wang15143089/FTC-2026-Bio-buzz/docs/t04_intake_concept.md

# T04 单电机拨杆—转轮复合 Intake

版本：T04-INTAKE-0.4；日期：2026-09-20；成熟度：C04-B1 M3可打印验证件、C04-A M1回退。当前不是最终尺寸冻结。

## 当前方案状态

`C04-A 上方薄拨叉 + 顺从分段转轮 + 单电机共享首级输送`保留为回退方案。用户提出的`C04-B1 底部开口内侧拨 + 偏置导流 + 标准roller`已完成SRC-016官方STEP名义扫掠：纯横向被淘汰，25°斜向侧拨进入M3初模。在实体对照通过前，不改称制造基线。严格比较见`docs/t04_intake_side_sweep_trade.md`。

C04-A资源定义：

- 1 个直流电机驱动 intake roller，并预留同步带动力输出给短预输送；FLOWER 取球不增加电机。
- 舵机 `S04-1` 负责拨叉伸入/回拉，舵机 `S04-2` 负责末端钩下降/收起。
- 转轮被动浮动至少 25 mm，以兼容名义 Ø71 mm POLLEN 与 Ø91 mm NECTAR 的地面获取。
- 发射前单球节拍由舵机闸门承担，不要求独立 T05 电机。
- 在四电机底盘、单个 intake/prefeed 电机、双飞轮条件下，整机为 7 个电机，保留 1 个 R503 电机端口。

## 为什么不让电机驱动拨杆

FLOWER 动作是间歇、低速、位置受限的运动，舵机适合做离散位置控制；roller/输送需要连续旋转，保留一个带编码器直流电机。用第二个直流电机驱动拨杆不会增加取球能力，却会消耗双飞轮或未来升降机构需要的端口。

两个舵机不是“无限制”：比赛仍限制整机最多 8 个舵机。当前 intake 预占 2 个，单球闸门再占 1 个，仍有 5 个名义余量。

## 工作原理

### 地面模式

1. 拨叉和钩完全收回机器人包络。
2. 直径 60 mm 的分段顺从 roller 以 220–312 rpm 起始试验，对应无负载表面速度约 0.69–0.98 m/s。
3. roller 两端用于宽口地面获取，中间约 60 mm 段用于 FLOWER 模式。
4. 浮动 roller 通过弹簧臂提供至少 25 mm 法向行程，覆盖两种名义球径 20 mm 的差值，并保留约 5 mm 调试余量。

### FLOWER 模式

1. `FLOWER_ALIGN`：被动 V 形导向护唇贴近 FLOWER，但不得夹持、抓住或承载场地结构。
2. `EXTEND_ABOVE`：S04-2 保持钩收起，S04-1 将 4 mm 薄拨叉从 POLLEN 上方伸入 Retrieval Opening。名义开口高 90 mm，POLLEN Ø71 mm，扣除拨叉后仍有 15 mm 总余量。
3. `DROP_HOOK`：拨叉越过球心后，S04-2 将 12 mm 末端钩放下到球的后上象限。下降必须由机械止挡限制，不能碰到底环或侧管。
4. `RETRACT_WITH_ROLLER`：roller 以 80–160 rpm 低速内转，对应约 0.25–0.50 m/s；S04-1 回拉拨叉，把最下方 POLLEN 移出底环座，roller 接管并向后输送。
5. `VERIFY_EXIT`：喉部光电/ToF 传感器确认球通过；容量计数增加。若未检测到，拨叉先收钩，再执行低速 roller 反转和一次重试。
6. `CAPACITY_INHIBIT`：机器人已控制 4 个得分物体时，拨叉保持收起、roller 禁止吸入。

规则边界：只从 FLOWER 底部取出 POLLEN；不通过侧面取球，不尝试取出 NECTAR。名义 91 mm NECTAR 比 90 mm Retrieval Opening 高 1 mm，本设计还通过钩位置和控制状态主动排除 NECTAR。

## 初始参数

| 参数 | 初值 | 标签 | 说明 |
|---|---:|---|---|
| 拨叉厚度 | 4 mm | `ASSUMED` | 名义上方剩余15 mm；需打印/板材刚度测试 |
| 有效拨叉宽度 | 40 mm | `ASSUMED` | 必须用官方CAD和实体FLOWER核验横向空间 |
| 拨叉伸入行程 | 70–105 mm，可调；90 mm名义 | `ASSUMED` | 开口深度约91 mm，使用机械槽和止挡调节 |
| 末端钩下降 | 12 mm | `ASSUMED` | 只在越过球后下降 |
| roller直径 | 60 mm | `ASSUMED` | 便于312 rpm候选电机低速闭环 |
| FLOWER roller速度 | 80–160 rpm | `ASSUMED` | 0.25–0.50 m/s，先以低能量验证 |
| 地面 roller速度 | 220–312 rpm | `ASSUMED` | 0.69–0.98 m/s，无负载计算 |
| roller被动行程 | ≥25 mm | `ASSUMED` | 20 mm球径差+5 mm调试余量 |
| 设计回拉力上限 | 10 N | `ASSUMED_PROTOTYPE_LIMIT` | 不是实测场地阻力；由串联弹簧限制 |
| 串联弹簧 | 0.5 N/mm × 20 mm | `ASSUMED` | 把拨叉刚性接触力限制在约10 N |
| 拨叉结构校核力矩 | 1.6 N·m | `CALCULATED` | 10 N × 80 mm × 2.0安全系数 |

312 rpm 5203 候选电机在 60 mm roller 上产生 10 N 切向力时，roller 轴矩约 0.30 N·m。按供应商端点线性模型估算电流约 1.38 A；这只用于设置首轮电流告警，不是持续电流证明。

## 机械构成

### R04-1 分段顺从 roller

- 一根横向 8 mm REX 或等效轴，中央 FLOWER 段使用软指/顺从轮，外侧为地面获取段。
- 两端安装在摆臂或竖向滑槽中，左右以连杆或共轴保证近似平行运动，避免单侧抬起夹球。
- 扭簧/拉簧预载可调；硬止挡限制最大压缩，防止把 NECTAR 过度压入机构。
- 轴端、皮带和夹点使用固定护罩；只暴露必要球通道。

### R04-2 两自由度薄拨叉

- S04-1 通过曲柄滑块或短四杆产生近似直线的 70–105 mm 伸缩。
- S04-2 只控制末端钩的收起/下降；初始化命令为收起，并通过弹簧柔性联轴/servo-saver使钩在舵机卡住时仍可被动向收起方向折让。不得假设普通舵机失电会自动回位。
- 拨叉通过 0.5 N/mm 串联弹簧或等效 servo-saver 与 S04-1 连接；20 mm 后由机械止挡接管，防止舵机持续推压 FLOWER。
- 拨叉端部圆角、低摩擦且无开口槽，不得形成抓住管件或场地边缘的几何。

### R04-3 对位护唇

- 使用宽口、浅凹的 V 形或喇叭形导向，允许按 G415 为对位而部分环抱 FLOWER。
- 护唇只承受瞬时横向对位力，不作为机器人定位支撑；必须可在倒车时自然脱离。
- 中央开口给拨叉和 POLLEN 留通道，护唇最低边缘不得插入底环孔。

### R04-4 单电机动力分配

- 电机直接或同步带驱动 roller；另一同步带输出连接短预输送。
- 预输送入口设置扭矩限制/打滑能力，避免单球闸门关闭时电机持续压缩球列。
- FLOWER 模式降低闭环转速；不通过机械换挡增加第二电机。
- 若 L6 证明共驱动造成堵塞，优先增加舵机离合/张紧轮，而不是立即占用第二个电机端口。

## 软件状态与互锁

`SAFE_STOWED → FLOOR_INTAKE` 或 `FLOWER_ALIGN → EXTEND_ABOVE → DROP_HOOK → RETRACT_WITH_ROLLER → VERIFY_EXIT → STOW`

强制互锁：

- 球计数 `>=4`：禁止 `EXTEND_ABOVE` 和正向 intake。
- 钩未确认收起：禁止高速地面模式和机器人快速行驶。
- roller 电流超过初始告警阈值或球未在超时内通过：立即停 roller、收钩、低速反转；只允许一次自动重试。
- 机器人未处于低速 FLOWER 对位状态：禁止拨叉伸出。
- 初始化或通信丢失但控制仍有电时：命令收钩并停止继续伸入；完全失电时依靠钩的被动折让、S04-1串联弹簧和机器人倒车实现无损脱离，不宣称舵机会自动回位。

## 合规证明边界

- `KNOWN` G418 允许从底部移除 POLLEN，禁止从其他方向移除得分物体或从底部移除 NECTAR。
- `KNOWN` G415 禁止抓取、附着、缠绕或悬挂在场地结构；本方案使用可脱离导向和受力受限拨叉，不以 FLOWER 承载机器人。
- `KNOWN` G407 要求避免战略性控制超过4个得分物体；硬件/软件容量互锁属于验收项。
- `KNOWN` R503 整机最多8个电机和8个舵机；当前建议资源为7电机、3个已分配舵机。
- `TBD` 只有官方 FLOWER CAD/实物夹具能关闭拨叉横向宽度、管件避让和实际球位置；在此之前不能宣称场地零接触或100%取球成功。

## 失效模式与控制

| 失效模式 | 后果 | 首选控制 | 验证 |
|---|---|---|---|
| 拨叉未越过球就落钩 | 压球、卡死 | 顺序互锁、机械凸轮/止挡 | 透明侧板慢速录像50次 |
| 拨叉钩住FLOWER管件 | G415风险、损坏 | 无槽圆角端、10 N串联弹簧、立即反向 | 全包络手动探测和拉脱试验 |
| roller把球压回座内 | 取球失败 | 浮动轴、低速模式、接触高度垫片 | 高度/预载全因子试验 |
| 第二个POLLEN落下夹住拨叉 | 堵塞 | 球离开后先收钩再继续吸入 | 四球连续取出试验 |
| 误取第5球 | G407风险 | 双传感计数+物理闸门 | 容量4拒绝试验20次 |
| 断电拨叉留在场地内 | 无法脱离 | 弹簧偏置收钩、手动释放 | 断电拉脱测试 |
| 单电机共驱动时球列堵塞 | intake和输送同时失效 | servo gate、打滑张紧、反转状态 | 混合球100循环 |

## 验证关口

1. L3：从官方STEP提取 Retrieval Opening 周边实体，扫掠拨叉70–105 mm全行程；对管件、环和机器人包络保持可调安全余量。
2. L6夹具：用实际FLOWER或1:1开口夹具和至少5个POLLEN，测量取出峰值力；若95百分位超过10 N，先改接触路径，不直接提高刚性限力。
3. 每个伸入长度、钩下降量、roller高度/预载组合至少20次；候选收敛后完成100次四球连续取出。
4. 记录成功率、单球周期、峰值电流、最大场地接触力、卡球恢复和球损伤。
5. 只有100次无规则危险接触、无第5球获取、无不可恢复卡死且命中预设成功率后，才进入M4详细CAD。

计算输入为 `calculations/t04_intake_inputs.json`，复算脚本为 `calculations/t04_intake.py`，结果为 `calculations/t04_intake_results.csv`。
