wang15143089/FTC-2026-Bio-buzz/docs/p3_hive_concept.md

# P3 HIVE 前期设计

版本：P3-M1 v0.1；模块：T04/T05/T06/T08；日期：2026-09-19；状态：M1 概念与 M2 低保真计算进行中，未冻结机构或尺寸。

## 当前结论

- `CALCULATED` 在真空质点模型中，从 1.5 m 水平距离、400–700 mm 出射高度、55° 发射至 HIVE 开口下部矩形中心，需要约 4.92–5.56 m/s 出射速度。
- `CALCULATED` 固定 400 mm 出射高度避免起始高度展开机构；其 1.5 m/55° 基准需要约 5.56 m/s，目标处轨迹接近水平。550 mm 出射高度需要约 5.21 m/s并形成约 -12.4° 下落入射，但必须有合法展开与机械限位。
- `CALCULATED` 312 RPM 底盘电机和 1150 RPM 电机在 96/120 mm 轮上均不能通过当前直接驱动初筛；1620 RPM + 120 mm 轮进入原型范围，1620 RPM + 96 mm 为射位相关的边界候选。6000 RPM 需要减速或低转速控制，不作为首个直接驱动基线。
- `SUPERSEDED` P3-TS-001 v0.1 的 76/69/66 主观加权分只保留为历史原型筛选证据，不再承担最终选择理由。
- `DECIDED` P3-LAUNCHER-CMP-0.3 已按约束、解析运动学、双球中心线和更新后的共享动力资源顺序选择C06-B为主原型；C06-A保留为同台对照与回退，C06-C为二级风险回退。详见 `docs/p3_launcher_comparison.md`。

## 规则和几何输入

| ID | 标签 | 输入/约束 | 来源 |
|---|---|---|---|
| T06-REQ-001 | KNOWN | 只能向朝上的 CELL 发射来触发 TIP，不得直接操纵 HIVE。 | G417；TU01 §10.5.1 |
| T06-REQ-002 | KNOWN | TIP 在 AUTO/TELEOP 均为 20 分；HIVE 中终场每球 2 分。 | TU01 Table 10-2 |
| T06-REQ-003 | KNOWN | HIVE TIP 过程中继续向向下的 CELL 发射可能破坏 TIP；控制系统需要暂停/抑制发射状态。 | TU01 §10.5.1 |
| T06-REQ-004 | KNOWN | POLLEN Ø71 mm、NECTAR Ø91 mm，均非完全球形且尺寸会变化。 | TU01 §9.8 |
| T06-REQ-005 | KNOWN | CELL 开口名义宽 508 mm；底部至竖直肩部高 193.5 mm；底边高 1359 mm；上部总开口高度约 355.5 mm。 | TU01 Figures 9-10/9-11 |
| T06-REQ-006 | KNOWN | 起始高度不超过 457 mm；工作高度不超过 736.5 mm，且必须机械限位。 | R102、R105 |
| T06-REQ-007 | KNOWN | 最多控制 4 个得分物体；整机最多 8 电机/8 舵机。 | G407、R503 |
| T06-REQ-008 | ASSUMED | T06 应兼容 POLLEN 与 NECTAR，以保留终场 CELL 得分和战术弹性。 | 需 M1 原型验证两种尺寸；可在关口降级为 POLLEN-only |
| T06-REQ-009 | TBD | 命中率、连续射击恢复时间、允许射位和球体质量目标。 | 需用户目标与 L6 测试 |

## 目标窗口计算

以最大名义球 Ø91 mm 通过 CELL 下部矩形区域：

- `CALCULATED` 瞄准高度：`1359 + 193.5 / 2 = 1455.75 mm`。
- `CALCULATED` 名义水平球心余量：`(508 - 91) / 2 = 208.5 mm/侧`。
- `CALCULATED` 名义竖直球心余量：`(193.5 - 91) / 2 = 51.25 mm/侧`。

这些是名义几何余量，不包含场地 ±25 mm 一般公差、HIVE 运动、球体变形、机器人定位误差或飞行散布。它们不能直接转化为允许的发射角误差。

## L2 弹道模型

模型采用无阻力抛体公式：

`v = sqrt(g x² / (2 cos²θ (x tanθ - Δz)))`

其中 `x` 为水平距离，`Δz` 为目标与出射口高度差。模型输入集中在 `calculations/p3_launcher_inputs.json`，脚本为 `calculations/p3_ballistics.py`，完整扫参结果在 `calculations/p3_ballistics_results.csv`。

### 1.5 m、55° 基准切片

| 出射高度 | 起始状态合法性 | 出射速度 | 目标处轨迹角 | 最高点 | 比动能 |
|---:|---|---:|---:|---:|---:|
| 400 mm | 固定高度可在 457 mm 内 | 5.556 m/s | -1.17° | 1.456 m | 15.43 J/kg |
| 550 mm | 需要展开 | 5.208 m/s | -12.43° | 1.478 m | 13.56 J/kg |
| 700 mm | 需要展开且接近工作上限 | 4.918 m/s | -22.81° | 1.527 m | 12.09 J/kg |

`CALCULATED` 较高出射口只把需求速度降低约 11%，却引入展开、限位和碰撞风险。当前证据不支持为了这部分速度收益直接选择升降发射器；固定低位方案应作为首个原型基线。

### 模型限制

- `KNOWN` ResisDent 球为空心开孔塑料球，空气阻力不可忽略。
- `TBD` 质量尚未由官方资料确认或实测，因此只报告 J/kg，不伪造球体动能和连续功率。
- `TBD` 飞轮引入的自旋会产生 Magnus 偏移；真空模型没有建模。
- `TBD` HIVE 正在 TIP 时目标不是静止体；当前只分析稳定状态。

因此计算值是台架起始窗口，不是最终设定值。最终弹道必须由实物球、实物目标夹具和高速/普通视频轨迹标定。

## 电机与轮速初筛

球速与轮面速度用 `v_ball = k × v_surface` 映射；`k = 0.65` 是 `ASSUMED` 原型参数，不是效率实测。`calculations/p3_motor_screen.py` 使用供应商无负载转速计算，结果在 `calculations/p3_motor_screen_results.csv`。

| 电机 | 96 mm 轮估算球速 | 120 mm 轮估算球速 | 初筛 |
|---|---:|---:|---|
| 5203-2402-0019，312 RPM | 1.02 m/s | 1.27 m/s | 直接驱动淘汰 |
| 5203-2402-0005，1150 RPM | 3.76 m/s | 4.70 m/s | 直接驱动淘汰 |
| 5203-2402-0003，1620 RPM | 5.29 m/s | 6.62 m/s | 96 mm 边界；120 mm 原型候选 |
| 5203-2402-0001，6000 RPM | 19.60 m/s | 24.50 m/s | 需减速/闭环限速，不作首个直驱基线 |

goBILDA 对 1620 RPM 型号给出 5.4 kg·cm 堵转扭矩和 9.2 A 堵转电流；按理想线性扭矩-转速曲线计算单电机最大机械功率约 22.4 W。该数值不是持续额定功率，双电机堵转电流之和 18.4 A 也不是可接受工作点。必须通过加速时间、电流和温升测试确定安全工作区。

## 候选概念

### C06-A — 单飞轮 + 可调曲面压板

一个高速轮把球沿被动或弹性曲面压板加速，单独的闸门一次放行一球。

- 优点：一个发射电机；包络短；成熟 FTC 先例多；曲面可增加接触长度。
- 风险：71/91 mm 直径相差 20 mm，固定间隙会导致完全不同的压缩；单轮会施加强自旋；曲面磨损或偏心直接影响散布。
- 必需可调项：轮速、压板间隙/弹簧预载、有效包角、出射角。
- 原型判据：两种球都不永久变形；100 次单发无双进料；命中率阈值 TBD。

### C06-B — 对置双飞轮 + 独立进料闸门

两侧对置轮同时加速球，轮速同向产生直线出射；可通过弹性浮动轴承座或对称滑块适配两种直径。

- 优点：净自旋可小于单轮；压缩与出射方向对称；可用左右轮差速校正自旋/横向偏差。
- 风险：默认需要两个电机；双侧夹点和同步控制增加安全与软件负担；固定间隙仍不能同时适配 71/91 mm。
- 必需可调项：轮间隙、左右轮速、轮径、出射角、进料中心线。
- 原型判据：左右转速误差、恢复时间和球径切换无需拆机；阈值 TBD。

### C06-C — 可调储能弹射器

电机/凸轮为弹簧或弹性件储能，锁止后用摆臂或杯托一次释放一球；改变预压或止挡实现射程调整。

- 优点：单次能量可重复标定；对表面摩擦变化不如飞轮敏感；可用单电机低速充能。
- 风险：循环慢、冲击和振动大；锁止失效与摆臂扫掠区风险高；疲劳寿命和球径适配需独立验证。
- 先例边界：2017 Velocity Vortex 冠军联盟队 724 被公开社区资料描述为可调射程弹射器，但未获得可复用尺寸或完整载荷数据。
- 原型判据：防误释放、机械二次止挡、循环寿命和重复能量；阈值 TBD。

## 概念比较

`P3-TS-001 v0.1` 权重为双球尺寸适应 30%、潜在重复性 20%、可调性 15%、周期/恢复 10%、安全维护 10%，其余为包络、电机效率和先例成熟度。全部概念分数为 `ASSUMED`。

| 概念 | 得分 | 排名 | 处理 |
|---|---:|---:|---|
| C06-B 对置双飞轮 | 76 | 1 | 主原型 |
| C06-A 单飞轮曲面压板 | 69 | 2 | 轻量对照原型 |
| C06-C 可调弹射器 | 66 | 3 | 风险回退，暂不详细化 |

C06-B领先的主要原因是已解析证明的双球中心线保持、理想零自旋设定点与平移/自旋解耦，而不是已证明的命中率。该旧评分已由P3-LAUNCHER-CMP-0.3的约束优先选择取代；若实测显示双电机恢复、功耗、散布或尺寸不可接受，C06-A按预先登记的反转规则胜出。

## 初始资源预算

| 资源 | C06-A | C06-B | C06-C | 标签 |
|---|---:|---:|---:|---|
| 驱动电机 | 4 | 4 | 4 | KNOWN 底盘 |
| T04 获取电机 | 1 | 1 | 1 | ASSUMED |
| T05 输送/闸门电机 | 0 | 0 | 0 | PROPOSED；按DEC-0013由T04电机共驱短预输送，闸门用舵机 |
| T06 发射电机 | 1 | 2 | 1 | ASSUMED |
| 总电机 | 6 | 7 | 6 | CALCULATED；按C04-A共享动力更新 |
| 剩余电机端口 | 2 | 1 | 2 | CALCULATED，基于8电机上限 |
| T06 舵机 | 0–2 | 0–2 | 1–2 | ASSUMED |
| T06 质量 | TBD | TBD | TBD | 必须用 M1 BOM 关闭 |

DEC-0013已把T04/T05合并为单电机共享动力，因此双飞轮整机预算由8降为7，保留1个电机端口。该余量不自动批准炮塔、升降或独立FLOWER模块；新增功能仍需质量、电源、周期和战略收益审查。

## 初始接口

### IF-T05-T06-01 — 单球交接（DRAFT）

- 几何：一次仅向发射级提交一个 Ø71–91 mm 名义球；交接中心线、速度和姿态为 TBD。
- 机械：闸门必须物理防止第二球进入能量传递区；卡球须能断电清除。
- 传感：至少检测“球就绪”和“球已离开”；具体传感器 TBD。
- 控制：T06 未达到速度/储能条件或检测 HIVE 正在 TIP 时，T05 必须保持球。

### IF-T02-T06-01 — 结构安装（DRAFT）

- 使用 T02 命名基准面和可拆安装板；孔型、载荷和包络在 M3 前冻结。
- 发射反力不得通过 Control Hub、电池或线束支架闭合。
- 护罩、工具空间和轮/压板快速更换路径属于接口包络。

### IF-T03-T06-01 — 电气（DRAFT）

- 12 V 电机端口 1–2 个，带编码器闭环；峰值电流按每个候选电机 9.2 A 堵转值做故障预算，但禁止以堵转为正常工作点。
- 电机、传感器、闸门和急停/禁用状态必须在端口分配表冻结前登记。

### IF-T08-T06-01 — 软件状态（DRAFT）

建议状态：`SAFE → SPINUP/CHARGE → READY → FEED_ONE → RECOVER → READY`，异常进入 `FAULT_JAM` 或 `INHIBIT_HIVE_MOVING`。速度容差、超时和传感更新率为 TBD。

## 先例与工业化原则

- [FTC 18438 Wolfpack Machina](https://www.wolfpackmachina.com/ftc2020) 展示了曲面压板延长接触、增加飞轮惯量降低连续射击转速跌落和可维护控制器布局；其物体为 Ring，因此只继承原则。
- [REV Flywheel Launcher](https://docs.revrobotics.com/ftc-kickoff-concepts/ultimate-goal-2020-2021/shooter) 把“不堵塞、出射一致”和较长加速路径作为首要要求，支持 C06-A 的可调台架方法。
- [FTC 11128 Velocity Vortex](https://team11128.wixsite.com/main/charlie) 采用宽入口收集后缩窄为单球进料，支持把 T05 闸门与 T06 能量级解耦。
- [goBILDA 1620 RPM 5203](https://www.gobilda.com/5203-series-yellow-jacket-planetary-gear-motor-3-7-1-ratio-1620-rpm-3-3-5v-encoder/) 的官方规格支持当前轮速初筛，但不构成选型批准。
- [OSHA 机器防护原则](https://www.osha.gov/etools/machine-guarding/introduction/general-requirements) 将进料夹点、旋转件和飞出物作为需防护危险；本项目据此要求完整侧护罩、只保留球通道并提供断电清障路径。

## 主要失效模式

| 失效 | 后果 | 首选控制 | 验证 |
|---|---|---|---|
| 双球进入发射级 | 堵塞、失控射击 | 独立闸门 + 球状态传感 | 100 次混合尺寸进料 |
| 轮速跌落 | 下一球低射 | 编码器 READY 门限 + 恢复延迟 | 连续射击转速日志 |
| 直径差导致压缩过大/过小 | 损球、打滑、散布 | 弹性/可调间隙 | 71/91 mm 全因子试验 |
| TIP 中继续发射 | TIP 不成立或球进错误 CELL | 人工/视觉 TIP 抑制状态 | 动态目标夹具 |
| 轨迹过高或过快 | 离场/安全风险 | 机械角限位 + 软件转速上限 + 护罩 | 最大能量安全测试 |
| 飞轮/传动件松脱 | 机械危险 | 双重轴向约束、锁固、全包围护罩 | 超速与振动检查 |
| 断电后无法清球 | 现场恢复失败 | 无工具或单工具检修门 | 断电清障演练 |

## 下一验证关口

1. `MEASURED` 称量至少 5 个 POLLEN 和 5 个 NECTAR，并测量直径/圆度范围。
2. 建造共用的可调角度台架，允许更换 C06-A/C06-B 头部、96/120 mm 轮和间隙垫片。
3. 在 1.0/1.5/2.0 m 射位记录转速、出射速度、目标散布、电流、恢复时间和损球情况。
4. 每种球至少 30 发/设置；命中率阈值由用户性能目标确认后写入 VAL-T06-001。
5. 只有实测关闭球速传递系数、压缩量和恢复时间后，才进入 M3 简化几何与 CadQuery 包络。
