wang15143089/FTC-2026-Bio-buzz/docs/requirements.md

# 需求与问题清单

状态：Requirements Baseline v0.1；基于 BIOBUZZ Competition Manual TU01，2026-09-19 经用户批准。

## 已知过程需求

| ID | 状态 | 需求 | 验收方式 | 来源 |
|---|---|---|---|---|
| PRJ-001 | KNOWN | 机器人按独立功能模块开发，并定义机械、电气、软件和几何接口。 | 架构与 ICD 审查 | 用户指令 2026-09-19 |
| PRJ-002 | KNOWN | 全局关键尺寸和工程参数集中管理，禁止重复硬编码。 | 参数引用检查 | 用户指令 2026-09-19 |
| PRJ-003 | KNOWN | 重大选择必须追溯到需求、计算、测试或明确假设。 | 追溯矩阵/决策日志审查 | 用户指令 2026-09-19 |
| PRJ-004 | KNOWN | 验证顺序为零件、子组件、整机，优先采用可回答问题的最低成本方法。 | 验证计划审查 | 用户指令 2026-09-19 |
| PRJ-005 | KNOWN | 工作流适配 i5-1135G7、8–16 GB RAM、集成显卡和有限 SSD。 | 构建时间/资源记录 | 用户指令 2026-09-19 |
| PRJ-006 | KNOWN | 重要工程状态必须落盘并可从检查点恢复。 | 恢复演练 | 用户指令 2026-09-19 |
| PRJ-007 | KNOWN | 默认 CAD 几何单位为 mm，模块可独立再生成。 | 自动检查/重建测试 | 用户指令 2026-09-19 |
| PRJ-008 | KNOWN | 未知关键数据必须标为 TBD，不得无依据填值。 | 文档与参数审查 | 用户指令 2026-09-19 |
| PRJ-009 | KNOWN | 概念设计可参考往届高水平 FTC 机器人和成熟工业设计，但必须追溯来源、重新验证当前赛季合法性与适用性，不得无审查照搬。 | 概念评审/规则检查 | 用户指令 2026-09-19 |

## 尚未建立的产品需求类别

移动性能、选定任务组合、周期时间、可靠性目标、电气功率预算、软件控制方案、可维护性目标和成本目标仍为 `TBD`。

## 官方比赛与机器人约束

下表来源均为 `BIOBUZZ Competition Manual, Version TU01`；具体源文件哈希见 `references/source_register.md`。

| ID | 状态 | 需求/事实 | 来源 | 验收方式 |
|---|---|---|---|---|
| LEG-001 | KNOWN | 起始状态全部机器人零件必须静止、自支撑并位于 457 × 457 × 457 mm 包络内；预装比赛物体可超出该包络。 | R102–R103，pp.120 | 实体量规/简化 CAD 包络检查 |
| LEG-002 | KNOWN | 比赛开始后机器人必须保持一个总成，所有稳定工作状态须位于 457 × 610 × 736.5 mm 包络内，高度方向始终垂直场地；必须由机械限位保证，不能只依赖软件。 | R105，pp.121–123；G416 | 全行程机械止挡与扫掠包络检查 |
| LEG-003 | KNOWN | BIOBUZZ 无显式机器人重量上限，但质量仍影响地垫、耗电、运输和性能。 | R104，p.120 | 称重并对团队目标审查；目标值 TBD |
| LEG-004 | KNOWN | 机器人最多同时控制 4 个得分物体。 | G407，pp.109–110 | 容量/状态机/实体测试 |
| LEG-005 | KNOWN | 机器人最多使用 8 个合法电机和 8 个合法舵机；5201–5204 系列 goBILDA Yellow Jacket 属于允许电机系列。 | R501–R503，pp.130–132 | BOM 与检查清单 |
| LEG-006 | KNOWN | 机器人只能使用 1 个获准的 12 V NiMH 主电池；项目选用 goBILDA 3100-0012-0020。 | R601，p.133；用户批准的硬件输入 | BOM 与检查 |
| LEG-007 | KNOWN | 项目采用 1 个 REV-31-1595 Control Hub 和 1 个 REV-31-1153 Expansion Hub，符合最多增加 1 个 Expansion Hub 的规则路径。 | R701，p.137；用户批准的硬件输入 | 电气架构/BOM 检查 |
| LEG-008 | KNOWN | 机器人不得故意分离零件，且断电时必须能从场地和比赛物体中安全移除。 | R105、R203 | 风险审查与断电恢复测试 |
| LEG-009 | KNOWN | HIVE 只能通过向朝上的 CELL 发射得分物体来触发 TIP，不得以机器人或受控物体直接操纵其运动。 | G417，p.113 | 功能测试与比赛规则审查 |
| LEG-010 | KNOWN | FLOWER 只能从顶部放入 POLLEN/NECTAR；只能从底部取出 POLLEN；最后 60 s 前不得将 NECTAR 放入 FLOWER 计分体积。 | G410、G418，pp.110,114 | 状态机和几何路径测试 |
| LEG-011 | KNOWN | 开赛时每台机器人必须接触恰好 4 个预装 POLLEN。 | 10.3.4、G304，pp.84,105 | 起始配置检查 |

## 场地与比赛物体输入

| ID | 状态 | 输入 | 来源/说明 |
|---|---|---|---|
| ENV-001 | KNOWN | 场地内侧约 3657.5 × 3657.5 mm；36 块约 609.5 × 609.5 × 15 mm 软地垫。 | §9.2，p.64；一般公差 ±25 mm |
| ENV-002 | KNOWN | 官方 3D CAD 是场地构造的官方表示；一般测量公差 ±25 mm。 | §9.1，p.63；`field-cad-step.zip` |
| ENV-003 | KNOWN | HIVE 框架基部约 1256.5 mm 宽、989.5 mm 深，枢轴高 1116.5 mm；CELL 开口约 508 × 356 mm、深约 305 mm。 | §9.6，pp.69–72 |
| ENV-004 | KNOWN | FLOWER 顶部开口约 Ø101.5 mm、高约 546 mm；底部取球口约 90 mm 高、91 mm 深。 | §9.7，pp.72–73 |
| OBJ-001 | KNOWN | POLLEN 名义直径约 71 mm；NECTAR 名义直径约 91 mm；二者均非完全球形且尺寸会变化。 | §9.8，p.74 |
| OBJ-002 | KNOWN | 每场共有 40 个 POLLEN、8 个红色和 8 个蓝色 NECTAR。 | §9.8，p.74 |

## 计分功能候选

用户未指定任何必须完成的比赛任务。以下是后续方案组合的候选功能，不代表已选择机构：

| ID | 功能 | 分值/作用 | 关键约束 |
|---|---|---|---|
| FN-001 | AUTO LEAVE | 3 分 | 自动阶段离开场边接触 |
| FN-002 | AUTO/TELEOP PARK | 各 5 分 | 至少部分位于 LOADING ZONE |
| FN-003 | HIVE TIP | AUTO/TELEOP 各 20 分 | 只可向朝上 CELL 发射 |
| FN-004 | CELL 留球 | TELEOP 每个 2 分 | 终场位于朝上 CELL |
| FN-005 | FLOWER 底层 NECTAR | 5 分 | 最后 60 s；从顶部放入 |
| FN-006 | 拥有 FLOWER 后其中每球 | 每个 2 分 | 所有权由最上层本方 NECTAR 决定 |
| FN-007 | GARDEN 留球 | 每个 1 分 | 区域不受保护 |
| FN-008 | RP 目标 | SWARM 16 分、POLLINATOR 1 为 4 TIPS、POLLINATOR 2 为 7 TIPS | 仅“其他赛事”阈值；高等级赛事当前为 TBA |

## 已确认的项目输入

- `KNOWN` 接受 CadQuery → STEP → FreeCAD/Fusion 360 工作流。
- `KNOWN` 不对制造设备预设硬性要求；方案比较必须显式列出各方案所需工艺。
- `KNOWN` 参考底盘为 goBILDA Strafer 3209-0001-0007（104 mm Mecanum，供应商标称组装质量 4269 g，内含 4 个 312 RPM 的 5203-2402-0019）。
- `KNOWN` 底盘四轮相对布局、轮距和轴距必须保持；允许为测量、安装与必要调整进行最低限度拆分重组，但不得改变核心运动学布局。精确轮距/轴距待从 STEP 或实物核验。
- `KNOWN` goBILDA 5203-2402-0051 文件只作为同系列电机的包络示意，不要求使用该具体速比；最终电机型号由扭矩、转速、功率和控制需求计算决定。
- `KNOWN` 控制系统使用 1 个 REV Control Hub（REV-31-1595）和 1 个 REV Expansion Hub（REV-31-1153）。
- `KNOWN` 主电池为 goBILDA 12 V 3000 mAh Nested Battery（3100-0012-0020）；用户图纸给出的本体包络为 124 × 47.8 × 43 mm，线束标注长度 120 mm，含 XT30、16 AWG 线和 20 A Mini Blade Fuse。
- `KNOWN` 任务包比较必须让战略价值显著主导开发便利性，并用规则、计算或试验证据解释各项评分；当前默认战略总权重为 70%，见 TS-S00-001 v0.2。

## P3 HIVE 初始模块需求

以下需求进入 T06 M1；性能阈值仍需计算或原型关闭：

| ID | 状态 | 需求 | 验收方式 |
|---|---|---|---|
| T06-REQ-001 | KNOWN | T06 只能通过向朝上 CELL 发射得分物体来尝试 HIVE TIP，不得直接操纵 HIVE。 | 规则审查、运动路径测试 |
| T06-REQ-002 | KNOWN | 发射路径、护罩和控制必须在全部状态满足起始/工作包络及机械限位要求。 | M3 扫掠包络、实体量规 |
| T06-REQ-003 | KNOWN | T05/T06 不得使整机控制超过 4 个得分物体。 | 容量审查、状态机测试 |
| T06-REQ-004 | ASSUMED | 首轮概念应兼容 Ø71 mm POLLEN 与 Ø91 mm NECTAR；若双尺寸显著损害 HIVE 可靠性，可经关口批准降级。 | 双尺寸夹具/发射测试 |
| T06-REQ-005 | ASSUMED | M1 台架必须可独立调整出射角、轮速/储能、压缩间隙及单球进料时序。 | 台架设计审查 |
| T06-REQ-006 | KNOWN | T06 必须具有防止 TIP 过程中继续错误发射的控制状态，并支持断电安全清球。 | 状态机注入、断电恢复测试 |
| T06-REQ-007 | KNOWN | 飞轮、带/链、轴端和所有进料夹点必须有护罩；护罩不得成为新的夹点。 | 安全检查、探入检查 |
| T06-REQ-008 | TBD | 稳态命中率、连续射击恢复时间、最大允许电流/温升和射位范围。 | 用户目标 + VAL-T06-001/002 |

## 待用户回答问题

### CRITICAL — 不回答就不能负责任地开始设计

当前 CRITICAL 项均已关闭；Requirements Baseline v0.1 和 Architecture v0.1 已于 2026-09-19 获用户批准。

### IMPORTANT — 可短期采用已记录假设

1. 目标赛事等级/地区、比赛日期、评审节点、采购周期和预算。
2. 期望的最高速度/加速度、越障需求和驾驶员偏好；哪些是偏好而非硬约束？
3. 最终需要哪些原生 CAD 格式、工程图和 BOM 格式？
4. 团队已有的软件栈、编程语言、控制架构和里程计/视觉定位方案。
5. 可靠性与维修目标：两场间维护时间、模块更换时间和备件策略。
6. 除所给底盘、REV 双 Hub 和 goBILDA 电池外，是否有需复用的机构、孔位标准、型材或零件库存？

### LATER — 初始概念不依赖

1. 外观、颜色、号码牌和赞助标识规范。
2. 线束标签、包装运输、展示支架和长期储存偏好。
3. 最终渲染、动画、培训材料和评审展示格式。
4. 赛后性能遥测、维护统计和下一赛季复用目标。

## 初始需求基线的完成条件

- 所有 CRITICAL 问题有来源明确的回答。
- 法规需求逐条记录规则章节和版本。
- 每项“必须”任务都有可测试的验收条件。
- 冲突和 TBD 有责任人、截止点和风险处理方式。
- 用户批准 Requirements Baseline v0.1。
