wang15143089/FTC-2026-Bio-buzz/cad/output/paddle_launcher_feasibility_report.md

# 对置飞轮连续拨杆发射机构：尺寸约束报告

- 坐标：X–Y 为底盘平面，+Z 向上。
- 模型不含 POLLEN / NECTAR 实体。
- 通道净截面：108 × 110 mm；拨片宽 96 mm，单侧余量 6.0 mm。
- 飞轮：4 个 96 × 24 mm Gecko；每根 8 mm 轴安装 2 个。
- COTS 版本：C06B-COTS-0.3；目录核对日期 2026-10-01。
- 官方 CAD：已导入 13 个 goBILDA SKU；清单 `references/vendor/gobilda/t06/manifest.json`。
- 装配表示：WHOLE_OFFICIAL_PART_PER_SKU_FROM_VENDOR_STEP；供应商按真实间隙分开的子实体保持分开，不强行融合、不丢料。
- 飞轮直驱：2 × 5203-2402-0003，无外置啮合齿轮。
- 电机夹具/联轴器：1401-0043-0036 / 4007-4008-4008。
- 轴/轴承：2106-4008-1680（168 mm）/ 1611-0514-4008（Ø14 × 5 mm）。

| 配置 | 轴中心距 | 名义轮间隙 | 总包络 X×Y×Z | 18 in 校核 |
|---|---:|---:|---:|:---:|
| POLLEN | 160 mm | 64 mm | 383.8×364.8×400.0 mm | 通过 |
| NECTAR | 178 mm | 82 mm | 383.8×364.8×400.0 mm | 通过 |

## 间距调节运动链

舵机 12 mm 曲柄 → 65 mm 定长驱动杆 → 水平导向滑块 → 两根 110 mm 对称连杆 → 与轴承座刚性连接的耳轴 → 上下飞轮轴。
两侧板均设置轴槽和外置滑动轴承座，因此轴在调节过程中保持平行。

- 三段导槽角度：0° / 26° / 52°；接头最大位置误差 0.000000 mm。
- 导槽与发射喉道共线误差 0.000000 mm。
- 每根轴的槽中心行程 9 mm；轴承留在外置滑座内，侧板仅开 8.4 mm 轴槽，槽外形总长 17.4 mm；两轴相对中心距变化 18 mm。
- 发射喉道在轴心前 52 mm 截止，相对 48 mm 飞轮半径保留至少 4 mm 轴向投影余量。

## 实体干涉检查

- POLLEN：全部通过。覆盖飞轮/侧板、飞轮/通道、飞轮/轴承座、飞轮彼此、电机/轴承座、拨杆/通道、拨杆/支撑板、连杆/侧板、双槽滑块及曲柄杆端分层。
- NECTAR：全部通过。覆盖飞轮/侧板、飞轮/通道、飞轮/轴承座、飞轮彼此、电机/轴承座、拨杆/通道、拨杆/支撑板、连杆/侧板、双槽滑块及曲柄杆端分层。
