wang15143089/FTC-2026-Bio-buzz/cad/output/paddle_launcher_constraint_report.md

# 对置飞轮连续拨杆发射机构：尺寸约束报告

- 坐标：X–Y 为底盘平面，+Z 向上。
- 模型不含 POLLEN / NECTAR 实体。
- 通道净截面：108 × 110 mm；拨片宽 96 mm，单侧余量 6.0 mm。
- 飞轮：4 个 96 × 24 mm Gecko；每根 8 mm 轴安装 2 个。

| 配置 | 轴中心距 | 名义轮间隙 | 总包络 X×Y×Z | 18 in 校核 |
|---|---:|---:|---:|:---:|
| POLLEN | 160 mm | 64 mm | 383.8×374.0×400.0 mm | 通过 |
| NECTAR | 178 mm | 82 mm | 383.8×374.0×400.0 mm | 通过 |

- 三段导槽角度：0° / 26° / 52°；接头最大位置误差 0.000000 mm。
- 导槽与发射喉道共线误差 0.000000 mm。
- 每根轴的槽中心行程 9 mm；按 16 mm 轴承孔计，槽外形总长 25 mm；两轴相对中心距变化 18 mm。
