wang15143089/FTC-2026-Bio-buzz/PROJECT_STATUS.md

# PROJECT STATUS

最后更新：2026-10-16（**R69-Bambu 补丁：两份 STEP 报“超界/超高”已定位为旧中间件误用，补出 54 件单件平放 STEP（DEC-0077 / V-0077）**：①判据（KNOWN）= 用户 2026-10-16 两张 Bambu Studio 报错截图「物体位于盘的边界上或超过了高度限制」，对象 A 403.691 x 136 x 232.835、V 537 144 mm³，对象 B 361.064 x 31 x 385.024、V 312 153 mm³。②根因（MEASURED）：两者**不是** R69 交付件，而是拆分过程的**裁切前中间件** —— `_r69_split/mid.step` 回读 403.7 x 136.0 x 232.8、V **537 144.3**；`_r69_split/plate_R.step` 回读 361.1 x 31.0 x 385.0、V **312 150.0**，与截图逐项吻合。最终件 `shroud_tray_mid` 248.4 x 136.0 x 232.8（V 414 543.1）、`side_plate_right` 262.2 x 31.0 x 284.0（V 199 554.9）均在 H2D 可用区 315 x 310 x 325 内。③处置：`_r69_split/` 与 `_r69_p1/` 移入 `cad/output/_superseded/` + `_SUPERSEDED` 后缀 + README（防误用）；新增 `cad/_r69_parts_flat.py` 从已验收整板 STEP 逐件烘焙导出。④验收（MEASURED，`cad/_r69_parts_flat_verify.py`）：**54/54 单实体、zmin = 0.000、bbox ≤ 315 x 310 x 325**，最大高 136.0（`shroud_tray_mid`）、最大平面 287.09（`base_rail_±72`），ΣV **1 766 184.4 mm³** = R69 验收值，几何零变动。⑤交付：`deliverables/R69_print_package/parts_flat/`（54 STEP + README + `parts_flat_index.json`）、`previews/bambu_fix_dimensions.png`。**导入用 `parts_flat/`，不要用 `_r69_split/`。** 遗留：Bambu 实机切片未跑。DEC-0077 / V-0077）

上一状态：2026-10-16（**T06 R69 打印件重排：滑轨并成每侧一根 380 mm 整轨 + 外罩/侧板联合体 3 拆（左板 / 右板 / 外罩-托板），件集 55 → 54、8 板（DEC-0076 / V-0076）**：①判据（KNOWN）= 用户 2026-10-16「c，谢谢。麻烦你也把巨大的外罩-侧板联合体拆成3部分：左侧板，右侧板，以及外罩-托板联合体，3部分用螺丝，扎带和胶水固定（选择你认为最好的方法，可以直接给外罩-托板直接变宽使其全程和侧板接触）」+ 上一轮「把两段滑轨在3D打印文件中连起来」。②滑轨方案 C（MEASURED）：每侧 `base_rail_front_±72` 与 `base_rail_rear_joined` 布尔并成 **380.0 mm 单实体整轨**，DEC-0072 的 2 件跨缝搭板 + 4 跨轨筋 + 2 垫板 + 4 × M3×30 **退役**（DEC-0072 转 SUPERSEDED 保留）。③3 拆（MEASURED）：切割面 **y = ±68**（侧板内表面），`frameP_1_rear_lower` → `shroud_tray_mid` + `side_plate_left` + `side_plate_right`，**体积守恒 delta = 0.000 mm³**，三件各单实体。④紧固（KNOWN）：**8 × M3 六角螺栓 + 六角螺母 + 每螺栓 2 平垫圈 + 双组分环氧**，**不用扎带**（扎带要在 4 mm 薄板上开槽，对已螺栓 + 已粘接的接头无收益）；耳片 12 × 10 从外罩壁咬入 3 mm、外表面到 **y = ±67.8**，对侧板留 **0.2 mm 胶缝**；工位 A(x 74, z 27, 板 16, M3×35) / D(5, 86, 4, M3×25) / B(−25, 120, 4, M3×25) / C(−68, 140, 4, M3×25)，螺栓长由 `5 × ceil((夹持 + 4) / 5)` 计算，头在外侧、螺母在外罩壁内表面（内腔空间实测有）。⑤不做全程加宽：填实 |y| 57…68 的 11 mm 空腔会与轴承 / 滑座 / 横梁让位冲突且耗材 +70 %，局部耳片等效。⑥验收（MEASURED，`cad/output/inspection/t06_r69_print_R069.json`，**21 项 0 fail**）：体积 +7416.931（目标 +7417.0 ± 1.0）、5 件各单实体、两轨 xlen 380.000、螺栓通道 Ø3.0 探针 8 × 2 求交 **0.000 mm³**、Ø3.4 塞规自由 0.000 / Ø4.0 仍咬料 101.185、8 耳填充率 **1.0000**、8 板全部 ≤ 315 × 310、54 件在 8 板中各一次。⑦排版 **8 板**：p1 30 件 / 311.1 × 306.3 / H 18、p2 1 件（380 轨 45° 斜放）/ 287.1 × 287.1 / H 18、p3 6 / 307.2 × 306.7 / H 31、p4 5 / 307.2 × 284.0 / H 16、p5 2 / 232.8 × 306.4 / H 136、p6 2 / 275.0 × 247.6 / H 5.5、p7 2 / 230.7 × 224.3 / H 4、p8 6 / 265.3 × 305.0 / H 30；件集 ΣV **1 766 184.4 mm³** == 8 板 ΣV。⑧交付：件集 `cad/output/_r69_parts/`（54 件）、排版 `cad/output/_r69_plate/`、交付包 `deliverables/R69_print_package/`（parts 54 / plates 8 / previews 9 / 3 份 index + README）。遗留：切片器实跑、0.2 mm 胶缝成型、环氧强度、PET 翘边、未实机。DEC-0076 / V-0076）

## CURRENT OBJECTIVE

- **【2026-10-13 / R53b 恢复点】滑座改常闭弹簧夹（自动，无人工）**：见上条「最后更新」。脚本 `cad/paddle_launcher_shooter_lock_r53b.py`，产物 `cad/output/_r53b_auto/`（指向桌面的 junction）。**待用户回答的两个问题**：①比赛中是否需要**在线切换** POLLEN / NECTAR（还是赛前调好一档就够）；②是否还有**空闲舵机通道**（决定要不要做舵机主动解锁 / 夹紧）。这两问决定下一步是收口还是加机构。
- **【2026-10-13 / R51 + R52 交付】发射部分换基线到 2026-10-01 全整机 + 滑窗定版**：触发是用户判据「两个飞轮不能连在一起，这样没法调间隙。你应该使用在『只保留运动部分』之前最新一版的 CAD 做基础来进行改动」。**基线判定（KNOWN）**：`cad/output/paddle_launcher_feasible_pollen.step`（2026-10-01 22:36，414.3 MB / 98 件）—— 它是 `paddle_launcher_motion_only.py --profile motion_free` 的父装配，证据 `cad/output/_r51_base/manifest.json`（`cq.Assembly.load` 直接回读该 STEP）+ 侧视图 `T06_基线_2026-10-01_侧视图.png`（桌面）。**为什么旧版能直接用**：10-01 基线本来就是「两根轴各自独立 + DEC-0037 调隙链（`2000-0025-0002` -> 12 mm 曲柄 -> 65 mm 拉杆 -> 十字头 -> 两根 110 mm 连杆 -> 滑座）」，唯一真缺陷是侧板开口 —— 老 `8.4 x 9` 轴槽只覆盖半间距 80..89（夹口 64..82），够不到 NECTAR 的 86 mm 夹口，而且被 `46 x 12 x 38` 滑座与两根 `5 x 10 x 52` 导轨同时跨占。**R51** 只改两处：拨杆舵机 25-3 -> 25-4、开口改成 **59 x 56 滑窗**（覆盖半间距 80.0..91.2 ⇒ 夹口 64.0..86.4，导轨以 0.5 mm 侧隙靠窗壁导向）。**轴隔离实测（本轮核心判据，MEASURED）**：bbox 保守筛选只剩 `shooter_side_plate_-1`，布尔 0.0 / 0.0 mm³；`carriages_touch_each_other = false`、`shafts_touch_each_other = false` ⇒ `rigid_link_between_axles = []`；侧板专项 15 组布尔（两滑座 / 导轨 x4 / 两轴 / 轴承座 x2 / 马达桥 x4）在两档下**全 0 mm³**。**R52** 再把 R37 送球件 6 件（原世界坐标）+ R49 闸门 9 件（`gate_frame` 对托板让位 530.017 mm³）搬到该底座，新增 `servo_bridge ±26` / `feeder_mount ±1` / 两侧板 `O14.1` 拨杆轴承座：90 件，夹口 pollen 64.0 / nectar 86.0，叶尖到下轮面 5.961 / 8.55 mm，R37+R49 vs 底座 0 干涉、闸门 vs 送球 0 干涉，回读各 282 solids / 体积偏差 -0.0001 % / 包围盒偏差 0.00 mm。**R50 判为 SUPERSEDED**：它的 `shooter_frame_neg/pos` + `shooter_rail_1/2/3` 把两轴刚性相连（见 DEC-0048 补记），但驱动链型号与轴向堆叠被 R52 原样沿用。交付：桌面 `T06_R52_装配图_{pollen,nectar}.png`、`T06_shooter_assembly_R52_{pollen,nectar}.step`；证据 `cad/output/_r51_base/`、`cad/output/_r51_drive/`、`cad/output/_r52_drive/`（DEC-0049 / V-0049 / DEC-0050 / V-0050）。

- **【2026-10-13 / R50 交付】发射部分驱动化 + 支撑结构**：用户指令「给飞轮加上马达，给拨杆加上舵机（两者已经确定型号，注意查找），同时给整个发射部分加上支撑结构……尽可能使用简洁快速方案」。在 R37 运动件与 R49 闸门之上补齐三条链（**原文件一律不覆盖**）：①飞轮驱动 x2 = `5203-2402-0003` 马达 + `1401-0043-0036` 夹具 + `4007-4008-4008` 联轴器；②拨杆驱动 x1 = `2000-0025-0004`（25-4 Super Speed，与 R49 的 25-3 同为双模式）+ `1802-0043-0001` 支架 + `4001-0025-4008`（25T → 8 mm REX）联轴器；③支撑框架 = 双侧 6 mm 打印面板（三个轴心 R34 凸台 + 44 mm 连杆轮廓 + 三条腿）+ 3 根横梁 + 4 个 O4.6 底盘安装孔。**本轮修掉一个真隐患**：舵机联轴器原来用 `Shape.mirror("XZ")` 定姿态，那是绕**世界** XZ 平面镜像，把件搬到 y -105..-88（马达侧）、与舵机完全不接；改成绕自身直径在原点翻转 180° 后，`4001-0025-4008` 落在 y 88.0..105.0（REX 通孔 88..96 套住拨杆轴端、25T 花键孔 102.1..105.0 咬住 101.5 起的舵机花键），实测舵机联轴器 × 舵机 3.182 mm³（花键齿顶轻咬，可接受）、× 舵机支架 / 伺服横梁 / 两侧面板 **全部 0 mm³**。干涉复检共 7 处非零，**全部是轴 / 轴承 / 联轴器的正常径向配合**（联轴器 × 飞轮轴 25.308 ×2、轴承 × 轴 5.883 / 6.725 ×4、舵机联轴器 × 拨杆轴 21.739）。交付：桌面与仓库 `T06_shooter_drive_R50_pollen.step`（363 MB，51 件）、`cad/output/_r50_drive/parts_pollen.json`、三视图 `r50_shooter_drive_view.png`；参数见 `config/parameters.yaml → t06_shooter_drive_r50`（DEC-0048 / V-0048）。**待裁定**：打印件 815.3 cm³ ≈ 1035 g PETG 偏重（是否挖空横梁/面板）、25-4 是否切连续旋转、DEC-0037 调隙链在本框架下的整机落位。
- **【2026-10-12 / R47 交付】** 按用户指令「我要你在MUJOCO仿真用的文件」，把 R47 验收口径台架**落盘为独立 MJCF**（此前全部用 `from_xml_string` 字符串建模、从未落盘）：`simulation/mujoco/out/R47_launcher_mixed4_gap064.xml` / `R47_launcher_mixed4_gap082.xml`（混装 POLLEN,NECTAR,POLLEN,NECTAR，分别对应轮间夹口 64 / 82 mm）、`R47_launcher_4xPOLLEN_gap064.xml`、`R47_launcher_4xNECTAR_gap082.xml`（全同种自洽档位）。每份含 6 个 keyframe `ph000/ph030/ph060/ph090/ph120/ph150`，编码初始球列 + 拨杆起始角；编译期数组改动（摩擦 / priority / 径向让位）已按 geom 名回注进 XML 文本，并与捕获模型逐项比对通过（geom 名 / 摩擦 / priority / pos / size、keyframe0 qpos、nq / nv / ngeom / nbody / nu 全等）。**MJCF 无法表达控制逻辑** ⇒ 挡舌（mocap body `gate_leaf` 的 z 47.5↔139.5 mm 抬落）与「待机停位保持」（188°、Kp=40）必须外部驱动，已交付配套 `simulation/mujoco/run_R47_xml.py`；生成脚本 `simulation/mujoco/gen_R47_mjcf.py` 可复算。验收（真出膛速度取 `cvel[bid][3:6]` 模长，峰值只统计出膛前）：4xPOLLEN gap064 4/4（6.21–6.44 m/s、全清 11.11 s）、4xNECTAR gap082 4/4（5.27–5.44 m/s、11.45 s）、混装 `--pair` 4/4 且自动换档 3 次（6.43 / 5.26 / 6.32 / 5.28 m/s）。桌面副本已同步；更早的 `R47_launcher_4ball*.xml` 已按用户指令删除（DEC-0045）。
**【2026-10-12 / R47 最新恢复点】提速改走「贴低摩擦胶带」**：用户指令「试一试能否通过闸板后移与减小行程来使速度更快，1 分钟太慢了」，本轮把这条路线连同备选一起做尽并**全部判决性否决** —— (1) 闸板后移 x=180->220/240 虽然清空 52.19 -> 35.43 / 16.5 s，但真出膛从 4/4 掉到 **2/4**，原因是后移闸板会连带把整列球往后推、把闸口让给球 ⇒ **闸板失守**，提速是假的（前排球位置与基准逐位一致，证明闸板位置对发射行程零影响）；(2) 缩短扫掠 `--sweep 120/200` 与基准**逐位相同** —— 该参数是死参数，`r38_v8.py` 第 138–139 行把扫掠段硬编码成整圈、第 141 行两段共用同一恒定速度；(3) 三个纯几何旋钮 `--flex-in/--blade-in/--exit-open` 共 5 组在 μ=0.60 下卡滞一律 89 %，**几何救不回来**。真正根因是**摩擦楔自锁**：球在「拨杆叶片顶端 ↔ 外罩出口唇」喉口被楔死，拨杆电机全程贴 0.530 N·m 堵转上限。台架运动学给出算术上限 —— 290 rpm ⇒ 整圈仅 360/(290*6) = 0.207 s，而实测每颗球 15–23 s、卡滞 77–89 % ⇒ **拨杆约 99 % 时间没在转**，「减小行程」的理论收益只有约 0.207 x 4 ≈ 0.8 s，路线在算术上就不成立。改为**零几何改动**的单侧降摩擦：外罩内弧与托板顶面贴低摩擦胶带（等效 μ≈0.30），**拨杆侧不动、不贴带**（用户约束「我没有使用弹性外缘的条件」）。摩擦悬崖：外罩 μ 0.05–0.30 均 5.0–5.2 s / 卡滞 1 %，**0.35 -> 5.41 s / 4 %、0.40 -> 6.76 s / 24 %、0.50 -> 60.4 s / 90 %**，悬崖在 0.40–0.50 之间，**取 0.30 为设计点**。验收（`--liner-shell 0.30 --relief -0.20`，6 相位 0/30/60/90/120/150、mix P>N>P>N、tray 460、gate-x 180、hold 1、μ_ball 0.6、park 188）：**清空 5.28 / 5.23 / 5.22 / 5.23 / 5.23 / 5.23 s，每轮真出膛 4/4、全清 6/6、卡滞 1–2 %、扭矩峰 0.507–0.522 N·m**；恶劣工况 4 x NECTAR 5.33 s / 4/4、4 x POLLEN 5.05 s / 4/4。**胶带厚度（0.2 / 0.5 mm 占位）对节拍无影响 ⇒ 打印件不必预缩，直接贴**。接触测绘定出贴敷位置：外罩内弧 ≈47 % 冲量（极角 **135°–258°**）、叶片推球面 34 %、托板 7 %、出口唇 1.7 % ⇒ **贴外罩内弧 135°→258°（约 123° 弧长）+ 托板顶面**，示意图见 `simulation/mujoco/out/_r47_tape_section.png`。**硬约束：托板倾角 5° ⇒ 托板 μ 必须 > tan5° ≈ 0.09，禁止把外罩/托板降到 0.05**（V-0040 已记录的整队列自滑堆死失效）。相对 R45（66.21 s / 77–89 % 卡滞）约 **13 倍**提速，且未改任何 CAD、未覆盖任何原文件。（DEC-0044 / V-0044）

**【2026-10-12 / R45 最新恢复点】主动索引闸（竖向全宽挡舌 + 真实舵机停位保持）拿到 24/24**：按用户指令「把柱塞改成从侧向摆入的挡舌」先试侧向摆入，被三条互斥约束判死 —— ①闸位 x≈98 处托盘没有 +y 侧导槽壁（壁只到 x=12.5），球可横游到 y≈±54，挡舌必须横跨 108 mm 全宽；②全宽挡舌摆程扫掠半径 106 mm > 球窝球到铰心 100.3 mm，关门必扫球窝球；实测短挡舌 L=40 为 0/4（球从舌尖外侧 y=+42.9 绕过）；③x=98 正上方是下飞轮盘（圆心 x=124, z=179.5, r=48），抬起位 z=139.5 与轮重叠 −18.75 mm，且仿真里挡舌是 `mocap`、飞轮是动力学体 ⇒ mocap 只推别人，不报错但结果被污染。按用户「侧向摆入不行就换路线」改为**自上方竖直下插的全宽挡舌**（只做 z 向平移，无横向扫掠），闸位后移到 **x = 180**、托板加长 **460 mm**。六相位 × 4 颗（mix P>N>P>N、夹口 P64/N82、μ=0.60、hold 3.0）**真出膛 24/24、全清 6/6**（上一版同口径 21/24、5/6，唯一失败轮 ph0=60 只出 1 颗）。**根因不在挡舌而在拨杆待机姿态**：相位机在 settle / settle_tail 段写 `ctrl=0` ⇒ 拨杆变自由摆、重力下垂到 ≈53° ⇒ 弹性指 `paddle_flex_1`（外缘 r=61）正落在球道内的球心半径上（极角 ≈337°，即球道/球窝窗口），与斜托板形成径向夹口，后到的球在 x≈122 被永久楔死（POLLEN 球心 r=72.4 不在此夹口，故只咬 NECTAR）。**真实舵机待机是位置保持、不是自由下垂** ⇒ 台架新增 `--park` / `--park-kp`，相位机写 0 时改为速度伺服保持 J_park（Kp=40 1/s，峰值扭矩 1.6 N·m；25-4 Super Speed 失速 0.530 N·m，侧加 3:1 皮带配重后仍在量级内），补丁放在闸门判决之后 ⇒ 闸门逻辑仍靠 `ctrl==0` 判「拨杆已停」，判据不变。停位角由「挡片极角 = 390 − J 不得落进球道/球窝窗口 [235°,355°]」定为 **J_park ∈ (171°,199°)**，取 **188°**；扫角实测 53–95° 楔死（球停在 x≈116–123）、105–165° 被挡（x≈50–97）、185–205° 进球窝（x≈25–30）；±20° 余量（168/175/195 各跑 ph0=60 单轮全 4/4，非临界设计）。几何检验 `_work/_r45_idxchk16.py 185`：A–F 全段无干涉、抬起位净空 NECTAR +3.3 mm。**口径提醒：台架脚本头部与默认 `GX` 仍是旧的 x=98 描述/取值，本轮实际口径一律以 `--gate-x 180` 为准，判读请回读日志头部 `x=`。**（DEC-0043 / V-0043）

**【2026-10-12 / R44 恢复点】被动分球挡球件这条路已关闭**：按用户指令「两种都做」建了 B1（贴托板铰 + zip-tie 弹性片）与 B2（上铰 + 自重挡爪）两案，在真口径（`tray=350`、`nip-net=86`、交替 mix P>N>P>N、6 相位 0/30/60/90/120/150、hold 3.0，与 R42 同口径）下判决性对照：**B1 6/24 真出膛、全清 0/6；B2 6/24、全清 0/6；不装挡件的对照 19/24、全清 5/6** —— 两案都退化为死墙，参数扫描 18 组（k = 0.002–0.50 N·m/rad、挡件质量 2–50 g、高度 22/50 mm）全部过不去，`DEC-0042 / V-0042`。机理：B1 打开后片体自身变成相对托板 72° 的斜坡（球只能爬 5°）；B2 上铰离托板只有 53 mm，爪尖高度上限就是铰高，而 NECTAR 通过需 ≥ 94 mm；更深一层是**单颗球驱动力只有 0.05 N(POLLEN) / 0.11 N(NECTAR)，整条 4 球队列的全部推力也只有约 0.15 N，与「挡得住」的门槛同量级 ⇒ 被动分球在本几何下没有可分区间**。同时把无挡件基线的真实失败重新解读为**一次扫掠连发多颗**（ph0=0/30 两轮球 2 与球 3 仅相隔 0.21/0.18 s 被同一轮扫掠带出，第 3 颗以 v=1.49/1.60 m/s「速度不足」；ph0=60 整轮只出 1 颗）⇒ 下一步要的是**索引机构**（索引杆 / 舵机主动销闸 / 停位仓），不是被动挡件。**加长托板 215→350 mm 对 19/24、5/6 零影响（与 R42 的 tray=285 基线逐轮一致）—— 无害也无收益，保留的唯一理由是队列多容一颗球；若要落进 CAD，需把 `simulation/mujoco/_work/r37_multiball.py` 的 `TRAY_X1` 由 215 改 350 并出剖面图（该文件在禁改清单内 ⇒ 走包装脚本，待用户确认）。**

按用户最新指令完成 T06/C06-B 官方采购件 CAD 导入，并将电机、舵机等采购总成在工作装配中按「每个 SKU 的整个官方部件」处理（多实体保持多实体，不做布尔并集，DEC-0021）；T06 多球进料已在 R37 按方向 B 落地（等待区搬到拨杆扫掠圆外、托板右端 150→215 mm，容量 NECTAR 2 / POLLEN 3，DEC-0035），并完成自制件重叠清理（DEC-0036）；R37 已接入 MuJoCo 多球仿真（NECTAR×2 12/12、POLLEN×3 15/18，V-0037）。**R38（2026-10-12）已按真实调隙舵机刚性两档把 NECTAR 运行夹口由 82 重算为 86 mm（DEC-0037 / V-0038），多球全流程 6/6 全清、24/24 真出膛，NECTAR 出膛 v +13 %、轮系接触冲量 −43 %**；同轮把节拍瓶颈定位到**拨杆扭矩**（0.530 N·m 在运送段饱和，实际只有约 22 °/s）。**R39（2026-10-12，DEC-0039 / V-0039）已完成送球部分结构优化的第一版，并把瓶颈改判为「球—球道滑动摩擦」**：在外罩内弧（142–275°）与托板顶面各加 0.5 mm × 88 mm PTFE 内衬、打印件按带厚预缩（球看到的表面与 R38 逐面重合，轨迹不变），同台架单变量把有效 μ 由 0.60 降到 0.05 ⇒ 清空 **47.11 -> 10.0 s**（hold 1.0 s 时 **4.0 s**）、卡滞 **72 % -> 1 %**（4 %），全清 6/6、真出膛 24/24、出膛 v 不退化；交付几何检验 5/5 pass。否证项：只贴外罩只有一半收益、8 种拨杆型面无可测差异 ⇒ 拨杆几何不改。下一步：压缩 hold 造成的固定等待（内衬到位后的节拍主导项）与等待区第 2 颗球的索引进扫掠圆（V-0037 遗留），外部供料路线随进料口外移到 x = 215 调整（KEI-19，用户已批准改），并用实物关闭 μ（PTFE 带）、带材贴合与轴向紧固/高速动态风险。

## CURRENT MODULE

当前工作对象是 Architecture v0.1 的 T06/C06-B 主发射原型；回滚后的 `paddle_launcher_constrained.py` 已升级为 `C06B-COTS-0.3`。T04、T05、T07 和 KEI-16 历史均保留，未被本次修改覆盖。

## CURRENT DESIGN MATURITY

S00：M0通过。T06：C06-B维持 M3 COTS-CONSTRAINED PACKAGING；目录映射、13 个官方 STEP 回读、每 SKU 整体部件表示（多实体保持多实体）、轴向名义计算和端点干涉已通过，实物公差与旋转测试未关闭。KEI-16导入参考和T04 C04-B1维持各自M3状态；T05为M1共享动力接口，T07为M0增量研究。

## COMPLETED

- **R45（DEC-0043 / V-0043）主动索引闸**：`simulation/mujoco/_work/_r45_gate4.py`（= `_r45_gate3.py` + `--park` 待机停位保持）拿到 6 相位 × 4 颗**真出膛 24/24、全清 6/6**（旧版 21/24、5/6）；挡舌 24 次动作全部干净（抬起 → 球过闸口 → 下插）；单颗节拍 ≈22.8 s（NECTAR）/ ≈15.6 s（POLLEN）。侧向摆入路线按三条互斥约束判决性否决（无侧壁 / 摆程半径 > 铰到球窝距 / 正上方是下飞轮），按 superseded 保留。
- `C06B-COTS-0.1` 已淘汰 Ø38 无 SKU 电机夹具、16 × 7 mm 轴承、194 mm 轴和无 SKU 联轴器占位，替换为 goBILDA `5203-2402-0003`、`1401-0043-0036`、`4007-4008-4008`、`2106-4008-1680` 和 `1611-0514-4008`。
- 双飞轮轴继续各自直驱，外置齿轮数量为0；两台电机统一移至−Y侧，+Y双连杆调隙侧保持无遮挡。
- 侧板改为8.4 mm轴槽（17.4 mm总长），轴承留在外置滑座；POLLEN/NECTAR两端点的COTS干涉检查通过。
- `C06B-COTS-0.3` 已下载、哈希登记并保留 13 个 goBILDA 官方 STEP；工作装配按 DEC-0021 把每个采购 SKU 的整个官方部件带入装配（9 个多实体、4 个单实体），布尔并集链已按实测否决并退役，原始供应商多实体文件不被覆盖。
- 官方 CAD 回读关闭了先前电机、夹具、联轴器和舵机包络假设；按整体官方部件几何回读，总包络更新为约 383.849 × 364.776 × 400.024 mm。
- 修正送料支撑颊板轴孔误切在 Y=0 的穿模缺陷；孔现分别与 Y=±62 mm 颊板和送料轴同心。
- T06 报告 16/16 检查通过（含新增“未对任何采购件执行布尔并集”检查）；13 个采购件工作模型按 DEC-0021 整体带入，9 个多实体、4 个单实体；项目自动测试 40/40 通过。
- `tools/inspect_geometry.py` 几何检验达到全通过：`R004` 共 77 项（23 项规格检查 + 54 项逐 SKU 整体部件检查）全部 `pass`，0 `fail`、0 `unresolved`，退出码 0，用时 1483 s；报告见 `cad/output/inspection/t06_launcher_R004.json`。
- `R003` 暴露的 3 项 `unresolved` 根因是 `gecko_flywheel_*`、`sonic_hub_*`、`bearing_insert_*` 三类采购件的装配命名未携带 SKU，自动检查按 SKU 匹配落空（顺带导致 `1908-0025-0032` 只被检查到一个放置位）；已把 SKU 补进这三类命名并同步更新规格引用，自动检查由 33 项增至 54 项，每个 SKU 的全部放置位都被覆盖。
- 几何检验工具按 `AI_Long_Running_Process_No_Output_Guide.md` 改造：阶段日志、20 s 心跳、`--progress-file` 进度文件与显式 flush，STEP 回读检查细分导出/回读/比对子阶段，使长时间无输出的运行可被判为 ACTIVE 而非卡死。

- `KEI16-FLIPOUT-COTS-0.2` 已把占位传动替换为 goBILDA/REV COTS 规格：312 rpm 单电机、24T:24T 斜齿轮、两段 14T/38 节链、16T:24T/460 mm HTD5 前轴带路、双弹簧/双棘爪/双硬止挡。
- 新增可复算输入、脚本、结果和6项单元测试；重新生成展开/收纳 STEP、STL、GLB、PNG 与 JSON 报告。
- `DEC-0018` 明确一次性弹出、手动收纳边界，并保留当前 T04 编号和 C04-B1 历史。

- 检查工作目录；未发现既有仓库或工程资料。
- 初始化本地 Git 仓库和要求的目录骨架。
- 创建工程协作规则、需求/架构/接口/验证模板、参数主源和日志。
- 建立暂定模块分解、统一坐标约定和成熟度/验证关口。
- 登记并核验 BIOBUZZ Competition Manual TU01、官方场地 STEP、5203-2402-0051 电机 STEP 和 3209-0001-0007 底盘 STEP。
- 从规则建立合法包络、得分物体、计分、控制数量、执行器与电源约束。
- 根据 BIOBUZZ 任务将模块重组为 T04 获取、T05 输送/缓冲/路由、T06 HIVE 发射、T07 FLOWER 处理、T08 控制与自主。
- 建立 P1–P4 任务组合候选；尚未选择机构方案。
- 固化底盘不变量：保持轮距、轴距和四轮相对布局，只允许最低限度拆分重组。
- 将 5203-2402-0051 降级为通用 goBILDA 电机包络参考；实际电机由后续计算选型。
- 确认 REV-31-1595 Control Hub、REV-31-1153 Expansion Hub 和 goBILDA 3100-0012-0020 电池。
- 保存并核验电池尺寸图；建立往届 FTC/工业设计先例的使用与再验证规则。
- 用户批准 Requirements Baseline v0.1 和 Architecture Baseline v0.1。
- 完成 TS-S00-001 P1–P4 加权比较、四种权重敏感性分析及可复算 Python 脚本。
- 建立初始 FTC/系统工程设计先例目录，并记录可迁移原则与赛季差异。
- 曾形成 TS-S00-001 v0.1 首轮策略（P2/P3 并行、P4 暂缓）；该策略已由 v0.2/DEC-0010 明确取代，保留本条仅作变更历史。
- 配置仓库本地提交署名 `yutian <wagnyutian923@126.com>`、GitHub `origin` 和 `main` 上游分支；首个工程基线已安全推送。
- Git Credential Manager 使用 Windows Credential Manager 保存认证；已启用每天 20:00（America/Chicago）的安全检查点自动化，重要验证节点立即推送。
- 按用户要求把战略总权重从 25% 提高到 70%，并用 TU01 分值、RP、时间窗口与解锁关系重建 TS-S00-001 v0.2。
- 修订任务包方向：P3 为主 M1、P4 为资源关口约束的扩展、P2 为 HIVE 风险回退；P1 仅作为共同底座。
- 建立 P3-M1 v0.1：C06-A 单飞轮曲面压板、C06-B 对置双飞轮、C06-C 可调弹射器三个概念及失效模式。
- 完成 P3-BAL-0.1 真空弹道扫参、P3-MOT-0.1 电机/轮速初筛和 P3-TS-001 概念比较；输入、脚本、CSV 和测试均已落盘。
- 建立 IF-T05-T06-01、IF-T02-T06-01、IF-T03-T06-01、IF-T08-T06-01、IF-T06-ENV-01 草案。
- 初步选择 C06-B/C06-A 进入共用可调台架，C06-C 作为风险回退；未冻结最终机构。
- 完成 P3-LAUNCHER-CMP-0.2 约束优先比较：解析证明单轮静止压板和等速对置双轮的平移/自旋关系、20 mm 球径差的压缩变化及单侧/对称调隙中心线差异。
- 选择 C06-B 对置双飞轮为主原型，C06-A 单飞轮曲面压板作为同台对照和资源回退；旧 P3-TS-001 主观加权分不再承担选择理由。
- 定义共享 intake 的 FLOWER 边界：底部逐个取出 POLLEN 纳入基线且不增加电机；顶部低速放球仅保留安装/控制接口。
- 建立 IF-T04-FLOWER-01、IF-T04-T07-01 和 VAL-T06-005/VAL-T04-001/VAL-T07-001。
- 完成T01-DRIVE-TRADE-0.1：量化四电机麦克纳姆、四电机差速和两电机差速的端口、质量、理想功率/牵引力、等工况电力与横移路径边界；当前保留四电机麦克纳姆。
- 建立C04-A上方薄拨叉+末端落钩+顺从分段roller方案；FLOWER功能使用2舵机但不增加直流电机。
- 将T04 roller与短预输送合并为1个带编码器电机动力源，单球节拍由舵机闸门承担；与四电机底盘、双飞轮合计7个电机，保留1端口。
- 建立T04-INTAKE-0.1输入、复算脚本、CSV、单元测试、IF-T04-FLOWER-01 v0.2、IF-T04-T05-01及VAL-T04-002/003。
- 建立可交互的FLOWER取球动作侧视示意，覆盖对位、上方伸入、落钩、回拉和roller接管五个状态。
- 按用户草图把C04-B定义为标准roller之外的FLOWER补充拨杆，并拆分为只经底部Retrieval Opening离开的C04-B1与规则排除的真实侧出口C04-B2。
- 完成T04-INTAKE-0.2名义台阶/斜面运动学、舵机力矩和资源复算；建立C04-A/B1证据评分、规则硬门槛和预登记A/B夹具方案。
- 将C04-B1提升为首个L3/L6原型，C04-A保留回退；更新IF-T04-FLOWER-01 v0.3、VAL-T04-004/005和DEC-0015。
- 建立C04-B1双通道、底部边界和抬升动作交互示意。
- 登记SRC-016独立FLOWER STEP并以SHA-256锁定；CadQuery测得34实体和169.380 × 156.559 × 595.211 mm名义包络。
- 完成T04-FLOWER-SWEEP-0.1：纯−X横移因左后短支柱干涉淘汰；从−X朝−Y偏25°后，完整球、3×20×32 mm拨片和Ø60×120 mm roller名义实体交叠均为0。
- 将目标舵机用户参数纳入T04-INTAKE-0.3；6 V直驱不满足，初模采用3.2:1减速并保留2.9 A堵转/电源瞬态开放项。
- 生成并回读C04-B1 M3参数化CadQuery初模：机构独立STEP 6实体，组合STEP 40实体；未建模舵机未知外形、紧固件或制造细节。
- 将目标舵机确认为REV-41-3336 Smart Robot Servo V2 - UltraSpeed；核验官方规格、单页尺寸图和STEP，并登记REV-41-1828铝舵盘接口。
- 用严格角度/力双边界比较3.2:1圆弧回退与卷线鼓直线驱动；首轮原型改用17 mm节圆半径单层卷线鼓，保留已验证的60 mm直线路径。
- 生成三件可打印验证件：舵机夹持/开式导轨支架、卷线鼓和25°楔形滑块；同时生成组合STEP、预览、清单和制造边界说明。
- 以REV-41-3336官方STEP替换代理舵机，加入REV-41-1828官方舵盘，并按官方4×Ø4.5孔位重建支架；输出保留5个命名组件的Fusion 360装配STEP。
- 导入并保留单电机翻转 Intake、连续 feeder 和 launcher 的参数化 CAD/STEP/STL/GLB/PNG/JSON 参考资产；其中翻转 Intake 以视频可见结构为证据，20T:28T、178 mm 翻臂、24T:36T 前轴和部署锁扣均为待实体验证的项目基线，不取代当前 T04 C04-B1 决策。
- 合并 GitHub、Linear 与 Notion 的接手语义：当前架构 Intake 编号为 T04；Linear KEI-16/Notion 页面中的“T02 Intake”保留为导入参考记录，后续 AI 不得混淆为当前 T02 主承力结构。
- 2026-09-27 重新核对本地 `main`、GitHub、Linear KEI-16 和 Notion Intake/System Architecture；未发现新的未同步工程文件或重复事项。README 增加面向未来 AI 的直接启动提示、数据权威顺序、最小验证命令与需要请求实物数据的停止条件。

## VALIDATED

- `CALCULATED` 两段 38 节、14T、8 mm pitch 链的中心距均为 96.000 mm；460 mm HTD5 配 16T:24T 的中心距为 179.887 mm，小带轮啮合 7.82 齿。
- `CALCULATED_FROM_VENDOR_SPEC` 固定 Ø60 roller 空载表面速度 0.980 m/s；前端 73 mm 指尖空载速度 1.590 m/s。
- `CALCULATED_FROM_ASSUMPTIONS` 双弹簧在收纳/展开端提供 2.146/1.852 N·m 部署力矩；REV锁扣舵机静态解锁估算仅需其6 V目录堵转扭矩的5.6%。
- `VALIDATED_GEOMETRY` 新版展开/收纳 CAD 均成功导出；包络约 451.58 × 444.00 × 224.71 mm 和 320.97 × 444.00 × 269.01 mm，当前方向几何筛查通过。
- `VALIDATED_CALCULATION` `tests/test_kei16_flipout_drive.py` 6/6 通过；所有注册设计检查为 true。

- `KNOWN` 目录与最小文件框架已存在。
- `KNOWN` 未开始详细机械设计、最终 CAD 或完整仿真。
- `KNOWN` 必需路径检查通过；Git 已初始化并使用 `main` 分支。
- PDF 关键页面已完成文本与渲染图像交叉核验，范围记录于 SRC-001。
- STEP 压缩包、文件身份、架构版本和单位元数据已检查；尚未测量代理包络。
- `config/parameters.yaml` 已人工结构审查；当前环境仍无 YAML 解析库，机器解析测试保留为待办且未伪报通过。
- 电池图纸包络 124 × 47.8 × 43 mm、120 mm 线束、XT30、16 AWG 和 20 A 保险丝已目视核验。
- TS-S00-001 v0.2 的脚本输出与保存 CSV 完全一致；权重总和、战略默认权重 70%、评分范围和半分增量断言通过。
- 战略权重为 60%、70%、80% 时，P3 均为第一、P4 均为第二；默认得分 P3 84.8、P4 78.2、P2 55.7、P1 55.4。
- PDF 文本与已渲染 pp.83–91 交叉核验了比赛阶段、HIVE/FLOWER/GARDEN 规则及 Table 10-2/10-3。
- PDF 文本与渲染 pp.71–72、87 交叉核验 HIVE/CELL 几何和合法 TIP 方法。
- P3 计算测试 6/6 通过；生成 CSV 与脚本重生成结果一致。
- `CALCULATED` 1.5 m、55°、400–700 mm 出射高度需要约 4.92–5.56 m/s；模型忽略阻力/旋转，未伪报为实测。
- `CALCULATED` 312/1150 RPM 直驱未通过；1620 RPM + 120 mm 进入原型范围，6000 RPM 需减速/限速。
- `ASSUMED` 概念初筛为 C06-B 76、C06-A 69、C06-C 66；仅用于原型排序。
- P3-LAUNCHER-CMP-0.3复算通过；v0.2的运动学证明保持不变，v0.3把C04-A共享动力纳入资源预算。
- `CALCULATED_IDEAL` 5.5557 m/s 基准球速下，120 mm 单轮+静止压板理想轮速为 1768.4 rpm 并产生自旋；等速对置双轮为 884.2 rpm/轮且理想净自旋为零。该结论不代表真实效率或精度。
- `CALCULATED` 两球名义直径差 20 mm；固定间隙的压缩量相差 20 mm；单侧调隙的局部球心移动 10 mm，对称调隙保持名义中心线。
- `CALCULATED_NOMINAL` FLOWER 顶口对 POLLEN/NECTAR 径向余量为 15.25/5.25 mm；底部取 POLLEN 的名义高度余量为 19 mm；只证明名义几何未排除，不替代实体试验。
- `KNOWN` TU01 G418 已核对：得分物体只能从顶部进入 FLOWER，且只能从底部取出 POLLEN；G410 禁止最后 60 秒前让 NECTAR 进入 FLOWER 计分体积。
- 项目单元测试现为40/40通过；T01/T04生成CSV与脚本可重复生成；相关 M3 STEP均已回读。
- `CALCULATED` C04-A的4 mm拨叉从名义Ø71 mm POLLEN上方通过90 mm开口时剩余15 mm总间隙；名义Ø91 mm NECTAR比开口高1 mm，控制与几何均排除底部取NECTAR。
- `CALCULATED` Ø60 mm roller在80–160 rpm FLOWER模式表面速度为0.251–0.503 m/s；10 N假设回拉力对应0.30 N·m轴矩和约1.38 A线性模型电流。
- `CALCULATED` 10 N、80 mm力臂和2.0结构安全系数要求1.6 N·m拨叉校核力矩；0.5 N/mm×20 mm串联弹簧把刚性接触限制在约10 N。
- `CALCULATED` 两电机差速相对当前底盘释放2端口/移除874 g电机，但理想峰值轴功率和电机限制牵引力均减半；C04-A共享动力已使换底盘不再是释放shooter端口的必要条件。
- `KNOWN` G418规则门槛已用于区分侧向运动与侧面出口：C04-B1必须在球完全离开FLOWER前保持于底部Retrieval Opening边界；C04-B2不进入设计。
- `CALCULATED_IDEAL_STEP` 名义Ø71 mm球跨越13 mm理想环唇需要27.46 mm水平行程，初始无摩擦水平推力为球重的1.22倍；20–30°工作面提供13 mm抬升需要26.00–38.01 mm理想路径。
- `CALCULATED_FROM_ASSUMED_LOAD` C04-B1按10 N、70 mm力臂和2.0安全系数校核为1.40 N·m；不增加直流电机，名义使用1个专用舵机。
- `MEASURED_FROM_CAD` SRC-016 Retrieval Opening净高90.170 mm；13 mm抬升后Ø71 mm球对上球托仍有6.120 mm名义间隙。
- `REJECTED_GEOMETRY` 纯−X横移对短支柱净空−5.437 mm，最大实体交叠590.763 mm³；不得继续作为候选路径。
- `SIMULATED_NOMINAL` 25°斜向路径支柱解析余量3.680 mm，球/拨片/roller名义实体交叠均为0；仅批准M3初模，不代表实物通过。
- `CALCULATED_FROM_VENDOR_SPEC` 目标舵机6/7.4 V堵转力矩为0.549/0.608 N·m；70 mm圆弧回退在6 V、80%效率、50%堵转运动边界要求3.187:1，3.2:1可提供10.04 N；60 mm端点弦长需舵机162.41°、理想无负载0.116 s，但有6.75 mm弓高偏差。
- `KNOWN_VENDOR_VERIFIED` 目标舵机为REV-41-3336：默认270°、可编程最大280°、500–2500 µs、25T、中心M3×0.5最大6 mm深；官方STEP回读1实体且总包络20.151 × 43.550 × 54.000 mm。
- `CALCULATED` 17 mm卷线鼓完成60 mm直线行程需要202.220°；居中端点751.0/2249.0 µs；6 V理想无负载时间0.145 s。可行半径区间为12.73–19.10 mm。
- `CALCULATED_FROM_ASSUMPTIONS` 6 V、80%效率、50%堵转、1.5 N回位载荷下，17 mm卷线鼓可提供11.42 N外载；短时结构边界24.34 N，分别超过10/20 N原型门槛。
- `VALIDATED_GEOMETRY` 三个打印件STEP均回读为单一有效实体；组合STEP为5实体；三个STL均为封闭流形，边界边/非流形边计数为0。
- `VALIDATED_ASSEMBLY` Fusion 360 STEP回读5个有效实体、190 × 85 × 45 mm包络；保留支架、官方舵机、官方舵盘、卷线鼓和拨片5个产品名称；非配合件两两实体交叠为0。

## OPEN QUESTIONS

无未关闭 CRITICAL 信息项。

项目时间表、预算、命中率/周期目标、软件栈和维护目标仍为IMPORTANT。KEI-16还需底盘/T05接口、轴向堆叠、弹簧料号、打滑器结构和实测堵转/碰撞数据；C04-A/B1仍需实际POLLEN尺寸、FLOWER夹具和取出力。两条分支均未达到M4冻结条件。

## KNOWN PROBLEMS

- （SIMULATED，V-0038）T06 送球节拍受**拨杆扭矩**限制：290 rpm 恒速指令下负载实际只有约 22 °/s，0.530 N·m（25-4）在运送段已饱和，6 相位多球卡滞占比 69–70 %、清空 41.95 s；夹口 82→90 不改变该时间 ⇒ 提节拍必须动拨杆减速比 / 扭矩臂或缩短运送角行程（见 NEXT ACTION 0.1）。
- 规则仅为 TU01；后续 Team Update 可能改变阈值或合法性要求。
- 底盘轮距/轴距及底盘、电机、Control Hub 代理包络尚未从 STEP/实物测量，不能用于尺寸承诺。
- 缺少性能目标、时间表和预算。
- TS-S00-001 v0.2 的战略输入来自规则，但工程评分仍是证据锚定的假设，不是测量；不能用来预测比赛成绩或冻结最终机构。
- FTC 先例多来自不同赛季和不同形状物体，所有机构原则必须针对 BIOBUZZ 重新验证。
- P3 真空弹道未包含轻质开孔球的阻力、Magnus 效应、球体变形或动态 HIVE；结果只作为台架起始窗口。
- 还没有实物球质量、轮速—球速传递系数、命中散布、连续射击恢复和温升数据。
- C06-B配合C04-A共享intake/prefeed动力后使用7个电机并保留1端口；该余量尚未分配。相对C06-A至少增加的396 g只含电机，不含第二轮组、支架和护罩。
- FLOWER 名义尺寸为约数且场地存在制造变化；5.25 mm NECTAR 顶口径向余量不足以支持未测量的可靠性承诺。
- C04-A的40 mm拨叉宽度、70–105 mm伸入范围、12 mm落钩和10 N限力均为原型参数，不是制造尺寸；必须从官方STEP/实体夹具验证管件和环避让。
- C04-B1的20–30°工作面、40–70 mm侧扫、10 N限力和单舵机假设均为原型参数；完整球体若穿越FLOWER侧边界即违反方案定义，理想台阶计算不能替代STEP与实物证明。
- C04-B1 25°路径只有3.680 mm名义支柱余量，不能覆盖未知场地公差、球非圆度或机器人对位误差；初模没有舵机真实外形、安装架、轴承、导板、传动件和制造公差。
- 新验证支架是官方孔位舵机安装+开式重力导轨，适合低成本台架，不具备整机姿态保持、护罩或最终机器人安装接口；不得直接作为比赛零件发布。
- 17 mm卷线鼓计算假设单层、不打滑和1.5 N最大回位载荷；绳叠层或弹性会改变实际行程/输出力，必须用机械止挡和实测关闭。
- 单电机共驱roller与短预输送可能在闸门关闭时压缩球列；需要打滑张紧、舵机离合或其他卸载设计和混合球循环试验。
- 定时上传依赖本机在线、GitHub 凭据有效且当前任务可运行；认证、验证、远程领先或分叉时自动化将停止上传并请求人工处理。
- 平铺 `cad/*.py` 与 `cad/output/` 中包含导入的参考/早期设计资产；它们尚未映射到 `config/parameters.yaml` 和当前模块接口，不能仅因已生成 CAD 就视为 Architecture v0.1 已采用。
- KEI-16的3.4 A/200 ms保护、0.8 ±0.1 N·m打滑、15–30 N/侧弹簧和250 N/侧硬止挡均是台架起始假设；没有 `MEASURED` 证据前不得发布制造图。
- KEI-16 CAD总宽444 mm距457.2 mm包络只剩约13.2 mm总余量，尚未计入全部真实紧固件、护罩和公差。

## ASSUMPTIONS

- ASM-005：默认战略总权重 70%，工程评分在无台架数据时采用规则/几何锚定判断，并用 60%–80% 敏感性检查。
- ASM-006..008：P3 采用真空弹道、0.65 轮面传递比及 0.75–2.0 m/50–60° 参数扫参，均待 L3/L6 证据替换。
- P3-LAUNCHER-CMP-0.3的无滑移双平面接触模型只用于证明拓扑运动学；实际球速、自旋和散布必须按方案分别实测。
- T04-INTAKE-0.1采用10 N原型限力、4 mm拨叉、60 mm roller和80–160 rpm FLOWER速度；均须由L3/L6替换或确认。
- ASM-009：SRC-016已把C04-B1收敛到25°斜向、60 mm拨片行程/120 mm球验证行程；名义几何关闭，实体摩擦/公差/堆载待VAL-T04-005。
- ASM-010：REV-41-3336按6 V、17 mm卷线鼓、80%传动效率、50%堵转运动边界和≤1.5 N回位载荷推进；3.2:1圆弧方案只作回退，7.4 V未默认批准。
- 坐标方向是可撤销的工程约定，见 `docs/module_interfaces.md`。

## FILES MODIFIED

- `AGENTS.md`
- `README.md`
- `PROJECT_STATUS.md`
- `docs/*.md`
- `config/parameters.yaml`
- `references/source_register.md`
- `references/gobilda_3100-0012-0020_dimensions.png`
- `references/design_precedents.md`
- `calculations/task_package_trade.py`
- `calculations/task_package_trade_results.csv`
- `docs/p3_hive_concept.md`
- `calculations/p3_launcher_inputs.json`
- `calculations/p3_ballistics.py` / `p3_ballistics_results.csv`
- `calculations/p3_motor_screen.py` / `p3_motor_screen_results.csv`
- `calculations/p3_concept_trade.py` / `p3_concept_trade_results.csv`
- `docs/p3_launcher_comparison.md`
- `calculations/p3_launcher_comparison.py` / `p3_launcher_comparison_results.csv`
- `tests/test_p3_ballistics.py`
- `docs/t01_drive_trade_study.md`
- `calculations/t01_drive_trade_inputs.json` / `t01_drive_trade.py` / `t01_drive_trade_results.csv`
- `tests/test_t01_drive_trade.py`
- `docs/t04_intake_concept.md`
- `docs/t04_intake_side_sweep_trade.md`
- `calculations/t04_intake_inputs.json` / `t04_intake.py` / `t04_intake_results.csv`
- `tests/test_t04_intake.py`
- `calculations/t04_flower_sweep.py` / `t04_flower_sweep_results.csv`
- `calculations/kei16_flipout_drive_inputs.json` / `kei16_flipout_drive.py` / `kei16_flipout_drive_results.json`
- `tests/test_kei16_flipout_drive.py`
- `tests/test_t04_flower_sweep.py`
- `cad/modules/t04_intake/side_sweep_intake.py`
- `cad/modules/t04_intake/model_manifest.json`
- `cad/modules/t04_intake/flower_side_sweep_prototype.py`
- `cad/modules/t04_intake/prototype_manifest.json`
- `exports/step/t04_c04b1_*capstan*_m3.step` / `*paddle*_m3.step` / `*bracket*_m3.step`
- `exports/step/t04_c04b1_fusion360_assembly_m3.step`
- `exports/stl/t04_c04b1_*_m3.stl`
- `exports/drawings/t04_c04b1_capstan_fixture_m3_preview.png`
- `.gitignore`
- `simulation/mujoco/out/R47_launcher_mixed4_gap064.xml` / `R47_launcher_mixed4_gap082.xml` / `R47_launcher_4xPOLLEN_gap064.xml` / `R47_launcher_4xNECTAR_gap082.xml`（R47 台架 MJCF 交付）
- `simulation/mujoco/run_R47_xml.py`（MJCF 驱动脚本，含混装换档）
- `simulation/mujoco/gen_R47_mjcf.py`（MJCF 生成/校验脚本）
- `cad/README.md`、`cad/*.py`、`cad/output/*` 和 `docs/engineering/*`（2026-09-24 导入参考基线）

## LATEST DESIGN VERSION

Framework v0.7.2；Requirements v0.1 APPROVED；Architecture v0.1 APPROVED；T01-DRIVE-TRADE-0.1；T04-INTAKE-0.4 / T04-INTAKE-CMP-0.3；T04-C04B1-M3-0.3 FUSION360 ASSEMBLY VALIDATED；KEI16-FLIPOUT-COTS-0.2 M3 PACKAGING/CALC VALIDATED；C06B-COTS-0.3 M3 OFFICIAL-CAD-DERIVED WHOLE-OFFICIAL-PART PACKAGING VALIDATED（候选，待人工接受）；P3-LAUNCHER-CMP-0.3；T06-R47-MJCF-1.0（R47 台架 MJCF 交付，候选，待人工接受）。T06-MOTION-BASELINE-R48（运动部分几何基准文档 + 桌面 Fusion 运动版 STEP 交付，候选，待人工接受；DEC-0046 / V-0046）。T06-R60B-PRINT-SET-1.1（R60B 打印件全集 STEP：**45 个具名实体** = merged frame + 2 条单件加厚滑轨 + 42 个自制件，一份文件即含全部需打印件；36 件无 SKU COTS 硬件已排除；几何审计 21/22 PASS，唯一未消解项 = 用户已接受的 380 mm 单件滑轨，DEC-0066 / V-0065；候选，待人工接受）。T06-R66-PRINT-PACKAGE-1.0（R66 打印包：**55 件**统一到 `cad/output/_r66_parts/`，放平排版为 **4 块** H2D 板 `cad/output/_r66_plate/`，并汇总交付到 `deliverables/R66_print_package/`（`plates/` 4 个 STEP 可直接打印）；DEC-0074 / V-0074；候选，待人工接受）。T06-R67-PRINT-PACKAGE-1.0（R67 修订：放平判据由「64 个 90° 姿态」扩为「∪ 每个平面法向朝下」，拨杆 `paddle_rotor` H **84 → 30**、贴床面 **0 → 1152 mm²**，4 板 extent ≤ 315 × 310，交付 `deliverables/R67_print_package/`；DEC-0075 / V-0075；候选，待人工接受）。

## MOTION-ONLY SIMULATION EXTRACT?2026-10-02?

- ????????????????????????????????? + ? + ??????????? + ???????????????????????
- ?? `cad/paddle_launcher_motion_only.py`??? `paddle_launcher_constrained.build()` ???????????????????????????????????? 2026-10-02 ???????????????????
- ?????????? `.gitignore` ???????`cad/output/paddle_launcher_motion_only_nectar.step/.stl`?`paddle_launcher_motion_only_pollen.step/.stl`????? `cad/output/paddle_launcher_motion_only_report.json` ? `paddle_launcher_motion_only_nectar_overview.png`?
- ???????? 30 ???? 68 ??185 ????POLLEN ?? 266.3 ? 364.8 ? 312.5 mm?NECTAR 273.4 ? 364.8 ? 318.1 mm?? 160/178 mm ????????
- ???POLLEN?MEASURED????? 185 ??????????????? 0.009 mm?????????? 383.849 ? 364.776 ? 400.024 mm ??NECTAR ?????????????? `not_run`?
- `paddle_launcher_feasible_*` ??????????????

## MOTION VERSION EXTRACT（运动版，2026-10-03）

- 用户要求出「运动版」：去除马达、舵机、轮毂（Sonic hub）与联轴器，只保留拨杆（paddle rotor）和飞轮（Gecko flywheel），并加回小球从拨杆到飞轮的斜坡（与原文件逐件完全一致）；同时去掉拨杆周围的三根轴。
- 三根「轴」经几何判定为 `paddle_hinge_1/2/3`：每根 10 mm x 100 mm 销轴，半径 r = 46.0 mm、相位 138° / 258° / 18°，与用户截图量测的圆环位置一致（KNOWN）；本轮一并剔除。
- `cad/paddle_launcher_motion_only.py` 新增 `--profile motion_free` 档案（另有 `--no-shafts`、`--with-fingers`）。依旧复用 `paddle_launcher_constrained.build()`，逐件复制已定位实体、不重新求解位置，故相对物理位置与原文件一致。
- 产物（KNOWN，2026-10-03 12:47–12:51）：
  - `cad/output/paddle_launcher_motion_free_pollen.step` (169.5 MB) / `.stl` (728.1 MB)
  - `cad/output/paddle_launcher_motion_free_nectar.step` (169.6 MB) / `.stl` (728.0 MB)
  - `cad/output/paddle_launcher_motion_free_report.json`
- 筛选结果：保留 31 件 / 剔除 67 件，共 38 实体。保留清单为 `gecko_flywheel_*` x4、`flywheel_shaft_*` x2、`paddle_hub`、`paddle_arm_*` x3、`paddle_blade_*` x3、`paddle_flex_tip_*` x3、送料轴 `paddle_shaft_2106-4008-1920`、`guide_floor_*` x3、`guide_roof_*` x3、`guide_wall_*` x6、`shooter_throat_*` x2。
- 包络（CALCULATED）：POLLEN 313.352 x 192.115 x 318.275 mm；NECTAR 320.444 x 192.115 x 323.816 mm。Y 向由 364.8 mm 缩至 192.1 mm，因为支撑侧板与底轨已去除，只剩导槽（宽 114 mm）与轴（长 192 mm）。
- STL 二进制头三角形数：POLLEN 15,268,330 / NECTAR 15,267,968，均与文件长度精确吻合（MEASURED）。
- 回读校验脚本 `tmp/verify_motion_free.py`（临时，未入库）。
- `paddle_launcher_feasible_*` 与 `paddle_launcher_motion_only_*` 时间戳未变，原文件未被覆盖。
- `.gitignore` 已追加忽略 `cad/output/paddle_launcher_motion_free_*.step/.stl/.glb`。

## MOTION VERSION + BACKFLOW FINGERS（2026-10-03 追加）

- 追加导出含止回指的版本（`--with-fingers`）：`cad/output/paddle_launcher_motion_free_fingers_{pollen,nectar}.step/.stl` 与 `paddle_launcher_motion_free_fingers_report.json`；保留 33 件 / 40 实体，包络与不含指版本一致（指件落在原包络内）。STL 三角形数 15,268,354（POLLEN）/ 15,267,992（NECTAR），与文件长度吻合。
- 止回方式（KNOWN）：52 度导槽入口的两片单向弹性指 `one_way_finger_+1 / _-1`，位于 Y = ±38 mm，各为 38 x 1.2 x 44 mm 板片、绕 -52 度贴合斜坡（`cad/paddle_launcher_constrained.py:302-307`）。小球上行时需挤开两指，反向被指端拦住。
- 材料决策（`docs/decision_log.md` 的 DEC-0022，ASSUMED）：实物按**标准尼龙扎带（zip tie，尼龙 6/6）**实现，仿真以悬臂薄片建模。参数记入 `config/parameters.yaml` 的 `materials.backflow_finger`：E = 2.7 GPa、nu = 0.39、rho = 1150 kg/m3、截面 4.7 x 1.14 mm，全部为 ASSUMED 通用取值，采购后须实测替换，不得据此发布结论。
- 待验证（TBD）：两指内表面净距 74.8 mm —— POLLEN 球（名义 71 mm）约余 3.8 mm，NECTAR 球（名义 91 mm）约过盈 16 mm；指端是否真正拦到两种球的包络尚未确认，须在 T03.2 台架验证。

## T06 POLLEN 送球段 V2 重做（2026-10-03）

- 用户指令（KNOWN）："进行重做吧。拨杆，外罩按照你的设想进行调整，使其保持同轴度，与倾斜托板适配"；硬约束为不得覆盖原文档、且先生成示意图。示意图已出（`simulation/mujoco/out/redesign_v2_overview_zh.png`、`redesign_v2_feed_zh.png`、`redesign_v2_coax_zh.png`，生成脚本 `simulation/mujoco/_work/redesign_v2_sections_zh.py`）。
- 生成器（新增）：`cad/paddle_launcher_feeder_redesign.py`，复用父级 `paddle_launcher_constrained.build()` 后逐件保留/剔除/挖空，再合成新的送球段零件；**父模块一行未改**。
- 关键改动（CALCULATED）：外罩圆弧以**拨杆轴 C = (29.49, 0.0, 111.46) mm 为圆心**直接画出，并把 5° 倾斜托板与唇口连接筋并入**同一条闭合 XZ 轮廓**，再沿 Y 挤出 108 mm —— 外罩、托板、拨杆三者同轴是**构造事实**，不再依赖装配公差。
- 几何基准（CALCULATED）：球心轨迹 R58.40；外罩内壁 R93.96 / 外壁 R100.96（壁厚 7）；扇形 142° → 225°；托板 X −56 → 150 mm、厚 6 mm、倾角 5°。
- 出口校核（MEASURED）：出口 142° 球心 (−16.53, 147.415)，到 52° 地板线 55.0022 mm，通道中线 55.00 mm → **偏差 0.0022 mm，`pass`**。
- 进料与止回（CALCULATED）：入口到停位落差 13.326 mm，托板自滚 206 mm、落差 18 mm，落位速度约 0.43 m/s；停位球心 (−2.30, 53.06) 到唇口 35.57 mm ≈ 球半径 35.56 mm（楔紧自锁）。
- 产物（KNOWN）：`cad/output/paddle_launcher_motion_free_pollen_v2.step`（169.4 MiB / 177,628,316 B，30 实体）、`.stl`（537.1 MiB）、`paddle_launcher_motion_free_pollen_v2_report.json`。父级 `paddle_launcher_motion_free_fingers_pollen.step` 及其余既有导出时间戳未变，原文档未被覆盖。
- STEP 回读（MEASURED，`n_solids = 30`）：包围盒 281.773 × 192.0 × 325.964 mm，与报告完全一致；总体积 970,754.4 mm³；外罩＋托板单体 255,347.1 mm³（报告 255,347.07）且 Y 向 ±54 mm = 108 mm 宽。
- 干涉（MEASURED）：新外罩 vs `guide_floor_3 / guide_roof_3 / guide_wall_3_±1` 全为 0；拨杆扫掠包络 vs 喉道/外罩/导板全为 0（扫掠尖角半径 62.362 mm < 鼓半径 63 mm）；停位球 vs 全部保留零件全为 0。
- 更正上一轮记录（KNOWN）：先前报告的 `guide_wall_3_-1` 2133 mm³ 干涉是当时外罩挤出方向写错造成的**误报**，本轮实测为 0，侧板不必删除。
- 删除清单：`guide_floor_1/2/3`、`guide_roof_1/2`、`guide_wall_1_±1`、`guide_wall_2_±1`、`one_way_finger_±1`；`shooter_throat_-55` 被拨杆扫掠鼓挖空至体积归零而自动丢弃。保留 23 件，含 `guide_roof_3`、`guide_wall_3_±1`、`shooter_throat_+55`。
- 决策（`docs/decision_log.md`）：DEC-0023（同轴构造化、外罩与托板合并为单一零件）、DEC-0024（删 52° 地板与两片止回指，止回改由 5° 自滚 + 唇口楔紧承担；取代 DEC-0022 中止回指作为 V2 零件的用法，zip-tie 材料记录保留为历史）。参数记入 `config/parameters.yaml` 的 `t06_feeder_v2`。
- 待验证（TBD）：V2 是否真能把球送进 52° 夹口并被对置双飞轮发射 → 已由本轮全流程仿真关闭，见下节。

## T06 POLLEN 送球段 V2 全流程仿真（2026-10-03）

- 用户指令（KNOWN）：好，跑新版全流程仿真吧。
- 方法（SIMULATED）：新增 `simulation/mujoco/pollen_v2_sim.py`（几何常量取自 `cad/paddle_launcher_feeder_redesign.py` 与 V2 报告，不依赖 CadQuery）；MuJoCo 3.14.0，timestep 2e-4 s，implicitfast，外罩以 24 段 box 链近似曲面。
- 结论（SIMULATED）：**V2 几何具备完整送球—发射能力**。球从托板右端滚入 → 叶片在 x ≈ 113 mm 接球 → 沿内壁 241° → 142°（约 99°）→ 142° 切向出罩（球心距 52° 通道中线 ≈ 4 mm）→ 进夹口 → 出射 **6.53 m/s @ 50.2°**，同高度射程 **4.28 m**（飞轮 1620 rpm，拨杆 200 rpm）。旧几何的 52° 顶板卡点未复现。
- 发射阶梯（SIMULATED）：810 / 1620 / 2430 rpm → 3.60 / 6.53 / 8.67 m/s，射程 1.29 / 4.28 / 7.49 m；出口速度/轮缘线速度 = 0.80，与 V1 的 `FINDINGS_zh.md` 一致 → V2 未损失发射性能。
- 拨杆转速门槛（SIMULATED，本轮关键新发现）：球已在唇口停位时 ≥ 105 rpm（100 rpm 卡在 182°）；球从托板进料时 140 rpm 仅 2/8 成功、**200 rpm 8/8 成功** → **推荐拨杆 ≥ 200 rpm（3.3 rev/s）**。
- 风险（ASSUMED，必须关闭）：拨杆力矩用 forcerange ±1.5 N·m 的速度执行器近似，是转速门槛结论的最大不确定来源；叶片按刚体建模，未含 zip-tie 弹性。舵机在 200 rpm 处的可用扭矩未经确认前，不得把送球可靠性写入制造结论。
- 产物（KNOWN）：`simulation/mujoco/out/FINDINGS_v2_zh.md`、`v2_fullflow_zh.png`、`v2_flywheel_ladder_zh.png`、`trace_v2_*.json`、`summary_v2_*.json`。父级 CAD 与既有导出均未改动。

## T06 POLLEN V2 舵机选型校核与接触几何分析（2026-10-03）

> （SUPERSEDED by DEC-0026 — 以下内容为 7 s 预算下的旧口径，保留供上溯，不作为当前结论。）

- 用户指令（KNOWN）：核对 REV SRS V2 舵机规格是否满足 V2 送球段要求；若不满足，给出改善接触几何的方法。
- 舵机规格（KNOWN，用户提供规格图）：SRS V2 Balanced 6 V / 7.4 V → 13.5 / 16.7 kg·cm，0.14 / 0.12 s/60°；SRS V2 UltraSpeed 6 V / 7.4 V → 5.6 / 6.2 kg·cm，0.043 / 0.035 s/60°。换算 @7.4 V：Balanced 堵转 1.638 N·m、空载 83.3 rpm；UltraSpeed 堵转 0.608 N·m、空载 285.7 rpm。
- 送球需求（SIMULATED，本轮实测）：拨杆力矩门槛 ≈ **1.0 N·m**，且在 140–200 rpm 区间**基本不随转速变化**（105 rpm 即使给 1.5 N·m 也不发射，属转速受限，不是 torque 受限）→ 该需求是"球被夹住后的起步/突破力"，不是惯性力。
- 峰值扭矩（SIMULATED）：200 rpm 自由跑峰值 1.71 N·m，恰等于执行器 `kv·ω = 0.08 × 20.94 = 1.675`，即**拨杆在接球瞬间被完全卡停**；峰值与叶尖形状无关（5 种叶尖方案实测 1.69–1.72 N·m），说明缩短叶尖不能降低需求。
- 卡停机理（SIMULATED，接触对实测）：球在停位仅由 `tray` + `shell_lip_face` 支撑（V 形硬窝，球底距托板仅 0.07 mm）；峰值帧球同时接触 `paddle_blade`、`paddle_flex`、`tray`、`shell`、`shell_lip_face`、`strut` → 球被"叶片 + 固定件"多面夹持。
- 判定（CALCULATED）：**两型号均不满足直接驱动**。Balanced 扭矩够（1.638 > 1.0，余量 1.6×），但在该扭矩下转速仅约 22 rpm，远低于 105 rpm 下限；UltraSpeed 转速够（286 > 105），但堵转 0.608 < 1.0。所需机械功率 ≈ 1.0 N·m × 105 rpm ≈ 11 W（200 rpm 时 ≈ 21 W），该级别舵机理论极限（堵转 × 空载）仅 14–18 W、可用值约 5 W → 单只 SRS V2 无法直接驱动该送球段；需求点落在舵机扭矩—转速线段之外，减速比也无法解决。
- 改善接触几何方案（ASSUMED，待仿真验证）：A 225° 挡墙改斜楔/圆弧过渡，让球平滑导入外罩；B 托板末端缩进 10–15 mm 并下倾，使球窝下方让空；C 叶片前缘卸载（球还在托板上的 300°–330° 区段外缘半径 ≤ 58.4）+ 端角倒圆；D 球窝改单侧斜坡"逃逸窝"，只留托板 + 与出球方向相切的斜面。
- 产物（KNOWN）：`simulation/mujoco/out/servo_verdict_zh.png`、`contact_fix_options_zh.png`、`summary_v2_torque_detail.json`、`summary_v2_servo_req.json`、`summary_v2_blade_variants.json`。

## T06 POLLEN V2 送球门槛重测与舵机选型（2026-10-03，DEC-0026 口径）

> 本节结论取代下方早先的「T06 POLLEN V2 舵机选型校核与接触几何分析（2026-10-03）」段落；该段落基于 7 s 仿真预算，混入了送料耗时假象，其原结论已标 SUPERSEDED 保留供上溯。

- 口径修正（KNOWN）：送球门槛仿真预算由 7 s / 单入口 x=145，统一改为 **12 s / 双入口 x=145 与 x=138**（取较坏值），二分容差 ±0.03 N·m。
- 修正原因（SIMULATED）：7 s 预算下 30/40/60/70/75/145 rpm 即使给到 3.0 N·m 也判失败；延长到 12 s 后全部成功发射。机理是**球在球窝蠕动**——球停在球窝边缘 r≈83–95.5 mm（θ≈322–328°），要等指片转到才被抓住，70 rpm 首抓约 4.2 s。旧门槛把送料耗时混进了发动力矩。
- R5 门槛（SIMULATED，`simulation/mujoco/out/_r2r5_speed_req12.json`，单位 N·m）：40/50 ≤0.24（扫描下限）、60 → 0.339、75 → 0.439、90 → 0.24、105 → 0.24、120 → 0.289、130 → 0.356、**145 → 0.472（最坏点）**、160 → 0.323、200 → 0.273、290 → 0.306。
- 几何取舍（SIMULATED）：推荐 **R5**（二指 θ=350/170 + D 球窝垫 6.8 mm）；90/105 rpm 门槛仅 0.24，优于 R2。DEC-0025 的 A 有效 / D 有效 / B 无效 / C 恶化的相对排序保留有效。
- 舵机判定（CALCULATED，7.4 V，厂家堵转值线性插值到空载）：**25-4 Super Speed 0.530 N·m / 290 rpm → 可直驱窗口 30–70、80–122 rpm，推荐**（唯一能上 120 rpm；90–105 rpm 余量 >40%；避开 70–80 rpm 缺口）；25-3 Speed 1.059 / 145 → 30–110；Axon MAX MK2 3.825 / 100 → 30–94（低速余量最大）；25-2 Torque 与 25-2 5-Turn 2.471 / 60 → 30–53（可用但慢，约 1.2 s/球）；REV SRS V2 UltraSpeed 0.608 / 285.7 → 30–125（**此前误判不可行，现同样可用**）。图：`simulation/mujoco/out/servo_envelope_zh.png`。
- 仍开放（TBD）：送球**相位敏感**（相邻 10 rpm 即可翻转结论），拨杆转速必须锁在窗口内稳态运行；根因未解决——球停 r≈95.5 mm 而设计轨道 R=58.4 mm，**差 37.1 mm**，送球靠叶尖拖拽而非输送轨道；R5 尚未进 CAD；刚性（非扎带）指片与 ASSUMED 0.060 kg 球质量仍未验证。

## T06 POLLEN V2 送球段「平滑曲面」优化与蠕动根因（2026-10-03，DEC-0027）

- 用户指令：采用 goBILDA **25-4 Super Speed（0.530 N·m / 290 rpm）** 作送球舵机，尝试把**外罩与球窝垫用平滑曲面连接**，看能否减少球的「蠕动」。
- 新增候选 **R6**（SIMULATED）：取消 R5 的 30×108×12.8 平垫块，外罩内弧（r = 93.96 mm）从 225° 沿同一半径平滑延伸到 **260.2°**，终点与托板顶面在 x = 13.5 mm 处相切（抬升 0.0 mm）。**R5 保留**，两者并列；R6 标为**候选待接受**。两者都仅在 MuJoCo 中，**均尚未进入 CAD**。
- **直接回答：平滑曲面不能消除蠕动。** 抓球前等待 2.98 s → 2.93 s（−1.7%，噪声量级）；全程 7.49 s → 7.38 s（−1.5%）；R6c（弧面止于 256°、半径收窄 2 mm）→ 7.23 s（−3.5%）。三者均**一次通过**全流程，出口球速 6.67 m/s、飞轮 1620 rpm，没有失败工况可区分优劣。
- 判定口径（KNOWN/SIMULATED）：拨杆改用 25-4 的真实线性扭矩—转速模型驱动（kv = 0.017452、限幅 ±0.530、ctrl = 空载 290 rpm），球从托板 x = 145 mm 滚入，12 s 预算。运载段实测：R5 3.95 rpm / 0.523 N·m，R6 4.05 rpm / 0.523 N·m，R6c 4.36 rpm / 0.522 N·m。
- **根因（SIMULATED，独立复测）**：蠕动发生在球停稳后的**停位球窝**——球停在 r ≈ 83–95 mm、角 ≈ 322–329°，被指片楔住，把拨杆拖到几 rpm，约 2.3 s 后楔口松脱才被带入运载轨道。用刚性速度源（±5 N·m 不限幅）复测同一 R5 几何，该段拨杆仍只有约 **6.8 rpm、出力约 1.16 N·m**（球心 r 实测 59.4 mm），说明是**卡滞**而不是「扭矩差一点」。接合处的台阶在该时段根本不参与接触，因此**改接合处形状无效**。
- 产物的图：`simulation/mujoco/out/r5_vs_r6_smooth_zh.png`（4 面板：R5 剖面 / R6 剖面 / 接合处放大 / 结果表与结论）；脚本 `_work/r6_fig_zh.py`、`_work/r6_motor.py`、`_work/r6_summary.py`、`_work/r7_loadprobe2.py`；数据 `out/_r6_summary.json`、`out/_r6_fig_data.json`。
- **重新打开的开放项（TBD）**：DEC-0026 的 `paddle_torque_threshold_12s_by_rpm`（90/105 rpm ≤ 0.24 N·m）由 kv = 0.08 的假执行器取得，其中「通过」只表示在限幅内 12 s 跑完，**不等于**真实电机有相应扭矩余量；25-4 全油门模型下运载段出力 0.523 N·m 已贴 0.530 N·m 堵转，**余量很薄**。两种口径不可直接相除比较，但都指向「运载段余量薄」→ 舵机余量复核重开。卡滞力矩对接触正则化与到达相位敏感（同一几何 0.52 与 1.16 N·m 两个读数），绝对值只能当量级参考。

## T06 POLLEN V2 球摩擦系数估算与送球能力判定（2026-10-04，DEC-0028）

> 本节结论将上方「R5 可行」限定在 μ≥1.0 的假摩擦输入下，并指出实物磨擦下 R5 送球失败。

- 用户指令（KNOWN）：塑料球是光面的，外罩是一般 3D 打印层高 0.4 mm 的 PET，估摩擦系数后跑仿真。
- 摩擦取值（**ASSUMED**）：μ = **0.40**，合理区间 **0.30–0.50**。依据：光面塑料对光面塑料干摩擦 μ≈0.2–0.3；FDM 0.4 mm 层高在 45° 壁面上形成峰谷 0.1–0.2 mm 层纹，把表观 μ 抬到 0.35–0.55；对本设计而言最坏情况是低端 0.30。**未台架实测前不得升为 MEASURED。**
- 口径（SIMULATED）：R5 几何 + 托板延长到 x=185 mm 、止挡板 x=188 mm（避免球被弹出后丢失），球从 x=145 mm 自然入料，飞轮 1620 rpm，拨杆 25-4 真实线性模型（kv=0.017452，限幅 ±0.530 N·m），**20 s** 预算。
- **结果：实物摩擦下送球失败。** μ=0.40/0.50/0.60 均**未发射**；μ=0.70 才能发射但要 15.69 s且拨杆只有 3.3 rpm（≈堵转）；μ=0.80/1.00 分别 8.54 s / 7.50 s。**门槛 μ ≈ 0.65 ≈ 实物取值的 1.6倍。**
- 失败机理（SIMULATED）：球从 x=145 滚到 **r≈95.9 mm**（t=0.328 s）时，只能被 **paddle_flex 指尖**（半径 58 mm）擦打——接触点在指尖末端，是掠过式撞击而非铲起。低 μ 时球被弹回，在 x≈100–150 mm / r≈86–128 mm 之间来回摆动，永远接近不了设计运载半径 58.4 mm；μ=1.00 时同一撞击被“咬住”，t=2.088 s 时球心已到 r=56.0 mm 并进入运载。这就是 DEC-0025 记录的 **37.1 mm 半径差**的直接影响。
- 飞轮发射能力（SIMULATED）：μ=0.70–1.00 下出球速度 6.35–6.67 m/s、角度 50.6–52.6°，**几乎不随摩擦变化**；逐对摩擦模型（飞轮保留自身高摩擦， priority=2）与全局 μ=0.40 逐位相同 → **瓶颈 100% 在送球段，不在发射轮**。
- 误差记录（KNOWN）：第一版止挡板放在 x=153 mm，球心在 x=145 mm 时球尾已到 x≈180.6 mm，挡板在 t=0 贯穿球导致该批数据不可用；已用正确口径重跑，新口径包含 t=0 无接触自检（`t0_contacts=tray`）。
- 产物：图 `simulation/mujoco/out/r9_mu_verdict_zh.png`（3 面板：剖面判定 / 球走向 / 摩擦门槛）；脚本 `_work/r9_strike_zh2.py`、`_work/r9_clean.py`、`_work/r9_diag.py`；数据 `out/_r9_clean.json`。
- **新增开放项（TBD）**：(1) 台架实测球对打印外罩的摩擦系数（不测就无法把 μ 从 ASSUMED 升级）；(2) 送球段几何改为「把球停位抬到 r≈58.4 mm 运载半径」，让叶片用法向力推球；(3) 即使拖拽成功运载段也只有 3.3–8.5 rpm / 卡滞 76–77%，舵机余量复核（DEC-0027 已重开）仍未关闭。

## T06 共用送球段 R26：一套机构兼容两种球（2026-10-04，DEC-0030）

- 用户指令（KNOWN）：NECTAR 与 POLLEN 使用**同一个装置**，**只有飞轮间隙会改变**；确保修改后的输送部分能兼容两种尺寸的球，并把它们高效送入发射部分。
- 共用几何（CALCULATED，一套、与球无关）：外罩内弧 `R_IN = 107.974 mm`（由大球定：12 + 45.974 + 4.026）、扇区 **142–275°**、壁 7 mm、宽 108 mm、5° 托盘与内弧**精确相切**（切点 x = 38.901 mm、右端 x = 150 mm）、桨毂 **Ø24**、桨臂 r = 10..46、叶片 r = 46..58、TPU 尖 r = 56..60。两球的静止球心半径不同（同一条内弧）：NECTAR r = 62.000、POLLEN r = 72.414。
- 唯一随球改变的量（KNOWN）：飞轮轴距 `half_spacing = nip/2 + 48` → NECTAR **89**（夹口 82，取自 nectar 文件）、POLLEN **80**（夹口 64）。共用性核验（KNOWN）：`cad/paddle_launcher_constrained.py` 全文不含球径参数，外罩/托盘/拨杆都不引用 `BALL_R` / `BALL_D` → **两版实体只差飞轮夹口**。
- 拨杆口径变更（SIMULATED，DEC-0030）：由三叶 18/138/258 改为 **两叶 330°/150°**。R28 对照：三叶时 **NECTAR 卡死**（球停在 r = 67.3 mm / 295°，堵转时间占比 80 %）——258° 那片叶正落在 275° 唇口/入料口前缘，把大球推回托盘；两叶把 275°→142° 的入料走廊让开，两种球都先自流到球窝再被扫掠。
- 索引式循环（SIMULATED）：停 ≥ 1.2 s → 一次扫掠 **240–260°**（25-4，290 rpm）→ 释放。R29（48 组）：330/150 且扫掠 ≥ 248° 的 16 组两球全部通过，扫掠 180/200° 一律失败。R30（12 组，停时 3.0/5.0 s、入料 x = 98/128、扫掠 240/248/260°）：**12/12 全通过** —— NECTAR t = 4.00/6.00 s、v ≈ 4.65 m/s、卡滞 10 %；POLLEN t = 3.40/5.40 s、v ≈ 6.0 m/s、卡滞 0 %。**连续旋转不可用**（会撞上飞轮室里尚未离开的球）。
- 产物（KNOWN）：图 `cad/output/_t06_shared_feeder_zh.png`（四联：共用剖面 + 两球静止半径 / 叶片布置 vs 入料走廊 / 两球半径历程 / 鲁棒性网格）；STEP `cad/output/paddle_launcher_feeder_a_prime_shared_{nectar,pollen}.step`；报告 `cad/output/paddle_launcher_feeder_a_prime_shared_report.json`；单件 `cad/output/inspection/_r26_shared_{paddle_hub,feeder_shell_tray}.step`；检验 spec `config/t06_feeder_aprime_shared_{hub,shell}_checks.json`。大 STEP/STL 已加入 `.gitignore`（可再生成）。
- 作废（SUPERSEDED）：`cad/paddle_launcher_feeder_a_prime_nectar.py`（R25 三叶生成器）已改为运行即退出的指针；其 STEP/STL 只作历史保留。DEC-0029 的叶数与相位被 DEC-0030 取代（相切托盘 / 唇口 275° / 桨毂 Ø24 继续有效）。
- 仍开放（TBD）：μ = 0.40 仍是 `ASSUMED`（台架实测未做）；索引式舵机控制未实现；球质量 0.130 / 0.060 kg 仍是 `ASSUMED`；9.9 mm 夹口过盈无结构/球变形校核。
- CAD 导出实测（MEASURED，2026-10-04，全部读自导出前的最终实体）：
  - 夹口 `flywheel_nip_measured_mm` = **NECTAR 82.000 / POLLEN 64.000**，与目标 `2·half_spacing − WHEEL_OD` 逐对完全一致（4 对飞轮全 82.000 / 64.000）。量法：飞轮缘部三角化点云沿 52° 通道法线投影取间隙（容差 0.5 mm）——飞轮的精确 B-rep 距离在辐条轮上**病理级慢**（单次 > 6 min 不收敛），已弃用，脚本内注明。
  - 毂—外罩内弧 `paddle_hub_to_shell_inner_arc_measured_mm` = **95.974**（两变体相同，目标 95.974），毂与外罩交集体积 **0**。
  - 停位球 vs 外罩 / vs 毂：**两球均为 0 mm³**（球窝落在运载圆上，与外罩内弧相切）。
  - 两变体一致性（KNOWN，充要证据）：外罩体积 **267723.34 mm³ 完全相同**、外罩 bbox 完全相同、毂—外罩 95.974 相同 → 差异**只剩**飞轮轴距（89 vs 80，即夹口 82 vs 64）与由此决定的运载半径（62.000 vs 72.414）。
  - 单件导出：`cad/output/inspection/_r26_shared_paddle_hub.step`、`cad/output/inspection/_r26_shared_feeder_shell_tray.step`；整机 `paddle_launcher_feeder_a_prime_shared_{nectar,pollen}.step`。
- 几何检验（MEASURED，`tools/inspect_geometry.py`）：`cad/output/inspection/t06_shared_R026_hub.json` = **pass 6/6**；`t06_shared_R026_shell.json` = **pass 7/7**。目标值取自 `config/parameters.yaml` 与 DEC-0029/0030，未取自被测件。
- 新测出的**既有**干涉（MEASURED，待用户决策，未关闭）：共用外罩与**保留的父级结构**仍有交叠 —— `shooter_throat_+55` **5717.5 mm³**、`guide_roof_3` **126.5 mm³**（两变体数值相同）。这是**继承而非回归**：R25 的 NECTAR 外罩对 `guide_roof_3` 就是 1727.2 mm³（R26 降到 126.5 mm³），而外罩对 `shooter_throat_+55` 此前从未测过（该键本轮才加入）。送球功能不受影响（R29/R30 就用这套几何跑通），但**实物装配时外罩会与喉道上导板相碰**。可选处理：让外罩对这一对静态件做布尔让位（不改球道，因为交叠在球道外侧 r > 108 mm）。

## T06 共用外罩让位 R27：削掉与保留父级结构交叠的料（2026-10-04，DEC-0031）

- 用户指令（KNOWN）：按上一轮报告的建议做布尔让位，消除外罩与保留父级结构的既有干涉。
- 做法（KNOWN）：对 `shooter_throat_+55` 与 `guide_roof_3` 各自**外扩 0.5 mm**，再用外扩体对 `feeder_shell_tray` 做布尔差；常量 `RELIEF_PARTS`、`RELIEF_CLEARANCE_MM = 0.5`，报告键 `shell_relief`。切削区全部在球道**外侧**（r > 107.974 mm），球实际接触的内弧面完全不动。
- 实测（MEASURED，读自导出前最终实体，NECTAR / POLLEN **逐位相同**）：`relief_targets_removed_mm3` = throat **5717.5021** / roof **90.8564**；`relief_clearance_mm` 两者均 **0.5**（外扩真的生效，没有静默回退成零间隙切割）；外罩体积 **267723.34 → 260374.21 mm³**（净削 7349.13 mm³）。
- 干涉归零（MEASURED）：`shell_tray_clash_with_kept_parts_mm3` = **0**、`shell_tray_clash_hits` = **{}**（R26 的 5717.5 / 126.5 mm³ 归零）→ R26 记录的那项“待用户决策的既有干涉”**已关闭**。
- 球道与接口未受影响（MEASURED）：新增球道扫描自检（沿 142°→275° 运载弧取 **19 个球心**，逐点求 球∩外罩 体积取最大）`sweep_ball_clash_with_shell_max_mm3` = **0**；`nest_ball_clash_with_shell_mm3` = 0、`nest_ball_clash_with_hub_mm3` = 0、`paddle_hub_to_shell_inner_arc_measured_mm` = **95.974**（不变）、`flywheel_nip_measured_mm` = NECTAR 82.000 / POLLEN 64.000（不变）。`shell_bbox_after_mm` 只有 **zmax 182.245 → 180.043**（−2.202 mm，挖掉的是外罩上缘伸到导板上方的那一小块），其余 5 个分界值全部不变。
- 几何检验（MEASURED，`tools/inspect_geometry.py`，目标取自 `config/parameters.yaml`）：`cad/output/inspection/t06_shared_R027_hub.json` = **pass 6/6**；`t06_shared_R027_shell.json` = **pass 7/7**。其中 `T06-APS-SHELL-004` 由 `bbox_max` 改为 `group_bbox` + `axis=z` + `rule=le` + `target=185.759`（脚本的 `bbox_max` 硬编码绝对值比较，无法表达 `le`）。
- 产物（KNOWN）：图 `cad/output/_t06_shared_relief_r27_zh.png`（(a) 让位上下文 3D；(b) 中截面俯视 + 球道弧）；单件 `cad/output/inspection/_r27_shared_{paddle_hub,feeder_shell_tray,relief_context}.step`；整机 `cad/output/paddle_launcher_feeder_a_prime_shared_{nectar,pollen}.step` 已按 R27 重导；报告 `cad/output/paddle_launcher_feeder_a_prime_shared_report_{nectar,pollen}.json`。R26 的单件与检验 JSON 保留为历史。
- 教训（KNOWN）：`BRepOffsetAPI_MakeOffsetShape.PerformByJoin` 必须**逐 solid** 调用。把部件当 compound 喂进去，OCCT 会当成“外表面偏移”而返回**更小**的实体（实测 38596 → 20737 mm³），第一版 R27 因此静默回退成零间隙切割。`_grow()` 现在逐 solid 外扩并校验 `fused.Volume() > shape.Volume()`，报告里的 `relief_clearance_mm` 就是“外扩生效”的证据。
- 仍开放（TBD）：与 R26 相同 —— μ = 0.40 仍是 `ASSUMED`（台架实测未做）；索引式舵机控制未实机实现；球质量 0.130 / 0.060 kg 仍是 `ASSUMED`。

## T06 R32 全流程仿真复核：R27 几何下两球各自正确夹口（2026-10-04）

- 用户指令（KNOWN）：对 R27 新版跑全流程仿真，**POLLEN 和 NECTAR 都要做**，各自使用**正确的飞轮间隙**；确认没有问题后交用户自己复核。
- 口径（KNOWN）：几何 = R27（DEC-0031）。R27 相对 R26 的唯一差异是外罩球道**外侧**（r > 107.974 mm）的 0.5 mm 让位，球实际接触的内弧面完全未变 → 仿真的接触几何与 R26 逐点相同；让位不侵入球道另有 CAD 的 19 点球道扫描（0 mm³）独立证明。
- 唯一随球改变的输入（KNOWN）：飞轮半轴距 `half_spacing = nip/2 + 48` → NECTAR 89（夹口 **82**）、POLLEN 80（夹口 **64**）。
- 共用输入（KNOWN/CALCULATED）：`R_IN` 107.974 mm、运载半径 = `R_IN − r_ball`（NECTAR 62.000 / POLLEN 72.414）、托盘 5° / pivot (−0.806, 0.423) / x 38.901–150、拨杆两叶 330°/150°、毂 Ø24、叶片 r 46–58、TPU 尖 56–60、出口 142°、唇口 275°。
- 驱动与发射（ASSUMED）：索引式（停 hold → 一次扫掠 sw → 释放）；舵机 25-4 Super Speed 线性模型（堵转 0.530 N·m / 290 rpm → kv = 0.017452）；飞轮 1620 rpm；μ = 0.40；t_end 8 s。
- 结果（SIMULATED，**6/6 通过**，全程 17 s）：

| 球 | 工况 | 夹口 (mm) | 出口 t (s) | 出口 v (m/s) | 出口角 (°) | 最高点 (mm) | 平射程 (m) | 卡滞 (%) | 峰值扭矩 (N·m) | 最小 r (mm) |
| --- | --- | --- | --- | --- | --- | --- | --- | --- | --- | --- |
| NECTAR | A 停 1.2 s / 扫 248° | 82 | 2.18 | 4.81 | 50.5 | 702 | 2.3 | 10 | 0.530 | 61.97 |
| NECTAR | B 停 3.0 s / 扫 248° | 82 | 3.97 | 4.79 | 51.7 | 722 | 2.3 | 10 | 0.530 | 61.96 |
| NECTAR | C 停 3.0 s / 扫 260° | 82 | 3.97 | 4.82 | 51.8 | 732 | 2.3 | 10 | 0.530 | 61.96 |
| POLLEN | A 停 1.2 s / 扫 248° | 64 | 1.83 | 6.20 | 51.8 | 1206 | 3.8 | 3 | 0.530 | 72.40 |
| POLLEN | B 停 3.0 s / 扫 248° | 64 | 3.38 | 6.18 | 51.6 | 1194 | 3.8 | 0 | 0.530 | 72.43 |
| POLLEN | C 停 3.0 s / 扫 260° | 64 | 3.37 | 6.18 | 51.8 | 1204 | 3.8 | 0 | 0.530 | 72.43 |

- 球路（SIMULATED）：球由右端托板借 5° 自流滚入，先停在 r ≈ 93 mm / α ≈ 323° 的通道口，再自行落到运载半径 r = 62 mm（球外表面贴住 r = 107.974 mm 的内弧面）；扫掠开始后 α 由 323° 单调递减到出口 142°，**共 181°**。
- 让位区核验（SIMULATED）：球在外罩扇区（142–275°）内的最大外缘半径 NECTAR **108.474 mm** / POLLEN **108.650 mm**，只比内弧面 107.974 mm 多 0.5–0.7 mm —— 这是球被叶片压在内弧面上的接触压入量，**不是**让位面被触及；让位面在球道外侧（r > 107.974 mm），全程无球接触。
- 与 DEC-0030 的 R29/R30 一致性（SIMULATED）：NECTAR v = 4.79–4.82 m/s（R30 为 4.64–4.68）、POLLEN v = 6.18–6.20 m/s（R30 为 5.87–6.13）；卡滞 NECTAR 10 %、POLLEN 0–3 %，同为索引式口径 —— R27 的让位**没有改变送球与发射行为**。
- 产物（KNOWN）：脚本 `simulation/mujoco/_work/r32.py`；数据 `simulation/mujoco/out/_r32_r27_full.json`（含 6 个工况的全量 trace 与逐工况接触集合）；图 `cad/output/_t06_r32_fullflow_zh.png`（两球 r(t)/α(t) 历程 + 俯视剖面 + 球轮廓轨迹 + 结果表）。
- 仍开放（TBD）：与 R27 相同 —— μ = 0.40 仍是 `ASSUMED`（台架实测未做）；索引式舵机控制未实机实现；球质量 0.130 / 0.060 kg 仍是 `ASSUMED`；9.9 mm 夹口过盈无结构/球变形校核。

## T06 可视化：看球被送球、发射、飞出的全过程（2026-10-04）

- 用户请求（KNOWN）：需要能"运行脚本并看到可视化的小球飞出"。
- 做法（KNOWN）：新增 `simulation/mujoco/view_r32.py`，复用 `_work/r32.py` 的同一套模型构造。为便于复用，本轮把 `r32.py` 里的 `run()` 机械拆出 `build()`（返回模型/数据/ID/控制），**未改任何物理口径**；重跑 `r32.py` 逐项数值与提交版一致（NECTAR A 出口 2.18 s / 4.81 m/s、POLLEN B 3.38 s / 6.18 m/s，仍 6/6 通过）。
- 两种查看方式（KNOWN）：(1) 交互窗口 `mujoco.viewer` —— 实时但默认 4 倍慢放（`--speed`），空格暂停/继续，鼠标转视角，跑完自动重播；(2) `--gif` 无头渲染成 GIF —— 出射前镜头固定看机构，出射后自动把"出射点 + 球"一起框住并拉远，橙色点串显示飞行轨迹。
- 产物（KNOWN）：`cad/output/_t06_r32_launch_nectar.gif`（107 帧 / 2.68 s，出口 t=2.18 s、v=4.81 m/s）、`cad/output/_t06_r32_launch_pollen.gif`（93 帧 / 2.33 s，出口 t=1.83 s、v=6.20 m/s），40 fps / 480x360。
- 结论（SIMULATED）：与 R32 复核同源同结果，本轮只增加可视化入口，几何、驱动与判定口径均未改动。

## T06 飞轮硅胶离心膨胀计算 + 热态配间距仿真循环 R33/R34/R35（2026-10-04，DEC-0032 / V-0034）

- 用户指令（KNOWN）：按飞轮图纸算离心膨胀量 → 重跑仿真 → 确认膨胀后的飞轮**不会与拨杆接触**；若接触则进入「改送球设计—仿真—识别问题」循环，直到 POLLEN 与 NECTAR 都通过；最后把新图纸导出到桌面。
- 膨胀计算（CALCULATED）：`calculations/t06_flywheel_silicone_centrifugal.py` / `.txt`。飞轮 = goBILDA `3613-0014-0096`，Ø96 × 24，105 g，实测 J = 1.2844e-4 kg·m²，图纸实体体积 **95767.311 mm³**（实心环的 62 %，12 条波形减重槽，Ø32 轮毂孔 / Ø14 轴孔 / 6×Ø4 螺孔）。30A 硅胶 E = 0.7–1.5 MPa（**ASSUMED**）、ν = 0.48、ρ = 1150 kg/m³。三模型 @1620 rpm：**M1 自由薄环 2.44–5.23 mm（上界）/ M2 厚环自由 0.55–1.19 mm / M3 厚环固支 0.26–0.55 mm（下界）**；周向应力仅 0.008–0.017 MPa（弹性范围内，模型成立）。
- 设计取值（ASSUMED）：真实膨胀 **0.5–1.8 mm** → 取 `dr_hot = 0.8 mm`；模型绝对上界 **3.7 mm** 用作边缘复核工况。
- 飞轮转速（KNOWN）：**1620 rpm**（`simulation/mujoco/_work/r32.py` 的 `build_xml(1620.0, …)`），轮缘线速度 8.14 m/s。存能：单轮 **1.85 J**、两轮 **3.70 J**；NECTAR 需 1.50 J（41 %）、POLLEN 需 1.15 J（31 %）。
- 关键几何（MEASURED）：拨杆真实叶片轮廓外切半径 **Rmax = 62.36 mm**；飞轮轴心→拨杆轴心 NECTAR 下轮 **115.91 mm**（36.7°）、POLLEN 下轮 **113.87 mm**（41.1°），上轮 185.00 / 177.91 mm。→ **冷态间隙 NECTAR 5.55 mm / POLLEN 3.51 mm**。
- **膨胀后是否接触（结论）**：设计取值 dr = 0.8 mm → 剩余间隙 **NECTAR 4.75 mm / POLLEN 2.71 mm**；即使取绝对上界 dr = 3.7 mm，NECTAR 仍留 **1.86 mm**；POLLEN 的接触门槛是 **dr ≈ 3.51 mm**（= 冷态间隙），即设计值有 **4.4 倍余量** → **膨胀后的飞轮不会碰到拨杆，送球设计无需改动**。
- R33 冷态装配（SIMULATED）：`simulation/mujoco/_work/r33.py` —— 安装间距按冷态 Ø96 定（`half_spacing = nip/2 + 48`），运行夹口被动变成 `nip − 2·dr`。**26/36 通过**：dr ≤ 2.7 时 NECTAR 全 OK；**dr = 3.7 时 NECTAR 3 例全 FAIL**；POLLEN 从 dr ≥ 1.0 起出现 FAIL。飞轮—拨杆接触 3 起，**全部只在 POLLEN dr = 3.7**（contacts 2121 / 150 / 150，间隙 0.001 mm）。FAIL 机理不是飞轮挡球，而是**夹口缩小改变了出手相位**，小球掉进拨杆毂—叶片夹角卡死。数据 `simulation/mujoco/out/_r33_expansion.json`。
- R34 热态配间距（SIMULATED）：`simulation/mujoco/_work/r34.py` —— 装配意图改为**按热态外径配轮轴间距**（`half_spacing = nip/2 + 48 + dr`），运行夹口恒为设计值 82 / 64。**30/30 通过、零接触、最小间隙 1.351 mm**（POLLEN dr = 2.7）；dr = 0.5 / 1.0 / 1.5 / 2.0 / 2.7 逐档最小间隙 3.109 / 2.708 / 2.304 / 1.905 / 1.351 mm。数据 `simulation/mujoco/out/_r34_expansion_hot.json`。
- 边缘复核（SIMULATED）：dr = **3.0 / 3.7** 两档 **12/12 通过、零接触**。dr = 3.7 时 POLLEN 最小间隙 **0.567 mm**、NECTAR **2.884 mm**；dr = 3.0 时 POLLEN 1.117 mm、NECTAR 3.383 mm。数据 `simulation/mujoco/out/_r34_edge.json`。
- 产物（KNOWN）：图 `cad/output/_t06_r34_expansion_zh.png`（膨胀量 vs rpm 三模型 + 间隙 vs dr + 三轮通过率对照）、`cad/output/_t06_r34_geometry_zh.png`（两球前视剖面：送球扇区、拨杆真实轮廓与外切包络、球窝轨道、冷/热飞轮圆、最小间隙表）；热态 CAD 生成器 `cad/paddle_launcher_feeder_a_prime_shared_hot.py`（`DR_HOT_MM = 0.8`，只改轮轴间距，送球段几何与 R27 逐点相同，产物写 `cad/output/_r35_hot/`，不覆盖 R27）。
- R35 图纸导出实测（MEASURED，读自导出前最终实体）：热态夹口 `flywheel_nip_measured_mm` = **NECTAR 83.6**（= 2×89.8 − 96）/ **POLLEN 65.6**（= 2×80.8 − 96），即按热态配间距后夹口比冷态大 2×0.8 mm，轮子转起来正好回到设计夹口 82 / 64。外罩体积 **260374.21 mm³**、毂—外罩 **95.974 mm**、外罩∩保留父级件 **0 mm³**、19 点球道扫描 **0 mm³** —— 与 R27 **逐位相同**，证明本轮只动了飞轮轴位，送球几何未变（两变体之间也逐位相同 → 「同一装置」结论不变）。
- R35 交付（KNOWN）：`cad/output/_r35_hot/paddle_launcher_feeder_a_prime_shared_{nectar,pollen}.step`（178 MB / 177 MB，大件按 `.gitignore` 本地规则不入库，可用 `cad/paddle_launcher_feeder_a_prime_shared_hot.py` 重生成）+ 两份 `_report.json`；已复制到桌面 `T06_R35_hot_nectar.step` / `T06_R35_hot_pollen.step`。R27 的源文件与产物全部保留未动。
- 教训（KNOWN）：R27 的「半轴距 = nip/2 + 48」是**冷态**口径。硅胶飞轮在转速上会变大，若按冷态配间距，运行夹口会比设计值小 2·dr，R33 实测这足以把 POLLEN 的送球相位打乱。**要求：垫片长度按热态外径配**，即 `half_spacing = nip/2 + 48 + dr_hot`。
- 仍开放（TBD）：硅胶 E 值 0.7–1.5 MPa 与 `dr_hot = 0.8 mm` 均为 **ASSUMED**（无台架测量/高速摄影）；其余同 R27 —— μ = 0.40 `ASSUMED`、球质量 0.130 / 0.060 kg `ASSUMED`、索引式舵机控制未实机实现、9.9 mm 夹口过盈无结构/球变形校核。

## T06 多球进料能力实测 R36：多球「排队等待」在现有几何上不成立（2026-10-11，DEC-0033 / DEC-0034 / V-0035）

- 用户指令（KNOWN）：用 4 颗 POLLEN/NECTAR（随机）+ 不同拨杆起始位置多跑几轮，检验结构应对多球的能力并给出平均时间；随后要求在 CAD 里把重叠的部分删除或整理为单一实体。
- 核心结论（MEASURED，MuJoCo 探针 `simulation/mujoco/_work/r36_probe_check.py`）：**托板上的「等待球」原理上不成立**。叶片 + TPU 尖的扫掠带 = 绕拨杆轴心 r ≈ 46–60 mm；托板上球心距轴心只有 62–93 mm、球径 ≥ 71 mm ⇒ 球体内表面伸到距轴心 16–47 mm，必然被打到。每个 180° 周期内，x ≥ 30 mm 的球都被 `paddle_flex_*` / `paddle_blade_*` 打出 −4.0 … −39.1 mm 穿透（最坏 ph0 = 90°）。
- 容量（MEASURED + CALCULATED）：后挡墙 x = 150 ⇒ 球心最远 x = 104（NECTAR）/ 114（POLLEN）；相切间距 91.9 / 71.1 mm ⇒ 托板最多 **NECTAR 1 颗 / POLLEN 2 颗**（POLLEN×3 实测排布 = 弧道 1 + 托板 2）。**4 颗紧密排队对两种球都是几何不可能。**
- 仿真（SIMULATED，清洗后，V-0035）：POLLEN×3 × 6 相位、索引式（停 3.0 s / 扫 248°）→ 真出膛 **10/18**（v = 6.01–6.26 m/s）；ph0 = 60/90/150 三档 3/3，ph0 = 0/30/120 三档 0/3、0/3、1/3（球被叶片打飞出机构）。扭矩峰值 0.520–0.530 N·m（25-4 额定用满）、卡滞 0–24 %。
- 教训（KNOWN）：(1) 净距只用 MuJoCo 探针，本模型米制必须 ×1000，`distmax` 会把大净距截断成 +60 mm；(2) 仿真相位必须几何标定（ph0 = 60 才是 CAD 标称零位 330°/150°）；(3)「出膛」判定必须带速度门槛，否则地板滚球会被记成出膛（本轮 2/18 假阳性）；(4) 不要为省时间跳过穿透检查（NECTAR×4 的摞球点埋在飞轮里 −43.0 / −30.8 mm，整轮数值爆炸作废）。
- 更正（KNOWN）：先前记的「托板末端与飞轮腔重叠 −43 mm」是误读 —— 那些探针点落在飞轮盘实体里，球不可能停在那儿；**托板与飞轮实体本身不重叠**。
- 作废：`simulation/mujoco/out/_r36_run1.txt` 与「12/24、平均 3.43 s」的说法全部作废，文件已删除；复核证据 `_work/r36_probe_check.py`、`_work/r36_recheck.py`、`out/_r36_probe_check.txt`、`out/_r36_multiball_recheck.json`。
- 未关闭（TBD）：NECTAR ≥ 2 颗在现有几何下摆不出来（托板只容 1 颗）；(b) 的 CAD 改动方向待用户选定（见 NEXT ACTION 第 0 项）。
- 同步（KNOWN）：Linear KEI-18 长评论（R36 全结论 + 四条教训）+ 新建 KEI-19（T06.8 — 多球进料方式，Backlog，parent KEI-6）https://linear.app/keithschoolrobotic/issue/KEI-19；Notion [https://app.notion.com/p/3ef7fc7bbcfb8177bf86d310c29afaa6](https://app.notion.com/p/3ef7fc7bbcfb8177bf86d310c29afaa6) 页尾追加「R36 多球进料实测 + 三条口径教训」小节（DEC-0033 / DEC-0034 / V-0035，2026-10-11 已确认落页）。

## T06 R37：多球进料定为方向 B（等待区搬出扫掠圆）+ 自制件重叠清理（2026-10-11，DEC-0035 / DEC-0036 / V-0036）

- 用户指令（KNOWN）：`b2+B` —— 先做 (b) 的重叠清理，同时把多球进料方向选为 **(B)（等待区搬到拨杆扫掠圆外）**。
- 方向 B 的几何改动**只有一处**（KNOWN）：托板/外罩右端（进料口）`TRAY_X1` **150 → 215 mm（+65 mm）**；`TRAY_X0` 由切点向内延 14 mm 到 24.901 mm（为并实体）。外壳 R_IN 107.974 / 扇区 142..275° / 壁厚 7 / 托板倾角 5° / 拨杆轴心 / 叶片 46..58 / TPU 尖 56..60 / 夹口（DEC-0032 热态口径）**全部不变**。
- 关键更正（CALCULATED）：等待区门槛是 `球心距轴心 ≥ 60 + r`（NECTAR 105.974 / POLLEN 95.560）⇒ 等待区起点 **x ≥ 124.5 / 97.8**。排队时第 k 颗球心 s = (k−1)·2r，所以 **第 2 颗本来就安全**（NECTAR x 126.485 余 6.0 / POLLEN 106.650 余 9.2）—— R36 的「托板球被打飞」是**探针瞬时位**；真正的限制是**容量**。
- 容量（MEASURED，R37 报告）：**NECTAR 2 颗 / POLLEN 3 颗**，`waiting_balls_all_clear = true`（最紧余量 POLLEN 第 2 颗 +5.938 mm）；第 1 颗是**待推球**，本来就该在扫掠圆内（设计意图，报告里以 `expected_pushed` 单列）。
- 空域确认（MEASURED）：托板延长段（x 150→215、z ≈ 15）**无任何既有实体**，最近的 `gecko_flywheel_lower_*` 只到 z ≥ 138.3 ⇒ 加长不与任何保留件干涉。
- (b) 重叠清理（MEASURED，`cad/output/_r37_census3.json` + R37 报告）：

  | 重叠对 | 清理前重叠 | 处理 | 清理后 |
  |---|---|---|---|
  | `paddle_hub` × `paddle_arm_1/2` | 295.762 mm³ ×2 | 轮毂+双臂+双叶片并为 **1 个 `paddle_rotor`** | 0 |
  | `paddle_blade_1/2` × `paddle_flex_tip_1/2` | 5760.000 mm³ ×2 | TPU 尖片径向缩到 **r 58…60** | 0 |
  | `guide_roof_3` × `guide_wall_3_+1/-1` | 315.000 mm³ ×2 | 侧壁按 **0.5 mm 间隙**让位（同 R27 口径） | 0 |
  | `feeder_shell_tray` 自身（球道弧 + 托板只相切） | — | 托板向内延 14 mm 后**并为一个实体** | — |
  | （附）轮毂内孔 Ø4.1 × Ø12 拨杆轴 | 相交（占位孔遗留） | 改为 **Ø12.1 让位孔** | 0 |

- 实测收尾（MEASURED，导出后回读本轮 STEP）：自制件两两布尔交 **全 0**；全部自制件 `Solids() == 1`；拨杆轴 ∩ 拨杆 = 0.000 mm³。剩余多实体件只有 7 个厂商 COTS 件（飞轮/轴），按 DEC-0021 保留原厂装配语义。
- 几何检验（MEASURED，`tools/inspect_geometry.py`，run label **R005**）：**4/4 `pass`，0 `fail` / 0 `not_run` / 0 `unresolved`，退出码 0，397.1 s** —— bbox_max x = 215.2615（目标 215 ± 0.5）、bbox_max z = 338.7996（目标 338.8 ± 1.0）、体积 930299.217 mm³（相对偏差 7.4e-07）、根实体 23（= 16 部件 + 7 个 COTS 多实体）。报告 `cad/output/inspection/t06_feeder_r37_R005.json`。
- 产物（KNOWN，大 STEP 已 git-ignore，可再生）：`cad/output/_r37_stage/paddle_launcher_feeder_a_prime_shared_staging_{nectar,pollen}.step` + 报告 JSON + `_r37_readback.json`；生成器 `cad/paddle_launcher_feeder_a_prime_shared_staging.py`（**父模块 `paddle_launcher_feeder_redesign.py` / `..._shared.py` / `paddle_launcher_constrained.py` 全部未被修改**）。
- 代价与未关闭（TBD）：机构在 +x **变长 65 mm**，进料口外移到 x = 215 后**外部供料路线需跟着调整**（Linear KEI-19，用户 2026-10-11 已批准改）；R37 几何**已接入 MuJoCo 多球仿真**（见下段 V-0037）；μ、球质量、索引式舵机控制三项仍未关闭。

## T06 R37 多球仿真：MuJoCo 全流程（2026-10-11，V-0037）

- 用户指令（KNOWN）：`跑吧，供料路线改就改吧` —— 批准把 R37 几何接进 MuJoCo 多球仿真，并允许外部供料路线随进料口外移而改（本轮只跑仿真，不改外部供料）。
- 仿真口径（SIMULATED）：`simulation/mujoco/_work/r37_multiball.py`（由 `r36_multiball.py` 派生：`TRAY_X1 = 215`、TPU 尖 r 58…60、逸出阈值 `SPILL_X = 240`、窗口改为 `t0 + (nb+2)×(T_ROT+hold) + 4 s`）；5 种球数 × 6 个拨杆相位（ph0 = 0/30/60/90/120/150°，hold 3.0 s，拨杆 60 rpm，μ = 0.40，飞轮 1620 rpm、限幅 ±0.530 N·m），共 **30 轮 / 84 颗**。
- 设计容量工况（SIMULATED）：

  | 工况 | 全清轮 | 真出膛 | 出膛速度 | 平均轮内耗时 | 平均清空耗时 |
  |---|---|---|---|---|---|
  | NECTAR × 2 | **6/6** | **12/12 = 100%** | 4.68–4.86 m/s（均 4.76） | 3.21 s | 6.42 s |
  | POLLEN × 3 | 4/6 | 15/18 = 83% | 6.01–6.23 m/s（均 6.13） | 3.55 s | 10.46 s |

- 超容量工况（按「设计容量外」解读，**不作为结构缺陷**）：POLLEN × 2 = 8/12（67%，无后排推挤）；NECTAR × 3 = 11/18（61%，叠 1 颗）；mix4（POLLEN/NECTAR/POLLEN/NECTAR）= 5/24（21%，叠 1–2 颗）。
- 相位敏感（SIMULATED）：最差 **ph0 = 120°**（POLLEN×3 → 1/3、POLLEN×2 → 1/2）；POLLEN×3 在 ph0 = 0/30/60/150° 四档全清。
- 根因（SIMULATED + 几何核对）：等待区第 2 颗球稳定停在 **`x ≈ 87–88 mm`**（相对拨杆轴心 `r ≈ 89 mm`、极角 ≈ 317°），**落在拨杆扇区 142–275° 之外**，拨杆扫不到它；它只能靠**后排球推挤**或**拨杆回程蹭带**被一步步索引进扫掠圆。这就是 POLLEN×3（有第 3 颗在后面推 → 83%）明显优于 POLLEN×2（无后排 → 67%，且更慢）的原因。注意该停靠点比参数表的「等待区起点 x ≥ 97.772（POLLEN）」**还要靠内约 10 mm**，即它其实在扫掠圆半径之内，只因为极角在扇区外才没被打飞 —— 一旦被推过 275° 就进入有效区。
- 口径澄清（KNOWN）：迹线里 `|z|` 达到 10⁶ mm 的记录**不是数值爆炸** —— 出膛后球在无边界自由空间继续下落并沿 +x 飞行（`z = −1200 m` 对应约 15 s 自由落体，与运行时长吻合）。出膛判定仍按 DEC-0033 的速度门槛（v ≥ 3 m/s 且 x < 200 mm）；本轮假阳性 2/84。
- 与 R36 对比（SIMULATED）：同口径清洗后 R36 的 POLLEN×3 = **10/18（56%）**、v 均值 6.26 ⇒ R37 = **15/18（83%）**、v 均值 6.13；方向 B 的「等待区搬出扫掠圆」是**净收益**，出膛速度略降约 2%（夹口/几何差异与采样差异混合，未单独归因）。
- 未关闭（TBD）：μ（球—PET 打印件）与球质量仍为 `ASSUMED`；索引式舵机控制未实机；外部供料路线随进料口 x = 215 待改（KEI-19，用户已批准改）；**等待区第 2 颗球的索引余量偏紧** —— 建议的后续几何动作是「放开 x ≈ 87 处的台阶/门槛」或「按实际停靠半径重算等待区门槛」，本轮未做。
- 证据（KNOWN）：`simulation/mujoco/out/_r37_multiball_{pollen3,pollen2,nectar2,nectar3,mix4}.json`、`simulation/mujoco/out/_r37_recheck.json`、`simulation/mujoco/out/_r37_log2.txt`；清洗脚本 `simulation/mujoco/_work/r37_recheck.py`。第一轮矩阵（`out/_r37_log.txt` 与未加 tag 的 `out/_r37_multiball.json`）因仿真窗口少算一圈、数据不可靠，已按 R36 同例作废删除；以 `out/_r37_log2.txt` 为权威。

## T06 R38 NECTAR 夹口重算 + 送球节拍瓶颈定位（2026-10-12，DEC-0037 / V-0038）

- 用户指令（KNOWN）：`重算` —— 用**真实调隙舵机的刚性两档定位**重算 NECTAR 夹口（不是 zip-tie 弹性件）；用户 2026-10-12 已明确接受 **86 mm**。
- 决策（KNOWN）：NECTAR 运行夹口 **82 → 86 mm**（POLLEN 保持 64 mm）。夹口是纯几何刚性对称定位，没有弹性件；82 → 86 舵机行程仅 **23.08°**，全行程 77.35°。
- 机构反解（CALCULATED）：可达上限 **87.07 mm**（曲柄/拉杆共线死点）⇒ 单球扫参里的 88 / 90 **不可实现**，只能作趋势参考。86 档 十字滑块 u = −43.798、曲柄 19.33°、单侧压入 2.97 mm、距死点 0.80 mm；传动比 9.204 → 4.666 mm/rad，**保持扭矩需求约减半**。
- 仿真结果（SIMULATED，`simulation/mujoco/_work/r38_v8.py`，6 相位 × mix P/N/P/N × 75 s，μ = 0.60）：

  | 指标 | 82（旧） | 86（新） |
  |---|---|---|
  | 全清轮 / 真出膛 | 6/6 · 24/24 | **6/6 · 24/24** |
  | POLLEN 出膛 v | 6.35 m/s | 6.35（不变） |
  | NECTAR 出膛 v | 5.10 m/s | **5.76（+13 %）** |
  | NECTAR 轮系接触冲量 | 16.65 N·s | **9.49（−43 %）** |
  | 清空时间 | 41.92 s | 41.95 s |

- 关键发现（SIMULATED）：**夹口不是节拍瓶颈**。拨杆收到 290 rpm 恒速指令时，负载下实际只有约 **22 °/s**，0.530 N·m（25-4）在运送段**已饱和** ⇒ 82→90 的「轮内」时间一位小数都不变。**球从停位到出膛的纯运送时间只有 0.15–0.74 s**，其余是保持等待段。要提节拍必须动**拨杆（减速比 / 扭矩臂）**或**缩短运送角行程**。
- 未关闭（TBD）：86 只有仿真 + 反解支撑，**无实物**；μ = 0.60 与球质量仍为 `ASSUMED`；86 距死点 0.80 mm 的装配公差未核算；NECTAR 热态夹口 87.6 mm 为按 86 基准的**计算外推**（未实测）。zip-tie 弹性夹口方案（`r38_v3/v4/v6/v7`）已回滚并归档到 `simulation/mujoco/_work/_superseded_r38_tie/`。
- 证据（KNOWN）：`config/parameters.yaml`（`t06_gap_recalc_r38` 块 + `flywheel_nip` 86 / `flywheel_half_spacing` 91）、`docs/decision_log.md`（DEC-0037 / V-0038）、`simulation/mujoco/out/_r38_v8n86.json`、`out/_r38_gap_recalc.json`、`out/_r38_log_v8n86.txt`；分析脚本 `simulation/mujoco/_work/_recalc_nip86/`。

## T06 R47 台架可视化：一条命令看全流程（2026-10-12）

- 用户反馈（KNOWN）：直接打开 R47 XML 时「拨杆完全没动」。根因（KNOWN）：MJCF 只描述几何与驱动器，飞轮 ctrl、拨杆停位/扫掠、闸门 mocap 都是外部控制逻辑，通用查看器无法体现。
- 改动（KNOWN）：`simulation/mujoco/run_R47_xml.py` 新增 `--view` / `--slow`（`mujoco.viewer.launch_passive` + 实时配速），并按 1 s 输出一行遥测（拨杆角、双轮 rpm、闸门 z、出膛数）。**未改任何驱动口径、几何或判定标准**。
- 验证（SIMULATED）：`--view --sec 22` 实测遥测 —— 双轮 ±1619 rpm 对向；拨杆停位 188° 后扫掠 188→548→907→1268°；闸门 47.5→116.3→139.5→71.8→47.5→139.5 mm；**t = 12 s 时 4/4 出膛**。混装 `--pair --view` 换档路径亦无报错。
- 交付说明（KNOWN）：`simulation/mujoco/HOW_TO_VIEW_R47.md`（哪个软件打开哪个文件 + 鼠标操作）。
- 混装/随机排布版（SIMULATED，`out/_r47v_mix_ph0.log`）：同一脚本新增「自动识别混装并换档」，传入 `mixed4` 文件即按当前球径在 64 / 82 mm 夹口间切换，命令行不用加 `--pair`。实测 `mixed4_gap064 --ph 0`：换档 3 次、**真出膛 4/4**（球1 6.43 / 球2 5.26 / 球3 6.32 / 球4 5.28 m/s），全清 11.28 s（含静置 6 s），每颗平均 1.32 s；带 `--view` 运行 3 次换档均无报错。六相位用 `--ph 0..5`。
- 顺手修（KNOWN）：`run_R47_xml.py` 的 XML 路径现在支持从仓库根目录给相对路径（`out/...`），原先必须 `cd simulation/mujoco`。
- 未关闭（TBD）：本机无官方 `simulate.exe`，方案 C 仅备用；`--view` 只是同一台架的口径可视化，不代表实物。

## NEXT ACTION

### 0.5（当前主任务，2026-10-14 起）R54 打印主体装配版（M3 贯穿螺栓，无自攻）

用户 2026-10-14 指令：下一版考虑实际装配合理性、极少零件数（托板与外罩合一、侧板与外罩连起来）、3D 打印便利、用 M3 螺丝，本版把厂商件剔除；追加「闸门暂时不管但预留孔洞」「只是原型，耐用不考虑」「自攻不用，两个构件都贯穿，一头螺栓一头螺母」。

- 已交付（2026-10-14，DEC-0053）: **1 个打印件** `shooter_frame_R54_merged`（12 件 + 16 筋 + 2 补缝块 + 4 导轨腿，solids = 1）+ **6 个 M3 贯穿接头**；STEP `cad/output/_r54_frame/T06_shooter_frame_R54_pollen.step`（0.99 MB，单件，可直接打印）与 `T06_shooter_assembly_R54_pollen.step`（4.1 MB，含保留件）；图 `cad/output/_r54_frame/sections/`（y0 / y64 剖面 + 装配剖视 + 接头示意图）。
- 已知无效连接（已修）: 原 4 个「机架孔」只穿 `feeder_mount`，不穿 `base_rail`；侧板与导轨之间原本是 17.6 mm 悬空。
- 输出范围（KNOWN，2026-10-14 用户口径，DEC-0054）: 后续**只交付 pollen 版**；nectar 与 pollen 是**同一机构在换档行程两端的不同状态**（半间距 80.0 -> 91.0 mm，唯一变化量是飞轮间隙），不再另出 nectar 交付件；历史 nectar 产物按 superseded 保留。
- **已解决（MEASURED，2026-10-14，DEC-0055 修法 A -> R55）: 6 / 6 个 M3 接头全部可装配** —— 4 条导轨腿的螺栓轴由 y = ±70 外移到 **y = ±76.0**（腿宽 y 由 68..80 加宽到 **68..84**，仍是 12 x 16 mm 柱）；腿与导轨各钻 O3.4，螺栓从腿顶进、螺母在导轨下方、侧板只挡 1.25 mm 不碍螺丝刀。**回读新 STEP 实测（`cad/output/_r55_frame/report_r55_joint_reachability.json`）**：4/4 通孔（轴线体积 0.000 mm3）、孔径确为 O3.4（O3.5 探针余量 11.9 mm3）、孔两侧各约 6.79 mm3 实心壁、导轨 3.96 mm3 完整、螺母腔（z -20..1.5）与头顶空间全空。旧孔位 y = ±70 为盲孔的证据：`cad/output/_r54_frame/report_r54_joint_reachability.json`。
- **R55 交付件（MEASURED）**: `cad/output/_r55_frame/T06_shooter_frame_R55_pollen.step`（0.96 MB，solids = 1，V = 1 058 193 mm3，y 包络 ±84.0）+ `T06_shooter_assembly_R55_pollen.step`（4.0 MB）；闸门 4 个预留孔沿用 R54 仍 pass（O3.4 通畅、侧板外 y 85..115 全空）。R54 按 superseded 原样保留。生成 `cad/paddle_launcher_shooter_assembly_r55.py`，复核 `cad/_r55_joint_reachability.py`，构建日志 `cad/output/_r55_run.log`（2417.9 s）。
- **螺栓选型（CALCULATED）**: 夹持长度 x = 60 处 **42.0 mm**、x = 76 处 **46.0 mm**（导轨 z 2..16 + 腿 z 16..44 / 48）；加平垫 1.0 + M3 螺母 2.4 ⇒ 推荐 **M3 x 50（x = 60）/ M3 x 55（x = 76）**，或统一用 4 x M3 x 55。螺母与螺丝刀全在打印件之外，无需嵌入件。
- **已移交他人（KNOWN，2026-10-14，DEC-0062）: 打印朝向 / 支撑 / 排版（含下面的建板尺寸问题）与闸门实体建模不再由本线推进** —— 用户「闸门和朝向不用管，会有别人搞」。
- **移交时必须带上的约束（MEASURED，2026-10-14，V-0060）: R55 主体单件 362.5 x 183.0 x 404.5 mm，超出常规建板**。任意摆向下最小建板 405 x 362 mm；Bambu X1C/P1S 2563、Ender 3 220x220x250、Prusa MK4 250x210x220、Bambu H2D 350x320x325 都装不下。as-drawn 向下面 31 425 mm2，其中 19 063 mm2 集中在 z 5..10。底部**不是孤岛**（z -4..0 一整块 13 421 mm3，底面约 3 824 mm2 落在建板上；更正 DEC-0055 的「纯悬垂 / 孤岛」说法）。证据 `cad/output/_r55_frame/report_r55_print_probe.json`（可复算 `cad/_r55_print_probe.py`）。
- 拆件候选（给接手人的建议）：沿天然分缝拆 2–4 块 —— 导轨腿顶面 z = 16 / 侧板 y ±68..72 的竖直面 / x 约 100 分「送球段-发射段」，仍用同一套 O3.4 通孔 + M3 螺栓螺母对接（不引入厂商件）。
- **NEXT ACTION**: 本线在 T06 打印主体上的验收范围已收敛为「装配合理性 + 极少零件数 + M3 连接设计 + 剔除厂商件 + 仔细验证」，全部有 STEP 回读证据（R55 接头可达 PASS、无干涉 0.000 mm3、R55-R54 对称差只落在腿区）。打印与闸门已移交。
- 剩余（TBD）: (i) O3.4 打印孔径与 PET 收缩实测（本线内，未实测）；(ii) 闸门实体建模 => **已移交**；(iii) 打印朝向 / 支撑 / 排版 => **已移交**；(iv) R49 / R53 既有件与新主体的接口一致性复核（本线内，未做）。
- 注意（KNOWN，V-0061）: `base_rail` 是复用件，现在 y = ±76 是新钻的 O3.4（M3 自由配合孔），而旧的 y = ±70 那 4 个 O4.6 孔仍留在导轨上，装配时不要用错孔位。
- 剩余（TBD，按优先级）: (i) 打印朝向 / 支撑（前底裙 z -3.51..3 平放时是悬垂）; (ii) O3.4 打印孔径与 PET 收缩实测（用户口径 1 mm 误差可接受）; (iii) 闸门实体本版仍未做（只按 R49 包络预留 4 个孔，孔位可达性 pass）; (iv) R49 / R53 既有件与新主体的接口一致性复核（本轮未做）; (v) 四腿加宽后（y 68..84）的实体干涉复核 => **已做，V-0059 PASS**（`frame ∩ (assembly - frame)` = **0.000 mm3**，138 个保留件无一咬入；腿顶上方整机 6 x 6 x 22 mm 进刀柱 4 处全空）。

### 0.12（已完成 2026-10-16）R63 小件合并排版：R62 的 45 个非主体打印件排进**一块 H2D 板**（DEC-0070 / V-0071）

- 判据（KNOWN）: 用户「看看能不能把一些小的部分拼在一次打印，如果可以，整合在一个文件里」。
- 可行性（MEASURED）: R62 的 46 件中除掉超限主体 `shooter_frame_R62_merged` 后，**45 件 XY 占地合计 57 568 mm2** < H2D 单板可用 **315 x 310 = 97 650 mm2** ⇒ **一块板即可**，无需第二块。
- 做法（KNOWN）: `cad/_r63_plate.py` **只回读** `cad/output/_r62b_parts/*.step`，**朝向不变**（纯 XY 平移，不旋转 / 不缩放 / 不融合），每件 min-Z 落板（z = 0），件间距 4 mm、板边距 5 mm，MaxRects 短边优先装箱，`cq.Assembly` 导出。否决「水平面内旋转 90 度」：只省 2.5 mm 高度、填充率不变。
- 实测（MEASURED，V-0071）: 45 件占用 **310.3 x 306.0 mm**（可用 315 x 310），最高 **122.75 mm**；回读 **45 solids**、总 V **765 786.2 mm3**（差 -0.14 mm3）、整体 bbox 310.3 x 306.0 x 122.75、`zmin = -0.000`；**逐件 45/45** 命中 `packing_index.json` 且 `zmin == 0`、体积偏差 <= 0.3 mm3；两两重叠断言 **0 冲突**。判定 **pass**。
- 产物: `cad/output/_r63_plate/`：`T06_print_plate_R63_pollen.step`（**2.12 MB，45 bodies**，已在板位上、开箱即可切片）、`packing_index.json`（逐件板内坐标 + 平移量 + 占地）、`plate_preview.png`（排版图）；脚本 `cad/_r63_plate.py`。R62 的 46 个独立 `.step` **保留不删**（排版盘只服务打印，不改装配关系）。
- 画面对应（KNOWN）: 排版图横轴 X 0..325、纵轴 Y 0..320（黑框 = H2D 板，灰虚线 = 5 mm 安全边）；`base_rail_rear_joined`（130 x 162）在左下、`paddle_rotor`（115.5 x 96）在左中下、两条 250 x 18 的 `base_rail_front_±72` 横躺在下部、`paddle_flex_tip_1/2`（18.7 x 96）竖插在中上部、其余小件（bridge / carriage / clamp / standoff / guide / link）填在右上与右列。
- 未验证（TBD）: (i) 支撑 / 打印朝向的工艺裁定（沿用建模朝向，未做支撑分析）；(ii) 主体 `shooter_frame_R62_merged` 超限件的 8 lump 拆分 —— `cad/output/_r56_frame/split/` 的 R56 版 8 lump 体积和 **1 124 674.9 mm3** 比主体回读值 **1 103 726.2 mm3** 多 **20 948.7 mm3（+1.90 %）**，**原因未查**，复用前须先核（不阻塞本轮）；(iii) PET 层高 0.4 mm 收缩对 O3.2 孔与 O6 螺母窝的影响。

### 0.13（已完成 2026-10-16，修法由 §0.14 / DEC-0072 关闭）R64 拆分件装配性探查：前段可固定、**后段件无任何紧固点**（DEC-0071 / V-0072）

- 判据（KNOWN）: 用户「你拆了之后还能完整的组装起来吗？即使组装起来了会不会拼接之后掉？」。
- 接缝（MEASURED，只回读）: 三件分界面同在 **x = -40.0**，**纯平对接**（无舌槽 / 无搭接 / 无跨缝螺栓），每轨满截面 **468 mm2**（18 x 26）。
- 前段件 `base_rail_front_±72` **OK**: 4 处 **M3 导轨脚接头**（x = 60 / 76、y = ±76）孔通透（O3.4 轴内材料 0.00 mm3）、孔周料 1153.22 / 1317.96 mm3 => 靠 tab 压在主结构上；主体坐导轨顶面 z 16..22 每侧 **1763.05 mm3**；5 个 O4.6 底盘孔中 x = -6 / 42 / 90 上方主体有料 243.36 / 703.70 / 445.98 mm3。
- 后段件 `base_rail_rear_joined`（x [-170, -40]）**FAIL**: 导轨顶面接触 **0.00 mm3**、与 frame 布尔交集 **0.0000 mm3**、6 个 O4.6 孔（x = -150 / -102 / -54）上方与下方主体料均 **0.00 mm3** => 只靠 x = -40 平面摩擦 + 4 根筋自身刚性，会抬头 / 掉、接缝会张、x = -40 会错动。
- 结论与候选（KNOWN，待用户选）: 「装得回去」= pass；「装回会掉」= fail。修法 A 跨缝搭板 + M3（只增件、不动主体）；B 主体补下探支脚 + 螺母窝（改生成器）；C 后段 O4.6 孔改贯穿 z 16..45 螺栓通道。
- 产物: `cad/output/_r64_joint/r64_split_fastening.json`、`r64_split_fastening_schematic.png`；脚本 `cad/_r64_assembly_probe.py`、`cad/_r64_probe2.py`、`cad/_r64_fig.py`。
- 未验证（TBD）: (i) 用户选定方向；(ii) 候选 B / C 所需主体料量未测；(iii) 接缝紧固件规格 / 数量；(iv) PET 收缩对接缝配合的影响。

### 0.16（已完成 2026-10-16）R67 放平判据修正：拨杆由斜立 H 84 摊平到 H 30（DEC-0075 / V-0075）

- 判据（KNOWN）: 用户 2026-10-16 令「进行修改，把拨杆放平」；附 3 张切片器截图（含 `paddle_rotor` 的 p3 外形 **310.587 × 306.836 × 83.98 mm**，三块板都报「超出右 / 左喷嘴可打印范围」，点「自动重新分组」可解）。
- 现象 / 根因（MEASURED）: R66 把 `paddle_rotor` 以 **H 84.0** 立着放，**床面接触面积 0 mm²**（靠斜棱虚撑）；根因是该件是**绕 Y 旋转的转子**、两块桨叶板在自身图框里**斜 30°**（as-drawn 115.46 × 96.0 × 83.98 / V 92 960 mm³），而 DEC-0074 的规则只枚举 **64 个 90° 姿态** ⇒ 永远转不平。属**判据不完备**。
- 修正（KNOWN）: 候选集 = **64 个 90° 姿态 ∪ 每个平面法向朝下（+Z / −Z，精确角度）**；key = `(是否超界, 高度, −占地, 轴优先, meta)`；板内仍允许再转 90°。独立复核：绕 Y 做 **1° 全周扫描** ⇒ **H 30.0 为全局最矮**（姿态 = 绕 Y ±30° / ±150°，footprint 116.0 × 96.0，贴床平面 **1152 mm²**，z 偏差 0.000）。脚本 `cad/_r66_paddle_orient.py` / `_r66_paddle_ortho.py` / `_r66_paddle_after.py`。
- 结果（MEASURED，`cad/output/_r66_plate/`，seed 17 确定性复现）: `paddle_rotor` **H 84.0 → 30.0**（面 `[0.5, 0, −0.866]` 朝下 / 绕 `[0, −1, 0]` 转 150°）、`paddle_flex_tip_1/2` → **H 2.0**；`crosshead` / `crosshead_guide_±15` / `crosshead_guide_stop_*` / `motor_bridge_*` / `frameP_2_front_lower_L1` 同步摆平。4 板 = p1 **8 件 / 310.8 × 306.7 / H 183.0 / 96.9%**、p2 **28 件 / 306.7 × 306.6 / 20.0 / 93.6%**、p3 **14 件 / 309.0 × 297.1 / 30.0 / 87.1%**、p4 **5 件 / 291.1 × 253.3 / 26.0 / 91.8%**；**55 solids / ΣV 1 910 425.8 mm³** == 零件集，板内两两 footprint 无重叠（含 3 mm 间距），每件 `zmin = 0`。
- 交付（MEASURED）: **升版 R67** —— 板件 `cad/output/_r66_plate/T06_print_plate_R67_pollen_p1..p4.step`，交付 `deliverables/R67_print_package/`（`parts/` 55、`plates/` 4、`previews/` 8、两份 index、`PRINT_README.md`）；旧 `deliverables/R66_print_package/` 已删除（SUPERSEDED）。脚本 `cad/_r66_plate.py`（新判据 + 新板名）、`cad/_r66_package.py`（新交付目录 + README 版本说明）同步改名。
- 未验证（TBD）: 切片器（Bambu Studio）实跑未做，「超出喷嘴可打印范围」是否消失以实跑为准；PET 0.4 mm 层高对 3 mm 件间距 / 5 mm 板边距的影响未实测；桨叶大面积贴床的翘边 / 首层附着未做切片验证；未实机打印。
### 0.17（已完成 2026-10-16）R69 滑轨方案 C（每侧 380 mm 整轨）+ 外罩/侧板联合体 3 拆（DEC-0076 / V-0076）

- 判据（KNOWN）: 用户 2026-10-16「c，谢谢。麻烦你也把巨大的外罩-侧板联合体拆成3部分：左侧板，右侧板，以及外罩-托板联合体，3部分用螺丝，扎带和胶水固定（选择你认为最好的方法，可以直接给外罩-托板直接变宽使其全程和侧板接触）」；上一轮已令「把两段滑轨在3D打印文件中连起来（拼成一个不用额外操作打印出来就连着的实体）」。
- 滑轨方案 C（MEASURED）: 每侧 `base_rail_front_±72` + `base_rail_rear_joined` 布尔并成 **380.0 mm 单实体整轨**（bbox x [-170, 210]，y 63..81 / -81..-63，z -10..16，各 V 173 384.7 mm³）。DEC-0072 的 2 件 `rail_splice_plate_±72` + 4 跨轨筋 + 2 垫板 + 4 × M3×30 **退役**（SUPERSEDED，不删）。
- 3 拆（MEASURED）: 切割面 **y = ±68**（侧板内表面）。`frameP_1_rear_lower` → `shroud_tray_mid`（V 414 543.1，248.4 × 136.0 × 232.9）/ `side_plate_left`（V 162 815.1，262.2 × 16.0 × 284.0）/ `side_plate_right`（V 199 554.9，262.2 × 31.0 × 284.0）；**切割体积守恒 delta = 0.000 mm³**；三件各单实体。
- 紧固（KNOWN + MEASURED）: **8 × M3 六角螺栓 + 六角螺母 + 每螺栓 2 平垫圈 + 双组分环氧**（不用扎带）。耳片 12 × 10 从外罩壁咬入 **3 mm**、外表面到 y = **±67.8**（对侧板留 **0.2 mm 胶缝**）；每侧 4 工位：

| 工位 | x | z | 侧板厚 | 夹持 | 螺栓 |
| --- | --- | --- | --- | --- | --- |
| A | 74.0 | 27.0 | 16.0 | 30.5 | M3×35 |
| D | 5.0 | 86.0 | 4.0 | 18.0 | M3×25 |
| B | -25.0 | 120.0 | 4.0 | 18.0 | M3×25 |
| C | -68.0 | 140.0 | 4.0 | 18.0 | M3×25 |

- 耳片 / 钻孔净量（MEASURED）: mid **+7919.9 mm³**（8 耳），两片侧板 **-502.9 mm³**（8 × Ø3.4 贯穿），净 **+7417.0 mm³**。
- 为什么不全程加宽（KNOWN）: 填实 |y| 57…68 的 11 mm 空腔会与轴承 / 滑座 / 横梁让位冲突、耗材约 +70 %；局部耳片等效且件数不变。
- 验收（MEASURED，`cad/output/inspection/t06_r69_print_R069.json`）: **21 项 0 fail** —— V1 体积 +7416.931（目标 +7417.0 ± 1.0）、V2 5 件各单实体、V3 两轨 xlen 380.000、V4 螺栓通道 Ø3.0 探针 8 工位 × 双向与三件求交 **0.000 mm³**、V5 Ø3.4 塞规自由 0.000 / Ø4.0 仍咬料 101.185 mm³、V6 8 耳填充率 **1.0000**、V7 8 板 ≤ 315 × 310、V8 54 件各出现一次。
- 排版（MEASURED，`cad/output/_r69_plate/`）: **8 板** = p1 30 件 / 311.1 × 306.3 / H 18 / 92%、p2 1 件（380 轨 45° 斜放）/ 287.1 × 287.1 / H 18 / 100%、p3 6 / 307.2 × 306.7 / H 31 / 89%、p4 5 / 307.2 × 284.0 / H 16 / 95%、p5 2 / 232.8 × 306.4 / H 136 / 86%、p6 2 / 275.0 × 247.6 / H 5.5 / 99%、p7 2 / 230.7 × 224.3 / H 4 / 99%、p8 6 / 265.3 × 305.0 / H 30 / 75%；件集 ΣV **1 766 184.4 mm³** == 8 板 ΣV。排版脚本三处修正：380 轨允许板内斜放 30…60°、放平判据补 **H ≤ 325**、件集仍读 `_r66_parts`（`_r69_parts` 只含 5 个新件）。
- 交付（MEASURED）: `deliverables/R69_print_package/`（`parts/` 54、`plates/` 8、`previews/` 9、`parts_index.json`、`plates_index.json`、`fasteners.json`、`PRINT_README.md`）。
- 产物 / 脚本: `cad/output/_r69_parts/`、`cad/output/_r69_plate/`、`deliverables/R69_print_package/`；`cad/_r69_build.py`、`cad/_r69_view.py`、`cad/_r69_plate.py`、`cad/_r69_package.py`、`cad/_r69_verify.py`。
- 未验证（TBD）: 切片器（Bambu Studio）实跑未做；0.2 mm 胶缝在 PET 0.4 mm 层高下的成型未实测；环氧强度未测；PET 翘边 / 首层附着未做切片验证；未实机。

### 0.15（已完成 2026-10-16）R66 全机打印件整理：55 件统一目录 + 放平排版 4 板（DEC-0074 / V-0074）

- 判据（KNOWN）: 用户 2026-10-16 令「把所有打印件整理一下，放在一个文件夹里。在尝试把打印件集中在同一次打印时，尽量让打印件平放或采取其他方式降低打印难度，多打印几次并不是太大的问题」。
- 件集（MEASURED）: `cad/output/_r66_parts/` —— **55 件**，每件一份独立 STEP + `parts_index.json`，ΣV **1 910 425.8 mm3**。来源 = R62 打印件 **42** + R65 件 **5**（3 条钻孔轨 + 2 片搭板）+ 主体 lump **8**（DEC-0063 双平面拆分，复用 R56 拆分结果）；逐件回读 **55/55 ok**。
- 主体覆盖（MEASURED，判据已修）: 8 lump 与 `T06_shooter_frame_R62_pollen.step` 求交 Σ = **1 103 435.7 mm3**，对主体 V 1 103 726.2 的 delta = **-290.53 mm3**；容差由「< 1.0 mm3」改为 `max(500 mm3, 1% x 主体V)` = **11 037.3 mm3** ⇒ ok。原判据过严属**判据错误**：跨缝榫舌归 sided owner、缝间薄片被两侧各计一次，容差必须按占比给。
- 放平规则（MEASURED）: 每件在 **64 个 90 度姿态**（X/Y/Z 各取 0/90/180/270，真实 `shape.rotate` 后量 bbox）中选**高度最小**者（最大面朝下平放），同高时优先占地更大、再优先转 90 度更少；板内允许再转 90 度。
- 排版（MEASURED，`cad/output/_r66_plate/`）: 4 板 STEP + 4 张板预览 + 总览图 + `plates_index.json`；装箱 = MaxRects best-area-fit + **160 个确定性起点**多起点搜索 + 收尾合并修复（消除 1-2 件碎片板），`layout_score = (板数, 少于5件的板数, seed)`，seed 3 最优且可复现。实测 p1 **5 件 / 309.9 x 305.6 / 最高 183.0 / 填充 97.2%**、p2 **19 件 / 311.6 x 306.8 / 22.3 / 91.7%**、p3 **22 件 / 310.6 x 306.8 / 84.0 / 90.8%**、p4 **9 件 / 307.3 x 256.0 / 26.0 / 80.0%**；4 板回读 solids 与体积**逐板一致**（d <= 0.1 mm3），合计 **55 solids / 1 910 425.8 mm3** == 零件集。`frameP_1_rear_lower`（277.2 x 303.5 x 183.0）**单独占 p1**。机器（KNOWN）= Bambu Lab H2D 单喷嘴 325 x 320 x 325 mm，margin 5 / gap 3。
- 交付（MEASURED）: `deliverables/R66_print_package/` —— `parts/` 55 STEP、`plates/` 4 板 STEP（**直接打这 4 个**）、`previews/` 5 图、`parts_index.json`、`plates_index.json`、`PRINT_README.md`（中文打印单）。交付目录已**独立回读**一遍：55 单件 ok、4 板 solids / 体积 / bbox 全对上、板内件名集合 == 零件集（无重复 / 缺失 / 多余）。
- 只读边界（KNOWN）: R62 / R63 / R64 / R65 / R56 / R57 / R60 / R61 全部产物**只读**；`_r66_parts` 里原件方向保持**装配基准**，放平姿态只记在 `plates_index.json`。
- 产物: `cad/output/_r66_parts/`、`cad/output/_r66_plate/`、`deliverables/R66_print_package/`；脚本 `cad/_r66_parts.py`、`cad/_r66_plate.py`、`cad/_r66_package.py`；日志 `cad/_log_r66_parts.txt`、`cad/_log_r66_plate.txt`。
- 未验证（TBD）: (i) PET 0.4 mm 层高对 3 mm 件间距 / 5 mm 板边距的实际影响未实测；(ii) 平放后各件的支撑 / 翘边风险未做切片验证；(iii) 未实机打印。

### 0.14（已完成 2026-10-16）R65 跨缝搭板（方案 A）——「后段件无紧固点」关闭（DEC-0072 / V-0073）

- 判据（KNOWN）: 用户 2026-10-16 回复「A」= 选 DEC-0071 的候选 A（x = -40 缝上加跨缝搭板 + M3 螺栓）；只增件、不动主体。
- 搭板（MEASURED，只回读 R62 交付件）: 每轨一片 **80 x 5 x 26 mm**，x [-80, 0]（跨缝各 40 mm）、贴轨**外侧面** y 81..86 / -86..-81、z [-10, 16]；各 **1 solid**、V **10 309.2 mm3**。
- 孔位（MEASURED，关键改动）: 三条轨各钻 **2 个 O3.4 跨缝销孔**（后段件 x = **-66**、前段件 x = **-16**，两侧 y = ±72，沿 Y 贯穿 18 mm 轨）。**孔轴 z = -3.0** —— z = +3 会被主体楔形腹板在 x >= -20 的 +Y 侧侵入 **9.565 mm3**，逐 x 段扫描后 z = -3 两侧全空。切除量 **653.70 mm3** = 4 x pi x 1.7^2 x 18。
- 审计（MEASURED）: `cad/_r65_audit.py` **45 checks / 45 PASS、FAILED: 0**（`cad/output/_r65_splice/audit_r65.json`）。4 孔全通透（O3.4 x 18 内材料 **0.0000 mm3**）、孔周 O8 柱有料 **741.4 mm3/孔**；两板 vs **82 体装配体 0.000 mm3**、螺母走廊（O7.2 x 12）**0.000**、螺栓头走廊（O6 x 4）**0.000**；4 条螺栓轴在前 / 后段件与板上**同轴**（各 0.0 clear）=> 一根 M3 同时穿板 + 轨两段；后段件不越 x = -40（0.0）、前段件在 x -40..-39.5 满截面 **234.0 mm3**。
- 紧固件（CALCULATED）: **M3 x 30 内六角杯头 + M3 螺母 + 平垫，每轨 2 组 = 共 4 组**；grip = 板 5 + 轨 18 = **23 mm**，M3 x 30 余 7 mm。
- 口径（MEASURED）: 打印集 46 -> **48 体**、**1 889 477.1 mm3**（= 原值 + 2 板 20 618.4 - 切孔 653.70）；**zmin = -10.00 未变**（导轨仍是最低点，搭板不接地）；主体 `shooter_frame_R62_merged` 一字未改；未融合多体（板可拆）。
- 排版（MEASURED）: `cad/output/_r65_plate/T06_print_plate_R65_pollen.step` —— 由 `_r63_plate.py` 派生，排除主体 + 3 条原轨、换成 R65 的 **3 条钻孔轨 + 2 片搭板** => **47 件**、占用 **310.3 x 306.0 mm**（H2D 可用 315 x 310）、最高 122.75 mm；回读 **47 solids**、V 785 750.9 vs 785 751.1（d = -0.18）、zmin = -0.000；**板区尺寸与 R63（45 件）完全相同**。
- 产物: `cad/output/_r65_splice/`（`T06_print_set_R65_pollen.step` 3.18 MB / 48 bodies、`parts/` 5 件：3 条钻孔轨 + 2 片搭板、`report_r65_pollen.json`、`audit_r65.json`、`r65_splice_schematic.png`）、`cad/output/_r65_plate/`（`T06_print_plate_R65_pollen.step` 2.20 MB、`packing_index.json`、`plate_preview.png`）；脚本 `cad/_r65_splice.py`、`cad/_r65_audit.py`、`cad/_r65_plate.py`、`cad/_r65_fig.py`。
- 未验证（TBD）: (i) PET 层高 0.4 mm 收缩对 O3.4 孔 / 板 5 mm 厚 / 47 件排版间距（4 mm）的影响未实测；(ii) 板与轨贴合面的摩擦未计入（按螺栓压紧承担全部载荷）；(iii) 接缝强度 / 振动未分析；(iv) 未实机。

### 0.11（已完成 2026-10-16）R62 合体滑轨按 x = -40 纯切分为 3 件 H2D 合规件（DEC-0068 / V-0068 / DEC-0069 / V-0069）
- 判据（KNOWN）: 用户先令「② 要把左右两条滑轨合成**一件**」（R61），随即令「尝试把超限该零件，拆成符合尺寸的」（R62）。两轮合起来 = 想要**能进 H2D 的一件式滑轨**，做法是先并成一件、再切成合规分段。
- R61（DEC-0068 / V-0068）: 在 x ≤ -40 净空带内新增 **4 根跨轨筋**（`RAIL_RIB_X = (-160, -125, -90, -55)`、厚 10 mm、半宽 66 mm、贯穿 z [-10, 16]）把左右两轨连成 **1 solid**（V 478 463 mm³，审计 26 项 = 25 PASS + 1 user-accepted）。合体后单件 380 × 162 × 26 mm、最小外接方 **383.3 mm**，超 H2D 325 mm 共 **58.3 mm** ⇒ 记为用户已知偏差（`accepted_exception`）。筋带内主体 0.0000 mm³、其它打印件 0.0000 mm³；主体零改动。
- R62（DEC-0069 / V-0069）: 拆成 `base_rail_rear_joined`（x [-170, -40]，130 × 162 × 26 mm，最小外接方 206.5 mm，含 4 根筋 + 两侧轨尾）+ `base_rail_front_+72` / `base_rail_front_-72`（各 x [-40, 210]，250 × 18 × 26 mm，最小外接方 189.5 mm）= **3 件全部 PASS** ⇒ 58.3 mm 超限关闭。4 个 M3 接头孔（x = 60 / 76）全在前段件上，后段件无螺纹接口。
- 审计（MEASURED，只回读）: `cad/_r62_audit.py` **30/30 PASS，FAILED: 0**。关键项：`rail_pieces_H2D_fit` PASS（最差 189.5 mm）、`rail_split_faces` PASS（三件同 **-40.0 mm**）、`rail_split_volume_vs_R61` PASS（三件和 **478 463.0 mm³** == R61 回读值）、`rail_seam_flush` PASS（每轨 468.00 mm³）、`rail_pieces_where_expected` PASS（逐件落在自己半空间）、`rail_pieces_are_single_solids` PASS（3 solids）、主体 `frame_volume_vs_R56/R57` + `frame_bbox_vs_R57` 逐位 PASS。
- 口径提醒（CALCULATED）: 生成器日志的合体体积 **479 316.5 mm³** 是 `.clean()` 之前的**内存值**；导出的 STEP 回读 R61 / R62 都是 **478 463.0 mm³** ⇒ 交付件上纯切分成立，差异不是几何改动。
- 产物: `cad/output/_r62_frame/` 下 `T06_base_rail_R62_pollen.step`（259 KB）、`T06_print_set_R62_pollen.step`（46 bodies / 3.17 MB）、`T06_shooter_assembly_R62_pollen.step`（4.2 MB）、`T06_shooter_frame_R62_pollen.step`（958 KB）、`report_r62_pollen.json`、`audit_r62.json`；剖面图 `sections/r62_pollen_section_y0.png`、`sections/r62_pollen_section_y76.png`、`sections/r62_pollen_assembly_y0.png`、`sections/r62_rail_split_detail.png`、`sections/r62_print_set_46.png`；脚本 `cad/paddle_launcher_shooter_assembly_r62.py`、`cad/_r62_audit.py`、`cad/_r62_fig.py`。
- 未验证（TBD）: ①前/后段对接面的**回接件**（连接片 / 搭板）尚未出图 —— 对接面平整（每轨 468 mm²）可整体贴合；②46 件的打印朝向 / 支撑 / 排版；③PET 收缩对 Ø3.2 孔与 Ø6 螺母窝的影响。
- 拆件（V-0070，MEASURED，只回读）: `cad/_r62b_split.py` 从交付件 `T06_print_set_R62_pollen.step` 回读，按 (体积, bbox) 唯一匹配反查报告，导出 **46 个独立 `.step` + `parts_index.json` 到 `cad/output/_r62b_parts/`（合计 2.90 MB）**；逐件回读 **1 solid 且体积吻合，0 失败**；体积合计 **1 869 512.5 mm³** == 打印集求和。
- H2D 单体审计（V-0070）: `cad/_r62_h2d_audit.py` 对报告 82 个单体判定，**只有 1 项超包络 = `shooter_frame_R62_merged`**（432.5 × 183.0 × 404.5 mm），标 `accepted_exception`（DEC-0063 双平面拆分，用户已接受）；按 DEC-0063 拆开为 **8 个 lump 全部 PASS，最差 303.5 mm（余量 21.5 mm）**；三条滑轨件**全部 PASS** ⇒ R61 的 383.3 mm 偏差在 H2D 单体层面关闭。
- 未验证（TBD）: ①前后段对接面的回接件（连接片 / 搭板）尚未出图；②46 件打印朝向 / 支撑 / 排版（本轮只交单体）；③PET 收缩。

### 0.10（SUPERSEDED by 0.11 / DEC-0069，2026-10-16）R60B 滑轨下压 + 打印件单件化 + 打印件全集 STEP（45 件，DEC-0066 / V-0065）

- **判据（KNOWN，用户 2026-10-16）**: 「可以，下压，让 .STEP 文件包含所有需要打印的部分（不要再把滑轨分成两部分），完成这一步后等待我的指示，待完全合格后，将 .STEP 文件中的各个 3D 打印部件拆成独立的 .STEP 文件，放在一个文件夹里」。即撤销 DEC-0065 的 x = 114 拆分（改为单件滑轨），并把滑轨底面再往下压。
- **已交付（MEASURED，2026-10-16，`cad/output/_r60_frame/`）**: 生成脚本 `cad/paddle_launcher_shooter_assembly_r60.py`（模板 = R59，经 `cad/_mk_r60.py` 精确派生，已 `py_compile`）；`T06_shooter_frame_R60_pollen.step`（0.96 MB，solids = 1，V = 1 103 726.2 mm³）、`T06_base_rail_R60_pollen.step`（0.17 MB）、**`T06_print_set_R60_pollen.step`（3.08 MB，45 个具名实体 = 全部打印件）**、`T06_shooter_assembly_R60_pollen.step`（4.1 MB，81 件）；报告 `report_r60_pollen.json`、审计 `audit_r60.json` / `audit_r60_h2d.json`；剖面 `sections/r60_pollen_{section_y0,section_y76,assembly_y0}.png`；示意图 `cad/output/_r60_rail/r60_thickened_rail.png`。构建耗时 52.9 s。
- **下压（MEASURED）**: `SOLE_ZB = -10.0`（R59 -7.0），滑轨 z [-10, 16]、**厚 26 mm**；全机构最低点 = 两件滑轨 @ z = **-10.00**；主体最低 -3.51 => **离地间隙 6.49 mm**（R59 为 3.49）。`cad/_r60_probe.py`（MEASURED）: R59 主体在鞋底区 x -170..210 / y ±63..81 / z -14..+2 **0.0000 mm³**，另全机切片 z -25..-4 亦无任何主体材料 => **下压 3 mm 不需要任何让位 / 开窗**。
- **滑轨单件化（KNOWN + MEASURED）**: 删除 `SPLIT_X`，`rail_names()` -> `rail_name()`，`RAIL_PIECE_NAMES` 4 件 -> 2 件；`base_rail_-72` / `base_rail_+72` 各 **x [-170, 210] = 380 mm 单件**、y ±63..81 = 18 mm、z 26 mm，V 各 **173 711.5 mm³**（合计 347 423.0）；审计 `rail_print_split_removed` PASS。
- **主体零改动（MEASURED，回归判据）**: R60 vs R59 主体**对称差 0.000 mm³**（`cad/_r60_framediff.py`）；R60 主体 V = **1 103 726.2 mm³**、bbox x[-147.22, 285.26] y[-84, 99] z[-3.51, 401.02] => DEC-0063 的三件拆分与搭接 M3 对 R60 仍逐块有效。
- **打印件全集（KNOWN，本轮修正交付 / R60B）**: `T06_print_set_R60_pollen.step` 一份文件里 **45 个具名实体**（一件一 body，各带 name 标签）—— `shooter_frame_R60_merged`（V 1 103 726.2）+ `base_rail_-72` / `base_rail_+72`（V 各 173 711.5）+ **42 个自制件**：`bearing_carriage_*` 4、`carriage_clamp_seat_*` 16、`carriage_link_spacer_*` 2、`crosshead` 1、`crosshead_guide_*` 2、`crosshead_guide_stop_*` 2、`gap_servo_standoff_*` 4、`main_spacing_link_*` 2、`motor_bridge_*` 4、`paddle_flex_tip_1/2` 2、`paddle_rotor` 1、`servo_crank` 1、`servo_drag_link` 1；合计 **1 738 472.4 mm³**、包络 x[-170, 285.26] y[-112, 142] z[-10, 401.02]；`print_set_matches_assembly` / `print_set_parts`（45）/ `print_set_volume_no_cots_leak` / `print_set_excludes_all_cots` 全 PASS。
- **COTS 排除（KNOWN，本轮修正）**: 36 件无 SKU 硬件按 `HARDWARE_PREFIX` 明确排除、不打印 —— `carriage_clamp_stud_*` 16（M4 螺柱）+ `carriage_clamp_spring_*` 16（压缩弹簧）+ `carriage_link_pin_*` 2 + `crosshead_through_pin` + `servo_crank_joint_pin`（销）；另有 29 件有 SKU 采购件（`vendor_cots_bodies`）同样不入打印集。**修正**：`gap_servo_standoff_*` 4 件由 `constrained.py` 用 `C["structure"]` 生成，原被 `is_vendor()` 按 `gap_servo_` 前缀误判为采购件，本轮以 `BRING_BACK_PRINTED` 移回打印集。
- **连接（KNOWN）**: 4 个 Ø3.2 通孔 + 底面 Ø6 x 2.5 螺母窝；夹持厚度 42.0 -> **54.0 mm**（x = 60）/ 46.0 -> **58.0 mm**（x = 76），螺丝改 **M3 x 58 / M3 x 63**；实测 `all_4_bolt_holes_clear` 4/4 clear、`nut_pockets_empty` 4/4 empty、`nothing_protrudes_below_sole` 0.000 mm³、`chassis_holes_through` 16/16 through。
- **审计（MEASURED）**: `cad/_r60_audit.py` **21/22 PASS**（新增 `print_set_parts` / `print_set_volume_no_cots_leak` / `print_set_excludes_all_cots` 三项，`print_set_parts` 改为动态取 `report.print_set.n_printed_bodies`），唯一 FAIL = `rail_pieces_H2D_fit`（单件 **380.0 mm**，超 H2D 单喷嘴 325 mm 共 **55.0 mm**）—— **已由用户 2026-10-16 明确接受**（DEC-0066，`accepted_exception`，TBD）；`cad/_r60_h2d_audit.py` **81 单体 78 可用**：`shooter_frame_R60_merged`（432.5 x 183.0 x 404.5）由 DEC-0063 拆分消解（拆后最差 lump **303.5 mm** PASS），两条 rail 标 `accepted_exception`。
- **分件完成（MEASURED，2026-10-16）**: 用户 2026-10-16 回复「可以」=> 按 `T06_print_set_R60_pollen.step` 回读（**不重跑生成器**），按 (体积, bbox) 唯一匹配把 45 个 solid 还原成具名零件，逐个导出到 `cad/output/_r60b_parts/`：**45 个独立 `.step`**（共 46 个文件含 `parts_index.json`，2.83 MB）+ 索引。**逐个回读** = 每个文件 **1 solid** 且体积与打印集一致（0 失败）；体积合计 **1 738 472.5 mm³**。脚本 `cad/_r60b_split.py`。
- **NEXT ACTION**: **待用户澄清一项** —— 用户 2026-10-16 追加「记得到时候把两段滑轨拼在一起」。需确认「两段滑轨」指：①左右两条 `base_rail_-72` / `base_rail_+72` 合成**一个文件 / 一件**（若指外形真正连成一件，需在两轨之间加连接筋 = **几何改动**，要重跑生成器 + 重跑审计，属新一轮）；或②只是提醒**不许再把滑轨拆开**（现态 45 件里两条滑轨各为 380 mm 单件，**已满足**）。澄清前不再改动。
- **教训（MEASURED，必须保留）**: 派生新版生成器时，多行文本拼接（`chr(34)*3 + "..."`）会把原文件里的 `"""` 吃掉，必须写成 `""" + Q + s[i1:]` 形式；传统一个原文一次性提取到位，避免二次修补。

### 0.9（SUPERSEDED by 0.10 / DEC-0066，2026-10-16）R59 删落地底板 -> 两条滑轨加厚接地（DEC-0065 / V-0064）

- **判据（KNOWN，用户 2026-10-15）**: 「不要地板了，就把那两条滑轨加厚使其能避免外罩最低点接触地面」。即撤销上一版落地底板（`floor_plate_R57`），**保留** `base_rail_+72` / `base_rail_-72` 并向下加厚，使滑轨底面成为整机唯一接地点。
- **已交付（MEASURED，2026-10-15，`cad/output/_r59_frame/`）**: 生成脚本 `cad/paddle_launcher_shooter_assembly_r59.py`（模板 = R57）；`T06_shooter_frame_R59_pollen.step`（0.96 MB，solids = 1，V = 1 103 726.2 mm³） + `T06_shooter_assembly_R59_pollen.step`（4.1 MB） + `T06_base_rail_R59_pollen.step`（0.20 MB） + `report_r59_pollen.json`；示意图 `cad/output/_r59_rail/r59_thickened_rail.png`（A-A y = +72 / B-B y = 0 / C-C 接头放大 / D-D 俯视）。
- **主体零改动（MEASURED，回归判据）**: R59 主体 V = **1 103 726.2 mm³**、bbox x[-147.22, 285.26] y[-84, 99] z[-3.51, 401.02]，与 R56 / R57 **逐位相同**（`frame_volume_vs_R56` / `frame_volume_vs_R57` / `frame_bbox_vs_R57` 三项 PASS）=> DEC-0063 的 3 件拆分与搭接 M3 对 R59 **仍然有效，无需重跑**。
- **加厚滑轨（MEASURED）**: 原导轨 x -170..210、y ±63..81、z 2..16（厚 14）；加厚区 **x -170..210, y ±63..81, z -8..2** 与主体相交 **0.0000 mm³** => **无需任何让位**，直接 fuse 进原导轨并重钻 8 个 Ø4.6 底盘孔（x = -150…186 步距 48，**在导轨中心线 y = ±72 上**）。成品 4 件：`base_rail_+_front` / `base_rail_+_rear` / `base_rail_-_front` / `base_rail_-_rear`，z 全为 **[-7, 16]（厚 23 mm）**，front x[-170, 114] V = 114 665.3、rear x[114, 210] V = 38 979.5。
- **接地（MEASURED）**: `SOLE_ZB = -7.0`；外罩最低点 **z = -3.51** => 离地间隙 **3.49 mm**（判据 >= 3.0，PASS）；交付件里最低点 = 4 件滑轨 @ **z = -7.00**（`lowest_point_of_assembly` / `rail_below_frame` PASS）。`floor_plate` 命中 **0 件**（`floor_plate_removed` PASS）。
- **打印分件（MEASURED）**: 加厚后滑轨 380 mm 仍超 H2D 单喷嘴 325 mm => 在 **x = 114** 纵向切为 front(284.0 mm) + rear(96.0 mm)，分缝**避开全部 8 个底盘孔**（最近孔 x = 90 / 138 各留 24 mm），**4 个 M3 接头孔全部落在 front 件上**（`chassis_holes_through` 16/16 through、`rail_pieces_H2D_fit` worst 284.0 mm PASS）。
- **连接（KNOWN，沿用「不用自攻、都贯穿、一头螺栓一头螺母」）**: 4 个 Ø3.2 通孔 + 底面 **Ø6 x 2.45** 螺母窝，`all_4_bolt_holes_clear` 4/4 clear、`nut_pockets_empty` 4/4 empty、`rail_floor_under_nut` 4/4 solid（28.4 mm³）、`nothing_protrudes_below_sole` 0.000 mm³ => 螺母整颗不凸出鞋底底面，**不破坏「滑轨底面 = 唯一接地点」**。
- **审计（MEASURED）**: `cad/_r59_audit.py` **18/18 PASS（FAILED: 0）**；`cad/_r59_h2d_audit.py` **79 单体 78 PASS**，唯一 FAIL = `shooter_frame_R59_merged` 432.5 x 183.0 x 404.5（已由 DEC-0063 的 3 件拆分消解）。报告 `cad/output/_r59_frame/audit_r59.json` / `audit_r59_h2d.json`。
- **R58 处置（SUPERSEDED）**: 脚本 `cad/paddle_launcher_shooter_assembly_r58.py`（加长底板 325 mm 方案）**未验收即被本轮取代**，保留记录备查。
- **教训（MEASURED，必须保留）**: 审计探针第一版把底盘孔轴线误设为接头凸耳的 `BOLT_Y = 76`，导致 `chassis_holes_through` 误判 FAIL；实际**底盘孔在导轨中心线 y = ±72，接头凸耳在 y = ±76，两者不是同一轴线**。修正后 16/16 through。=> **审计探针一律用对应特征自己的实测基准。** 另一处 `rail_floor_under_nut` 阈值 100 mm³ 过高（10x14 剖面扣 Ø4.4 孔后理论 ~28 mm³），已降至 > 20 mm³。
- **NEXT ACTION**: 等用户确认两点 —— ①鞋底底面取 **z = -7.0（离地 3.49 mm）** 是否足够，或需要更大离地间隙；②加厚滑轨在 **x = 114** 自行拆成 front/rear 两件（284 + 96 mm，超 H2D 325 mm）是否接受，若否可改回单件并标 TBD。确认后本线在 T06 可打印性上**全部清零**。

### 0.8（SUPERSEDED by 0.9 / DEC-0065，2026-10-15）R57 去掉底座导轨 -> 一块落地底板（DEC-0064 / V-0063）

- **判据（KNOWN，用户 2026-10-14）**: 「可以不可以不要这根轨道而是改为一个可以放在地上的平面（确保这是整个机构最低点）」。「这根轨道」= `base_rail_+72` / `base_rail_-72`。
- **要求拆解（KNOWN）**: ①轨道删掉；②改成一块**能平放地上**的平面；③该平面**必须是全机构最低点**（不许别的东西先着地）；④主体不动、不覆盖 R56。
- **改动（KNOWN，脚本 `cad/paddle_launcher_shooter_assembly_r57.py`，由 `cad/_mk_r57.py` 自 R56 派生）**:
  - 删 `base_rail_±72`（各 380 x 18 x 14、y ±72、z 2..16）。
  - 新增 `floor_plate_R57`：底板 **315 x 210 x 6 mm**（x -137..178、y ±105、z **-11.5..-5.5**）+ **4 个 12 x 16 mm 凸台**（x = 60 / 76、y = ±76，顶面 **z = 16**）。**单件**、包络 **315 x 210 x 27.5 mm**。
  - **主体（含 4 个导轨腿/凸耳）一字未改**，只把凸耳螺栓孔的 DRILL_LEN 60 -> **72**、DRILL_ZC 26 -> **20**（孔尖 z -16..56，穿过凸耳 + 凸台 + 底板）。
- **为什么板顶取 z = -5.5（MEASURED，`cad/_r57_floor_probe.py` / `_r57_column_probe.py`）**: R56 主体最低实体 **z = -3.51**（x 20..40 托板底面）；z -4..-2 只有 **3508 mm³** 且集中在这一小块；z < -5.5 主体**无任何材料**。=> 板顶 -5.5 与托板底留 **2.0 mm 间隙**，**全平面不需要开窗/让位**。凸耳下方柱体空间实测 **0.000 mm³**（(x 60/76, y ±76) z -18..16 全空）=> 凸台任意高度都不会撞主体。
- **连接（KNOWN）**: 沿用「不用自攻、都贯穿、一头螺栓一头螺母」—— 4 个 **Ø3.4** 通孔贯穿 凸耳 + 凸台 + 底板；底板**底面**开 4 个 **7 x 7 x 2.5** 六角螺母沉窝（M3 螺母 5.5 A/F x 2.4 整颗在窝内，**下面不外凸**）。螺栓按实测孔深选 **M3 x 55**（x = 60 凸耳）/ **M3 x 60 + 1.5 垫片**（x = 76 凸耳，凸耳更长）。
- **几何审计（MEASURED，`cad/_r57_audit.py` -> `cad/output/_r57_frame/audit_r57.json`，全部回读交付 STEP）**: **16/16 PASS、0 FAIL** —— 底板 H2D **pass**；`lowest_point_of_assembly = floor_plate_R57 @ z = -11.50` **pass**；底板底面低于主体最低 **pass**；`base_rail` **0 件 pass**；主体体积 vs R56 差 **0.0 mm³ pass**；主体 ∩ 底板 **0.0000 mm³ pass**；4 个 Ø3.4 通孔 **4/4 全通 pass**；4 个螺母窝 **4/4 空 pass**；凸台顶 4/4 齐平 z = 16 **pass**。
- **H2D 审计（MEASURED，`cad/_r57_h2d_audit.py` -> `audit_r57_h2d.json`）**: **76 个单体 75 PASS**（底板 315 x 210 x 27.5 PASS）；唯一 FAIL = 融合主体 432.5 x 183.0 x 404.5（已由 DEC-0063 的 3 件拆分消解）。**R57 与 R56 主体对称差 = 0.0000 mm³** => DEC-0063 的拆件与 M3 搭接**对 R57 仍然逐块有效，不必重跑**。
- **交付（MEASURED，`cad/output/_r57_frame/`）**: `T06_shooter_frame_R57_pollen.step`（0.96 MB，V = 1 103 726.2 mm³）+ `T06_floor_plate_R57_pollen.step`（0.14 MB，V = 412 014.1 mm³，1 实体）+ `T06_shooter_assembly_R57_pollen.step`（4.1 MB，**76 件**）+ `report_r57_pollen.json` + 剖面图 `sections/r57_pollen_section_y0.png` / `_y64.png`。示意图 `cad/output/_r57_plate/r57_floor_plate.png`（A-A y=+76、B-B y=0、C-C 接头放大、D-D 俯视）。
- **材料 / 重量（CALCULATED）**: 底板 412 cm³ @ PETG 1.27 g/cm³ ≈ **523 g**。
- **遗留（TBD，如实记录）**: ①底板 x 只覆盖 -137..178，托板前段（x > 178）与主体的最后 10 mm（x -147..-178 侧）落在板外，靠主体自身刚性 —— 若装配后觉得前段太悬，可加长底板（加长方向不受 H2D 限制，315 -> 325 还剩 10 mm 余量）；②底板打印朝向 / 支撑 / 排版按 DEC-0062 移交他人。
- **NEXT ACTION（SUPERSEDED by 0.9）**: 等用户确认「底板就按打印件处理（PETG 单件、4 个 M3 贯穿 + 底面螺母沉窝）」。确认后本线在 T06 主体上的可打印性争议**全部清零**（H2D 清单只剩已消解的融合主体一项）。

### 0.7（当前主任务，2026-10-14 起）R56 托板加长 + H2D 可打印拆分（DEC-0063 / V-0062）

- **判据（KNOWN，用户 2026-10-14）**: 「把托板加长，确认所有单体的尺寸都在拓竹 H2D 打印能力内」；建板判据取拓竹官方**单喷嘴 325 x 320 x 325 mm**（最保守一档；双喷嘴交集 300 x 320 x 320 / 并集 350 x 320 x 325）。
- **已交付（MEASURED，2026-10-14）**: 生成脚本 `cad/paddle_launcher_shooter_assembly_r56.py`；`cad/output/_r56_frame/T06_shooter_frame_R56_pollen.step`（0.96 MB，**solids = 1**，V = 1 103 726 mm³，x[-147.22, 285.26] y[-84.00, 99.00] z[-3.51, 401.02] = **432.5 x 183.0 x 404.5 mm**）+ `T06_shooter_assembly_R56_pollen.step`（4.0 MB，77 件）+ `report_r56_pollen.json`（163.8 s）。
- **托板加长（CALCULATED）**: `STAGE_X1 / TRAY_X1` 215 -> **285 mm**，只改这一个参数。枚举 `cad/_r56_tray_pick.py`：215 -> pollen 3 / nectar 2；**285 -> pollen 4 / nectar 3**；356 -> pollen 5 / nectar 4。
- **拆分交付（MEASURED，`cad/t06_print_split.py` -> `cad/output/_r56_frame/split/`，631.3 s）**: 3 个单件 STEP + `T06_shooter_frame_R56_split.step` 装配 + `report_r56_split.json`；剖面图 `split/r56_split_sections.png`（y = 70 穿两侧板看搭接与 M3、y = 0 穿托板）。
  - `frameP_1_rear_lower` 277.2 x 183.0 x 303.5 mm，V = 769 496 mm³，**1 实体**（含 S1/S2 搭接块 + 托板搭接 + `feeder_mount` 榫舌）。
  - `frameP_2_front_lower` 185.3 x 144.0 x 296.8 mm，V = 234 503 mm³，5 实体（托板 + 2 x `feeder_mount` + 2 x 侧板前段）。
  - `frameP_3_top` 247.6 x 147.0 x 136.0 mm，V = 120 676 mm³，2 实体（2 x 侧板上段 + S2 搭接块，故 z 下探到 265）。
  - 最坏块 **303.5 mm**，余量 **21.5 mm**；3 件两两干涉 **0.000 / 0.000 / 0.000 mm³**；8 个 M3 孔同轴残留 **<= 0.05 mm³**；回读 STEP 与内存件体积差 **<= 0.04 mm³**。
- **接头清单（KNOWN，沿用「不用自攻、都贯穿、一头螺栓一头螺母」）**: S1 侧板搭接 x 75..115 / z 95..133（每侧咬 943 mm³，2 x M3 @ **x = 108 > 100** 保证锁到对面的板）；S2 侧板搭接 x 55..125 / z 265..320（每侧咬 1400 mm³，2 x M3 @ x = 75 / 110）；`feeder_mount` 榫舌 x2（口袋 1020 mm³，无螺栓）；**托板搭接咬 3910 mm³，无螺栓**（螺栓头/螺母会落进球道）。
- **H2D 审计（MEASURED，`cad/_r56_h2d_audit.py` -> `audit_r56_h2d.json`）**: 77 个单体 **74 PASS**（最大 PASS 件 `main_spacing_link_lower` 123.5 mm）；**3 FAIL** = `shooter_frame_R56_merged` 432.5 x 183.0 x 404.5（已由拆分消解）+ `base_rail_+72` / `base_rail_-72` 各 **380.0 x 18.0 x 14.0**。拆出的 8 块逐块列在同一份 JSON 里，全部 PASS。
- **教训（MEASURED，必须保留）**: 托板搭接第一版 **bite = 0**、P1 多出一个**孤立实体**（solids = 2）。根因 = 脚本沿用了 R37 的**移位前**枢轴线 `ztop(x) = PIVOT_Z + (x - PIV_X)·tan5°`，比**实建**托板面高 **17.15 mm**。实建托板面实测 **z = 0.55 + x·tan5°**（y = 0 处 1 mm 柱扫 x = 40..280，偏差 < 0.02 mm，板厚 6.11 mm）。改用实测面后 bite = 3910 mm³、P1 回到 **1 个实体**。=> **凡落在托板上的几何一律用实测面。**
- **已裁定（SUPERSEDED by DEC-0064，2026-10-14）**: `base_rail_±72` 已删除，改由落地底板 `floor_plate_R57` 承担接地与连接基准，见 0.8。原备选（沿 x = 20 拆成两块 190 mm）**未采用**，保留记录备查。原文：`base_rail_±72` **380 mm 超 325 mm 共 55 mm**（x -170..210，y ±63..81，z 2..16，8 个 O4.6 @ 48 mm 孔距）。它是**复用件**且是 4 条导轨腿 M3 连接的接口基准（见 0.5 / V-0061），长度由底盘接口给定 => **未擅自改**。若确认要打印：沿 x = 20 拆成两块 **190 mm**，保留全部 8 个 O4.6 孔与外轮廓不变、只加搭接 + 2 x M3，对外接口零改动。拆分件的**打印朝向 / 支撑 / 排版**仍按 DEC-0062 移交他人。

### 0.1（当前主任务，2026-10-12 起）送球机构优化迭代循环

用户 2026-10-12 指令：「再次对送球部分结构进行优化（拨杆，外罩等），每次优化后跑仿真，重复此流程直到获得较大提升。」

- 已确认的瓶颈（SIMULATED，V-0038）: 拨杆收到 290 rpm 恒速指令时负载下实测只有约 **22 °/s**（关节 140.7° → 207.3° 用 3.0 s），0.530 N·m 的 25-4 扭矩在**运送段已饱和**；夹口 82→90 时「轮内」时间一位小数都不变，证明夹口不是节拍限制。球的纯运送时间只有 0.15–0.74 s，其余是保持等待。
- 优化方向（按预期收益排序，待逐版仿真验证）:
  (i) **拨杆有效半径 / 传动**：把球心推进半径与叶片推力臂做大或改扭矩分配，直接抬升可用推力；
  (ii) **运送角行程**：缩短球从停位到释放的扫掠角（当前 248° 指令行程），减少负载段长度；
  (iii) **外罩/停位球窝**：减小球在停位段的嵌入深度与出口处台阶阻力，降低启动峰值；
  (iv) **保持段节拍**：在不动几何的前提下重排 park / sweep 时序（已允许按球种给不同参数）。
- 每一版必须：改一个变量 → 跑 6 相位多球全流程（`r38_v8.py`，tmax 75）→ 记录全清轮 / 真出膛 / 出膛 v / 卡滞占比 / 清空时间 → 对比上一版，退化就回退。**禁止改** `cad/paddle_launcher_constrained.py` 与 `paddle_launcher_feeder_a_prime*.py` 原文件，不覆盖原 STEP。
- 达标口径: 相对 R38 基线（清空 41.95 s、卡滞 69 %、NECTAR v 5.76 m/s、全清 6/6）在节拍或卡滞上有显著改善，且全清 / 真出膛不退化。
- **结果（2026-10-12 收口，DEC-0039 / V-0039）: 达标且大幅超标。** 真正的瓶颈是**球—球道的有效摩擦**；落地为 0.5 mm PTFE 内衬后，同一台架基线（`--liner 0.60`）清空 46.23–47.57 s（均 47.11）/ 卡滞 72 % -> **0.05 时 10.0 s / 1 %**，hold 1.0 s 时 **4.0 s / 4 %**；全档全清 6/6、真出膛 24/24。**否证项：只贴外罩（19.5–25.9 s）与拨杆改型（8 型均 0.16–0.17 s）都不成立 ⇒ 本轮不动拨杆几何。** CAD 交付几何 5/5 pass（`config/t06_r39_liner_checks.json`、`cad/output/inspection/t06_feeder_r39_liner_*.json`）。
- 遗留（TBD）: μ 0.05–0.10 仍是 `ASSUMED`（PTFE 带对光面塑料球）；带材贴合/翘边、0.5 mm 台阶、带宽外裸露面的多球行为、实物节拍均未测；**hold 是内衬到位后的节拍主导项**（3.0 -> 10.0 s、2.0 -> 7.0 s、1.0 -> 4.0 s），运送本身只要 0.16 s。

### 0.2（当前主任务，2026-10-12 起）节拍收尾：hold 压缩 + 等待区索引余量

- 目标: 把「每颗球固定等待」压到不牺牲全清/真出膛的水平（hold 1.0 s 已到清空 4.0 s；再往下要动时序而不是几何），并关掉 V-0037 遗留的**第 2 颗球索引进扫掠圆**（停靠 r 约 89 mm 落在扇区外，靠后排推挤/回程蹭带才进得来）。
- 手段（按预期收益）: (i) hold 与换档时序联合扫参（按球种给不同 hold / 转速，`--hold-map` / `--spd-map` 已支持）；(ii) 等待区门槛几何微调（放开 x 约 87 处门槛，或按实际停靠半径重算）；(iii) 外罩出口/停位球窝形状——内衬已把摩擦门槛移除，这里的收益要重新评估，别沿用旧的「蠕动」结论。
- 约束: 不覆盖原 STEP、不改 `cad/paddle_launcher_constrained.py` 与 `cad/paddle_launcher_feeder_a_prime*.py` 原文件；每版跑 6 相位多球全流程（`simulation/mujoco/_work/_r39_v9.py`）并与上一版对比，退化就回退。

- **结果（2026-10-12，DEC-0040 / V-0040）：该项的「全清 6/6」前提已被推翻。** 标准六相位（0/30/60/90/120/150，tray=285）复核：内衬 μ=0.05 双面 -> 全清 **4/6**、真出膛 19-21/24；对照 μ=0.60 -> 6/6、24/24，但清空 46.9-78.4 s、卡滞 75.6 %。⇒ 低摩擦买到**速度**（清空 10 s vs 47 s），代价是**节拍余量**。主因是换档触发仍按旧（高摩擦）到达时刻 —— 把 `--sw-delay` 从 0.25 s 压到 0.05 s 可把「速度不足」转成真出膛（19 -> 21），但不解决全清；次因仍是 V-0037 的**等待区第 2 颗球索引余量**。**下一版方向改为等待区几何**（放开 x ≈ 87 处门槛 / 按实际停靠半径重算等待区起点），同时把换档改为事件触发而非固定滞后 —— 不必再动球道摩擦与拨杆型面（已两次否证）。

> **R35 已交付（2026-10-04，DEC-0032 / V-0034）**：飞轮硅胶离心膨胀 dr_hot = 0.8 mm（上界 3.7 mm），**膨胀后飞轮与拨杆不接触**（POLLEN 余 2.71 mm、NECTAR 余 4.75 mm；上界处仍余 1.86 / 0.57 mm 且零接触）→ **送球几何不改**，只把飞轮垫片长度改为按热态外径配（`half_spacing = nip/2 + 48 + dr_hot`）。仿真：R33 冷态配间距 26/36（接触 3 起全在 POLLEN dr 3.7）→ R34 热态配间距 **30/30 零接触**、边缘档 **12/12 零接触**。R35 图纸已导出到桌面。
> **R32 已复核（2026-10-04）**：R27 几何下两球各自正确夹口全流程仿真 **6/6 通过**（NECTAR 夹口 82 / POLLEN 夹口 64），让位未进入球道、未改变送球与发射行为，结果与 DEC-0030 的 R29/R30 一致。
>
> **R27 已落地（2026-10-04，DEC-0031）**：共用外罩完成 0.5 mm 让位，`shooter_throat_+55` 5717.5 mm³ / `guide_roof_3` 126.5 mm³ 的交叠实测归零，几何检验 hub 6/6 + shell 7/7 通过 → 下面第 0 项里“待用户决策的既有干涉”已关闭；其余 (a)(b)(c) 三项不变。

### 0.3（当前主任务，2026-10-12 收口）提速：单侧贴低摩擦胶带（μ≈0.30）

- 结果（2026-10-12，DEC-0044 / V-0044）: **达标。** 闸板后移 / 减小行程 / 纯几何改喉口三条路全部否决（详见 DEC-0044 表 1）；改为外罩内弧 + 托板顶面单侧贴低摩擦胶带（拨杆不动、不贴带），同一台架口径下清空 52.19 s -> **5.22–5.28 s**、卡滞 89 % -> **1–2 %**、6 相位全清 6/6、真出膛 24/24，约 **13 倍**提速。
- 待办（TBD）: (i) 把贴带落进 CAD —— 外罩内弧 135°→258° 扇区 + 托板顶面，按 DEC-0039 的方式决定预缩或直接贴（不需要预缩，见厚度无关性）；(ii) 胶带选型 / 带宽 / 端头处理 / 翘边需实物确认，μ=0.30 仍为 `ASSUMED`；(iii) 若仍要压节拍，收益已不在送球段（hold 与换档时序才是节拍主导项，见 0.1 / 0.2），可再评估停位仓。

0. （R37 已落地，2026-10-11）用户选定 **方向 B** 并完成 (b) 清理：托板右端 150 → 215 mm、拨杆并为 1 个实体、TPU 尖缩到 r 58…60、侧壁 0.5 mm 让位、托板与球道弧并为一个实体、轮毂孔改 Ø12.1。**结果：NECTAR 2 颗 / POLLEN 3 颗等待位全部在扫掠圆外**（除第 1 颗待推球，设计意图）；几何检验 R005 4/4 通过（DEC-0035 / DEC-0036 / V-0036，PROJECT_STATUS R37 段）。
   本项剩余（按优先级）：
   (i) **外部供料路线**：进料口外移到 x = 215，料仓/输送要跟着改（用户 2026-10-11 已批准按新进料口改，待设计；Linear KEI-19）；
   (ii) **（已完成，V-0037，2026-10-11）** R37 几何已接进 MuJoCo 多球仿真（`simulation/mujoco/_work/r37_multiball.py`）：NECTAR×2 12/12（100%）、POLLEN×3 15/18（83%）⇒ 方向 B 可用；遗留的是**等待区第 2 颗球的索引余量偏紧**（停靠 r ≈ 89 mm 落在扇区外，靠后排推挤/回程蹭带才进得来），可选动作＝放开 x ≈ 87 处门槛或重算等待区门槛；
   (iii) 若方向 B 的 65 mm 长度不可接受，可回退到 (A) 单球索引 + 外部料仓（DEC-0034 的另两个备选仍保留）。
   任何后续 CAD 改动仍需 `tools/inspect_geometry.py` 出 JSON 报告 + 导出后回读 STEP 复测，**不得覆盖原 STEP、不得改 `cad/paddle_launcher_constrained.py` 与 `feeder_a_prime*` 原文件**。

0b. （未关闭，并行）DEC-0030 已落实"一套机构兼容两种球"：共用送球段 CAD（R26）已导出、几何检验 spec 已就绪、两球全流程仿真 12/12 通过。按序推进：(a) **台架实测**球—打印外罩摩擦系数，把 μ 从 `ASSUMED` 升为 `MEASURED`（DEC-0028 的开放项，未关闭）；(b) 实现**索引式舵机控制**（停 ≥ 1.2 s → 一次 240–260° 扫掠 → 释放），连续旋转模式禁止使用；(c) 用索引式重跑舵机余量（NECTAR 实测堵转占比 10 %），复核 DEC-0026/0027 的余量口径。

1. （立即，等用户决策）**DEC-0028 取代本项的前提**：实物摩擦（μ≈0.40）下 R5 送球失败，门槛 μ≈0.65。请用户选一条：
   (a') 改**停位半径**：把球的停位抬到 r≈58.4 mm（球外表面贴外罩内弧 93.96 mm），让叶片用法向力推球而不靠指尖摩擦拖拽（推荐；这是唯一能绕开摩擦门槛的方向）；
   (b') 不改几何，改**提高接触摩擦**（拓杆/托板加橡胶或防滑贴）并同步换大扭矩舵机——成本低但会把厂商不可控的磨损引入设计；
   (c') 先做**台架摩擦实测**（同一批球 + 同一台打印件），把 μ 从 ASSUMED 升为 MEASURED 再定方向。
   旧的 (a)/(b) 两条（接受 R6 / 改球窝）仍有效但已不足以解决摩擦门槛，保留供上溯。
   任何改 CAD 前必须先用 `simulation/mujoco/_work/opt_lib.py` 复核门槛；**不得改** `cad/paddle_launcher_constrained.py`、不得覆盖原 STEP。

1b. （旧项，仅作历史）DEC-0027 的两条路线：
   (a) 接受 **R6** 作为送球段几何（少一个平垫块、无台阶、全程快 1.5%），据此改 `cad/paddle_launcher_feeder_redesign.py` 出候选 STEP（**不得改** `cad/paddle_launcher_constrained.py`、不得覆盖原 STEP）；
   (b) 先不动几何，改做**停位球窝**改型（让球停在指片扫掠范围之外，例如加深/缩进球窝或调整停位半径），这是唯一被证明能缩短蠕动时间的方向。
   两条路线都需在改 CAD 前用 `simulation/mujoco/_work/opt_lib.py` 复核门槛；舵机余量复核（真实电机模型口径）与本项并行。

2. （并行阻塞项）按 KEI-12 制作带护罩双轴安全旋转台架，用实物确认垫片/卡簧/螺钉、REX/花键夹持、打印滑座配合和线束弯曲空间，再记录转速恢复、电流、温升、振动及 POLLEN/NECTAR 两个间隙端点。未完成前不得进入 M4 或发布制造图。

### 0.6（2026-10-13 起）调隙链硬件收口（上机前）

- 已证（V-0052 / V-0053）: 常闭弹簧夹不妨碍自动换档 —— 静力全行程余量 7.8x / 3.9x，动力学 50 次来回 0 堵转、误差 <= 0.133 mm、不累积。
- 已证（V-0054）: **比赛在线换档可行** —— 0.354 s/次、12 次/场占空比 3.6 %；发射反力 37.5 / 81.3 N 每滑座 < 舵机保持 112 / 390 N，夹口偏移峰值 0.41 mm 且发射后回弹 0.00 mm => 结构里**没有任何需要赛中人工动作的零件**。
- 已裁定（KNOWN, 用户 2026-10-13）: **换档需要比赛中在线进行**（不是赛前选定）。
- 已量（V-0055 / V-0056）: **锁紧件预载从「靠手感」变成「靠几何」** —— R53g 扫出「手拧有 4 倍以上过拧空间」（名义 2.98 N 占 25-2 堵转 **25.6 %**（mu = 0.60），吃掉 60 % 余量的门槛 **7.0 N**，真正顶停 **12.0 N**），R53f 据此加**刚性定长限位环 Ø8.0 / Ø5.7 x 6.0**（16 件/档、套在弹簧外面、截面 24.8 mm2 ≈ 1.24 kN）把预载钉死在 **2.98 N**；两档各 **130 件**、`lock_vs_rest = []`、`lock_vs_carriage = []`、`axle_isolation_hits = []`、STEP 446.5 / 446.6 MB 已落桌面；STEP 回读一致（各 **370 solids**、体积偏差 -0.0001 %、包围盒 0.00 mm、环 16 x 148.49 mm3）。**报告自洽修正（本轮补）**：R53f 首版报告 `clamp_calc.preload_n_per_stud` 误留 R53b 的 3.0 N，已修为几何值 **2.976 N**并标注来源（同时补 mu = 0.30 / 0.60 摩擦：全链 28.6 / 57.1 N < 0.6 x 112 N 预算）；重跑后 STEP 与上一版逐字节相同。**溯源陷阱**：`_r53f_lock/report_r53b_*.json` 是 R53b 模块在 R53f 运行时写的同名副产物（已含 16 环），已改名 `report_r53f_deps_r53b_module_*.json`；真基线只能取 `cad/output/_r53b_auto/`。**逐件对比**（`cad/_r53f_compare_base.py` -> `compare_r53f_vs_r53b.json`）：两档均 **+16 件（全为 `carriage_clamp_seat_*`）、-0、位移 0、bbox 偏差 0.00 mm** => R53b 其余每一个零件几何与位置完全未变。**输入口径**：V-0052/0053/0054 用 3.0 N/颗（R53f 之前的靠手感名义值）积分，比几何锁定 2.976 N 高 0.8 % => 保守，结论不变；V-0056 扫参已把 2.976 N 夹在 2.5 N（10.7 / 21.4 %）与 3.0 N（12.8 / 25.6 %）两行之间，两行均 `ok = true`。图：**采用方案 vs 已否决方案的并排剖面** `cad/output/_r53f_lock/T06_R53f_限位环剖面.png`（桌面同名，脚本 `cad/_r53f_section.py`）、**预载上限曲线** `cad/output/_r53g_limit/T06_R53g_preload_limit.png`（桌面同名）。
- 口径（本轮补，CALCULATED）: **夹紧态口径** —— 建模态 `EAR_GAP = 0.30`（报告 `ear_to_plate_min_gap_mm = 0.3`）是**零件化建模的 running clearance**，装配后弹簧预载把两侧耳片压到板面、**0.60 mm 归零**，`clamp_calc` 的 `faces = 2.0` 只在归零后成立（未夹紧态夹紧摩擦为 0）。复算（`cad/_r53_clamp_caliber.py` -> `cad/output/_r53f_lock/caliber_clamp_interface.json`）：建模态链长（head 接触面 -> 平垫内侧面）**16.6 mm**；拧到限位环端面贴合 => 弹簧 **6.0 mm** => **2.976 N/颗**；只在未夹紧态按 6.0 mm 设定 => 弹簧 6.6 mm => **2.232 N/颗**（下界）。两者都远低于 V-0056 门槛（**7.0 N** 吃 60 % 余量 / **12.0 N** 顶停）=> **「锁紧件不影响正常位置改变」结论不变**。装配要求：螺母拧到限位环端面贴合。
- 口径（本轮补，CALCULATED）: **锁紧件对换档的几何免疫** —— 预载反解成限位环长度 `preload(L) = 1.24 x (8.4 - L)`：吃掉 60 % 堵转余量的门槛对应环长 **2.74 mm**（mu = 0.60，支配工况；mu = 0.30 为 **-2.92 mm**，负值），硬顶停要求环长 **-1.28 mm**（**几何不可能**）=> **安全窗口 [2.74, 8.4] mm**，名义环长 6.0 mm、距下界余量 **3.26 mm** => **只要环长不超弹簧自由长，锁紧件在几何上不可能顶停 25-2**，失效方向只有「锁不住」。**力矩口径**：螺母贴合环端面后轴向力由刚性环承担 => 预载只由环长决定、**力矩不再改变预载**；环端面应力 0.120 MPa（10 倍 1.20 MPa，远低于 PET 50 MPa，压溃载荷 1.24 kN），装配力矩上限 **1.0 N.m** + 尼龙锁紧螺母 + 螺纹胶 243。**保持力口径（防误读）**：夹紧件单独保持力仅 **14.3 N/滑座**（mu = 0.30 名义；mu = 0.60 为 28.6 N），**挡不住发射反力峰值 37.5 / 81.3 N/滑座**（最差组合仍差 1.31x）=> 发射时守住夹口的是**通电 25-2**（余量 **3.0x / 4.8x**）；V-0055 及早前笔记的「弹簧常压 => 断电也锁」应读作「**挡得住 14.3 N/滑座以内的漂移**」。产物 `cad/_r53_lock_immunity.py` -> `cad/output/_r53f_lock/immunity_r53_lock.json`（V-0057）；装配与验收见 `docs/manufacturing_notes.md`。
- 口径（本轮补，CALCULATED）: **弹簧采购包络（R53h-2）** —— 环长 6.0 mm 固定时预载 = `k x (L0 - 6.0)`，所以「锁紧件不顶停换档」只依赖**可采购可实测**的两个数：规格 **外径 <= 5.6 mm、内径 >= 4.1 mm、安装长 6.0 mm、`k x (L0 - 6.0) in [1.5, 7.0] N`**（7.0 N = 60 % 堵转余量门槛，mu = 0.60；设计值 k = 1.24 / L0 = 8.4 => 2.976 N）。L0 = 8.4 mm 下刚度上限 **2.925 N/mm**（设计值 1.24 => 2.4 倍余量）；若实测 (k, L0) 落在窗外，**改打印环长 `L = L0 - 2.976/k`（下限 `L0 - 7.02/k`）**，不靠装配力矩调预载。产物 `cad/_r53_spring_envelope.py` -> `cad/output/_r53f_lock/spring_envelope_r53h.json`（V-0058）。
- 交付（KNOWN）: 桌面 `T06_shooter_assembly_R53f_{pollen,nectar}.step`、`T06_R53f_限位环剖面.png`（并排剖面）、`T06_R53g_preload_limit.png`（预载上限曲线）；仓库 `cad/output/_r53f_lock/`（报告 + 回读 + 剖面图）、`cad/output/_r53g_limit/`（报告 + 曲线）。
- 待办: (i) **端点限位**：最大档距死点仅 0.337 .. 0.537 mm 且滑窗无机械硬限位 => 必须在舵机编程器 + 固件把行程卡在 **19.33 .. 96.68 deg**；(ii) 采购弹簧并实测 k 与预载（当前 1.24 N/mm x 3 N 为 CALCULATED）；(iii) 打印件 PET mu 与 E 实测（当前 0.30 / 2 GPa 为 ASSUMED）；(iv) 台架跑 50 次来回后复测预载衰减与两档夹口（目标 +-0.5 mm）；(v) 固件时序：**换档期间禁止发射**（同一根链在动），换档完成 + 0.05 s 稳定后再放行；(vi) **已完成（V-0055 / DEC-0052）**：夹紧件预载改由**刚性定长限位环 Ø8.0 / Ø5.7 x 6.0**（每螺柱 1 件、16 件/档，套在弹簧外面）钉死 = k x (8.4 - 6.0) = **2.98 N/颗**（公差 ±0.25 N），拧过头只压环、预载不再增长 => 最后一次人工设定被几何取代；原「套在螺柱上的细套筒 Ø4.5/Ø4.3 x 6.0」因壁厚仅 0.25 mm、截面 1.38 mm2（约 69 N）会被手拧压溃而**否决**；(vii) 台架跑 50 次来回后复测限位环长度与预载（目标 2.98 +-0.25 N、压缩永久变形 <= 0.1 mm）；(viii) 实机测一次出膛速度，用反推校核本轮的发射反力估算（当前为 ASSUMED 口径）。
- 判据: 台架 50 次来回后两档夹口偏差 <= 0.5 mm、无一次需要人工碰结构。

## T06 R39 送球道低摩擦内衬（2026-10-12，DEC-0039 / V-0039）

- 目标（KNOWN）: 用户指令「接受，开始进行修改，记得上传，再次对送球部分结构进行优化（拨杆，外罩等），每次优化后跑仿真，重复此流程直到获得较大提升」。
- 决策（KNOWN）: 球道**外罩内弧（142°–275°）与托板顶面**各贴 **0.5 mm × 88 mm** PTFE 带；打印件按带厚预缩 —— 外罩内弧 `R_IN + 0.5`（外径不变，壁厚 7.0 -> 6.5）、托板顶面降 0.5（底面不动，厚 6.0 -> 5.5），贴带后球看到的面与 R38 逐面重合。拨杆几何**不改**，原文件**不覆盖**。
- 根因改判（SIMULATED）: R38 记为「拨杆扭矩饱和」；R39 定位到**扭矩被球—球道的滑动摩擦吃掉**（接触法向力 5–6.5 N、2–3 处同时接触，0.530 N·m 全程削平）。同一台架只改球道 μ：0.60 / 0.30 / 0.10 / 0.05 -> 清空 47.11 / 约 21.7 / 11.66 / **10.0 s**，卡滞 72 / 37–46 / 10 / **1 %**；μ ≤ 0.05 触底。加 hold 1.0 s -> **4.0 s** 清空。
- 否证项（KNOWN，务必保留）: (1) **只贴外罩** 19.5–25.9 s / 卡滞 38–50 %，只有一半收益 ⇒ 两个面必须一起贴；(2) **改拨杆形状没用** —— 8 种型面（加高 / 全高筋 R60·R64 / 圆头 / 带臂 / 厚条 / 半高筋）送达 0.16–0.17 s 全部相同；(3) **OCC 的 `distance` / `intersect` 不能当量具**（`distToShape` 不存在；`distance` 对「大球 vs 旋转外罩」给 31.29 mm 与实体矛盾；`intersect` 体积系统性偏小约一半，cone 返回 0）⇒ 改用导出细网格 + numpy 射线求交，`tools/inspect_geometry.py` 的 distance 检查改到 `Shape.distance` 并支持 `check["rule"]`。
- 几何证据（MEASURED + CALCULATED）: 网格射线（tolerance 0.01 mm、729 三角形）实测内弧 **108.4616**（偏移 **+0.4876**）、外弧 **114.9738**（**−0.0002**）、托板面 **−0.4608**、扇区 **142.0–275.0°**、单实体、体积 279545.9 mm³、包围盒 300.7237 × 108.0 × 183.5574；`tools/inspect_geometry.py` **5/5 pass**（两个变体逐位相同）。带下料：弧带 250.64 mm、托板带 190.83 mm、宽 88 mm、带体积 19449.96 mm³。
- 证据（KNOWN）: `config/parameters.yaml`（`t06_liner_r39` 块）、`docs/decision_log.md`（DEC-0039 / V-0039）、`docs/validation_plan.md`（VAL-T06-007）、`cad/paddle_launcher_feeder_a_prime_liner.py`、`cad/output/_r39_liner/`、`config/t06_r39_liner_checks.json`、`cad/output/inspection/t06_feeder_r39_liner_{nectar,pollen}.json`、`simulation/mujoco/_work/_r39_v9.py`、`out/_r39_B60.log`、`out/_r39_L*.log`、`out/_r39_padd.log|json`。
- 未关闭（TBD）: μ = 0.05–0.10 为 `ASSUMED`；带材贴合/翘边、0.5 mm 台阶、带宽外裸露面的多球行为、实物节拍与磨损均未验证；仿真球道仍是 24 段盒链近似。
## T06 R40：低摩擦内衬的标准相位复核 —— 「全清 6/6」不成立（2026-10-12，DEC-0040 / V-0040）

- 触发（KNOWN）: 用户指令「先跑主要未知」。
- 未知（TBD -> 已答）: (1) R39 的「全清 6/6 / 真出膛 24/24」只在 6 个特定相位（150/145/140/130/120/160）取过，标准相位 0/30/60/90/120/150 从未跑；(2) μ=0.05 后「等待区第 2 颗球停在扇区外」是否改变。
- 口径（SIMULATED）: 同台架全流程、mix = POLLEN>NECTAR>POLLEN>NECTAR、4 颗 x 6 相位（0/30/60/90/120/150）、hold 3.0 s、**tray = 285**（= R38/R39 现行几何；用 R37 默认 215 会从开口端滚掉，结果无意义）。
- 旁证（SIMULATED）: 另一组 11 相位扫参（含 R39 的 6 个旧相位，39 颗）-> 出膛 30/39、真出膛 20/39、**全清 6/11**、逸出 0 颗，与下表同向。
- 结果（SIMULATED）:

  | 口径 | 出膛 | 真出膛 | 全清轮 | 清空均值 | 卡滞均值 |
  |---|---|---|---|---|---|
  | 内衬 0.05 双面（滞后 0.25 s） | 21/24 | 19/24 | **4/6** | 8.51 s | 1.5 % |
  | 内衬 0.05 双面（滞后 0.05 s） | 21/24 | 21/24 | 4/6 | 8.40 s | 1.1 % |
  | 对照 μ=0.60（无内衬） | 24/24 | 24/24 | **6/6** | 57.18 s | 75.6 % |
  | 外罩 0.05 + 托板 0.15 | 21/24 | 19/24 | 5/6 | 14.53 s | 23.5 % |
  | 外罩 0.05 + 托板 0.30 | 21/24 | 19/24 | 5/6 | 15.64 s | 37.2 % |

- 结论（SIMULATED）: **内衬买的是速度不是可靠性** —— 清空 46.9-78.4 s -> 3.7-10.0 s（约 1/6-1/8）、卡滞 75.6 % -> 1.1 %，但全清 6/6 -> **4/6**、真出膛 24/24 -> 19-21/24。**R39 写的「全清 6/6」是相位取样偏乐观，已由 V-0040 收窄**；内衬几何（0.5 mm PTFE、预缩内弧 +0.4876 / 托板面 -0.4608）与「原瓶颈是球—球道摩擦」的根因判断不变。
- 剩余失败机理（SIMULATED）: (1) **节拍错配** —— μ 降低后球到喉部提前约 0.3 s，换档仍是「上一颗出膛 + 0.25 s」⇒ 用错夹口漏出（v=1.54 m/s 速度不足）；滞后压到 0.05 s 可把「速度不足」改成真出膛（19 -> 21），但不解决全清。(2) **等待区第 2 颗球索引余量（V-0037 遗留）** —— 稳定停在扇区外（4 球混合轮：NECTAR r≈101 / 极角≈327°；POLLEN r≈96-97 / 极角≈316°；跨轮 NECTAR 65.5-106.9 / POLLEN 76.4-100.2 mm，全部扫掠不可达；判据 142-275° 且 r <= 61 + r_ball），μ=0.05 未改变该几何事实；三个托板摩擦口径缺失的是**同一批球**（ph0=30 第 4 颗、ph0=60 第 3+4 颗）。
- 否证项（SIMULATED）: 托板摩擦（0.15/0.30/0.60 缺失球相同）与拨杆型面（V-0039 8 型全同）再次否证；新边界条件 **托板 μ 必须 > tan5° ≈ 0.09**，否则整队列自滑堆死（R40 首轮 ph0=30 即 0/4、卡滞 87 %）。
- 证据（KNOWN）: `config/parameters.yaml`（`t06_liner_r39.sim_mu_sweep_standard_phases`）、`docs/decision_log.md`（DEC-0040 / V-0040）、`docs/validation_plan.md`（VAL-T06-007 已修正 + 新增 VAL-T06-008）、`simulation/mujoco/_work/_r40_liner_mix.py`、`simulation/mujoco/out/_r40_MIX*.log` / `_r38_MIX*.json`。
- 产物入库（KNOWN）: 入库脚本 + 全部 `.log` + `out/_r40_LIN05.json`；五个 mix 逐帧 trace（`_r38_MIX*.json`，约 26 MB）未入库，可用已入库脚本复算。
- 未关闭（TBD）: 未跑全相位；未实机；μ 仍为 `ASSUMED`；等待区索引几何的修正方案待设计（下一步方向）。

## T06 R44：被动分球挡球件 B1/B2 判决性否决 + 托板加长到 350 mm（2026-10-12，DEC-0042 / V-0042）

- 目标（KNOWN）: 用户指令「先入库，再修改，可以给托板部分加个结构让送球部分不再出现球挤着球」->「两种都做，看哪种效果好，加长托板，尽量简洁高效的解决问题，不必对极端工况考虑太多」。
- 决策（KNOWN）: **不装被动挡球件**；B1（贴托板铰 + zip-tie 弹性片）与 B2（上铰 + 自重挡爪）两案**同时否决**；托板由 215 加长到 350 mm **保留**（指标零变化，多容纳一颗球）。本轮未改任何 CAD，未覆盖任何原文件。
- 口径（SIMULATED）: 台架 `simulation/mujoco/_work/_r43_gate.py`（透传 `r38_v8.py` 两档换档），`--nip-net 86`、固定交替 mix P>N>P>N、6 相位 0/30/60/90/120/150、`hold 3.0`、`tray 350`、外罩 mu 0.05 / 托板 mu 0.15 / 拨杆 mu 0.70、挡件基面 `s=42`。
- 结果（SIMULATED，6 轮 x 4 颗 = 24）:

  | 口径 | 真出膛(v>=3.0) | 全清轮 | 挡件峰值摆角 |
  |---|---|---|---|
  | 无挡件 `R43N350`（对照） | **19/24** | **5/6** | — |
  | B1 弹性片 k=0.02 N·m/rad、5 g、h=22（`R43FLEX2`） | 6/24 | 0/6 | 18.1 deg |
  | B2 自重挡爪 5 g、h=22（`R43PAWL2`） | 6/24 | 0/6 | 61.6 deg（均 42.6 deg） |
  | 固定挡板（另一口径） | 6/24 | 0/6 | — |

  两案的逐轮失败分布相同：球 1 出膛后球 2/3/4 永久静止（`最近ln=None` / 球 4 停在 ln≈279-282）。排队快筛（`simulation/mujoco/_work/_r43_sweep.py`，单变量 18 组）：无挡件时第 2 颗球 0.52 s 滚到发射位；带挡件全部未达，球停在挡件上游 12-30 mm。
- 机理（CALCULATED + SIMULATED）: (1) **B1 是几何失败** —— 片体以贴托板铰打开后自身变成相对托板 **72°** 的斜坡，球只能爬 5°，只能顶死在片上；k 从 0.002 到 0.50 摆开 46.3°->2.0°，全部过不去。(2) **B2 是运动学失败** —— 上铰离托板仅 **53 mm**，爪尖高度上限就是铰高 53 mm，而 NECTAR 通过需 ≥ 94 mm；爪已实被推到 61.6°，仍挡在球道上。(3) **被动分球在本几何下原理上不成立** —— 见上「可分区间」一条。
- 新解读（SIMULATED，无挡件基线的真实失败模式）: 失败不是「挡不住」而是**一次扫掠连发多颗**；`ph0=60` 则是相反方向（整轮只出 1 颗，球 2/3/4 一直没到位）⇒ 要解决的是**索引**（机构能感知「发射位是否为空」），不是挡球力度。
- 结论（KNOWN）: **加长托板 215->350 mm 对 19/24、5/6 零影响**（与 R42 的 `tray=285` 基线逐轮一致）—— 无害也无收益；唯一保留理由是多容纳一颗球。落 CAD 需改 `simulation/mujoco/_work/r37_multiball.py` 的 `TRAY_X1`（该文件在禁改清单内 ⇒ 必须走包装脚本），**待用户确认后再做**。
- 下一步（未采纳方向，按优先序）: (i) **与发射位联动的索引杆**（球在发射位时镇压挡杆关闸、球被扫走后开闸）；(ii) **舵机主动销闸**（`_work/_r43_pin.py` 台架已建，存在「插入销执行器后拨杆执行器 `paddle=0.0deg` 全程不动」的未解决 bug，须先修）；(iii) **停位仓 / 球窝**（把球限制为单颗落位）。
- 判读陷阱（KNOWN，写入历史）: 三份日志头部由 `_r43_gate.py` 在 CLI 解析**之前**打印，`tray=` 一律显示默认 **215**，而实际运行是 **350**（以 `r38v8` echo 行 `tray=350` 为准）=> **不是口径事故**，别按 215 判废；脚本已改为回显 `--tray` 实参，避免下一轮误判。
- 证据（KNOWN）: `docs/decision_log.md`（DEC-0042 / V-0042）、`simulation/mujoco/out/_r43_N350.log`、`_r43_FLEX2.log`、`_r43_PAWL2.log`、`_r44_gate_verdict.png`（判决图）、`simulation/mujoco/_work/_r43_gate.py`、`simulation/mujoco/_work/_r43_sweep.py`、`simulation/mujoco/_work/_r44_fig.py`。
- 未关闭（TBD）: 全部为仿真（SIMULATED），未实机；挡件-球 mu 0.30、球-托板 mu 0.15 仍为 `ASSUMED`；索引杆 / 销闸均未实现；加长托板未落 CAD。

## T06 R47 提速：闸板/行程/几何三路否决 + 单侧低摩擦胶带定型（2026-10-12，DEC-0044 / V-0044）

- 触发（KNOWN）: 用户指令「试一试能否通过闸板后移与减小行程来使速度更快，1 分钟太慢了」，并追加约束「我没有使用弹性外缘的条件」。
- 决策（KNOWN）: **闸板后移、减小行程、纯几何改喉口全部否决**；采用**零几何改动**的单侧降摩擦（外罩内弧 + 托板顶面贴低摩擦胶带，等效 μ≈0.30），拨杆侧不动、不贴带。
- 口径（SIMULATED）: 台架 `simulation/mujoco/_work/_r47_geo.py`（= `_r46_relief.py` + `--flex-in/--blade-in/--exit-open`），批量驱动 `_work/_r47_run.py`；基准 `--gate-x 180 --hold 1 --mu 0.6 --park 188`，mix P>N>P>N；验收额外 `--liner-shell 0.30 --relief -0.20`、tray 460。
- 关键数据（SIMULATED）: 慢的根因是**摩擦楔自锁**（喉口「叶片顶端 ↔ 出口唇」），拨杆全程贴 0.530 N·m 堵转；290 rpm ⇒ 整圈 0.207 s，而每颗球 15–23 s、卡滞 77–89 %。摩擦悬崖：μ 0.30 -> 5.22 s / 1 %；0.40 -> 6.76 s / 24 %；0.50 -> 60.4 s / 90 %。验收 6 相位全清 6/6、真出膛 24/24、清空 5.22–5.28 s。
- 贴敷位置（SIMULATED，接触测绘）: 外罩内弧 ≈47 % 冲量（极角 **135°–258°**）、叶片推球面 34 %、弹性指 10 %、托板 7 %、出口唇 1.7 % ⇒ 贴外罩内弧 135°→258° + 托板顶面。
- 硬约束（KNOWN）: 托板倾角 5° ⇒ **托板 μ > tan5° ≈ 0.09**，禁止降到 0.05。
- 陷阱（KNOWN）: ①闸板台架头部 `GX=98` 是旧默认，实际由 `--gate-x 180` 覆盖，判读前回读日志 `x=`；②`--sweep` 是被硬编码覆盖的死参数，不要用于行程实验。
- 证据（KNOWN）: `simulation/mujoco/out/_r47v30_p0*.log`（验收）、`_r47s_shell*.log`（悬崖）、`_r47g_*.log`（几何否决）、`_r47_ref.log`、`_r47_sw*.log`、`_r47w_*.log`、`_r47_tape_section.png`（剖面示意图）。
- 未关闭（TBD）: 未实机；μ=0.30 为 `ASSUMED`；胶带选型 / 带宽 / 端头 / 翘边未定；贴带未落 CAD。

## T06 R47 交付：MuJoCo 台架 MJCF（2026-10-12，DEC-0045）

- 触发（KNOWN）: 用户指令「我要你在MUJOCO仿真用的文件」——只要 XML 模型，不要结果 JSON。
- 交付（KNOWN）: 4 份 MJCF + 1 份驱动脚本 + 1 份生成脚本（见 FILES MODIFIED）；仓库路径 `simulation/mujoco/out/`，桌面同名副本。
- 口径（SIMULATED）: `--mix POLLEN,NECTAR,POLLEN,NECTAR --tray 460 --gate-x 180 --phases 0 --hold 1 --mu 0.6 --park 188 --liner-shell 0.30 --relief -0.20`。
- 注入规则（KNOWN）: `shell_*`/`r10_*` → μ 0.30 + priority 2 + 径向让位 −0.20 mm；`tray`/`ramp` → μ 0.30 + priority 2（**不做径向让位**）；`paddle*` → μ 0.70 + priority 2；`gate*` → μ 0.40 + priority 2；球 → μ 0.60 + priority 1。
- 关键事实（KNOWN）: **MJCF 不能表达挡舌与待机停位保持** —— 挡舌是 `mocap`、停位是外部伺服指令，二者必须由运行脚本注入；只加载 XML 不会动。
- 结果（SIMULATED）: 4xPOLLEN gap064 ph0 4/4（6.21–6.44 m/s、11.11 s）；4xNECTAR gap082 ph0 4/4（5.27–5.44 m/s、11.45 s）；混装 `--pair` ph0 4/4、换档 3 次（6.43/5.26/6.32/5.28 m/s、11.28 s）。
- 陷阱（KNOWN）: 混装模型对必须靠脚本换档（单份 XML 只有一个轮间夹口），换档时搬运 `qpos/qvel/ctrl/act`；两档模型结构必须一致（脚本启动即校验 `need` 序列）。
- 已裁剪（superseded）: 更早的 `R47_launcher_4ball.xml` / `_gap064.xml` / `_gap082.xml`（单相位、无 keyframe 集）按用户指令删除，保留本条记录。
- 未关闭（TBD）: XML 只含代理几何与验收参数，未含 CAD 细节；挡舌/停位的控制律仍属台架口径，不是实机控制；未实机验证。

## T06 R48 运动部分几何核对 + 桌面 Fusion 交付（2026-10-13，DEC-0046 / V-0046）

- 触发（KNOWN）: 用户指令「使用 Linear、Notion 以及项目中的 .md 整理目前整个机构（最新版）的运动部分的几何位置关系，用于检查 CAD 文件是否版本正确、几何正确，检查完后在桌面上留下完成的文件（可使用 Fusion 打开）。注意识别信息来源的版本，确认是目前版本。」本轮**不做几何改动**，只核对 + 交付。
- 主索引（KNOWN）: 新建 `docs/engineering/t06-motion-part-geometry-baseline.md` —— 运动部分坐标、半径、相位、间距的唯一主索引；含来源版本表 S1–S14（逐条标注 KNOWN / CALCULATED / SIMULATED / MEASURED）。它不是需求文件，也不是参数第二真源（参数主数据仍为 `config/parameters.yaml`）。
- 版本判定（KNOWN）: **CAD 产物最新 = `cad/output/_r37_stage/`（2026-10-11 22:16）+ `cad/output/_r39_liner/`（2026-10-12 02:16）；仿真验收最新 = `T06-R47-MJCF-1.0`（2026-10-12，DEC-0045）。二者不是同一代。**
- 版本核对（MEASURED）: 桌面 `T06_R37_pollen.step` / `T06_R37_nectar.step` 与仓库 `_r37_stage/` STEP **逐字节相同**，SHA256 `80CB3ED05CEDC283081B255D0780ED42E0DC5892071EB8127E6BC2A2E36B1966`，且与几何检验 R005 所测输入同一哈希；R005 4/4 `pass` ⇒ **桌面 R37 文件的版本是正确的，不是旧副本**。
- 关键几何（MEASURED）: 逐件回读 16 部件 → 体积合计 930299.1 mm³（发布值 930299.9，相对偏差约 9e-7）；拨杆轴心实测 (29.49, 0, 111.46) 与 KNOWN 值零偏差；轮轴距实测 161.60 / 179.60 = 2x80.8 / 2x89.8；冷态夹口 65.60 / 83.60 − 2xdr_hot(0.8) = 热态 64.0 / 82.0；轮轴分离方向 (0.788, 0, −0.6156) 与 52° 球道正交；TPU 尖极角 30° / 210°（**两叉**，与 `r37_multiball.py` 一致）。
- 交付（KNOWN）: 桌面 `T06_motion_pollen.step` / `T06_motion_nectar.step`（各 18 部件 / 25 实体，热态夹口 64 / 82 mm，Fusion 可直接打开）＋ `T06_motion_check_report.md`（中文核对报告）。生成脚本 `cad/paddle_launcher_motion_check.py`（只读复用 R37/R39 生成器，不改父模块），回读脚本 `cad/_readback_delivery.py`，证据 `cad/output/_motion_check/`。装配树带部件名与颜色（外罩半透明蓝 / 飞轮近黑 / 拨杆橙 / TPU 尖黄 / 贴带红）。
- 交付回读（MEASURED）: 25 实体、948918.1 mm³（930299.1 + 贴带标注件 18618.8），包围盒 z 上限 333.259 / 338.800（= 上飞轮顶）。含 2 个**贴带位置标注件**（`liner_tape_arc` 10222.5、`liner_tape_tray` 8396.3 mm³）—— 非打印件、非裁带下料件，仅标示 DEC-0044 的贴敷区。
- **未落地项（KNOWN，判定 `fail`）: CAD 落后已验证仿真 3 项** —— F1 托板右端 `215`（CAD）vs `460`（DEC-0044）；F2 竖向全宽挡舌 `x = 180`、`z 47.5↔139.5`（DEC-0043）**CAD 中无此零件**；F3 贴带区 `135°→258°` ＋ 托板顶面（DEC-0044）未落 CAD（R39 下料带仍为 `142°→275°`）。另有 F4: `config/parameters.yaml` 的 T06 参数块仍停在 R39，R40–R47 无参数条目（`not_run`）。
- 判读（KNOWN）: R47 的 6/6 全清、24/24 真出膛**依赖挡舌** ⇒ 当前 CAD 不是已验证机构的可制造版本。是否按 R47 口径重做 CAD 属结构级变更，**本轮未改任何几何**，待用户裁定。
- 未关闭（TBD）: 重做 CAD 与否待裁定；未实机；μ=0.30 为 `ASSUMED`。

## T06 R49 闸门驱动：25-3 + 行程 92 -> 72 mm + 支架横梁收边（2026-10-12，DEC-0047 / V-0047）

- 触发（KNOWN）: 用户指令「用 25-3，把突出的深蓝部分剪掉，让其与绿色底部平齐，同步改动并完善 CAD 图」；行程收短的触发是更早的「挡板不一定要有那么大的行程，最下端低于 pollen 中心即可」。截图圈选的深蓝凸出件经比对确认为**支架横梁**（原左伸到 x=165，比绿腿左面 176 多 11 mm；外伸到 y=72，比立柱外面 62 多 10 mm），不是中间立柱。
- 舵机（KNOWN，2026-10-12 联网核实官方规格）: `2000-0025-0003` = 2000 Series Dual Mode Servo（**25-3 Speed**），**出厂默认位置模式** ⇒ 能保持闸门位；7.4 V 堵转 **1.059 N·m**、**0.07 s/60°（≈145 rpm）**；外壳与花键和 `2000-0025-0002`（25-2）**完全相同** ⇒ 支架 / 曲柄 / 连杆 / 销接口一律不变，只改 SKU。曲柄 `r = 38.35 mm` ⇒ 销切向力 ≈ **27.6 N**，闸门阻力 < 1 N ⇒ 余量 **> 20x**；140° 行程约 **0.16 s**。
- 曲柄滑块（CALCULATED）: 曲柄中心 `(190, 0, 240)`、`r = 38.35`、连杆 `L = 90`、偏置 `DX = 10`；扫角 `20° -> 160°`（两端各离死点 20°，不自锁）。实测关闭挡舌中心 **67.482**（下端 **40.0**）/ 打开 **139.557**（下端 112.1）/ 行程 **72.074 mm**；销 z 116.982 -> 189.057。
- 几何（MEASURED，`cad/output/_r49_gate/parts_pollen.json`）: 挡舌 `5 x 108 x 55`、x 177.5..182.5、y ±54、vol 27432（下端双面 12 mm 倒角 `CHISEL_H=12 / CHISEL_FLAT=1.5` 保留）；支架 **vol 56352 -> 44704 mm³**；立柱/横梁两实体 bbox `x 175..204, y 34..62, z 13.29..198`（对称两件）；Y 向分层 舵机 −22.05..17.95 / 曲柄板 17.95..22.95 / 轮毂凸台 r15 17.95..26 / 连杆 22.95..26.95 / **侧梁 34..62**。
- 干涉复检（MEASURED）: `frame x bracket` / `frame x blade` / `frame x rod` 在 2 姿态共 **56 组布尔求交全部 0 mm³**。
- 回归（SIMULATED，`simulation/mujoco/run_R47_xml.py`，`--gate-dn 67.5 --gate-up 139.5 --gate-ramp 0.15`）: 4 x POLLEN `gap064` 6 相位 0/30/60/90/120/150 ⇒ **每相位 4/4 真出膛 = 24/24，全清 6/6**，出膛 **6.28–6.44 m/s**，清空 11.08 / 11.09 / 11.09 / 11.09 / 11.14 / 12.79 s（含静置 6 s）；4 x NECTAR `gap082` ph0 **4/4（5.22–5.29 m/s、11.46 s）**；混装 `--pair` ph0 **4/4（6.43 / 5.27 / 6.43 / 5.22 m/s、自动换档 3 次、11.66 s）**。日志 `simulation/mujoco/out/_r49_reg.log` / `_r49_reg2.log`。
- ramp 敏感性（SIMULATED）: 0.10 / 0.15 / 0.25 / 0.70 s 均 24/24；**0.20 与 0.40 s 出现球 3 / 球 4 逸出**（非单调）⇒ 判为数值/接触敏感性，**按 0.15 s 验收**。0.20 s 的机理是闸门关闭瞬间挡舌接触 ball_3，Fz 峰值 −960 N —— mocap 无限刚度下的数值尖峰，**不是设计载荷**（真实上限 27.6 N）。挡舌下端的 12 mm 倒角即为抗此种卡楔。
- 命名（KNOWN）: 生成器由 `_r48.py` / `_r48_view.py` 改名为 `cad/paddle_launcher_gate_drive_r49.py` / `..._r49_view.py`，因为 **DEC-0046 已占用 "R48 = 运动部分几何核对轮"**。
- 交付（KNOWN / MEASURED）: 桌面 `T06_gate_drive_R49_pollen.step`（Fusion 可开，含 R37 父模块 16 件 + 闸门驱动 11 件 + 4 颗 pollen 球 + R39 内衬）；仓库副本 `cad/output/_r49_gate/`（STEP local-only，`.gitignore` 已加规则），视图 `cad/output/_r49_gate/r49_gate_drive_view.png`。**导出已落盘**（420.2 s，187,367,519 B）；回读复核 27 件、`gate_frame` vol 44704.0 mm³ / bbox `x 175..204, y ±62, z 13.285..198`、`gate_blade` z 39.982..94.982（下端 40.0）、舵机 `2000-0025-0003`，与 `parts_pollen.json` 一致（`pass`）。桌面旧件 `T06_gate_drive_R48_pollen.step` 改名 `..._SUPERSEDED.step` 保留历史。
- 同步（KNOWN）: GitHub `main` 提交 `646df70`「T06 R49 闸门驱动（DEC-0047 / V-0047）」（14 files / +7517；`MUJOCO_LOG.TXT` 与根目录 `_*` 临时件未入库）；Linear KEI-21（T06.10）→ Done；Notion 决策页已追加 R49 段落与收尾记录。
- Superseded（KNOWN）: DEC-0043 的 **92 mm 行程**（中心 47.5 / 下端 20）与 **25-2 舵机**口径被本条取代；R47 交付的顶梁外形同样被本轮收边取代。历史保留不删除。
- 对 DEC-0046 / V-0046 未落地项的影响（KNOWN）: **F2「CAD 中无挡舌零件」已关闭** —— 闸门驱动现在是可交付的独立模块（`T06_gate_drive_R49_pollen.step`），只是尚未并入 R37 运动部分基线装配；**F1**（托板右端 CAD 215 vs 仿真 460）与 **F3**（贴带区 135°→258° 未落 CAD）**仍在**；F4 已由 `config/parameters.yaml → t06_gate_drive_r49` 补上闸门驱动的参数条目。
- 未关闭（TBD）: 横梁收边后 **zip-tie 绑扎路径**与 25-3 出线方向未实机验证；挡舌下端 40.0 只比 pollen 球心低 15 mm，**若实机球在托板上被抬起 > 15 mm 会失守**（仿真内未见）；`μ = 0.30` 贴带仍为 `ASSUMED`；桌面副本不受 Git 管理；未实机。

### 0.4（2026-10-12 起）R49 闸门驱动的收尾项

- 已完成: 舵机换 25-3、行程 92 -> 72.074 mm、支架横梁收边到与绿腿齐平；新行程 6 相位 x 4 颗 24/24 真出膛、6/6 全清，NECTAR 4/4、混装 4/4（DEC-0047 / V-0047）；桌面 STEP 已导出并回读复核通过；`config/parameters.yaml` / `docs/decision_log.md` / 本文件已同步；GitHub `646df70` 已推送，Linear KEI-21 Done，Notion 已更新。
- 待办（TBD，按优先序）: (i) 实机验证挡舌下端 **40.0** 处的拦球裕度（只比 pollen 球心 55.1 低 15 mm）；(ii) 横梁收边后 **zip-tie 绑扎路径**与 25-3 出线方向；(iii) 闸门控制律仍属台架口径（停稳 + 0.10 s 抬起），实机需按 25-3 位置模式的行程时间 0.16 s 重定时；(iv) 若托板件改版，需同步 `LEG_Y 34..42` 与收边后的侧梁 34..62。

## T06 R50 发射部分驱动化 + 支撑结构（2026-10-13，DEC-0048 / V-0048）

- 触发（KNOWN）: 用户指令「给飞轮加上马达，给拨杆加上舵机（两者已经确定型号，注意查找），同时给整个发射部分加上支撑结构……尽可能使用简洁快速方案」。
- 决策（KNOWN）: 在 R37 运动件与 R49 闸门之上补齐驱动链与承载框架；R37 / R47 / R49 生成器与产物**一律只读复用、不覆盖**，新产物写入 `cad/output/_r50_drive/`，生成器 `cad/paddle_launcher_shooter_drive_r50.py`、视图 `cad/paddle_launcher_shooter_drive_r50_view.py`。型号沿用既有口径（飞轮马达链 C06B-COTS-0.1 / DEC-0021；拨杆舵机 DEC-0026 `index_drive_servo`）：飞轮 x2 `5203-2402-0003` + `1401-0043-0036` + `4007-4008-4008`（−Y 侧）；拨杆 x1 `2000-0025-0004`（25-4 Super Speed，0.530 N·m / 290 rpm）+ `1802-0043-0001` + `4001-0025-4008`（+Y 侧）；支撑 = 双侧 6 mm 面板（三个轴心 R34 凸台 + 44 mm 连杆轮廓 + 三条腿）+ 3 根横梁 + 4 个 Ø4.6 底盘安装孔；轴承 `1611-0514-4008` 由 4 增至 6。
- 几何（MEASURED，`cad/output/_r50_drive/parts_pollen.json`，51 件）: 轴心 上 (−11.368, 285.259)、下 (115.975, 185.769)、拨杆 (29.490, 111.460)；Y 堆叠 马达体 −219.17…−112.00（轴尖 −88.0）/ 夹具 −120…−112 / 马达桥 −112…−68 / 联轴器 −96.5…−75.5 / 面板 −71…−65 与 79…85 / 飞轮轴 −84…84 / 拨杆轴 −96…96 / 舵机联轴器 88.0…105.0 / 舵机支架 96…102 / 舵机体 101.5…145.6；面板各 189479.7 mm³（bbox x −45.37…149.97、z −18.0…332.0）；打印件合计 815311.2 mm³ ≈ 1035 g（PETG 1.27 g/cm³ 为 ASSUMED）。
- 干涉（MEASURED）: 7 处非零**全部是轴 / 轴承 / 联轴器的正常径向配合**（联轴器 × 飞轮轴 25.308 ×2、轴承 × 轴 5.883 / 6.725 ×4、舵机联轴器 × 拨杆轴 21.739）；`servo_coupler` × 舵机支架 / 伺服横梁 ±28 / 两侧面板**全 0**；舵机联轴器 × 舵机 3.182（25T 花键齿顶轻咬，判为可接受）。
- 修掉的隐患（KNOWN）: 舵机联轴器原用 `Shape.mirror("XZ")` 定姿态 —— 那是绕**世界** XZ 平面镜像，把件搬到 y −105…−88（马达侧）、与舵机完全不接（旧姿态 `servo_coupler × servo = 0`、`× paddle_shaft = 119.232`，纯属错误穿模）；改为「平移到原点 → 绕自身 X 直径翻转 180° → 平移回位」后落在 y 88.0…105.0。**R50 之前的 JSON / STEP 带这个错，本轮已重刷。**
- 交付与回读（MEASURED）: 桌面 + 仓库 `T06_shooter_drive_R50_pollen.step`（363 MB / 51 件，local-only 已加 `.gitignore`）；`cad/_r50_readback.py` 回读**桌面交付件**：407.6 s 加载、51 children 与生成器同名同数、逐件体积 / 包围盒 **0 处漂移**、总体积 2077828.0 vs 2077829.4 mm³（相对偏差 6.5e-07），全程 686.8 s ⇒ `pass`；报告 `cad/output/_r50_drive/delivery_readback.json`；三视图 `r50_shooter_drive_view.png`。
- 文档同步（KNOWN）: `config/parameters.yaml → t06_shooter_drive_r50`（17 键）；`docs/decision_log.md` DEC-0048 / V-0048；`docs/engineering/t06-motion-part-geometry-baseline.md` §7（R50 轴向堆叠 / 轴心 / 支撑框架）；`references/vendor/gobilda/t06/step/2000-0025-0004/`（新下载官方 STEP + SHA256 登记）。
- 未关闭（TBD）: 打印件 ≈1035 g 偏重；`2000-0025-0004` 工作模式（位置 vs 连续旋转）；DEC-0037 调隙链的整机落位；结构强度 / 振动未验；未实机；−Y 侧马达外伸到 y = −219.17 需与底盘 / 立柱复核；舵机联轴器与舵机壳面仅 0.6 mm 裕度。

### 0.5（2026-10-13 起）R50 发射部分驱动化的收尾项

- 已完成: 三条链（飞轮马达 ×2 / 拨杆舵机 ×1 / 双侧面板 + 三横梁）落 CAD；舵机联轴器世界镜像隐患修正；干涉复检 7 处非零全部判定为正常径向配合；桌面 + 仓库 STEP 导出并回读复核 `pass`；`config/parameters.yaml` / `docs/decision_log.md` / `docs/engineering/t06-motion-part-geometry-baseline.md` / 本文件已同步；Linear KEI-22、Notion 已更新。
- 待办（TBD，按优先序）: (i) 打印件减重（横梁 391.0 cm³ + 面板 379.0 cm³ 仍有挖空余量）；(ii) 裁定 `2000-0025-0004` 是否切连续旋转（决定拨杆能否按 DEC-0037 的两档刚性定位工作）；(iii) DEC-0037 调隙链在 +Y 工位的整机落位（该工位现归拨杆舵机）；(iv) KEI-15 静态 FEA 收口支撑框架；(v) Notion 中 R36–R49 的记录缺口是否回填（本工作区 Docs 库最新文档创建于 2026-10-05，R47 / R49 关键词检索无命中）。
## T06 R51 / R52 发射部分换基线：滑窗独立轴底座 + 送球件换装（2026-10-13，DEC-0049 / V-0049 / DEC-0050 / V-0050）

- 触发（KNOWN）: 用户指令「两个飞轮不能连在一起，这样没法调间隙。你应该使用在『只保留运动部分』之前最新一版的 CAD 做基础来进行改动。先把那一版 CAD 找出来截张侧视图给我」。
- 基线判定（KNOWN）: `cad/output/paddle_launcher_feasible_pollen.step`（2026-10-01 22:36，414.3 MB，**98 件**）= 「只保留运动部分」（`paddle_launcher_motion_only.py --profile motion_free`）的父装配。证据：`cad/output/_r51_base/manifest.json`（`cq.Assembly.load` 直接回读该 STEP，逐件体积 / 包围盒 / 三角数）；侧视图 `cad/output/_r51_base/r51_base_side_view.png` -> 桌面 `T06_基线_2026-10-01_侧视图.png`。
- 基线为什么能用（KNOWN）: 该版本来就是「两轴各自独立 + 调隙链」拓扑 —— 每根飞轮轴坐在自己的滑动轴承滑座上，由 DEC-0037 调隙链定位；**没有任何刚性件跨接两轴**（bbox 同时压到上下两滑座的只有 `shooter_side_plate_±1`，布尔体积 0）。
- R51 改动（KNOWN）: ①拨杆舵机 `2000-0025-0003` -> `2000-0025-0004`；②侧板开口 `8.4 x 9` 轴槽 -> **`59 x 56` 滑窗**（窗 n 跨 56.5..112.5，导轨侧隙 0.5 mm）。产物 `cad/output/_r51_drive/`：98 件 / 434.4 MB x2 变体。
- 开口覆盖（CALCULATED）: pollen 滑座 n 跨 61.0..99.0、nectar 72.0..110.0，两档都在窗内；半间距行程 80.0..91.2 ⇒ **夹口 64.0..86.4 mm**，正好覆盖 NECTAR 已接受的 86 mm（老轴槽只到 82）。
- 轴隔离（MEASURED，核心判据）: `rigid_link_between_axles = []`；bbox 候选只有 `shooter_side_plate_-1`，布尔对上下滑座 0.0 / 0.0 mm³；`carriages_touch_each_other = false`、`shafts_touch_each_other = false`；侧板专项 15 组布尔两档全 0（`plate_booleans_r51.json`）。
- R52 换装（MEASURED）: R51 底座 + R37 送球件 6 件（**世界坐标不动**）+ R49 闸门 9 件（`gate_frame` 对托板让位 530.017 mm³）；新增 `servo_bridge_±26`、`feeder_mount_±1`（x -80..168、y 53.5..63、z 16..30）、两侧板 `O14.1` 拨杆轴承座。90 件，STEP 444.6 / 444.7 MB。
- R52 几何（MEASURED）: 拨杆轴 `[29.49, 111.46]`（与 R37 一致）、上轴 `[-10.737, 284.767]`、下轴 `[115.345, 186.261]`、轴距 160.0；叶尖 r 59.908，叶尖到下轮面 pollen 5.961 / nectar 8.55 mm，到上轮面 70.006 mm；夹口 pollen 64.0 / nectar 86.0。
- R52 干涉与回读（MEASURED）: `imported_vs_base` 0、`gate_vs_feeder` 0、`new_vs_rest` 5 处**全为正常配合**（`feeder_mount ±1 x tray` 81.651 x2、`paddle_bearing_-1 x 侧板` 10.285、`paddle_servo_coupler x paddle_shaft` 21.739、`servo_bridge_-26 x gap_servo_frame` 1.372）；回读各 **282 solids**、体积偏差 **-0.0001 %**、包围盒 6 面偏差 **0.00 mm**，`bbox = [-170.0, -219.17, -3.51, 232.0, 145.6, 401.02]`。
- 判为 SUPERSEDED 的旧版（KNOWN）: **R50**（`cad/paddle_launcher_shooter_drive_r50.py`）—— `shooter_frame_neg/pos`（三凸台面板）+ `shooter_rail_1/2/3` 把两根飞轮轴刚性连成一体，夹口锁死；其驱动链型号 / 轴向堆叠结论仍被 R52 沿用。桌面 `T06_shooter_drive_R50_pollen.step` 按规则保留不删。
- 交付（KNOWN）: 桌面 `T06_R52_装配图_pollen.png` / `T06_R52_装配图_nectar.png`、`T06_shooter_assembly_R52_pollen.step` / `_nectar.step`、`T06_基线_2026-10-01_侧视图.png`；仓库 `cad/output/_r51_base/`、`cad/output/_r51_drive/`、`cad/output/_r52_drive/`。
- 文档同步（KNOWN）: `config/parameters.yaml -> t06_shooter_drive_r51` / `t06_shooter_drive_r52`（并给 `t06_shooter_drive_r50` 加 `superseded_by`）；`docs/decision_log.md` DEC-0049 / V-0049 / DEC-0050 / V-0050 与 DEC-0048 的 SUPERSEDED 补记；`docs/engineering/t06-motion-part-geometry-baseline.md` §8 / §9。
- 未关闭（TBD）: ①滑座在滑窗内只靠导轨定位，**缺锁紧 / 微调件**（「能滑」但没保证「滑到位置不自走」）；②`feeder_mount ±1` 与托板只 0.5 mm 咬合，强度未验；③R52 生成器的 `axle_isolation` 把侧板放进 skip 列表 ⇒ 侧板证据靠 R51 的 15 组布尔 + 新增的 STEP 级复核 `cad/_r52_axle_isolation_step.py`；④拨杆舵机工作模式（位置 vs 连续旋转）仍未裁定；⑤打印件质量未统计；⑥未实机；⑦结构强度 / 振动未验。

## T06 R53b / R53c / R53d 滑座常闭弹簧夹 + 调隙链自动换档复核（2026-10-13，DEC-0051 / V-0051 / V-0052 / V-0053）

- 触发（KNOWN）: 用户 2026-10-13 指令「停，在比赛中人不能介入去动结构，我希望该结构可以利用已有舵机自动调节」⇒ R53 的**蝶形螺母手动锁位作废**；同日再明确「保留调隙舵机 + 加锁紧件，锁紧件不能影响正常位置改变」。
- R53b 结构（KNOWN）: 保留 R52 全部尺寸，只换紧固件栈 = **M4 螺柱 + 压缩弹簧（Ø5.5 / 自由 8.4 / 装好 6.0，k = 1.24 N/mm ⇒ 3 N/颗）+ 平垫 + M4 尼龙锁紧螺母**，侧板锁紧长槽 **u = ±36 x n = ±(63.5..107.5) 共 4 条**（第一版只开 +n 一侧会让另一侧 8 颗螺柱穿透 4 mm 实心侧板，50.265 mm³/处，已修）。弹簧常压 ⇒ 断电也锁（fail-safe）；预载小 ⇒ 已有 25-2 照旧推得动。两档各 114 件，`lock_vs_rest = []`、`lock_vs_carriage = []`、`axle_isolation_hits = []`、耳板间隙 0.3 mm、长槽余量 4.5 mm。
- V-0052 静力全行程（CALCULATED）: 半间距 80.0..91.2 扫 225 点，`T_req = 2 f |dh/dtheta|`。最不利 **POLLEN 端 h = 80.05：0.317（mu = 0.30）/ 0.634（mu = 0.60）N.m** = 堵转 12.8 % / 25.6 %，余量 7.8x / 3.9x；杆件最大主连杆 39.6 N（屈曲上限 134 N 的 29.6 %）。顺带修正两处口径（旧的 `d(u)/d(theta)` 式隐含 u 从曲柄中心起算；V-0051 的「112 N 预算」是降额口径）。
- V-0053 动力学 50 次来回（CALCULATED）: 换档 **0.325..0.358 s（均 0.338 s）**、**0 次堵转 / 0 次超时**、到位误差 **≤ 0.133 mm**（用户口径 1 mm）、首末次之差 **-0.009 mm（不累积）**；链条等效刚度 pollen 332.9 / nectar 258.9 N/mm。
- 交付（KNOWN）: 桌面 `T06_shooter_assembly_R53b_pollen.step` / `_nectar.step`（各 446 MB）、`T06_R53b_自动锁紧方案.png`、`T06_R53b_夹紧剖面.png`、`T06_R53c_fullstroke_check.png`、`T06_R53d_dynamic_check.png`；仓库 `cad/output/_r53b_auto/`（junction 到桌面）、`cad/output/_r53c_stroke/`、`cad/output/_r53d_dyn/`。
- 未关闭（TBD）: ①**端点无机械硬限位**（最大档距死点 0.337 mm）⇒ 必须在舵机编程器 + 固件卡住约 **19.3 .. 96.7 deg**；②弹簧 k / 预载、PET mu、E、J、Kp 全为 ASSUMED，实物未测；③实机未验（50 次来回后预载是否衰减）；④**已答（KNOWN，用户 2026-10-13）**：换档**需要比赛中在线进行**，见 0.6 节 V-0054（0.354 s/次、12 次/场、占空比 3.6 %、全程无人介入）；⑤是否要加凸轮做主动解锁：**不需要**（换档与保持都由已有 `2000-0025-0002` 完成，见 V-0054）。

## 工作根路径（2026-10-13 起生效，2026-10-14 联接已生效）

- Canonical 工作根路径：`C:\FTC design\FTC 2026 biobuzz`（`KNOWN`，用户指令 2026-10-13）。
- 迁移方式：robocopy 全量复制，排除 `__pycache__` / `.pytest_cache`；核对结果：仓库 **14311 个文件 / 18.4136 GB** 与源逐字节一致。
- 桌面交付件收敛在 `deliverables\`：**48 个文件 / 5.651 GB**（T06 R51–R53f 装配 STEP、审查图、COTS BOM、R47 MuJoCo XML/结果、a' 供料几何），默认不纳入 Git。
- `C:\Users\admin\OneDrive\文档\ChatGPT\FTC 2026 biobuzz`：**2026-10-14 已改为目录联接**（`Junction` -> Canonical，建立脚本 `C:\FTC design\link_old_path.ps1` / `.cmd`，日志 `link_old_path.log`）。
  - 实测（`MEASURED` 2026-10-14）：经旧路径读 `AGENTS.md` 6970 B、`git log` = `9881e8b`、`git status` 与 origin 同步；写入测试文件立即出现在 Canonical 路径（确认为真联接而非副本），随后已清理。
  - 待观察风险：OneDrive 仍在运行，可能删除该 reparse point（尚未建立监控）；被删后重运脚本即可。
  - 待办：本机 18 GB gitignored CAD 输出目前**无云端备份**，需为 `C:\FTC design` 安排独立备份。
- Python 解释器：`.venv-cad\Scripts\python.exe`，经新路径验证 `sys.prefix` 与 `import cadquery` 正常。
