wang15143089/FTC-2026-Bio-buzz/cad/CONSTRAINED_PADDLE_LAUNCHER_README.md

# 尺寸约束版：连续拨杆 + 对置飞轮发射机构

## 坐标与总成

- X–Y 平面为底盘安装平面，+Z 向上。
- 发射中心线相对底盘为 52°。
- 13 个已选 goBILDA SKU 的官方 STEP 已下载并登记哈希；工作装配按用户指示把每个采购 SKU 当作整个官方部件（DEC-0021），外形与关键接口尺寸来自官方 CAD，供应商按真实间隙分开的子实体保持分开。
- 原始多实体 STEP 保存在 `references/vendor/gobilda/t06/step/`，不在主装配中展开电机、舵机等采购件的内部子零件。
- 模型不包含 POLLEN 或 NECTAR 实体。

## 主尺寸（mm）

| 项目 | 数值 |
|---|---:|
| 通道净宽 × 净高 | 108 × 110 |
| 三段导槽角度 | 0° / 26° / 52° |
| 三段导槽长度 | 70 / 55 / 70 |
| 拨片数量 | 3 |
| 拨片宽度 | 96 |
| 拨片单侧间隙 | 6 |
| 拨杆扫掠半径 | 60 |
| 飞轮 | 4 × Gecko 96 × 24 |
| 同轴两轮轴向间隙 | 6 |
| 同轴轮组总宽 | 54 |
| 侧板内距 | 140 |
| 轮组轴向余量 | 86 |
| POLLEN 轴中心距 / 名义轮间隙 | 160 / 64 |
| NECTAR 轴中心距 / 名义轮间隙 | 178 / 82 |
| 单轴槽中心行程 | 9 |
| 8.4 mm 轴槽外形总长 | 17.4 |
| 主对称连杆长度 | 2 × 110 |
| 舵机曲柄 / 驱动杆 | 12 / 65 |

名义轮间隙按“上下轴中心距 − 96 mm”计算。实际压缩量应通过样件硬度、轮速和目标出射速度实测后微调；当前模型提供 9 mm/轴的连续调节行程。

## 飞轮间距调节机构

运动链为：舵机 12 mm 曲柄 → 65 mm 定长驱动杆 → 水平导向滑块 → 两根 110 mm 等长连杆 → 轴承座耳轴 → 上下飞轮轴。上下轴的两端均安装在开槽侧板外侧的滑动轴承座中，主动侧轴承座与连杆耳轴刚性连接；两只 goBILDA `1401-0043-0036` 电机夹具也固定在对应移动轴承座上，因此调节过程中 `5203-2402-0003` 电机轴线不会与飞轮轴错位。

飞轮轴各自由一台 1620 rpm 电机通过 `4007-4008-4008` 8 mm REX 联轴器直驱，机构不使用外置齿轮。完整 COTS 映射、被淘汰占位件和官方来源见 `docs/engineering/t06-opposed-flywheel-cots-audit.md`；主参数见 `config/t06_launcher_cots.json`。

POLLEN 与 NECTAR 两个极限位置分别对舵机曲柄角、滑块位置和轴承座位置进行求解，不再采用悬空连杆示意。

## 送球逻辑

连续旋转舵机直接驱动三拨片转子。每转理论输送 3 件；25–40 rpm 对应 1.25–2.0 件/s。拨片由刚性臂、可更换横向叶片和柔性端条组成，后方两片单向柔性指抑制回滚。该方案不使用传送带。

## 输出

- `paddle_launcher_feasible_pollen.*`：POLLEN 间隙配置。
- `paddle_launcher_feasible_nectar.*`：NECTAR 间隙配置。
- `output/parts/`：开槽发射侧板、拨片、Sonic/Gecko 轮毂和送料侧板参考件。
- `paddle_launcher_feasibility_report.json/.md`：精确尺寸、运动学位置及实体干涉校核结果。
- `references/vendor/gobilda/t06/manifest.json`：官方压缩包与 STEP 的 SHA-256、实体数及回读包络。

所有数值仍属于初步工程原型。官方 STEP 已完成包络回读，但加工前仍须用实物复核轴向堆叠、卡簧、垫片、螺钉长度、花键/REX 配合和打印公差；整体部件工作模型不替代制造图。
