wang15143089/FTC-2026-Bio-buzz/docs/t04_intake_side_sweep_trade.md

# T04 FLOWER 侧拨补充机构可行性与方案比较

版本：T04-INTAKE-CMP-0.3；日期：2026-09-20；成熟度：M3可打印验证件，L4名义STEP扫掠完成、L6待办。本文比较用户提出的侧拨方案与既有C04-A，不是最终制造设计。

## 用户意图复述

`C04-B` 不用拨杆完成一般地面获取。标准顺从roller继续作为主intake；仅在FLOWER模式下，独立拨杆把最下方POLLEN横向送入偏置球道，再由导板/roller接管。草图中的“球通道1”是普通地面intake通道，“球通道2”是FLOWER侧拨补充通道。

## 规则边界先于机械评分

- `KNOWN` G418要求得分物体只能从FLOWER顶部进入；只能从FLOWER底部移除POLLEN。规则给出的违规示例明确包含“从FLOWER侧面拉出POLLEN”。
- 因此把概念拆为两个不同候选：
  - `C04-B1`：拨杆在底部Retrieval Opening内部横向作用，POLLEN的完整离开路径仍穿过底部开口，之后才向侧面汇入roller。它没有被规则文字直接排除，但最终合法性取决于L3扫掠路径。
  - `C04-B2`：POLLEN穿过FLOWER侧管之间或侧壁边界离开。它与G418示例相符，**不进入设计**。
- “球的速度有横向分量”与“从FLOWER侧面移除”不是同一件事；判定基准是球穿越哪一个场地边界，而不是拨杆运动方向。

## C04-B1机械定义

1. 机器人以浅V形护唇对准底部Retrieval Opening；护唇不夹持FLOWER。
2. 一个圆角、无槽、带串联弹簧的拨片从底部开口前缘进入。
3. 拨片工作面向上倾斜20–30°，在横向扫动时同时给POLLEN向外/向上的速度分量，使其越过底环唇口。
4. 球离开FLOWER底部边界后进入偏置漏斗；漏斗把球导向标准roller。roller不伸入FLOWER，也不承担把球从座中解锁的任务。
5. 一自由度圆弧/凸轮优先：单舵机同时完成“进入安全高度—侧扫—退出”。若L3证明无法在一个无碰撞路径中完成，才允许第二舵机把部署与侧扫分离。

两个球道必须在roller上游合并，不能形成两个受控库存位置；容量达到4时，拨杆和roller均禁止获取。

## 名义几何证明与边界

输入来自TU01近似尺寸：POLLEN直径71 mm、Retrieval Opening高度90 mm、底环厚度13 mm，底环内径约71 mm。

### 1. 不能依赖纯水平推力

`CALCULATED_NOMINAL` 底环内径与POLLEN名义直径相等，名义直径间隙为0 mm。即使真实软球能变形，也不能把“平推就会滑出”当作可靠设计依据；拨片必须产生抬升分量或利用经验证的弹性变形。

把底环唇口暂建模为高度 `h=13 mm` 的刚性台阶、球半径 `R=35.5 mm`。球心上升13 mm所需的理想水平几何行程为：

`x = sqrt(2Rh - h²) = 27.46 mm`

初始准静态、无摩擦、水平推球心的力矩平衡给出：

`F_horizontal / W = x / (R-h) = 1.22`

这不是实际取球力：球质量、摩擦、软球压缩、上方三球载荷及真实环截面均为`TBD`。它只严格证明两点：13 mm唇口在运动学上可被小于40 mm的侧扫跨越；完全水平且没有抬升几何的拨杆会把可靠性押在未知摩擦/变形上。

### 2. 倾斜工作面与行程

若拨片工作面把侧扫转化为斜向运动，抬升13 mm所需的理想路径为：

| 工作面角度 | 理想路径 | 对40 mm最小侧扫的判断 |
|---:|---:|---|
| 20° | 38.01 mm | 名义可达，余量只有1.99 mm |
| 25° | 30.76 mm | 名义可达 |
| 30° | 26.00 mm | 名义可达，但竖向力和挤压敏感度更高 |

首轮分析采用20/25/30°可换拨片和40/55/70 mm行程；这些仍是原型水平，不是制造尺寸。随后已使用SRC-016独立官方FLOWER STEP关闭名义几何，结果见下节。

### 3. 官方STEP扫掠结果

`MEASURED_FROM_CAD`：独立模型含34个实体，总包络169.380 × 156.559 × 595.211 mm；底环顶面至上球托底面的Retrieval Opening净高为90.170 mm。Ø71 mm球抬升13 mm后，对上球托仍有6.120 mm名义竖向间隙。

严格实体布尔扫描纠正了原始“纯侧向直线”假设：

- `REJECTED_GEOMETRY`：沿模型 `−X` 的纯横向路径对左后短支柱的解析净空为 **−5.437 mm**；5 mm步长实体扫描最大交叠 **590.763 mm³**，峰值位于约35 mm行程。增加抬升角不能消除平面支柱干涉。
- `SIMULATED_NOMINAL/PASS`：把路径从 `−X` 朝合法开口前方 `−Y` 偏转25°，仍保留90.6%的侧向分量。球对支柱解析名义净空为 **3.680 mm**；Ø71 mm完整刚性球在0–120 mm、5 mm步长扫描中最大交叠为0。
- `SIMULATED_NOMINAL/PASS`：3 × 20 × 32 mm圆角拨片在0–60 mm动力行程内最大交叠为0；Ø60 × 120 mm标准roller位于路径距离116 mm、中心高50 mm时与FLOWER最大交叠为0。

3.680 mm只是CAD名义余量，尚未包含场地公差、球非圆度、变形和机器人对位误差。因此25°是M3初模中心值，不是已冻结制造角度；L6必须保留横向浮动或柔顺。

### 4. 执行器与资源

- `CALCULATED_FROM_ASSUMED_LOAD`：按10 N原型接触上限、70 mm等效力臂和2.0结构安全系数，拨杆/舵机输出端校核力矩为1.40 N·m。
- `CALCULATED_FROM_ASSUMED_MOTION`：40 mm在0.35 s完成时平均拨片速度为0.114 m/s；这不是实测周期。
- `CALCULATED`：C04-B1不增加直流电机。标准roller继续使用T04/T05共享的1个电机；名义增加1个舵机，必要时最多2个。因此整机仍为7个电机并保留1个端口。

用户提供的目标舵机已由REV官方规格和CAD交叉核验为`REV-41-3336 Smart Robot Servo V2 - UltraSpeed`：6 V时0.043 s/60°、5.6 kg·cm、2.9 A堵转；7.4 V时0.035 s/60°、6.2 kg·cm、3.7 A堵转；质量60 g；默认270°、可编程最大280°、500–2500 µs、25T、中心M3×0.5且最大6 mm深。6 V仍为设计电压。

- `CALCULATED`：6 V堵转力矩0.549 N·m，7.4 V为0.608 N·m；直接驱动均低于1.40 N·m结构校核值。
- `CALCULATED_FROM_ASSUMPTIONS`：若采用70 mm圆弧拨杆，6 V最低减速比为3.187:1；60 mm端点弦长需要输出转角50.754°和舵机转角162.412°。该圆弧相对已验证直线产生6.754 mm弓高，故3.2:1只保留为回退。
- `CALCULATED`：把舵机改作17 mm节圆半径单层卷线鼓，60 mm直线行程需要202.220°；居中使用默认270°时指令端点约751/2249 µs，两端各保留33.89°角度余量。6 V无负载时间下界0.145 s，实测指令仍限0.25–0.40 s。
- `CALCULATED_FROM_ASSUMPTIONS`：卷线鼓的角度下界要求半径≥12.73 mm；10 N外载+1.5 N回位载荷、80%效率、50%堵转运动边界要求半径≤19.10 mm。所选17 mm位于可行区间；预计运动边界绳张力12.92 N，扣除回位载荷后外载能力11.42 N。全堵转仅用于短时结构边界，扣除回位载荷后为24.34 N，高于20 N结构目标。
- `TBD`：2.9 A堵转电流不可作为正常工作点；REV Hub舵机电源瞬态能力、线束压降、绳滑移、单层卷绕半径变化和实物取出力仍须L6核验。7.4 V未被默认批准。

### 5. 可打印验证件

`T04-C04B1-M3-0.3`包含三个参数化零件：190 × 85 × 41 mm官方孔位舵机支架/开式导轨、Ø38 × 8 mm卷线鼓、41 × 26 × 19 mm的25°楔形滑块。支架直接采用REV-41-3336官方STEP测得的4×Ø4.5孔位；安装塔在官方舵机耳与REV-41-1828铝舵盘之间分别保留约0.05/0.10 mm名义轴向余量，安装孔径另加0.30 mm原型径向间隙。卷线鼓不打印25T花键，而通过16 mm节圆上的6个M3通孔连接官方铝舵盘。

Fusion 360装配STEP包含5个命名组件：打印支架、REV-41-3336官方舵机、REV-41-1828官方铝舵盘、打印卷线鼓和单个起始位置拨片。CadQuery回读为5个有效实体、190 × 85 × 45 mm总包络；非配合件两两实体交叠均为0。STEP产品/装配名称已检查，不是把所有零件熔合成单实体。

`VALIDATED_GEOMETRY`：三个STEP均回读为单一有效实体；三个STL的边界边/非流形边均为0。该结论只表示文件拓扑可用，不表示任何打印工艺、材料强度、舵盘螺钉长度或FLOWER实体试验已经通过。

## 与C04-A比较

规则符合性采用硬门槛，不用加权分抵消；其余评分为1–5的`ASSUMED_EVIDENCE_RATING`，只用于决定先做哪个低成本原型。

| 准则 | 权重 | C04-A 上方伸入后回拉 | C04-B1 底部开口内侧拨 | 证据与含义 |
|---|---:|---:|---:|---|
| G418路径门槛 | 必须通过 | 条件通过 | 条件通过 | A/B1均须L3证明全程经底部开口；B2直接失败 |
| 当前几何证据 | 25% | 4 | 4 | A有名义开口计算；B1新增哈希锁定官方STEP完整球/拨片/roller扫掠，但两者实物仍待测 |
| 执行器/资源 | 15% | 3 | 5 | A名义2舵机；B1可用1舵机，均为0新增电机 |
| 与普通intake解耦 | 15% | 2 | 5 | A让roller参与解锁；B1在出球后才由roller接管 |
| 卡球恢复 | 15% | 4 | 3 | A可收钩反转；B1可能把球楔在环唇/侧管间 |
| 动作/周期简洁度 | 10% | 2 | 4 | A伸入—落钩—回拉；B1为单次扫动 |
| 场地/球差容忍 | 10% | 3 | 2 | B1对横向空间、环唇和侧向摩擦更敏感 |
| 制造调试复杂度 | 10% | 2 | 4 | B1若保持一自由度，零件与标定更少 |
| 加权证据分 | 100% | 3.05/5 | 3.95/5 | 不是性能测量；任一规则/扫掠门槛失败即无效 |

## 严格结论

1. `REJECTED`：草图若解释为纯 `−X` 横移，因短支柱干涉而不可用。
2. `SIMULATED_NOMINAL/PASS`：25°斜向侧拨的球、拨片和标准roller通过官方STEP名义扫掠，因此允许进入M3初步建模。
3. `NOT PHYSICALLY VALIDATED`：3.680 mm最小名义支柱余量不足以覆盖未知场地/球差；四球堆载、摩擦、软球变形、实际取出力、对位误差和断电退出仍须L6验证。不得据此发布制造图。
4. `REJECTED_RULE`：任何让POLLEN穿过FLOWER上部侧管区域离开的B2路径均不接受。
5. `PROVISIONAL SELECTION`：C04-B1 25°斜向侧拨继续作为首个L6原型；C04-A保留并行回退。只有B1通过实体夹具门槛后，才能取代C04-A成为制造基线。

## 验证关口

### VAL-T04-004：L3底部边界与扫掠

- `完成/名义`：SRC-016哈希锁定；自动识别底环、上球托和两根短支柱；完成纯横向与25°斜向完整球体对照。
- `完成/名义`：25°路径球、拨片、roller实体交叠为0；纯横向方案失败并留存证据。
- `待办`：用实体FLOWER/POLLEN和机器人对位分布验证3.680 mm名义余量；名义STEP结果不转写为实测。

### VAL-T04-005：L6同夹具随机对照

- C04-A与C04-B1使用同一FLOWER夹具、同一批至少5个POLLEN和相同机器人对位分布。
- B1先做3×3角度/行程筛选，每格20次；收敛后A/B1各完成100次四球连续取出，顺序随机化。
- 记录每球成功、周期、峰值舵机电流或等效力、场地接触、卡死、自动恢复、球损伤和是否误入侧边界。
- B1替代A的最低门槛：无规则危险接触；无不可恢复卡死；成功率95%置信区间下界不低于预先批准阈值；中位周期不劣于A；且使用不多于1个专用舵机。阈值在试验前冻结，不能看结果后修改。

### VAL-T04-006：卷线鼓/滑块首件检查

1. 打印三个零件；测量12.0 mm导轨与12.6 mm滑块槽。`MEASURED`单边实际间隙须记录，不以CAD的0.30 mm假设代替。
2. 用4个名义M4紧固件通过官方Ø4.5安装孔固定侧卧舵机；REV-41-1828铝舵盘先用原厂中心螺钉安装，再把打印卷线鼓用16 mm圆周M3孔连接。所有长度必须由实物堆叠确定，禁止超过舵机中心M3孔6 mm深度。
3. 不接绳时把舵机置于1500 µs并确认两侧均有安全机械余量；安装独立60 mm硬止挡后，再接约1 mm低伸长绳和全行程≤1.5 N回位件。
4. 理论端点751/2249 µs只作为计算起点。首次从1000–2000 µs低速范围开始，逐步扩大并用卡尺测量真实行程；任何硬止挡接触均不得继续增加脉宽。
5. 用拉力计在滑块上测全行程可用外力，目标为≥10 N且不堵转；同时记录峰值电流、实际行程、绳滑移和舵机外壳温度。2.9 A是堵转边界，不是允许工作点。
6. 无球完成100循环：行程漂移≤1 mm、无绳越槽、无零件开裂、舵盘/紧固件无松动、无不可恢复卡滞。通过后才进入FLOWER/POLLEN夹具；温升与电流验收上限在取得REV电源预算或首轮数据后冻结，当前为`TBD`。

复算输入、脚本和CSV：`calculations/t04_intake_inputs.json`、`calculations/t04_intake.py`、`calculations/t04_intake_results.csv`、`calculations/t04_flower_sweep.py`、`calculations/t04_flower_sweep_results.csv`。FLOWER扫掠初模为`cad/modules/t04_intake/side_sweep_intake.py`；可打印验证件为`cad/modules/t04_intake/flower_side_sweep_prototype.py`及`prototype_manifest.json`。
