wang15143089/FTC-2026-Bio-buzz/docs/assumptions.md

# 假设登记册

假设只用于暂时推进，不等同于事实。每项必须有失效条件和关闭方式。

| ID | 状态 | 假设 | 影响/风险 | 失效条件 | 关闭方式 |
|---|---|---|---|---|---|
| ASM-001 | CLOSED/KNOWN | 用户已确认可采用 CadQuery/Python 生成参数化模块，并用 STEP 进入 FreeCAD/Fusion 360。 | 最终原生格式和图纸要求仍待确认。 | 用户改变交付链。 | 2026-09-19 已确认。 |
| ASM-002 | ASSUMED | 当前不需要本地高负载 GPU 仿真。 | 复杂接触动力学可能需外部算力或实测替代。 | 某项需求只有高保真物理模型才能回答。 | 在验证计划中证明必要性并审批。 |
| ASM-003 | CLOSED/KNOWN | 控制系统采用 REV-31-1595 Control Hub + REV-31-1153 Expansion Hub；电池采用 goBILDA 3100-0012-0020。 | T03 可进入接口规划，但 Hub 精确安装包络仍需官方 CAD 核验。 | 用户改变硬件。 | 2026-09-19 已确认。 |
| ASM-004 | CLOSED/SUPERSEDED | P1–P4 首轮任务包比较采用中性权重和 1–5 序数评分。 | v0.1 过度奖励低复杂度，且证据映射不足。 | 用户要求大幅提高战略价值并采用基于证据的评分。 | 2026-09-19 由 TS-S00-001 v0.2 取代。 |
| ASM-005 | ASSUMED | TS-S00-001 v0.2 的战略总权重为 70%，其中比赛分/RP 杠杆各占 25%；工程评分在无台架数据时采用规则和几何锚定的 0–5 判断。 | 战略内部权重和工程分可能随赛事目标或原型数据改变；不应解释为实测性能。 | 官方 RP 阈值变化、用户改变战略偏好，或计算/原型提供新数据。 | 已进行 60%–80% 权重敏感性；M1/M2/L6 数据逐项替换工程评分。 |
| ASM-006 | ASSUMED | P3-BAL-0.1 使用真空、质点、静止目标弹道模型，忽略阻力、Magnus 效应、球体变形和 HIVE 运动。 | 对开孔轻质球可能低估所需速度且不能预测散布。 | 实测轨迹与模型不符，或建立经标定的阻力/旋转模型。 | 用实物球和目标夹具测出射速度/轨迹并拟合修正。 |
| ASM-007 | ASSUMED | 首轮轮速初筛使用 `v_ball/v_surface = 0.65`。 | 直接影响电机/轮径初筛；不得作为最终传动比。 | 台架测得传递比或滑移随球径、压缩、轮材显著不同。 | 对 71/91 mm 球分别回归传递系数。 |
| ASM-008 | ASSUMED | 前期弹道扫参采用 0.75–2.0 m 水平距离、400/550/700 mm 出射高度和 50/55/60°。 | 只覆盖候选射位，不证明场上可达或无碰撞。 | L3 场地/底盘模型显示射位不可达或需其他范围。 | 用官方场地 CAD 做 2D/3D 可达与遮挡检查。 |
| ASM-009 | PARTIALLY_CLOSED | C04-B1首轮使用25°上倾与平面偏转、60 mm拨片动力行程、120 mm球验证行程和10 N接触限力；底环先按刚性台阶建立载荷下界。 | SRC-016已关闭名义几何并淘汰纯横向路径，但摩擦、球变形、场地公差及四球堆载仍可能使方案失效。 | 实体夹具出现规则危险接触、不可恢复楔球或成功率未达阈值。 | VAL-T04-004名义完成；VAL-T04-005用实测力、路径和成功率最终关闭。 |
| ASM-010 | ASSUMED | REV-41-3336在6 V驱动17 mm节圆半径单层卷线鼓；总传动效率0.80、运动工作点不超过50%堵转、回位载荷不超过1.5 N；7.4 V不作为默认供电。 | 2.9 A堵转、绳滑移/叠层、实际效率、散热和REV电源瞬态可能否决单舵机。 | 60 mm行程需要超过270°，扣除回位载荷的实测输出低于10 N，或电流/温升/100循环超限。 | 已核验官方型号/CAD；下一步测量行程、力、电流、温升、绳滑移并完成100循环。 |

尚未采用任何机器人尺寸、性能或机构形式的数值假设；ASM-005 仅为决策模型假设。
