wang15143089/FTC-2026-Bio-buzz/docs/module_interfaces.md

# 模块接口控制方法（ICD）

## 全局坐标系

采用右手坐标系：`+X` 为机器人前进方向，`+Y` 为机器人左侧，`+Z` 向上。全局原点 `R0` 暂定在名义驱动接触平面上、T01 轮迹包络的几何中心。方向约定为 `KNOWN` 的项目约定；原点的可制造基准实现为 `TBD`，在底盘概念确定后冻结。

观察方向定义：俯视图沿 `-Z` 看，前视图沿 `-X` 看，左视图沿 `-Y` 看。角度按右手定则；CAD 长度默认 mm。

## 接口作为一等对象

每个跨模块接口使用稳定 ID `IF-<源模块>-<目标模块>-NN`，并指定单一接口责任人、版本和双方批准状态。一个接口记录至少包含：

| 类别 | 必填内容 |
|---|---|
| 机械 | 基准面/轴、孔型、紧固件、载荷与力矩、材料接触、装配方向 |
| 运动 | 轴/轴承、皮带/链条/齿轮、行程、速度、禁入区、动态余量 |
| 几何 | 名义包络、扫掠包络、连接区、维修空间、最小间隙、坐标变换 |
| 电气 | 执行器/传感器、控制器端口、电压、峰值/持续电流、连接器、线束路径 |
| 软件 | 命令、单位、范围、更新率、传感输入、状态、故障/超时行为 |
| 验证 | 检查方法、验收阈值、证据文件、状态和日期 |

## 机械接口约束

- 孔位必须相对命名基准标注，不能通过上一个零件的偶然边缘定位。
- 轴、轴承、轮毂和传动件分别记录名义尺寸、配合、公差和轴向约束。
- 名义包络与运动扫掠包络分开；线束、工具进入和拆卸路径也属于包络。
- 制造公差与装配间隙不得混入名义几何参数。

## 变更控制

接口从 `DRAFT → PROPOSED → FROZEN → VERIFIED`。冻结后，任何孔位、基准、连接器、信号或包络变更都必须：更新接口版本；列出受影响模块；记录验证回退范围；在决策日志或变更记录中说明原因。

## P3 初始接口记录

| 接口 | 状态 | 当前定义 | 开放项 |
|---|---|---|---|
| IF-T05-T06-01 单球交接 | DRAFT v0.1 | 一次提交一个名义 Ø71–91 mm 得分物体；T06 READY 前和 HIVE TIP 期间由 T05 闸门保持下一球；必须可断电清障。 | 中心线、交接速度、姿态、传感器 |
| IF-T02-T06-01 结构安装 | DRAFT v0.1 | T06 安装到 T02 命名基准；发射反力不得经过电池/Hub 支架；护罩、工具和轮组拆卸空间属于接口包络。 | 孔型、载荷、质量、扫掠包络 |
| IF-T03-T06-01 电气 | DRAFT v0.1 | 12 V 电机端口 1–2 个并使用编码器；堵转值只作故障预算，不得作为正常工作点。 | 端口号、持续/峰值电流、线束路径 |
| IF-T08-T06-01 控制 | DRAFT v0.1 | `SAFE → SPINUP/CHARGE → READY → FEED_ONE → RECOVER`；异常进入 `FAULT_JAM` 或 `INHIBIT_HIVE_MOVING`。 | 速度容差、超时、TIP 检测方法 |
| IF-T06-ENV-01 弹道/目标 | DRAFT v0.1 | 名义瞄准 CELL 下部矩形中心高 1455.75 mm；射位和角度由 P3-BAL-0.1 扫参，不冻结单一点。 | 阻力、旋转、场地误差、动态 HIVE |
| IF-T04-FLOWER-01 底部取球 | PROPOSED v0.5 | C04-B1采用从官方FLOWER模型−X朝−Y偏25°的斜向侧拨：25°楔形滑块直线动力行程60 mm，Ø71 mm球验证至120 mm，路径距离116 mm处由Ø60×120 mm标准roller接管；REV-41-3336在6 V下以17 mm节圆半径卷线鼓拉动滑块，3.2:1圆弧方案只作回退。纯−X横移淘汰，C04-B2禁止，C04-A保留回退。容量达到4时禁止继续获取，外部工作载荷目标10 N且不得抓持FLOWER。 | 3.680 mm名义支柱余量的实物公差、绳滑移/回位、对位基准、电源瞬态、峰值取出力和卡球恢复 |
| IF-T04-T07-01 顶部放球预留 | DRAFT v0.1 | 仅保留可折叠、可换向 intake 的安装/控制预留；如实现，必须从顶环上方低速放入并在最后 60 秒前抑制 NECTAR。 | 扫掠包络、舵机力矩、漏斗、周期、与 T05 冲突 |
| IF-T04-T05-01 单电机预输送 | PROPOSED v0.1 | 一个带编码器电机驱动分段roller并向短预输送提供同步带动力；S05舵机闸门承担单球节拍，关闭时输送必须允许打滑/卸载。 | 传动比、张紧/离合、球间距、堵塞恢复、持续电流 |

## 接口记录模板

```text
Interface ID / Version / Status:
Owner / Participating modules:
Requirement links:
Mechanical and datum definition:
Geometric envelope and clearance:
Moving/power-transmission interface:
Electrical definition:
Software/control definition:
Loads, tolerances, units:
Failure behavior:
Verification method and evidence:
Open items:
```
