wang15143089/FTC-2026-Bio-buzz/docs/p3_launcher_comparison.md

# P3 发射器与共享 intake 严格比较

版本：P3-LAUNCHER-CMP-0.3；日期：2026-09-20；适用成熟度：T06 M1、T04/T07 接口研究。本文选择的是下一阶段主原型架构，不是未经实体试验的制造冻结。v0.3按DEC-0013把T04/T05更新为单电机共享动力。

## 结论

- `DECIDED` C06-B 对置双飞轮成为 P3 的**主原型和默认架构**；C06-A 单飞轮+曲面压板保留为同台对照和低资源回退。
- `CALCULATED` 选择理由不是旧版主观加权分：对置双轮在理想接触模型中能把平移速度与自旋解耦，并可用对称调隙保持两种球的出球中心线；单轮+静止压板在同一模型中必然产生自旋，单侧调隙会使 71/91 mm 两球的中心线相差 10 mm。
- `KNOWN/CALCULATED` C06-B 相对 C06-A 至少增加一个396 g电机、0.25 A无负载电流及一个9.2 A堵转故障源；采用C04-A共享intake/prefeed动力后整机为7个电机，剩余1端口。
- `DECIDED` 让现有 T04 intake 兼任 FLOWER **底部 POLLEN 取出**，作为 P3 的零新增电机增量功能。它不是完整 T07，也不等于 FLOWER 得分。
- `PROPOSED` 可换向/可抬升 intake 从 FLOWER 顶部低速放球只保留为第二阶段实验；名义 NECTAR 径向间隙仅 5.25 mm，且必须展开，因此现有证据不足以纳入基线。

## 候选的严格定义

| 项目 | C06-A 单飞轮+曲面压板 | C06-B 对置双飞轮 |
|---|---|---|
| 能量接触面 | 一个主动轮；另一侧为静止曲面压板 | 两个主动轮，接触点切向速度都指向出球方向 |
| 球径适配 | 固定轮+浮动/可调压板 | 两侧对称浮动/联动调隙 |
| 控制量 | 主动轮转速；压板预载/间隙 | 两轮转速和/差；对称预载/间隙 |
| 进料 | 共用独立单球闸门 | 共用独立单球闸门 |
| 首轮轮径 | 96/120 mm 可换，不冻结 | 96/120 mm 可换，不冻结 |

固定间隙版本不属于合格候选。`CALCULATED` 对任一架构，压缩量 `c = D - g`；当球径从 71 mm 变到 91 mm 而间隙 `g` 不变时，压缩量必然增加 20 mm。除非未来实测证明允许压缩区间宽度至少 20 mm，否则固定间隙不能被宣称为双球兼容。

## 可解析证明的差异

### 1. 平移与自旋

把球局部近似为半径 `r` 的刚性圆，与两条局部平面接触；两接触面的有符号切向速度为 `u1、u2`，球心速度为 `v`，角速度为 `ω`。理想无滑移条件为：

`v + ωr = u1`

`v - ωr = u2`

解得：

`v = (u1 + u2) / 2`，`ω = (u1 - u2) / (2r)`。

- C06-A 的静止压板使 `u2 = 0`，因此 `v = u1/2` 且 `ω = u1/(2r)`；在此理想模型中，自旋不能独立消除。
- C06-B 令 `u1 = u2 = u`，因此 `v = u` 且 `ω = 0`；调两轮速度之和控制平移，调速度之差控制自旋。

对 P3-BAL-0.1 的 1.5 m、400 mm 高、55° 基准球速 5.5557 m/s 和 120 mm 轮：

| 结果 | C06-A | C06-B | 标签 |
|---|---:|---:|---|
| 理想所需轮面速度 | 11.1113 m/s | 5.5557 m/s | `CALCULATED_IDEAL` |
| 理想轮速 | 1768.4 rpm | 884.2 rpm/轮 | `CALCULATED_IDEAL` |
| POLLEN 理想自旋绝对值 | 156.50 rad/s | 0 rad/s | `CALCULATED_IDEAL` |

这证明的是拓扑自由度和理想运动学，不是实际效率。真实球会滑移、压缩并与曲面长时间接触；此前统一采用的 `v_ball = 0.65 v_surface` 不能再直接用于两个拓扑之间的公平比较，必须分别实测。

### 2. 双球直径与瞄准基准

两种球名义直径差 `ΔD = 20 mm`。若 C06-A 固定飞轮面、只移动压板面来恢复相同压缩量，局部球心平面移动 `ΔD/2 = 10 mm`。这使出球中心线和压板切线几何随球型变化；可以另加机械补偿，但那是额外自由度和误差源。

若 C06-B 两接触面各自对称移动 `±ΔD/2`，中面严格不变，因此出球中心线的名义位移为 0。这个结论不依赖摩擦系数。对称调隙应采用机械联动或等刚度浮动，不能依赖两个未同步的自由滑块。

### 3. 接触长度、重复性与控制复杂度

- C06-A 的曲面压板可提供更长接触弧，因而**可能**在较低法向力下完成能量传递；REV 的公开原型资料也强调长加速路径和可调压缩。但对 BIOBUZZ 球的收益仍为 `ASSUMED`。
- C06-B 在短直线夹持中接触时间可能更短，却具有两个可观测的编码器速度与可调差速。若框架刚度、轮径或闭环速度不一致，它也会重新产生自旋和偏航。
- C06-A 轴系、控制和维护更简单；C06-B 有两条高速轴线、更多夹点和更严格的共面度要求。二者都必须全包围护罩并具备断电清障路径。

## 资源与风险比较

| 准则 | C06-A | C06-B | 优势方/证据 |
|---|---|---|---|
| 理想零自旋 | 不成立 | 等速时成立 | B，解析证明 |
| 平移/自旋独立调节 | 不成立 | 速度和/差可调 | B，解析证明 |
| 双球中心线保持 | 单侧调隙偏 10 mm | 对称调隙为 0 | B，几何证明 |
| 长接触路径 | 曲面天然具备 | 需加长夹持或分级轮 | A，结构潜力，未实测 |
| 发射电机 | 1 | 2 | A，架构计数 |
| 整机电机/剩余端口 | 6 / 2 | 7 / 1 | A，R503上限及DEC-0013下计算 |
| 最小质量差 | 基准 | 至少 +0.396 kg | A，供应商电机质量下界 |
| 额外无负载电流 | 基准 | +0.25 A | A，供应商端点；带载 TBD |
| 单故障堵转暴露 | 1 个高速电机 | 2 个高速电机 | A；堵转 9.2 A/个，不是工作点 |
| 编码器控制自由度 | 1 | 2 | B 的可调性更强，软件更复杂 |
| 轴系/装配误差源 | 少 | 多 | A |
| FLOWER 底部取球兼容 | 可共用 intake | 可共用 intake | 平手；发射器无须参与 |
| 独立 FLOWER 电机余量 | 1 | 0 | A；B 必须复用 intake 或舵机 |

电源层面不能只比较 0.25 A 无负载值。FTC 官方工程资料提醒飞轮属于显著负载，整机受 20 A 电池保险丝和控制系统掉压风险约束。C06-B 必须通过带载电流、恢复时间、温升和整车同时驱动试验；任何“两个电机所以更稳定”的结论在这些数据产生前都是 `ASSUMED`。

## intake 承担部分 FLOWER 任务

### F-INT-1：底部依次取出 POLLEN——纳入基线

`KNOWN` G418 允许只从 FLOWER 底部取出 POLLEN，不允许从侧面取出，也不允许取出 NECTAR。每个 FLOWER 初始有 4 个 POLLEN，因此前置顺从滚轮可伸入/贴近 Retrieval Opening，依次把最下方 POLLEN 拉入 T04。

- `CALCULATED_NOMINAL` 开口高 90 mm 对 Ø71 mm POLLEN 有 19 mm 总高度余量；91 mm 深度比球径多 20 mm。
- `KNOWN` 球不是完全球形且尺寸会变化，所以上述余量只证明名义几何没有排除方案，不能证明不卡球。
- `DECIDED` 使用现有 intake 电机，增加被动导向、可更换软指/滚轮和对位护唇，不增加第 9 个电机。
- `KNOWN` 这项功能本身不获得 FLOWER 分；它把最多 4 个初始 POLLEN 转为可用于 HIVE 的库存，同时也会移除未来某联盟拥有该 FLOWER 时每球 2 分的潜在价值。4 个留在被拥有 FLOWER 中的 POLLEN价值 8 分，因此“取空所有 FLOWER”不能设为无条件策略。
- `KNOWN` 机器人同时 CONTROL 超过 4 个物体会触发 G407 风险；取球状态机必须在容量 4 时物理/软件拒绝继续吸入。

推荐状态：`FLOOR_INTAKE → FLOWER_ALIGN → BOTTOM_EXTRACT_ONE → COUNT_UPDATE → CAPACITY_INHIBIT`。对位可利用规则明确允许的凹形 FLOWER 导向，但不得抓持、附着或缠绕场地结构。

### F-INT-2：同一 intake 顶部低速放球——只保留接口

`KNOWN` 得分物体只能从 FLOWER 顶部进入；NECTAR 在最后 60 秒前不得进入 FLOWER 计分体积。规则使用“placing”，而 glossary 把 forceful 抛射定义为 LAUNCHING，因此方案应采用受控低速滚入/释放，不把 HIVE 飞轮或高速反转 intake 当作 FLOWER 射手。

- `CALCULATED_NOMINAL` 顶口 Ø101.5 mm 对 POLLEN 的径向余量为 15.25 mm，对 NECTAR 仅 5.25 mm；后者要求机械漏斗、低相对速度和可靠对位。
- `CALCULATED_NOMINAL` 顶环高 546 mm，工作高度上限 736.5 mm，名义高度余量 190.5 mm；因此规则包络没有排除顶部放球。
- `CALCULATED_NOMINAL` 从 457 mm 起始高度平面到顶环至少上升 89 mm；若要求 NECTAR 球心先高于顶环，几何下界为 134.5 mm。实际机构行程还需计入 roller、漏斗、结构和 backstop，当前为 `TBD`。
- `ASSUMED` 复用 intake 的合理实现是“前置滚轮/短输送整体折叠抬升 + 正反转 + 末端漏斗”，而不是再建一条独立 FLOWER 输送链。它可能只用舵机和弹簧平衡，但舵机力矩、扫掠包络及碰撞尚未证明。

由于顶置功能在最后 60 秒与 HIVE 进料争用同一 T04/T05 路径，它必须证明战略周期收益大于切换和对位时间。现阶段仅冻结安装与控制预留，不把它计入 P3 成功条件。

## 选择证明

本项目已由 DEC-0010 确立“战略价值优先、P3 HIVE 为主方向”。因此采用约束优先、再按目标词典序比较，而不继续使用可任意调整的加权总分：

1. **合法与硬约束**：两方案都可合法；采用单电机共享intake/prefeed后，C06-A用6个、C06-B用7个电机，均不超过R503。固定间隙版本都不通过双球适配关口。
2. **P3 主任务的可控性**：C06-B 在理想模型中严格拥有零自旋设定点、平移/自旋两个独立控制量和对称调隙不迁移中心线；C06-A 不具备这些拓扑性质。
3. **P3 + 部分 FLOWER 覆盖**：底部POLLEN取出由C04-A既有intake和两舵机完成，不新增直流电机；C06-B仍保留1个电机端口。
4. **资源次级准则**：C06-A 在质量、电流、端口、装配和维护上胜出；但在已批准的“P3 战略优先”次序中，这些优势不足以覆盖第 2 项，除非 C06-B 在 L6 电源、可靠性或精度试验失败。

所以，**在当前已批准优先级和明确前提下，C06-B 是唯一被选择的主原型；C06-A 是证据生成用对照，不再与 C06-B 并列默认方案。** 这是一项可审计的条件结论，不是声称双飞轮在所有机器人、所有摩擦条件下绝对更优。

## 不能解析证明的部分与最终反转规则

以下量取决于摩擦、球体形变、轮材、惯量、框架刚度、气动和控制器，必须标为 `TBD/MEASURED`：命中率、散布、实际球速传递、连续射击恢复、电流、温升、损球、堵塞率和噪声。

共用台架随机交错测试两种头部、两种球型和 1.0/1.5/2.0 m 射位，每个条件至少 30 发；记录原始每发数据而非只报平均值。最终选择规则为：

1. 任一方案违反护罩、球损伤、控制上限、无工具/单工具断电清障或出现棕断/保险丝风险，先淘汰。
2. 以所有测试条件中的最差命中率和二维散布为 P3 主指标；用 95% 置信区间报告，不把点估计当作证明。
3. 若 C06-B 在最差条件下不劣于 C06-A，且电流/温升关口通过，维持 C06-B。
4. 若 C06-B 精度优势不能成立或电源/质量/维护失败，则反转为 C06-A；若两者统计不可区分，按更低资源原则选择 C06-A。

计算源为 `calculations/p3_launcher_comparison.py`，结果为 `calculations/p3_launcher_comparison_results.csv`；模型由单元测试覆盖。v0.2的运动学证明不变，v0.3只更新资源架构。
