wang15143089/FTC-2026-Bio-buzz/docs/t01_drive_trade_study.md

# T01 麦克纳姆与差速驱动量化比较

版本：T01-DRIVE-TRADE-0.1；日期：2026-09-20；结论适用于当前P3双飞轮和C04-A单电机intake资源架构。

## 结论

- 保留现有四电机麦克纳姆底盘，不在当前阶段改为两电机差速。
- 四电机差速可能改善实际牵引与轮地损失，但不释放任何电机端口，因此不能解决资源问题。
- 两电机差速严格释放2个端口并移除874 g电机质量，但把电机轴理想峰值功率和电机限制牵引力各减半，并失去保持朝向时的横移能力。
- C04-A已把intake和短预输送压缩为1个电机；四电机麦克纳姆+单电机物体链+双飞轮合计7个电机，已有1个端口余量。当前没有充分战略收益去承担差速转换代价。

## 不变量与已知输入

当前底盘为3209-0001-0007，四个5203-2402-0019 312 rpm电机和Ø104 mm GripForce Mecanum轮。供应商给出单电机：24.3 kg·cm堵转扭矩、9.2 A堵转电流、0.25 A无负载电流、437 g质量。底盘总质量4269 g。

底盘轮距、轴距仍为 `TBD_MEASURE`；用户要求保持轮距，只允许最低限度拆分重组。因此转向时间采用0.300–0.450 m轮距敏感性，不暗中冻结尺寸。

## 电机与接口结果

采用供应商端点构造线性有刷直流电机模型；外部传动、轮地损失、打滑、电池压降、控制器损失和热限制均未计入。

| 指标 | 4电机麦克纳姆 | 4电机差速 | 2电机差速 |
|---|---:|---:|---:|
| 驱动电机端口 | 4 | 4 | 2 |
| 相对当前释放端口 | 0 | 0 | 2 |
| 电机质量 | 1.748 kg | 1.748 kg | 0.874 kg |
| 理想轴端最大机械功率 | 77.86 W | 77.86 W | 38.93 W |
| Ø104 mm轮理想堵转牵引力 | 183.31 N | 183.31 N | 91.65 N |
| 最大功率点牵引力 | 91.65 N | 91.65 N | 45.83 N |
| 理想无负载速度 | 1.699 m/s | 1.699 m/s | 1.699 m/s |
| 总无负载电流 | 1.00 A | 1.00 A | 0.50 A |

堵转力不是正常工作点，真实地面附着可能先限制牵引。两电机方案只有在实际任务所需牵引力和加速度显著低于其边界时才可接受。

### 等力、等速工作点

在Ø104 mm直接驱动、1.0 m/s且忽略外部损失时：

| 地面力 | 4电机模型输入 | 2电机模型输入 | 结论 |
|---:|---:|---:|---|
| 20 N | 41.56 W | 42.93 W | 两电机没有效率优势 |
| 30 N | 62.47 W | 70.07 W | 四电机分担负载更省输入功率 |
| 40 N | 85.87 W | 需要12.29 V | 两电机在12 V下不能维持该点 |

所以“少两个电机必然更省电”不成立。两电机只在接近空载时确定少0.5 A无负载电流；负载增加后，每台电机承担双倍力矩，铜耗和所需电压上升。

### 1 m直线加速敏感性

忽略轮胎附着、损失、电流限制和电池压降的理想线性模型：

| 整机质量 | 4电机 | 2电机 | 两电机时间增加 |
|---:|---:|---:|---:|
| 8 kg | 0.663 s | 0.736 s | 0.073 s |
| 12 kg | 0.700 s | 0.805 s | 0.106 s |
| 16 kg | 0.736 s | 0.869 s | 0.134 s |

这些值偏乐观，只用于方案间比例；FTC泡沫垫上的打滑和电流限制会改变绝对时间。

## 横移任务的严格边界

固定方向HIVE发射器和FLOWER对位都受益于“保持机器人朝向、只作横向修正”。麦克纳姆可直接横移；差速底盘至少要原地转90°、直行、再转回90°。

若两者前进速度同为 `v`，差速轮距为 `W`，横移距离为 `L`，忽略加速度和转向擦滑：

`t_diff = (L + πW/2) / v`

设麦克纳姆横移速度为前进速度的 `k` 倍：`t_mec = L/(kv)`。麦克纳姆更快的条件为：

`k > L / (L + πW/2)`。

在中间敏感性轮距375 mm时：

- 横移250 mm：阈值 `k > 0.298`。
- 横移500 mm：阈值 `k > 0.459`。
- 横移1000 mm：阈值 `k > 0.629`。

因此只要实测500 mm横移速度超过前进速度约46%，麦克纳姆在保持发射朝向的理想时间上就优于差速的转—走—转。实际差速原地转向还存在轮胎擦滑和重新瞄准时间，通常使该阈值进一步有利于麦克纳姆，但这部分必须实测，不能写成定量事实。

## 质量转换参考

移除两个437 g电机的毛减重为874 g。若用82 g/个的96 mm Hogback参考轮替换236 g/个的104 mm Mecanum轮，四轮再毛减616 g；两电机差速理论毛减重合计1.490 kg。

这不是净减重：还没有扣除跨轮同步带/链条、链轮、张紧器、轴承、护罩和加固件；96 mm轮还会把312 rpm名义无负载速度从1.699降到1.568 m/s，下降7.69%。该轮只用于建立质量下界，不是选型。

## 决策与反转条件

当前保留四电机麦克纳姆，因为：

1. C04-A已经让整机留出1个电机端口。
2. P3固定方向发射和FLOWER底部对位都直接使用横移能力。
3. 两电机差速以50%理想峰值驱动功率换取2个端口，当前没有已批准功能需要这两个端口。

只有同时满足以下条件才重新打开两电机差速：

- 新增已批准功能必须再使用至少2个直流电机，且无法由舵机、机械联动或共享传动实现；
- 真实整机质量、牵引力和任务周期试验证明两电机方案满足加速/抗推要求；
- 路径回放证明失去横移不会显著降低HIVE瞄准和FLOWER周期；
- 传动净质量、效率、维护和防护均已计入，而不是只计算移除的电机。

输入、脚本和逐项结果位于 `calculations/t01_drive_trade_inputs.json`、`calculations/t01_drive_trade.py` 和 `calculations/t01_drive_trade_results.csv`。
