wang15143089/FTC-2026-Bio-buzz/docs/task_package_trade_study.md

# P1–P4 任务包比较

记录：TS-S00-001 v0.2；日期 2026-09-19；用途为 M1 分支筛选，不是最终机构冻结。

## 结论

- `KNOWN` 用户要求战略价值大幅高于开发便利性；默认模型把战略准则由 v0.1 的 25% 提高到 70%。
- `CALCULATED` 默认结果为 P3 HIVE 84.8、P4 双目标 78.2、P2 FLOWER 55.7、P1 基础移动 55.4。
- `CALCULATED` 当战略总权重在 60%、70%、80% 间变化时，排名前两名始终为 P3、P4；因此“P3 作为主任务、P4 作为受资源关口约束的扩展”对权重变化稳健。
- `DECIDED` P1 仍是必需底座，但不再作为最终任务包候选的战略赢家；P3 优先进入 M1，P4 只研究兼容性与增量代价，P2 保留为 HIVE 风险无法关闭时的备选。

## 证据边界

战略评分来自 `BIOBUZZ Competition Manual TU01` 的硬规则：比赛阶段、分值、RP 路径、计分窗口和功能间解锁关系。工程评分仍是 `ASSUMED`，因为尚无本赛季台架的命中率、周期时间、质量、功率或堵塞率。模型能回答“先投资哪个任务方向”，不能预测一场比赛的实际分数。

关键规则证据：

- `KNOWN` 比赛含 30 s AUTO、8 s 转换和 120 s TELEOP；§10.1、§10.4，pp.81,85。
- `KNOWN` HIVE TIP 在 AUTO/TELEOP 均为 20 分，且 4/7 TIPS 分别对应其他赛事的 POLLINATOR 1/2 RP；Table 10-2/10-3，p.91。
- `KNOWN` 每次 HIVE TIP 允许联盟投入五个预置 NECTAR 中的一个；最后 60 s 才可投入其余 NECTAR；§10.1，p.81。
- `KNOWN` FLOWER 在最后 60 s 前不能开始计分；底层本方 NECTAR 奖励 5 分，拥有 FLOWER 后其中每个物体 2 分；§10.5.2、Table 10-2，pp.88,91。
- `KNOWN` GARDEN 每球 1 分且区域不受保护；§10.5.3、Table 10-2，pp.89,91。
- `KNOWN` 单机器人 LEAVE + AUTO PARK + TELEOP PARK 的规则分值合计最多为 13，而其他赛事 SWARM 阈值是联盟合计 16；Table 10-2/10-3，p.91。

## 模型结构

评分采用 0–5，5 为更有利；允许 0.5。归一化总分为：

`总分 = Σ(准则权重百分数 × 准则评分) / 5`

### 默认权重

| 类别 | 准则 | 权重 % | 评分证据 |
|---|---|---:|---|
| 战略 | 比赛分杠杆 | 25 | 可重复动作分值、固定得分上限、所有权收益 |
| 战略 | RP 杠杆 | 25 | 能直接支持的 RP 路径与阈值 |
| 战略 | 时间窗口与解锁效应 | 12 | 可用阶段、60 s 限制、TIP 解锁 NECTAR |
| 战略 | 战术覆盖 | 8 | 独立计分路径、联盟互补及对手影响 |
| 工程 | 物理可行性 | 8 | 目标几何、运动目标、物体公差和可调性 |
| 工程 | 可靠性与恢复 | 8 | 堵塞、失误恢复、场上状态依赖 |
| 工程 | 集成与资源负担 | 8 | 模块数、空间、质量、功率和执行器竞争 |
| 工程 | 驾驶与软件负担 | 6 | 操作步骤、感知、状态机和时序依赖 |

战略合计 70%，工程交付合计 30%。战略内部权重仍是 `ASSUMED` 分配，但其证据输入均可追溯；60% 与 80% 情景用于检查结论是否依赖单一分配。

### 战略评分锚点

| 准则 | 低档锚点 | 中档锚点 | 高档锚点 |
|---|---|---|---|
| 比赛分杠杆 | 1–1.5：主要是固定移动分和 1 分/球路径 | 3：含 5 分条件奖金、2 分/球及所有权杠杆 | 5：含可重复 20 分事件 |
| RP 杠杆 | 1.5：只支持 SWARM，且单机器人固定项 13 < 联盟阈值 16 | 3：直接覆盖两个 RP 路径 | 5：覆盖 SWARM 和两级 POLLINATOR 路径 |
| 时间/解锁 | 1：功能只在窄窗口且不解锁资源 | 3：基础能力跨阶段，或专项受最后 60 s 限制 | 5：高价值动作跨 AUTO/TELEOP 且解锁 NECTAR |
| 战术覆盖 | 2：基础移动/GARDEN | 4：基础能力加一个高价值专项 | 5：基础能力加 HIVE 与 FLOWER 两类目标 |

锚点来自规则离散特征，不以尚未测量的“每分钟得分”伪装精度。P1 的 1.5、P2 的 3、P3/P4 的 5 可由上述锚点直接复核；如果后续获得周期时间和成功率，将改用期望分模型替代这些序数分。

## 评分与理由

| 包 | 比赛分杠杆 | RP 杠杆 | 时间/解锁 | 战术覆盖 | 物理可行性 | 可靠/恢复 | 集成资源 | 驾驶软件 |
|---|---:|---:|---:|---:|---:|---:|---:|---:|
| P1 | 1.5 | 1.5 | 3.0 | 2.0 | 5.0 | 5.0 | 5.0 | 5.0 |
| P2 | 3.0 | 1.5 | 3.0 | 4.0 | 3.5 | 3.0 | 3.5 | 3.0 |
| P3 | 5.0 | 5.0 | 5.0 | 4.0 | 2.5 | 2.5 | 3.0 | 3.0 |
| P4 | 5.0 | 5.0 | 5.0 | 5.0 | 1.5 | 1.5 | 1.0 | 1.5 |

### 战略评分证据

- **P1**：固定 LEAVE/PARK 合计最高 13 分，GARDEN 仅 1 分/球且可被任一联盟移走。它支持 SWARM，但单机器人理论固定项仍低于联盟 16 分阈值；不支持 POLLINATOR RP。
- **P2**：底层 NECTAR 5 分、拥有 FLOWER 后每球 2 分，所有权还能计入对手放入的物体，因此比赛分杠杆高于 P1；但主要功能只能在最后 60 s 合法开始，且不增加 POLLINATOR RP 路径。
- **P3**：TIP 单次 20 分，是 PARK/底部 NECTAR 的 4 倍、GARDEN 球的 20 倍；可在 AUTO 与 TELEOP 完成，直接对应 4/7 TIP 两级 RP，并逐次解锁 NECTAR。上述三项都是规则直接给出的战略优势。
- **P4**：拥有 P3 的全部 RP 与解锁能力，并增加 FLOWER 所有权路径，所以战术覆盖最高；但它没有比 P3 更多的 RP 类型，额外价值主要在末段战术弹性。

### 工程评分证据与不确定性

- **P1**：仅依赖成熟 Strafer 底盘和基本物体操作，机构最少，故工程评分最高；仍需验证底盘和自主，不代表零风险。
- **P2**：NECTAR 名义 Ø91 mm，而 FLOWER 顶口约 Ø101.5 mm，名义直径余量仅 10.5 mm，且比赛物体会变形/变化；还需顶部放置、可选底部取球及 60 s 时序，故为中等风险。
- **P3**：必须向朝上 CELL 发射，目标会在 TIP 后换稳态；规则还警告 TIP 过程中继续发射可能破坏成功判定。发射能量、散布与暂停检测尚无台架数据，故工程评分中低。
- **P4**：叠加 P2/P3 的机构、路径和状态机，并竞争 457 × 610 × 736.5 mm 工作包络、8 电机/8 舵机及同一电源预算，因此当前集成评分最低。

所有工程评分为 `ASSUMED`；其“依据”说明为什么采用该假设，不会把假设升级成实测事实。

## 权重敏感性

| 战略总权重 | P1 | P2 | P3 | P4 | 排名 |
|---:|---:|---:|---:|---:|---|
| 60% | 61.7 | 57.2 | 80.4 | 71.0 | P3 > P4 > P1 > P2 |
| 70% 默认 | 55.4 | 55.7 | 84.8 | 78.2 | P3 > P4 > P2 > P1 |
| 80% | 48.8 | 54.2 | 89.1 | 85.5 | P3 > P4 > P2 > P1 |

`CALCULATED` P3 的第一名不依赖战略权重在上述合理区间内的具体选择。P4 与 P3 的差距会随战略权重升高而缩小，说明决定是否升级 P4 的关键不再是规则价值，而是实际集成代价。

## 证据升级计划

| 当前不确定项 | 当前标签 | 最低成本替代证据 | 对决策的作用 |
|---|---|---|---|
| 每次 TIP 所需物体数、出射窗口、命中率 | TBD | L1 能量/弹道边界 + L2 参数扫描 + L6 可调发射台架 | 校准 P3 工程分和实际得分率 |
| FLOWER 放置/取球成功率及周期 | TBD | L3 几何路径 + L6 透明开口夹具 | 校准 P2 工程分与 P4 增量价值 |
| P4 相对 P3 的质量、空间、电机和电流增量 | TBD | M1 包络/资源预算 | 决定 P4 是否进入完整概念开发 |
| 驾驶员执行和自动暂停 TIP 的可靠性 | TBD | 状态机走查 + 台架事件日志 | 校准软件与恢复评分 |
| 目标赛事最终 RP 阈值 | TBD | 后续官方 Team Update | 重新计算 RP 杠杆 |

## 当前选择关口

P3 进入主 M1 概念研究并至少形成两个可调发射概念。P4 只做增量架构研究：证明 FLOWER 功能能复用 T04/T05、不会破坏 P3 发射可靠性，并给出资源增量；满足后才升级为完整并行概念。P2 保留为风险回退，不先占用与 P3 等量的开发资源。
