wang15143089/FTC-2026-Bio-buzz/docs/engineering/t06-motion-part-geometry-baseline.md

# T06 运动部分几何基准与 CAD 版本核对（R48）

轮次：R48（核对轮，无几何改动）
决策 / 验证：`docs/decision_log.md` DEC-0046 / V-0046
Linear：[KEI-20](https://linear.app/keithschoolrobotic/issue/KEI-20/t069-等待区第-2-颗球索引几何-换档事件触发r40-复核后的两个剩余瓶颈)（T06.9，主项）
Notion：[Decision — Redo the POLLEN feeder as a coaxial one-piece shell with a 5 deg gravity tray](https://app.notion.com/p/3ef7fc7bbcfb8177bf86d310c29afaa6)
生成脚本：`cad/paddle_launcher_motion_check.py`（只读复用 R37/R39 生成器，不修改任何父模块）
检测量具：`tools/inspect_geometry.py`（历史轮 R005）+ 本轮 `cq.importers.importStep` 回读 + 逐部件包围盒/体积

本文件是**运动部分几何位置关系的唯一主索引**：坐标、半径、相位、间距只在这里定义一次，
并逐项标注来源版本。它不是需求文件，也不是参数的第二真源（参数主数据仍为
`config/parameters.yaml`）。

## 0. 结论摘要

- 桌面 `T06_R37_pollen.step` / `T06_R37_nectar.step` 与仓库 `cad/output/_r37_stage/` 的
  R37 staging STEP **逐字节相同**（SHA256 `80CB3ED0…1966`），且与几何检验 R005 所测文件
  同一哈希 ⇒ **桌面 R37 文件的版本是正确的**，不是旧副本。
- 本轮独立复算与 R37 发布值一致（体积 930299.1 vs 930299.9 mm³，相对偏差 ~1e-6）。
- **但 CAD 侧最新 = R37/R39，仿真侧最新 = R47**，两者相差 3 项 CAD 未落地的改动
  （托板 460、竖向挡舌 x=180、贴带区 135°→258°）。核对结论见第 4 节。

## 1. 来源版本表

| # | 来源 | 版本 / 时间 | 提供的事实 | 标签 |
|---|---|---|---|---|
| S1 | `PROJECT_STATUS.md` §LATEST DESIGN VERSION | 2026-10-12 | `P3-LAUNCHER-CMP-0.3`、`T06-R47-MJCF-1.0`（候选，待人工接受） | KNOWN |
| S2 | `PROJECT_STATUS.md` §T06 R37 段 | 2026-10-11 | R37 = 方向 B（托板 150→215）+ (b) 重叠清理 | KNOWN |
| S3 | `PROJECT_STATUS.md` §T06 R39 段 | 2026-10-12 | R39 = 球道低摩擦内衬，打印件预缩 0.5 | KNOWN |
| S4 | `config/parameters.yaml` → `t06_feeder_r37` | DEC-0035 / DEC-0036 | 托板 x 范围 `[24.901, 215.0]`、扫掠 60、轮毂孔 Ø12.1、让位 0.5 | CALCULATED |
| S5 | `config/parameters.yaml` → `t06_liner_r39` | DEC-0039 | 带 0.5×88、打印内弧 108.474、外弧 114.974、托板面 −0.5 | MEASURED |
| S6 | `config/parameters.yaml` → `t06_feeder_a_prime_shared` | DEC-0030 | `R_IN = 107.974`、扇区 142→275、宽 108、双叶片 330/150、轮 Ø96×24 | KNOWN |
| S7 | `docs/decision_log.md` DEC-0032 | 2026-10-05 | `dr_hot = 0.8 mm`：垫片按**热态**外径配，模型放冷态中心距 | KNOWN |
| S8 | `docs/decision_log.md` DEC-0035/0036 | 2026-10-11 | 托板右端 215（+65）；拨杆并为一个实体 `paddle_rotor` | KNOWN |
| S9 | `docs/decision_log.md` DEC-0043 | 2026-10-12 | R45 主动索引闸 = **竖向全宽挡舌 x = 180 mm** + 待机停位 188° | SIMULATED |
| S10 | `docs/decision_log.md` DEC-0044 | 2026-10-12 | R47 贴带区 = 外罩内弧 **135°→258°** + 托板顶面；托板 460 | SIMULATED |
| S11 | Linear KEI-20 | 2026-10-13T00:05Z | 「CAD 侧未落进：竖向挡舌 + x=180 闸位 + 托板 460 mm；贴带区（不需要预缩）」 | KNOWN |
| S12 | `cad/output/inspection/t06_feeder_r37_R005.json` | 2026-10-12T03:17Z | R37 staging nectar：4/4 pass（215.2615 / 338.7996 / 930299.217 / 23 实体） | MEASURED |
| S13 | `cad/output/inspection/t06_feeder_r39_liner_*.json` | 2026-10-12T02:18Z | R39 单体：5/5 pass（内弧 108.4616、外弧 114.9738、托板面 −0.4608、142.0–275.0°） | MEASURED |
| S14 | `cad/output/_r37_stage/_r37_readback.json` | 2026-10-11T22:16Z | 23 根实体、包围盒、总体积 930299.9 | MEASURED |

**版本判定**：CAD 产物最新 = `_r37_stage/`（2026-10-11 22:16）+ `_r39_liner/`（2026-10-12 02:16）；
仿真验收最新 = `T06-R47-MJCF-1.0`（2026-10-12）。**二者不是同一代**。

## 2. 坐标系与运动链

- 单位 mm；X–Y 为底盘安装面，+Z 向上，+X 为发射方向水平投影（`config/parameters.yaml` → `coordinate_system`）。
- 运动链：**球从托板右端 x = 215 滚入 → 沿 5° 托板下滑到停位 → 拨杆（双叶片，相位 330°/150°）
  绕 C 逆/顺时针扫过扇区 → 在 142° 出口交给喉道 `shooter_throat_+55` → 两片对转飞轮在 52° 夹口加速射出**。
- 拨杆轴心 **C = (29.49, 0.0, 111.46) mm**（外罩圆弧、托板切点、拨杆转子三者共用这一构造点，
  同轴度是构造事实而非公差 —— DEC-0023/0024）。

## 3. 运动部分部件表（本轮实测，2026-10-13）

量具：`cad/paddle_launcher_motion_check.py` 对 R37 staging 生成器返回的最终实体逐件量
`n_solids` / 体积 / 包围盒。两变体**仅飞轮组位置不同**，其余逐位相同。

### 3.1 两变体共用件

| 部件 | 实体 | 体积 mm³ | 包围盒 min → max (x,y,z) mm | 说明 |
|---|-----|---|---|---|
| `feeder_shell_tray` | 1 | 302656.1 | (−85.484, −54.0, −3.514) → (215.261, 54.0, 180.043) | 外罩球道弧 + 一体 5° 托板；内弧 R107.974、扇区 142–275°、宽 108 |
| `paddle_rotor` | 1 | 92960.1 | (−28.239, −48.0, 69.47) → (87.219, 48.0, 153.45) | 轮毂+双臂+双叶片并为一个实体；轴心 (29.49, 0, 111.46) |
| `paddle_flex_tip_1` | 1 | 6528.0 | (71.219, −48.0, 125.738) → (89.952, 48.0, 156.182) | TPU 尖片，r 58..60，极角 30° |
| `paddle_flex_tip_2` | 1 | 6528.0 | (−30.972, −48.0, 66.738) → (−12.239, 48.0, 97.182) | 同上，极角 210°（两片相隔 180°） |
| `paddle_shaft_2106-4008-1920` | 2 | 7886.7 | (23.565, −96.0, 105.31) → (35.64, 96.0, 117.61) | 官件 Ø12 拨杆轴，长 192 |
| `paddle_shaft_support_bridge` | 1 | 19247.6 | (0.49, 73.0, 81.46) → (58.49, 79.0, 141.46) | 拨杆轴支撑桥（+Y 侧） |
| `guide_roof_3` | 1 | 23940.0 | (−118.43, −57.0, 106.91) → (−72.969, 57.0, 163.917) | 上游导入段顶板 |
| `guide_wall_3_+1` | 1 | 22680.0 | (−115.671, 54.0, 40.11) → (12.53, 57.0, 161.763) | 侧壁 +Y（按 0.5 让位过） |
| `guide_wall_3_-1` | 1 | 22680.0 | (−115.671, −57.0, 40.11) → (12.53, −54.0, 161.763) | 侧壁 −Y |
| `shooter_throat_+55` | 1 | 28386.0 | (−75.333, −57.0, 162.07) → (−21.869, 57.0, 229.322) | 142° 出口后的喉道 |
| `liner_tape_arc` | 1 | 10222.5 | (−78.984, −44.0, 5.356) → (7.041, 44.0, 188.163) | **R47 口径标注件**（非打印件）：外罩内弧 135°→258° 贴带 |
| `liner_tape_tray` | 1 | 8396.3 | (24.879, −44.0, 2.673) → (215.022, 44.0, 19.803) | 同上：托板顶面全长贴带 |

### 3.2 飞轮驱动组（两变体差异所在）

| 项 | POLLEN | NECTAR |
|----|---|---|
| 轮间夹口（热态设计值） | 64.0 mm | 82.0 mm |
| `half_spacing` | 80.800 mm | 89.800 mm |
| 轮轴间距（冷态，模型实测） | 161.60 mm | 179.60 mm |
| 冷态几何夹口（模型实测） | 65.60 mm | 83.60 mm |
| 上飞轮轴心 | (−11.368, 0, 285.260) | (−18.460, 0, 290.801) |
| 下飞轮轴心 | (115.975, 0, 185.769) | (123.067, 0, 180.228) |
| 上飞轮包围盒 | (−59.367, −27.0, 237.26) → (36.632, 27.0, 333.259) | (−66.459, −27.0, 242.801) → (29.54, 27.0, 338.8) |
| 下飞轮包围盒 | (67.976, −27.0, 137.769) → (163.974, 27.0, 233.768) | (75.068, −27.0, 132.228) → (171.066, 27.0, 228.227) |
| 飞轮轴包围盒 | 上 (−17.518, −84.0, 280.51) → (−5.218, 84.0, 291.409) | 上 (−24.61, −84.0, 286.051) → (−12.31, 84.0, 296.95) |

- 飞轮 Ø96 × 24，每轴两片（Y −27…−3 与 3…27），轮轴 Ø8 × 168，轴心线平行 Y。
- 轮轴分离方向 = (0.788, 0, −0.6156) = **−38°**，与 52° 球道正交 ✔。
- 冷/热夹口关系：`冷态夹口 − 2 × dr_hot = 热态夹口`（65.60 − 1.6 = 64.0；83.60 − 1.6 = 82.0），
  与 DEC-0032 口径一致 ✔。

### 3.3 关键派生量（本轮复算）

| 量 | POLLEN | NECTAR | 来源 |
|----|---|---|---|
| 球半径 | 35.560 | 45.974 | S6 |
| 停位球心到轴心 R_CARRY = R_IN − r | 72.414 | 62.000 | S6/S4 |
| 停位球心 (x, z) | (29.49, 39.046) | (29.49, 49.460) | 计算 |
| 托板切点（275° 处） | (38.901, 3.862) | 同 | S4 |
| 托板起算 x（切点 −14 根延长） | 24.901 | 同 | S4 |
| 等待区起点 x（扫掠圆外） | 97.772 | 124.500 | S4 |
| 排队容量（当前 215 托板） | 3 颗 | 2 颗 | S4/S12 |
| 扫掠可达上限 r = 60 + r_ball | 95.560 | 105.974 | S4 |

## 4. 核对结果

### 4.1 pass（版本正确 / 几何正确）

1. **桌面 R37 文件 = 仓库 R37 文件 = R005 所测文件**（SHA256 `80CB3ED05CED…E36B1966` 三者相同）⇒ 版本正确、非旧副本。
2. **R005 几何检验 4/4 pass**：托板右端 215.2615（目标 215 ± 0.5）、飞轮组 z 上限 338.7996（目标 338.8 ± 1.0）、
   体积 930299.217（目标 930299.902，相对偏差 1e-6）、根实体 23（不得丢失/合并）。
3. **本轮独立复算一致**：16 部件体积合计 930299.1 mm³（发布值 930299.9）；拨杆轴心实测 (29.49, 0, 111.46)
   与 KNOWN 值零偏差；轮轴距 161.60 / 179.60 = 2 × 80.8 / 2 × 89.8；冷热夹口关系成立。
4. **交付件回读一致**：`T06_motion_*.step` 各 25 根实体、948918.082 mm³、包围盒 z 上限 333.259 / 338.800，
   与 16 件 + 2 贴带件之和相符（930299.1 + 18618.8 = 948917.9）。
5. **R39 内衬单体 5/5 pass**（内弧偏移 +0.4876、外弧 −0.0002、托板面 −0.4608、扇区 142.0–275.0°）。

### 4.2 版本不一致（CAD 未跟上已验收的仿真口径）

| # | 项 | CAD 现值（来源） | 最新口径（来源） | 状态 |
|---|----|---|---|---|
| F1 | 托板右端 | **215.0**（S4 / DEC-0035） | **460**（S10 / DEC-0044 验收）；中途另有 350（DEC-0042 R44，亦未落地） | `fail`（未落地） |
| F2 | 竖向全宽挡舌 | **CAD 中不存在该零件**（S4 的 13 个自制件无 gate；`cad/*.py` 无生成器） | x = 180 mm、z 47.5↔139.5（S9 / DEC-0043） | `fail`（缺件） |
| F3 | 贴带区 | CAD 无贴带；R39 下料带扇区为 **142°→275°**（S5） | 实测贴敷区 **135°→258°** + 托板顶面（S10） | `fail`（未落地 + 扇区口径不同） |
| F4 | 参数主数据 | `config/parameters.yaml` 最新 T06 块 = `t06_liner_r39`（S5） | R40–R47 全部决策无参数条目 | `not_run` |

**判读要点**：F1–F3 都**不是** CAD 几何错误，而是「CAD 版本落后于仿真版本」。R47 的
6/6 全清 / 24/24 真出膛**依赖挡舌**，因此当前 CAD 不能被当作已验证机构的可制造版本。
另注：R39 的「打印件预缩 0.5」与 DEC-0044 的「不需要预缩」（0.2/0.5 mm 带厚对节拍无影响）
只是可选性差异，不是错误；本交付件采用**设计面**（R_IN = 107.974）+ 贴带标注件。

## 5. 本轮交付（桌面，Fusion 可直接打开）

| 文件 | 内容 | SHA256 | 大小 |
|---|---|---|---|
| `T06_motion_pollen.step` | 18 部件 / 25 实体：全部运动件 + 外罩托板 + 喉道/导板 + R47 贴带标注件 | `57EBA523…C0EAA9` | 169.37 MB |
| `T06_motion_nectar.step` | 同上，仅飞轮组按 82 mm 热态夹口重排 | `2342C3D3…4E1C181` | 169.38 MB |
| `T06_motion_check_report.md` | 本核对的中文摘要 | — | — |

装配树带部件名与颜色（外罩半透明蓝、飞轮近黑、拨杆橙、TPU 尖黄、贴带红），
在 Fusion 的「浏览器」里可直接按名选取/隐藏。

## 6. 未验证（TBD）

- 全部几何为 CAD 侧口径；实物未验证（μ ≈ 0.30 仍为 `ASSUMED`，胶带选型/带宽/端头/翘边未定）。
- 交付件中 `liner_tape_arc` / `liner_tape_tray` 是**贴敷位置标注件**，不是可制造零件，
  也不代表实际裁带工艺（R39 另有按 142°→275° 下料的 PTFE 带 STEP）。
- F1–F4 的收口需要用户确认是否按 R47 口径改 CAD（改托板长度 + 新增挡舌 + 贴带区），
  改动属结构级变更，须走新 DEC。

## 7. R50 追加：发射部分驱动链与支撑框架（2026-10-13，DEC-0048 / V-0048）

R48 核对的运动件口径不变；R50 是在同一批运动件之上补齐**驱动与承载**。
生成器 `cad/paddle_launcher_shooter_drive_r50.py`（只读复用 R37 / R49 的生成器），
交付件 `T06_shooter_drive_R50_pollen.step`（51 件）。参数主数据见
`config/parameters.yaml → t06_shooter_drive_r50`，本节只记位置关系、不重复定义参数。

### 7.1 轴向（Y）堆叠 — MEASURED

| 件 | y 范围 (mm) | 来源 |
|----|---|---|
| 飞轮马达 `5203-2402-0003`（−Y 侧 ×2） | −219.17 … −112.00（输出轴尖 −88.0） | R50 |
| 马达夹具 `1401-0043-0036` | −120.00 … −112.00 | R50 |
| 马达桥（打印 ×4） | −112.00 … −68.00 | R50 |
| 飞轮联轴器 `4007-4008-4008` | −96.50 … −75.50（中心 −86.0） | R50 |
| −Y 面板 | −71.00 … −65.00 | R50 |
| 飞轮轴 `2106-4008-1680` | −84.00 … +84.00 | R37（未改） |
| 拨杆轴 `2106-4008-1920` | −96.00 … +96.00 | R37（未改） |
| +Y 送料桥（R37 件） | 73.00 … 79.00 | R37（未改） |
| +Y 面板 | 79.00 … 85.00 | R50 |
| 舵机联轴器 `4001-0025-4008` | 88.00 … 105.00（中心 96.5） | R50 |
| 舵机支架 `1802-0043-0001` | 96.00 … 102.00 | R50 |
| 拨杆舵机 `2000-0025-0004` | 101.50 … 145.60（花键面 101.5） | R50 |

轴承 `1611-0514-4008` 由 4 增至 6：飞轮轴 −68.0 / +82.0 双支撑，拨杆轴同位置也改成框架轴承座。

### 7.2 轴心（XZ）— 与第 2 节一致，本轮未改动

| 轴 | (x, z) mm |
|----|---|
| 上飞轮轴 | (−11.368, 285.259) |
| 下飞轮轴 | (115.975, 185.769) |
| 拨杆轴 | (29.490, 111.460) |

### 7.3 支撑框架 — MEASURED

- 双侧 6 mm 打印面板（`shooter_frame_neg/pos`）：三个轴心处 R34 凸台 + 44 mm 宽连杆轮廓
  + 三条腿；bbox x −45.37 … 149.97、z −18.0 … 332.0；单件 189479.7 mm³。
- 轮廓全部落在 |y| ≥ 65 的空区（机体外罩与导轨 |y| ≤ 57、拨杆转子 |y| ≤ 48），
  面板除三个轴孔外不需要任何让位孔。
- 3 根横梁：顶梁 x 38…92 / z 314…332；中梁 x 96…132 / z 104…128；
  底盘梁 x 40…92 / z −18…−5（带 4 个 Ø4.6 安装孔 (52, ±50)、(80, ±50)）。
- 打印件合计 815311.2 mm³ ≈ 1035 g（PETG 1.27 g/cm³ 为 `ASSUMED`）。
- 干涉：新增件对既有件 7 处非零，全部是轴 / 轴承 / 联轴器的正常径向配合；
  `servo_coupler` 对舵机支架 / 伺服横梁 ±28 / 两侧面板**全部 0 mm³**。

### 7.4 本轮修掉的隐患

舵机联轴器原先用 `Shape.mirror("XZ")` 定姿态 —— 那是绕**世界** XZ 平面镜像，把件搬到
y −105 … −88（马达侧）、与舵机完全不接。改为「平移到原点 → 绕自身 X 直径翻转 180° →
平移回位」后落在 y 88.00 … 105.00（REX 通孔 88…96 套住止于 96.0 的拨杆轴端，
25T 花键孔 102.1…105.0 咬住 101.5 起的舵机花键）。**R50 之前的 JSON / STEP 带这个错，
本轮已重刷。**

### 7.5 未验证（TBD）

- 打印件约 1035 g 偏重（横梁 391.0 cm³ + 面板 379.0 cm³ 仍有挖空余量），本轮未减重。
- 结构强度 / 振动未验（KEI-15 静态 FEA 仍阻塞）；未实机。
- 4.2 节的 F1（托板 460）与 F3（贴带区 135°→258°）未关闭；F2 已由 R49 的
  `T06_gate_drive_R49_pollen.step` 关闭，但尚未并入 R37 基线装配。
- 舵机联轴器与舵机壳面只留 0.6 mm 装配裕度。
## 8. R51 追加：发射部分换基线 + 滑窗开口（2026-10-13，DEC-0049 / V-0049）

> **血统提醒（重要）**：第 2 节与第 7 节的**轴向堆叠 / 支撑框架**属于 **R50 血统**（`paddle_launcher_shooter_drive_r50.py` 自造的 `shooter_frame_neg/pos` + `shooter_rail_1/2/3`）。R50 已被判 **SUPERSEDED** —— 那个框架把上下两根飞轮轴刚性连成一体、夹口锁死（用户判据：「两个飞轮不能连在一起，这样没法调间隙」）。**当前有效血统是本节与第 9 节的 R51 / R52**。R50 的第 7 节内容作为驱动链型号与轴向堆叠的历史证据保留，**不再代表当前 CAD**。

- 基线（KNOWN）: `cad/output/paddle_launcher_feasible_pollen.step`（2026-10-01 22:36，414.3 MB，98 件）= 「只保留运动部分」之前最新一版全整机，即 `paddle_launcher_motion_only.py --profile motion_free` 的父装配。回读证据 `cad/output/_r51_base/manifest.json`。
- 与 R37/R49 的继承关系（KNOWN）: R51 = 该基线上「拨杆舵机换 25-4」+「侧板开口换 59x56 滑窗」两处改动；R37 送球件与 R49 闸门在此底座上**原样保留 / 换装**（见第 9 节）。
- 侧板滑窗（MEASURED）: 窗 `59.0 x 56.0 mm`，n 跨 `56.5..112.5`，板厚 4 mm（y ±70），导轨侧隙 0.5 mm；老 `8.4 x 9` 轴槽作废。
- 夹口行程（CALCULATED）: 半间距 80.0..91.2 ⇒ 夹口 **64.0..86.4 mm**；pollen 滑座 n 跨 61.0..99.0、nectar 72.0..110.0，两者都在窗内；导轨 n 跨 58.5..110.5 也在窗内。
- 调隙链（CALCULATED）: `2000-0025-0002` -> 12 mm 曲柄 -> 65 mm 拉杆 -> 十字头 -> 两根 110 mm 连杆 -> 滑座耳片；`crosshead_u_mm` pollen -57.498 / nectar -43.798，曲柄角 96.682° / 19.331°。
- 轴隔离（MEASURED，核心）: `rigid_link_between_axles = []`；bbox 候选只有侧板 `shooter_side_plate_-1`，布尔对上下滑座 0.0 / 0.0 mm³；两滑座互不接触、两根飞轮轴互不接触；侧板专项 15 组布尔在两档下全 0 mm³（`cad/output/_r51_drive/plate_booleans_r51.json`）。
- 交付（KNOWN）: `cad/output/_r51_drive/T06_shooter_assembly_R51_{pollen,nectar}.step`（98 件 / 434.4 MB）；视图 `r51_shooter_view_*.png`、`r51_drive_support_sheet_pollen.png`、`paddle_lineage_compare.png`；桌面同名副本。

## 9. R52 追加：R37 送球件 + R49 闸门换装到 R51 底座（2026-10-13，DEC-0050 / V-0050）

- 组成（KNOWN）: R51 底座（滑窗侧板 + 滑座 + 导轨 + 底盘纵梁 + 调隙链）+ R37 送球件 6 件（`feeder_shell_tray`、`paddle_rotor`、`paddle_flex_tip_1/2`、`paddle_shaft_2106-4008-1920`、`paddle_shaft_support_bridge`，**世界坐标不动**）+ R49 闸门 9 件 + 拨杆驱动（`2000-0025-0004` + `1802-0043-0001` + `4001-0025-4008`）+ 新增支撑（`servo_bridge_±26`、`feeder_mount_±1`、两侧板 `O14.1` 拨杆轴承座）。共 **90 件**。
- 侧板（MEASURED）: R51 滑窗板 + 拨杆轴轴承座 `O14.1`（局部 xz `[-111.801, -58.398]`，孔 r 7.05）。
- 关键几何（MEASURED）: 拨杆轴 `[29.49, 111.46]`、上轴 `[-10.737, 284.767]`、下轴 `[115.345, 186.261]`、轴距 160.0、叶尖 r 59.908；夹口 pollen 64.0 / nectar 86.0；叶尖到下轮面 pollen 5.961 / nectar 8.55 mm，到上轮面 70.006 mm；拨杆轴到上 / 下轴 177.914 / 113.869 mm。
- 轴向（Y，MEASURED）: 拨杆舵机壳面 y 101.5；拨杆轴承 y -70.0 / +76.0；送球件坐标与 R37 验收口径一致（`r37_frozen_coordinates = true`）。
- 支撑（MEASURED）: `feeder_mount_±1` x -80..168、y 53.5..63、z 16..30（0.5 mm 咬合托板壁、搁在底盘纵梁顶面）；`servo_bridge_±26` 与 `gap_servo_frame` 仅 1.372 mm³ 接触。
- 闸门让位（MEASURED）: `gate_frame` 对 R37 `feeder_shell_tray` 让位 **530.017 mm³**（只切闸门侧）。
- 干涉与一致性（MEASURED）: R37/R49 vs R51 底座 **0**、闸门 vs 送球 **0**、新增件 vs 其余 5 处**全为正常配合**（见 DEC-0050）；回读各 **282 solids**、体积偏差 -0.0001 %、包围盒 6 面偏差 0.00 mm。
- 交付（KNOWN）: `cad/output/_r52_drive/T06_shooter_assembly_R52_{pollen,nectar}.step`（90 件 / 444.6、444.7 MB）+ 装配图 `r52_assembly_sheet_*.png`；桌面 `T06_R52_装配图_*.png`、`T06_shooter_assembly_R52_*.step`。
- 未验证（TBD）: 滑座锁紧 / 微调件、`feeder_mount` 连接强度、拨杆舵机工作模式、打印件质量、实机；R52 生成器的轴隔离检查跳过了侧板（证据见第 8 节与 `cad/_r52_axle_isolation_step.py`）。

## 10. R53b 追加：滑座常闭弹簧夹 + 两侧锁紧长槽（2026-10-13，DEC-0051 / V-0051）

> **血统提醒**：本节继承第 9 节（R52）。R53（蝶形螺母手动锁位）已**作废**，请勿引用 R53 的任何干涉结论（它的锁紧件没做 `to_world()`，报警全是坐标系假象）。**当前有效是 R53b。**

- 与 R52 的差别（MEASURED）: ①删掉 8 件自由导轨 `carriage_guide_*`；②滑座加**耳板**（半宽 ±42、厚 3 mm、与侧板走合 0.3 mm）；③侧板加**锁紧长槽 5.2 x 44，u = ±36，n = +63.5..107.5 与 −107.5..−63.5 共 4 条**；④新增 **32 件夹紧件**（16 颗 M4 螺柱栈 + 16 根压缩弹簧）。件数 90 -> **114**。
- 夹紧栈（ASSUMED，按实物核对前）: 沿 y 依次 `螺柱头 Ø7x3 | 耳板 3 | 侧板 4 | 耳板 3 | 弹簧 6.0 | 平垫 1.0 | 尼龙螺母`；弹簧 Ø5.5（线径 0.6），自由长 8.4、装好 6.0、k = 1.24 N/mm ⇒ **3 N/颗**（CALCULATED）。
- 夹紧力与摩擦（CALCULATED）: 每滑座 8 颗 x 2 摩擦面 ⇒ 单滑座 **14.4 N（μ=0.30）/ 28.8 N（μ=0.60）**，全机 28.8 / 57.6 N；调隙舵机推力预算 ~112 N ⇒ `servo_can_still_slide_it = true`。**这里是要摩擦（锁位），不要贴低摩擦带 —— 与 R47 内衬的方向相反。**
- 锁紧行程（MEASURED）: 长槽 n 63.5..107.5 覆盖两档螺柱位 **68 / 79 / 92 / 103**，两侧余量 4.5 mm；即换档时螺柱在槽内滑 35 mm，不需要任何人工松紧。
- 耳板间隙（MEASURED）: `upper_±1` / `lower_±1` 全 **0.3 mm**。
- 干涉（MEASURED）: `lock_vs_rest = []`、`lock_vs_carriage = []`（Ø4 螺柱穿 Ø4.4 间隙孔，期望为 0）、`axle_isolation_hits = []`；`plate_vs_rest` 5 处非零全部与 R52 同源（4 x 28.274 mm³ 舵机支座 + 1 x 10.285 mm³ 拨杆轴承座）⇒ **两根飞轮轴仍是独立滑座，没有被夹紧件重新连成一体**。
- 夹口（MEASURED）: pollen 半间距 80.0 / 夹口 64.0；nectar 91.0 / 86.0（与 R52 相同，本轮不动间隙）。
- 交付（KNOWN）: `cad/output/_r53b_auto/T06_shooter_assembly_R53b_{pollen,nectar}.step`（114 件 / 446.3、446.4 MB）+ 剖面图 `r53b_clamp_section.png` + 方案图 `cad/output/_r53_lock/r53b_auto_lock_options.png`；桌面同名副本（`_r53b_auto` 是指向桌面的 junction）。
- 未验证（TBD）: 弹簧 / 螺柱 / 尼龙螺母未按实物采购核对；`k`、`μ`、`E` 均为 ASSUMED；预载长期衰减未验；是否需要**在线切换两档**与**是否还有空闲舵机通道**两个问题用户尚未回答（决定要不要做舵机主动解锁）；打印件质量与实机未验。
