wang15143089/FTC-2026-Bio-buzz/cad/output/DELIVERY_MANIFEST.md

# T06 发射器 CAD 交付清单

- 生成时间: 2026-10-01 23:22 (America/Chicago)
- 设计版本: C06B-COTS-0.3
- 表示法: 每个 goBILDA SKU 以完整官方部件带入（DEC-0021），未对采购件做布尔并集
- 状态: 候选 / 待人工接受（solution_status = candidate_pending_human_review）
- 说明: `*.step/glb/stl` 与 `vendor_solids/` 体积过大，仅本地保存、不进版本库

## 发射器总成导出（整体官方部件，C06B-COTS-0.3）

| 文件 | 大小 (MB) | 修改时间 | SHA-256 |
|---|---:|---|---|
| `cad\output\paddle_launcher_feasible_nectar.glb` | 295.9 | 2026-10-01 22:57 | (省略, >32 MB) |
| `cad\output\paddle_launcher_feasible_nectar.step` | 414.3 | 2026-10-01 22:52 | (省略, >32 MB) |
| `cad\output\paddle_launcher_feasible_nectar.stl` | 861.9 | 2026-10-01 22:59 | (省略, >32 MB) |
| `cad\output\paddle_launcher_feasible_pollen.glb` | 295.9 | 2026-10-01 22:47 | (省略, >32 MB) |
| `cad\output\paddle_launcher_feasible_pollen.step` | 414.3 | 2026-10-01 22:36 | (省略, >32 MB) |
| `cad\output\paddle_launcher_feasible_pollen.stl` | 861.9 | 2026-10-01 22:49 | (省略, >32 MB) |

## 零件 STEP

| 文件 | 大小 (MB) | 修改时间 | SHA-256 |
|---|---:|---|---|
| `cad\output\parts\feeder_support_cheek_reference.step` | 0.0 | 2026-10-01 23:01 | 48652f39f7926861... |
| `cad\output\parts\gobilda_1401_0043_0036_mount_official.step` | 14.9 | 2026-10-01 23:01 | 3e0766d073d9808c... |
| `cad\output\parts\gobilda_1401_0043_0036_mount_proxy.step` | 0.0 | 2026-09-28 15:12 | 01381e0d14b63674... |
| `cad\output\parts\paddle_blade.step` | 0.0 | 2026-10-01 23:00 | 922e914c79b6f85e... |
| `cad\output\parts\shooter_slotted_side_plate.step` | 0.1 | 2026-10-01 23:00 | 86c76f096c1e49c8... |
| `cad\output\parts\sliding_bearing_carriage.step` | 0.0 | 2026-10-01 23:00 | 1810000c60080cd3... |
| `cad\output\parts\sonic_8mm_gecko_hub.step` | 10.0 | 2026-10-01 23:00 | 6c58ed08d7198a11... |
| `cad\output\parts\spacing_link_110mm.step` | 0.1 | 2026-10-01 23:01 | 00d99c9359eb4fb0... |

## 官方整体部件实体（BREP 中间产物）

| 文件 | 大小 (MB) | 修改时间 | SHA-256 |
|---|---:|---|---|
| `cad\output\vendor_solids\1309-0016-4008.brep` | 5.7 | 2026-10-01 22:20 | 24a2b04133fa0faf... |
| `cad\output\vendor_solids\1401-0043-0036.brep` | 9.9 | 2026-10-01 22:21 | 03da956164f00c22... |
| `cad\output\vendor_solids\1611-0514-4008.brep` | 0.1 | 2026-10-01 22:21 | 742e14590ff02818... |
| `cad\output\vendor_solids\1802-0043-0001.brep` | 13.1 | 2026-10-01 22:21 | 1fe8affe8c68bed9... |
| `cad\output\vendor_solids\1908-0025-0032.brep` | 1.8 | 2026-10-01 22:21 | c2187f3ecd630ccb... |
| `cad\output\vendor_solids\2000-0025-0002.brep` | 4.3 | 2026-10-01 22:22 | 056154e3da29fdec... |
| `cad\output\vendor_solids\2000-0025-0003.brep` | 4.3 | 2026-10-01 22:23 | 7f4b18f15617157a... |
| `cad\output\vendor_solids\2106-4008-1680.brep` | 1.3 | 2026-10-01 22:23 | a6ad036d0a93098c... |
| `cad\output\vendor_solids\2106-4008-1920.brep` | 1.3 | 2026-10-01 22:23 | c8456b61dd4054cf... |
| `cad\output\vendor_solids\3613-0014-0096.brep` | 22.4 | 2026-10-01 22:26 | 2975f38102a3b0da... |
| `cad\output\vendor_solids\4001-0025-4008.brep` | 0.5 | 2026-10-01 22:27 | ba8d0c1da3d6b910... |
| `cad\output\vendor_solids\4007-4008-4008.brep` | 4.5 | 2026-10-01 22:27 | 4aacf48b2b2ad499... |
| `cad\output\vendor_solids\5203-2402-0003.brep` | 17.2 | 2026-10-01 22:30 | e8de350fcdd7d56e... |

## 逐 SKU 派生记录

| 文件 | 大小 (MB) | 修改时间 | SHA-256 |
|---|---:|---|---|
| `cad\output\vendor_solids\1309-0016-4008.json` | 0.0 | 2026-10-01 22:20 | 000c20b1e72bdccd... |
| `cad\output\vendor_solids\1401-0043-0036.json` | 0.0 | 2026-10-01 22:21 | 76b92bcbcc9f991d... |
| `cad\output\vendor_solids\1611-0514-4008.json` | 0.0 | 2026-10-01 22:21 | e82daea9be831809... |
| `cad\output\vendor_solids\1802-0043-0001.json` | 0.0 | 2026-10-01 22:21 | 397798bedb7e9d24... |
| `cad\output\vendor_solids\1908-0025-0032.json` | 0.0 | 2026-10-01 22:21 | 15b22435fbbcc1c1... |
| `cad\output\vendor_solids\2000-0025-0002.json` | 0.0 | 2026-10-01 22:22 | e882ccddee7ccc55... |
| `cad\output\vendor_solids\2000-0025-0003.json` | 0.0 | 2026-10-01 22:23 | af5a2ca2f8560e36... |
| `cad\output\vendor_solids\2106-4008-1680.json` | 0.0 | 2026-10-01 22:23 | bec633dd89efa80d... |
| `cad\output\vendor_solids\2106-4008-1920.json` | 0.0 | 2026-10-01 22:23 | 644bad1536406af2... |
| `cad\output\vendor_solids\3613-0014-0096.json` | 0.0 | 2026-10-01 22:26 | 9f7ea5353339aab5... |
| `cad\output\vendor_solids\4001-0025-4008.json` | 0.0 | 2026-10-01 22:27 | 9ad0770ec74caac0... |
| `cad\output\vendor_solids\4007-4008-4008.json` | 0.0 | 2026-10-01 22:27 | a6151ad0e4a5de9e... |
| `cad\output\vendor_solids\5203-2402-0003.json` | 0.0 | 2026-10-01 22:30 | 50531b1eb1290c2d... |
