wang15143089/FTC-2026-Bio-buzz/simulation/mujoco/_work/newaction.md

1. （立即）确认舵机（或拨杆传动）在 200 rpm（3.3 rev/s）处的可用扭矩，用以关闭 V2 送球段的 forcerange ±1.5 N·m 假设；这是拨杆转速门槛结论唯一的未关闭项。若实测扭矩不足，按 FINDINGS_v2_zh.md 第六节减小叶片端角半径或加陡托板末段。
