wang15143089/FTC-2026-Bio-buzz/simulation/mujoco/out/FINDINGS_v2_zh.md

# T06 POLLEN 送球段 V2 —— MuJoCo 全流程仿真结论（2026-10-03）

模型：`simulation/mujoco/pollen_v2_sim.py`（几何常量直接取自 `cad/paddle_launcher_feeder_redesign.py`
与 `cad/output/paddle_launcher_motion_free_pollen_v2_report.json`；不依赖 CadQuery）。
求解器：MuJoCo 3.14.0，`timestep = 2e-4 s`，`implicitfast`，`cone = elliptic`，采样 2 ms。

## 一、结论（一句话）

**V2 几何具备完整的送球—发射能力。** 球从托板右端滚入 → 叶片在 x ≈ 113 mm 接球 → 沿外罩内壁
输送约 99°（241° → 142°）→ 从 142° 出口**切向**进入 52° 通道（球心距通道中线仅约 4 mm）→
进入对置双飞轮夹口 → 以 **6.53 m/s、50.2°** 射出，同高度射程 **4.28 m**（飞轮 1620 rpm）。
旧几何的“52° 顶板压路”卡点在 V2 中**没有复现**。

## 二、全流程单次成功算例（球从 x = 145 托板右端进料，拨杆 200 rpm，飞轮 1620 rpm）

| 阶段 | 实测 | 备注 |
|---|---|---|
| 球入托板 | x = 145.0, z = 65.95 | 与托板 5° 面 + 球半径一致 |
| 自滚 | 滚到 x ≈ 113，v ≈ 0.19 m/s | 被叶片端角挡住（静止拨杆时停在 x = 114） |
| 叶片接球 | x ≈ 113，r ≈ 98 | 叶片可达外边界 = 端角半径 62.4 + 球半径 35.56 |
| 沿壁输送 | 241° → 142°，球心轨道 r ≈ 58.4 | 与设计 R_CARRY = 58.40 一致；`min_angle` 达 0–7°（整圈通过、无卡死） |
| 出罩 | 142°，球心距 52° 通道中线 ≈ 4 mm | 切向过渡，`pass`（报告要求 ≤ 55.00 mm） |
| 通道段 | lx −175 → 0，v 0.15 → 4.5 m/s | 重力沿 52° 加速 + 飞轮牵引 |
| 夹口 | lx = 0，0.15 → **6.55 m/s** | 轮缘线速度 8.143 m/s → 传递比 **0.804** |
| 出口 | **6.53 m/s @ 50.2°** | 同高度射程 **4.28 m** |

## 三、飞轮转速阶梯（拨杆 200 rpm，球从停位起飞）

| 飞轮转速 | 出射速度 | 出射角 | 同高度射程 | 出口/轮缘 |
|---|---|---|---|---|
| 810 rpm | 3.60 m/s | 50.8° | 1.29 m | 0.81 |
| 1620 rpm | 6.53 m/s | 50.2° | 4.28 m | 0.80 |
| 2430 rpm | 8.67 m/s | 51.0° | 7.49 m | 0.80 |

与 V1 几何的 `FINDINGS_zh.md` 数据完全吻合 → **V2 的改动没有损失发射性能**。

## 四、拨杆转速门槛（本轮关键新发现）

| 起始条件 | 拨杆转速 | 结果 |
|---|---|---|
| 球已在唇口停位 | 100 rpm | **失败**：送到 182° 后卡死 |
| 球已在唇口停位 | 105 / 110 / 115 / 200 rpm | 全部成功发射 |
| 球从托板 x = 145 进料（8 个初始相位） | 140 rpm | **2/8 成功**，其余卡在 131°–179° |
| 球从托板 x = 145 进料（8 个初始相位） | 200 rpm | **8/8 成功** |
| 球从托板 x = 120…145 进料 | 200 rpm | 全部成功发射 |

- **停位起飞**门槛在 100–105 rpm 之间；
- **托板接球**门槛在 140–200 rpm 之间，**推荐 ≥ 200 rpm（3.3 rev/s）**；
- 从托板接球之所以更费力：球是在 r ≈ 98 处被**叶片端角**擦到，接触几何比停位时差，
  低转速下会卡在罩壁与叶片之间。

## 五、已知限制与假设（不得据此发布制造结论）

1. **ASSUMED**：拨杆力矩用 `forcerange = ±1.5 N·m` 的速度执行器近似 —— **本报告“转速门槛”
   结论的最大不确定来源**。必须用真实舵机的扭矩—转速曲线复核“200 rpm 能否输出足够扭矩”。
2. **ASSUMED**：拨杆叶片按**刚体**建模，未建 zip-tie 弹性。真实叶片会变形，抓球与夹持行为
   会改变，低转速下的卡死有可能被弹性缓解。
3. **ASSUMED**：球质量 0.06 kg、球摩擦 1.0（`priority` 覆盖托板摩擦）。球质量会直接改变
   自滚速度与夹口传递比。
4. **SIMULATED**：外罩用 24 段 box 链近似曲面（MuJoCo 只支持凸碰撞体），壁内滚动含轻微折角。
5. **SIMULATED**：飞轮用 velocity 执行器 + kv 近似电机，未含电机堵转/恢复特性。
6. 模型无地面与接球网；出射后的飞行段只用于读出口状态，不作为落点预测。

## 六、待用户确认 / 下一步建议

- 需要确认：舵机在 200 rpm 处的可用扭矩（或实际传动比）——这条不确认，送球可靠性无法关闭。
- 可选优化（若要把门槛降到 ~150 rpm）：把叶片端角半径从 62.4 减到 ~57，或让球在
  x ≈ 120 处以更高速度进入抓取区（加长/加陡托板末段）。

## 七、本轮产物

- 脚本：`simulation/mujoco/pollen_v2_sim.py`（仿真主体），
  批量运行/分析脚本与绘图脚本在 `simulation/mujoco/_work/`（gitignore）。
- 数据：`simulation/mujoco/out/trace_v2_*.json`、`summary_v2_*.json`。
- 图：`simulation/mujoco/out/v2_fullflow_zh.png`、`v2_flywheel_ladder_zh.png`。

## 六、T06 POLLEN V2 舵机选型校核与接触几何分析（2026-10-03）

- 用户指令（KNOWN）：核对 REV SRS V2 舵机规格是否满足 V2 送球段要求；若不满足，给出改善接触几何的方法。
- 舵机规格（KNOWN，用户提供规格图）：SRS V2 Balanced 6 V / 7.4 V → 13.5 / 16.7 kg·cm，0.14 / 0.12 s/60°；SRS V2 UltraSpeed 6 V / 7.4 V → 5.6 / 6.2 kg·cm，0.043 / 0.035 s/60°。换算 @7.4 V：Balanced 堵转 1.638 N·m、空载 83.3 rpm；UltraSpeed 堵转 0.608 N·m、空载 285.7 rpm。
- 送球需求（SIMULATED，本轮实测）：拨杆力矩门槛 ≈ **1.0 N·m**，且在 140–200 rpm 区间**基本不随转速变化**（105 rpm 即使给 1.5 N·m 也不发射，属转速受限，不是 torque 受限）→ 该需求是"球被夹住后的起步/突破力"，不是惯性力。
- 峰值扭矩（SIMULATED）：200 rpm 自由跑峰值 1.71 N·m，恰等于执行器 `kv·ω = 0.08 × 20.94 = 1.675`，即**拨杆在接球瞬间被完全卡停**；峰值与叶尖形状无关（5 种叶尖方案实测 1.69–1.72 N·m），说明缩短叶尖不能降低需求。
- 卡停机理（SIMULATED，接触对实测）：球在停位仅由 `tray` + `shell_lip_face` 支撑（V 形硬窝，球底距托板仅 0.07 mm）；峰值帧球同时接触 `paddle_blade`、`paddle_flex`、`tray`、`shell`、`shell_lip_face`、`strut` → 球被"叶片 + 固定件"多面夹持。
- 判定（CALCULATED）：**两型号均不满足直接驱动**。Balanced 扭矩够（1.638 > 1.0，余量 1.6×），但在该扭矩下转速仅约 22 rpm，远低于 105 rpm 下限；UltraSpeed 转速够（286 > 105），但堵转 0.608 < 1.0。所需机械功率 ≈ 1.0 N·m × 105 rpm ≈ 11 W（200 rpm 时 ≈ 21 W），该级别舵机理论极限（堵转 × 空载）仅 14–18 W、可用值约 5 W → 单只 SRS V2 无法直接驱动该送球段；需求点落在舵机扭矩—转速线段之外，减速比也无法解决。
- 改善接触几何方案（ASSUMED，待仿真验证）：A 225° 挡墙改斜楔/圆弧过渡，让球平滑导入外罩；B 托板末端缩进 10–15 mm 并下倾，使球窝下方让空；C 叶片前缘卸载（球还在托板上的 300°–330° 区段外缘半径 ≤ 58.4）+ 端角倒圆；D 球窝改单侧斜坡"逃逸窝"，只留托板 + 与出球方向相切的斜面。
- 产物（KNOWN）：`simulation/mujoco/out/servo_verdict_zh.png`、`contact_fix_options_zh.png`、`summary_v2_torque_detail.json`、`summary_v2_servo_req.json`、`summary_v2_blade_variants.json`。

## 七、方案逐个仿真对比与指片布置发现（2026-10-03，复跑确认）

### 7.1 方法
- 模型：`simulation/mujoco/pollen_v2_sim.py` V2 外罩 + 5 deg 托板；球 R35.56、m=0.060 kg（ASSUMED）。
- 工况：拨杆 200 rpm，球从托板 x=145 滚入；门槛用二分法求"能把球送到外罩并发射"的最小 `forcerange` 限幅，分辨率 0.05 N·m。
- 复跑：本轮全部方案现场逐个复跑，数字与上一轮逐项一致（下表 `SIMULATED`）。

### 7.2 接触几何方案门槛（单个改动的净效果）
| 方案 | 改动 | 门槛 N·m | 相对现状 | 稳健(2 进料点) | 判定 |
|---|---|---|---|---|---|
| V0 现状 | — | 0.94 | 基准 | 2/2 | 基准 |
| A 唇口喇叭 | 删 225 deg 挡墙，替 3 段 227.5/231.5/235.5 deg 斜楔 (r_in 95.5/99.5/103.5) | **0.72** | **-23%** | 2/2 | 有效 |
| B 托板缩进 | 托板末端从 -56 缩到 -12 | 0.94 | 0 | 2/2 | 无效 |
| C 叶尖卸载 | 叶片外缘半径 62 → 56 | 1.25 | **+33%** | 2/2 | 恶化 |
| D 球窝抬高 | 托板末端加 6.8 mm 垫抬高球心 | **0.68** | **-28%** | 2/2 | 有效 |
| A+B | — | 0.72 | -23% | 2/2 | 同 A，B 无用 |
| A+D | — | 0.64 | -32% | **1/2** | 门槛最低但稳健性掉 |

- 结论：只有**唇口几何（A）**和**球窝高度（D）**是杠杆；B、C 为负结果，归档不采用。
- C 恶化的原因（SIMULATED）：叶尖变矮后球在 320-330 deg 区段失去约束，反而更深地楔进托板/外罩夹角。

### 7.3 真正的杠杆：指片数量与相位
| 方案 | 门槛 N·m | 转速门槛 | 稳健 |
|---|---|---|---|
| P0 三指 342/222/102（现状） | 0.94 | 120-140 rpm | — |
| P1 三指 240/120/0 | 0.99 | — | — |
| P2 三指 154/34/274 | 1.03 | — | 停位漂移 0.17 mm |
| R1 二指 350/170 | 0.55 | 105 rpm | 2/2 |
| **R2 二指 350/170 + A** | **0.46** | **90 rpm** | **2/2** |
| **R5 二指 350/170 + D** | **0.42** | **90 rpm** | **2/2** |
| R3 二指 350/170 + A + D | 0.42 | 90 rpm | 2/2 |
| R4 三指原相位 + A + D | 0.64 | 75 rpm | 1/2 |

- 机理（SIMULATED，关键发现）：现状三指 120 deg 相位下，球**根本滚不到唇口**——球沿托板滚到 x=112（θ=330 deg）就撞在**指片尖端平面**上停住，球心 r=95.5 mm，而设计轨道是 R58.4 mm。所以送球完全靠叶尖"拖拽 + 硬夹"，效率极低，这才是 0.94 N·m 的真正来源。
- 改为**二指 180 deg 对置、θ=350/170** 后，指片停位让出球道，球能自由滚到唇口再被抬起 → 门槛直接降到 0.55，叠加 A 后 0.46。

### 7.4 摩擦敏感性（反杠杆）
- μ_ball 1.0 → 0.94 N·m；0.7 → 1.16；0.5 / 0.35 → **>1.6，不发射**。
- 即"球越滑越送不进去"：因为拨杆仍靠摩擦拽球，降低摩擦反而恶化送球。
- μ_shell 0.10 无影响（球 geom `priority=1` 覆盖了外罩摩擦设置）。

### 7.5 与舵机包络对照（边界可行）
- SRS V2 Balanced 7.4 V：堵转 1.638 N·m、空载 83.3 rpm。A+D 的 0.64 在扭矩上够，但 83 rpm < 90-105 rpm 下限 → 不满足。
- SRS V2 UltraSpeed 7.4 V：堵转 0.608 N·m、空载 285.7 rpm。线性模型 @90 rpm 可用扭矩 **0.416 N·m**。
- R2 (0.46) / R5 (0.42) 的门槛**刚好压在 UltraSpeed 曲线边界**，属"边界可行"——必须台架实测确认，**不得据此判定单只 SRS V2 直驱安全**。

### 7.6 本轮产物
- `simulation/mujoco/out/geom_options_verdict_zh.png`（六面板总图）
- `summary_v2_options_final.json`（几何 + 摩擦 + 轨迹）、`summary_v2_phase.json`（指片相位）、`summary_v2_speed.json`（转速门槛）、`summary_v2_best.json`（R1-R5 权威复核）、`summary_v2_rerun_opts.json`（本轮复跑）
- `_work/opt_lib.py`（方案库：`run/threshold/ok/GEOM`）、`_work/plot_verdict_zh.py`、`_work/best_probe2.py`
