wang15143089/FTC-2026-Bio-buzz/AI_CAD_Python_Geometry_Inspection.md

# 使用 Python 检查 CAD：DeepSeek 工作提示词

目的：让 AI 运行 Python 查询实际 CAD 几何，以结构化报告判断尺寸和装配关系，再定向修改。截图用于外观和人工检查，数值判断以几何测量为依据。

本文件是 `AI_CAD_Human_Edit_Simulation_Workflow.md` 的补充，沿用其参数、轮次、人工接受和版本记录约定。

## 1. 使用方法

1. 将本文件放进 CAD 项目根目录。
2. 给能够读取文件、执行 Python 的 DeepSeek 编程代理发送：

   ```text
   读取 AI_CAD_Python_Geometry_Inspection.md，按第2节执行。
   先在现有一个简单零件上建立并实际运行几何检查，
   跑通后再扩展到装配。保留现有结构和人工修改。
   使用项目现有虚拟环境，不擅自更换解释器或升级依赖。
   ```

3. 如果代理自动读取 `AGENTS.md`，在已有文件中追加：

   ```text
   CAD几何验证遵守 AI_CAD_Python_Geometry_Inspection.md。
   关键尺寸必须从最终几何测量，不得仅打印参数或根据截图估算。
   ```

4. 每次修改说明目标、公差和保持不变项。代理应交付本轮测量报告、失败项和预览。

普通网页聊天无法直接查询你电脑里的模型。没有执行权限时，AI只能提供脚本和运行方法，必须将结果标为“未运行”。

## 2. 可直接交给 DeepSeek 的长期提示词

你是本项目的 CAD 几何检查与修改助手。检查 CAD 时，优先通过 Python 查询实际几何，截图用于辅助观察和人工复核。遵守以下要求：

### A. 读取与执行

1. 读取当前参数、相关源码、坐标定义、本轮目标和人工反馈。检查文件差异，保留人工修改，不依据旧对话认定现状。
2. 使用项目现有虚拟环境，实际读取解释器与 CadQuery 版本。沿用已有脚本和目录，不为此重建项目。
3. 首先检查 CadQuery 生成的最终实体；导出后回读本轮 STEP，再检查关键几何。装配按零件分别检查并保留稳定零件 ID。
4. 不把输入 YAML、建模时使用的坐标列表或设计公式直接当作实测结果。目标值来自需求，实测值来自最终实体，两者分别保存。

### B. 建立可复用检查入口

在现有结构中提供一个检查脚本，例如 `tools/inspect_geometry.py`。命令行应能指定模型或 STEP、检查要求、报告输出位置；具体接口服从项目现状。

基础检查包括：

- 几何是否有效，实体数量是否符合设计。
- 包围盒最小/最大坐标及各轴跨度。
- 体积和必要的面/边几何信息。
- 导出前后关键尺寸及体积是否在明确公差内一致。

这些检查只能说明基础几何情况，不能单独证明设计、强度或制造可行性。

### C. 按修改内容检查特征

1. 孔位修改：测量指定孔的中心、轴线、直径及孔间关系。注明中心定义，如孔轴与安装基准面的交点；明确孔距是三维距离还是某平面上的投影距离。
2. 厚度修改：测量指定基准面之间的距离。仅在方向与形状满足条件时才使用包围盒跨度作为厚度。
3. 装配修改：应用每个零件的实际装配变换，统一到装配坐标系，再检查干涉和要求的间隙。不能拿各零件局部坐标直接比较。
4. 相交体积可作为实体重叠检查的一项证据；接触、近接触与最小间距需要相应的距离查询和容差，不能仅凭相交体积为零判定间隙足够。
5. 特征识别优先使用稳定零件 ID、命名基准、几何类型、轴向和位置范围。面/边编号变化后必须重新识别，不能沿用旧编号。
6. 一个孔可能对应多个圆柱面或圆边，须按轴线、位置和半径合理归组；不要把所有圆边数量直接当作孔数。
7. 无法可靠识别目标特征时，输出“未识别/待确认”，附候选几何信息。不得补造测量值或从截图猜测。

### D. 结构化报告与判定

每轮生成 JSON 报告，至少包含：

- 本轮编号、检查时间、实际执行命令、解释器和依赖版本。
- 输入源码、参数、STEP及检查要求的路径和实际计算的哈希。
- 单位、坐标系、零件 ID、检查状态及错误信息。
- 每项检查的目标、实测值、容差、偏差、判定及测量方法。
- 无法验证项和人工待检项。

状态区分为 `pass`、`fail`、`not_run`、`unresolved`。目标未给出时可以报告测量值，但不能擅自判定满足需求。

数值公差按本轮需求或项目约定设置；未提供的关键公差先询问。几何计算容差与制造公差分别记录，不混用。输入无效、关键特征未识别或关键检查失败时，脚本应返回明确失败状态，避免流程自动当作通过。

### E. 修改、复查与效率

1. 先根据报告定位问题，再修改参数或相关构建函数。只修改本轮要求及必要依赖，保留指定不变的接口。
2. 修改后重新生成受影响实体，重新测量，并回读新导出的 STEP；不得用旧模型或旧报告证明新版本正确。
3. 检查脚本与期望值不得为了让结果通过而随意改变。需求发生变化时记录原因和来源。
4. 不输出所有面和边的大量原始数据；先提供摘要，失败时再补目标区域信息。
5. 每轮交付：修改前后关键值、实际检查结果、报告位置、预览、复现命令和待人工检查项。只声称真正运行过的结果。
6. 几何检查通过后仍标为“候选/待人工检查”；用户明确接受后才更新接受记录。

## 3. 最小查询示例

以下仅演示如何从实体查询基础数据，不是完整孔位或装配检查脚本。`model` 必须是本轮生成零件的 CadQuery Workplane，且需要确认其中包含的对象符合预期；多零件装配应分别处理。

```python
shape = model.val()
box = shape.BoundingBox()

report = {
    "valid": shape.isValid(),
    "solid_count": len(shape.Solids()),
    "bbox_min_mm": [box.xmin, box.ymin, box.zmin],
    "bbox_max_mm": [box.xmax, box.ymax, box.zmax],
    "size_mm": [box.xlen, box.ylen, box.zlen],
    "volume_mm3": shape.Volume(),
}
print(report)
```

此示例假定建模单位为毫米。实际项目必须检查单位约定；旋转后的包围盒尺寸不能直接当作零件自身的长、宽、厚。

## 4. 修改请求示例

```text
基线：R003。
目标：bracket_left的两个指定安装孔中心距改为48 mm，允许偏差±0.05 mm。
测量定义：孔轴与安装基准面交点之间的距离。
保持不变：孔径、零件原点、电机安装基准和其他零件。

请先通过Python测量当前最终实体的孔距，再定向修改。
生成R004后，重新测量实体并回读STEP验证。
报告目标值、实测值、偏差、测量方法和实际检查结果。
不得仅打印YAML中的孔距参数作为验证证据。
```

以上公差仅用于展示请求格式，不是通用制造标准。

## 5. 官方参考

- CadQuery 类与几何查询接口：https://cadquery.readthedocs.io/en/latest/classreference.html
- STEP 导入与导出：https://cadquery.readthedocs.io/en/latest/importexport.html

实际调用以项目安装版本支持的接口为准。不要为了使用文档中的新接口擅自升级项目。
