wang15143089/FTC-2026-Bio-buzz/cad/output/_aprime_cradle_sections_zh.png

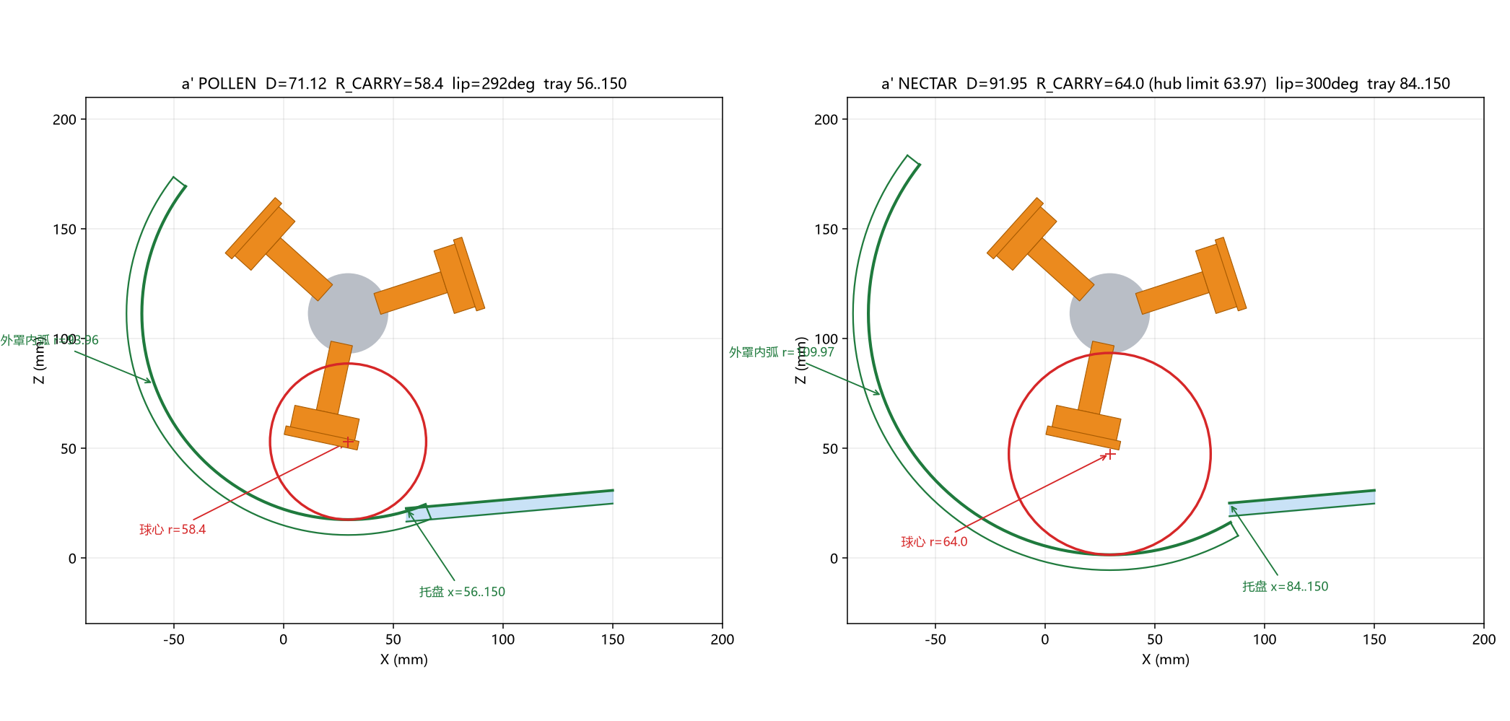
cad/output/_aprime_cradle_sections_zh.png
