wang15143089/FTC-2026-Bio-buzz/cad/output/_r23_gravity_handoff_zh.png

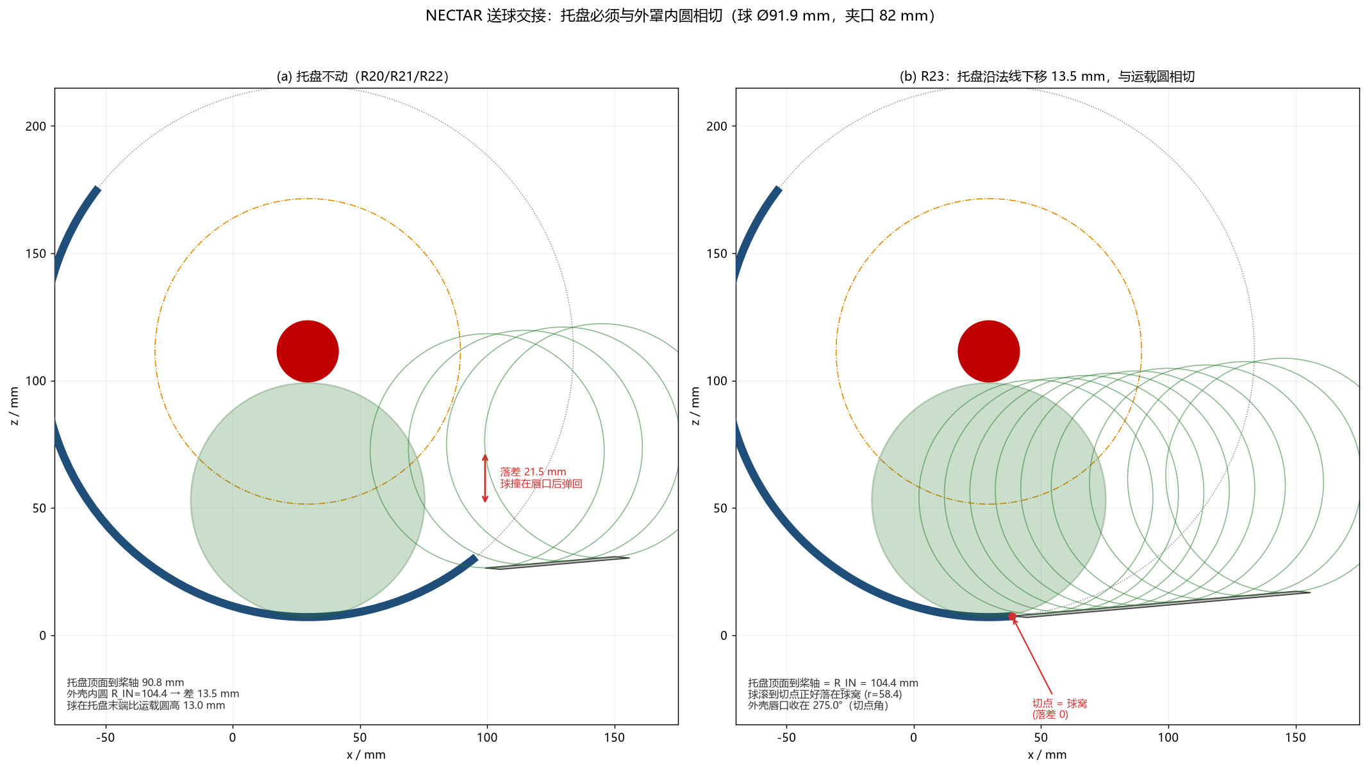
cad/output/_r23_gravity_handoff_zh.png
