wang15143089/FTC-2026-Bio-buzz/cad/output/_r25_nectar_final_zh.png

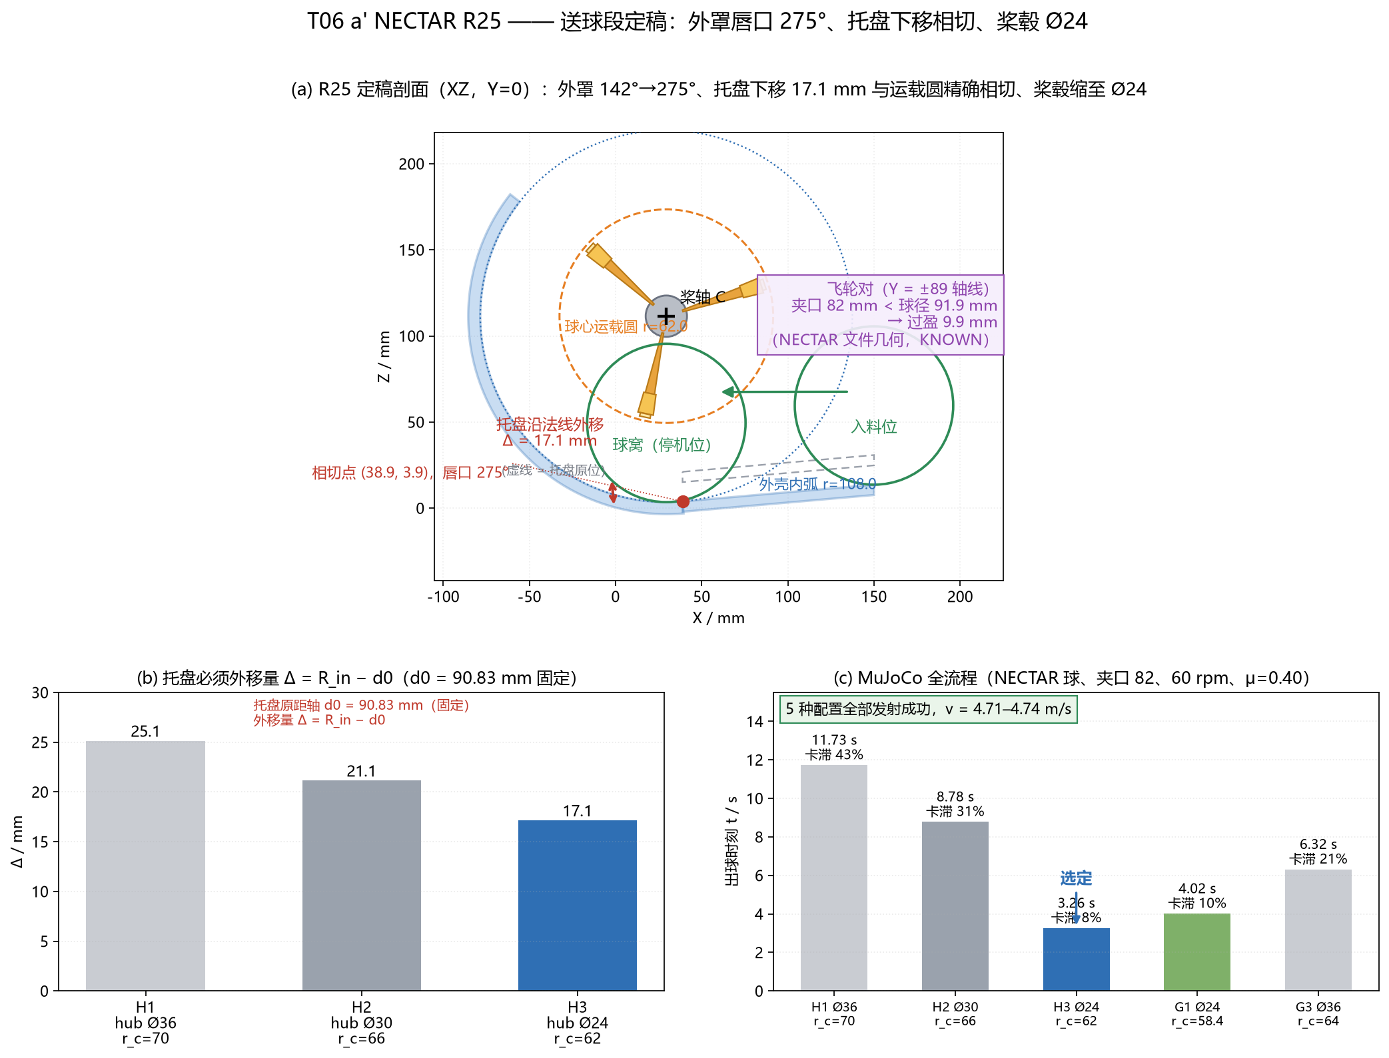
cad/output/_r25_nectar_final_zh.png
