wang15143089/FTC-2026-Bio-buzz/cad/output/_r49_gate/r49_gate_drive_view.png

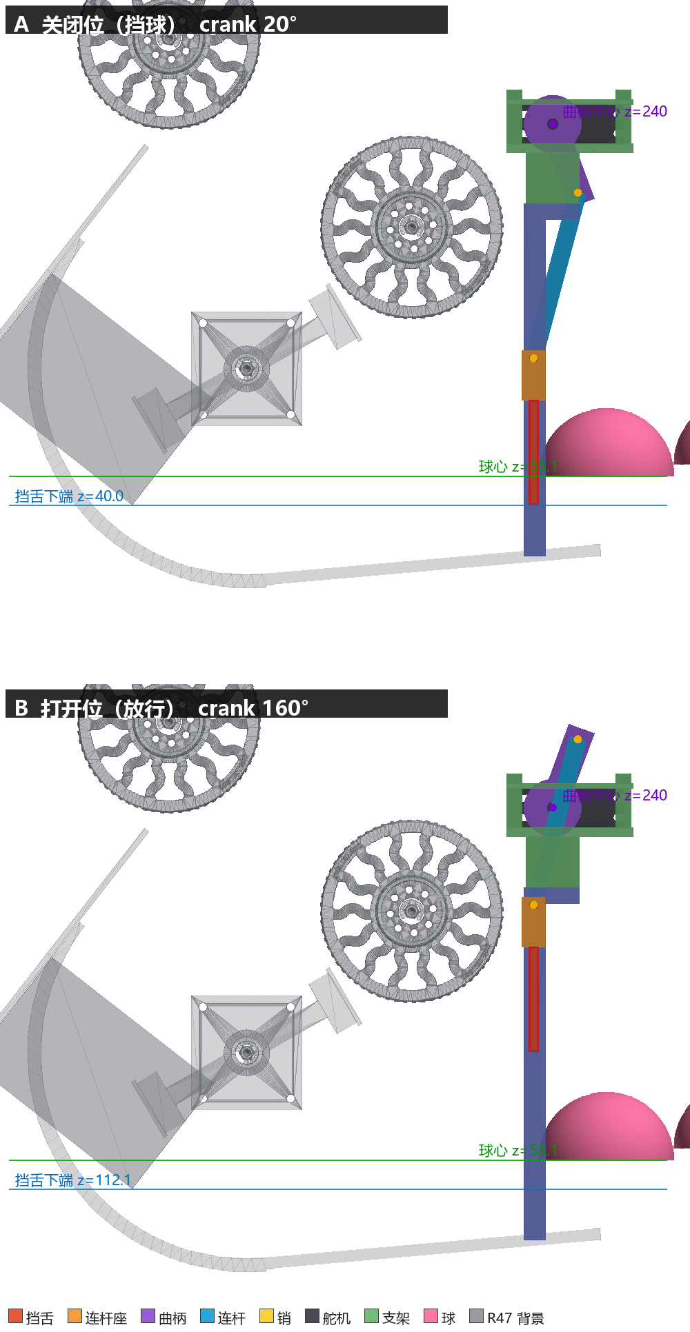
cad/output/_r49_gate/r49_gate_drive_view.png
