wang15143089/FTC-2026-Bio-buzz/cad/output/_r50_drive/r50_shooter_drive_view.png

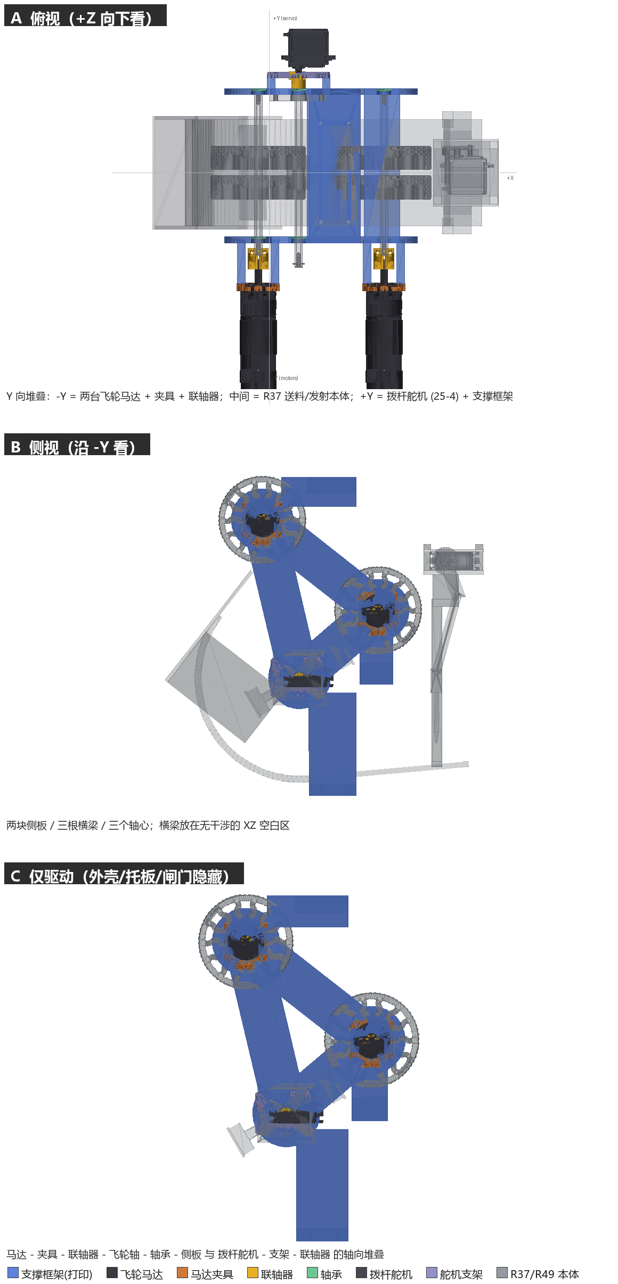
cad/output/_r50_drive/r50_shooter_drive_view.png
