wang15143089/FTC-2026-Bio-buzz/cad/output/_r51_base/r51_base_side_view.png

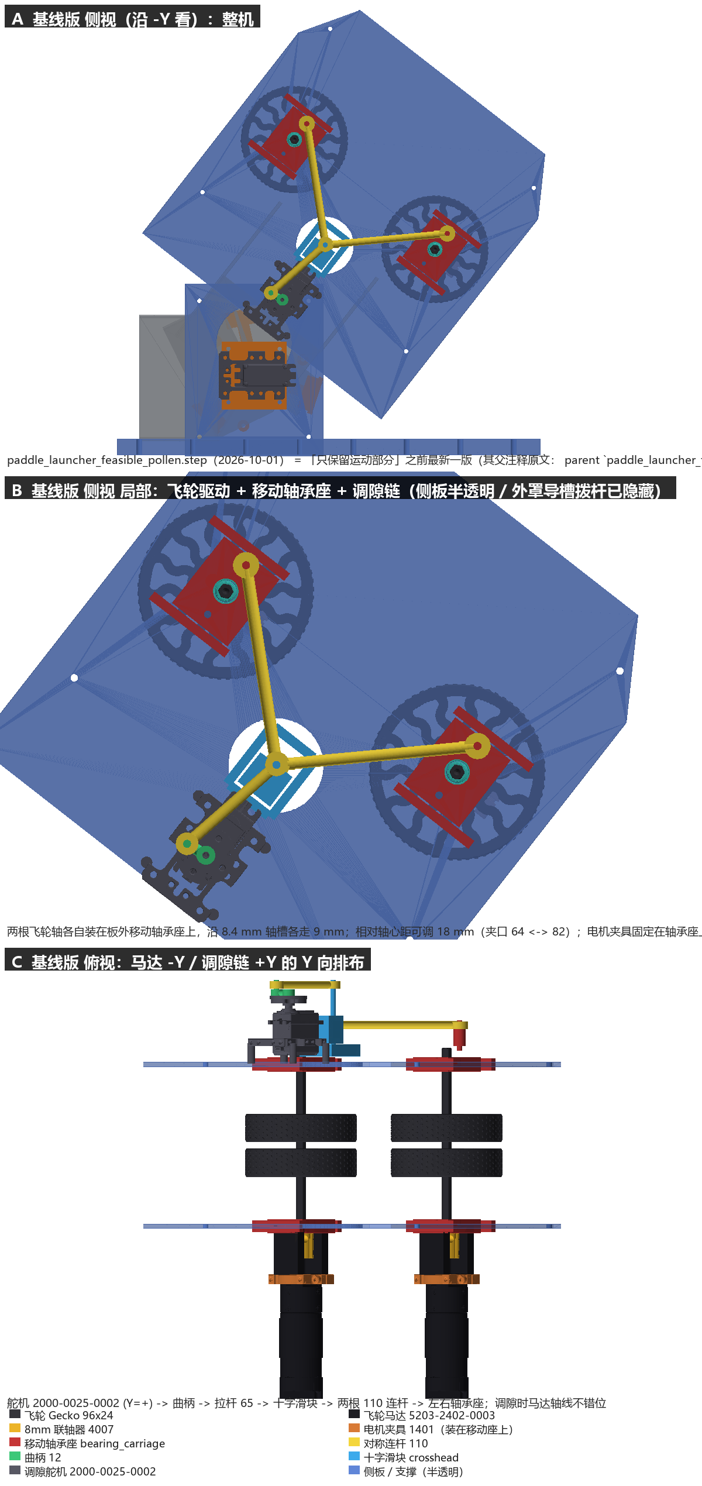
cad/output/_r51_base/r51_base_side_view.png
