wang15143089/FTC-2026-Bio-buzz/cad/output/_r51_drive/paddle_lineage_compare.png

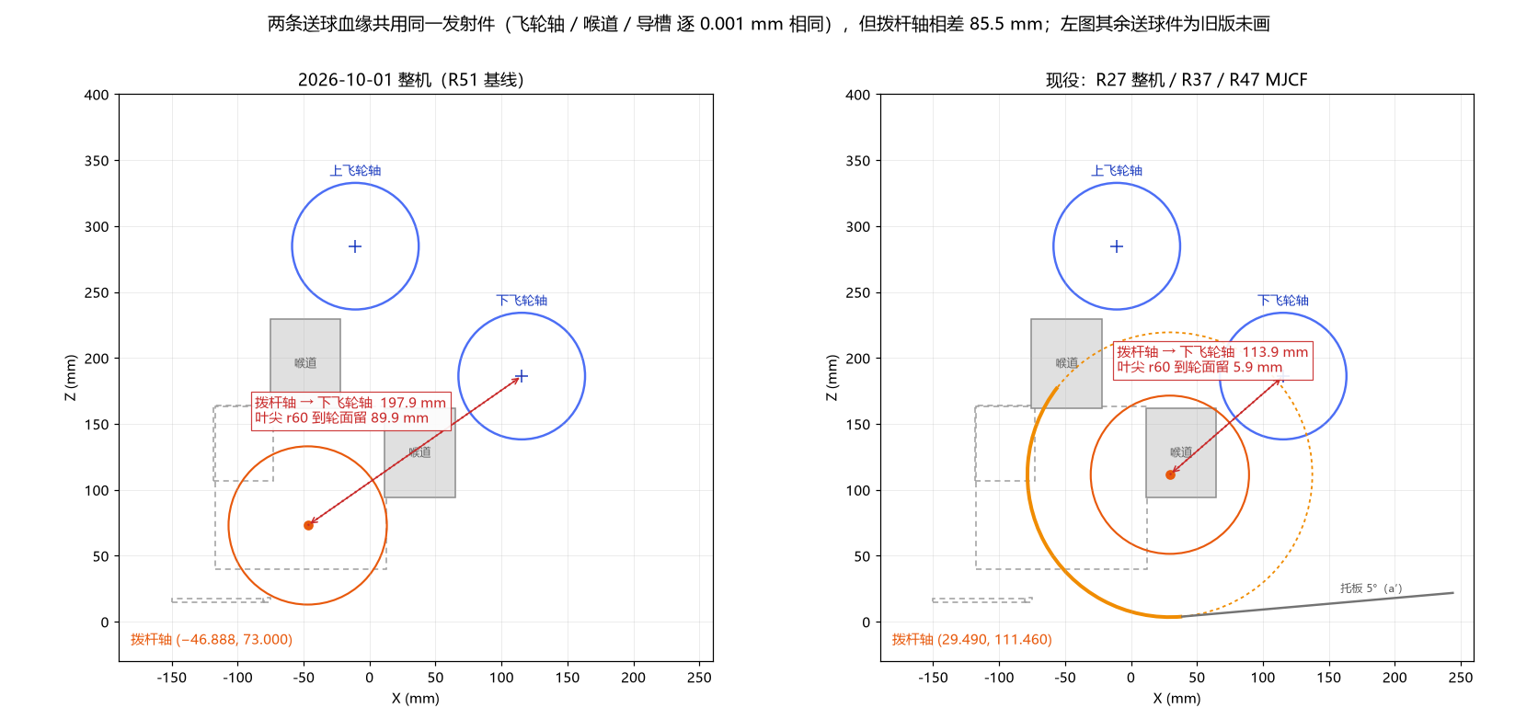
cad/output/_r51_drive/paddle_lineage_compare.png
