wang15143089/FTC-2026-Bio-buzz/cad/output/_r51_drive/r51_window_schematic.png

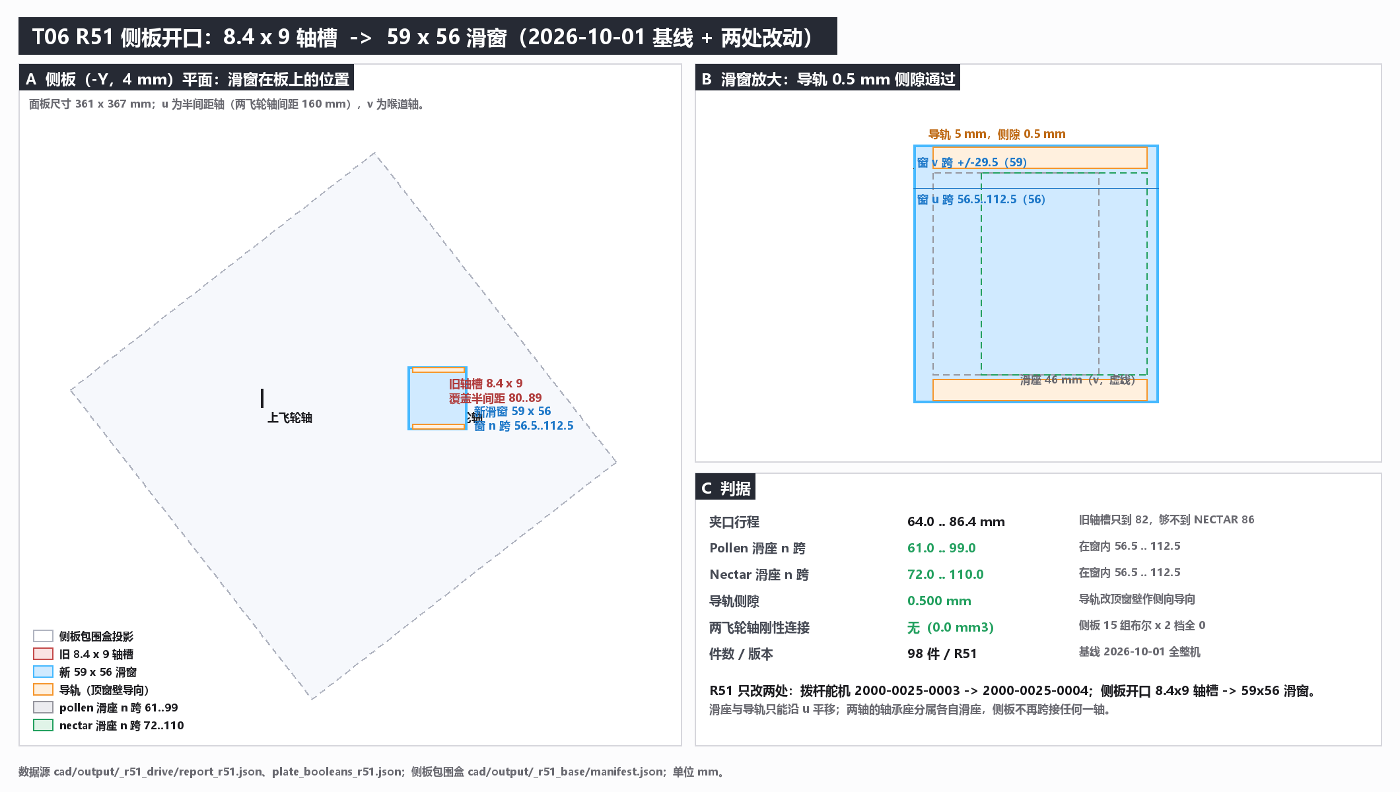
cad/output/_r51_drive/r51_window_schematic.png
