wang15143089/FTC-2026-Bio-buzz/cad/output/_r53_lock/r53_lock_section.png

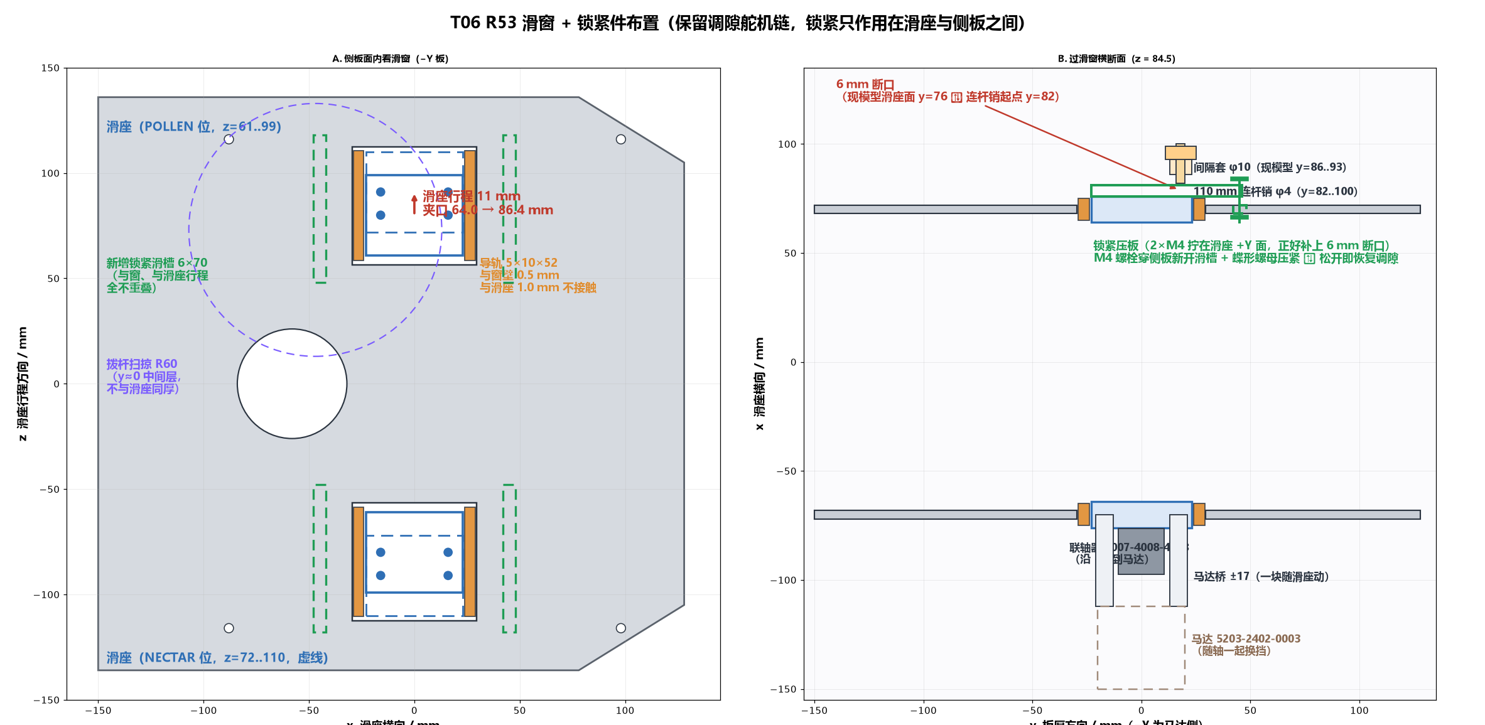
cad/output/_r53_lock/r53_lock_section.png
