wang15143089/FTC-2026-Bio-buzz/cad/output/_r53_lock/r53b_auto_lock_options.png

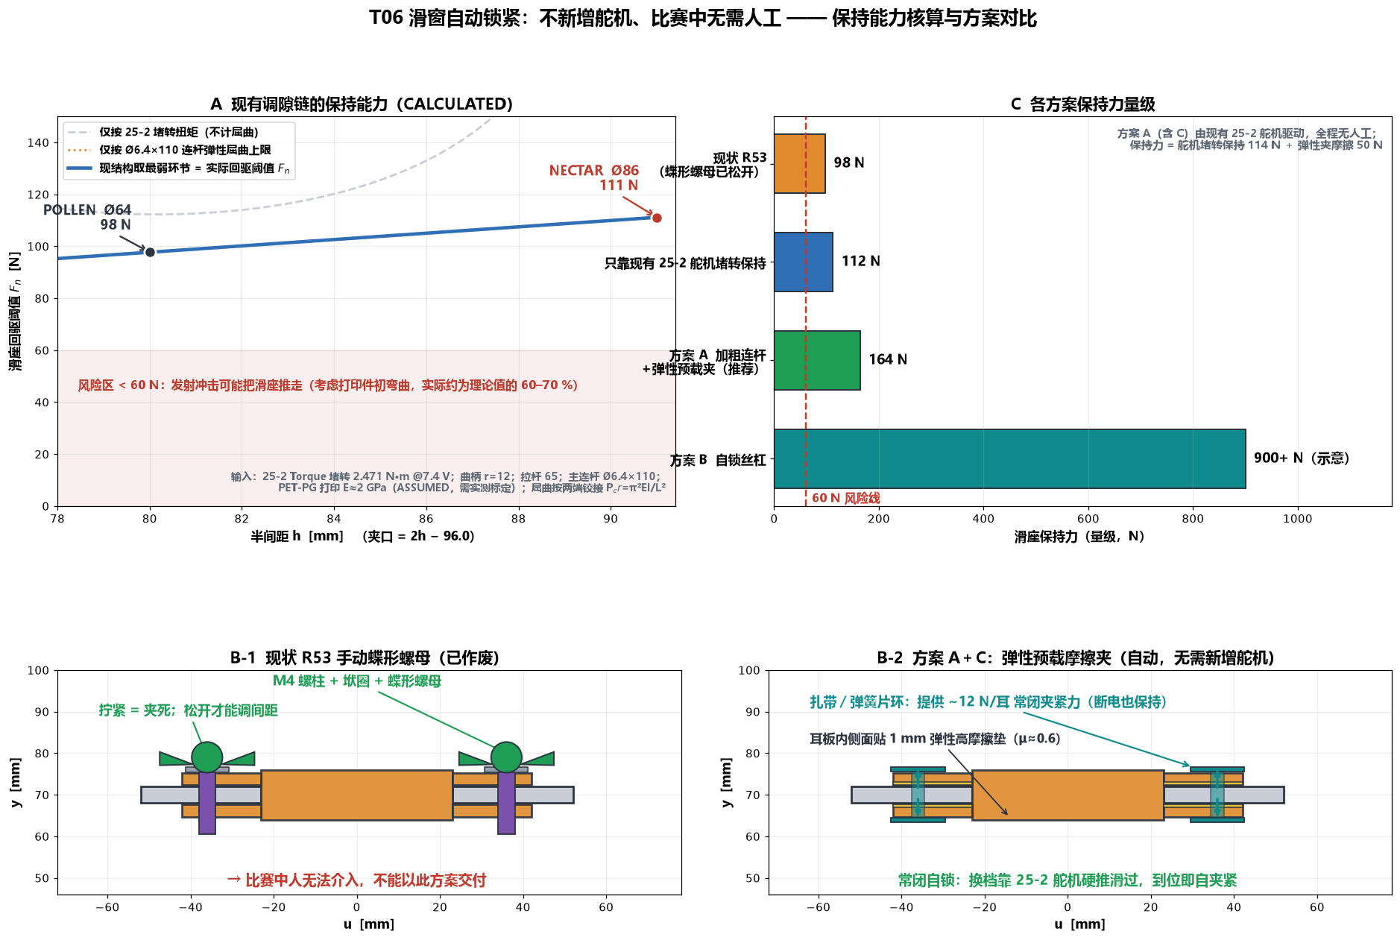
cad/output/_r53_lock/r53b_auto_lock_options.png
