wang15143089/FTC-2026-Bio-buzz/cad/output/_r53b_auto/r53b_clamp_section.png

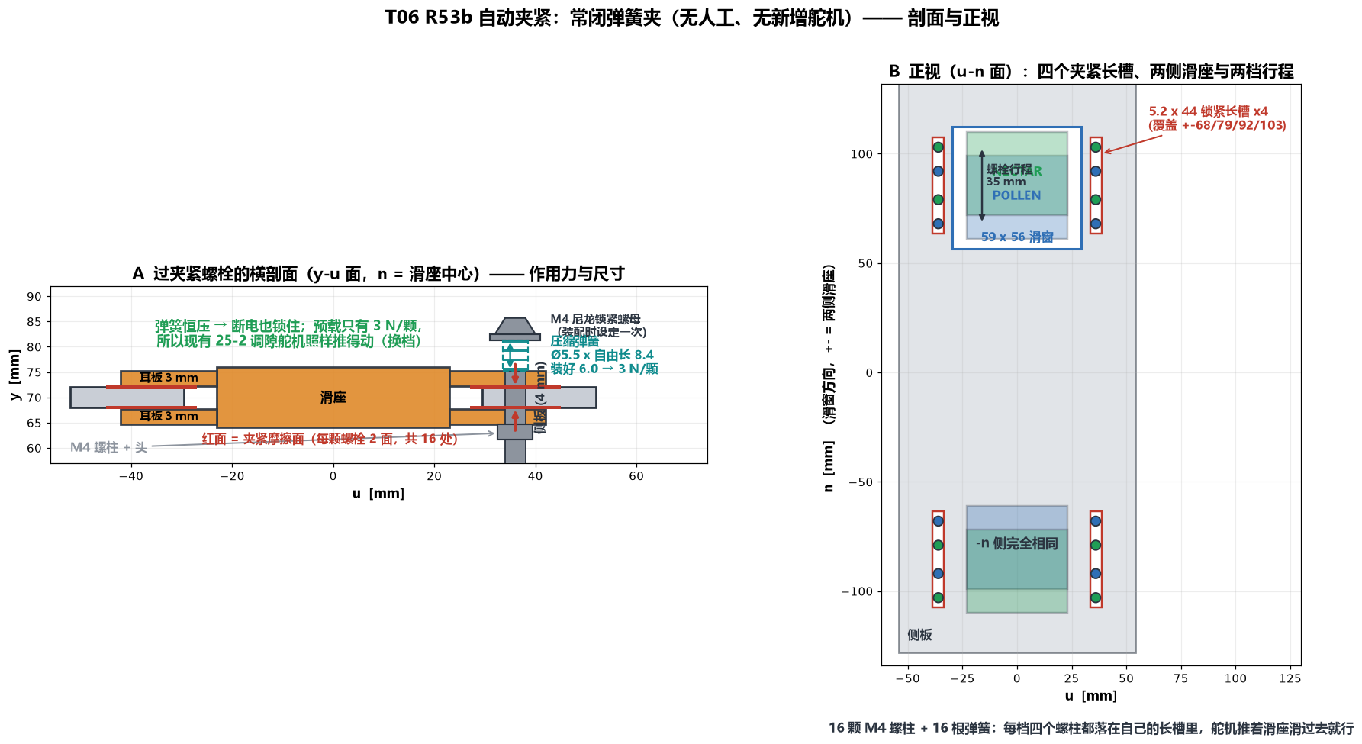
cad/output/_r53b_auto/r53b_clamp_section.png
