wang15143089/FTC-2026-Bio-buzz/cad/output/_r53c_stroke/T06_R53c_fullstroke_check.png

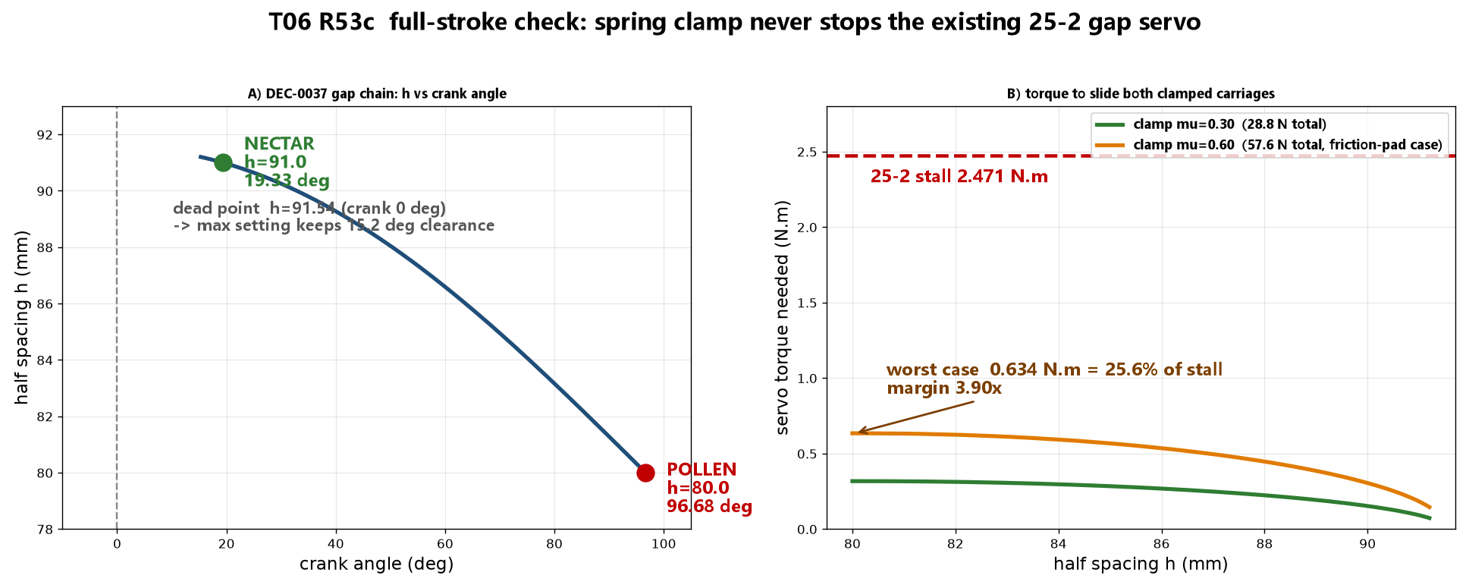
cad/output/_r53c_stroke/T06_R53c_fullstroke_check.png
