wang15143089/FTC-2026-Bio-buzz/cad/output/_r53d_dyn/T06_R53d_dynamic_check.png

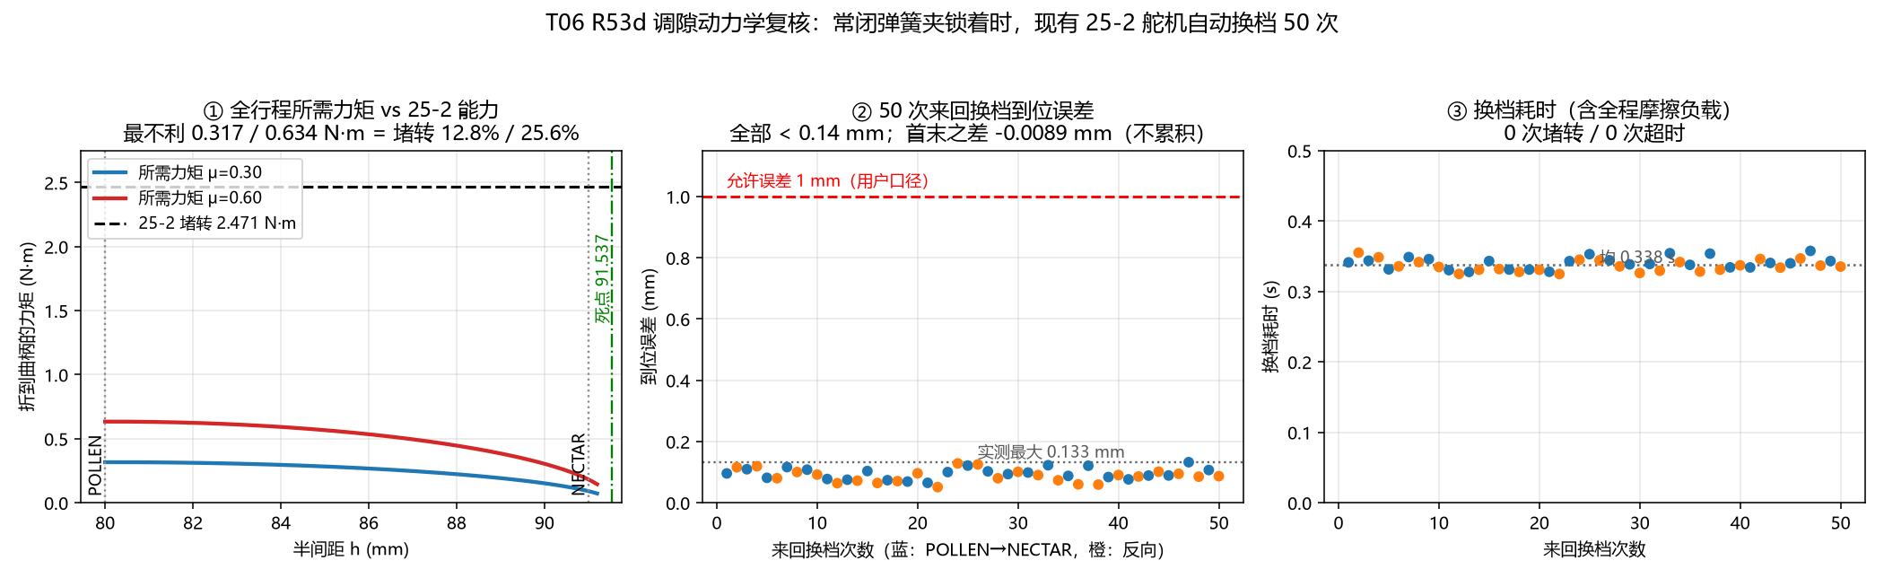
cad/output/_r53d_dyn/T06_R53d_dynamic_check.png
