wang15143089/FTC-2026-Bio-buzz/cad/output/_r53e_match/T06_R53e_match_cycle.png

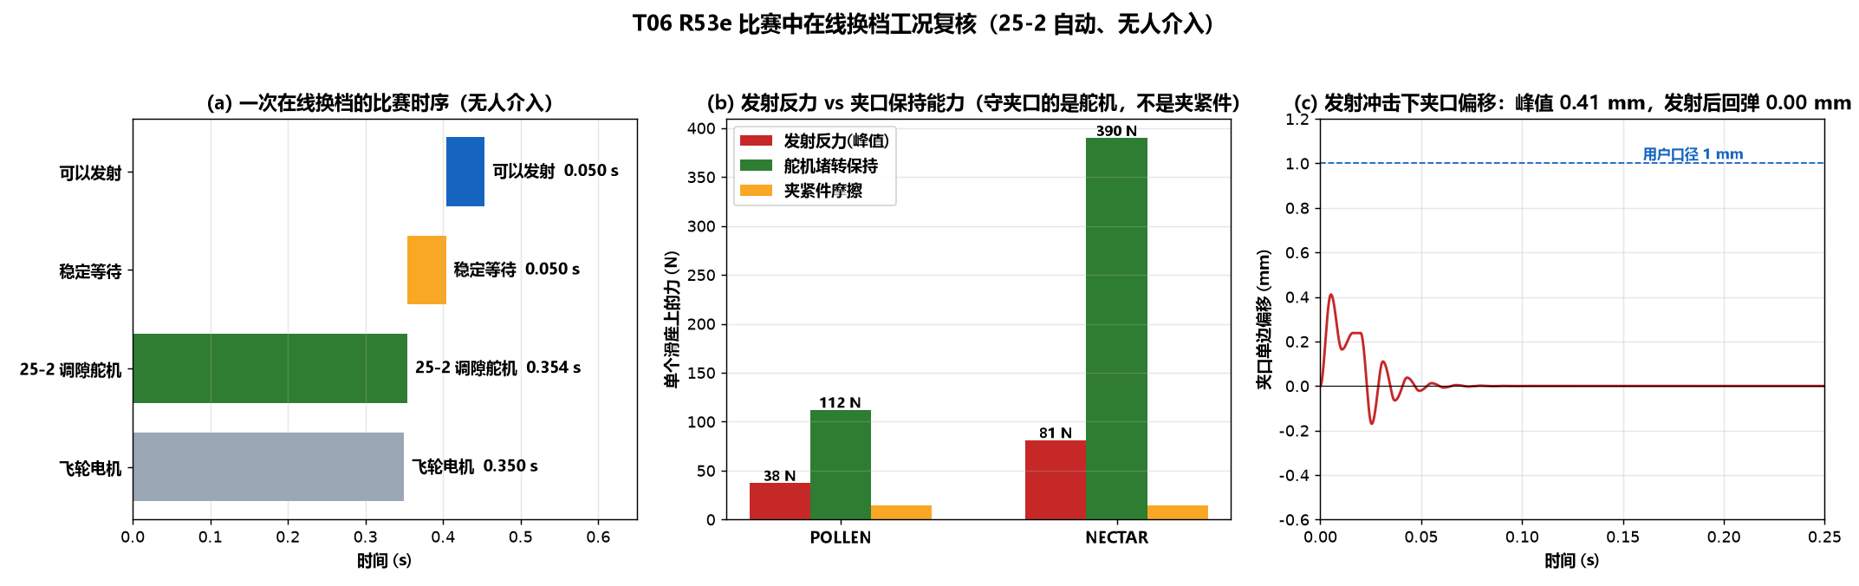
cad/output/_r53e_match/T06_R53e_match_cycle.png
