wang15143089/FTC-2026-Bio-buzz/cad/output/_r53f_lock/T06_R53f_限位环剖面.png

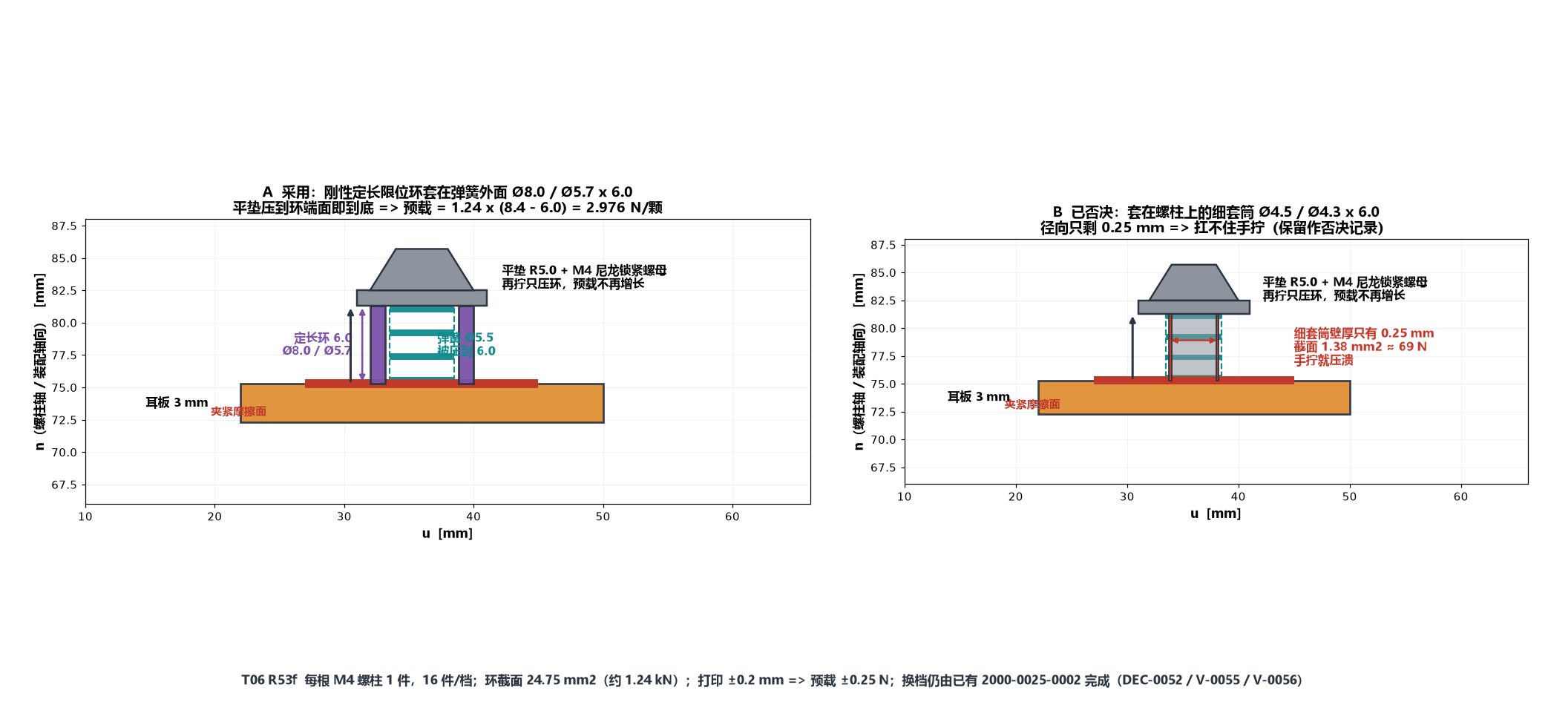
cad/output/_r53f_lock/T06_R53f_限位环剖面.png
