wang15143089/FTC-2026-Bio-buzz/cad/output/_r53g_limit/T06_R53g_preload_limit.png

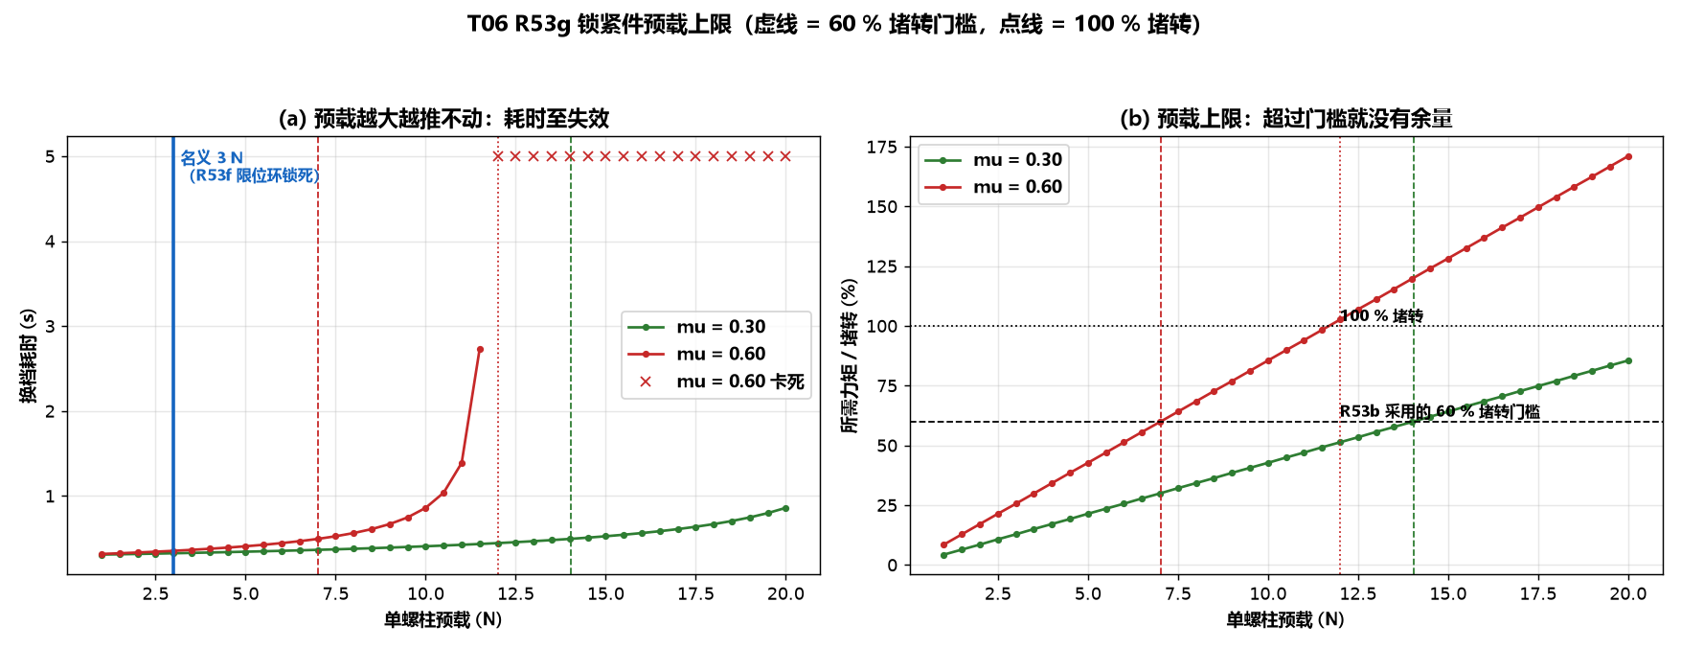
cad/output/_r53g_limit/T06_R53g_preload_limit.png
