wang15143089/FTC-2026-Bio-buzz/cad/output/_r54_frame/sections/r54_joint_schematic.png

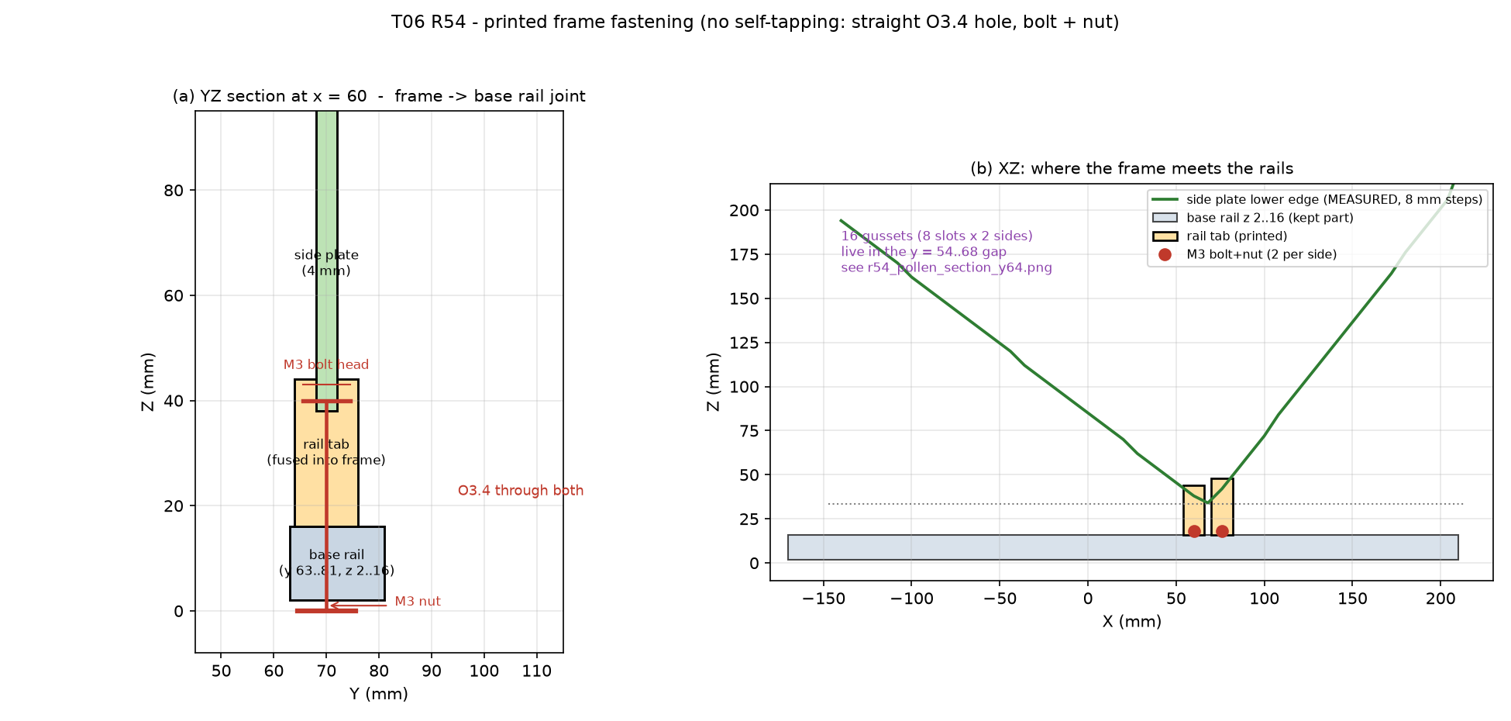
cad/output/_r54_frame/sections/r54_joint_schematic.png
