wang15143089/FTC-2026-Bio-buzz/cad/output/_r54_frame/sections/r54_pollen_section_y0.png

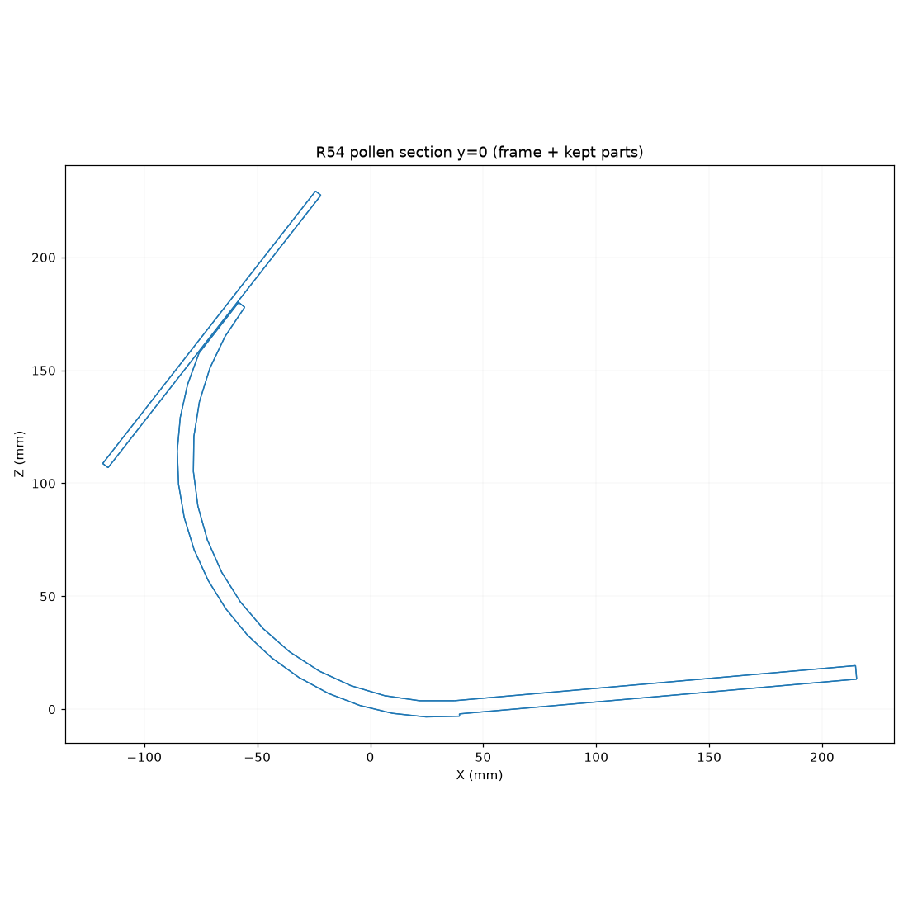
cad/output/_r54_frame/sections/r54_pollen_section_y0.png
