wang15143089/FTC-2026-Bio-buzz/cad/output/_r55_frame/sections/r55_pollen_joint_schematic.png

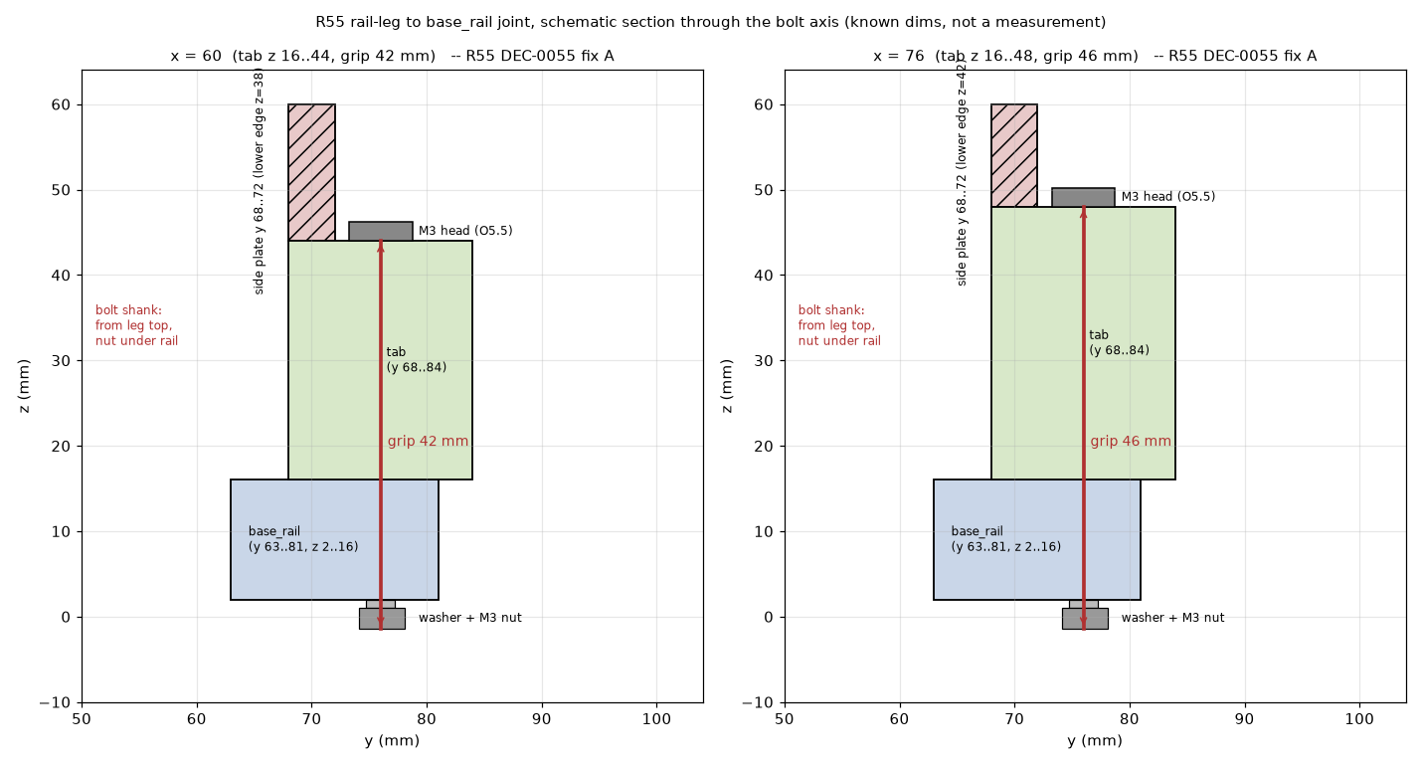
cad/output/_r55_frame/sections/r55_pollen_joint_schematic.png
