wang15143089/FTC-2026-Bio-buzz/cad/output/_r55_frame/sections/r55_pollen_section_y64.png

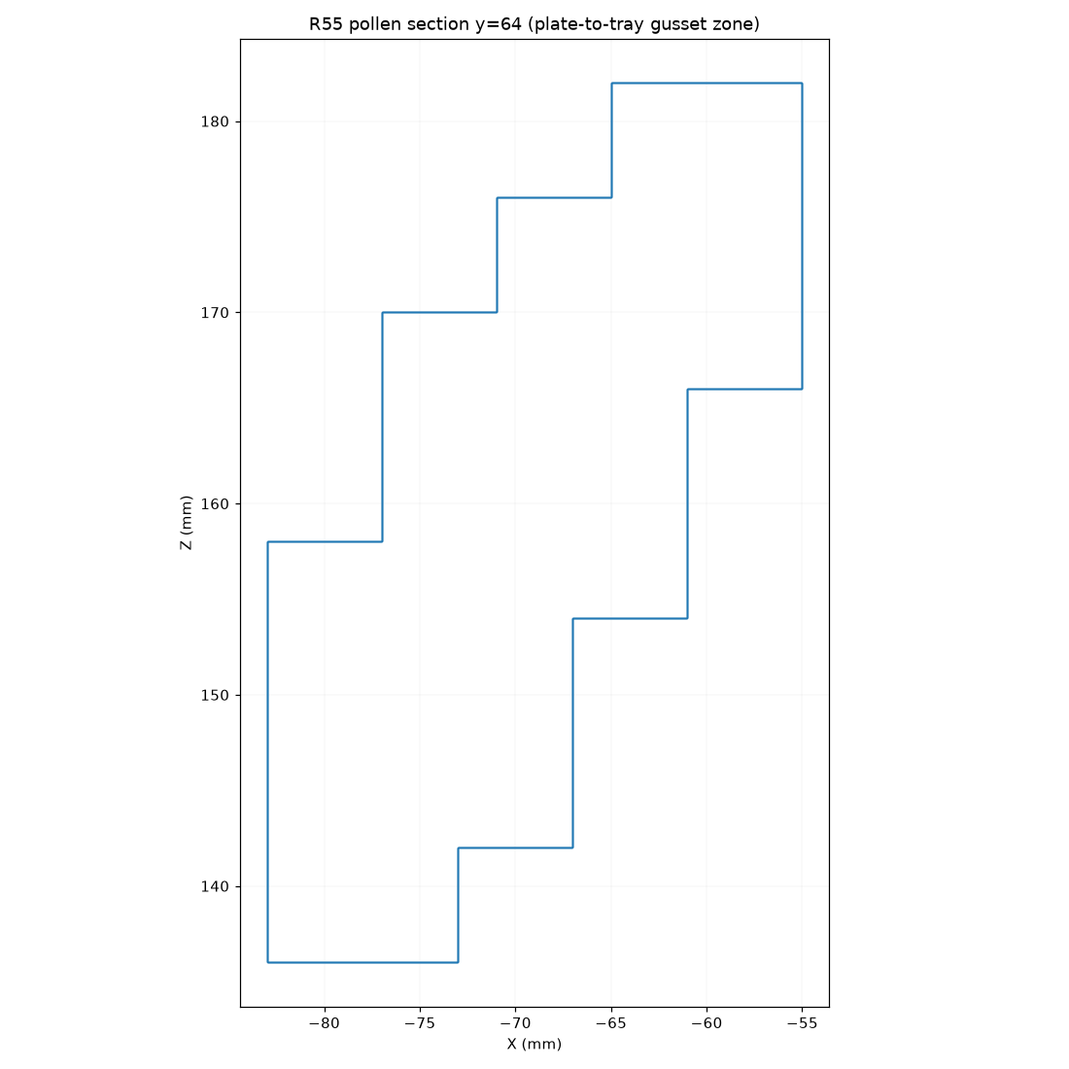
cad/output/_r55_frame/sections/r55_pollen_section_y64.png
