wang15143089/FTC-2026-Bio-buzz/cad/output/_r56_frame/split/r56_split_sections.png

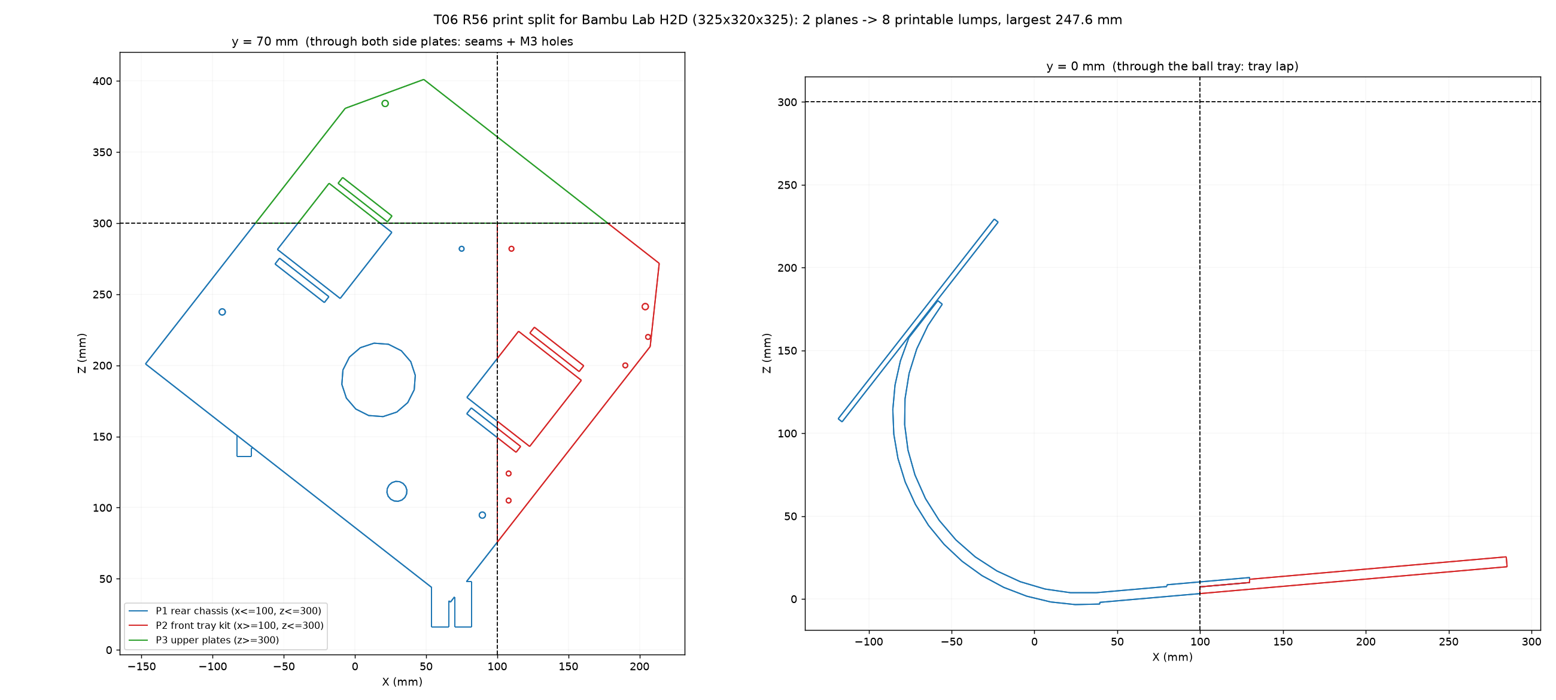
cad/output/_r56_frame/split/r56_split_sections.png
