wang15143089/FTC-2026-Bio-buzz/cad/output/_r57_plate/r57_floor_plate.png

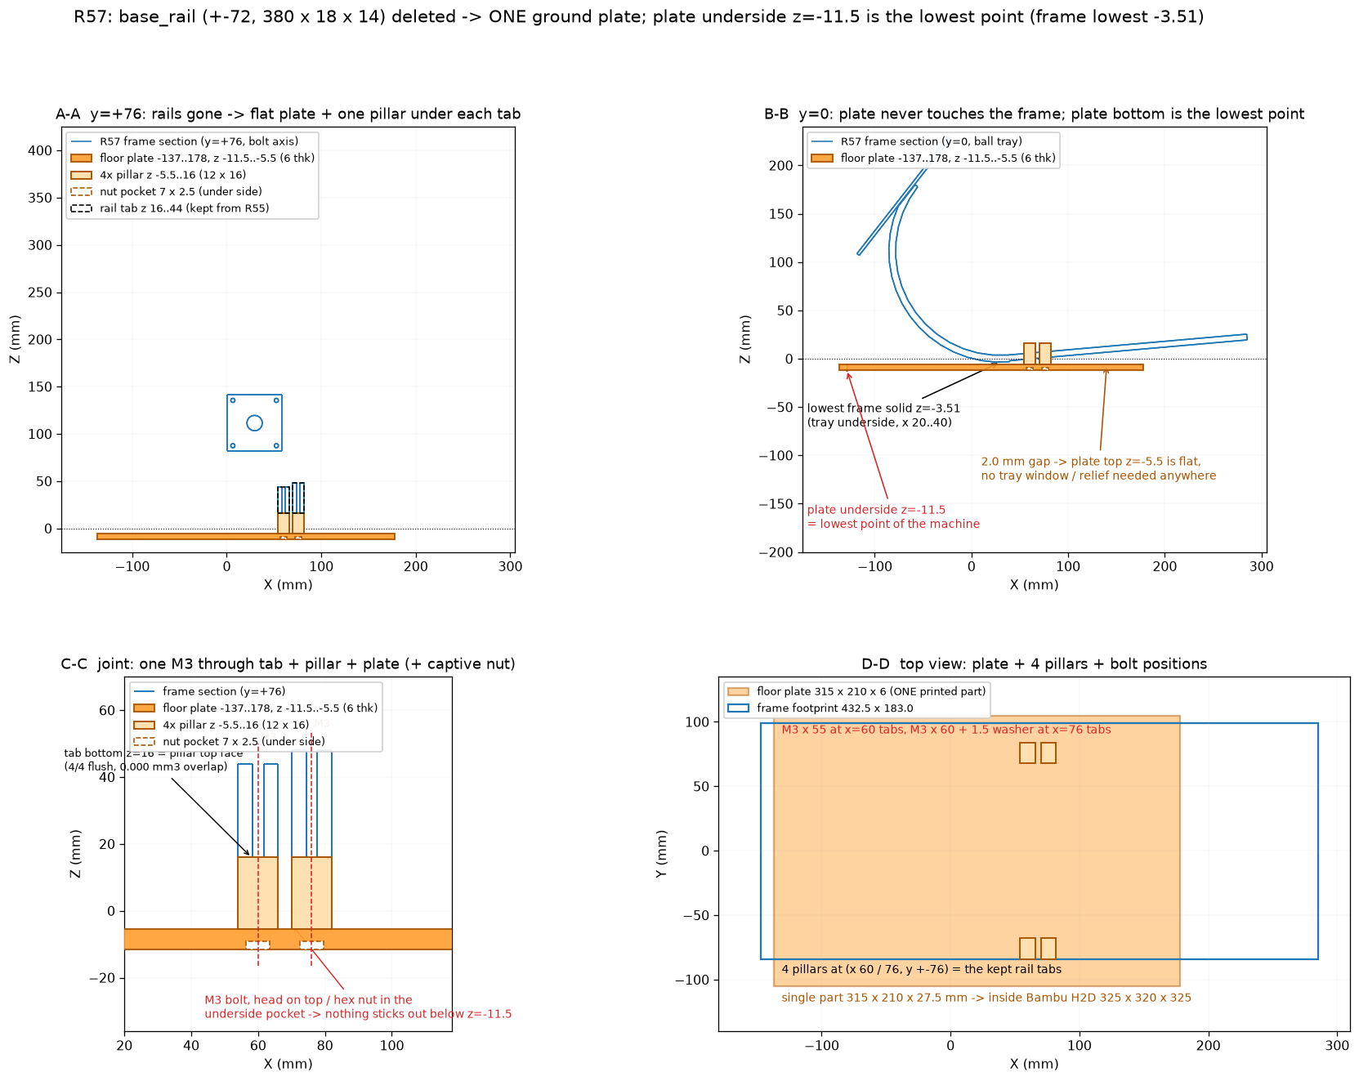
cad/output/_r57_plate/r57_floor_plate.png
