wang15143089/FTC-2026-Bio-buzz/cad/output/_r59_frame/sections/r59_pollen_section_y76.png

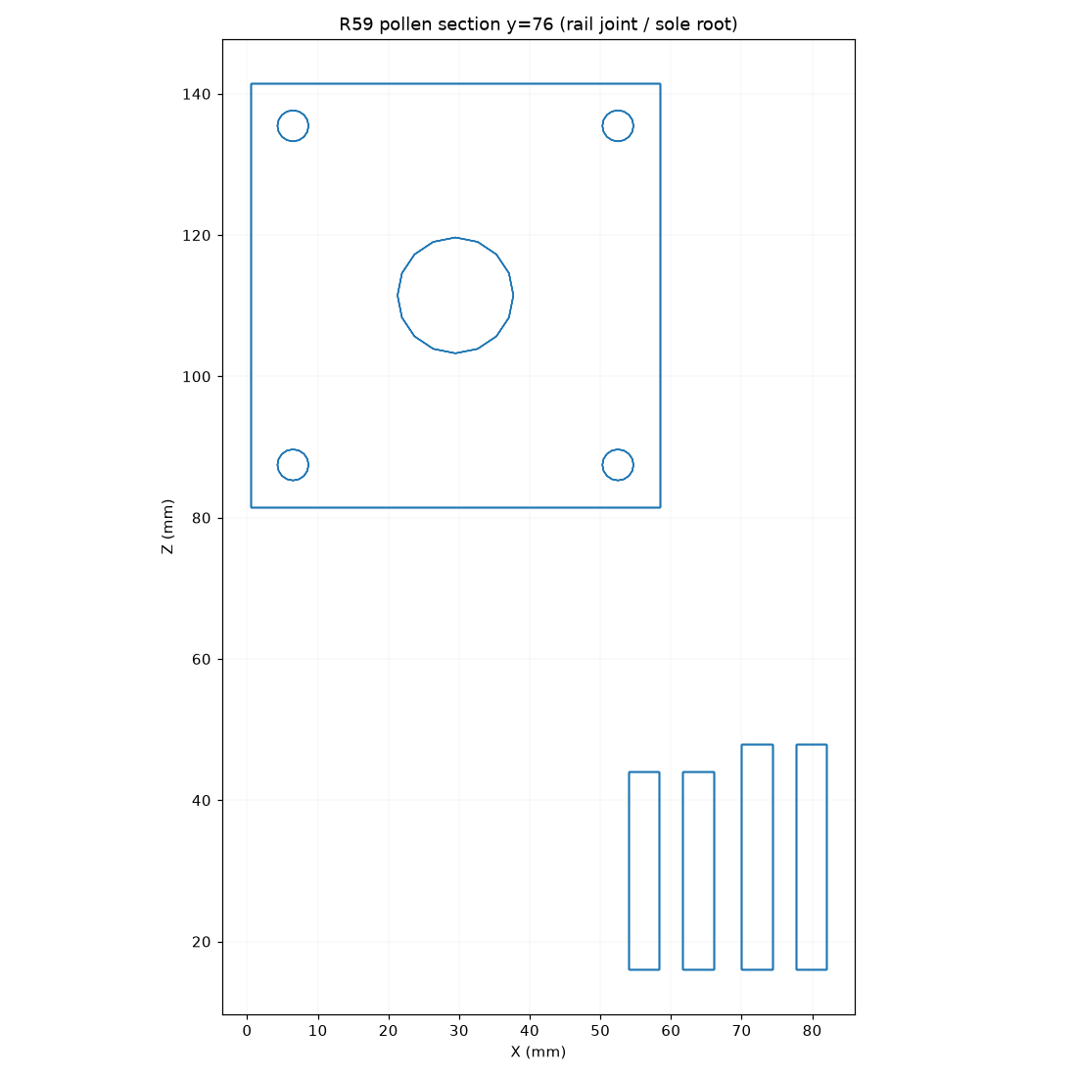
cad/output/_r59_frame/sections/r59_pollen_section_y76.png
