wang15143089/FTC-2026-Bio-buzz/cad/output/_r59_rail/r59_thickened_rail.png

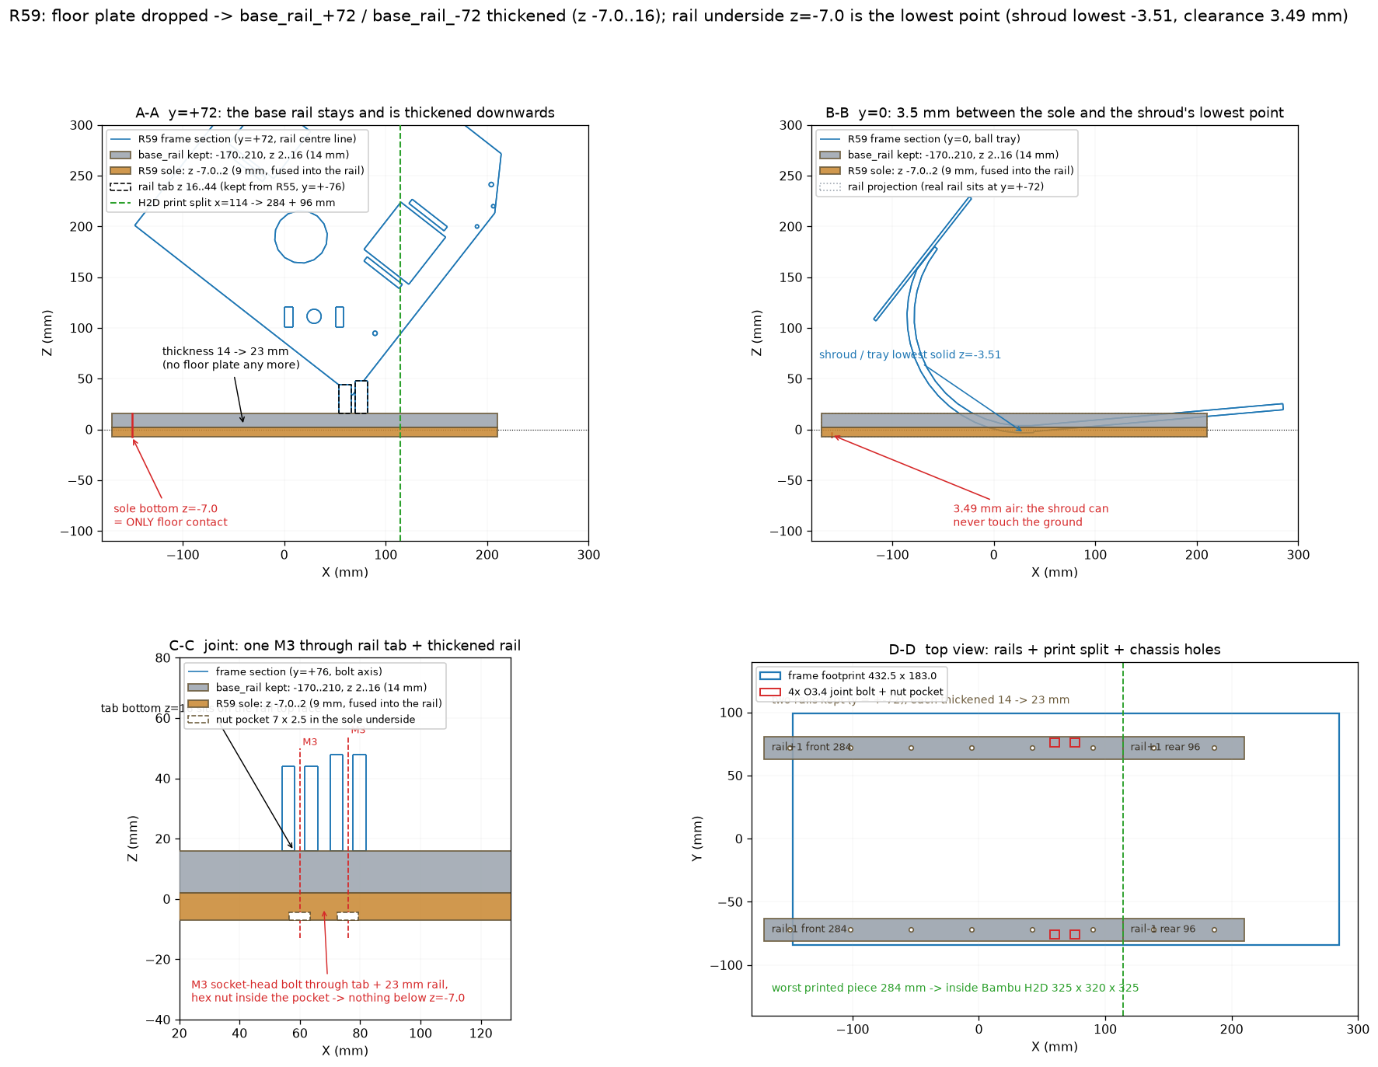
cad/output/_r59_rail/r59_thickened_rail.png
