wang15143089/FTC-2026-Bio-buzz/cad/output/_r60_rail/r60_thickened_rail.png

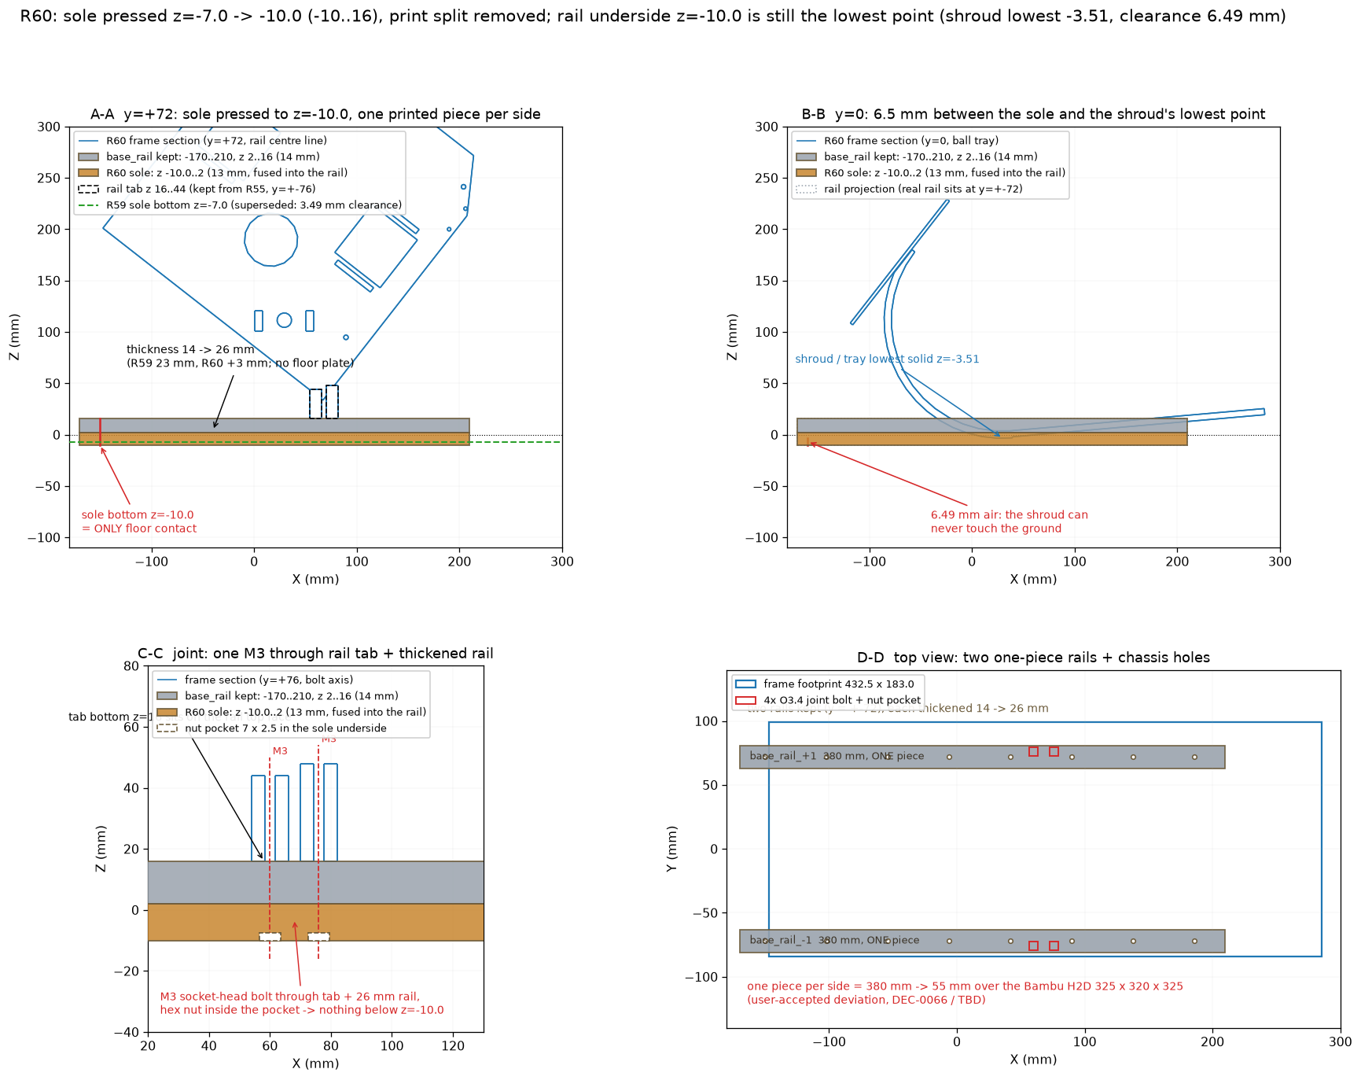
cad/output/_r60_rail/r60_thickened_rail.png
