wang15143089/FTC-2026-Bio-buzz/cad/output/_r61_frame/sections/r61_rail_join_detail.png

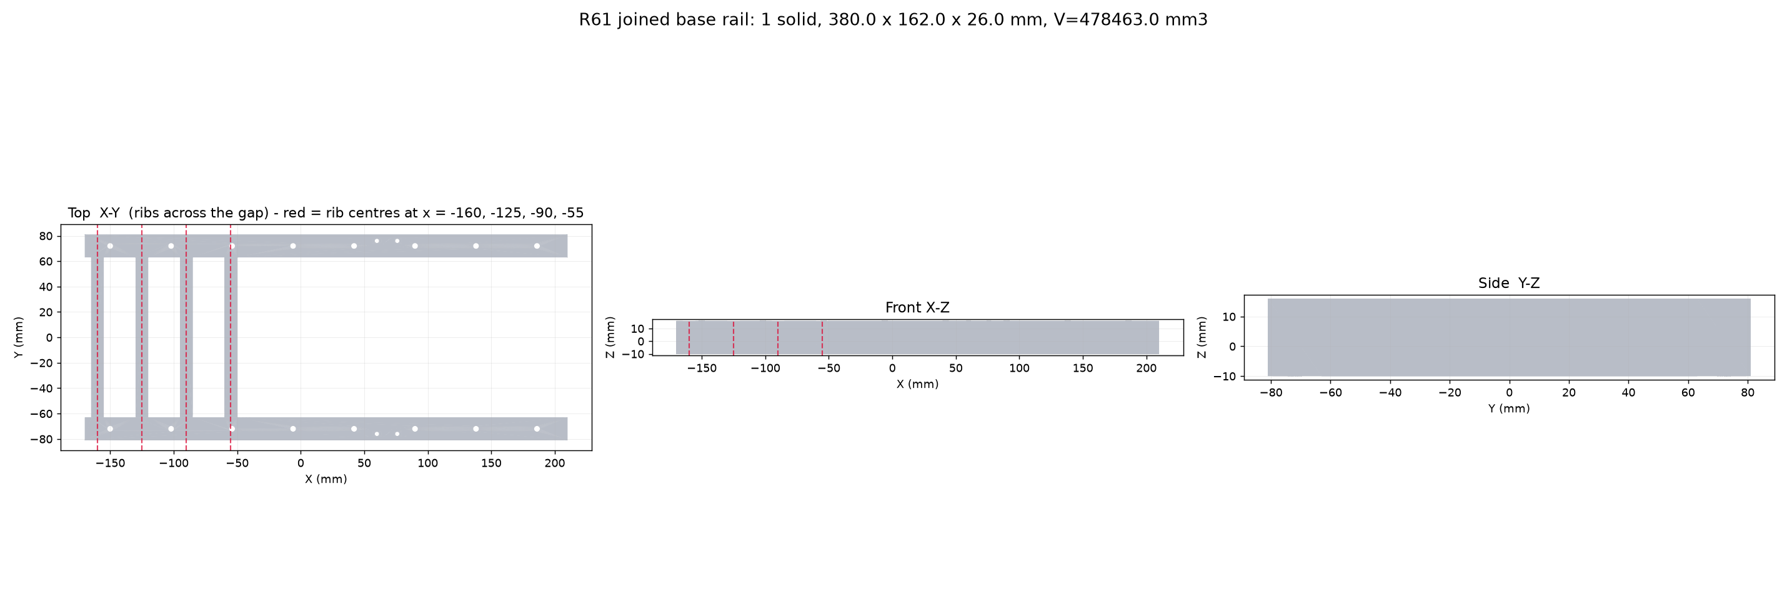
cad/output/_r61_frame/sections/r61_rail_join_detail.png
