wang15143089/FTC-2026-Bio-buzz/cad/output/_r62_frame/sections/r62_rail_split_detail.png

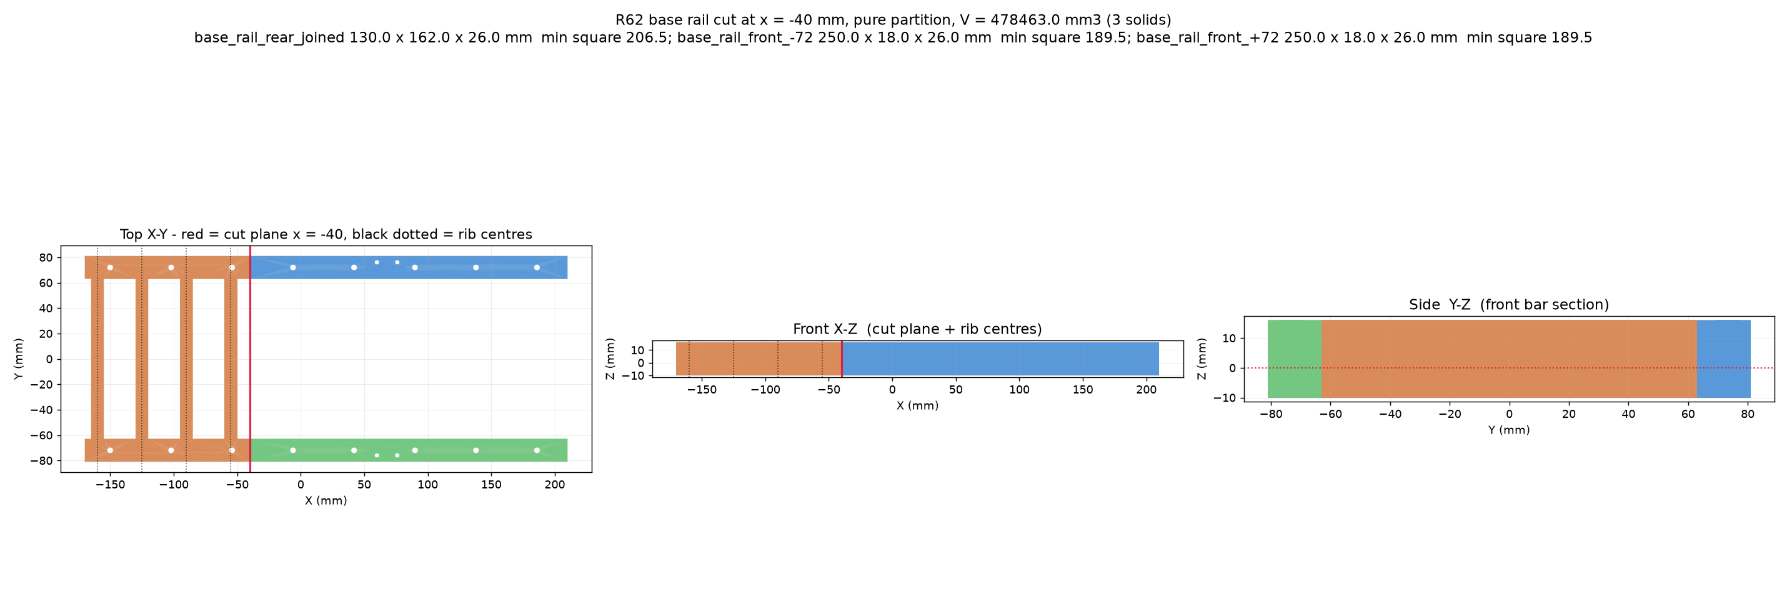
cad/output/_r62_frame/sections/r62_rail_split_detail.png
