wang15143089/FTC-2026-Bio-buzz/cad/output/_r64_joint/r64_split_fastening_schematic.png

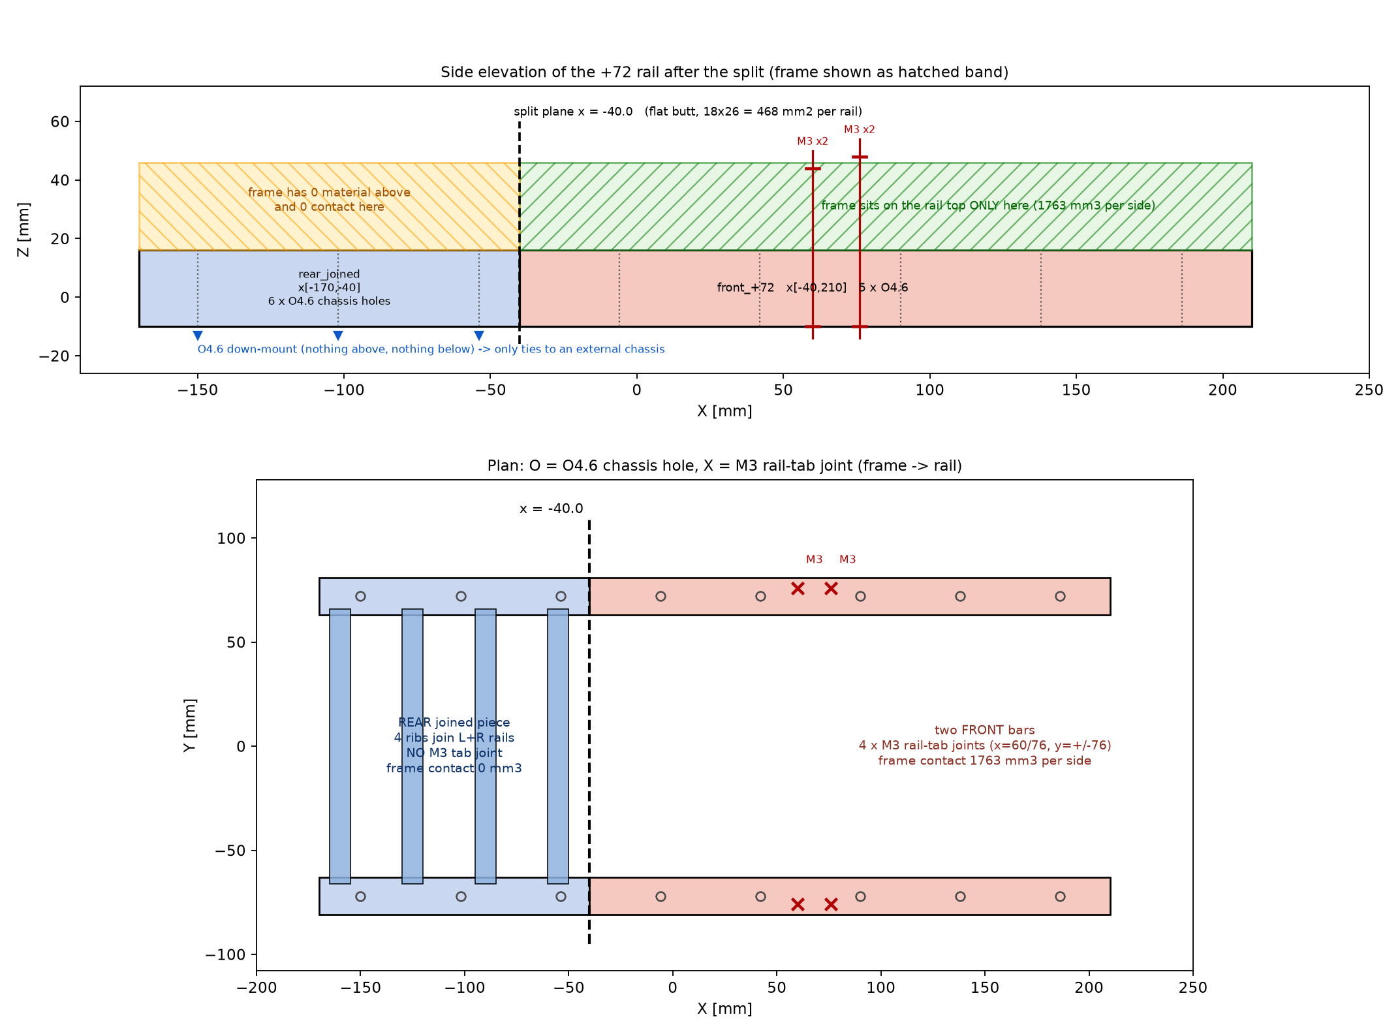
cad/output/_r64_joint/r64_split_fastening_schematic.png
