wang15143089/FTC-2026-Bio-buzz/cad/output/_r65_plate/plate_preview.png

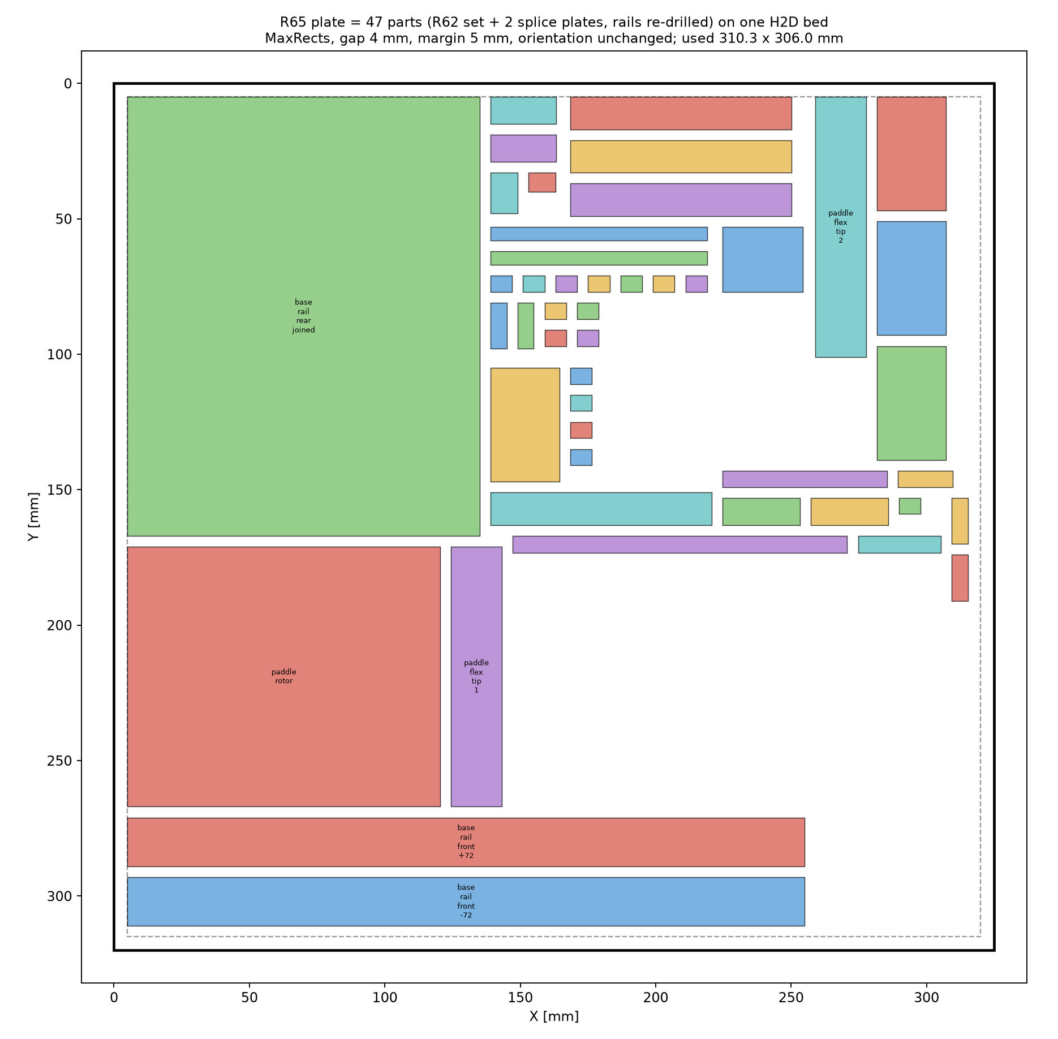
cad/output/_r65_plate/plate_preview.png
