wang15143089/FTC-2026-Bio-buzz/cad/output/_r65_splice/r65_splice_schematic.png

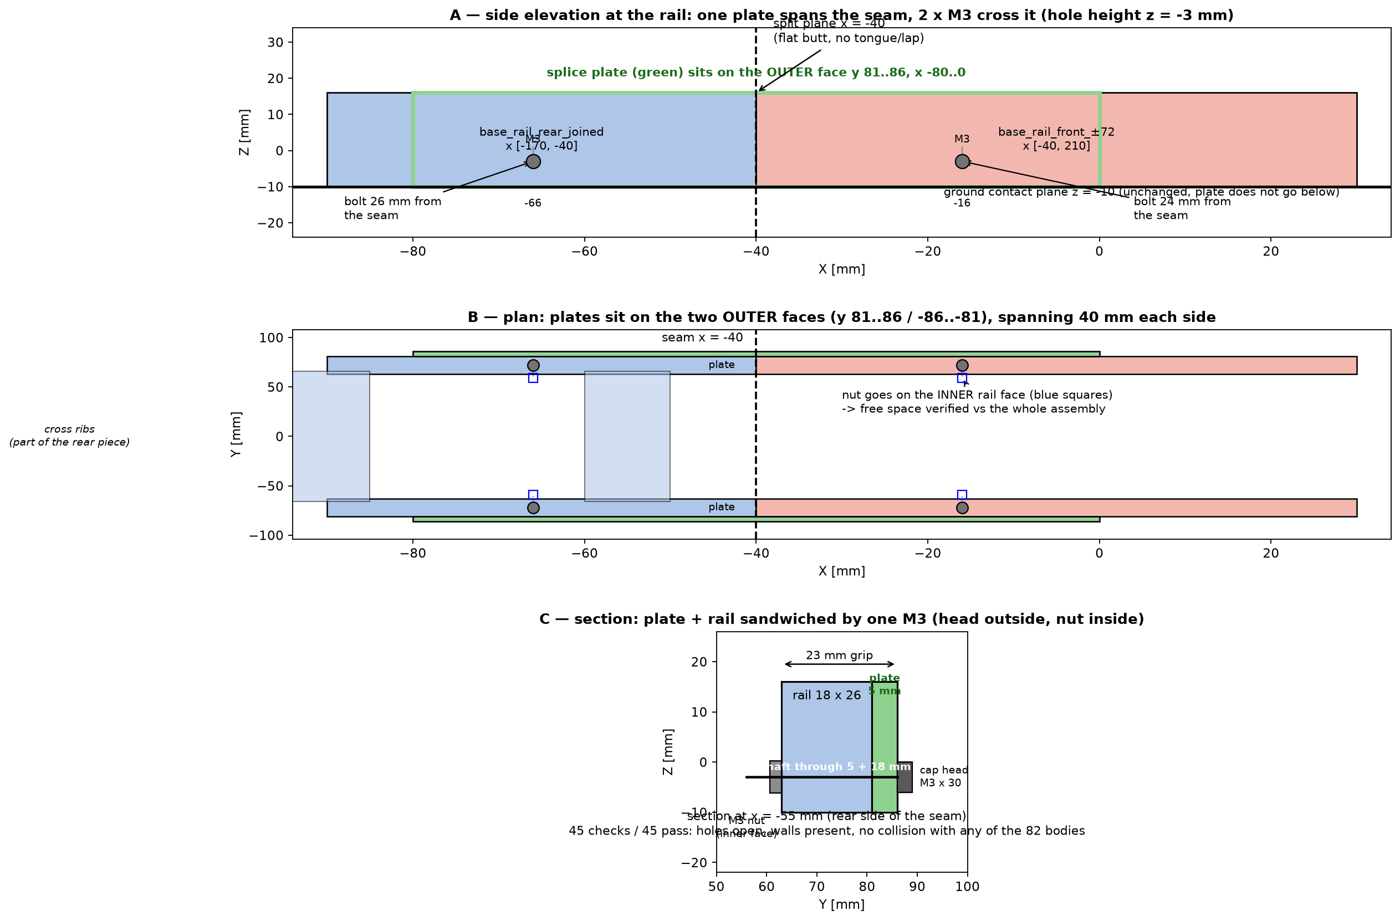
cad/output/_r65_splice/r65_splice_schematic.png
