wang15143089/FTC-2026-Bio-buzz/cad/output/_r66_plate/paddle_before_after.png

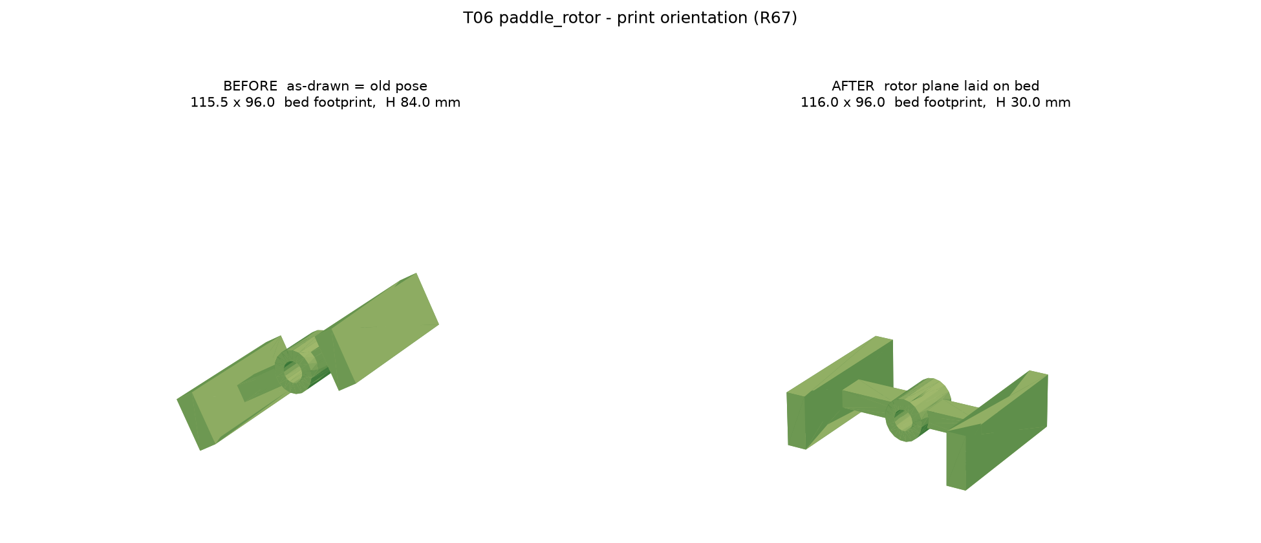
cad/output/_r66_plate/paddle_before_after.png
