wang15143089/FTC-2026-Bio-buzz/cad/output/_r66_plate/plate_p4_preview.png

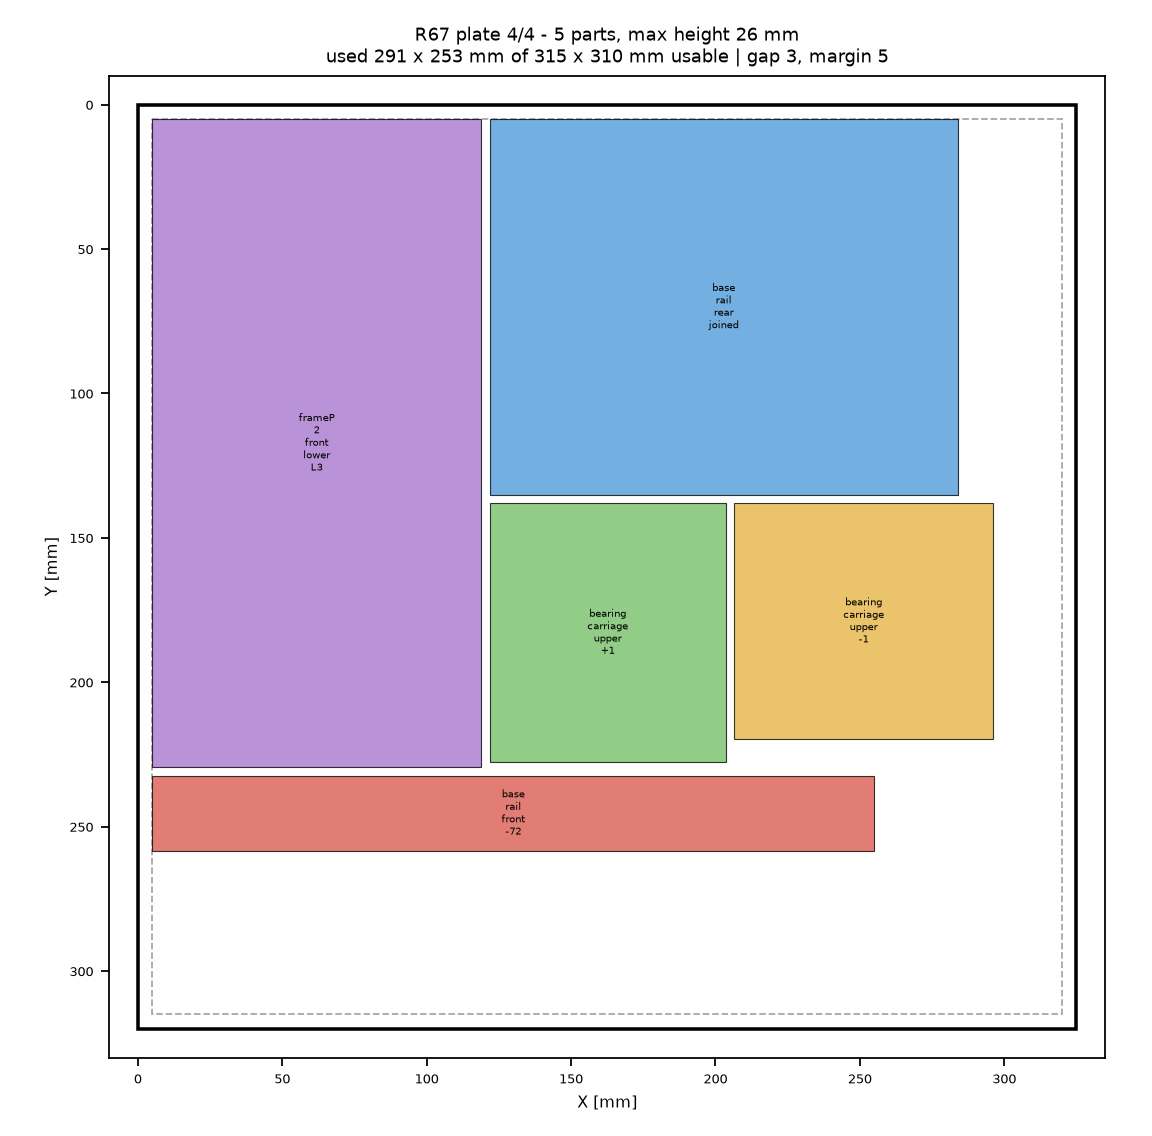
cad/output/_r66_plate/plate_p4_preview.png
