wang15143089/FTC-2026-Bio-buzz/cad/output/_r66_plate/r66_plates_overview.png

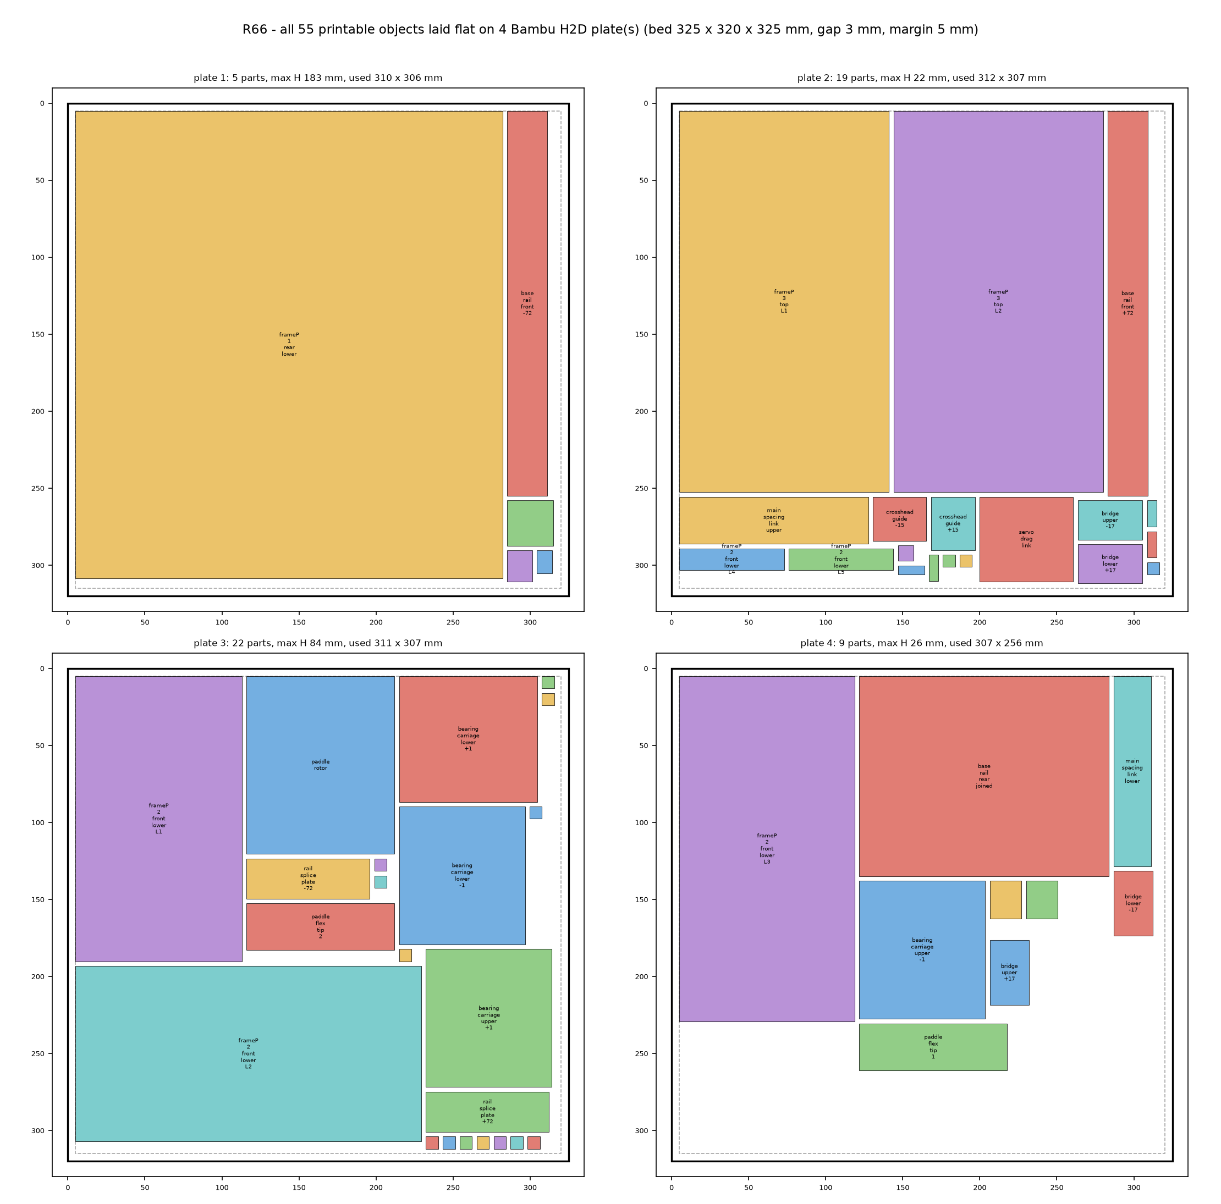
cad/output/_r66_plate/r66_plates_overview.png
