wang15143089/FTC-2026-Bio-buzz/cad/output/_t06_r32_fullflow_zh.png

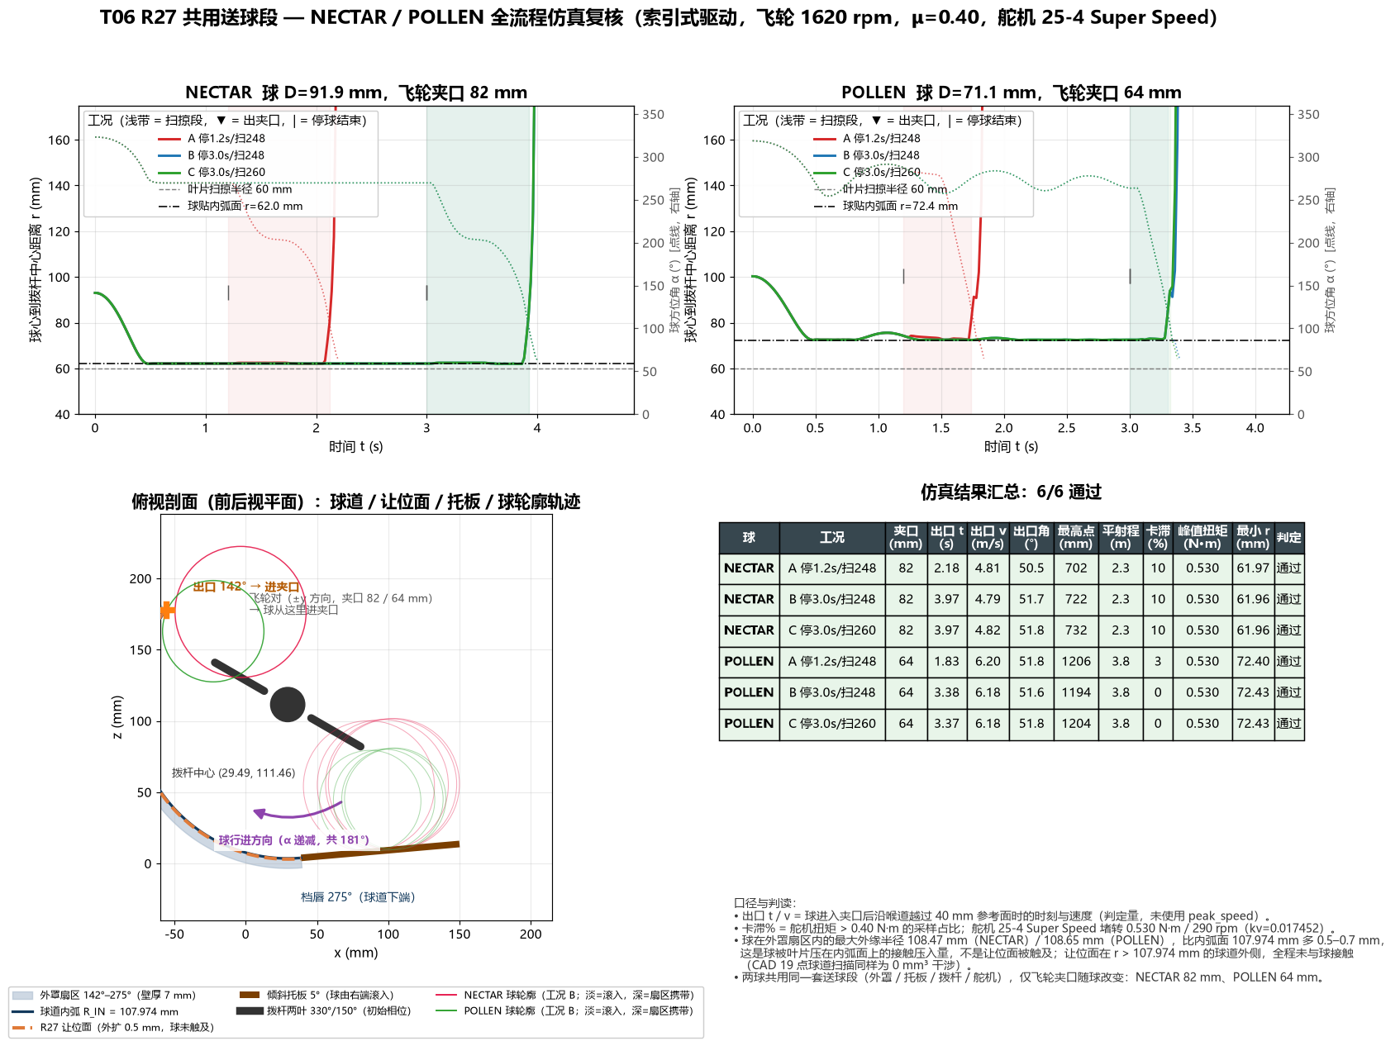
cad/output/_t06_r32_fullflow_zh.png
