wang15143089/FTC-2026-Bio-buzz/cad/output/_t06_r32_launch_nectar.gif

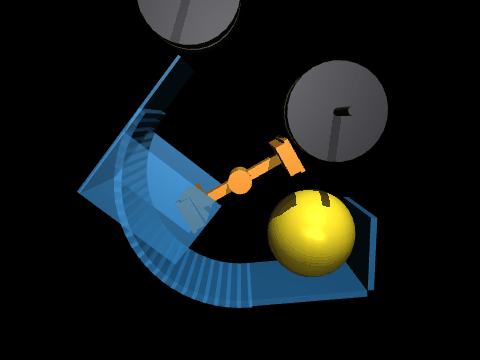
cad/output/_t06_r32_launch_nectar.gif
