wang15143089/FTC-2026-Bio-buzz/cad/output/_t06_r34_geometry_zh.png

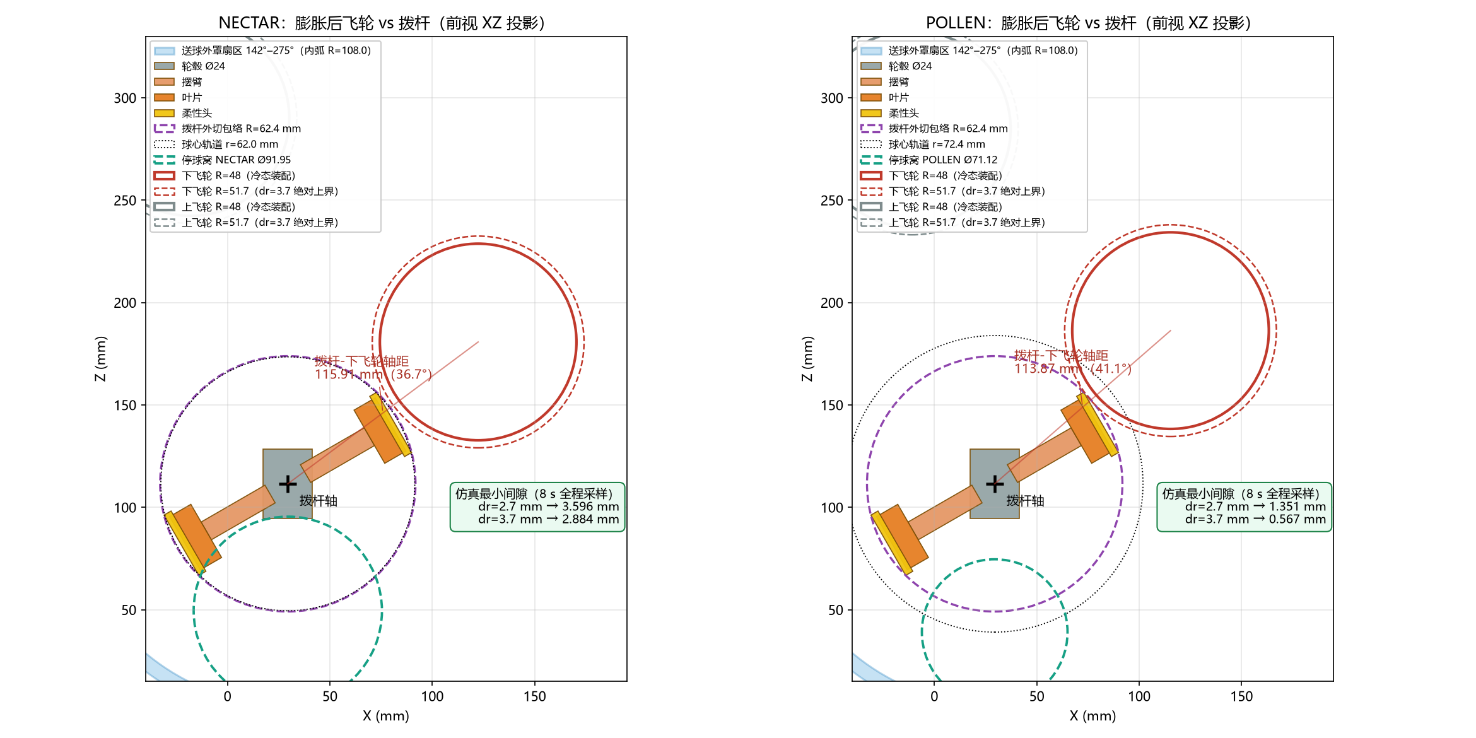
cad/output/_t06_r34_geometry_zh.png
