wang15143089/FTC-2026-Bio-buzz/cad/output/_t06_shared_feeder_zh.png

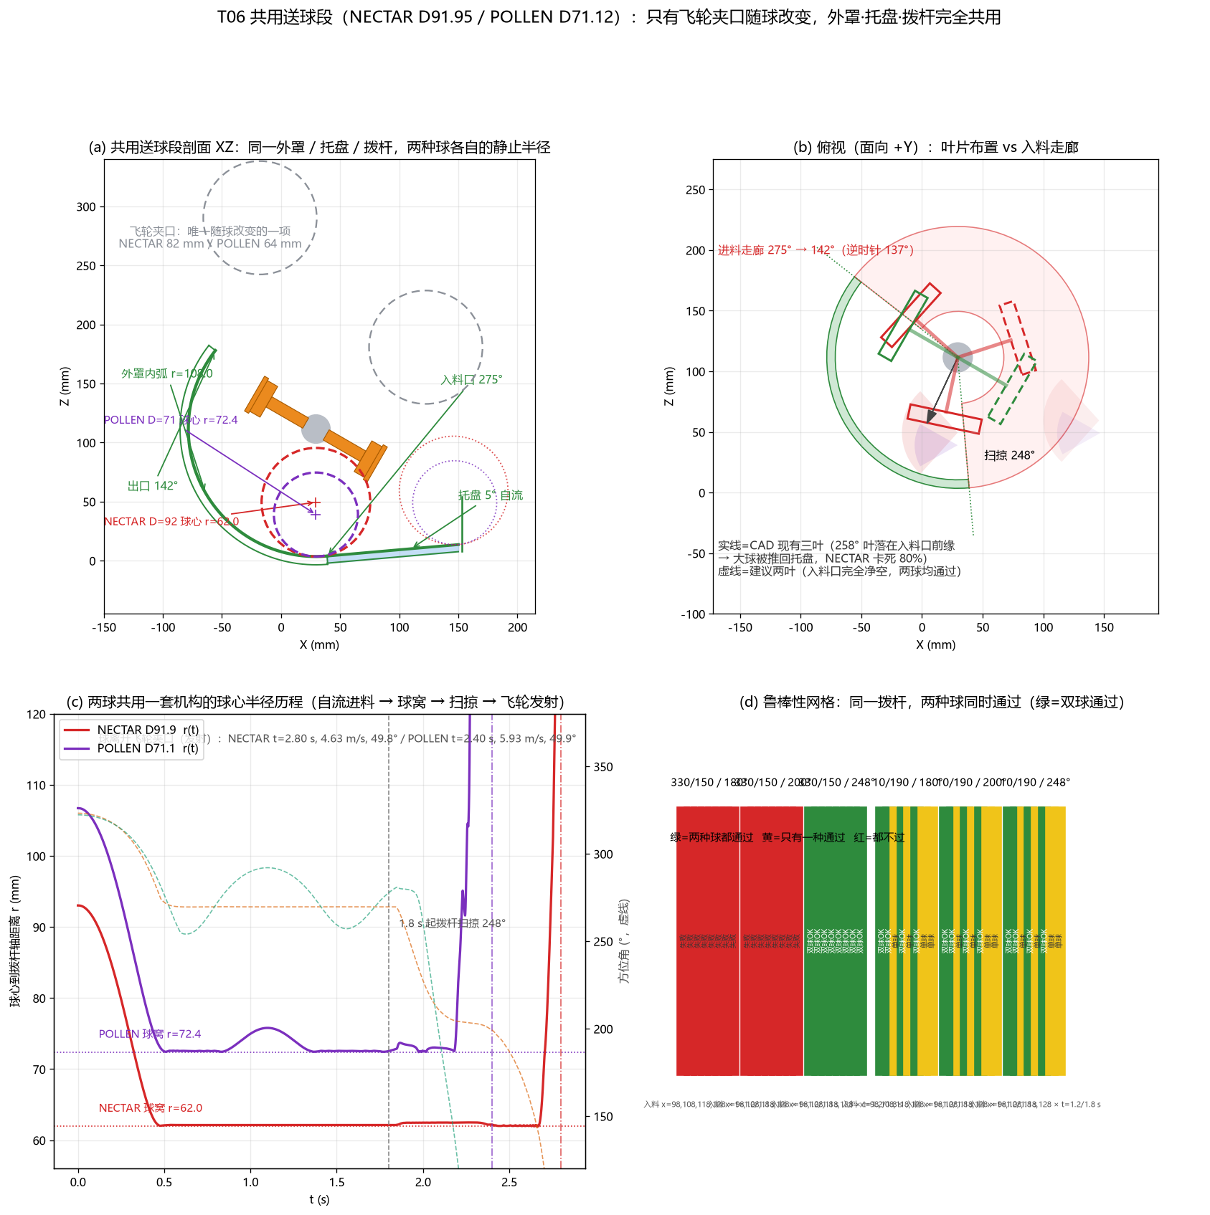
cad/output/_t06_shared_feeder_zh.png
