wang15143089/FTC-2026-Bio-buzz/cad/output/_t06_shared_relief_r27_zh.png

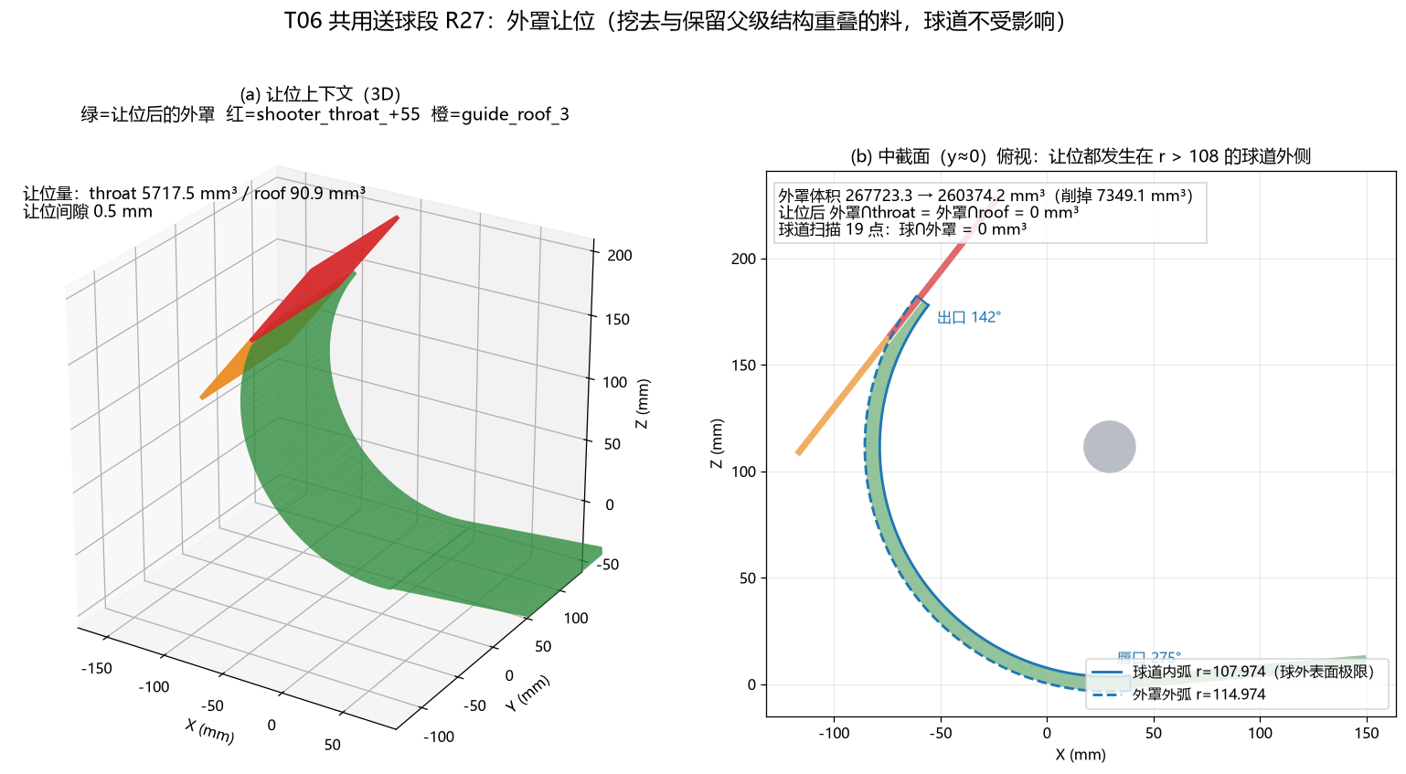
cad/output/_t06_shared_relief_r27_zh.png
