wang15143089/FTC-2026-Bio-buzz/cad/output/biobuzz_launcher_interactive_preview.png

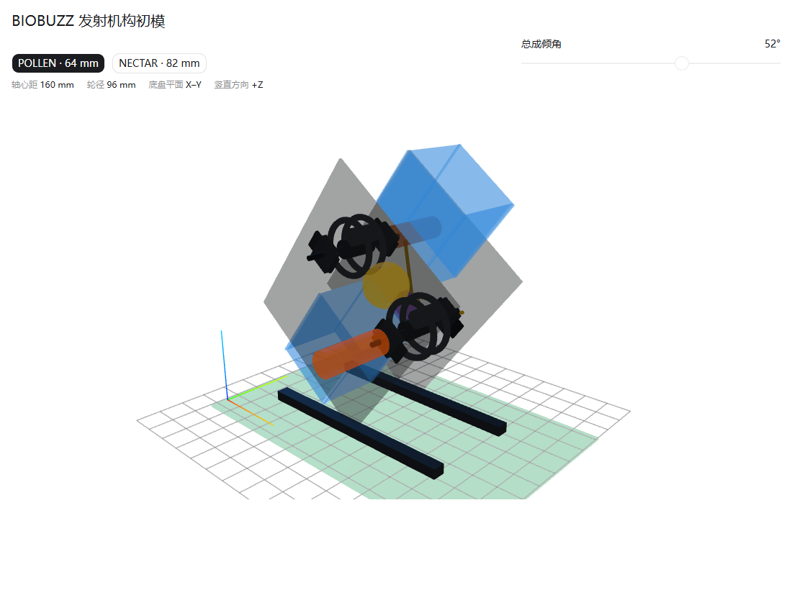
cad/output/biobuzz_launcher_interactive_preview.png
