wang15143089/FTC-2026-Bio-buzz/cad/output/biobuzz_single_motor_flipout_intake_stowed_preview.png

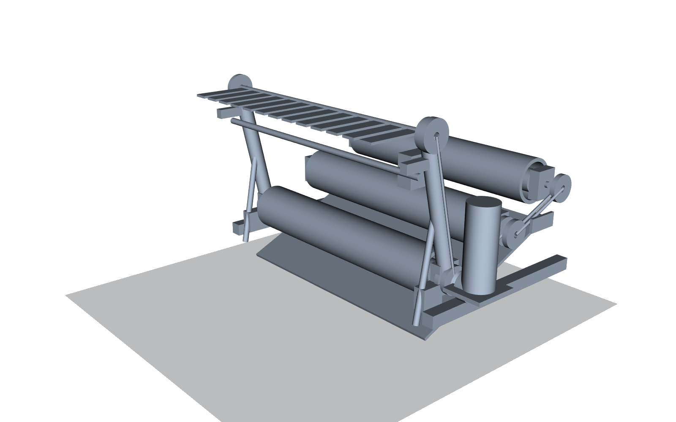
cad/output/biobuzz_single_motor_flipout_intake_stowed_preview.png
