wang15143089/FTC-2026-Bio-buzz/cad/output/continuous_servo_feeder_preview.png

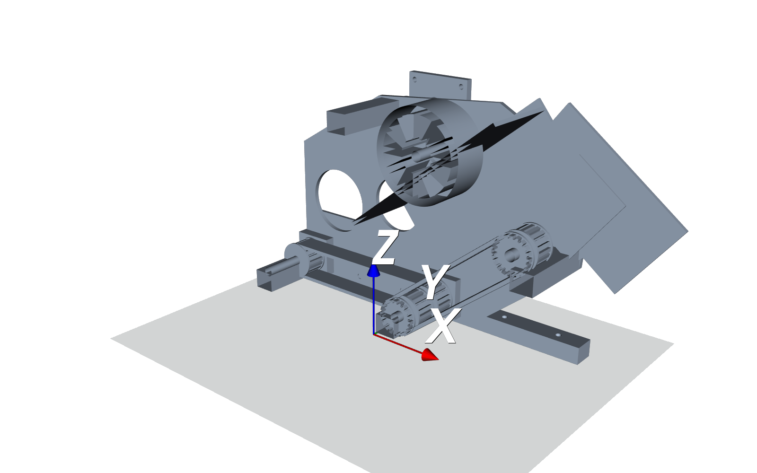
cad/output/continuous_servo_feeder_preview.png
