wang15143089/FTC-2026-Bio-buzz/cad/output/paddle_feeder_opposed_flywheel_launcher_preview.png

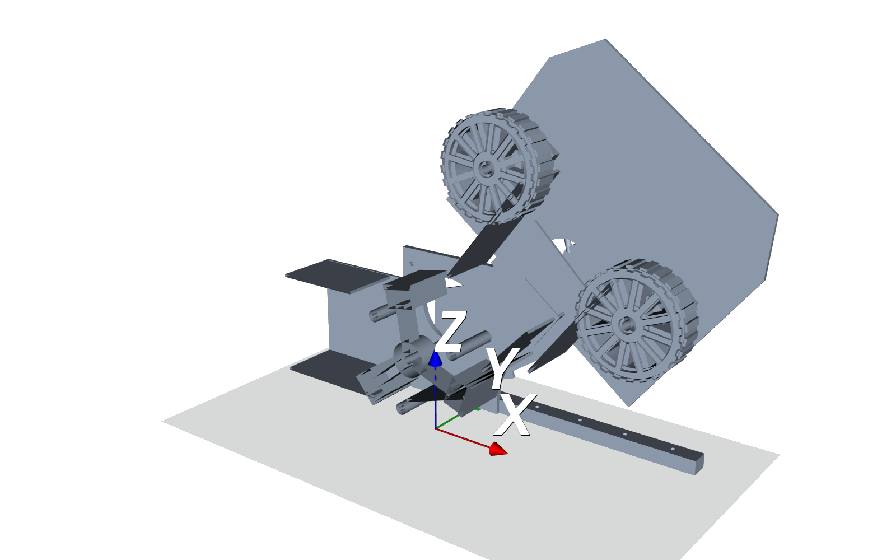
cad/output/paddle_feeder_opposed_flywheel_launcher_preview.png
