wang15143089/FTC-2026-Bio-buzz/cad/output/paddle_launcher_constrained_preview.png

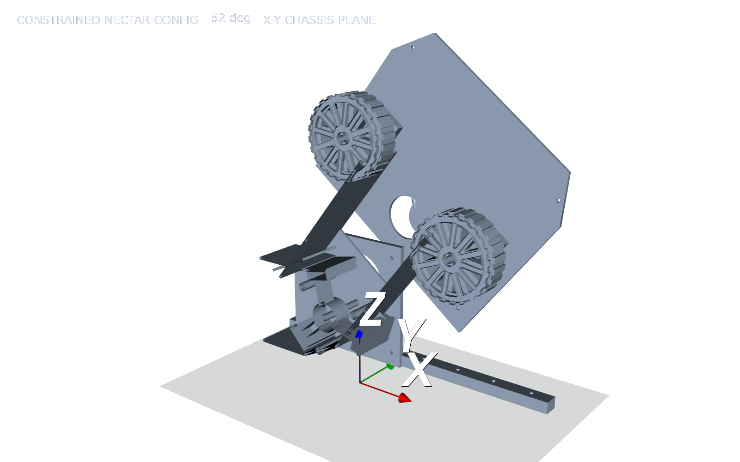
cad/output/paddle_launcher_constrained_preview.png
