wang15143089/FTC-2026-Bio-buzz/cad/output/paddle_launcher_feasible_motor_drive.png

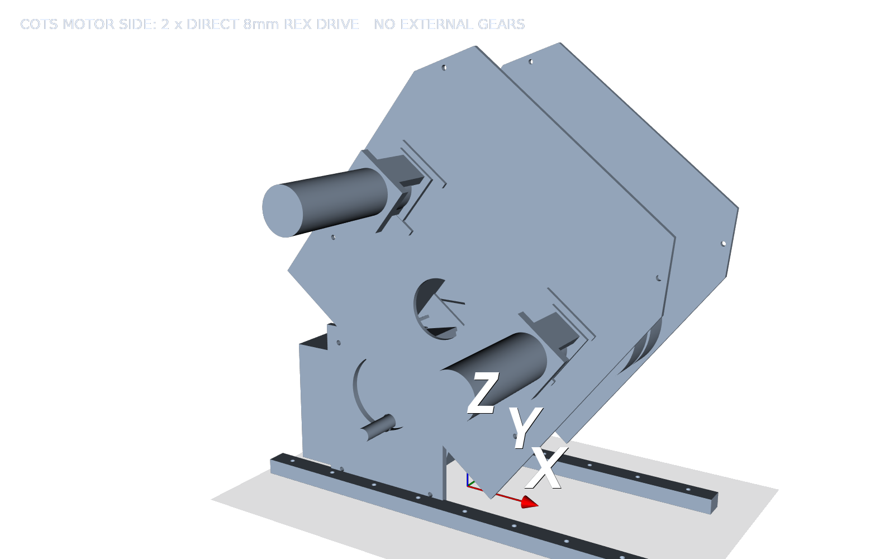
cad/output/paddle_launcher_feasible_motor_drive.png
