wang15143089/FTC-2026-Bio-buzz/cad/output/paddle_launcher_motion_only_nectar_overview.png

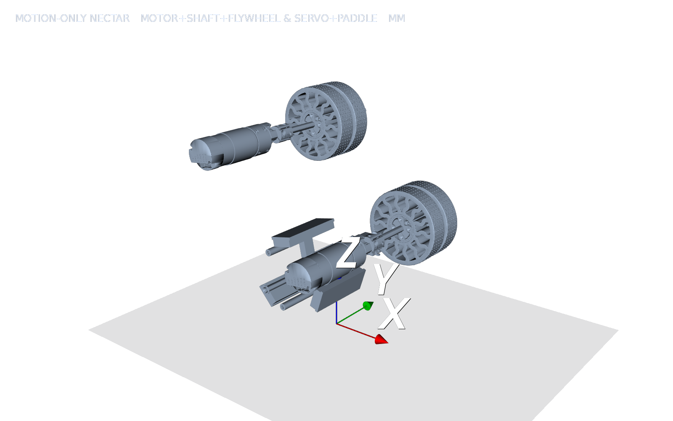
cad/output/paddle_launcher_motion_only_nectar_overview.png
