wang15143089/FTC-2026-Bio-buzz/exports/drawings/t04_c04b1_capstan_fixture_m3_preview.png

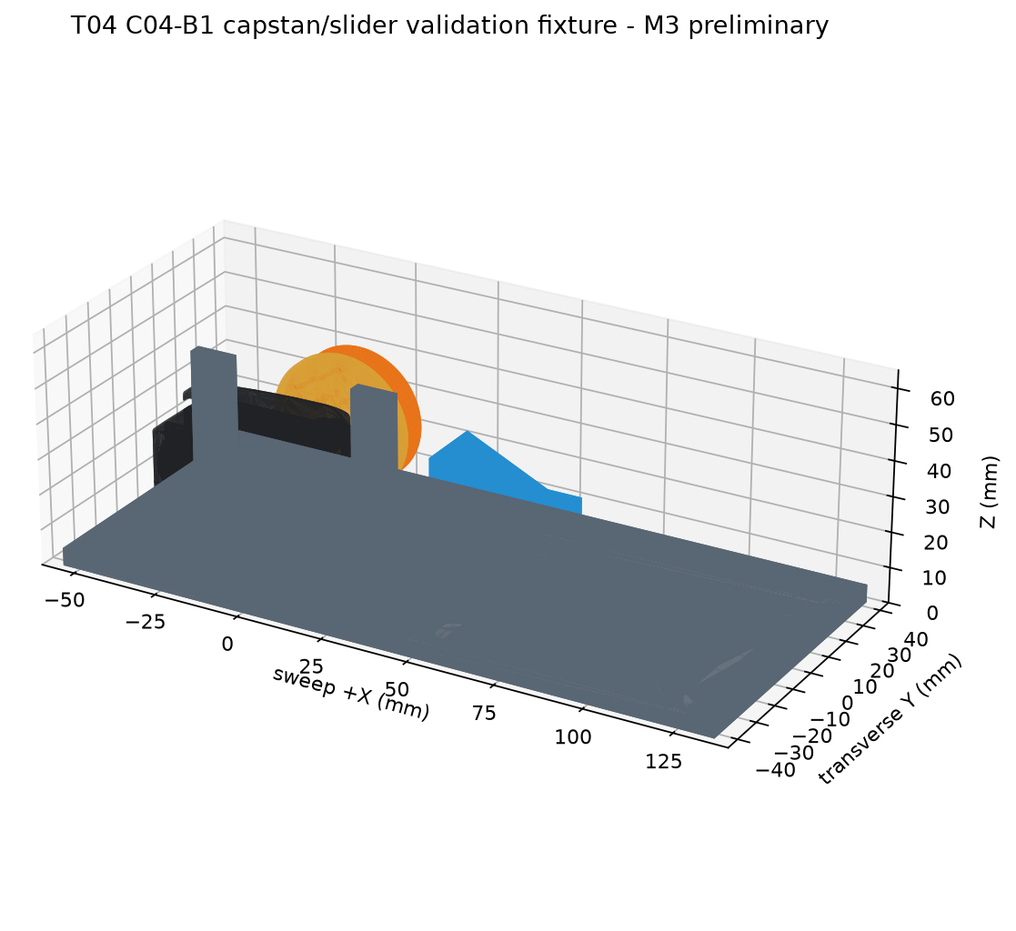
exports/drawings/t04_c04b1_capstan_fixture_m3_preview.png
