wang15143089/FTC-2026-Bio-buzz/references/gobilda_3100-0012-0020_dimensions.png

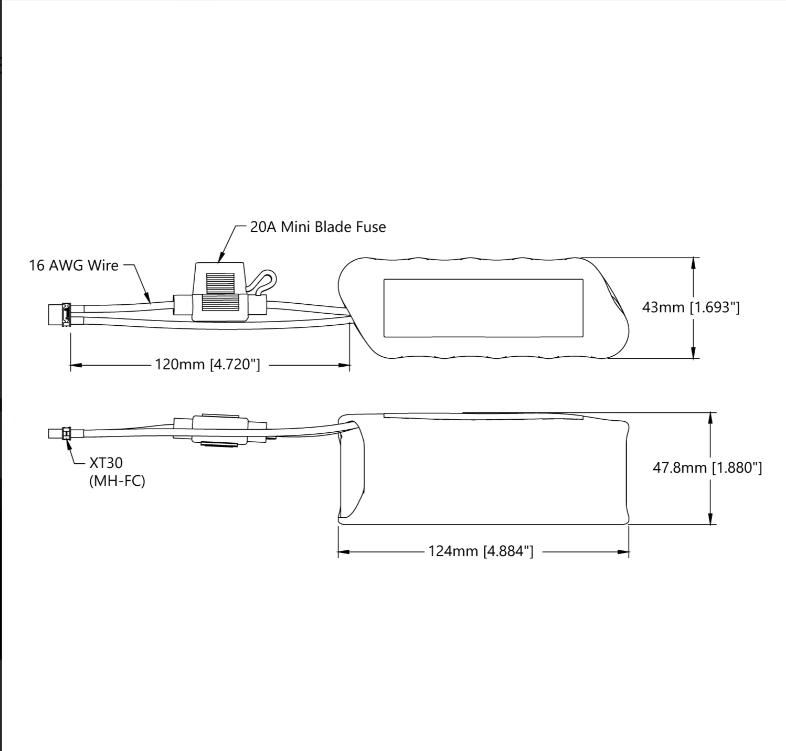
references/gobilda_3100-0012-0020_dimensions.png
