wang15143089/FTC-2026-Bio-buzz/simulation/mujoco/out/_r44_gate_verdict.png

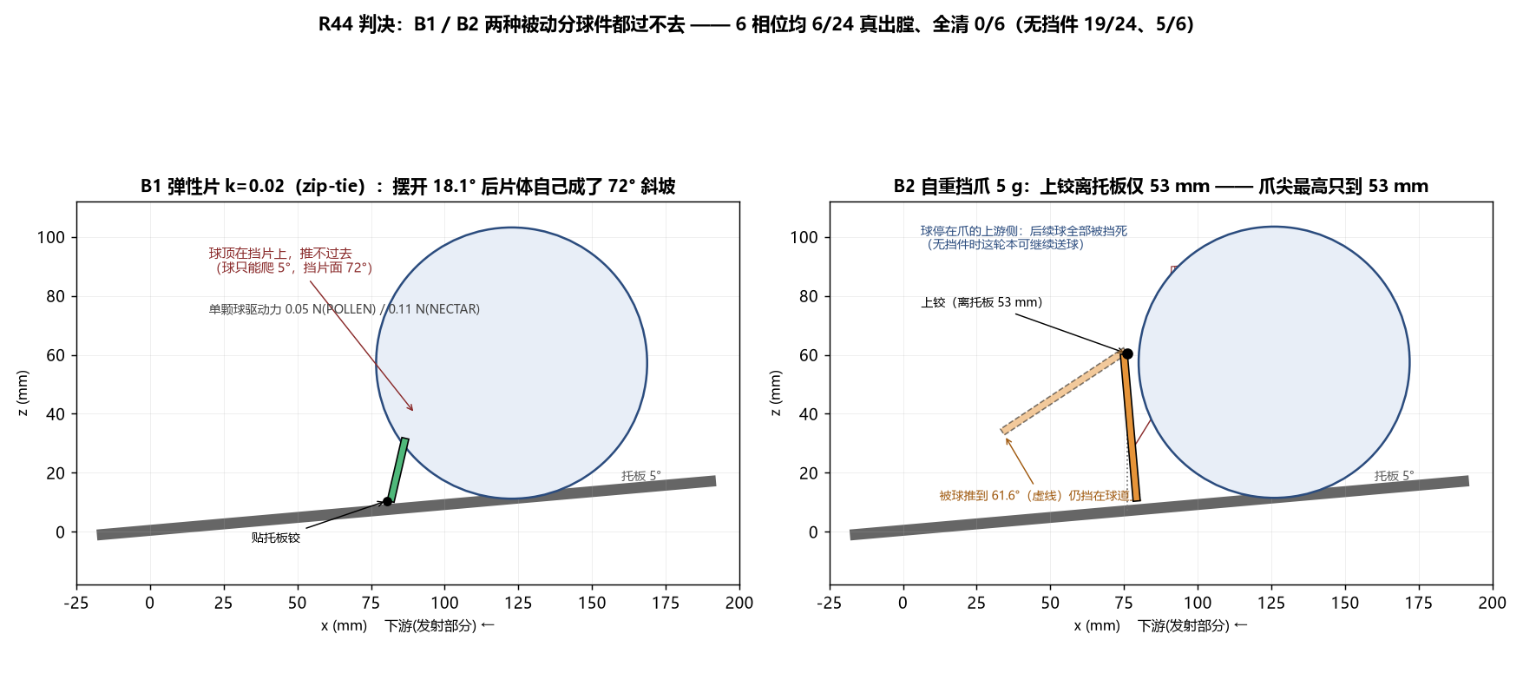
simulation/mujoco/out/_r44_gate_verdict.png
