wang15143089/FTC-2026-Bio-buzz/simulation/mujoco/out/_r45_park_window.png

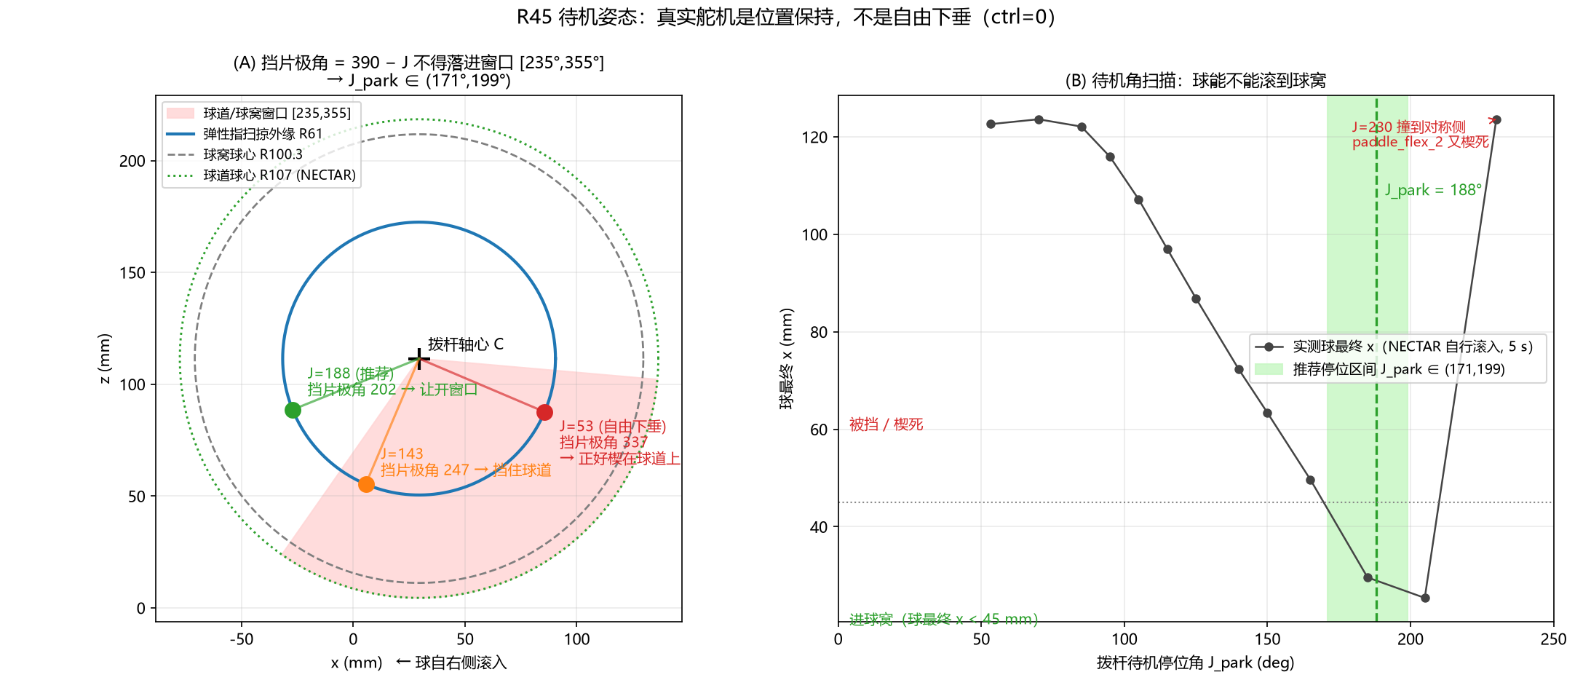
simulation/mujoco/out/_r45_park_window.png
