wang15143089/FTC-2026-Bio-buzz/simulation/mujoco/out/_r47_tape_section.png

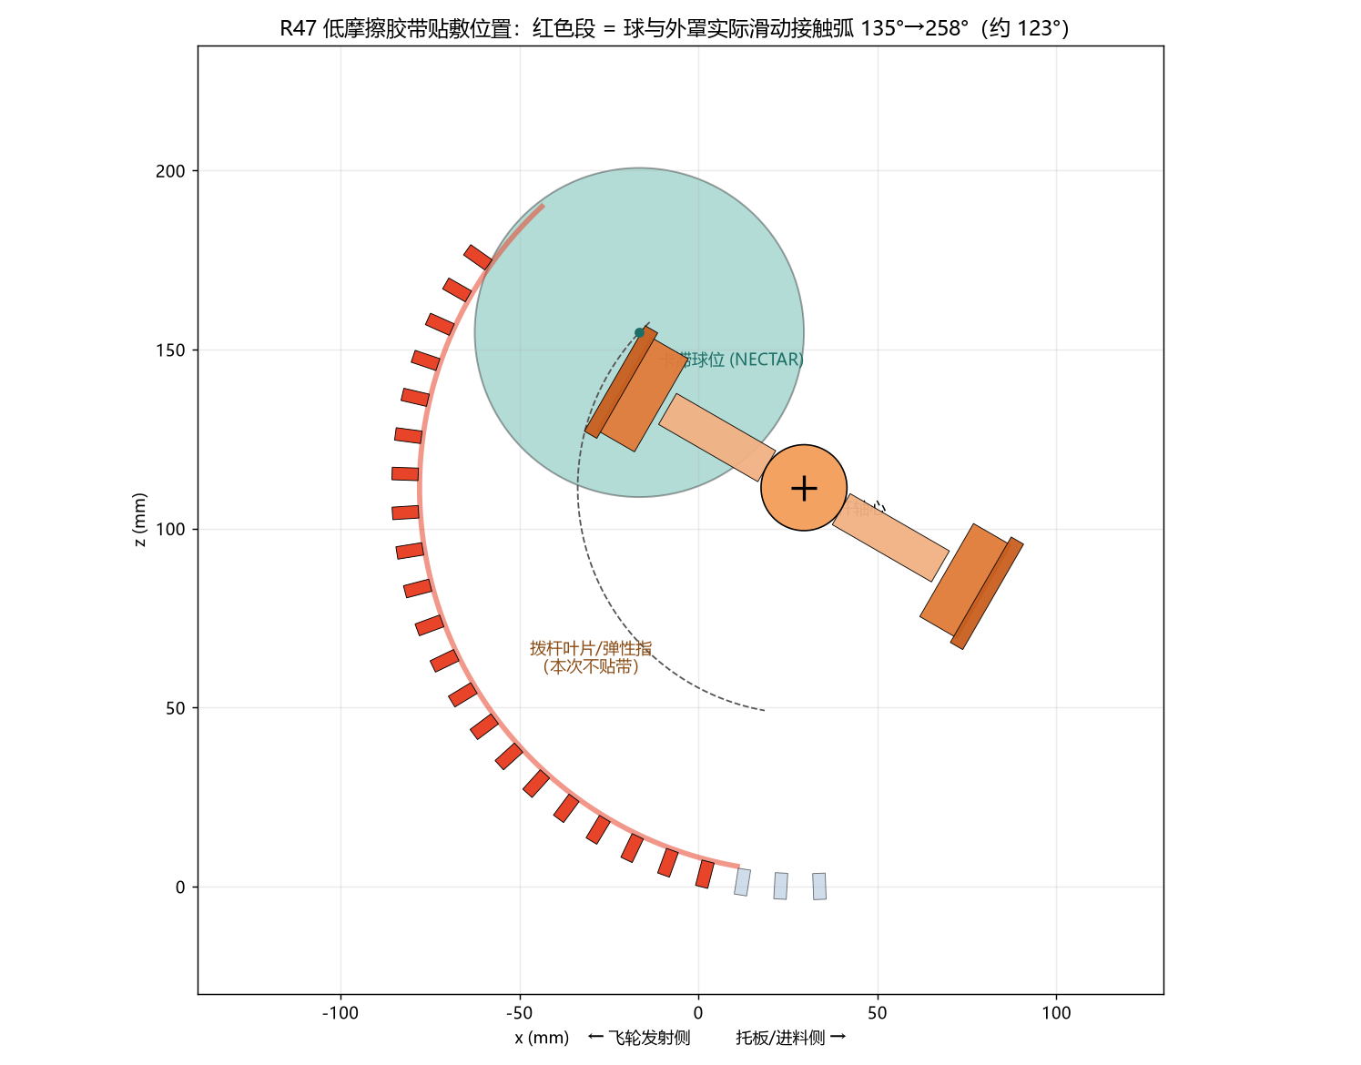
simulation/mujoco/out/_r47_tape_section.png
