wang15143089/FTC-2026-Bio-buzz/simulation/mujoco/out/design_review_zh.png

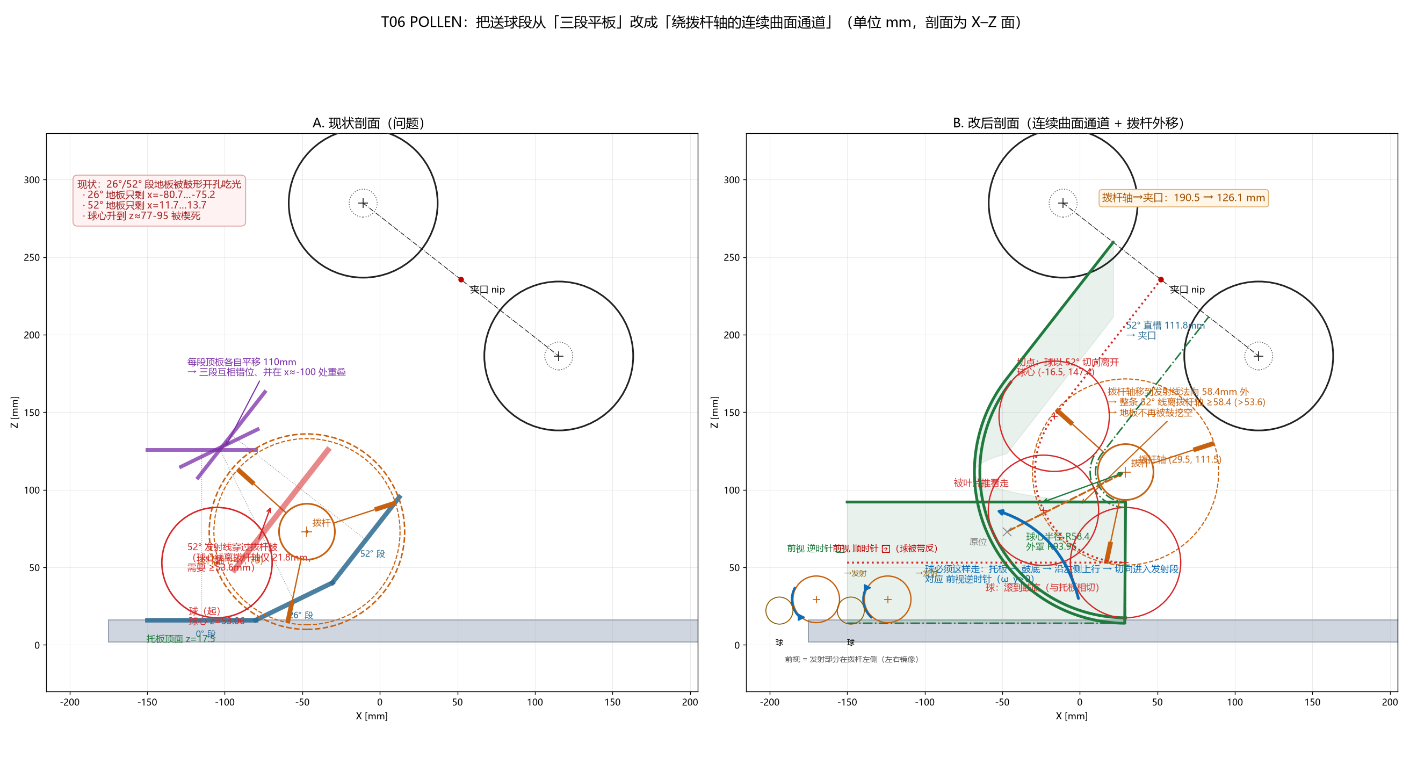
simulation/mujoco/out/design_review_zh.png
