wang15143089/FTC-2026-Bio-buzz/simulation/mujoco/out/geom_options_verdict_zh.png

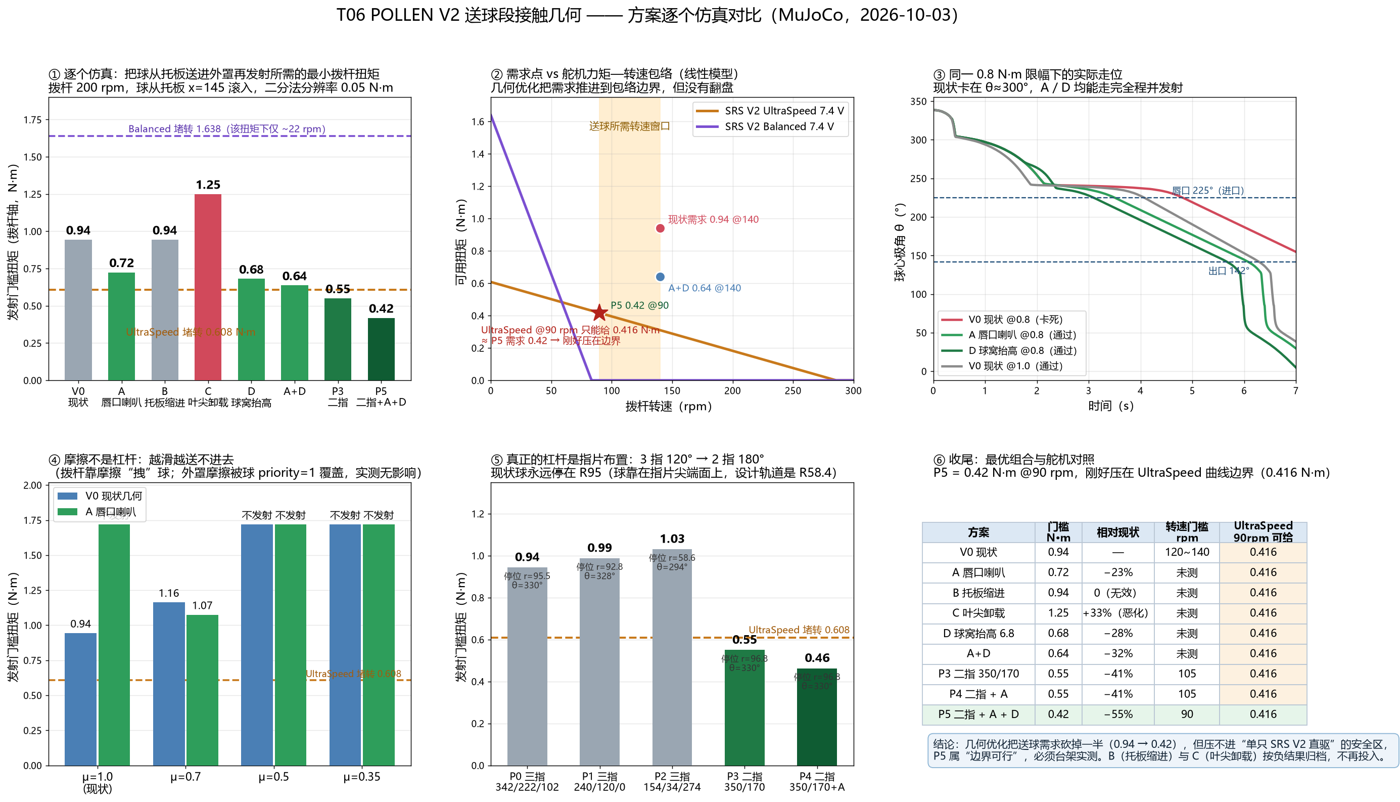
simulation/mujoco/out/geom_options_verdict_zh.png
