wang15143089/FTC-2026-Bio-buzz/simulation/mujoco/out/geometry_section.png

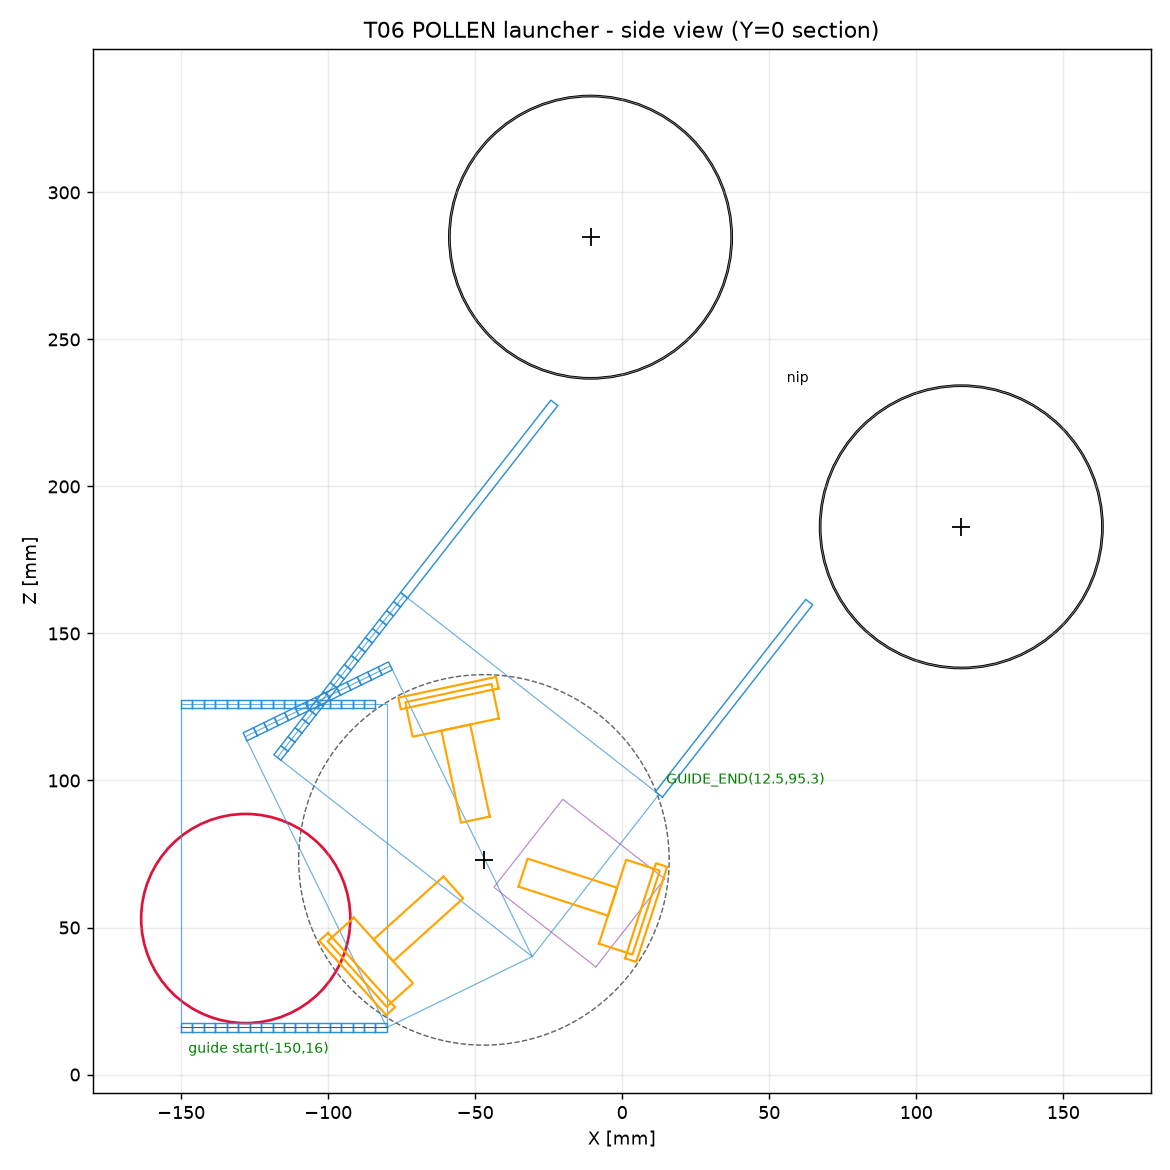
simulation/mujoco/out/geometry_section.png
