wang15143089/FTC-2026-Bio-buzz/simulation/mujoco/out/launch_launch_rpm1620_v2.5.png

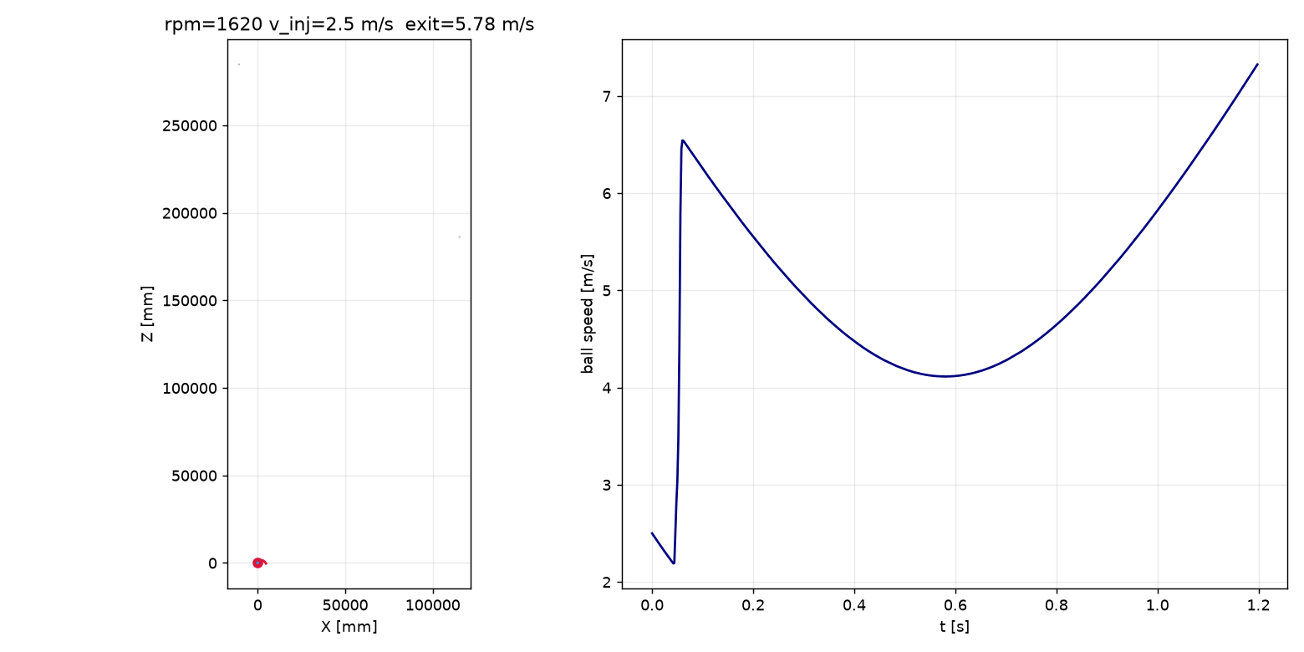
simulation/mujoco/out/launch_launch_rpm1620_v2.5.png
