wang15143089/FTC-2026-Bio-buzz/simulation/mujoco/out/options_b_right_tray_zh.png

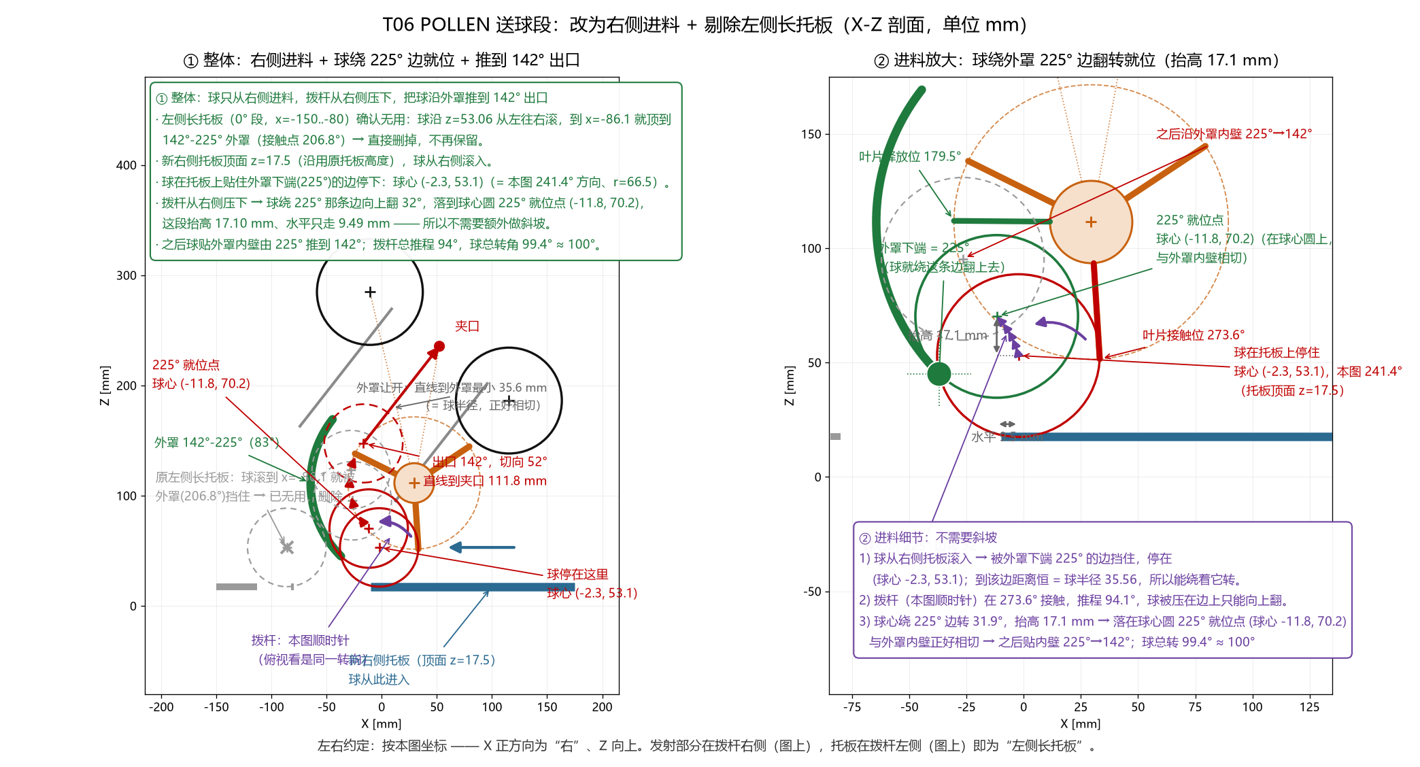
simulation/mujoco/out/options_b_right_tray_zh.png
