wang15143089/FTC-2026-Bio-buzz/simulation/mujoco/out/r5_vs_r6_smooth_zh.png

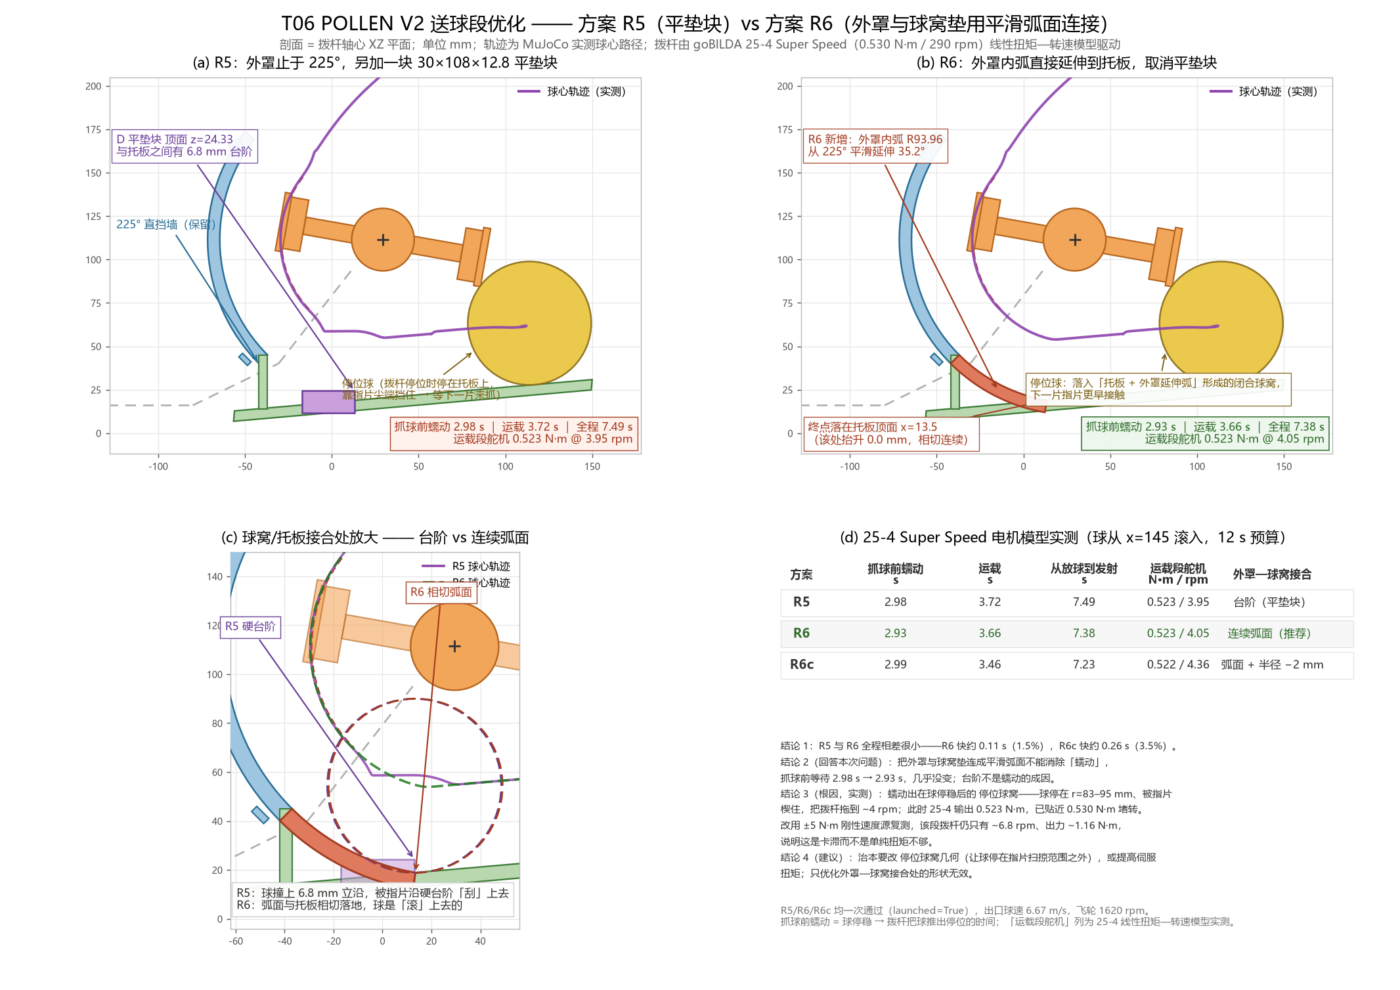
simulation/mujoco/out/r5_vs_r6_smooth_zh.png
