wang15143089/FTC-2026-Bio-buzz/simulation/mujoco/out/r9_mu_verdict_zh.png

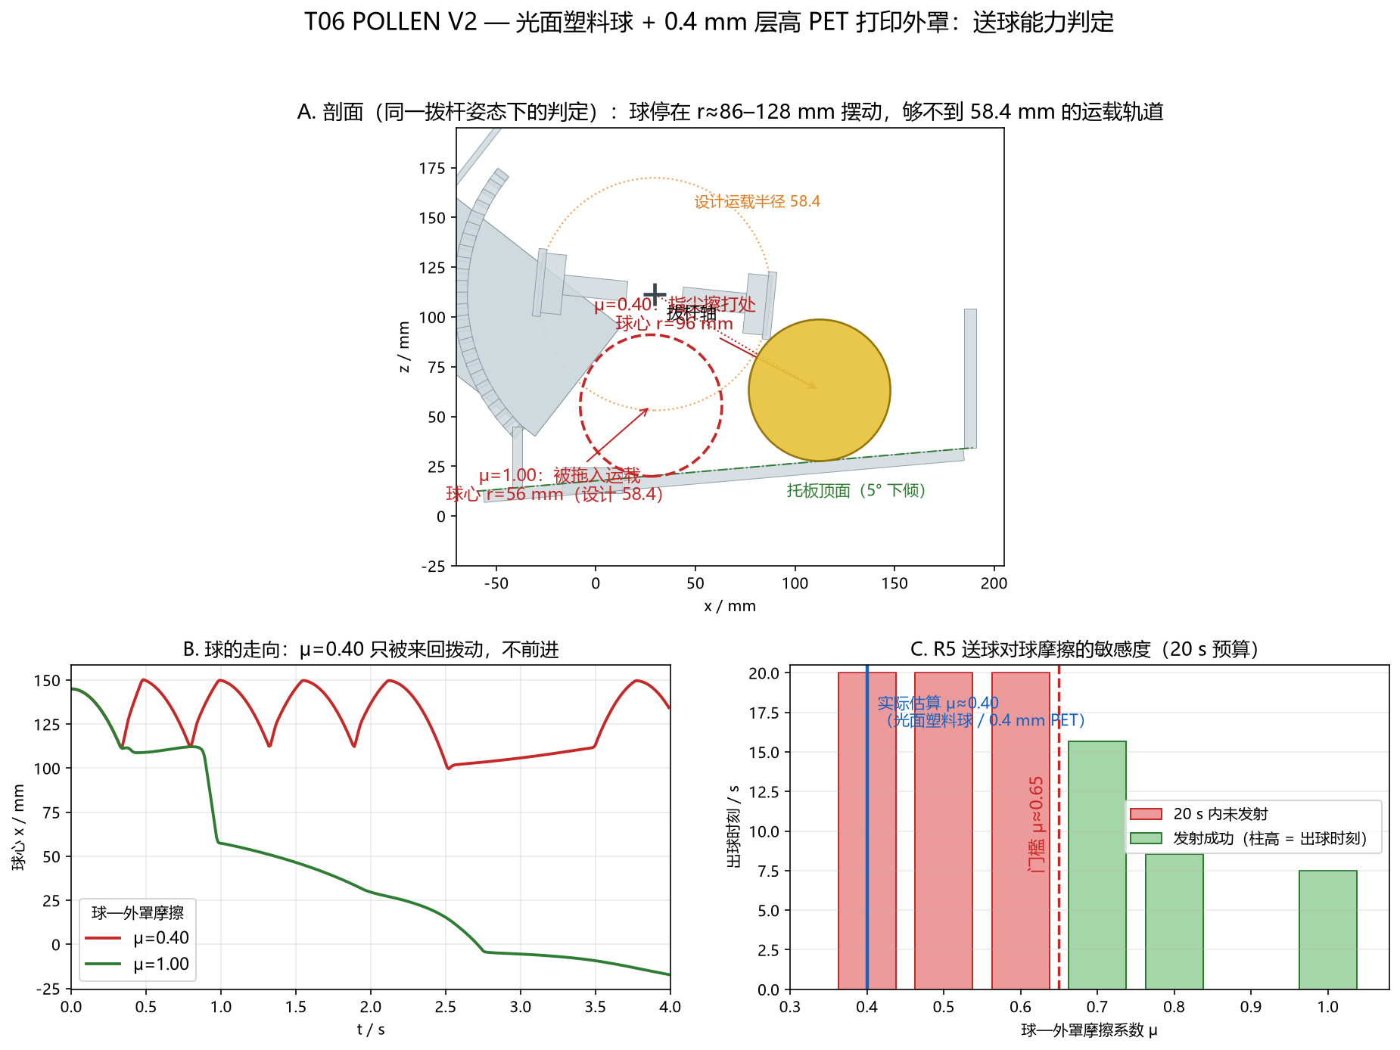
simulation/mujoco/out/r9_mu_verdict_zh.png
