wang15143089/FTC-2026-Bio-buzz/simulation/mujoco/out/r9_nest_friction_zh.png

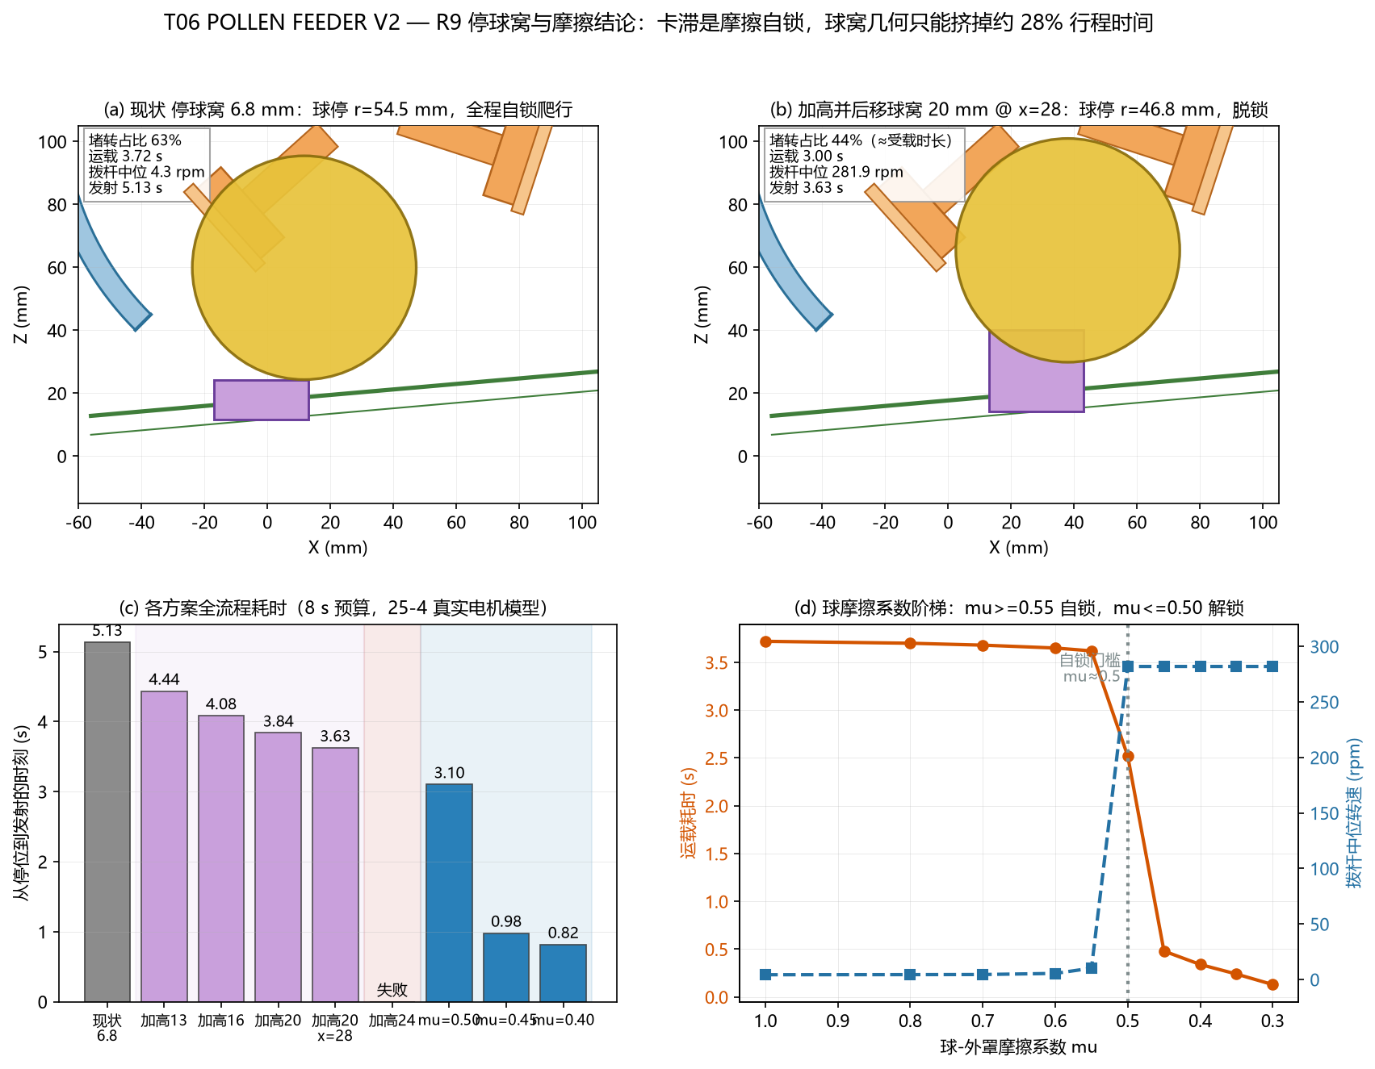
simulation/mujoco/out/r9_nest_friction_zh.png
