wang15143089/FTC-2026-Bio-buzz/simulation/mujoco/out/redesign_v2_coax_zh.png

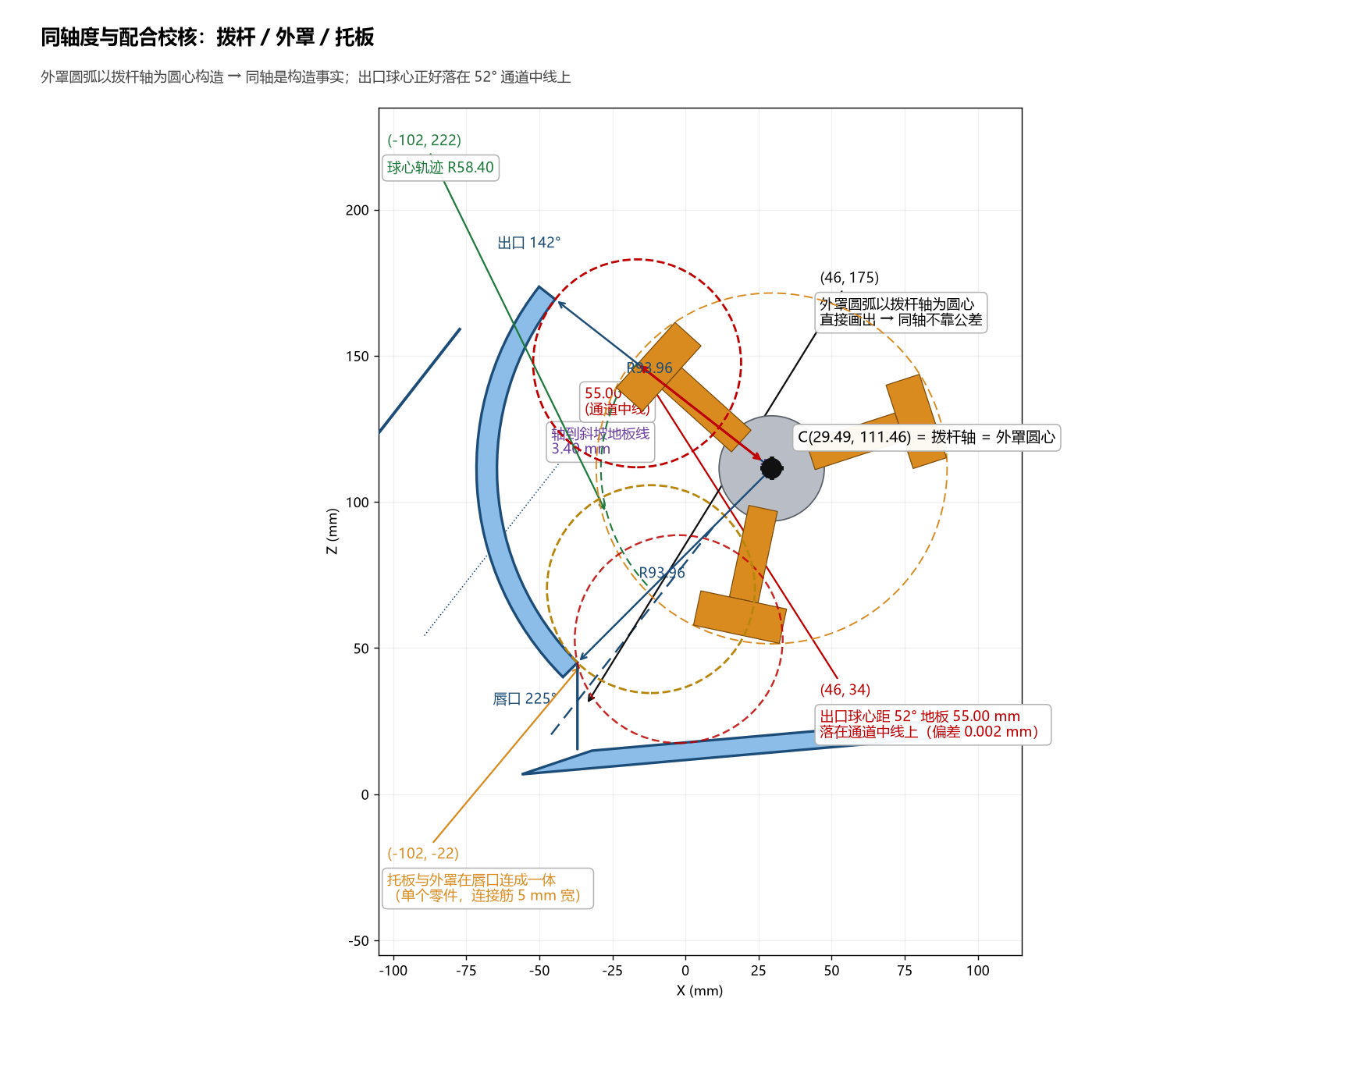
simulation/mujoco/out/redesign_v2_coax_zh.png
