wang15143089/FTC-2026-Bio-buzz/simulation/mujoco/out/section_r2_vs_r5_zh.png

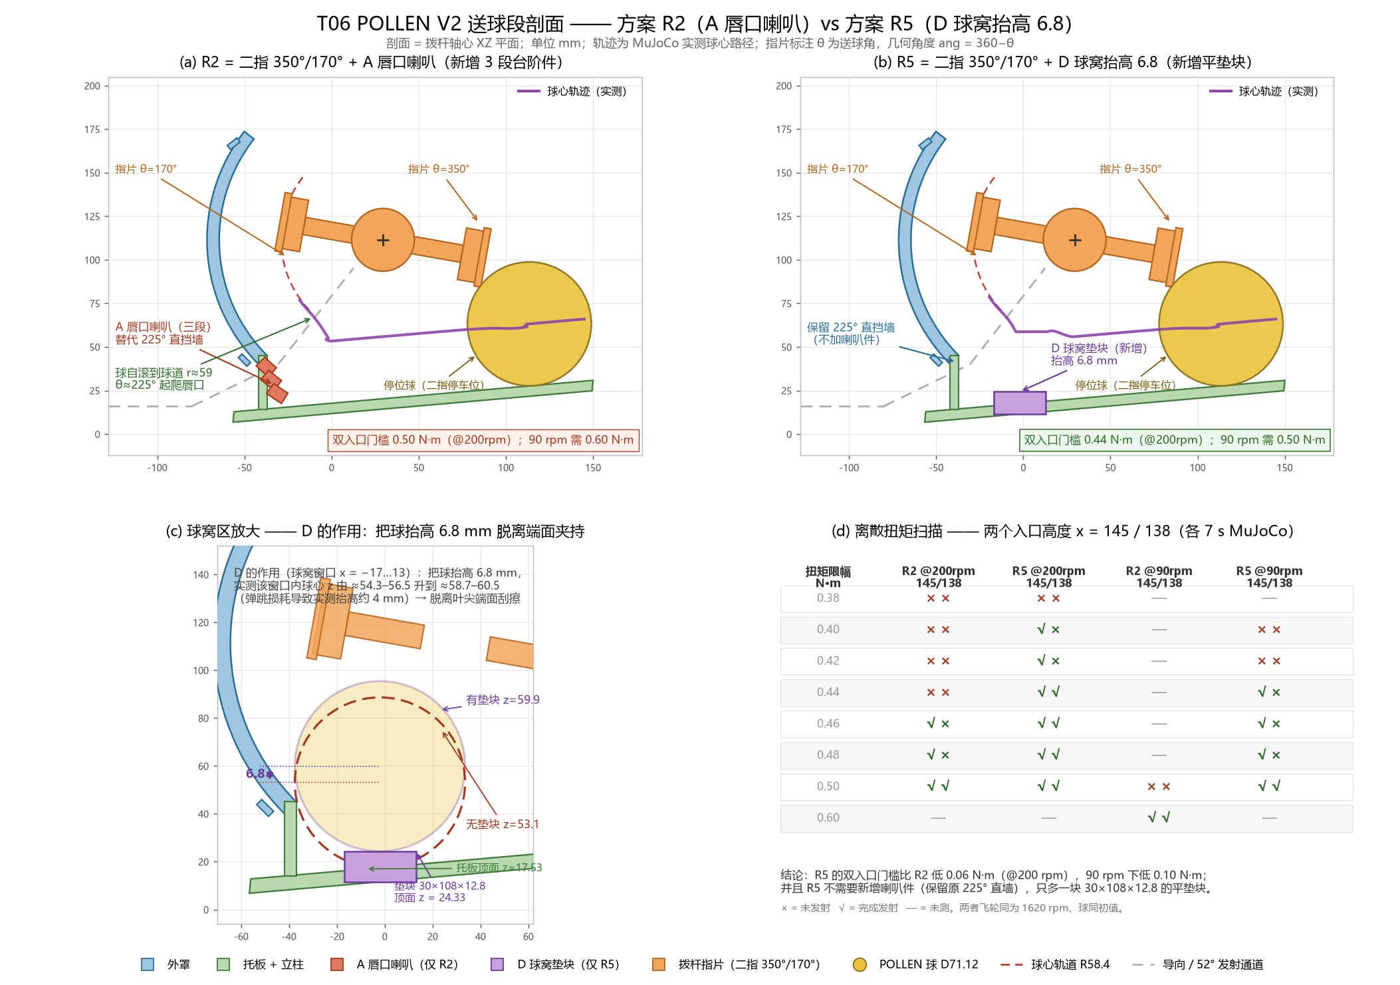
simulation/mujoco/out/section_r2_vs_r5_zh.png
