wang15143089/FTC-2026-Bio-buzz/simulation/mujoco/out/servo_envelope_zh.png

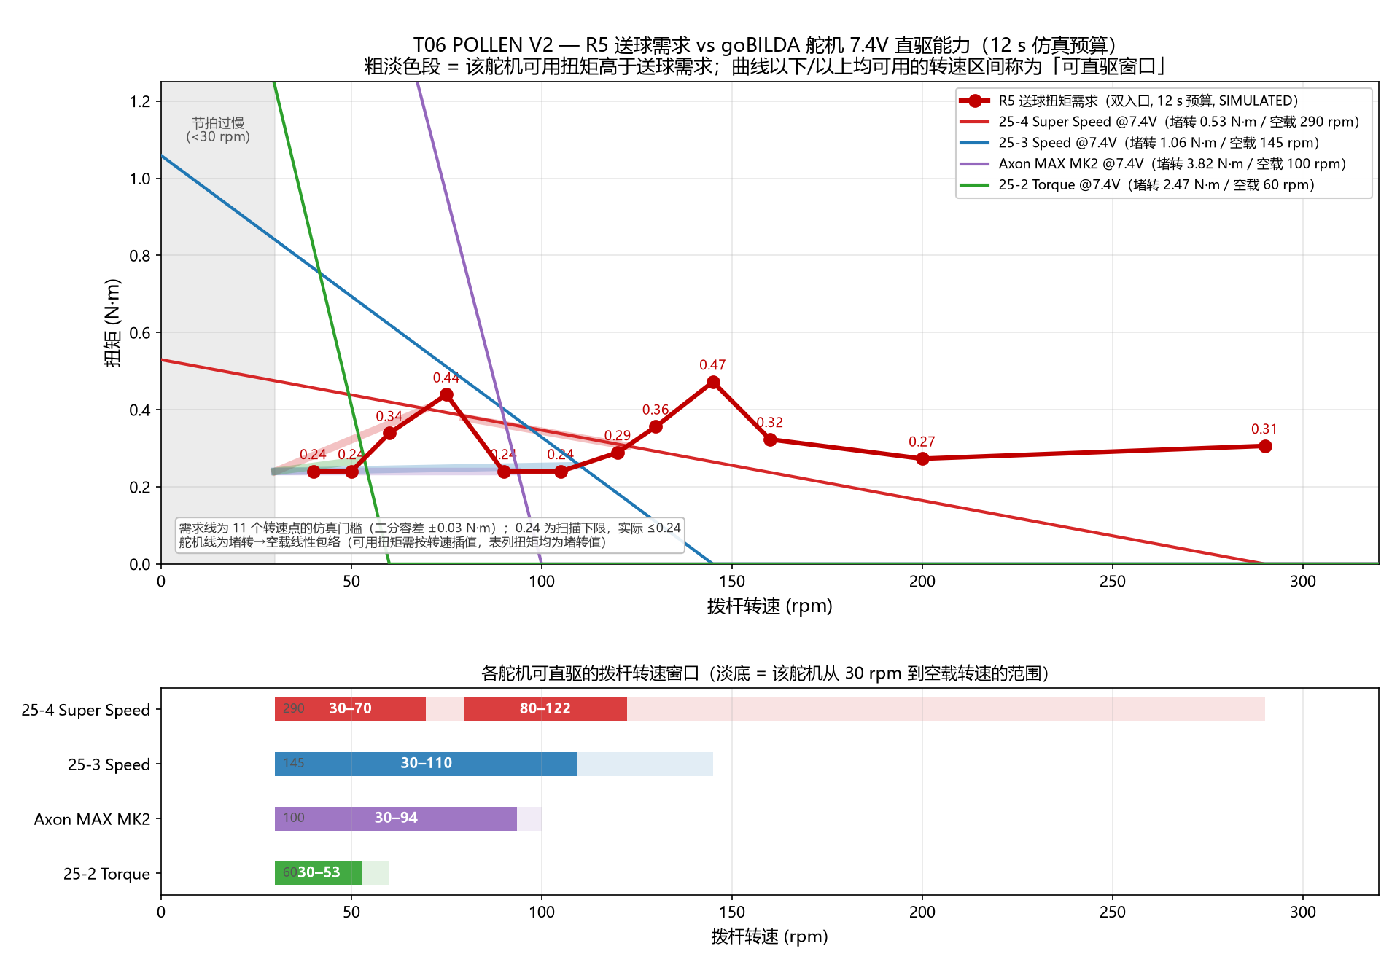
simulation/mujoco/out/servo_envelope_zh.png
