wang15143089/FTC-2026-Bio-buzz/simulation/mujoco/out/servo_verdict_zh.png

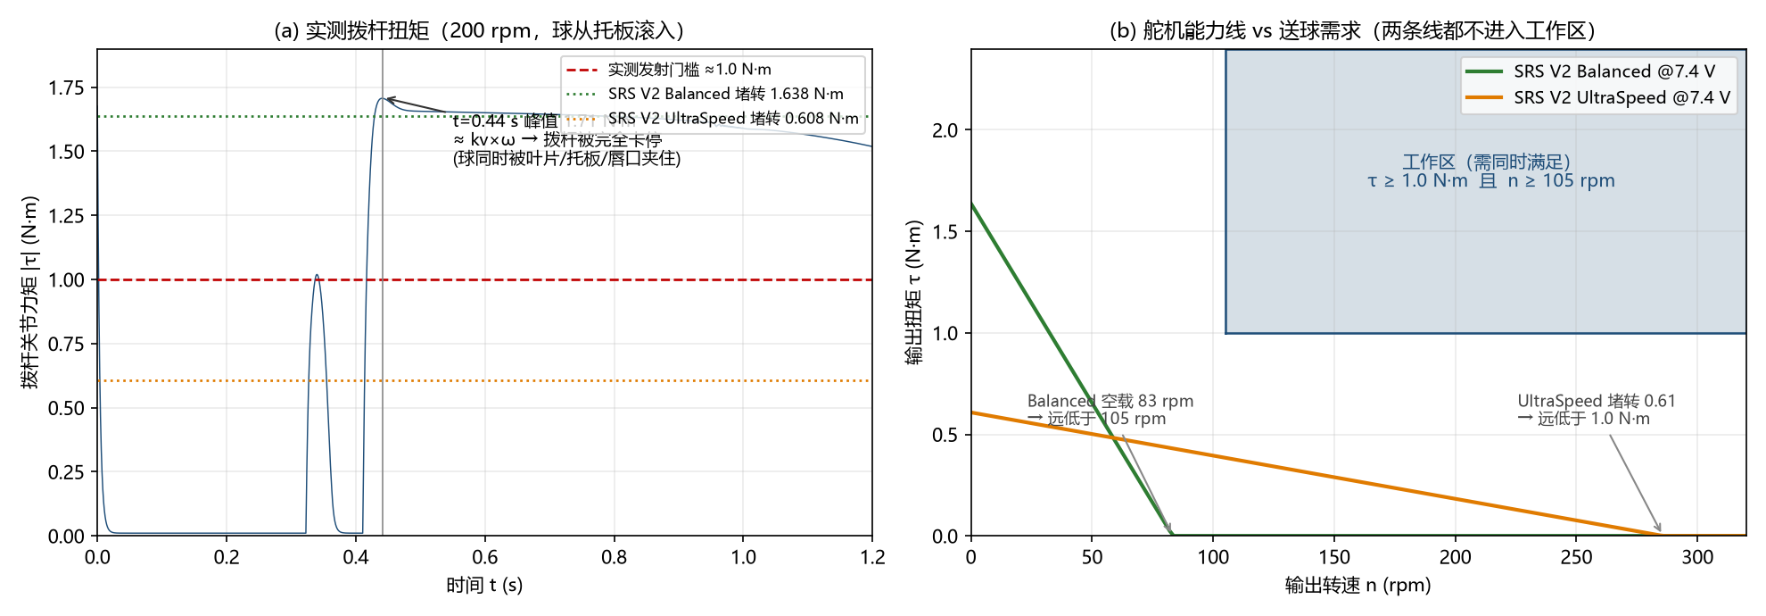
simulation/mujoco/out/servo_verdict_zh.png
