wang15143089/FTC-2026-Bio-buzz/simulation/mujoco/out/v2_flywheel_ladder_zh.png

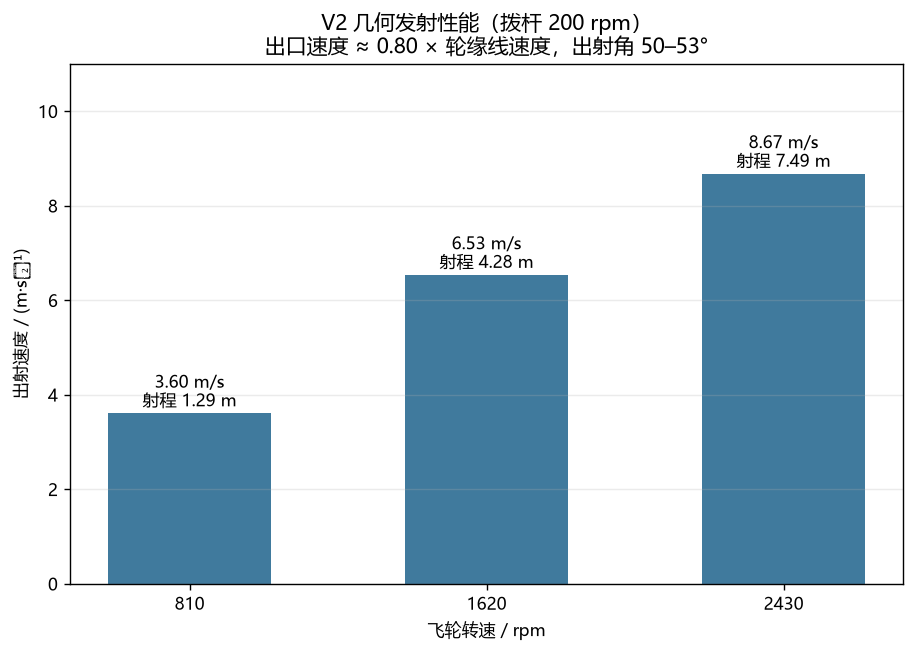
simulation/mujoco/out/v2_flywheel_ladder_zh.png
