wang15143089/FTC-2026-Bio-buzz/simulation/mujoco/out/v2_fullflow_zh.png

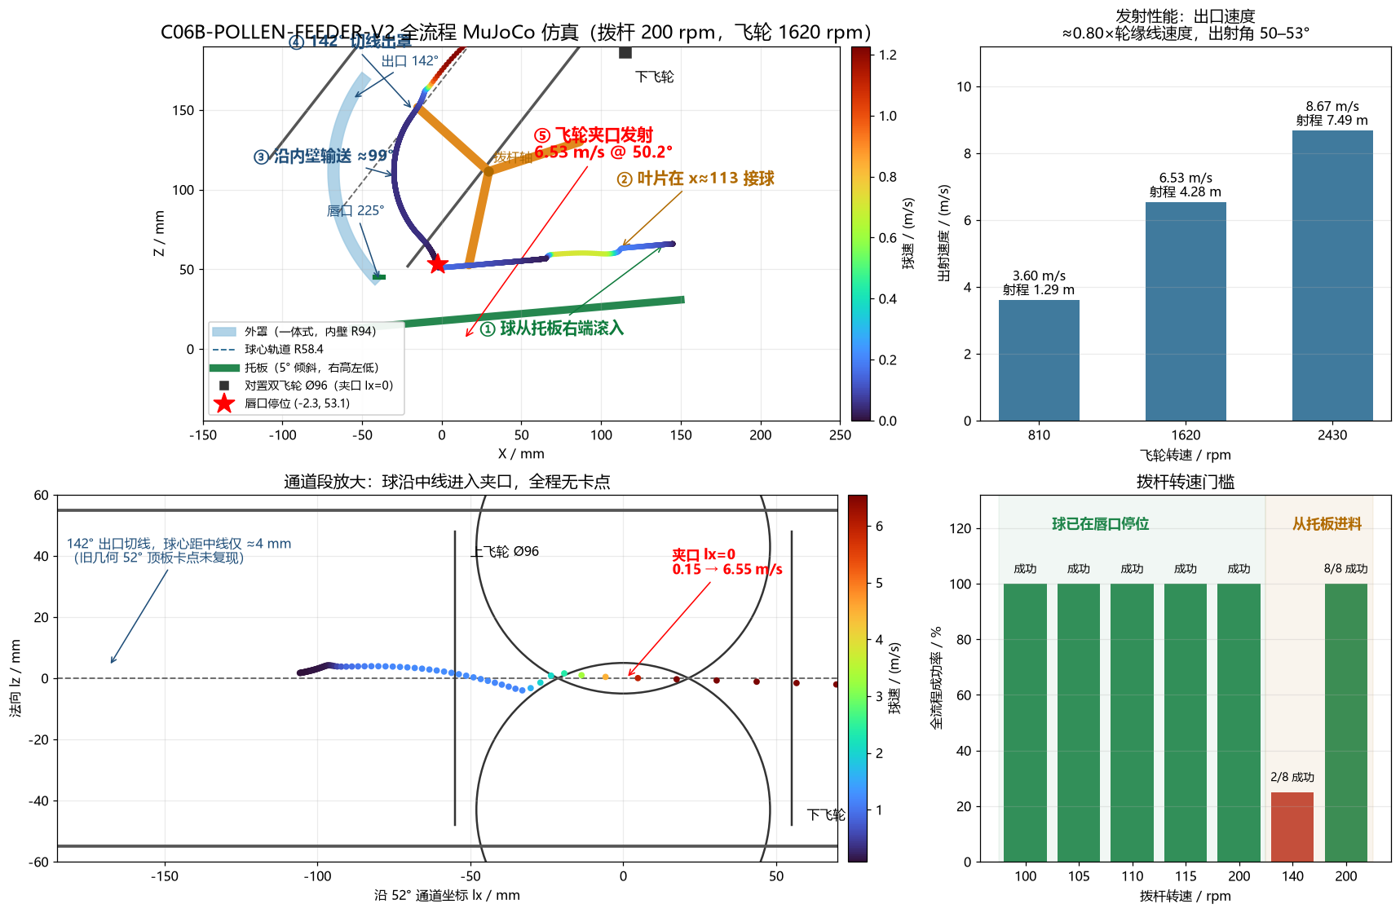
simulation/mujoco/out/v2_fullflow_zh.png
