wang15143089/FTC-2026-Bio-buzz/cad/_log_r66_parts.txt

frame V = 1103726.2 mm3 | sum(piece ^ frame) = 1103435.7 mm3 | delta = -290.53 mm3
coverage tolerance = 11037.3 mm3 -> ok=True
bearing_carriage_lower_+1                      V=  28142.4  81.7 x 12.0 x 89.6
bearing_carriage_lower_-1                      V=  28142.4  81.7 x 12.0 x 89.6
bearing_carriage_upper_+1                      V=  28142.4  81.7 x 12.0 x 89.6
bearing_carriage_upper_-1                      V=  28142.4  81.7 x 12.0 x 89.6
carriage_clamp_seat_lower_+1_+36_+12           V=    148.5  8.0 x 6.0 x 8.0
carriage_clamp_seat_lower_+1_+36_-12           V=    148.5  8.0 x 6.0 x 8.0
carriage_clamp_seat_lower_+1_-36_+12           V=    148.5  8.0 x 6.0 x 8.0
carriage_clamp_seat_lower_+1_-36_-12           V=    148.5  8.0 x 6.0 x 8.0
carriage_clamp_seat_lower_-1_+36_+12           V=    148.5  8.0 x 6.0 x 8.0
carriage_clamp_seat_lower_-1_+36_-12           V=    148.5  8.0 x 6.0 x 8.0
carriage_clamp_seat_lower_-1_-36_+12           V=    148.5  8.0 x 6.0 x 8.0
carriage_clamp_seat_lower_-1_-36_-12           V=    148.5  8.0 x 6.0 x 8.0
carriage_clamp_seat_upper_+1_+36_+12           V=    148.5  8.0 x 6.0 x 8.0
carriage_clamp_seat_upper_+1_+36_-12           V=    148.5  8.0 x 6.0 x 8.0
carriage_clamp_seat_upper_+1_-36_+12           V=    148.5  8.0 x 6.0 x 8.0
carriage_clamp_seat_upper_+1_-36_-12           V=    148.5  8.0 x 6.0 x 8.0
carriage_clamp_seat_upper_-1_+36_+12           V=    148.5  8.0 x 6.0 x 8.0
carriage_clamp_seat_upper_-1_+36_-12           V=    148.5  8.0 x 6.0 x 8.0
carriage_clamp_seat_upper_-1_-36_+12           V=    148.5  8.0 x 6.0 x 8.0
carriage_clamp_seat_upper_-1_-36_-12           V=    148.5  8.0 x 6.0 x 8.0
carriage_link_spacer_lower                     V=    970.3  10.0 x 15.0 x 10.0
carriage_link_spacer_upper                     V=    452.8  10.0 x 7.0 x 10.0
crosshead                                      V=   8250.7  29.6 x 24.0 x 29.3
crosshead_guide_+15                            V=   2000.0  28.6 x 10.0 x 34.6
crosshead_guide_-15                            V=   2000.0  28.6 x 10.0 x 34.6
crosshead_guide_stop_-42                       V=   1350.0  24.4 x 10.0 x 20.6
crosshead_guide_stop_-82                       V=   1350.0  24.4 x 10.0 x 20.6
gap_servo_standoff_-143_+23                    V=    480.7  6.0 x 17.0 x 6.0
gap_servo_standoff_-143_-23                    V=    480.7  6.0 x 17.0 x 6.0
gap_servo_standoff_-97_+23                     V=    480.7  6.0 x 17.0 x 6.0
gap_servo_standoff_-97_-23                     V=    480.7  6.0 x 17.0 x 6.0
main_spacing_link_lower                        V=   4787.3  123.5 x 6.4 x 24.2
main_spacing_link_upper                        V=   4787.3  30.6 x 6.4 x 122.7
motor_bridge_lower_+17                         V=   8736.0  25.4 x 42.0 x 22.3
motor_bridge_lower_-17                         V=   8736.0  25.4 x 42.0 x 22.3
motor_bridge_upper_+17                         V=   8736.0  25.4 x 42.0 x 22.3
motor_bridge_upper_-17                         V=   8736.0  25.4 x 42.0 x 22.3
paddle_flex_tip_1                              V=   6528.0  18.7 x 96.0 x 30.4
paddle_flex_tip_2                              V=   6528.0  18.7 x 96.0 x 30.4
paddle_rotor                                   V=  92960.0  115.5 x 96.0 x 84.0
servo_crank                                    V=    846.1  20.3 x 6.0 x 16.2
servo_drag_link                                V=   2700.4  60.7 x 6.0 x 55.0
base_rail_rear_joined                          V= 249800.6  130.0 x 162.0 x 26.0
base_rail_front_+72                            V= 114004.4  250.0 x 18.0 x 26.0
base_rail_front_-72                            V= 114004.4  250.0 x 18.0 x 26.0
rail_splice_plate_+72                          V=  10309.2  80.0 x 5.0 x 26.0
rail_splice_plate_-72                          V=  10309.2  80.0 x 5.0 x 26.0
frameP_1_rear_lower                            V= 769496.3  277.2 x 183.0 x 303.5
frameP_2_front_lower_L1                        V= 114473.0  185.3 x 108.0 x 22.2
frameP_2_front_lower_L2                        V=  51990.8  113.8 x 4.0 x 224.3
frameP_2_front_lower_L3                        V=  51990.8  113.8 x 4.0 x 224.3
frameP_2_front_lower_L4                        V=   8024.0  68.0 x 9.5 x 14.0
frameP_2_front_lower_L5                        V=   8024.0  68.0 x 9.5 x 14.0
frameP_3_top_L1                                V=  60338.0  247.6 x 5.5 x 136.0
frameP_3_top_L2                                V=  60338.0  247.6 x 5.5 x 136.0
readback: 55 objects, 0 bad, total V = 1910425.8 mm3
wrote cad\output\_r66_parts\parts_index.json
