wang15143089/FTC-2026-Bio-buzz/calculations/p3_ballistics_results.csv

model_version | launch_height_m | requires_deployment | horizontal_distance_m | launch_angle_deg | status | required_exit_speed_m_s | flight_time_s | entry_angle_deg | apex_height_m | specific_kinetic_energy_j_kg | wheel_rpm_96mm_at_nominal_ratio | wheel_rpm_120mm_at_nominal_ratio
P3-BAL-0.1 | 0.4 | false | 0.75 | 50.0 | INFEASIBLE_AT_THIS_ANGLE
P3-BAL-0.1 | 0.4 | false | 0.75 | 55.0 | CALCULATED_VACUUM_MODEL | 23.3618 | 0.056 | 54.2128 | 19.0719 | 272.8858 | 7150.3 | 5720.2
P3-BAL-0.1 | 0.4 | false | 0.75 | 60.0 | CALCULATED_VACUUM_MODEL | 6.734 | 0.2227 | 47.2893 | 2.1341 | 22.6737 | 2061.1 | 1648.9
P3-BAL-0.1 | 0.4 | false | 1.0 | 50.0 | CALCULATED_VACUUM_MODEL | 9.3412 | 0.1665 | 42.6062 | 3.0107 | 43.629 | 2859.0 | 2287.2
P3-BAL-0.1 | 0.4 | false | 1.0 | 55.0 | CALCULATED_VACUUM_MODEL | 6.3263 | 0.2756 | 34.3468 | 1.7692 | 20.0111 | 1936.3 | 1549.0
P3-BAL-0.1 | 0.4 | false | 1.0 | 60.0 | CALCULATED_VACUUM_MODEL | 5.3852 | 0.3714 | 20.7792 | 1.509 | 14.5004 | 1648.2 | 1318.6
P3-BAL-0.1 | 0.4 | false | 1.5 | 50.0 | CALCULATED_VACUUM_MODEL | 6.0402 | 0.3863 | 12.1839 | 1.4916 | 18.2418 | 1848.7 | 1479.0
P3-BAL-0.1 | 0.4 | false | 1.5 | 55.0 | CALCULATED_VACUUM_MODEL | 5.5557 | 0.4707 | -1.1733 | 1.456 | 15.4327 | 1700.4 | 1360.3
P3-BAL-0.1 | 0.4 | false | 1.5 | 60.0 | CALCULATED_VACUUM_MODEL | 5.3491 | 0.5608 | -17.9722 | 1.4941 | 14.3063 | 1637.2 | 1309.7
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
P3-BAL-0.1 | 0.7 | true | 2.0 | 55.0 | CALCULATED_VACUUM_MODEL | 5.3274 | 0.6545 | -33.9168 | 1.671 | 14.1908 | 1630.6 | 1304.4
P3-BAL-0.1 | 0.7 | true | 2.0 | 60.0 | CALCULATED_VACUUM_MODEL | 5.3821 | 0.7432 | -44.313 | 1.8077 | 14.4836 | 1647.3 | 1317.8
