wang15143089/FTC-2026-Bio-buzz/calculations/p3_concept_trade_results.csv

concept | score_0_to_100 | rank | status
C06-B_opposed_dual_flywheel | 76.0 | 1 | ASSUMED_M1_PROTOTYPE_SCREEN
C06-A_single_flywheel_hood | 69.0 | 2 | ASSUMED_M1_PROTOTYPE_SCREEN
C06-C_adjustable_catapult | 66.0 | 3 | ASSUMED_M1_PROTOTYPE_SCREEN
