wang15143089/FTC-2026-Bio-buzz/cad/output/_r61_frame/T06_shooter_assembly_R61_pollen.step

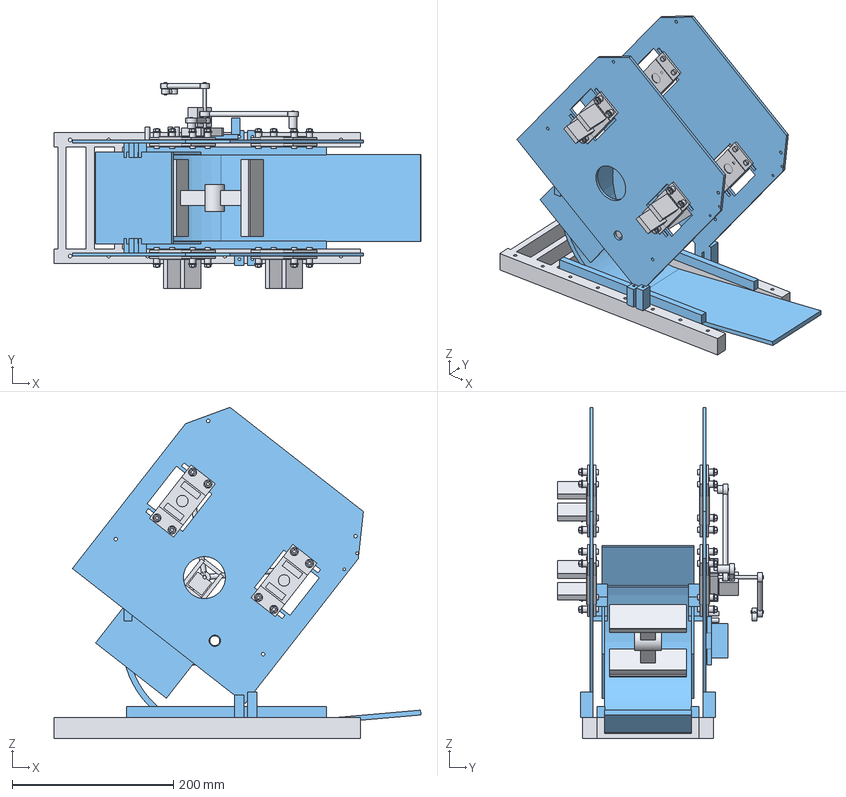
[picture p91: CAD file, 2026-10-16]
cad/output/_r61_frame/T06_shooter_assembly_R61_pollen.step
455.3 x 255.0 x 411.0 mm
bearing_carriage_lower_+1
bearing_carriage_lower_-1
bearing_carriage_upper_+1
bearing_carriage_upper_-1
carriage_clamp_seat_lower_+1_+36_+12
carriage_clamp_seat_lower_+1_+36_-12
carriage_clamp_seat_lower_+1_-36_+12
carriage_clamp_seat_lower_+1_-36_-12
carriage_clamp_seat_lower_-1_+36_+12
carriage_clamp_seat_lower_-1_+36_-12
carriage_clamp_seat_lower_-1_-36_+12
carriage_clamp_seat_lower_-1_-36_-12
carriage_clamp_seat_upper_+1_+36_+12
carriage_clamp_seat_upper_+1_+36_-12
carriage_clamp_seat_upper_+1_-36_+12
carriage_clamp_seat_upper_+1_-36_-12
carriage_clamp_seat_upper_-1_+36_+12
carriage_clamp_seat_upper_-1_+36_-12
carriage_clamp_seat_upper_-1_-36_+12
carriage_clamp_seat_upper_-1_-36_-12
carriage_clamp_spring_lower_+1_+36_+12
carriage_clamp_spring_lower_+1_+36_-12
carriage_clamp_spring_lower_+1_-36_+12
carriage_clamp_spring_lower_+1_-36_-12
carriage_clamp_spring_lower_-1_+36_+12
carriage_clamp_spring_lower_-1_+36_-12
carriage_clamp_spring_lower_-1_-36_+12
carriage_clamp_spring_lower_-1_-36_-12
carriage_clamp_spring_upper_+1_+36_+12
carriage_clamp_spring_upper_+1_+36_-12
carriage_clamp_spring_upper_+1_-36_+12
carriage_clamp_spring_upper_+1_-36_-12
carriage_clamp_spring_upper_-1_+36_+12
carriage_clamp_spring_upper_-1_+36_-12
carriage_clamp_spring_upper_-1_-36_+12
carriage_clamp_spring_upper_-1_-36_-12
carriage_clamp_stud_lower_+1_+36_+12
carriage_clamp_stud_lower_+1_+36_-12
carriage_clamp_stud_lower_+1_-36_+12
carriage_clamp_stud_lower_+1_-36_-12
carriage_clamp_stud_lower_-1_+36_+12
carriage_clamp_stud_lower_-1_+36_-12
carriage_clamp_stud_lower_-1_-36_+12
carriage_clamp_stud_lower_-1_-36_-12
carriage_clamp_stud_upper_+1_+36_+12
carriage_clamp_stud_upper_+1_+36_-12
carriage_clamp_stud_upper_+1_-36_+12
carriage_clamp_stud_upper_+1_-36_-12
carriage_clamp_stud_upper_-1_+36_+12
carriage_clamp_stud_upper_-1_+36_-12
carriage_clamp_stud_upper_-1_-36_+12
carriage_clamp_stud_upper_-1_-36_-12
carriage_link_pin_lower
carriage_link_pin_upper
carriage_link_spacer_lower
carriage_link_spacer_upper
crosshead
crosshead_guide_+15
crosshead_guide_-15
crosshead_guide_stop_-42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
