wang15143089/FTC-2026-Bio-buzz/exports/step/t04_c04b1_capstan_fixture_assembly_m3.step

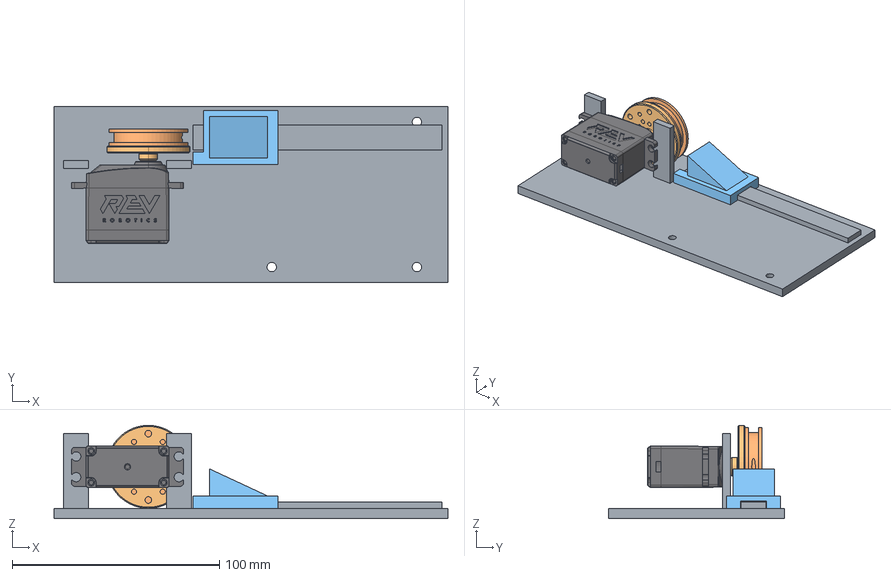
[picture p92: CAD file, 2026-09-20]
exports/step/t04_c04b1_capstan_fixture_assembly_m3.step
190.0 x 85.0 x 45.0 mm
printed_bracket_rail
REV_41_3336_official
REV_41_1828_official
printed_17mm_capstan
paddle_start
