wang15143089/FTC-2026-Bio-buzz/cad/output/_r66_parts/main_spacing_link_upper.step

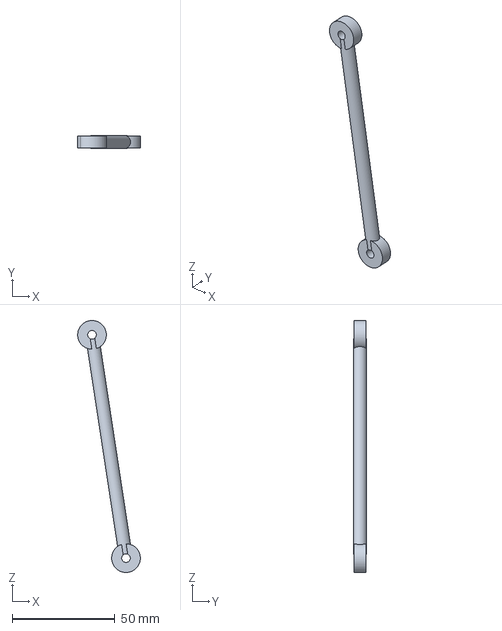
[picture p94: CAD file, 2026-10-16]
cad/output/_r66_parts/main_spacing_link_upper.step
30.5 x 6.40 x 122.7 mm
