wang15143089/FTC-2026-Bio-buzz/cad/output/_r66_parts/main_spacing_link_lower.step

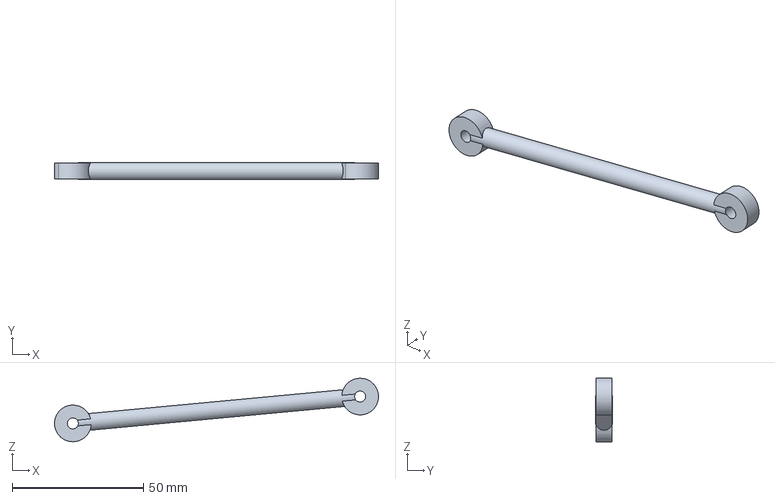
[picture p95: CAD file, 2026-10-16]
cad/output/_r66_parts/main_spacing_link_lower.step
123.5 x 6.40 x 24.2 mm
