wang15143089/FTC-2026-Bio-buzz/cad/output/_r39_liner/_measure_pollen.stl

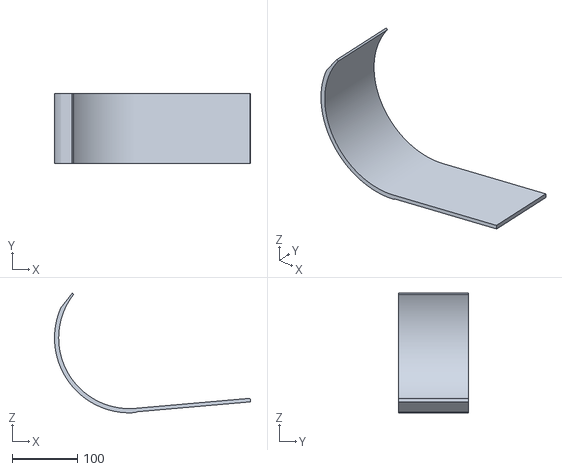
[picture p96: CAD file, 2026-10-12]
cad/output/_r39_liner/_measure_pollen.stl
300.7 x 108.0 x 183.5
