wang15143089/FTC-2026-Bio-buzz/cad/output/_r59_frame/T06_base_rail_R59_pollen.step

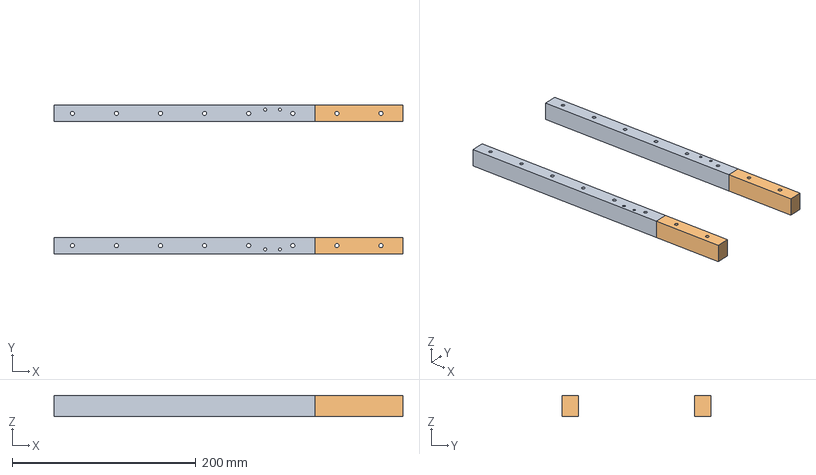
[picture p97: CAD file, 2026-10-15]
cad/output/_r59_frame/T06_base_rail_R59_pollen.step
380.0 x 162.0 x 23.0 mm
base_rail_-_front
base_rail_-_rear
base_rail_+_front
base_rail_+_rear
