wang15143089/FTC-2026-Bio-buzz/cad/output/_r66_parts/frameP_1_rear_lower.step

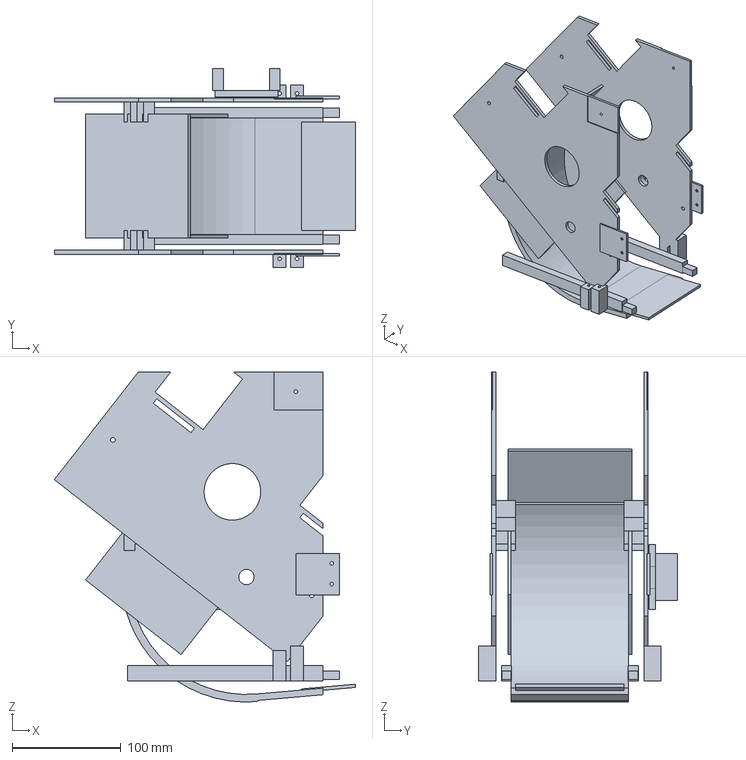
[picture p101: CAD file, 2026-10-16]
cad/output/_r66_parts/frameP_1_rear_lower.step
277.2 x 183.0 x 303.5 mm
