wang15143089/FTC-2026-Bio-buzz/cad/output/_r66_plate/T06_print_plate_R67_pollen_p2.step

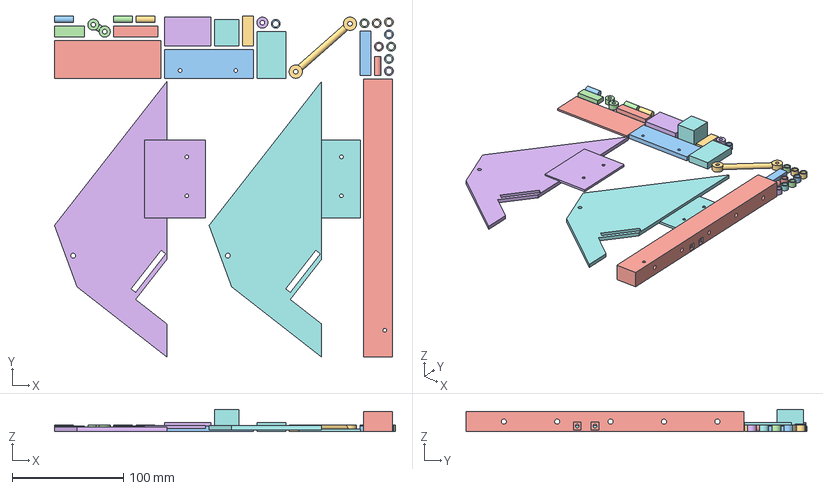
[picture p102: CAD file, 2026-10-16]
cad/output/_r66_plate/T06_print_plate_R67_pollen_p2.step
306.7 x 306.6 x 20.0 mm
base_rail_front_+72
carriage_clamp_seat_lower_+1_-36_-12
carriage_clamp_seat_lower_-1_+36_+12
carriage_clamp_seat_lower_-1_+36_-12
carriage_clamp_seat_lower_-1_-36_+12
carriage_clamp_seat_lower_-1_-36_-12
carriage_clamp_seat_upper_+1_+36_+12
carriage_clamp_seat_upper_+1_+36_-12
carriage_clamp_seat_upper_+1_-36_+12
carriage_clamp_seat_upper_+1_-36_-12
carriage_link_spacer_upper
crosshead
crosshead_guide_+15
crosshead_guide_-15
crosshead_guide_stop_-42
crosshead_guide_stop_-82
frameP_3_top_L1
frameP_3_top_L2
gap_servo_standoff_-143_+23
gap_servo_standoff_-143_-23
gap_servo_standoff_-97_+23
gap_servo_standoff_-97_-23
motor_bridge_lower_+17
motor_bridge_upper_+17
paddle_flex_tip_2
rail_splice_plate_+72
servo_crank
servo_drag_link
