wang15143089/FTC-2026-Bio-buzz/cad/output/biobuzz_single_motor_flipout_intake_deployed.step

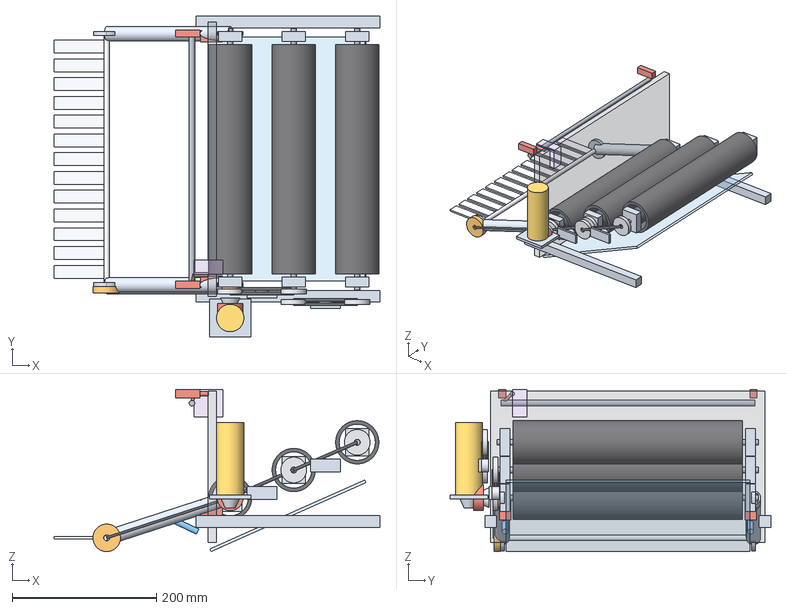
[picture p103: CAD file, 2026-09-27]
cad/output/biobuzz_single_motor_flipout_intake_deployed.step
451.6 x 444.0 x 224.7 mm
chassis_front_datum
mount_rail_-190
mount_rail_+190
fixed_roller_1
fixed_shaft_1
dual_bearing_block_1_-170
dual_bearing_block_1_+170
fixed_roller_2
fixed_shaft_2
dual_bearing_block_2_-170
dual_bearing_block_2_+170
fixed_roller_3
fixed_shaft_3
dual_bearing_block_3_-170
dual_bearing_block_3_+170
chain_sprocket_1_driver
chain_sprocket_1_driven
chain_loop_1
chain_idler_3312_0006_0008_1
arc_slot_tensioner_1524_0001_0001_1
chain_sprocket_2_driver
chain_sprocket_2_driven
chain_loop_2
chain_idler_3312_0006_0008_2
arc_slot_tensioner_1524_0001_0001_2
ball_guide_floor
motor_5203_2402_0019_312rpm_envelope
motor_mount
miter_gear_24t_motor
miter_gear_24t_primary
primary_slip_clutch_0p8Nm_envelope
pivot_arm_-174
pivot_arm_+174
front_finger_bar
front_pulley_24t_3417_4008_0024
pivot_pulley_16t_3417_4008_0016
front_belt_460mm_3412_0009_0460
deployment_spring_-170
replaceable_hard_stop_-170
deployment_spring_+170
replaceable_hard_stop_+170
latch_cross_shaft
load_bearing_pawl_-174
load_bearing_pawl_+174
rev_41_3334_balanced_servo_envelope
servo_release_crank_20mm
servo_release_link
