wang15143089/FTC-2026-Bio-buzz/cad/output/inspection/_r27_shared_feeder_shell_tray.step

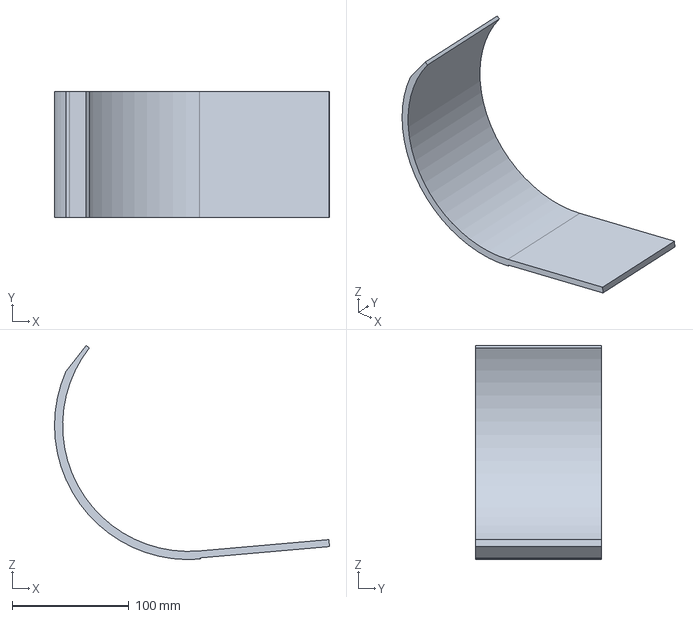
[picture p104: CAD file, 2026-10-04]
cad/output/inspection/_r27_shared_feeder_shell_tray.step
235.7 x 108.0 x 183.5 mm
