wang15143089/FTC-2026-Bio-buzz/cad/output/parts/paddle_blade.step

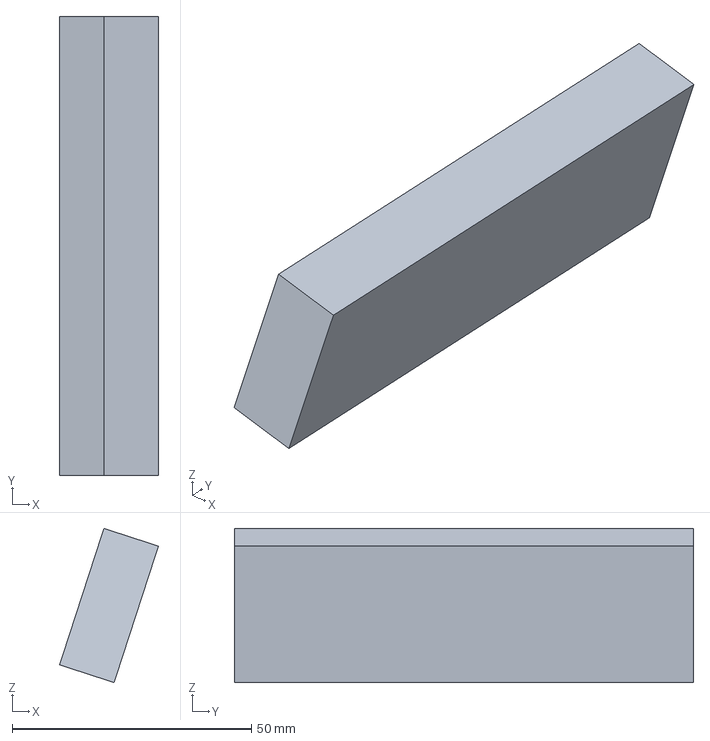
[picture p105: CAD file, 2026-10-02]
cad/output/parts/paddle_blade.step
20.7 x 96.0 x 32.2 mm
