wang15143089/FTC-2026-Bio-buzz/cad/output/_r39_liner/liner_tape_tray.step

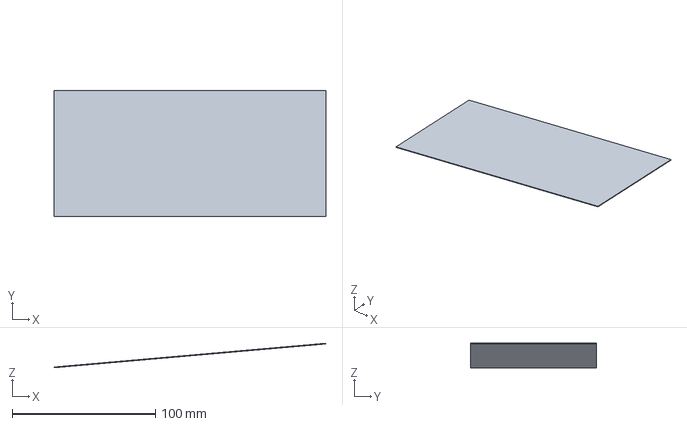
[picture p106: CAD file, 2026-10-12]
cad/output/_r39_liner/liner_tape_tray.step
190.1 x 88.0 x 17.1 mm
