wang15143089/FTC-2026-Bio-buzz/cad/output/_r59_frame/T06_shooter_frame_R59_pollen.step

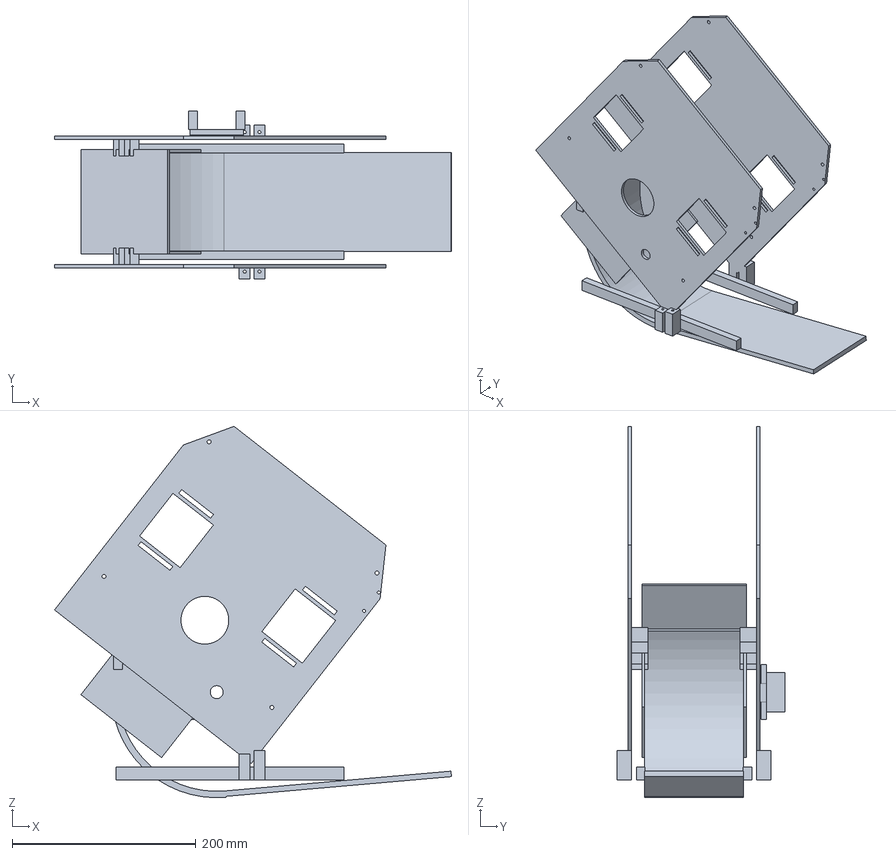
[picture p107: CAD file, 2026-10-15]
cad/output/_r59_frame/T06_shooter_frame_R59_pollen.step
432.5 x 183.0 x 404.5 mm
