wang15143089/FTC-2026-Bio-buzz/cad/output/_r62_frame/T06_base_rail_R62_pollen.step

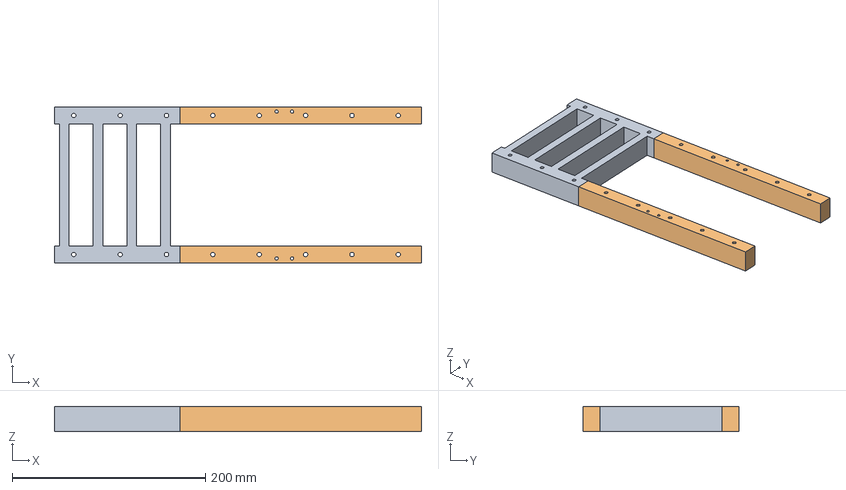
[picture p108: CAD file, 2026-10-16]
cad/output/_r62_frame/T06_base_rail_R62_pollen.step
380.0 x 162.0 x 26.0 mm
base_rail_rear_joined
base_rail_front_-72
base_rail_front_+72
