wang15143089/FTC-2026-Bio-buzz/cad/output/_r66_parts/frameP_2_front_lower_L2.step

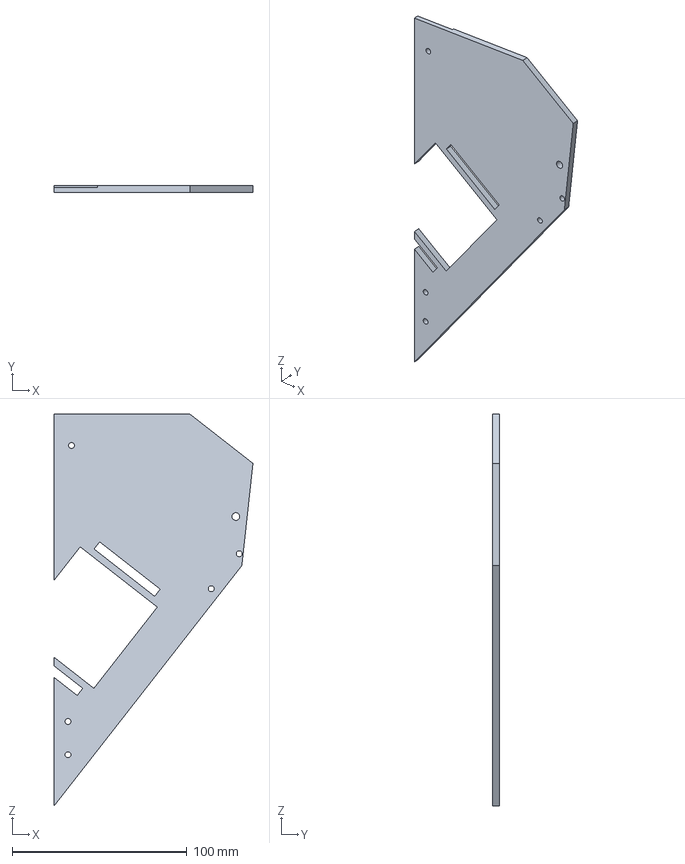
[picture p109: CAD file, 2026-10-16]
cad/output/_r66_parts/frameP_2_front_lower_L2.step
113.8 x 4.00 x 224.3 mm
