wang15143089/FTC-2026-Bio-buzz/cad/output/_r66_plate/T06_print_plate_R67_pollen_p1.step

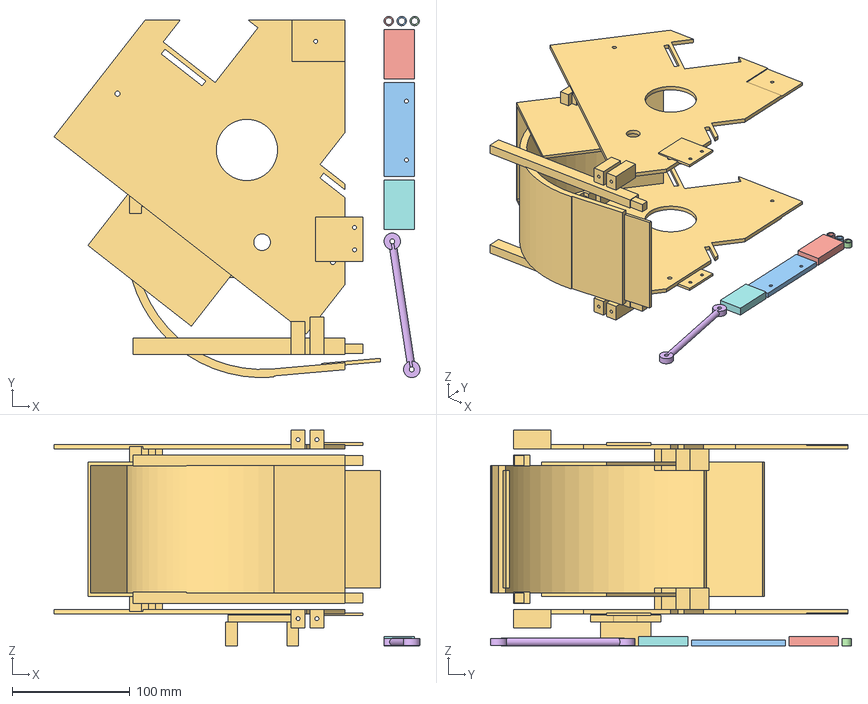
[picture p110: CAD file, 2026-10-16]
cad/output/_r66_plate/T06_print_plate_R67_pollen_p1.step
310.8 x 306.7 x 183.0 mm
carriage_clamp_seat_lower_+1_+36_+12
carriage_clamp_seat_lower_+1_+36_-12
carriage_clamp_seat_lower_+1_-36_+12
frameP_1_rear_lower
main_spacing_link_upper
motor_bridge_lower_-17
motor_bridge_upper_-17
rail_splice_plate_-72
