wang15143089/FTC-2026-Bio-buzz/cad/output/inspection/_r27_shared_relief_context.step

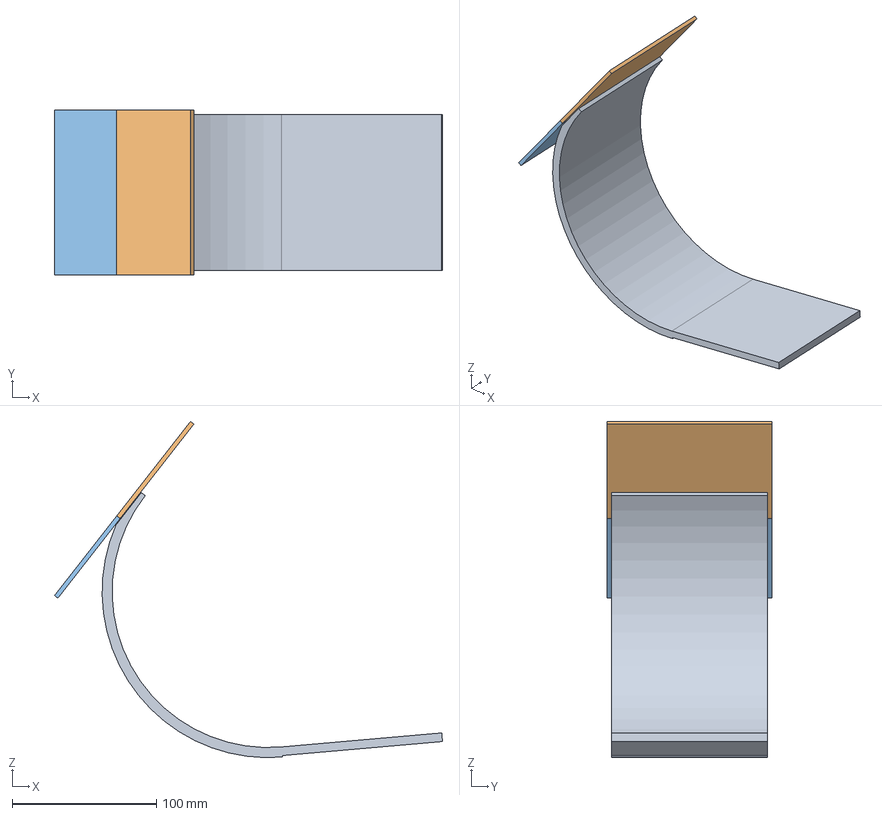
[picture p112: CAD file, 2026-10-04]
cad/output/inspection/_r27_shared_relief_context.step
268.7 x 114.0 x 232.8 mm
