wang15143089/FTC-2026-Bio-buzz/cad/output/parts/spacing_link_110mm.step

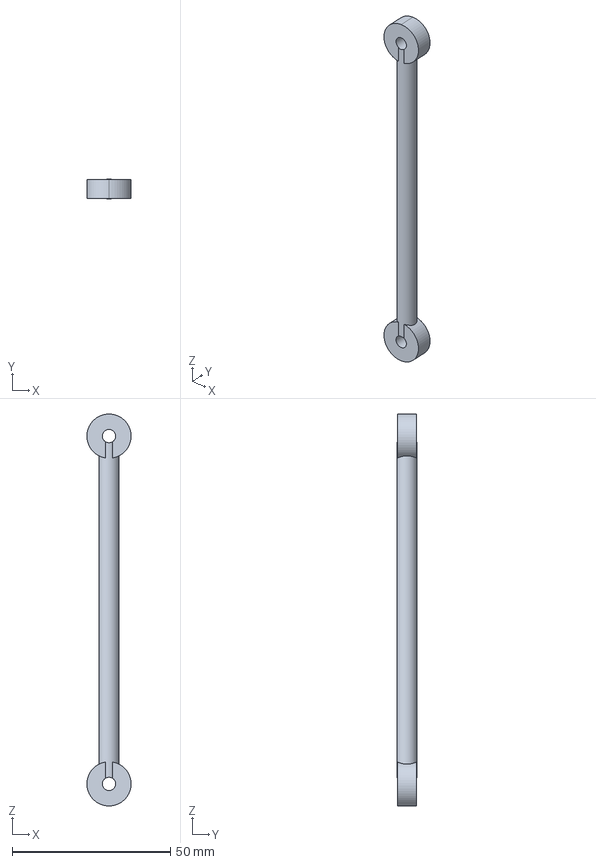
[picture p113: CAD file, 2026-10-02]
cad/output/parts/spacing_link_110mm.step
14.0 x 6.40 x 124.0 mm
