wang15143089/FTC-2026-Bio-buzz/exports/step/t04_c04b1_17mm_capstan_m3.step

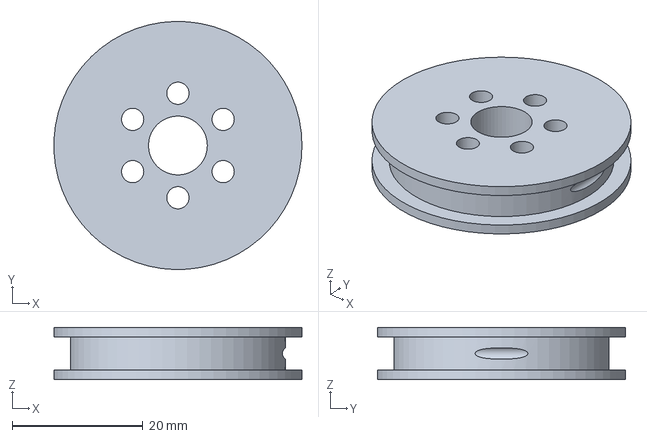
[picture p114: CAD file, 2026-09-20]
exports/step/t04_c04b1_17mm_capstan_m3.step
38.0 x 38.0 x 8.00 mm
