wang15143089/FTC-2026-Bio-buzz/cad/output/_r39_liner/liner_tape_arc.step

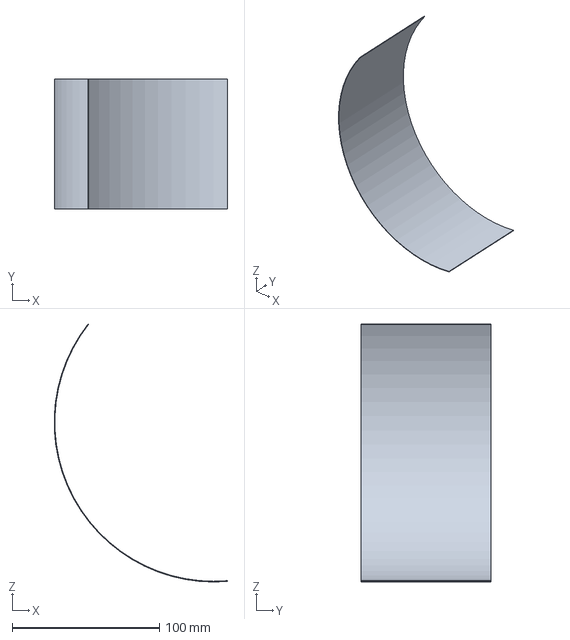
[picture p115: CAD file, 2026-10-12]
cad/output/_r39_liner/liner_tape_arc.step
117.8 x 88.0 x 175.3 mm
