wang15143089/FTC-2026-Bio-buzz/cad/output/_r60_frame/T06_print_set_R60_pollen.step

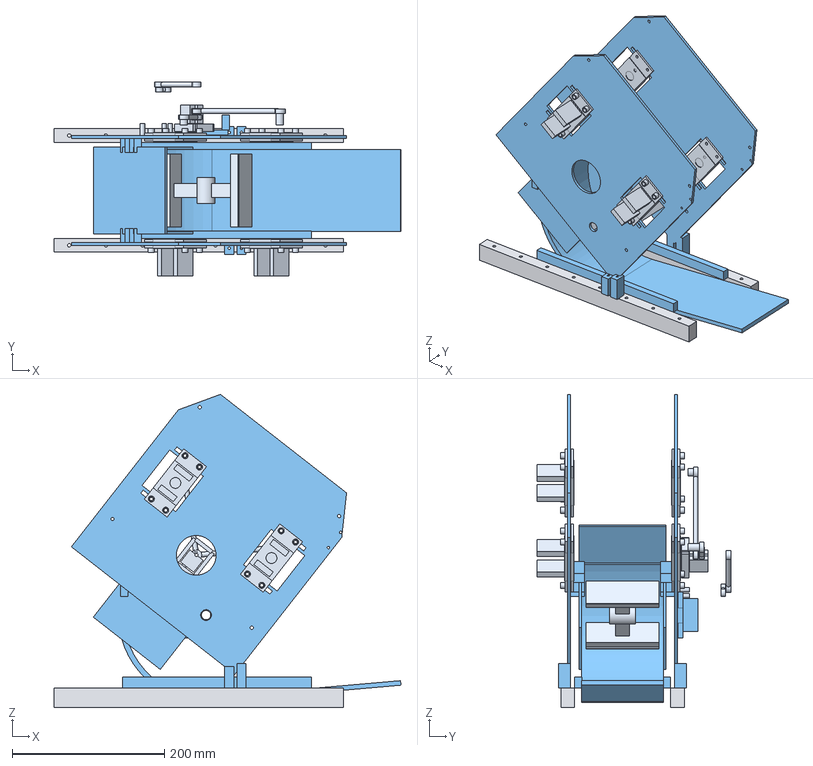
[picture p116: CAD file, 2026-10-16]
cad/output/_r60_frame/T06_print_set_R60_pollen.step
455.3 x 254.0 x 411.0 mm
shooter_frame_R60_merged
base_rail_-72
base_rail_+72
bearing_carriage_lower_+1
bearing_carriage_lower_-1
bearing_carriage_upper_+1
bearing_carriage_upper_-1
carriage_clamp_seat_lower_+1_+36_+12
carriage_clamp_seat_lower_+1_+36_-12
carriage_clamp_seat_lower_+1_-36_+12
carriage_clamp_seat_lower_+1_-36_-12
carriage_clamp_seat_lower_-1_+36_+12
carriage_clamp_seat_lower_-1_+36_-12
carriage_clamp_seat_lower_-1_-36_+12
carriage_clamp_seat_lower_-1_-36_-12
carriage_clamp_seat_upper_+1_+36_+12
carriage_clamp_seat_upper_+1_+36_-12
carriage_clamp_seat_upper_+1_-36_+12
carriage_clamp_seat_upper_+1_-36_-12
carriage_clamp_seat_upper_-1_+36_+12
carriage_clamp_seat_upper_-1_+36_-12
carriage_clamp_seat_upper_-1_-36_+12
carriage_clamp_seat_upper_-1_-36_-12
carriage_link_spacer_lower
carriage_link_spacer_upper
crosshead
crosshead_guide_+15
crosshead_guide_-15
crosshead_guide_stop_-42
crosshead_guide_stop_-82
gap_servo_standoff_-143_+23
gap_servo_standoff_-143_-23
gap_servo_standoff_-97_+23
gap_servo_standoff_-97_-23
main_spacing_link_lower
main_spacing_link_upper
motor_bridge_lower_+17
motor_bridge_lower_-17
motor_bridge_upper_+17
motor_bridge_upper_-17
paddle_flex_tip_1
paddle_flex_tip_2
paddle_rotor
servo_crank
servo_drag_link
