wang15143089/FTC-2026-Bio-buzz/cad/output/_r66_parts/gap_servo_standoff_-143_+23.step

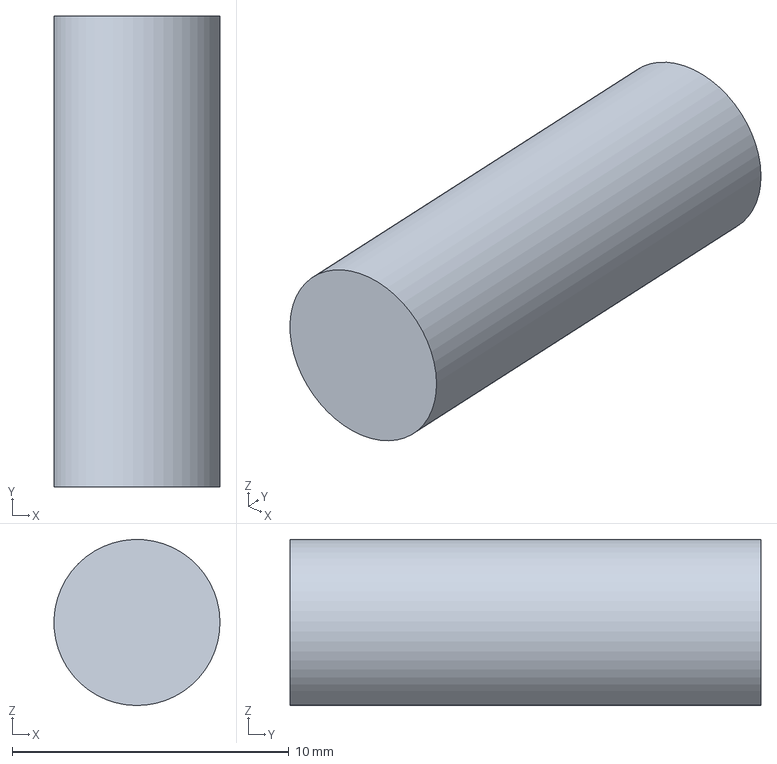
[picture p118: CAD file, 2026-10-16]
cad/output/_r66_parts/gap_servo_standoff_-143_+23.step
6.00 x 17.0 x 6.00 mm
