wang15143089/FTC-2026-Bio-buzz/cad/output/_r66_plate/T06_print_plate_R67_pollen_p3.step

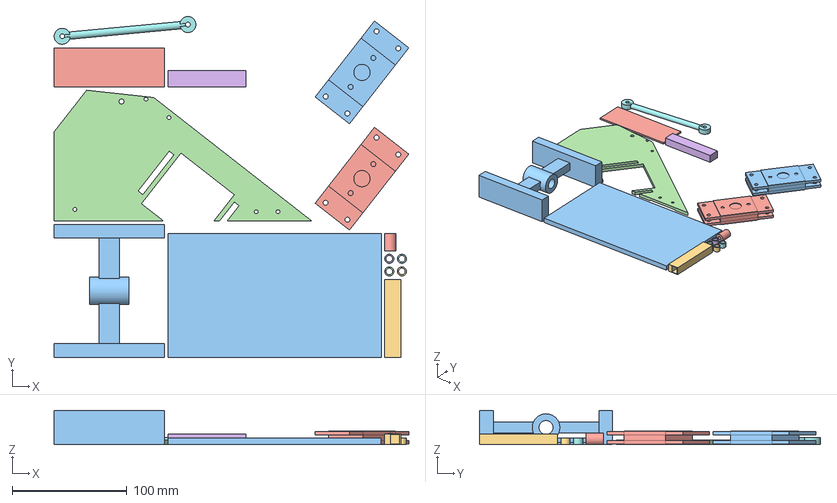
[picture p119: CAD file, 2026-10-16]
cad/output/_r66_plate/T06_print_plate_R67_pollen_p3.step
309.0 x 297.1 x 30.0 mm
bearing_carriage_lower_+1
bearing_carriage_lower_-1
carriage_clamp_seat_upper_-1_+36_+12
carriage_clamp_seat_upper_-1_+36_-12
carriage_clamp_seat_upper_-1_-36_+12
carriage_clamp_seat_upper_-1_-36_-12
carriage_link_spacer_lower
frameP_2_front_lower_L1
frameP_2_front_lower_L2
frameP_2_front_lower_L4
frameP_2_front_lower_L5
main_spacing_link_lower
paddle_flex_tip_1
paddle_rotor
