wang15143089/FTC-2026-Bio-buzz/cad/output/continuous_servo_feeder.step

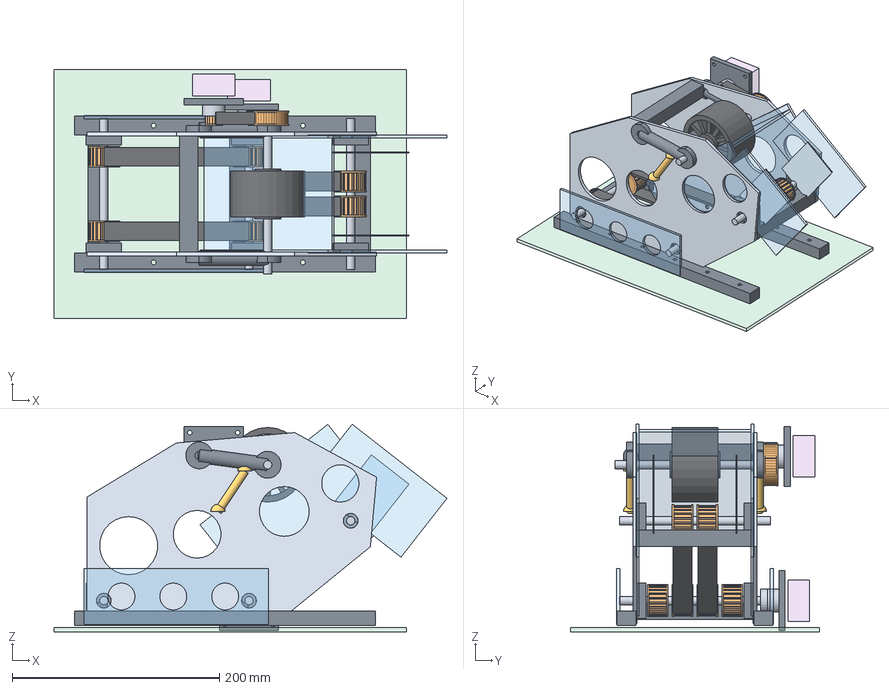
[picture p120: CAD file, 2026-09-24]
cad/output/continuous_servo_feeder.step
378.9 x 240.0 x 200.1 mm
00_xy_chassis_reference
side_frame_-1
side_frame_+1
crossmember_-118_16
crossmember_18_16
crossmember_136_86
crossmember_-30_169
chassis_rail_-66
chassis_rail_+66
shaft_horizontal_return
bearing_block_horizontal_return_-1
bearing_horizontal_return_-1
bearing_block_horizontal_return_+1
bearing_horizontal_return_+1
shaft_junction_drive
bearing_block_junction_drive_-1
bearing_junction_drive_-1
bearing_block_junction_drive_+1
bearing_junction_drive_+1
shaft_incline_return
bearing_block_incline_return_-1
bearing_incline_return_-1
bearing_block_incline_return_+1
bearing_incline_return_+1
pulley_horizontal_return_-36
pulley_horizontal_drive_-36
belt_horizontal_top_-36
belt_horizontal_return_-36
pulley_horizontal_return_36
pulley_horizontal_drive_36
belt_horizontal_top_36
belt_horizontal_return_36
pulley_incline_drive_-12
pulley_incline_return_-12
belt_incline_top_-12
belt_incline_return_-12
pulley_incline_drive_12
pulley_incline_return_12
belt_incline_top_12
belt_incline_return_12
belt_drive_servo_envelope_0
belt_drive_servo_block_plate_1
belt_drive_servo_output_hub_2
junction_shaft_coupler
incline_guide_wall_-1
incline_guide_wall_+1
incline_guide_roof
pinch_swing_arm_-1
pinch_preload_link_-1
pinch_preload_eye_a_-1
pinch_preload_eye_b_-1
pinch_swing_arm_+1
pinch_preload_link_+1
pinch_preload_eye_a_+1
pinch_preload_eye_b_+1
pinch_shaft
pinch_compliant_roller
pinch_drive_servo_envelope_0
pinch_drive_servo_block_plate_1
pinch_drive_servo_output_hub_2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
