wang15143089/FTC-2026-Bio-buzz/cad/output/inspection/_r27_shared_paddle_hub.step

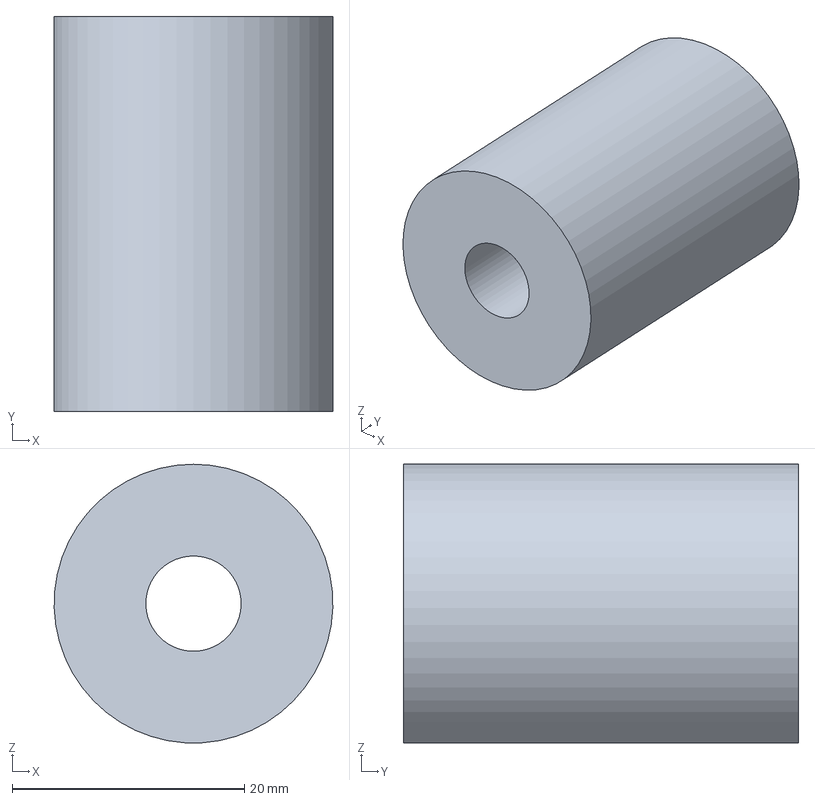
[picture p121: CAD file, 2026-10-04]
cad/output/inspection/_r27_shared_paddle_hub.step
24.0 x 34.0 x 24.0 mm
