wang15143089/FTC-2026-Bio-buzz/cad/output/parts/sliding_bearing_carriage.step

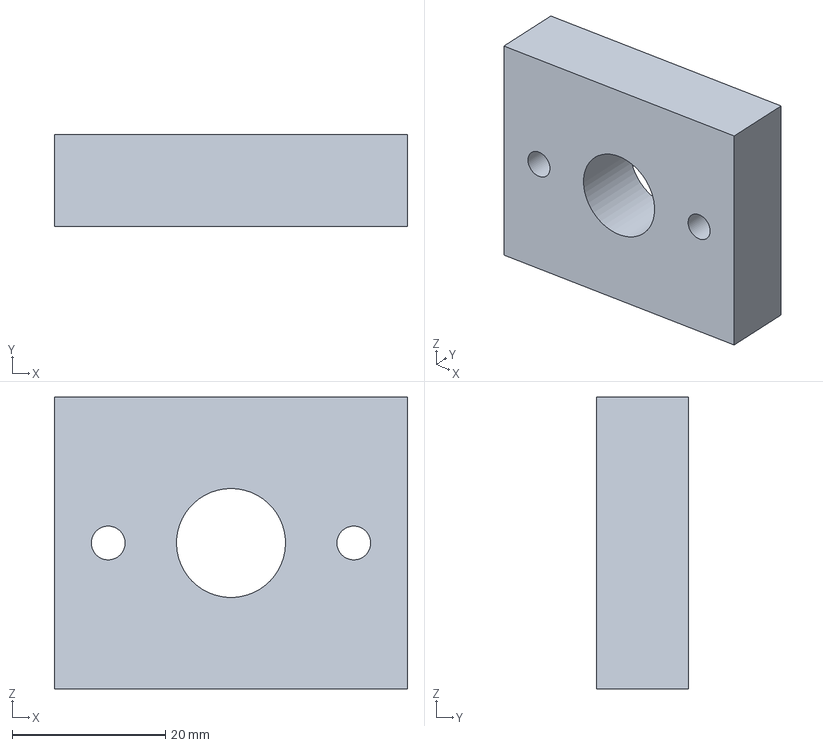
[picture p122: CAD file, 2026-10-02]
cad/output/parts/sliding_bearing_carriage.step
46.0 x 12.0 x 38.0 mm
