wang15143089/FTC-2026-Bio-buzz/cad/output/_r60_frame/T06_base_rail_R60_pollen.step

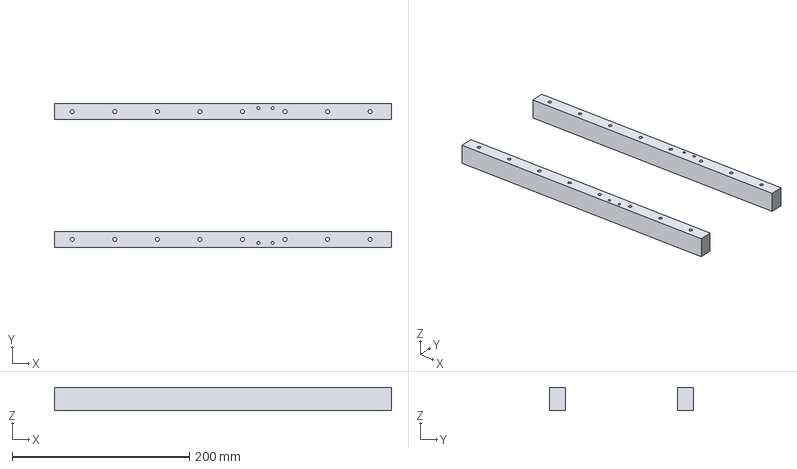
[picture p123: CAD file, 2026-10-16]
cad/output/_r60_frame/T06_base_rail_R60_pollen.step
380.0 x 162.0 x 26.0 mm
base_rail_-72
base_rail_+72
