wang15143089/FTC-2026-Bio-buzz/cad/output/_r66_parts/crosshead_guide_stop_-82.step

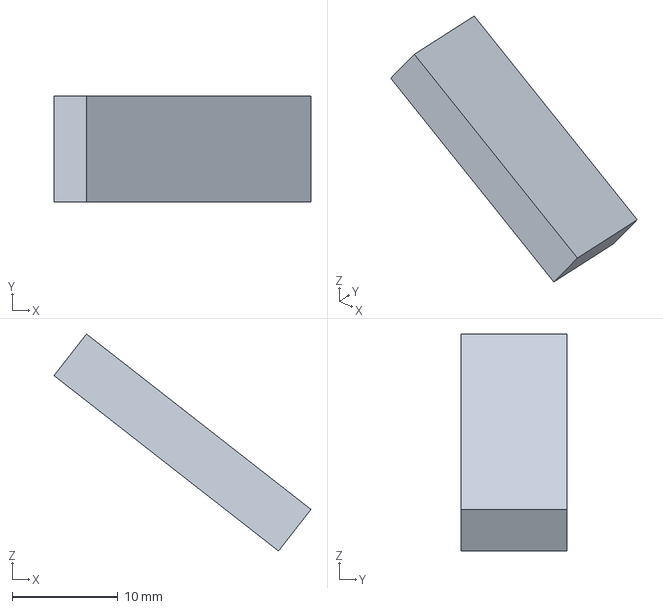
[picture p124: CAD file, 2026-10-16]
cad/output/_r66_parts/crosshead_guide_stop_-82.step
24.4 x 10.0 x 20.6 mm
