wang15143089/FTC-2026-Bio-buzz/cad/output/_r66_plate/T06_print_plate_R67_pollen_p4.step

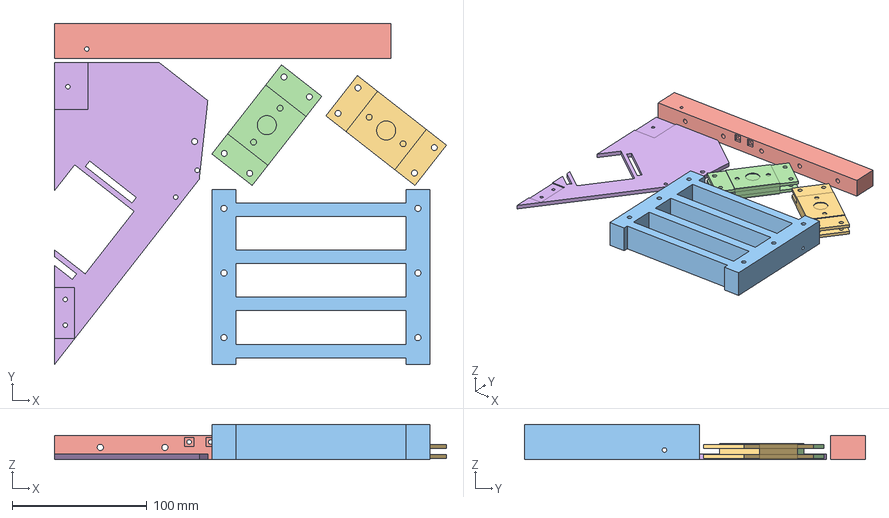
[picture p125: CAD file, 2026-10-16]
cad/output/_r66_plate/T06_print_plate_R67_pollen_p4.step
291.1 x 253.3 x 26.0 mm
base_rail_front_-72
base_rail_rear_joined
bearing_carriage_upper_+1
bearing_carriage_upper_-1
frameP_2_front_lower_L3
