wang15143089/FTC-2026-Bio-buzz/cad/output/inspection/_r26_shared_feeder_shell_tray.step

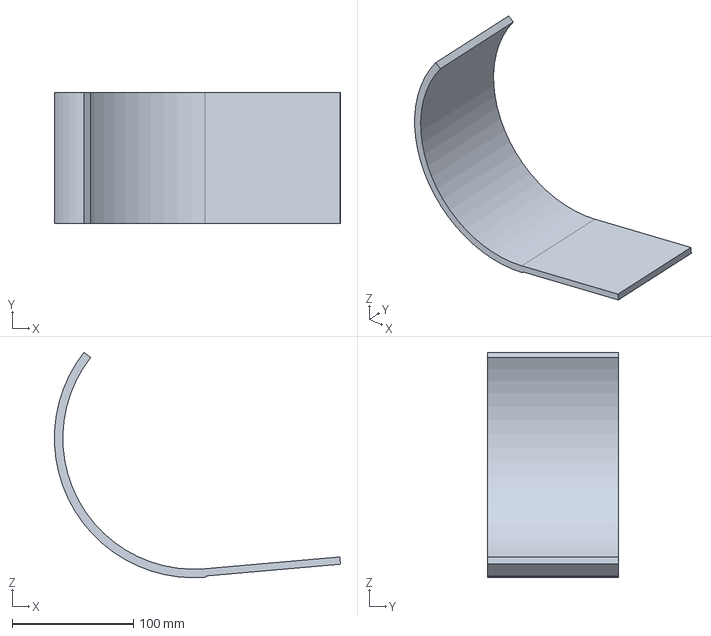
[picture p126: CAD file, 2026-10-04]
cad/output/inspection/_r26_shared_feeder_shell_tray.step
235.6 x 108.0 x 185.7 mm
