wang15143089/FTC-2026-Bio-buzz/cad/output/paddle_launcher_constrained_nectar.step

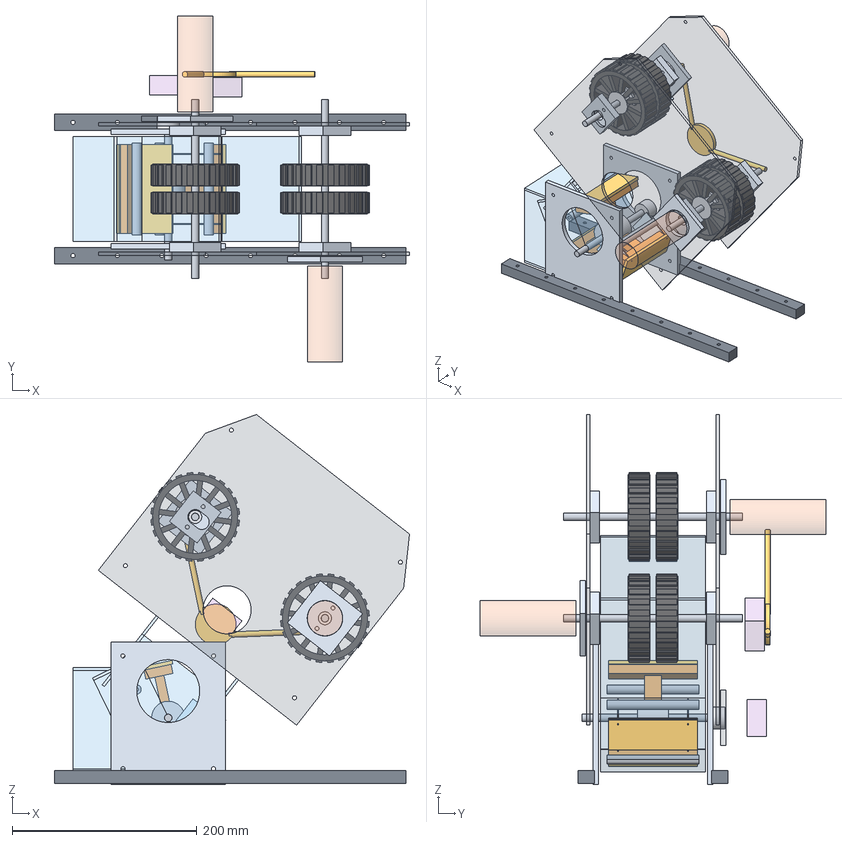
[picture p127: CAD file, 2026-09-24]
cad/output/paddle_launcher_constrained_nectar.step
383.8 x 374.0 x 400.0 mm
base_rail_-72
base_rail_+72
guide_floor_1
guide_roof_1
guide_wall_1_-1
guide_wall_1_+1
guide_floor_2
guide_roof_2
guide_wall_2_-1
guide_wall_2_+1
guide_floor_3
guide_roof_3
guide_wall_3_-1
guide_wall_3_+1
paddle_support_cheek_-1
paddle_support_cheek_+1
paddle_shaft_8mm
paddle_hub
paddle_arm_1
paddle_hinge_1
paddle_blade_1
paddle_flex_tip_1
paddle_arm_2
paddle_hinge_2
paddle_blade_2
paddle_flex_tip_2
paddle_arm_3
paddle_hinge_3
paddle_blade_3
paddle_flex_tip_3
paddle_cr_servo_envelope
paddle_servo_block
paddle_shaft_clamp
one_way_finger_-1
one_way_finger_+1
shooter_side_plate_-1
shooter_side_plate_+1
flywheel_shaft_upper
gecko_flywheel_upper_1
sonic_hub_upper_1
hub_bolt_upper_1_1
hub_bolt_upper_1_2
hub_bolt_upper_1_3
hub_bolt_upper_1_4
gecko_flywheel_upper_2
sonic_hub_upper_2
hub_bolt_upper_2_1
hub_bolt_upper_2_2
hub_bolt_upper_2_3
hub_bolt_upper_2_4
bearing_block_upper_-1
bearing_block_upper_+1
motor_mount_upper
motor_envelope_upper
flywheel_shaft_lower
gecko_flywheel_lower_1
sonic_hub_lower_1
hub_bolt_lower_1_1
hub_bolt_lower_1_2
hub_bolt_lower_1_3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
