wang15143089/FTC-2026-Bio-buzz/cad/output/parts/gobilda_1401_0043_0036_mount_official.step

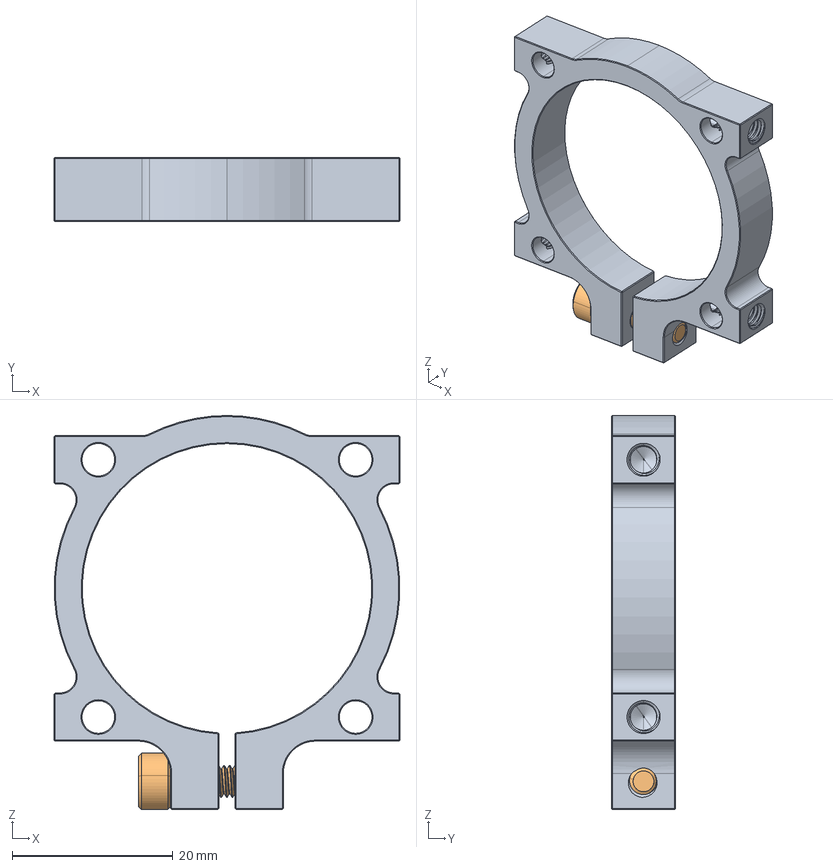
[picture p128: CAD file, 2026-10-02]
cad/output/parts/gobilda_1401_0043_0036_mount_official.step
43.0 x 8.00 x 49.0 mm
