wang15143089/FTC-2026-Bio-buzz/exports/step/t04_c04b1_servo_rail_bracket_m3.step

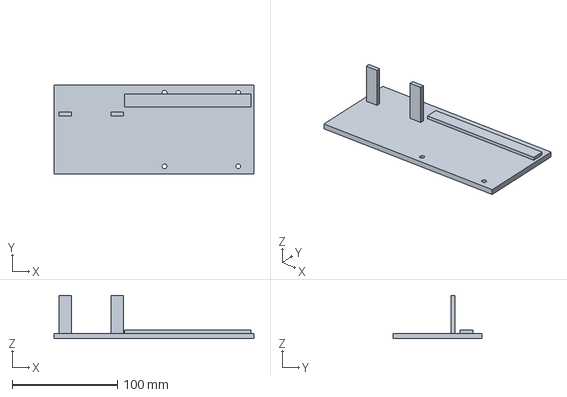
[picture p129: CAD file, 2026-09-20]
exports/step/t04_c04b1_servo_rail_bracket_m3.step
190.0 x 85.0 x 41.0 mm
