wang15143089/FTC-2026-Bio-buzz/cad/output/_r66_plate/T06_print_plate_R66_pollen_p4.step

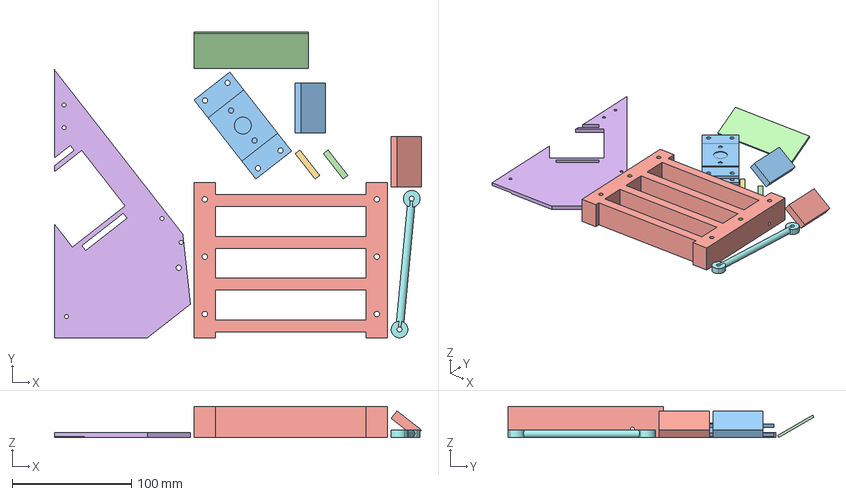
[picture p130: CAD file, 2026-10-16]
cad/output/_r66_plate/T06_print_plate_R66_pollen_p4.step
307.3 x 256.0 x 26.0 mm
base_rail_rear_joined
bearing_carriage_upper_-1
crosshead_guide_stop_-42
crosshead_guide_stop_-82
frameP_2_front_lower_L3
main_spacing_link_lower
motor_bridge_lower_-17
motor_bridge_upper_+17
paddle_flex_tip_1
