wang15143089/FTC-2026-Bio-buzz/cad/output/biobuzz_launcher_horizontal_feed_pollen.step

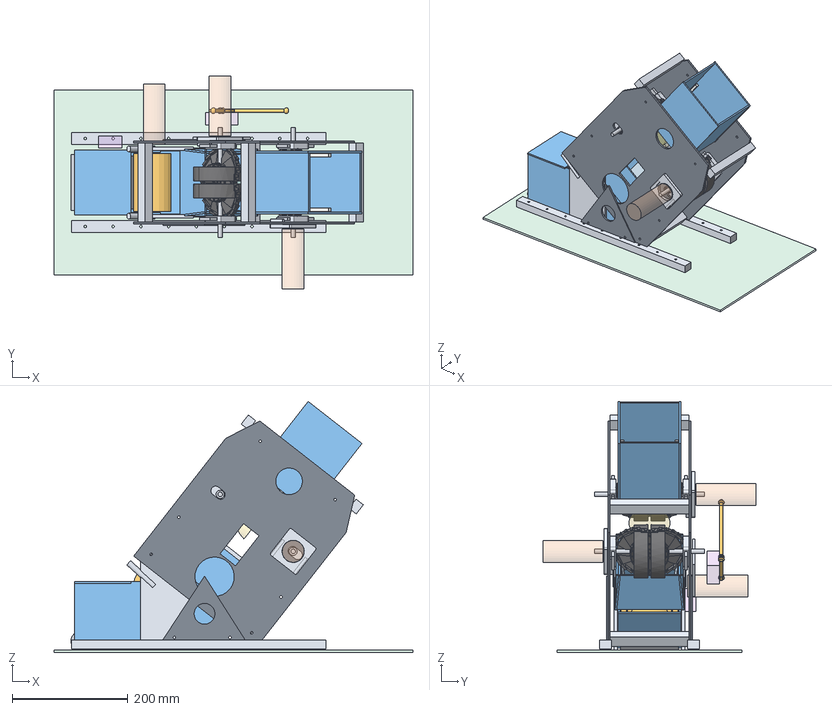
[picture p131: CAD file, 2026-09-24]
cad/output/biobuzz_launcher_horizontal_feed_pollen.step
620.0 x 368.0 x 433.7 mm
00_chassis_xy_reference
base_rail_-1
angle_gusset_-1
base_rail_+1
angle_gusset_+1
horizontal_feed_floor
horizontal_feed_roof
horizontal_feed_side_-1
horizontal_feed_side_+1
horizontal_belt_envelope
horizontal_belt_pulley_-95
horizontal_belt_pulley_48
transition_guide_-1
transition_guide_+1
transition_side_-1
transition_side_+1
kick_roller_envelope
upper_guide_roller_envelope
kick_support_cheek_-1
spring_guide_arm_-1
kick_support_cheek_+1
spring_guide_arm_+1
feed_motor_envelope
feed_gate_servo_envelope
feed_gate_flap_envelope
horizontal_path_ball_1
horizontal_path_ball_2
horizontal_path_ball_3
main_side_plate_-1
main_side_plate_+1
crossmember_-162_-118
crossmember_-162_118
crossmember_128_-118
crossmember_128_118
slide_rail_-1_-1
carriage_-1_-1
slide_rail_-1_+1
carriage_-1_+1
slide_rail_+1_-1
carriage_+1_-1
slide_rail_+1_+1
carriage_+1_+1
shaft_upper
gecko_upper_1
gecko_upper_2
bearing_collar_upper_-1
bearing_collar_upper_+1
motor_mount_upper
motor_envelope_upper
shaft_lower
gecko_lower_1
gecko_lower_2
bearing_collar_lower_-1
bearing_collar_lower_+1
motor_mount_lower
motor_envelope_lower
servo_bracket
servo_envelope
servo_double_horn
link_rod_upper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
