wang15143089/FTC-2026-Bio-buzz/cad/output/parts/shooter_slotted_side_plate.step

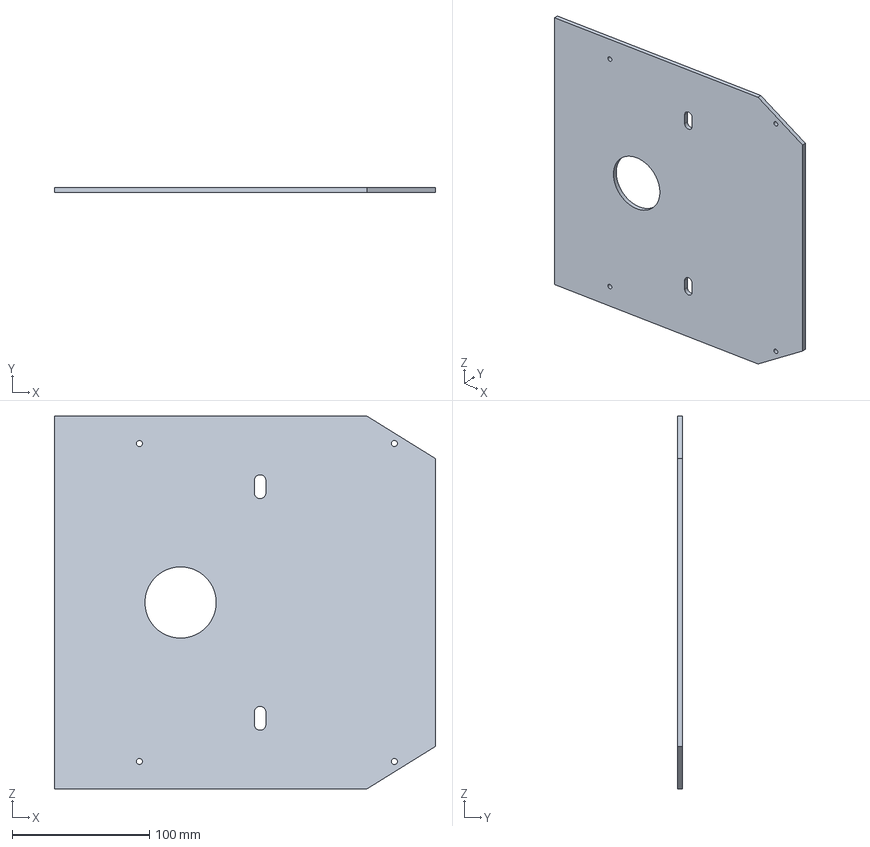
[picture p132: CAD file, 2026-10-02]
cad/output/parts/shooter_slotted_side_plate.step
278.0 x 4.00 x 272.0 mm
