wang15143089/FTC-2026-Bio-buzz/exports/step/t04_c04b1_25deg_paddle_slider_m3.step

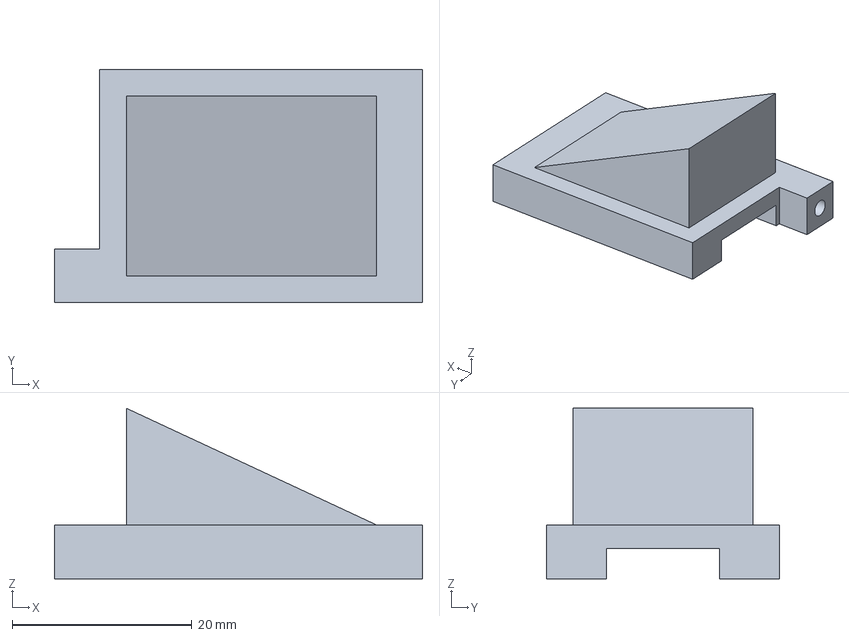
[picture p133: CAD file, 2026-09-20]
exports/step/t04_c04b1_25deg_paddle_slider_m3.step
41.0 x 26.0 x 19.0 mm
