wang15143089/FTC-2026-Bio-buzz/cad/output/_r66_parts/servo_crank.step

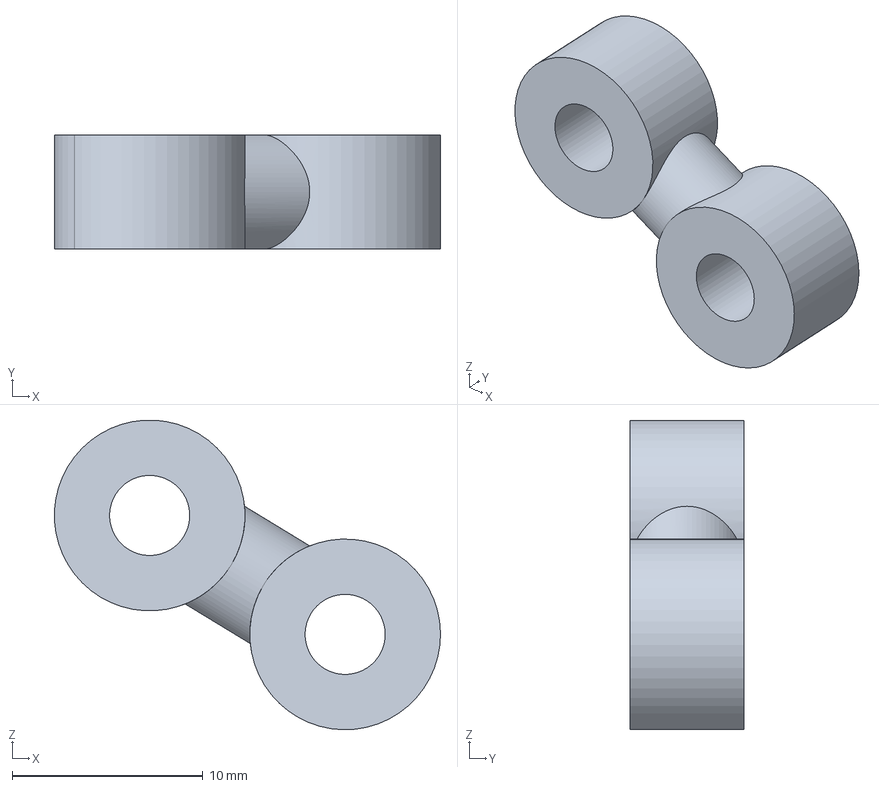
[picture p134: CAD file, 2026-10-16]
cad/output/_r66_parts/servo_crank.step
20.2 x 6.00 x 16.2 mm
