wang15143089/FTC-2026-Bio-buzz/cad/output/_r66_plate/T06_print_plate_R66_pollen_p2.step

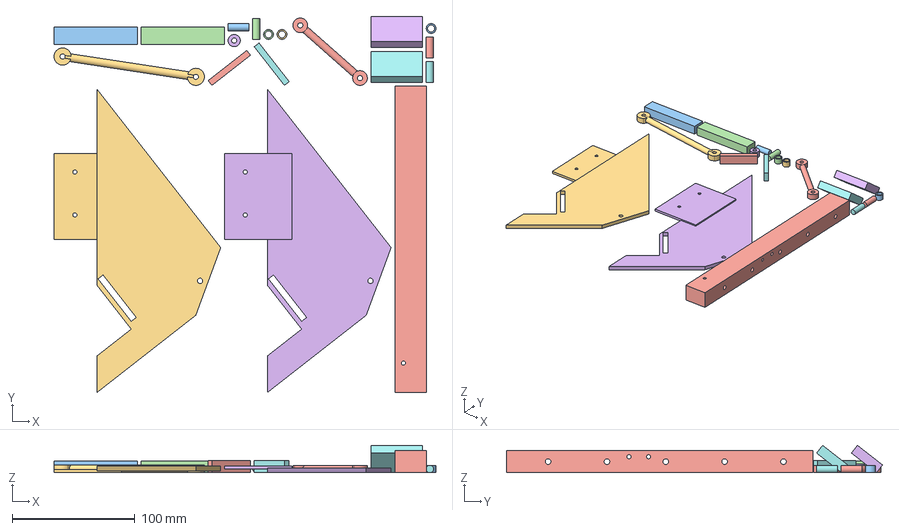
[picture p135: CAD file, 2026-10-16]
cad/output/_r66_plate/T06_print_plate_R66_pollen_p2.step
311.6 x 306.8 x 22.3 mm
base_rail_front_+72
carriage_clamp_seat_lower_+1_+36_+12
carriage_clamp_seat_lower_+1_+36_-12
carriage_clamp_seat_lower_+1_-36_+12
carriage_link_spacer_upper
crosshead_guide_+15
crosshead_guide_-15
frameP_2_front_lower_L4
frameP_2_front_lower_L5
frameP_3_top_L1
frameP_3_top_L2
gap_servo_standoff_-143_+23
gap_servo_standoff_-143_-23
gap_servo_standoff_-97_+23
gap_servo_standoff_-97_-23
main_spacing_link_upper
motor_bridge_lower_+17
motor_bridge_upper_-17
servo_drag_link
