wang15143089/FTC-2026-Bio-buzz/cad/output/paddle_feeder_opposed_flywheel_launcher.step

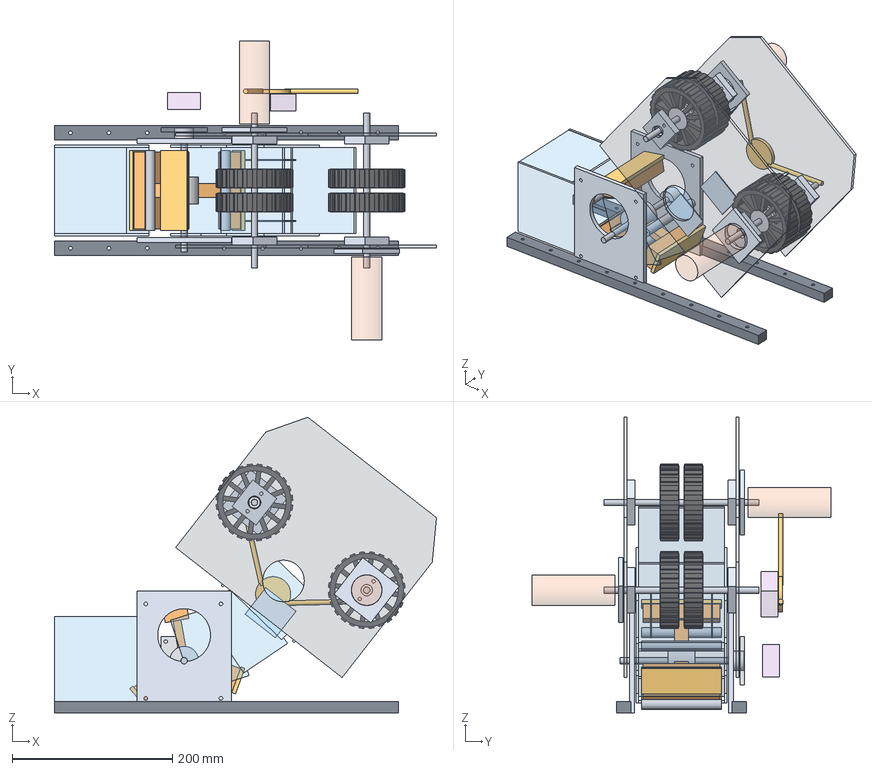
[picture p136: CAD file, 2026-09-24]
cad/output/paddle_feeder_opposed_flywheel_launcher.step
477.3 x 374.0 x 369.3 mm
base_rail_-72
base_rail_+72
horizontal_floor
horizontal_roof
horizontal_wall_-1
horizontal_wall_+1
paddle_support_cheek_-1
paddle_support_cheek_+1
paddle_shaft
paddle_hub
paddle_arm_1
paddle_hinge_1
paddle_blade_1
paddle_flex_tip_1
paddle_arm_2
paddle_hinge_2
paddle_blade_2
paddle_flex_tip_2
paddle_arm_3
paddle_hinge_3
paddle_blade_3
paddle_flex_tip_3
paddle_cr_servo_envelope
paddle_servo_block
paddle_shaft_hub
rising_guide_floor_1
rising_guide_wall_1_-1
rising_guide_wall_1_+1
rising_guide_floor_2
rising_guide_wall_2_-1
rising_guide_wall_2_+1
rising_guide_floor_3
rising_guide_wall_3_-1
rising_guide_wall_3_+1
one_way_finger_-1
one_way_finger_+1
shooter_side_plate_-1
shooter_side_plate_+1
flywheel_shaft_upper
gecko_flywheel_upper_1
sonic_hub_upper_1
gecko_flywheel_upper_2
sonic_hub_upper_2
bearing_block_upper_-1
bearing_block_upper_+1
motor_mount_upper
motor_envelope_upper
flywheel_shaft_lower
gecko_flywheel_lower_1
sonic_hub_lower_1
gecko_flywheel_lower_2
sonic_hub_lower_2
bearing_block_lower_-1
bearing_block_lower_+1
motor_mount_lower
motor_envelope_lower
gap_servo_envelope
gap_double_horn
gap_link_upper
gap_link_lower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
