wang15143089/FTC-2026-Bio-buzz/cad/output/parts/sonic_8mm_gecko_hub.step

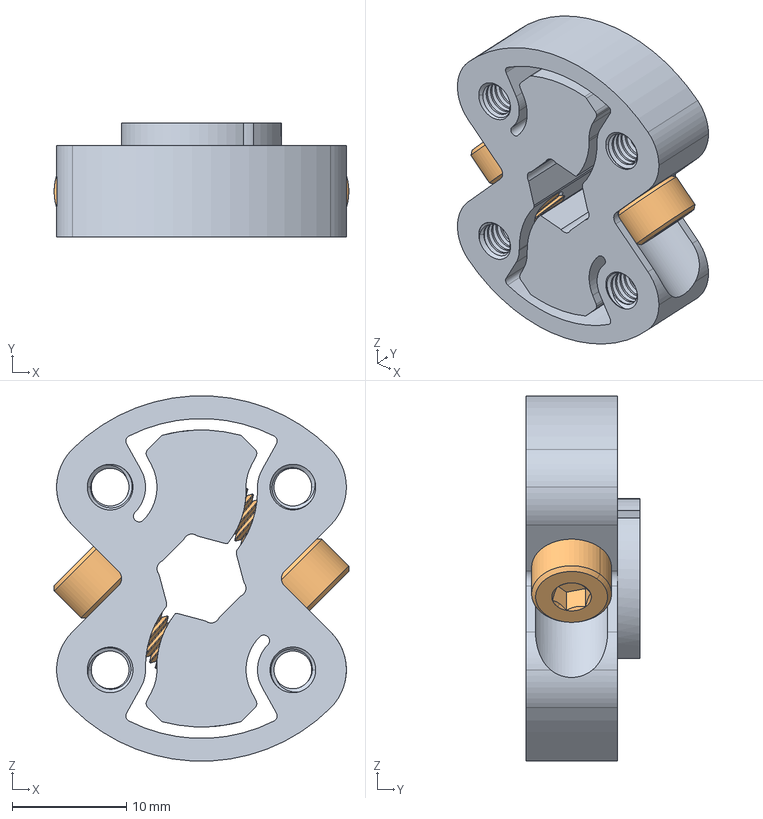
[picture p137: CAD file, 2026-10-02]
cad/output/parts/sonic_8mm_gecko_hub.step
25.8 x 10.0 x 32.0 mm
