wang15143089/FTC-2026-Bio-buzz/cad/output/_r66_parts/motor_bridge_lower_+17.step

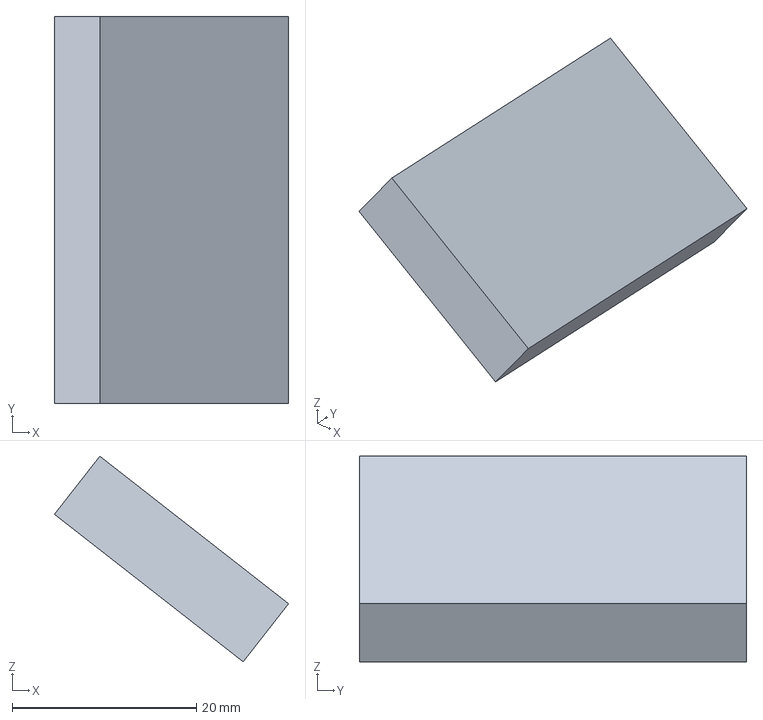
[picture p138: CAD file, 2026-10-16]
cad/output/_r66_parts/motor_bridge_lower_+17.step
25.4 x 42.0 x 22.3 mm
