wang15143089/FTC-2026-Bio-buzz/cad/output/_r66_plate/T06_print_plate_R66_pollen_p3.step

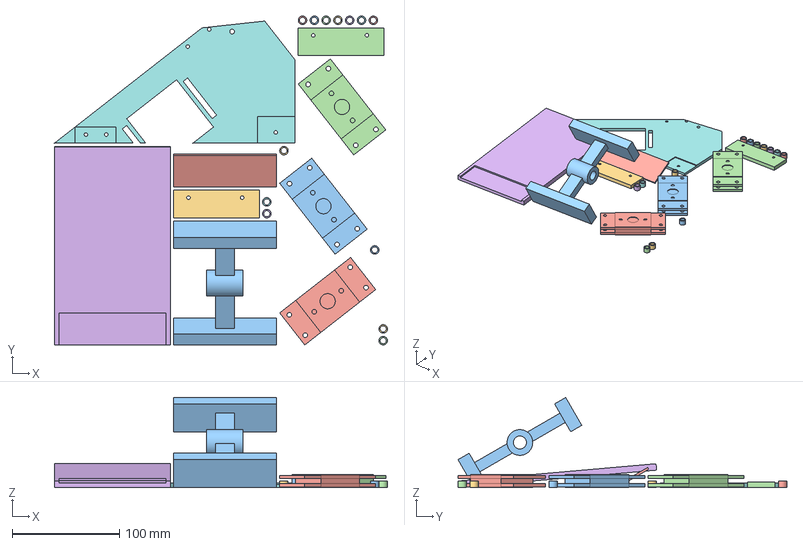
[picture p139: CAD file, 2026-10-16]
cad/output/_r66_plate/T06_print_plate_R66_pollen_p3.step
310.6 x 306.8 x 84.0 mm
bearing_carriage_lower_+1
bearing_carriage_lower_-1
bearing_carriage_upper_+1
carriage_clamp_seat_lower_+1_-36_-12
carriage_clamp_seat_lower_-1_+36_+12
carriage_clamp_seat_lower_-1_+36_-12
carriage_clamp_seat_lower_-1_-36_+12
carriage_clamp_seat_lower_-1_-36_-12
carriage_clamp_seat_upper_+1_+36_+12
carriage_clamp_seat_upper_+1_+36_-12
carriage_clamp_seat_upper_+1_-36_+12
carriage_clamp_seat_upper_+1_-36_-12
carriage_clamp_seat_upper_-1_+36_+12
carriage_clamp_seat_upper_-1_+36_-12
carriage_clamp_seat_upper_-1_-36_+12
carriage_clamp_seat_upper_-1_-36_-12
frameP_2_front_lower_L1
frameP_2_front_lower_L2
paddle_flex_tip_2
paddle_rotor
rail_splice_plate_+72
rail_splice_plate_-72
