wang15143089/FTC-2026-Bio-buzz/cad/output/parts/feeder_support_cheek_reference.step

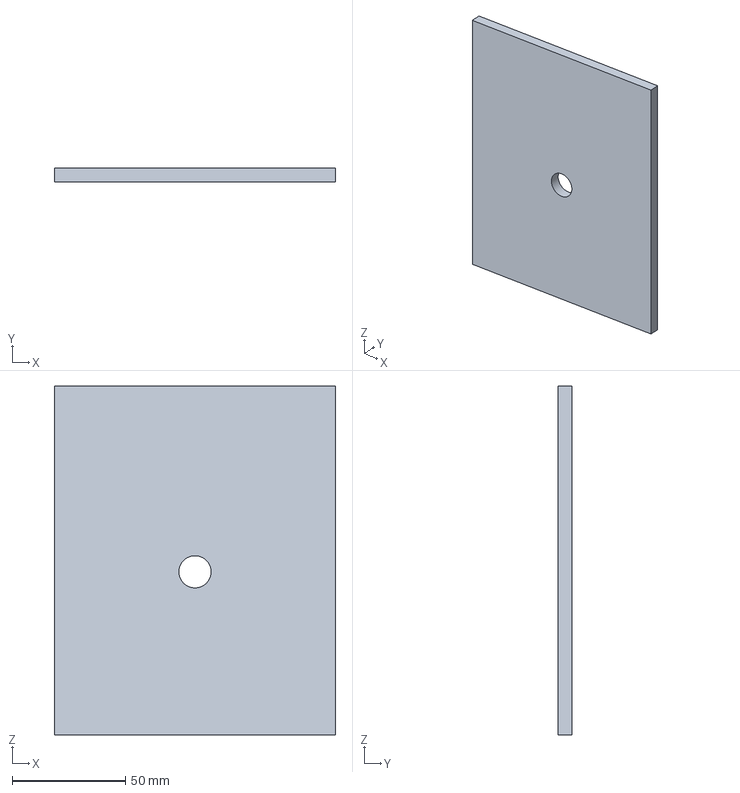
[picture p140: CAD file, 2026-10-02]
cad/output/parts/feeder_support_cheek_reference.step
124.0 x 6.00 x 154.0 mm
