wang15143089/FTC-2026-Bio-buzz/cad/output/_r66_parts/carriage_link_spacer_lower.step

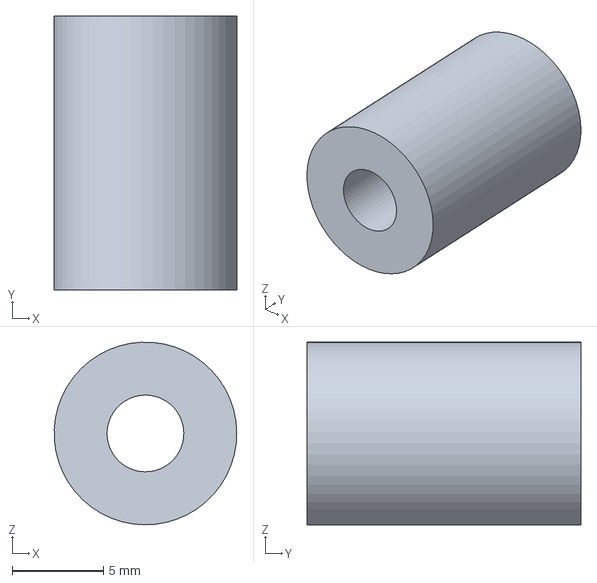
[picture p141: CAD file, 2026-10-16]
cad/output/_r66_parts/carriage_link_spacer_lower.step
9.99 x 15.0 x 9.99 mm
