wang15143089/FTC-2026-Bio-buzz/cad/output/_r66_plate/T06_print_plate_R66_pollen_p1.step

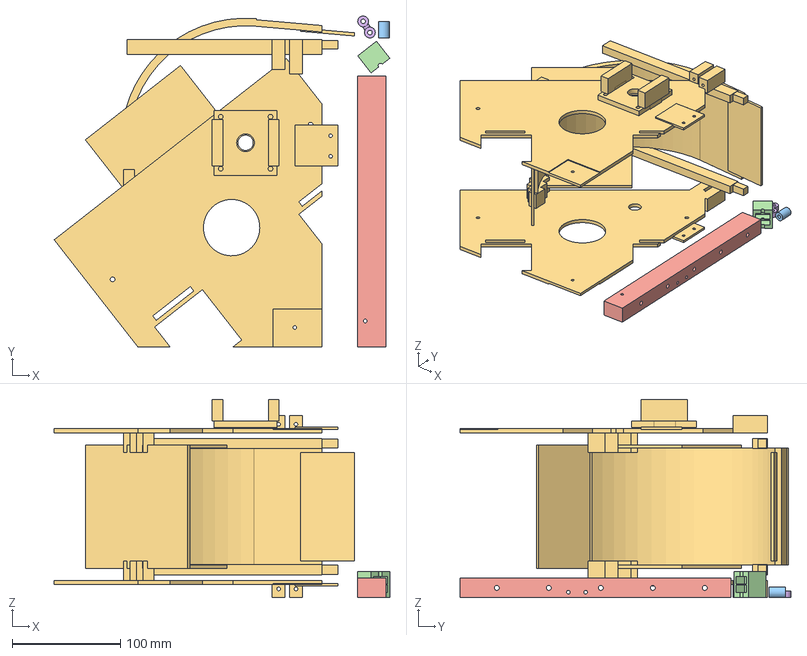
[picture p142: CAD file, 2026-10-16]
cad/output/_r66_plate/T06_print_plate_R66_pollen_p1.step
309.9 x 305.6 x 183.0 mm
base_rail_front_-72
carriage_link_spacer_lower
crosshead
frameP_1_rear_lower
servo_crank
