wang15143089/FTC-2026-Bio-buzz/cad/output/parts/gobilda_1401_0043_0036_mount_proxy.step

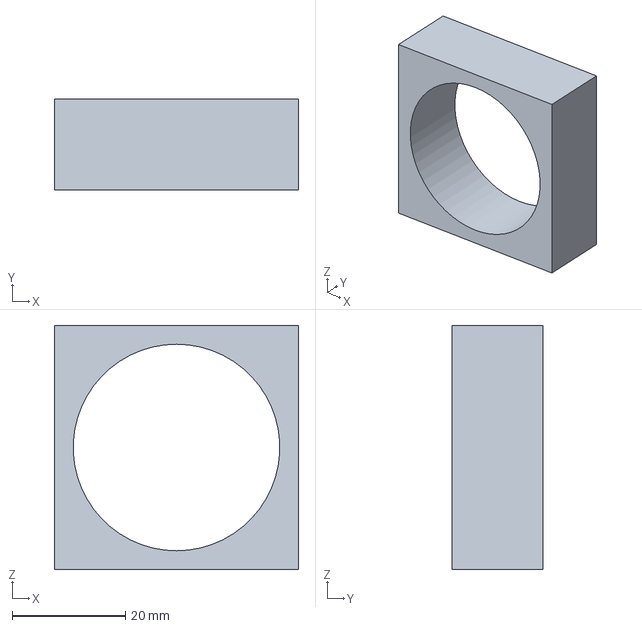
[picture p143: CAD file, 2026-09-29]
cad/output/parts/gobilda_1401_0043_0036_mount_proxy.step
43.0 x 16.0 x 43.0 mm
