wang15143089/FTC-2026-Bio-buzz/cad/output/_r66_parts/frameP_3_top_L1.step

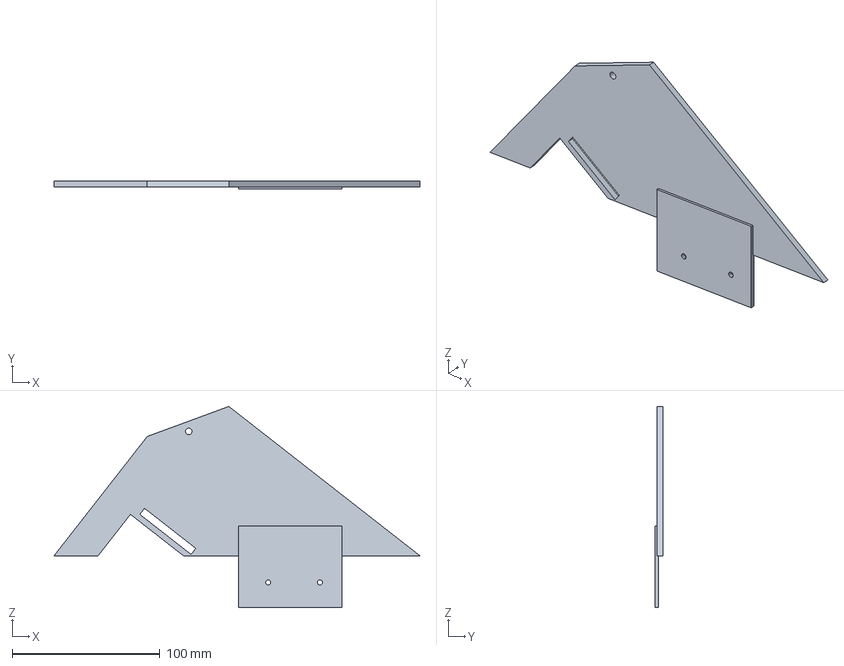
[picture p144: CAD file, 2026-10-16]
cad/output/_r66_parts/frameP_3_top_L1.step
247.6 x 5.50 x 136.0 mm
