wang15143089/FTC-2026-Bio-buzz/cad/output/biobuzz_launcher_pollen.step

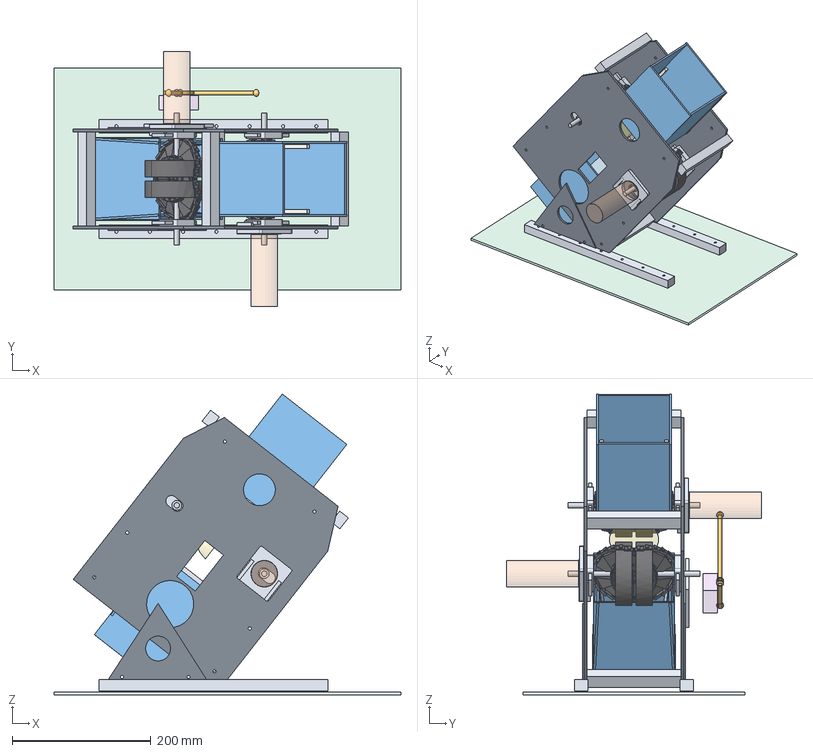
[picture p145: CAD file, 2026-09-24]
cad/output/biobuzz_launcher_pollen.step
500.0 x 368.0 x 433.7 mm
00_chassis_xy_reference
base_rail_-1
angle_gusset_-1
base_rail_+1
angle_gusset_+1
main_side_plate_-1
main_side_plate_+1
crossmember_-162_-118
crossmember_-162_118
crossmember_128_-118
crossmember_128_118
slide_rail_-1_-1
carriage_-1_-1
slide_rail_-1_+1
carriage_-1_+1
slide_rail_+1_-1
carriage_+1_-1
slide_rail_+1_+1
carriage_+1_+1
shaft_upper
gecko_upper_1
gecko_upper_2
bearing_collar_upper_-1
bearing_collar_upper_+1
motor_mount_upper
motor_envelope_upper
shaft_lower
gecko_lower_1
gecko_lower_2
bearing_collar_lower_-1
bearing_collar_lower_+1
motor_mount_lower
motor_envelope_lower
servo_bracket
servo_envelope
servo_double_horn
link_rod_upper
link_ball_upper_servo
link_ball_upper_carriage
link_rod_lower
link_ball_lower_servo
link_ball_lower_carriage
input_sidewall_-1
input_sidewall_+1
input_floor
input_roof
centering_leaf_-1
centering_leaf_+1
output_floor
output_roof
output_sidewall_-1
output_sidewall_+1
wear_strip_-50_-47
wear_strip_-50_47
wear_strip_50_-47
wear_strip_50_47
pollen_reference_ball
