wang15143089/FTC-2026-Bio-buzz/cad/output/_r66_parts/carriage_clamp_seat_upper_+1_+36_+12.step

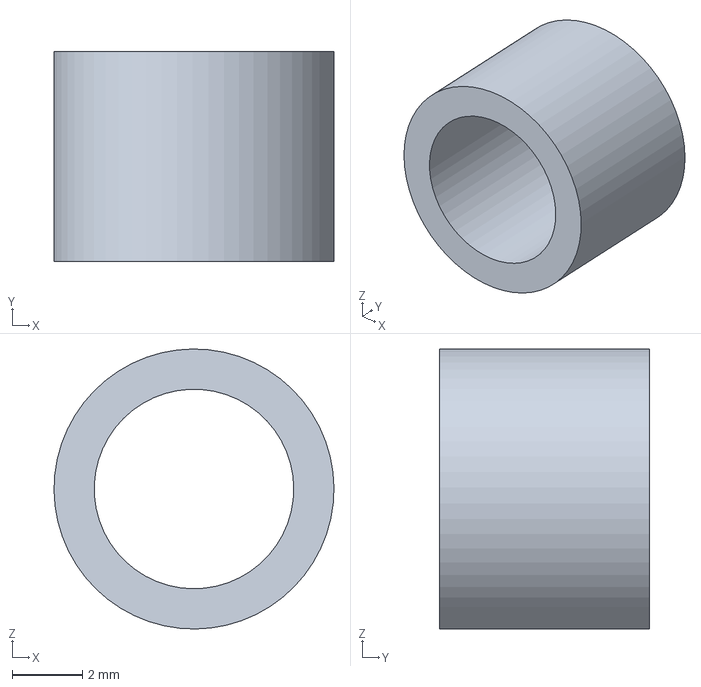
[picture p146: CAD file, 2026-10-16]
cad/output/_r66_parts/carriage_clamp_seat_upper_+1_+36_+12.step
8.00 x 6.00 x 8.00 mm
