wang15143089/FTC-2026-Bio-buzz/cad/output/_r66_parts/servo_drag_link.step

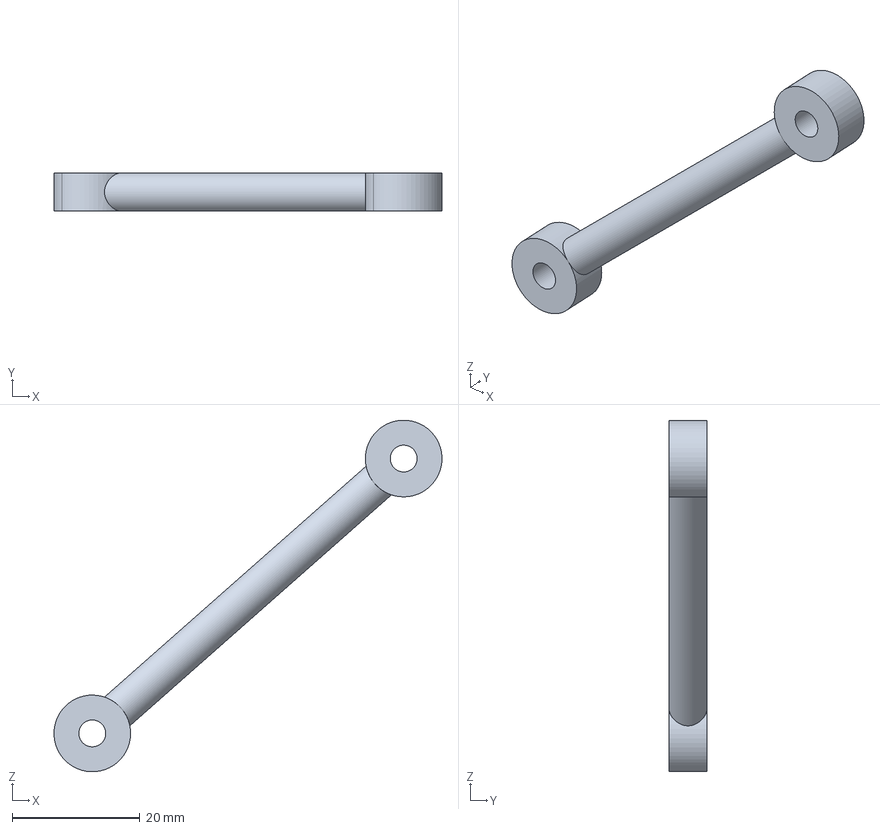
[picture p147: CAD file, 2026-10-16]
cad/output/_r66_parts/servo_drag_link.step
60.7 x 6.00 x 55.0 mm
