wang15143089/FTC-2026-Bio-buzz/cad/output/_r60b_parts/base_rail_+72.step

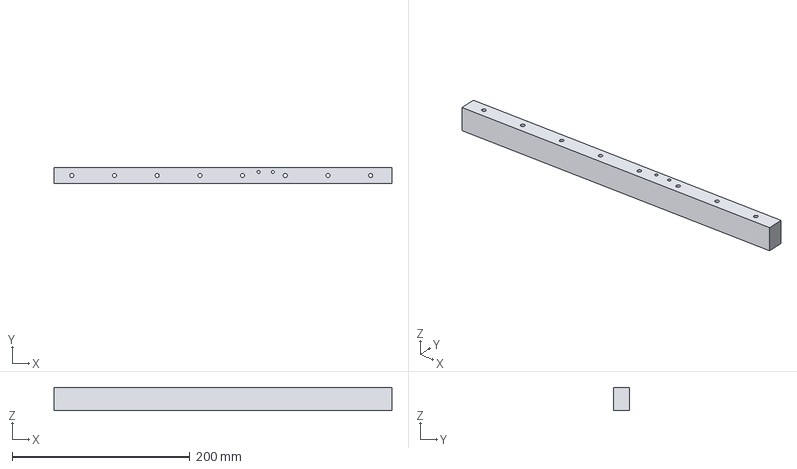
[picture p148: CAD file, 2026-10-16]
cad/output/_r60b_parts/base_rail_+72.step
380.0 x 18.0 x 26.0 mm
