wang15143089/FTC-2026-Bio-buzz/cad/output/_r66_parts/paddle_flex_tip_2.step

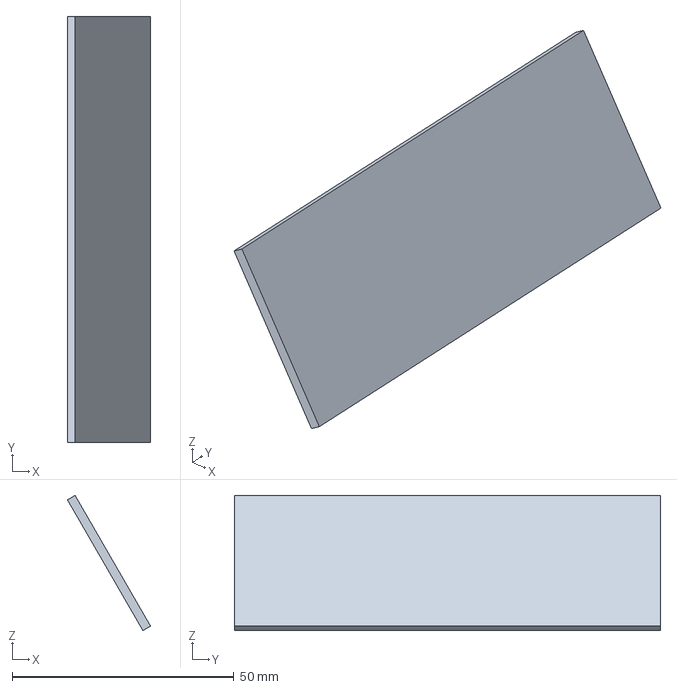
[picture p149: CAD file, 2026-10-16]
cad/output/_r66_parts/paddle_flex_tip_2.step
18.7 x 96.0 x 30.4 mm
