wang15143089/FTC-2026-Bio-buzz/cad/output/_r66_parts/crosshead_guide_+15.step

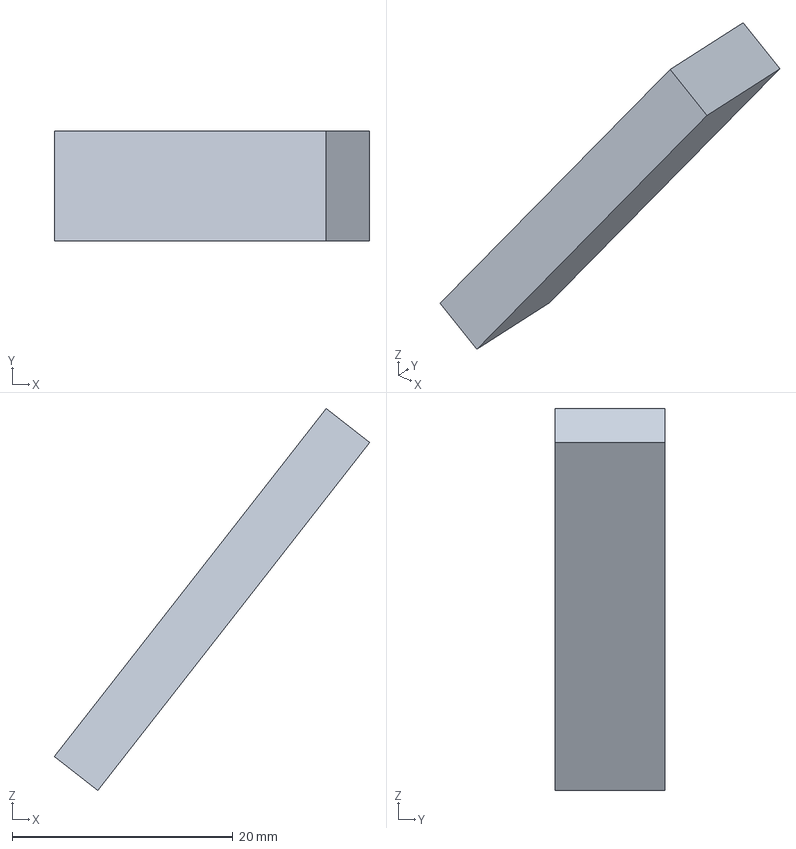
[picture p150: CAD file, 2026-10-16]
cad/output/_r66_parts/crosshead_guide_+15.step
28.6 x 10.0 x 34.6 mm
