wang15143089/FTC-2026-Bio-buzz/cad/output/_r66_parts/rail_splice_plate_+72.step

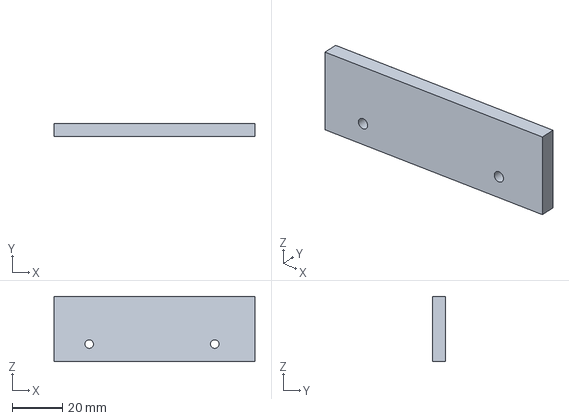
[picture p151: CAD file, 2026-10-16]
cad/output/_r66_parts/rail_splice_plate_+72.step
80.0 x 5.00 x 26.0 mm
