wang15143089/FTC-2026-Bio-buzz/cad/output/_r66_parts/base_rail_front_+72.step

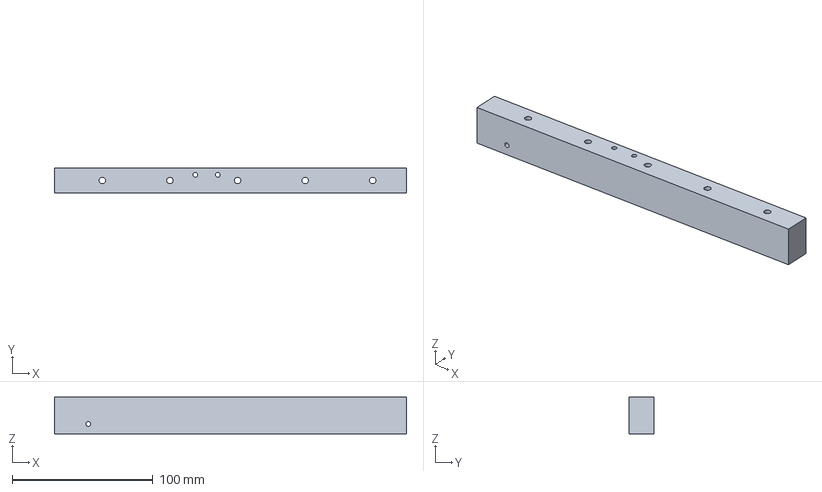
[picture p152: CAD file, 2026-10-16]
cad/output/_r66_parts/base_rail_front_+72.step
250.0 x 18.0 x 26.0 mm
