wang15143089/FTC-2026-Bio-buzz/cad/output/_r66_parts/frameP_2_front_lower_L5.step

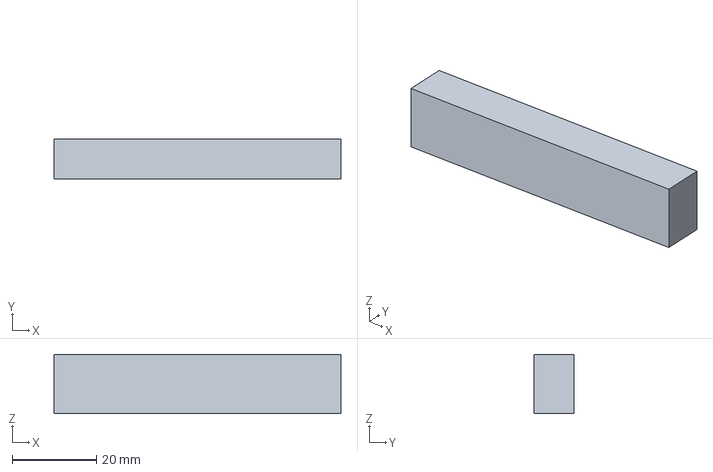
[picture p153: CAD file, 2026-10-16]
cad/output/_r66_parts/frameP_2_front_lower_L5.step
68.0 x 9.50 x 14.0 mm
