wang15143089/FTC-2026-Bio-buzz/cad/output/_r66_parts/bearing_carriage_lower_+1.step

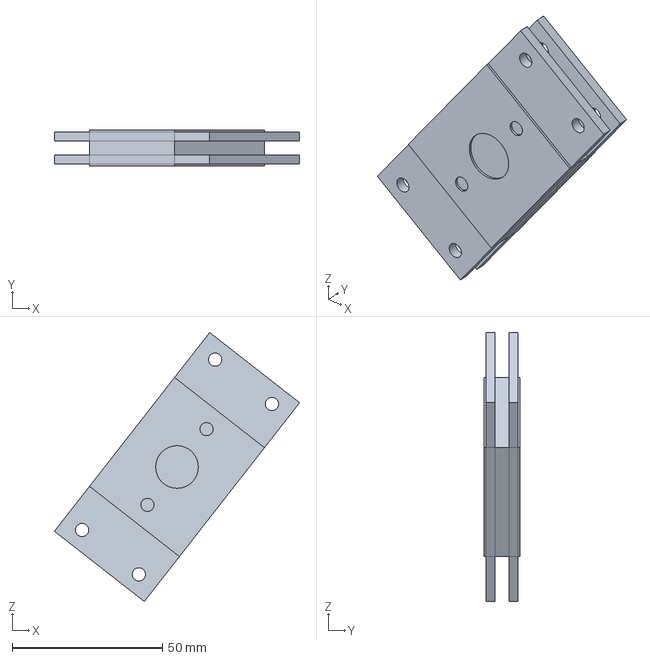
[picture p154: CAD file, 2026-10-16]
cad/output/_r66_parts/bearing_carriage_lower_+1.step
81.7 x 12.0 x 89.6 mm
