wang15143089/FTC-2026-Bio-buzz/cad/output/_r66_parts/carriage_link_spacer_upper.step

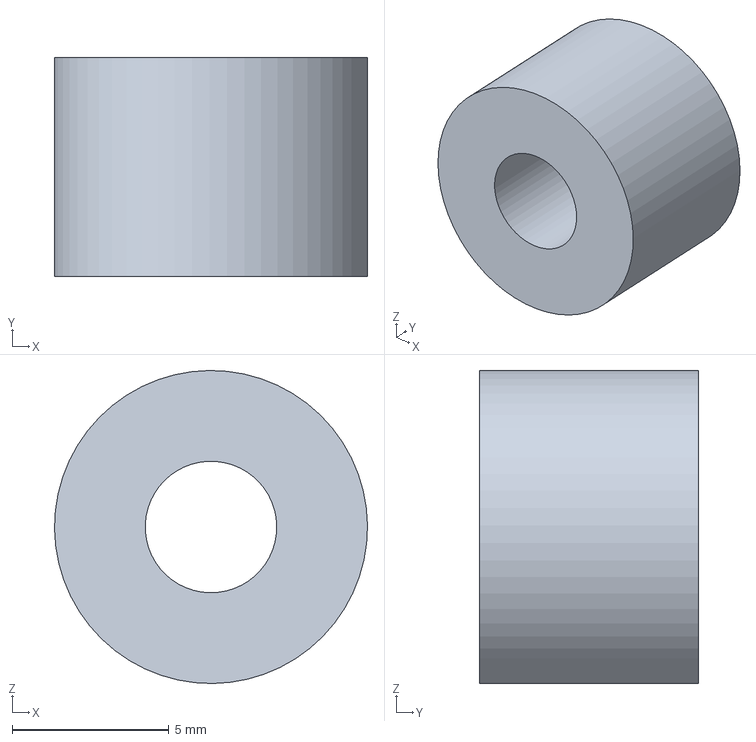
[picture p155: CAD file, 2026-10-16]
cad/output/_r66_parts/carriage_link_spacer_upper.step
10.00 x 7.00 x 10.00 mm
