wang15143089/FTC-2026-Bio-buzz/cad/output/_r66_parts/crosshead.step

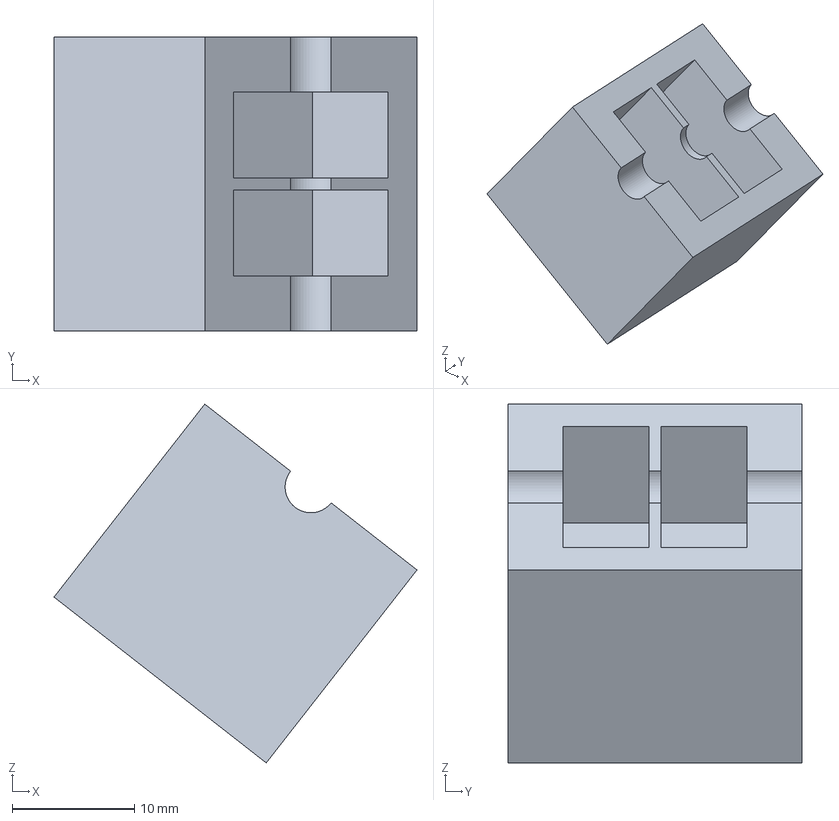
[picture p156: CAD file, 2026-10-16]
cad/output/_r66_parts/crosshead.step
29.6 x 24.0 x 29.3 mm
