wang15143089/FTC-2026-Bio-buzz/cad/output/_r66_parts/frameP_2_front_lower_L1.step

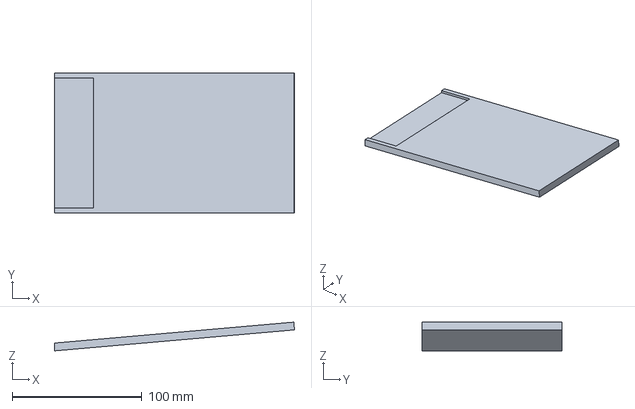
[picture p157: CAD file, 2026-10-16]
cad/output/_r66_parts/frameP_2_front_lower_L1.step
185.3 x 108.0 x 22.2 mm
