wang15143089/FTC-2026-Bio-buzz/cad/output/_r66_parts/paddle_rotor.step

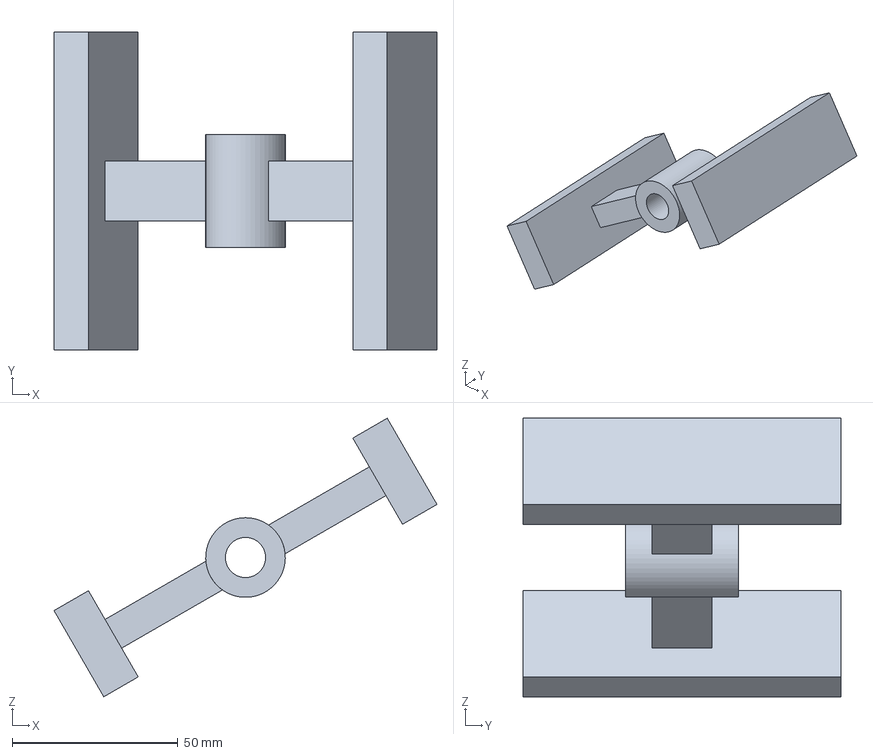
[picture p158: CAD file, 2026-10-16]
cad/output/_r66_parts/paddle_rotor.step
115.5 x 96.0 x 84.0 mm
