wang15143089/FTC-2026-Bio-buzz/cad/output/_r66_parts/base_rail_rear_joined.step

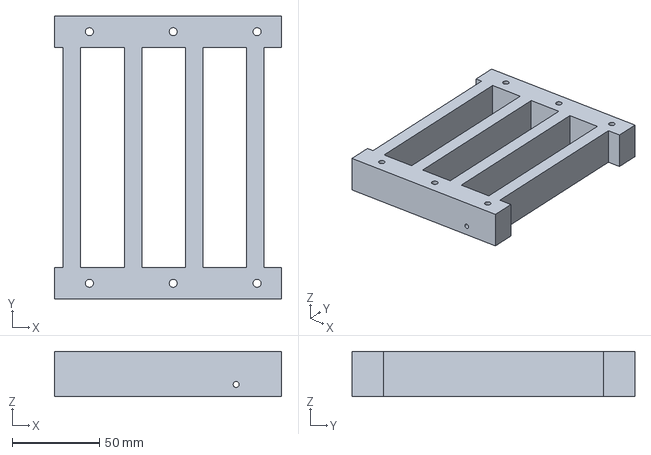
[picture p159: CAD file, 2026-10-16]
cad/output/_r66_parts/base_rail_rear_joined.step
130.0 x 162.0 x 26.0 mm
