wang15143089/FTC-2026-Bio-buzz/(list of files, cad)

Other CAD files:
cad/output/_r62_frame/T06_shooter_assembly_R62_pollen.step
exports/step/t04_c04b1_fusion360_assembly_m3.step
cad/output/_r60_frame/T06_shooter_frame_R60_pollen.step
cad/output/_r61_frame/T06_shooter_frame_R61_pollen.step
cad/output/_r62_frame/T06_shooter_frame_R62_pollen.step
cad/output/_r39_liner/_probe_nectar.stl
cad/output/_r61_frame/T06_base_rail_R61_pollen.step
cad/output/_r62_frame/T06_print_set_R62_pollen.step
cad/output/_r39_liner/feeder_shell_tray_liner_pollen.step
cad/output/_r66_parts/gap_servo_standoff_-97_+23.step
cad/output/inspection/_r26_shared_paddle_hub.step
cad/output/_r39_liner/feeder_shell_tray_liner_nectar.step
cad/output/inspection/_r25_nectar_feeder_shell_tray.step
cad/output/biobuzz_launcher_horizontal_feed_nectar.step
cad/output/inspection/_r25_nectar_paddle_hub.step
cad/output/paddle_launcher_constrained_pollen.step
cad/output/biobuzz_launcher_nectar.step
cad/output/_r60b_parts/shooter_frame_R60_merged.step
cad/output/_r66_parts/frameP_2_front_lower_L3.step
cad/output/_r62b_parts/shooter_frame_R62_merged.step
cad/output/_r66_parts/motor_bridge_upper_+17.step
cad/output/_r66_parts/frameP_3_top_L2.step
cad/output/_r66_parts/paddle_flex_tip_1.step
cad/output/_r66_parts/crosshead_guide_stop_-42.step
cad/output/_r66_parts/bearing_carriage_upper_+1.step
cad/output/_r66_parts/frameP_2_front_lower_L4.step
cad/output/_r66_parts/carriage_clamp_seat_lower_+1_+36_+12.step
cad/output/_r39_liner/feeder_shell_tray_liner_pollen.stl
cad/output/_r60b_parts/base_rail_-72.step
cad/output/_r60b_parts/bearing_carriage_lower_+1.step
cad/output/_r60b_parts/bearing_carriage_lower_-1.step
cad/output/_r60b_parts/bearing_carriage_upper_+1.step
cad/output/_r60b_parts/bearing_carriage_upper_-1.step
cad/output/_r60b_parts/carriage_clamp_seat_lower_+1_+36_+12.step
cad/output/_r60b_parts/carriage_clamp_seat_lower_+1_+36_-12.step
cad/output/_r60b_parts/carriage_clamp_seat_lower_+1_-36_+12.step
cad/output/_r60b_parts/carriage_clamp_seat_lower_+1_-36_-12.step
cad/output/_r60b_parts/carriage_clamp_seat_lower_-1_+36_+12.step
cad/output/_r60b_parts/carriage_clamp_seat_lower_-1_+36_-12.step
cad/output/_r60b_parts/carriage_clamp_seat_lower_-1_-36_+12.step
cad/output/_r60b_parts/carriage_clamp_seat_lower_-1_-36_-12.step
cad/output/_r60b_parts/carriage_clamp_seat_upper_+1_+36_+12.step
cad/output/_r60b_parts/carriage_clamp_seat_upper_+1_+36_-12.step
cad/output/_r60b_parts/carriage_clamp_seat_upper_+1_-36_+12.step
cad/output/_r60b_parts/carriage_clamp_seat_upper_+1_-36_-12.step
cad/output/_r60b_parts/carriage_clamp_seat_upper_-1_+36_+12.step
cad/output/_r60b_parts/carriage_clamp_seat_upper_-1_+36_-12.step
cad/output/_r60b_parts/carriage_clamp_seat_upper_-1_-36_+12.step
cad/output/_r60b_parts/carriage_clamp_seat_upper_-1_-36_-12.step
cad/output/_r60b_parts/carriage_link_spacer_lower.step
cad/output/_r60b_parts/carriage_link_spacer_upper.step
cad/output/_r60b_parts/crosshead.step
cad/output/_r60b_parts/crosshead_guide_+15.step
cad/output/_r60b_parts/crosshead_guide_-15.step
cad/output/_r60b_parts/crosshead_guide_stop_-42.step
cad/output/_r60b_parts/crosshead_guide_stop_-82.step
cad/output/_r60b_parts/gap_servo_standoff_-143_+23.step
cad/output/_r60b_parts/gap_servo_standoff_-143_-23.step
cad/output/_r60b_parts/gap_servo_standoff_-97_+23.step
cad/output/_r60b_parts/gap_servo_standoff_-97_-23.step
cad/output/_r60b_parts/main_spacing_link_lower.step
cad/output/_r60b_parts/main_spacing_link_upper.step
cad/output/_r60b_parts/motor_bridge_lower_+17.step
cad/output/_r60b_parts/motor_bridge_lower_-17.step
cad/output/_r60b_parts/motor_bridge_upper_+17.step
cad/output/_r60b_parts/motor_bridge_upper_-17.step
cad/output/_r60b_parts/paddle_flex_tip_1.step
cad/output/_r60b_parts/paddle_flex_tip_2.step
cad/output/_r60b_parts/paddle_rotor.step
cad/output/_r60b_parts/servo_crank.step
cad/output/_r60b_parts/servo_drag_link.step
cad/output/_r62b_parts/base_rail_front_+72.step
cad/output/_r62b_parts/base_rail_front_-72.step
cad/output/_r62b_parts/base_rail_rear_joined.step
cad/output/_r62b_parts/bearing_carriage_lower_+1.step
cad/output/_r62b_parts/bearing_carriage_lower_-1.step
cad/output/_r62b_parts/bearing_carriage_upper_+1.step
cad/output/_r62b_parts/bearing_carriage_upper_-1.step
cad/output/_r62b_parts/carriage_clamp_seat_lower_+1_+36_+12.step
cad/output/_r62b_parts/carriage_clamp_seat_lower_+1_+36_-12.step
cad/output/_r62b_parts/carriage_clamp_seat_lower_+1_-36_+12.step
cad/output/_r62b_parts/carriage_clamp_seat_lower_+1_-36_-12.step
cad/output/_r62b_parts/carriage_clamp_seat_lower_-1_+36_+12.step
cad/output/_r62b_parts/carriage_clamp_seat_lower_-1_+36_-12.step
cad/output/_r62b_parts/carriage_clamp_seat_lower_-1_-36_+12.step
cad/output/_r62b_parts/carriage_clamp_seat_lower_-1_-36_-12.step
cad/output/_r62b_parts/carriage_clamp_seat_upper_+1_+36_+12.step
cad/output/_r62b_parts/carriage_clamp_seat_upper_+1_+36_-12.step
cad/output/_r62b_parts/carriage_clamp_seat_upper_+1_-36_+12.step
cad/output/_r62b_parts/carriage_clamp_seat_upper_+1_-36_-12.step
cad/output/_r62b_parts/carriage_clamp_seat_upper_-1_+36_+12.step
cad/output/_r62b_parts/carriage_clamp_seat_upper_-1_+36_-12.step
cad/output/_r62b_parts/carriage_clamp_seat_upper_-1_-36_+12.step
cad/output/_r62b_parts/carriage_clamp_seat_upper_-1_-36_-12.step
cad/output/_r62b_parts/carriage_link_spacer_lower.step
cad/output/_r62b_parts/carriage_link_spacer_upper.step
cad/output/_r62b_parts/crosshead.step
cad/output/_r62b_parts/crosshead_guide_+15.step
cad/output/_r62b_parts/crosshead_guide_-15.step
cad/output/_r62b_parts/crosshead_guide_stop_-42.step
cad/output/_r62b_parts/crosshead_guide_stop_-82.step
cad/output/_r62b_parts/gap_servo_standoff_-143_+23.step
cad/output/_r62b_parts/gap_servo_standoff_-143_-23.step
cad/output/_r62b_parts/gap_servo_standoff_-97_+23.step
cad/output/_r62b_parts/gap_servo_standoff_-97_-23.step
cad/output/_r62b_parts/main_spacing_link_lower.step
cad/output/_r62b_parts/main_spacing_link_upper.step
cad/output/_r62b_parts/motor_bridge_lower_+17.step
cad/output/_r62b_parts/motor_bridge_lower_-17.step
cad/output/_r62b_parts/motor_bridge_upper_+17.step
cad/output/_r62b_parts/motor_bridge_upper_-17.step
cad/output/_r62b_parts/paddle_flex_tip_1.step
cad/output/_r62b_parts/paddle_flex_tip_2.step
cad/output/_r62b_parts/paddle_rotor.step
cad/output/_r62b_parts/servo_crank.step
cad/output/_r62b_parts/servo_drag_link.step
cad/output/_r65_splice/parts/base_rail_front_+72.step
cad/output/_r65_splice/parts/base_rail_front_-72.step
cad/output/_r65_splice/parts/base_rail_rear_joined.step
cad/output/_r65_splice/parts/rail_splice_plate_+72.step
cad/output/_r65_splice/parts/rail_splice_plate_-72.step
cad/output/_r66_parts/base_rail_front_-72.step
cad/output/_r66_parts/bearing_carriage_lower_-1.step
cad/output/_r66_parts/bearing_carriage_upper_-1.step
cad/output/_r66_parts/carriage_clamp_seat_lower_+1_+36_-12.step
cad/output/_r66_parts/carriage_clamp_seat_lower_+1_-36_+12.step
cad/output/_r66_parts/carriage_clamp_seat_lower_+1_-36_-12.step
cad/output/_r66_parts/carriage_clamp_seat_lower_-1_+36_+12.step
cad/output/_r66_parts/carriage_clamp_seat_lower_-1_+36_-12.step
cad/output/_r66_parts/carriage_clamp_seat_lower_-1_-36_+12.step
cad/output/_r66_parts/carriage_clamp_seat_lower_-1_-36_-12.step
cad/output/_r66_parts/carriage_clamp_seat_upper_+1_+36_-12.step
cad/output/_r66_parts/carriage_clamp_seat_upper_+1_-36_+12.step
cad/output/_r66_parts/carriage_clamp_seat_upper_+1_-36_-12.step
cad/output/_r66_parts/carriage_clamp_seat_upper_-1_+36_+12.step
cad/output/_r66_parts/carriage_clamp_seat_upper_-1_+36_-12.step
cad/output/_r66_parts/carriage_clamp_seat_upper_-1_-36_+12.step
cad/output/_r66_parts/carriage_clamp_seat_upper_-1_-36_-12.step
cad/output/_r66_parts/crosshead_guide_-15.step
cad/output/_r66_parts/gap_servo_standoff_-143_-23.step
cad/output/_r66_parts/gap_servo_standoff_-97_-23.step
cad/output/_r66_parts/motor_bridge_lower_-17.step
cad/output/_r66_parts/motor_bridge_upper_-17.step
cad/output/_r66_parts/rail_splice_plate_-72.step
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
