wang15143089/FTC-2026-Bio-buzz/docs/manufacturing_notes.md

# 制造说明

## T04-C04B1-M3-0.3 验证件（非制造发布）

- `KNOWN` 三个打印件为官方4孔位舵机/导轨支架、17 mm节圆半径卷线鼓、25°楔形拨杆滑块；STEP/STL由同一CadQuery脚本生成。Fusion 360装配另包含官方舵机和铝舵盘实体。
- Fusion 360使用`exports/step/t04_c04b1_fusion360_assembly_m3.step`；单位为mm，导入后应出现5个命名组件。STEP只保存固定装配位置，不包含Fusion原生Joint、运动限制或参数时间线。
- `ASSUMED` 模块级单边打印间隙为0.30 mm，仅为首件起点；未指定材料、喷嘴、层高或收缩补偿，打印前应做局部间隙试片。
- 支架建议大底面朝下；卷线鼓法兰朝下；滑块方向由实际材料的桥接能力决定，底部12.6 mm导槽可使用可移除支撑。以上是起始建议，不是已验证工艺。
- 卷线鼓不得直接打印25T花键；必须使用REV-41-1828铝舵盘。中心孔仅用于接近原厂中心螺钉，任何进入舵机输出轴的M3螺钉不得超过官方6 mm深度。
- 使用约1 mm低伸长绳、全行程回位载荷不超过1.5 N、独立60 mm机械止挡。首轮测试加护目/夹点防护，并把指令时间限制在0.25–0.40 s。
- `TBD` 螺钉长度、打印材料、绳结/端接、回位弹性体、护罩和机器人安装接口；它们必须由实物尺寸与VAL-T04-006确定。

当前状态：用户明确“不对制造设备做要求”。因此不把任何特定设备作为硬约束；每个候选方案必须列出所需工艺、精度、外包依赖和替代工艺，之后再比较可实现性。

## 已知规则

- 名义尺寸与制造公差/配合分离管理。
- M3 前不加入非必要圆角、外观细节、螺纹或高细节紧固件。
- M8 发布必须包含版本化 CAD、必要图纸、BOM、材料/工艺、关键检验尺寸和装配顺序。
- 商业件早期使用轻量代理；最终以核验的供应商图纸和零件号为准。

## 待确认

- 3D 打印机成形范围、材料、喷嘴/层高和实测精度。
- CNC、车铣、激光/水刀、折弯和手工设备能力。
- 可采购材料规格、紧固件系列和交期。
- 团队可稳定检验的尺寸与量具能力。
## T06 锁紧件装配与验收（R53f / R53h）

- 适用对象: 换档夹紧链上的 16 件刚性定长限位环 `Ø8.0 / Ø5.7 x 6.0`（每档 16 件，套在弹簧**外面**），以及 M4 螺柱 + 尼龙锁紧螺母。
- 装配顺序（每条螺柱相同）: 螺柱 -> 内耳片 -> 侧板 -> 外耳片 -> 弹簧 -> **限位环（Ø8.0/Ø5.7 x 6.0）** -> 平垫 -> 尼龙锁紧螺母，**拧到螺母/平垫与限位环端面贴合即停**。
- 装配要点:
  - 拧到贴合即到底，**继续拧只压环、预载不再增长**（预载只由环长决定，不由力矩决定）。
  - 力矩上限 **1.0 N.m**；配尼龙锁紧螺母 + 螺纹胶 243 防松。禁止把限位环做长到超过弹簧自由长 8.4 mm 后再强拧。
  - 弹簧 k = 1.24 N/mm、自由长 8.4 mm、装配长 6.0 mm => 预载 **2.976 N/颗**（±0.2 mm 环长 => ±0.25 N）。
- 验收判据（台架）:
  - 预载 **2.976 ± 0.25 N/颗**（可用弹簧秤/压电片抽检）。
  - 两档夹口: pollen **64.0 mm** / nectar **86.0 mm**，偏差 **±0.5 mm**。
  - 台架 50 次来回后无衰减（预载、夹口仍在公差内）、限位环压缩永久变形 <= 0.1 mm。
  - 全程**无一次需要人工介入**结构（换档由已有 2000-0025-0002 完成）。
- 口径提醒（防误读）: 夹紧件单独保持力仅 **14.3 N/滑座**（mu = 0.30 名义），**挡不住发射反力峰值 37.5 / 81.3 N/滑座**；发射时守住夹口靠的是**通电的 25-2**（余量 3.0x / 4.8x）。详见 `docs/decision_log.md` V-0057。
- 状态: 几何 `pass`；装配与台架 `not_run`。
### 弹簧采购包络（R53h-2，V-0058）

- 规格: 压缩弹簧，安装长 6.0 mm；**外径 <= 5.6 mm**、**内径 >= 4.1 mm**；且 **k x (自由长 - 6.0) 在 1.5 .. 7.0 N 之间**（7.0 N = 60 % 堵转余量门槛，mu = 0.60）。设计值 k = 1.24 N/mm、自由长 8.4 mm => 预载 2.976 N/颗。
- 为什么: 环长固定 6.0 mm 时预载 = k x (L0 - 6.0)。在 L0 = 8.4 mm 下刚度上限 **2.925 N/mm**；买超了就会开始吃换档余量。
- 偏离处置: 若实测 (k, L0) 在窗外，**改打印环长** `L = L0 - 2.976/k`（下限 `L0 - 7.02/k`），不要靠装配力矩调预载。
- 验收补充: 抽检 3 颗弹簧实测 k 与自由长，换算预载必须落在 2.976 +- 0.25 N（或按上式改环长后落回该窗口）。
