wang15143089/FTC-2026-Bio-buzz/cad/output/_r52_drive/r52_assembly_sheet_nectar.png

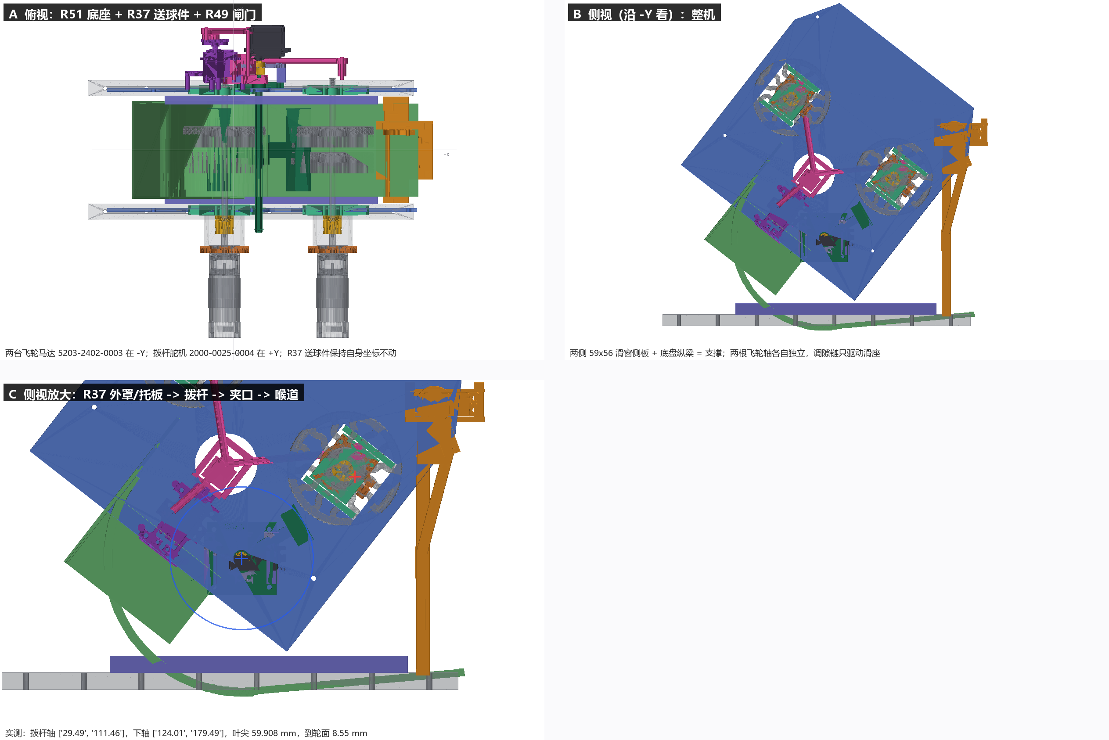
cad/output/_r52_drive/r52_assembly_sheet_nectar.png
