wang15143089/FTC-2026-Bio-buzz/cad/output/_r57_frame/sections/r57_pollen_assembly_y0.png

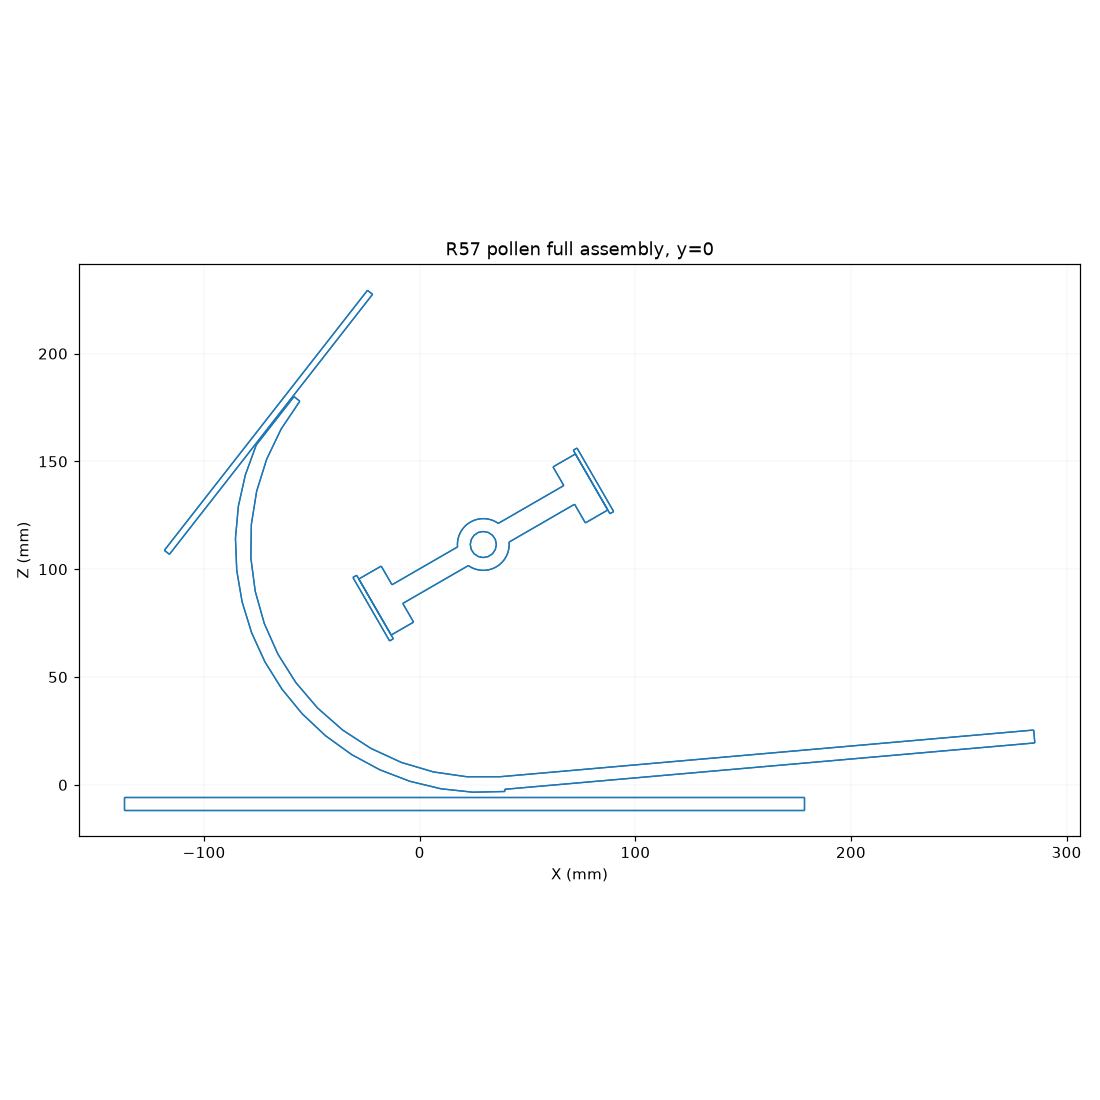
cad/output/_r57_frame/sections/r57_pollen_assembly_y0.png
