wang15143089/FTC-2026-Bio-buzz/cad/output/_r60_frame/sections/r60b_print_set_45.png

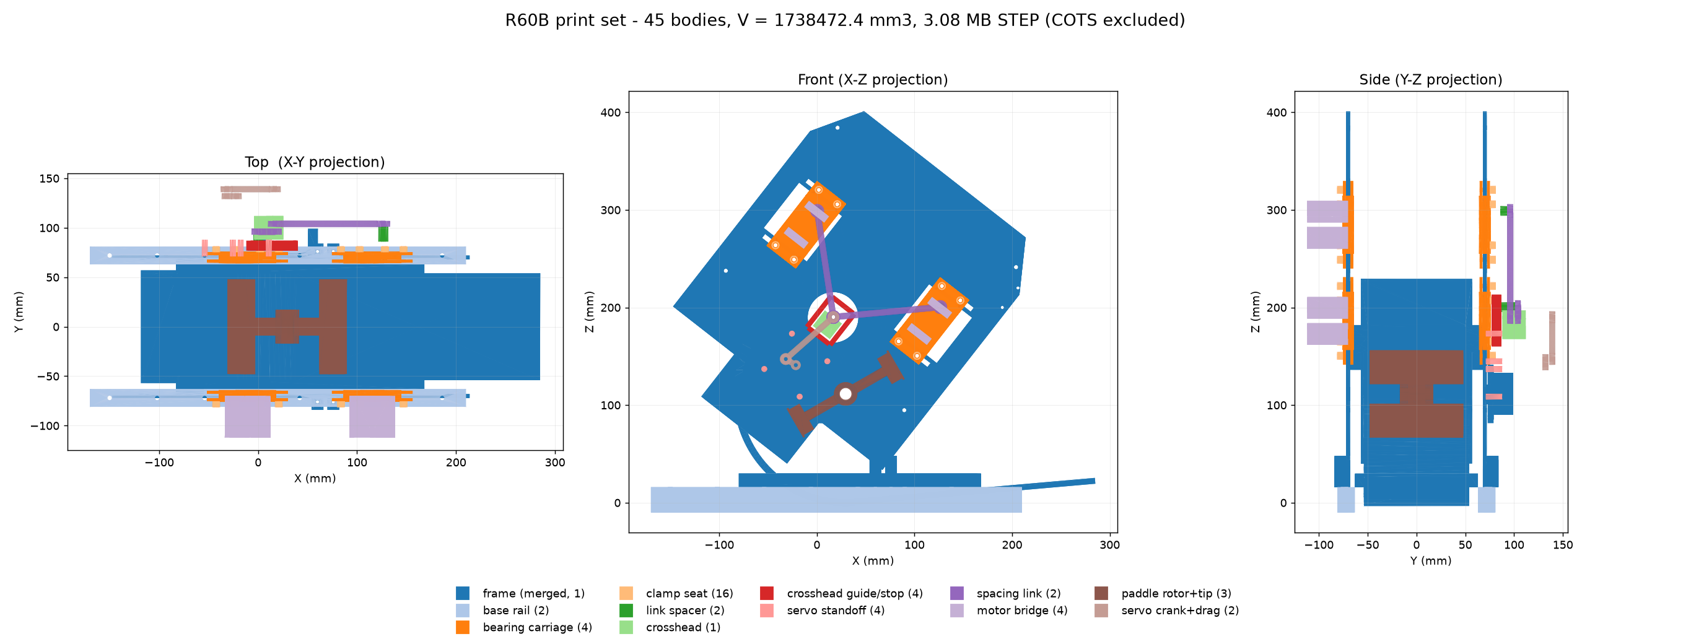
cad/output/_r60_frame/sections/r60b_print_set_45.png
