wang15143089/FTC-2026-Bio-buzz/cad/output/_r61_frame/sections/r61_pollen_assembly_y0.png

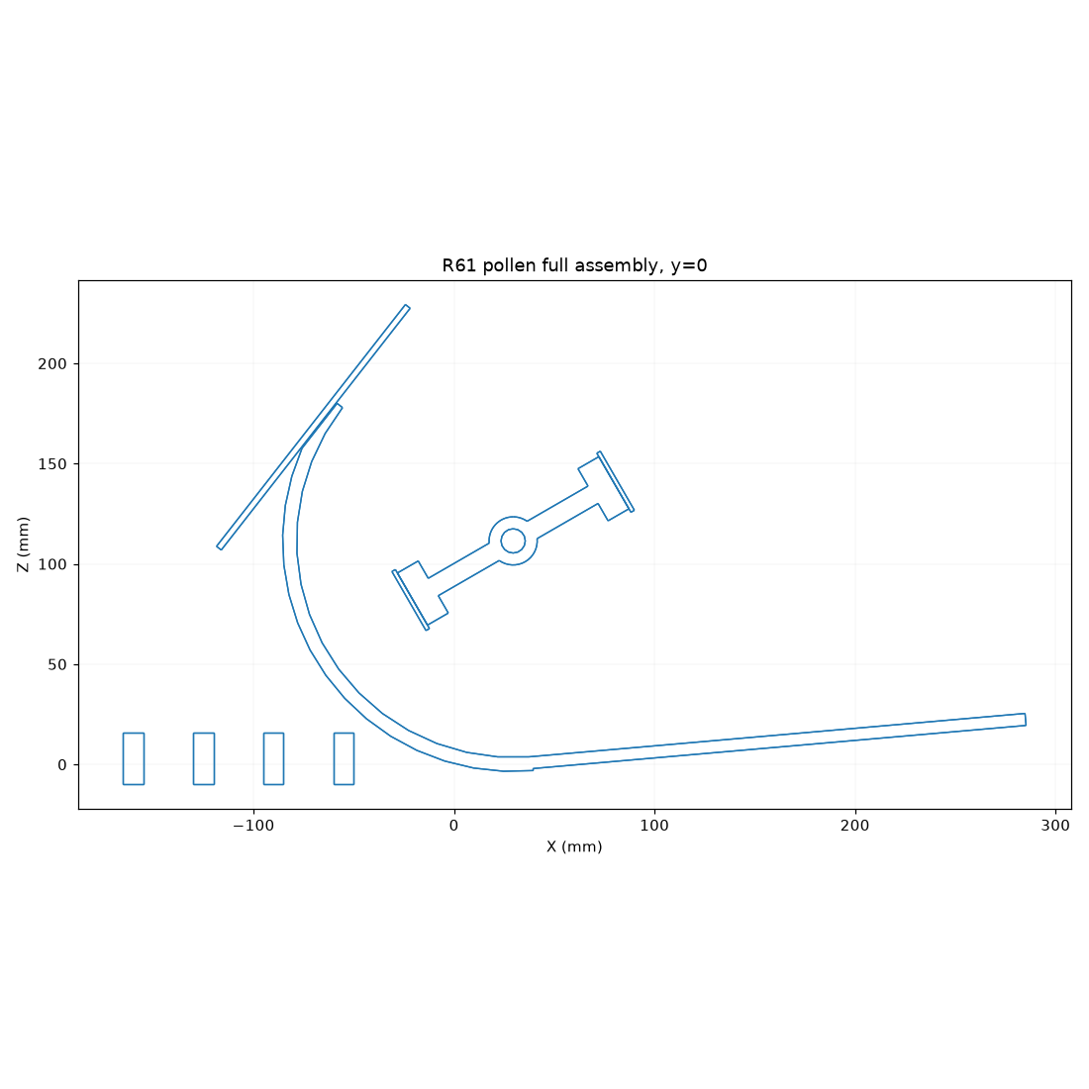
cad/output/_r61_frame/sections/r61_pollen_assembly_y0.png
