wang15143089/FTC-2026-Bio-buzz/simulation/mujoco/out/proposal_curved_guide.png

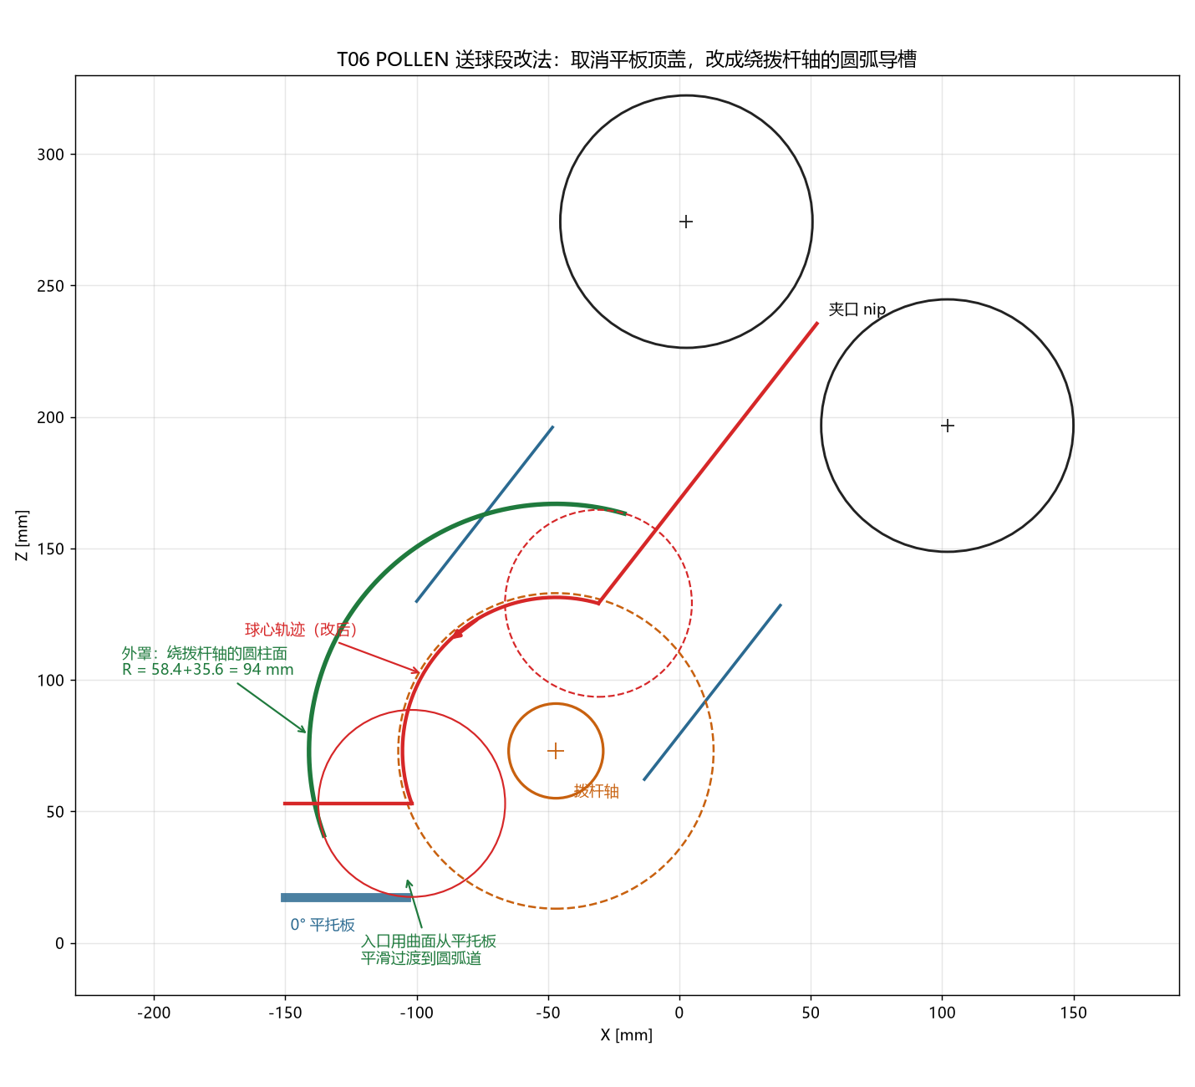
simulation/mujoco/out/proposal_curved_guide.png
