wang15143089/FTC-2026-Bio-buzz/docs/validation_plan.md

# 验证计划

## 验证金字塔

1. L1 分析计算
2. L2 Python 数值模型
3. L3 二维或简化运动学模型
4. L4 简化三维碰撞/运动检查
5. L5 有明确必要性的物理仿真
6. L6 实体原型
7. L7 整机集成测试

只有较低层级不能回答工程问题时才升级；升级理由、模型边界和预期决策必须先记录。

## 阶段关口

| 阶段 | 最低退出证据 |
|---|---|
| M0 | 可测试需求、来源、优先级、开放问题和接口候选 |
| M1 | 多概念比较、选择理由、主要风险和粗略预算 |
| M2 | 可复算的载荷/速度/扭矩/功率/寿命计算及敏感性 |
| M3 | 简化参数几何、包络/行程/干涉检查 |
| M4 | 可重复生成的详细 CAD、接口和制造参数分离 |
| M5 | 模块级验收测试通过或偏差获批 |
| M6 | 相邻模块接口、传递功能和故障行为验证 |
| M7 | 整机任务、法规、功率、质量和碰撞验证 |
| M8 | 图纸/BOM/文件版本、制造检查和发布批准 |

## 验证记录要求

每项使用 `VAL-<模块>-NNN`，关联需求和接口；记录方法层级、输入版本、设备/脚本、边界条件、验收阈值、结果事实标签、证据路径、执行者和日期。`SIMULATED` 结果不得写成 `MEASURED`。

## 初始系统验证矩阵

| 验证项 | 关联 | 方法 | 状态 |
|---|---|---|---|
| VAL-S00-001 需求完整性审查 | PRJ-001..009 | 文档审查 | 通过；Requirements v0.1 已批准 |
| VAL-S00-002 参数主源可解析 | PRJ-002, PRJ-007 | YAML 语法检查 | 人工结构审查通过；机器解析待 YAML 解析器可用 |
| VAL-S00-003 项目恢复演练 | PRJ-006 | 新会话按检查点恢复 | 待后续执行 |
| VAL-S00-004 模块/接口覆盖审查 | PRJ-001, PRJ-003 | 架构与 ICD 审查 | 通过；Architecture v0.1 已批准 |
| VAL-S00-005 TU01 规则提取核验 | LEG-001..011, ENV-001..004, OBJ-001..002 | PDF 文本与页面图像交叉审查 | 通过；核验范围见 SRC-001 |
| VAL-S00-006 STEP 身份与单位核验 | ENV-002、硬件参考 | ZIP/STEP 头与 PRODUCT 元数据检查 | 通过；几何包络测量待办 |
| VAL-S00-007 电气硬件输入核验 | LEG-006..007、T03 | 用户图、官方产品资料与规则交叉审查 | 电池和双 Hub 型号通过；Control Hub 精确代理尺寸待官方 CAD |
| VAL-S00-008 任务包评分模型复算 | DEC-0003、DEC-0010、FN-001..008 | L2 Python 确定性计算、规则证据审查、边界检查与 60%–80% 战略权重敏感性 | v0.2 通过；P3/P4 排名前二保持不变，假设见 ASM-005 |
| VAL-S00-009 设计先例可追溯性 | PRJ-009、DEC-0007 | 来源、适用性和限制审查 | 初始目录通过；任何具体机构采用时须再次验证 |
| VAL-T06-001 P3 弹道模型复算 | T06-REQ-001..005、IF-T06-ENV-01 | L1/L2 解析式与 Python 参数扫描 | P3-BAL-0.1 通过单元测试；阻力/旋转待 L6 标定 |
| VAL-T06-002 电机/轮速初筛 | T06-REQ-005、IF-T03-T06-01 | L1 圆周速度与理想电机曲线 | 312/1150 RPM 直驱淘汰；1620 RPM + 120 mm 进入原型，不等同选型 |
| VAL-T06-003 发射概念筛选 | T06-REQ-004..007 | M1 加权比较与先例/失效审查 | C06-B/C06-A 进入台架；所有概念评分仍为 ASSUMED |
| VAL-T06-004 双尺寸发射台架 | T06-REQ-004..008、IF-T05-T06-01 | L6 实体原型 | 待建；阈值需用户性能目标 |
| VAL-T06-005 单/双飞轮解析比较 | T06-REQ-004..008、DEC-0012 | L1 接触运动学、几何与资源计算；L2 Python 复算 | P3-LAUNCHER-CMP-0.3通过；v0.2运动学证明不变，v0.3更新共享动力资源，真实精度待VAL-T06-004 |
| VAL-T06-006 双飞轮 COTS 传动栈 | T06-REQ-002/004/005/007、IF-T02-T06-01、IF-T03-T06-01 | 官方目录/STEP 核验；每 SKU 整体官方部件（DEC-0021）M3 两端点干涉；关键尺寸从最终几何回读；轴向啮合/间隙复算；`tools/inspect_geometry.py` 结构化检验；单元测试 | C06B-COTS-0.3 的 13 个官方 STEP 已下载并登记哈希；整体部件工作装配、两端点几何、16/16 报告检查与 40/40 测试通过；几何检验 R004 77 项全 `pass`（23 规格 + 54 逐 SKU，`cad/output/inspection/t06_launcher_R004.json`）；实物公差与安全旋转仍待 KEI-10/12 |
| VAL-T04-001 FLOWER 底部共享 intake | G407、G418、IF-T04-FLOWER-01 | L3 开口/扫掠检查后进行 L6 四球连续取出试验 | 待建；须覆盖球尺寸变化、容量 4 抑制和断电清障 |
| VAL-T04-002 C04-A 名义参数复算 | G407、G415、G418、R503、IF-T04-FLOWER-01 | L1/L2 开口余量、roller速度、限力、资源和电流端点模型 | T04-INTAKE-0.1 脚本通过；10 N载荷及实际间隙待L6替换 |
| VAL-T04-003 C04-A 拨叉/roller夹具 | IF-T04-FLOWER-01、IF-T04-T05-01 | L6透明侧板夹具；参数筛选后100次四球连续取出 | 待建；记录成功率、周期、峰值力/电流、卡死和规则危险接触 |
| VAL-T04-004 C04-B1底部侧拨扫掠 | G415、G418、IF-T04-FLOWER-01 | L1/L2台阶与倾斜面下界；L3/L4官方STEP完整球/拨片/roller布尔扫掠 | 名义通过但路径已修订：纯−X横移因支柱干涉淘汰；朝−Y偏25°时球/3×20×32 mm拨片/Ø60×120 mm roller交叠为0，最小解析支柱余量3.680 mm；实体公差待VAL-T04-005 |
| VAL-T04-005 C04-A/B1同夹具对照 | IF-T04-FLOWER-01、IF-T04-T05-01 | L6同一夹具与球批次随机对照；参数筛选后各100次四球连续取出 | 待建；B1须零规则危险接触、不多于1专用舵机且预登记统计门槛不劣于A |
| VAL-T04-006 C04-B1卷线鼓/滑块验证件 | T04-INTAKE-0.4、SRC-017/018、IF-T04-FLOWER-01 | L1/L2角度/力/脉宽计算；M3参数CAD回读；STL拓扑与Fusion 360装配结构检查；随后L6台架 | 分析/M3通过：17 mm卷线鼓、60 mm行程、25°拨片；3个打印件STEP均单实体有效，3个STL均0边界/非流形边；装配STEP为5个命名实体且非配合件交叠为0。L6取出力、电流、绳滑移和循环待测 |
| VAL-T07-001 共享 intake 顶部放球 | G410、G418、R105、IF-T04-T07-01 | L3 运动学 + L4 包络；通过后才做 L6 | 仅预留；NECTAR 名义径向余量 5.25 mm，当前不纳入基线 |
| VAL-T06-007 送球道低摩擦内衬（R39） | T06-REQ-005、DEC-0039、ID-T06-FEEDER-01 | L1 量纲/摩擦功率核算；L3 同台架 MuJoCo 单变量 μ 扫参（6 相位 x 4 颗）；L4 交付几何网格射线实测 + tools/inspect_geometry.py 规格检验 | V-0039 通过（**相位口径已由 V-0040 收窄**）：清空 47.1 -> 10.0 s（hold 1.0 时 4.0 s）、卡滞 72 % -> 1 %（4 %）、出膛 v 不退化；几何检验 5/5 pass（内弧偏移 +0.488、外弧 -0.000、托板面 -0.461）。⚠️ 该行原写的「全清 6/6、真出膛 24/24」只在原取样相位（150/145/140/130/120/160）成立；标准六相位（0/30/60/90/120/150）下为 **全清 4/6、真出膛 19/24**，低摩擦反而低于 μ=0.60 基线（DEC-0040 / V-0040）。实物 μ、带材贴合与 0.5 mm 台阶对球滚过的影响仍未测 |
| VAL-T06-008 R39 内衬标准相位复核（R40） | T06-REQ-005、DEC-0039/0040、V-0040、ID-T06-FEEDER-01 | L3 同台架 MuJoCo 全流程，标准六相位（0/30/60/90/120/150）x 4 颗；自变量：球道 μ、换档滞后、托板 μ | **否证 DEC-0039/V-0039 的交付口径**：μ=0.05 双面下全清 **4/6**、真出膛 19-21/24（对照 μ=0.60 为 6/6、24/24，但清空 46.9-78.4 s、卡滞 75.6 %）；外罩 0.05 + 托板 0.15/0.30 为 5/6。剩余失败与球道摩擦、拨杆型面无关（缺失同一批球），指向等待区第 2 颗球索引几何（4 球混合轮 NECTAR 停靠 r≈101/极角≈327°，POLLEN r≈96-97/极角≈316°；跨轮 65.5-106.9 / 76.4-100.2 mm，均在 142-275° 扇区外）；另一组 11 相位扫参（含 R39 旧相位，39 颗）全清 6/11 同向。另测得边界：托板 μ 必须 > tan5° ≈ 0.09 |
| VAL-T06-009 滑座常闭弹簧夹 + 调隙链自动换档（R53b/c/d/e） | T06-REQ-004/005、DEC-0051、V-0051..V-0054、IF-T03-T06-01 | L2 静力全行程扫参（虚功 `T_req = 2 f x abs(dh/dtheta)`，225 点）；L2 动力学 50 次来回积分；L2 在线换档工况（时序 / 保持 / 端点）；M3 逐件干涉 + 导出后 STEP 回读 | 通过（计算 + 几何）：换档 **0.354 s/次**、12 次/场占空比 3.6 %、50/50 到位且误差 <= 0.133 mm 不累积、最不利力矩占 25-2 堵转 12.8 %（mu=0.30）/ 25.6 %（mu=0.60）、夹口 64.0..86.4 mm 覆盖双尺寸、`lock_vs_rest = []`、`lock_vs_carriage = []`、`axle_isolation_hits = []`。**未验**：台架 50 次来回（预载衰减）、实机 |
| VAL-T06-010 定长限位环：预载上限与交付一致性（R53f/R53g） | T06-REQ-004/005、DEC-0052、V-0055、V-0056 | L2 预载-顶停边界扫描（1.0..20.0 N x mu 0.30/0.60）；M4 生成加环几何；L4 导出后逐件回读 STEP（solids / 体积 / 包围盒 / 环尺寸） | 通过：预载由几何锁定 **2.976 N +- 0.25 N**（= 1.24 x (8.4 - 6.0)），占 25-2 堵转 25.6 %；吃掉 60 % 余量的门槛 7.0 N、真正顶停 12.0 N => 手拧有 **4 倍以上**过拧空间，故加环；两档各 **130 件**、环 16 件（件件 148.49 mm3，Ø8.0/Ø5.7 x 6.0）、回读 **370 solids**、体积偏差 -0.0001 %、包围盒偏差 0.00 mm。**否决**：螺柱外细套筒（壁厚 0.25 mm、约 69 N，手拧会压溃）。**未验**：限位环打印长度 / 压缩强度、台架复测 |
