wang15143089/FTC-2026-Bio-buzz/simulation/mujoco/out/interim_result.png

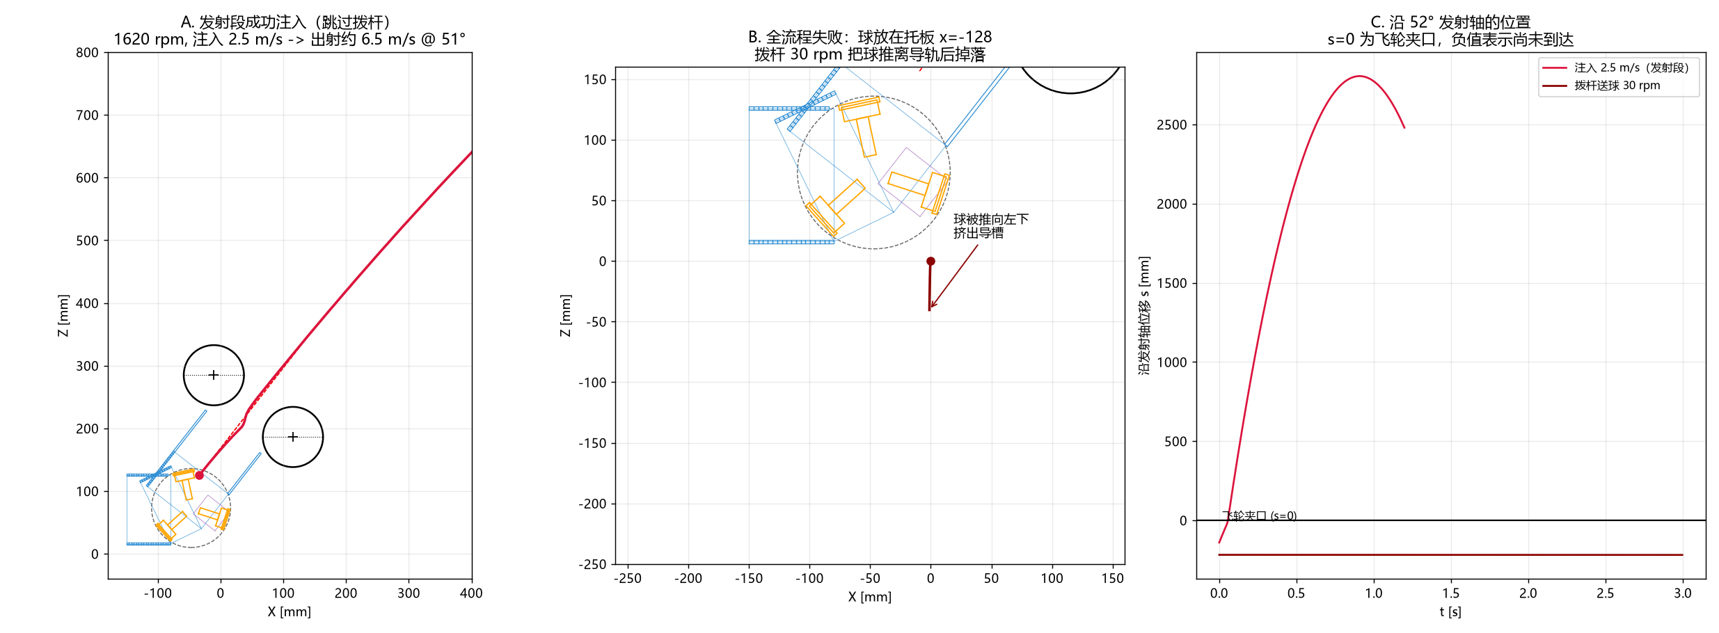
simulation/mujoco/out/interim_result.png
