wang15143089/FTC-2026-Bio-buzz/simulation/mujoco/out/contact_fix_options_zh.png

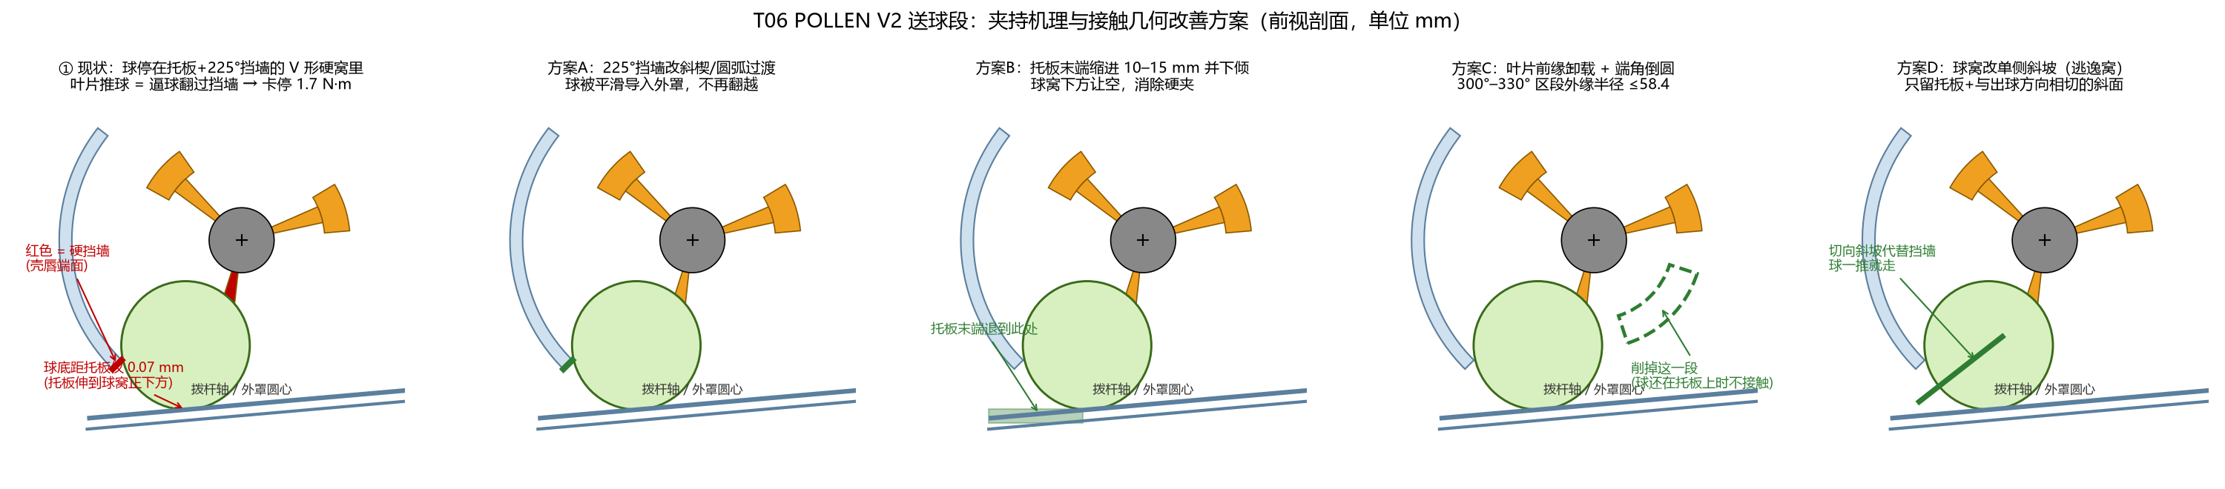
simulation/mujoco/out/contact_fix_options_zh.png
