wang15143089/FTC-2026-Bio-buzz/simulation/mujoco/out/model_paddlem_spinm.xml

<mujoco model="t06_pollen_launcher">
  <compiler angle="radian" autolimits="true"/>
  <option timestep="0.0002" gravity="0 0 -9.81" integrator="implicitfast" cone="elliptic"/>
  <default>
    <geom friction="0.5 0.01 0.0001" solref="0.008 1" solimp="0.95 0.99 0.001"/>
    <default class="guide"><geom friction="0.25 0.005 0.0001" rgba="0.2 0.56 0.84 0.55"/></default>
    <default class="finger"><geom friction="0.2 0.005 0.0001" rgba="0.76 0.88 0.96 0.7"/></default>
    <default class="flywheel"><geom friction="1.6 0.02 0.0001" solref="0.006 1" rgba="0.18 0.18 0.20 1"/></default>
    <default class="paddle"><geom friction="0.7 0.01 0.0001" solref="0.006 1" rgba="0.92 0.54 0.12 1"/></default>
    <default class="ball"><geom friction="1.0 0.02 0.0001" solref="0.010 1" solimp="0.9 0.95 0.002" rgba="0.95 0.85 0.15 1" priority="1"/></default>
  </default>
  <worldbody>
    <light pos="0.2 -0.6 1.0" dir="-0.2 0.6 -1" diffuse="0.8 0.8 0.8"/>
    <geom name="guide_floor_1_0" class="guide" type="box" size="0.001944 0.057000 0.001500" pos="-0.148056 0.000000 0.016000" quat="1.000000 0.000000 -0.000000 0.000000"/>
    <geom name="guide_floor_1_1" class="guide" type="box" size="0.001944 0.057000 0.001500" pos="-0.144167 0.000000 0.016000" quat="1.000000 0.000000 -0.000000 0.000000"/>
    <geom name="guide_floor_1_2" class="guide" type="box" size="0.001944 0.057000 0.001500" pos="-0.140278 0.000000 0.016000" quat="1.000000 0.000000 -0.000000 0.000000"/>
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
    <geom name="fw_shaft_upper" class="flywheel" type="cylinder" size="0.004000 0.084000" quat="0.707107 -0.707107 0 0" mass="0.05"/>
    <geom name="fw_upper_1" class="flywheel" type="cylinder" size="0.048000 0.012000" pos="0 -0.015000 0" quat="0.707107 -0.707107 0 0" mass="0.105"/>
    <geom name="fw_upper_2" class="flywheel" type="cylinder" size="0.048000 0.012000" pos="0 0.015000 0" quat="0.707107 -0.707107 0 0" mass="0.105"/>
  </body>
  <body name="flywheel_lower" pos="0.115345 0.000000 0.186261">
    <joint name="fw_lower" type="hinge" axis="0 1 0" damping="0.0002"/>
    <geom name="fw_shaft_lower" class="flywheel" type="cylinder" size="0.004000 0.084000" quat="0.707107 -0.707107 0 0" mass="0.05"/>
    <geom name="fw_lower_1" class="flywheel" type="cylinder" size="0.048000 0.012000" pos="0 -0.015000 0" quat="0.707107 -0.707107 0 0" mass="0.105"/>
    <geom name="fw_lower_2" class="flywheel" type="cylinder" size="0.048000 0.012000" pos="0 0.015000 0" quat="0.707107 -0.707107 0 0" mass="0.105"/>
  </body>
  <body name="paddle" pos="-0.047000 0.000000 0.073000">
    <joint name="paddle_joint" type="hinge" axis="0 1 0" damping="0.0005"/>
    <geom name="paddle_hub" class="paddle" type="cylinder" size="0.018000 0.017000" quat="0.707107 -0.707107 0 0" mass="0.05"/>
    <geom name="paddle_arm_1" class="paddle" type="box" size="0.016000 0.009000 0.005000" pos="0.028532 0.000000 -0.009271" quat="0.987688 0.000000 0.156434 0.000000" mass="0.01"/>
    <geom name="paddle_blade_1" class="paddle" type="box" size="0.006000 0.048000 0.015000" pos="0.049455 0.000000 -0.016069" quat="0.987688 0.000000 0.156434 0.000000" mass="0.02"/>
    <geom name="paddle_flex_1" class="paddle" type="box" size="0.002000 0.048000 0.017000" pos="0.055161 0.000000 -0.017923" quat="0.987688 0.000000 0.156434 0.000000" mass="0.008"/>
    <geom name="paddle_arm_2" class="paddle" type="box" size="0.016000 0.009000 0.005000" pos="-0.022294 0.000000 -0.020074" quat="0.358368 0.000000 0.933580 0.000000" mass="0.01"/>
    <geom name="paddle_blade_2" class="paddle" type="box" size="0.006000 0.048000 0.015000" pos="-0.038644 0.000000 -0.034795" quat="0.358368 0.000000 0.933580 0.000000" mass="0.02"/>
    <geom name="paddle_flex_2" class="paddle" type="box" size="0.002000 0.048000 0.017000" pos="-0.043102 0.000000 -0.038810" quat="0.358368 0.000000 0.933580 0.000000" mass="0.008"/>
    <geom name="paddle_arm_3" class="paddle" type="box" size="0.016000 0.009000 0.005000" pos="-0.006237 0.000000 0.029344" quat="-0.629320 0.000000 0.777146 0.000000" mass="0.01"/>
    <geom name="paddle_blade_3" class="paddle" type="box" size="0.006000 0.048000 0.015000" pos="-0.010811 0.000000 0.050864" quat="-0.629320 0.000000 0.777146 0.000000" mass="0.02"/>
    <geom name="paddle_flex_3" class="paddle" type="box" size="0.002000 0.048000 0.017000" pos="-0.012059 0.000000 0.056733" quat="-0.629320 0.000000 0.777146 0.000000" mass="0.008"/>
  </body>
  <body name="ball" pos="-0.128000 0 0.053060">
    <freejoint name="ball_free"/>
    <geom name="ball_geom" class="ball" type="sphere" size="0.035560" mass="0.06"/>
  </body>
  </worldbody>
  <actuator>
    <velocity name="fw_upper_vel" joint="fw_upper" kv="0.5" ctrlrange="-400 400" forcerange="-3.0 3.0"/>
    <velocity name="fw_lower_vel" joint="fw_lower" kv="0.5" ctrlrange="-400 400" forcerange="-3.0 3.0"/>
    <velocity name="paddle_vel" joint="paddle_joint" kv="0.08" ctrlrange="-100 100" forcerange="-0.6 0.6"/>
  </actuator>
  <sensor>
    <framepos name="ball_pos" objtype="body" objname="ball"/>
    <framelinvel name="ball_vel" objtype="body" objname="ball"/>
  </sensor>
</mujoco>
