wang15143089/FTC-2026-Bio-buzz/simulation/mujoco/out/model_v2_p40.xml

<mujoco model="t06_pollen_launcher_v2">
  <compiler angle="radian" autolimits="true"/>
  <option timestep="0.0002" gravity="0 0 -9.81" integrator="implicitfast" cone="elliptic"/>
  <default>
    <geom friction="0.5 0.01 0.0001" solref="0.008 1" solimp="0.95 0.99 0.001"/>
    <default class="guide"><geom friction="0.25 0.005 0.0001" rgba="0.2 0.56 0.84 0.45"/></default>
    <default class="shell"><geom friction="0.25 0.005 0.0001" rgba="0.2 0.56 0.84 0.45"/></default>
    <default class="flywheel"><geom friction="1.6 0.02 0.0001" solref="0.006 1" rgba="0.18 0.18 0.20 1"/></default>
    <default class="paddle"><geom friction="0.7 0.01 0.0001" solref="0.006 1" rgba="0.92 0.54 0.12 1"/></default>
    <default class="ball"><geom friction="1.0 0.02 0.0001" solref="0.010 1" solimp="0.9 0.95 0.002" rgba="0.95 0.85 0.15 1" priority="1"/></default>
  </default>
  <worldbody>
    <light pos="0.2 -0.6 1.0" dir="-0.2 0.6 -1" diffuse="0.8 0.8 0.8"/>
    <geom name="guide_roof_3" class="guide" type="box" size="0.035000 0.057000 0.001500" pos="-0.095699 0.000000 0.135414" quat="0.898794 0.000000 -0.438371 0.000000"/>
    <geom name="guide_wall_3_-1" class="guide" type="box" size="0.035000 0.001500 0.055000" pos="-0.052359 -0.055500 0.101552" quat="0.898794 0.000000 -0.438371 0.000000"/>
    <geom name="guide_wall_3_+1" class="guide" type="box" size="0.035000 0.001500 0.055000" pos="-0.052359 0.055500 0.101552" quat="0.898794 0.000000 -0.438371 0.000000"/>
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
    <geom name="paddle_flex_2" class="paddle" type="box" size="0.002000 0.048000 0.017000" pos="-0.043102 0.000000 -0.038810" quat="0.358368 0.000000 0.933580 0.000000" mass="0.008"/>
    <geom name="paddle_arm_3" class="paddle" type="box" size="0.016000 0.009000 0.005000" pos="-0.006237 0.000000 0.029344" quat="-0.629320 0.000000 0.777146 0.000000" mass="0.01"/>
    <geom name="paddle_blade_3" class="paddle" type="box" size="0.006000 0.048000 0.015000" pos="-0.010811 0.000000 0.050864" quat="-0.629320 0.000000 0.777146 0.000000" mass="0.02"/>
    <geom name="paddle_flex_3" class="paddle" type="box" size="0.002000 0.048000 0.017000" pos="-0.012059 0.000000 0.056733" quat="-0.629320 0.000000 0.777146 0.000000" mass="0.008"/>
  </body>
  <body name="ball" pos="0.145000 0 0.065947">
    <freejoint name="ball_free"/>
    <geom name="ball_geom" class="ball" type="sphere" size="0.035560" mass="0.06"/>
  </body>
  </worldbody>
  <actuator>
    <velocity name="fw_upper_vel" joint="fw_upper" kv="0.5" ctrlrange="-400 400" forcerange="-3.0 3.0"/>
    <velocity name="fw_lower_vel" joint="fw_lower" kv="0.5" ctrlrange="-400 400" forcerange="-3.0 3.0"/>
    <velocity name="paddle_vel" joint="paddle_joint" kv="0.08" ctrlrange="-100 100" forcerange="-1.5 1.5"/>
  </actuator>
</mujoco>
