wang15143089/FTC-2026-Bio-buzz/simulation/mujoco/out/R47_launcher_4xNECTAR_gap082.xml

<!--
  T06 送球+发射台架 R47 验收模型（MuJoCo 3.14，SI 单位 m / kg）
  球种排布: NECTAR,NECTAR,NECTAR,NECTAR
  口径: 托板末端 x=460mm  挡舌 x=180mm  球-环境 mu=0.6
        外罩/托板/球窝摩擦 0.30 + priority 2（托板顶面单侧低摩擦胶带）
        外罩内弧/唇口径向让位 -0.20mm  拨杆 0.70 + priority 2  挡舌 0.40 + priority 2
  轮间半间距: nip=82 mm -> HALF_SPACING=89.0 mm（WHEEL_R=48 夹口）
  飞轮 1620 rpm 对向旋转；拨杆两叉(330/150)，索引式 360 deg/颗、停 1 s、扫 248 deg
  <keyframe ph000..ph150> = 6 个拨杆起始相位，配 run_R47_xml.py --ph 0..5
  挡舌 = mocap body "gate_leaf"，需外部驱动 z 47.5mm(挡) <-> 139.5mm(放)
  挡位角 188 deg 需速度伺服保持（真实舵机行为，脚本里实现）
-->
<mujoco model="t06_pollen_launcher_v2">
  <compiler angle="radian" autolimits="true"/>
  <option timestep="0.0002" gravity="0 0 -9.81" integrator="implicitfast" cone="elliptic"/>
  <default>
    <geom friction="0.5 0.01 0.0001" solref="0.008 1" solimp="0.95 0.99 0.001"/>
    <default class="guide"><geom friction="0.25 0.005 0.0001" rgba="0.2 0.56 0.84 0.45"/></default>
    <default class="shell"><geom friction="0.25 0.005 0.0001" rgba="0.2 0.56 0.84 0.45"/></default>
    <default class="flywheel"><geom friction="1.6 0.02 0.0001" solref="0.006 1" rgba="0.18 0.18 0.20 1"/></default>
    <default class="paddle"><geom friction="0.7 0.01 0.0001" solref="0.006 1" rgba="0.92 0.54 0.12 1"/></default>
    <default class="ball"><geom friction="0.6 0.02 0.0001" solref="0.010 1" solimp="0.9 0.95 0.002" rgba="0.95 0.85 0.15 1" priority="1"/></default>
  </default>
  <worldbody>
  <body name="gate_leaf" mocap="true" pos="0.180000000 0.000000000 0.047500000">
    <geom name="gate_blade" type="box" size="0.002500000 0.054000000 0.027500000" pos="0 0 0" friction="0.4000 0.02 0.0001" rgba="0.90 0.22 0.28 1" mass="0.035046" priority="2"/>
  </body>

    <geom name="catch_floor" type="box" size="2 2 0.01" pos="0.2 0 -0.10" rgba="0.6 0.6 0.6 0.5"/>
    <light pos="0.2 -0.6 1.0" dir="-0.2 0.6 -1" diffuse="0.8 0.8 0.8"/>
    <geom name="guide_roof_3" class="guide" type="box" size="0.035000 0.057000 0.001500" pos="-0.095699 0.000000 0.135414" quat="0.898794 0.000000 -0.438371 0.000000"/>
    <geom name="guide_wall_3_-1" class="guide" type="box" size="0.035000 0.001500 0.055000" pos="-0.052359 -0.055500 0.101552" quat="0.898794 0.000000 -0.438371 0.000000"/>
    <geom name="guide_wall_3_+1" class="guide" type="box" size="0.035000 0.001500 0.055000" pos="-0.052359 0.055500 0.101552" quat="0.898794 0.000000 -0.438371 0.000000"/>
    <geom name="shooter_throat_+55" class="guide" type="box" size="0.041500 0.057000 0.001500" pos="-0.048601 0.000000 0.195696" quat="0.898794 0.000000 -0.438371 0.000000"/>
    <geom name="r10_00" class="shell" friction="0.3000 0.005 0.0001" type="box" size="0.007278 0.054000 0.003500" pos="-0.061404630 0.000000000 0.175648630" quat="-0.459974 0.000000 -0.887932 0.000000" priority="2"/>
    <geom name="r10_01" class="shell" friction="0.3000 0.005 0.0001" type="box" size="0.007278 0.054000 0.003500" pos="-0.067178252 0.000000000 0.166570946" quat="-0.502360 0.000000 -0.864659 0.000000" priority="2"/>
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
    <key name="ph060" qpos="0 0 1.04719755 -0.0212041524 0 0.0757654218 1 0 0 0 0.228774 0 0.0666582606 1 0 0 0 0.320969827 0 0.0747243503 1 0 0 0 0.413165654 0 0.0827904399 1 0 0 0"/>
    <key name="ph090" qpos="0 0 1.57079633 -0.0322752487 0 0.106069819 1 0 0 0 0.228774 0 0.0666582606 1 0 0 0 0.320969827 0 0.0747243503 1 0 0 0 0.413165654 0 0.0827904399 1 0 0 0"/>
    <key name="ph120" qpos="0 0 2.0943951 -0.03251 0 0.11146 1 0 0 0 0.228774 0 0.0666582606 1 0 0 0 0.320969827 0 0.0747243503 1 0 0 0 0.413165654 0 0.0827904399 1 0 0 0"/>
    <key name="ph150" qpos="0 0 2.61799388 0.0637081261 0 0.0522168679 1 0 0 0 0.228774 0 0.0666582606 1 0 0 0 0.320969827 0 0.0747243503 1 0 0 0 0.413165654 0 0.0827904399 1 0 0 0"/>
  </keyframe>
</mujoco>
