wang15143089/FTC-2026-Bio-buzz/cad/_doc_r69.py

# -*- coding: utf-8 -*-
"""R69: append DEC-0076 / V-0076 to docs/decision_log.md and add section 0.17 +
refresh the header line of PROJECT_STATUS.md."""
from pathlib import Path

ROOT = Path(__file__).resolve().parents[1]
dl = ROOT / "docs" / "decision_log.md"
ps = ROOT / "PROJECT_STATUS.md"

DEC = """

## DEC-0076 - 决策：R69 —— 滑轨改方案 C（每侧一根 380 mm 整轨，supersede DEC-0072 的跨缝搭板）+ 外罩/侧板联合体 3 拆（8 × M3 耳片螺栓 + 环氧，不用扎带）（2026-10-16）

- 判据（KNOWN）: 用户 2026-10-16 令「c，谢谢。麻烦你也把巨大的外罩-侧板联合体拆成3部分：左侧板，右侧板，以及外罩-托板联合体，3部分用螺丝，扎带和胶水固定（选择你认为最好的方法，可以直接给外罩-托板直接变宽使其全程和侧板接触）」；上一轮已令「把两段滑轨在3D打印文件中连起来（拼成一个不用额外操作打印出来就连着的实体）」。
- 滑轨方案 C（KNOWN + MEASURED）: 每侧把 `base_rail_front_±72` 与 `base_rail_rear_joined` 沿 x **布尔并成一根 380.0 mm 整轨**（`base_rail_+72.step` / `base_rail_-72.step`，各为单实体，bbox x [-170, 210]）。因此 **退役** DEC-0072（方案 A）引入的 2 件 `rail_splice_plate_±72`、4 根跨轨筋、2 块垫板与 4 × M3×30。DEC-0072 按 **SUPERSEDED** 原样保留、不删除。
- 3 拆（MEASURED）: 切割面取 **y = ±68**（侧板内表面，实测自 R62 主体）。退役单件 `frameP_1_rear_lower` → `shroud_tray_mid` + `side_plate_left` + `side_plate_right`；**切割体积守恒 delta = 0.000 mm³**；三件各为**单实体**。
- 紧固选择（KNOWN，用户已授权自选）: **M3 六角螺栓 + 六角螺母 + 每螺栓 2 平垫圈 + 双组分环氧**；**不用扎带**。理由：扎带必须在 4 mm 薄侧板上开槽 / 绕行，对「已螺栓 + 已粘接」的接头没有附加收益，反而增加工序与应力集中；环氧承担全部剪切（胶缝 0.2 mm），螺栓承担夹紧与定位。
- 耳片（MEASURED）: 从外罩壁咬入 3 mm（`Y_BITE = 3.0`）的 12 × 10 mm 局部耳片，外表面到 **y = ±67.8**，对侧板内表面（±68）留 **0.2 mm 胶缝**；每侧 4 个工位、共 **8 个**。工位由射线实测选出（外罩壁外侧落在 y 52…56 区间），不是拍脑袋定的。
- 工位表（MEASURED）:

| 工位 | x (mm) | z (mm) | 侧板厚 (mm) | 夹持长度 (mm) | 螺栓 |
| --- | --- | --- | --- | --- | --- |
| A | 74.0 | 27.0 | 16.0（前下法兰） | 30.5 | M3×35 |
| D | 5.0 | 86.0 | 4.0 | 18.0 | M3×25 |
| B | -25.0 | 120.0 | 4.0 | 18.0 | M3×25 |
| C | -68.0 | 140.0 | 4.0 | 18.0 | M3×25 |

- 螺栓长度由 `5 × ceil((夹持 + 4) / 5)` 现场计算，不写死（原稿把 A 位写成 M3×45 是错的）。螺栓头 + 垫圈在**侧板外侧**（可及），垫圈 + 六角螺母在**外罩壁内表面**；内腔螺母空间已实测（A 位内侧最近实体面 53.5，其余 54，再往内到 40 为空）。
- 为什么不「外罩-托板全程加宽」（KNOWN + MEASURED）: 全程加宽要把 |y| 57…68 的 **11 mm 空腔填实**，会与轴承 / 滑座 / 横梁的让位冲突，耗材约 +70 %；**局部耳片**用最少的料拿到同等夹持。用户原话是「可以直接加宽」，属可选手段而非强制 ⇒ 取耳片。
- 不改动（KNOWN）: `cad/output/_r66_parts/` 与其它历史产物**只读**；本轮 5 个新件写入 `cad/output/_r69_parts/`，件集由 **55 → 54 件**（-2 搭板、4 段轨并成 2 根整轨、+8 个耳片体积）。
- 交付（MEASURED）: **升版 R69** —— 件集 `cad/output/_r69_parts/`（54 件）、排版 `cad/output/_r69_plate/`（8 板）、交付包 `deliverables/R69_print_package/`；脚本 `cad/_r69_build.py`（构建 + 断言）、`cad/_r69_view.py`（图）、`cad/_r69_plate.py`（排版）、`cad/_r69_package.py`（打包）、`cad/_r69_verify.py`（只回读交付件的独立验收）。
- 关联: DEC-0071 / DEC-0072（**已被本决策 superseded**）、DEC-0074 / DEC-0075（打印件目录与放平判据）、V-0076。
- 未验证（TBD）: 切片器实跑未做；环氧粘接强度未测；0.2 mm 胶缝在 PET 0.4 mm 层高下的实际成型未实测；未实机。
- Date/version: 2026-10-16 / 产物 `cad/output/_r69_parts/`、`cad/output/_r69_plate/`、`deliverables/R69_print_package/`；验收报告 `cad/output/inspection/t06_r69_print_R069.json`。

## V-0076 - 验证记录（非决策）：R69 交付 STEP 的独立回读（3 拆 + 8 耳螺栓 + 方案 C 轨道 + 8 板排版）（2026-10-16）

- 目的（KNOWN）: 证明**交付出去的 STEP**（而不是生成它的输入）几何正确，且 3 拆 / 耳片 / 钻孔 / 轨道 / 排版全部成立。
- 方法（MEASURED）: `cad/_r69_build.py` 构建时自带断言；另写**只回读交付件**的 `cad/_r69_verify.py`（沿用 `tools/inspect_geometry.py` 的 target / measured / tolerance / method / verdict 词表，因为打印件不在该工具的 harness 注册表里）⇒ `cad/output/inspection/t06_r69_print_R069.json`。**21 项检查、0 fail、退出码 0**。
- 实测（MEASURED）:
  - `R69-V1` 体积: 三件之和 − 退役 `frameP_1_rear_lower` = **+7416.931 mm³**，目标 **+7417.0 ± 1.0**（= 8 耳 +7919.9，8 × Ø3.4 钻孔 −502.9）。
  - `R69-V2`: 5 件**各为单实体**（solids = 1）。
  - `R69-V3`: 两条合并轨 x 长度 **380.000 mm**（容差 0.05）。
  - `R69-V4`: Ø3.0 探针沿 M3 轴线、8 工位 × 双向，与三件求交 **0.000 mm³**（≤ 0.5）⇒ 螺栓通道无料。
  - `R69-V5`: Ø3.4 塞规自由（**0.000**）；Ø4.0 塞规仍咬料 **101.185 mm³**（> 10）⇒ 孔径未超差。
  - `R69-V6`: 8 个耳片内部采样盒（偏移 +x 避开螺栓孔）填充率 **1.0000** ⇒ 耳片全部附着、无悬空。
  - `R69-V7`: 8 块板全部落在 H2D 可用区 **315 × 310** 内（p1 311.1 × 306.3 为最大面，p5 H 136.0 为最高）。
  - `R69-V8`: 54 件在 8 板中**各出现一次**，无重复 / 缺失 / 多余。

| 板 | 件数 | 占用 XY (mm) | 最大高 (mm) | 填充 | 内容 |
| --- | --- | --- | --- | --- | --- |
| p1 | 30 | 311.1 x 306.3 | 18.0 | 92% | `base_rail_+72` + 29 小件 |
| p2 | 1 | 287.1 x 287.1 | 18.0 | 100% | `base_rail_-72`（380 轨板内 45 度斜放） |
| p3 | 6 | 307.2 x 306.7 | 31.0 | 89% | `side_plate_right` 等 |
| p4 | 5 | 307.2 x 284.0 | 16.0 | 95% | `side_plate_left` 等 |
| p5 | 2 | 232.8 x 306.4 | 136.0 | 86% | `shroud_tray_mid` 等 |
| p6 | 2 | 275.0 x 247.6 | 5.5 | 99% | |
| p7 | 2 | 230.7 x 224.3 | 4.0 | 99% | |
| p8 | 6 | 265.3 x 305.0 | 30.0 | 75% | |

- 排版脚本的三处必要修正（KNOWN，属**判据不完备**而非几何错误）: ①380 mm 整轨允许**板内斜放**（30…60 度取最优）；②放平判据补上 **H ≤ 325 mm**（原判据只查 XY，会把 380 mm 轨竖着摆、超行程）；③件集来源沿用 R66 目录（`_r69_parts` 只含 5 个新件，其余 49 件仍读 `_r66_parts`）。
- 判定: **pass** —— 3 拆几何、耳片 / 钻孔、方案 C 轨道、8 板排版全部有回读证据；件集 ΣV **1 766 184.4 mm³** == 8 板 ΣV **1 766 184.3 mm³**。
- 未验证（TBD）: 切片器实跑未做；0.2 mm 胶缝在 PET 0.4 mm 层高下的成型未实测；环氧强度未测；PET 翘边 / 首层附着未做切片验证；未实机。
"""

with dl.open("a", encoding="utf-8") as f:
    f.write(DEC)
print("decision_log.md appended")

HEAD = ("最后更新：2026-10-16（**T06 R69 打印件重排：滑轨并成每侧一根 380 mm 整轨"
        " + 外罩/侧板联合体 3 拆（左板 / 右板 / 外罩-托板），件集 55 → 54、8 板"
        "（DEC-0076 / V-0076）**：①判据（KNOWN）= 用户 2026-10-16「c，谢谢。麻烦你也把巨大的外罩-侧板联合体拆成3部分："
        "左侧板，右侧板，以及外罩-托板联合体，3部分用螺丝，扎带和胶水固定（选择你认为最好的方法，"
        "可以直接给外罩-托板直接变宽使其全程和侧板接触）」+ 上一轮「把两段滑轨在3D打印文件中连起来」。"
        "②滑轨方案 C（MEASURED）：每侧 `base_rail_front_±72` 与 `base_rail_rear_joined` 布尔并成 **380.0 mm 单实体整轨**，"
        "DEC-0072 的 2 件跨缝搭板 + 4 跨轨筋 + 2 垫板 + 4 × M3×30 **退役**（DEC-0072 转 SUPERSEDED 保留）。"
        "③3 拆（MEASURED）：切割面 **y = ±68**（侧板内表面），`frameP_1_rear_lower` → `shroud_tray_mid` + `side_plate_left` "
        "+ `side_plate_right`，**体积守恒 delta = 0.000 mm³**，三件各单实体。"
        "④紧固（KNOWN）：**8 × M3 六角螺栓 + 六角螺母 + 每螺栓 2 平垫圈 + 双组分环氧**，**不用扎带**"
        "（扎带要在 4 mm 薄板上开槽，对已螺栓 + 已粘接的接头无收益）；耳片 12 × 10 从外罩壁咬入 3 mm、外表面到 **y = ±67.8**，"
        "对侧板留 **0.2 mm 胶缝**；工位 A(x 74, z 27, 板 16, M3×35) / D(5, 86, 4, M3×25) / B(−25, 120, 4, M3×25) / C(−68, 140, 4, M3×25)，"
        "螺栓长由 `5 × ceil((夹持 + 4) / 5)` 计算，头在外侧、螺母在外罩壁内表面（内腔空间实测有）。"
        "⑤不做全程加宽：填实 |y| 57…68 的 11 mm 空腔会与轴承 / 滑座 / 横梁让位冲突且耗材 +70 %，局部耳片等效。"
        "⑥验收（MEASURED，`cad/output/inspection/t06_r69_print_R069.json`，**21 项 0 fail**）：体积 +7416.931（目标 +7417.0 ± 1.0）、"
        "5 件各单实体、两轨 xlen 380.000、螺栓通道 Ø3.0 探针 8 × 2 求交 **0.000 mm³**、Ø3.4 塞规自由 0.000 / Ø4.0 仍咬料 101.185、"
        "8 耳填充率 **1.0000**、8 板全部 ≤ 315 × 310、54 件在 8 板中各一次。"
        "⑦排版 **8 板**：p1 30 件 / 311.1 × 306.3 / H 18、p2 1 件（380 轨 45° 斜放）/ 287.1 × 287.1 / H 18、p3 6 / 307.2 × 306.7 / H 31、"
        "p4 5 / 307.2 × 284.0 / H 16、p5 2 / 232.8 × 306.4 / H 136、p6 2 / 275.0 × 247.6 / H 5.5、p7 2 / 230.7 × 224.3 / H 4、"
        "p8 6 / 265.3 × 305.0 / H 30；件集 ΣV **1 766 184.4 mm³** == 8 板 ΣV。"
        "⑧交付：件集 `cad/output/_r69_parts/`（54 件）、排版 `cad/output/_r69_plate/`、交付包 `deliverables/R69_print_package/`"
        "（parts 54 / plates 8 / previews 9 / 3 份 index + README）。遗留：切片器实跑、0.2 mm 胶缝成型、环氧强度、PET 翘边、未实机。DEC-0076 / V-0076）")

lines = ps.read_text(encoding="utf-8").split("\n")
assert lines[0] == "# PROJECT STATUS", lines[0]
assert lines[2].startswith("最后更新："), lines[2][:40]
lines[2] = HEAD

SEC = """### 0.17（已完成 2026-10-16）R69 滑轨方案 C（每侧 380 mm 整轨）+ 外罩/侧板联合体 3 拆（DEC-0076 / V-0076）

- 判据（KNOWN）: 用户 2026-10-16「c，谢谢。麻烦你也把巨大的外罩-侧板联合体拆成3部分：左侧板，右侧板，以及外罩-托板联合体，3部分用螺丝，扎带和胶水固定（选择你认为最好的方法，可以直接给外罩-托板直接变宽使其全程和侧板接触）」；上一轮已令「把两段滑轨在3D打印文件中连起来（拼成一个不用额外操作打印出来就连着的实体）」。
- 滑轨方案 C（MEASURED）: 每侧 `base_rail_front_±72` + `base_rail_rear_joined` 布尔并成 **380.0 mm 单实体整轨**（bbox x [-170, 210]，y 63..81 / -81..-63，z -10..16，各 V 173 384.7 mm³）。DEC-0072 的 2 件 `rail_splice_plate_±72` + 4 跨轨筋 + 2 垫板 + 4 × M3×30 **退役**（SUPERSEDED，不删）。
- 3 拆（MEASURED）: 切割面 **y = ±68**（侧板内表面）。`frameP_1_rear_lower` → `shroud_tray_mid`（V 414 543.1，248.4 × 136.0 × 232.9）/ `side_plate_left`（V 162 815.1，262.2 × 16.0 × 284.0）/ `side_plate_right`（V 199 554.9，262.2 × 31.0 × 284.0）；**切割体积守恒 delta = 0.000 mm³**；三件各单实体。
- 紧固（KNOWN + MEASURED）: **8 × M3 六角螺栓 + 六角螺母 + 每螺栓 2 平垫圈 + 双组分环氧**（不用扎带）。耳片 12 × 10 从外罩壁咬入 **3 mm**、外表面到 y = **±67.8**（对侧板留 **0.2 mm 胶缝**）；每侧 4 工位：

| 工位 | x | z | 侧板厚 | 夹持 | 螺栓 |
| --- | --- | --- | --- | --- | --- |
| A | 74.0 | 27.0 | 16.0 | 30.5 | M3×35 |
| D | 5.0 | 86.0 | 4.0 | 18.0 | M3×25 |
| B | -25.0 | 120.0 | 4.0 | 18.0 | M3×25 |
| C | -68.0 | 140.0 | 4.0 | 18.0 | M3×25 |

- 耳片 / 钻孔净量（MEASURED）: mid **+7919.9 mm³**（8 耳），两片侧板 **-502.9 mm³**（8 × Ø3.4 贯穿），净 **+7417.0 mm³**。
- 为什么不全程加宽（KNOWN）: 填实 |y| 57…68 的 11 mm 空腔会与轴承 / 滑座 / 横梁让位冲突、耗材约 +70 %；局部耳片等效且件数不变。
- 验收（MEASURED，`cad/output/inspection/t06_r69_print_R069.json`）: **21 项 0 fail** —— V1 体积 +7416.931（目标 +7417.0 ± 1.0）、V2 5 件各单实体、V3 两轨 xlen 380.000、V4 螺栓通道 Ø3.0 探针 8 工位 × 双向与三件求交 **0.000 mm³**、V5 Ø3.4 塞规自由 0.000 / Ø4.0 仍咬料 101.185 mm³、V6 8 耳填充率 **1.0000**、V7 8 板 ≤ 315 × 310、V8 54 件各出现一次。
- 排版（MEASURED，`cad/output/_r69_plate/`）: **8 板** = p1 30 件 / 311.1 × 306.3 / H 18 / 92%、p2 1 件（380 轨 45° 斜放）/ 287.1 × 287.1 / H 18 / 100%、p3 6 / 307.2 × 306.7 / H 31 / 89%、p4 5 / 307.2 × 284.0 / H 16 / 95%、p5 2 / 232.8 × 306.4 / H 136 / 86%、p6 2 / 275.0 × 247.6 / H 5.5 / 99%、p7 2 / 230.7 × 224.3 / H 4 / 99%、p8 6 / 265.3 × 305.0 / H 30 / 75%；件集 ΣV **1 766 184.4 mm³** == 8 板 ΣV。排版脚本三处修正：380 轨允许板内斜放 30…60°、放平判据补 **H ≤ 325**、件集仍读 `_r66_parts`（`_r69_parts` 只含 5 个新件）。
- 交付（MEASURED）: `deliverables/R69_print_package/`（`parts/` 54、`plates/` 8、`previews/` 9、`parts_index.json`、`plates_index.json`、`fasteners.json`、`PRINT_README.md`）。
- 产物 / 脚本: `cad/output/_r69_parts/`、`cad/output/_r69_plate/`、`deliverables/R69_print_package/`；`cad/_r69_build.py`、`cad/_r69_view.py`、`cad/_r69_plate.py`、`cad/_r69_package.py`、`cad/_r69_verify.py`。
- 未验证（TBD）: 切片器（Bambu Studio）实跑未做；0.2 mm 胶缝在 PET 0.4 mm 层高下的成型未实测；环氧强度未测；PET 翘边 / 首层附着未做切片验证；未实机。

"""

anchor = "### 0.15（已完成 2026-10-16）R66 "
i = next(k for k, L in enumerate(lines) if L.startswith(anchor))
lines.insert(i, SEC)
ps.write_text("\n".join(lines), encoding="utf-8")
print("PROJECT_STATUS.md updated (section 0.17 inserted at line %d)" % (i + 1))
