wang15143089/FTC-2026-Bio-buzz/(commit log)

2026-09-20 Initialize traceable FTC engineering framework
    [task_package_trade_results.csv]
2026-09-20 Prioritize evidence-based strategic value
    [task_package_trade_results.csv]
2026-09-20 Add preliminary P3 HIVE launcher engineering
    [p3_ballistics_results.csv, p3_concept_trade_results.csv, p3_motor_screen_results.csv]
2026-09-20 Select P3 dual-flywheel baseline with intake reuse
    [p3_launcher_comparison_results.csv]
2026-09-20 Design single-motor FLOWER intake and quantify drivetrain
    [p3_launcher_comparison_results.csv, t01_drive_trade_results.csv, t04_intake_results.csv]
2026-09-20 Compare FLOWER side-sweep intake concept
    [t04_intake_results.csv]
2026-09-20 Validate and model FLOWER side-sweep intake
    [t04_flower_sweep_results.csv, t04_intake_results.csv]
2026-09-20 Add printable FLOWER side-sweep validation fixture
    [t04_c04b1_17mm_capstan_m3.step, t04_c04b1_17mm_capstan_m3.stl, t04_c04b1_25deg_paddle_slider_m3.step, t04_c04b1_25deg_paddle_slider_m3.stl, t04_c04b1_capstan_fixture_assembly_m3.step, t04_c04b1_servo_rail_bracket_m3.step, t04_c04b1_servo_rail_bracket_m3.stl, t04_intake_results.csv]
2026-09-20 Assemble official servo fixture for Fusion 360
    [t04_c04b1_17mm_capstan_m3.step, t04_c04b1_17mm_capstan_m3.stl, t04_c04b1_25deg_paddle_slider_m3.step, t04_c04b1_25deg_paddle_slider_m3.stl, t04_c04b1_capstan_fixture_assembly_m3.step, t04_c04b1_fusion360_assembly_m3.step, t04_c04b1_servo_rail_bracket_m3.step, t04_c04b1_servo_rail_bracket_m3.stl]
2026-09-24 Add BIOBUZZ robot CAD baselines and engineering handoff
    [biobuzz_launcher_horizontal_feed_nectar.step, biobuzz_launcher_horizontal_feed_nectar.stl, biobuzz_launcher_horizontal_feed_pollen.step, biobuzz_launcher_horizontal_feed_pollen.stl, biobuzz_launcher_nectar.step, biobuzz_launcher_nectar.stl, biobuzz_launcher_pollen.step, biobuzz_launcher_pollen.stl]
2026-09-27 Engineer COTS single-motor flip-out intake
    [biobuzz_single_motor_flipout_intake_deployed.step, biobuzz_single_motor_flipout_intake_deployed.stl, biobuzz_single_motor_flipout_intake_report.json, biobuzz_single_motor_flipout_intake_stowed.step, biobuzz_single_motor_flipout_intake_stowed.stl]
2026-09-28 Constrain continuous feeder to catalog hardware
    [continuous_servo_feeder_cots.step, continuous_servo_feeder_cots.stl, continuous_servo_feeder_cots_report.json]
2026-09-28 Revert "Constrain continuous feeder to catalog hardware"
    This reverts commit 9aceb40b205758e2d10c515090478bb980d8b6c0.
    [continuous_servo_feeder_cots.step, continuous_servo_feeder_cots.stl, continuous_servo_feeder_cots_report.json]
2026-09-29 Constrain opposed flywheel launcher to catalog hardware
    [feeder_support_cheek_reference.step, gobilda_1401_0043_0036_mount_proxy.step, paddle_blade.step, paddle_launcher_feasible_nectar.step, paddle_launcher_feasible_nectar.stl, paddle_launcher_feasible_pollen.step, paddle_launcher_feasible_pollen.stl, shooter_slotted_side_plate.step]
2026-10-01 Import T06 vendor CAD as one-solid components
    [feeder_support_cheek_reference.step, gobilda_1401_0043_0036_mount_official.step, paddle_blade.step, paddle_launcher_feasible_nectar.step, paddle_launcher_feasible_nectar.stl, paddle_launcher_feasible_pollen.step, paddle_launcher_feasible_pollen.stl, shooter_slotted_side_plate.step]
2026-10-02 Adopt whole-part vendor representation and publish the geometry inspection report
    Purchased components now enter the T06 launcher assembly as whole official goBILDA parts instead of boolean-unioned single solids. DEC-0021 supersedes DEC-0020 because the union chain failed measurement: fusing 1309-0016-4008 took over 3 minutes and lost 29.44 mm3, 1401-0043-0036 gained 3.7 mm3, and OCC returned empty results that still reported isValid() == True.
    Geometry inspection run R004, read from the final solids rather than the printed parameters, reports 77 pass / 0 fail / 0 not_run / 0 unresolved across 23 specification checks over 196 part instances, with a 383.8495 x 364.77 x 400.0238 mm envelope i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
    [feeder_support_cheek_reference.step, gobilda_1401_0043_0036_mount_official.step, paddle_blade.step, paddle_launcher_feasible_nectar.step, paddle_launcher_feasible_nectar.stl, paddle_launcher_feasible_pollen.step, paddle_launcher_feasible_pollen.stl, shooter_slotted_side_plate.step]
2026-10-03 Add motion-version launcher extract (moving parts + ball path)
    New --profile motion_free on cad/paddle_launcher_motion_only.py keeps only the paddle rotor body, the Gecko flywheels (with their shafts) and the guide/throat ball path; motors, servos, couplers, Sonic hubs and the three paddle_hinge_* rotor pins are dropped. Shapes are copied from paddle_launcher_constrained.build() without re-solving placement, so relative positions and the ramp geometry are identical to the parent file. Parent feasible_* / motion_only_* outputs are untouched.
2026-10-03 Adopt nylon cable tie for the launcher backflow finger
    DEC-0022 records that the two one-way fingers at the 52 deg guide entrance are realised as standard nylon 6/6 cable ties, and materials.backflow_finger in config/parameters.yaml carries the modelled section (4.7 x 1.14 mm) and generic nylon properties, all ASSUMED until a purchased tie is measured. Also exports the motion version with those fingers included (33 parts / 40 solids); the finger-free variant stays as the default.
2026-10-04 Redo the T06 POLLEN feeder as a coaxial one-piece shell with a 5 deg tray
    - add cad/paddle_launcher_feeder_redesign.py: V2 feeder derived from
    cad/paddle_launcher_constrained.py (parent module untouched, every
    earlier export keeps its timestamp)
    - DEC-0023: the shell arc and the tilted tray are drawn as one closed
    profile about the paddle axis, so coaxiality is a construction fact;
    the 142 deg release ball centre lands 0.0022 mm off the 52 deg channel
    centreline
    - DEC-0024: drop guide_floor_1/2/3, guide_roof_1/2, guide_wall_1+/-1,
    guide_wall_2+/-1 and both one_way_finger_+/-1; the 5 deg tray roll plus
    the 225 deg lip wedge takes over backflow, superseding the DEC-0022
    finger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
    [model_paddlem_spinm.xml]
2026-10-04 Simulate each T06 POLLEN V2 contact-geometry option and select the two-finger feed
    [model_v2_p40.xml, model_v2_rest_p100.xml, model_v2_rest_p200.xml, model_v2_rest_p25.xml, model_v2_rest_p320.xml, model_v2_rest_p40.xml, summary_v2_servo_req.json]
2026-10-04 Record DEC-0025: two-finger feed layout with lip flare, archive options B and C
2026-10-04 Record DEC-0026: re-measure T06 feed torque threshold with a 12 s budget, reopen the servo question as feasible
    The 7 s-budget thresholds (0.94 / 0.46 N*m) mixed in feed-creep time: the ball can sit in the rest pocket for seconds before a finger grabs it, so speeds 30/40/60/70/75/145 rpm failed even at 3.0 N*m. With a 12 s budget and dual tray entry (x=145/138) those speeds all launch and the R5 threshold drops to 0.24-0.47 N*m.
    Consequences: R5 (two fingers 350/170 + 6.8 mm rest pad) replaces R2 as the recommended feed geometry; the servo question flips from NOT SATISFIED to feasible, with goBILDA 25-4 Super Speed @7.4 V recommended (window 30-70 and 80-122 rpm). Old numbers are kept as SU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
2026-10-04 Record DEC-0027: smooth shell-to-pad arc (R6) is only 1.5% faster; creep is a rest-pocket jam, not a junction step
    [_r6_motor.json, _r7_motor_sweep.json]
2026-10-04 Record DEC-0028: glossy plastic ball vs 0.4 mm PET shell gives mu~0.40 (ASSUMED); R5 feed fails below mu~0.65, bottleneck is the feed stage not the flywheels
2026-10-04 T06 R26: 一套送球段同时兼容 NECTAR/POLLEN，只有飞轮夹口随球改变
    - 新增共用生成器 cad/paddle_launcher_feeder_a_prime_shared.py（父模块 constrained 一行未改），
    外罩/托盘/拨杆为单套几何，两变体差异只剩飞轮轴距 89/80（夹口 82/64 mm）。
    - 实测（读自导出前最终实体）：夹口 82.000/64.000 逐对吻合；外罩体积 267723.34 mm3、
    bbox、毂—外罩内弧 95.974 两版完全相同 -> 同一装置的充要证据。
    - 几何检验 tools/inspect_geometry.py：hub pass 6/6、shell pass 7/7。
    - 仿真（MuJoCo，mu=0.40）：R29 48 组 / R30 12 组，两球全部发射成功（12/12）。
    - 记录 DEC-0030（DEC-0029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
    [_r17_nectar_servo.json, _r25_nectar_feeder_shell_tray.step, _r25_nectar_paddle_hub.step, _r26_shared_feeder_shell_tray.step, _r26_shared_paddle_hub.step]
2026-10-04 T06 R27: 共用外罩让位，消除与保留父级结构的既有干涉（DEC-0031）
    - 生成器 cad/paddle_launcher_feeder_a_prime_shared.py 新增 RELIEF_PARTS /
    RELIEF_CLEARANCE_MM=0.5 与 _grow()/_relieve_shell()：对 shooter_throat_+55、
    guide_roof_3 各自外扩 0.5 mm 后对 feeder_shell_tray 做布尔差。
    切削区全在球道外侧 r>107.974，球接触的内弧面未动。
    - 教训：BRepOffsetAPI_MakeOffsetShape 必须逐 solid 调用；喂 compound 会被 OCCT
    当成外表面偏移而返回更小的实体（38596 -> 20737 mm3），第一版因此静默回退成
    零间隙切割。_grow() 现逐 solid 外扩并校验体积，报告另存 relief_clearance_mm。
    - 实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
    [_r27_shared_feeder_shell_tray.step, _r27_shared_paddle_hub.step, _r27_shared_relief_context.step]
2026-10-04 T06 R27: 增加整机 STEP 完整性/零件清单核验脚本（装配交付前核对）
2026-10-05 T06 R32: R27 几何下 NECTAR/POLLEN 各自正确夹口的全流程仿真复核（6/6 通过）
    - 新增 simulation/mujoco/_work/r32.py：同一套 R27 送球段，逐球只改飞轮夹口
    （half_spacing = nip/2 + 48 -> NECTAR 82 mm / POLLEN 64 mm），索引式驱动
    （停 1.2/3.0 s -> 一次扫掠 248/260° -> 释放），舵机 25-4 Super Speed 线性
    模型（0.530 N·m / 290 rpm，kv=0.017452），飞轮 1620 rpm，mu=0.40。
    - 结果 6/6 通过：NECTAR t=2.18/3.97/3.97 s、v=4.79-4.82 m/s、出口角
    50.5-51.8°、卡滞 10%；POLLEN t=1.83/3.38/3.37 s、v=6.18-6.20 m/s、
    出口角 51.6-51.8°、卡滞 0-3%。与 DEC-0030 的 R29/R30 同口径一致。
    - 球路：由右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
2026-10-05 T06 可视化：看小球被送球、发射、飞出的全过程（view_r32.py）
    - 新增 simulation/mujoco/view_r32.py：交互窗口（mujoco.viewer，默认 4 倍慢放、空格暂停、跑完自动重播）+ 无头 GIF 导出（出射前固定看机构，出射后自动把出射点与球一起框住并拉远，橙色点串显示飞行轨迹）
    - 把 _work/r32.py 的 run() 机械拆出 build()，供可视化复用；物理口径未改，重跑 r32.py 逐项数值与提交版一致（NECTAR A 2.18 s / 4.81 m/s、POLLEN B 3.38 s / 6.18 m/s，仍 6/6 通过）
    - 产物：cad/output/_t06_r32_launch_nectar.gif（107 帧 / 2.68 s）、cad/output/_t06_r32_launch_pollen.gif（93 帧 / 2.33 s）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
2026-10-05 T06 R35: 飞轮硅胶离心膨胀计算 + 热态配间距（DEC-0032 / V-0034）
    膨胀：goBILDA 3613-0014-0096（Ø96x24 30A 硅胶）@1620 rpm 三模型
    M1 自由薄环 2.44-5.23（上界）/ M2 0.55-1.19 / M3 固支 0.26-0.55 mm。
    设计 dr_hot = 0.8 mm，绝对上界 3.7 mm。存能 1.85 J/轮，两轮 3.70 J。
    接触判定：拨杆外切 R62.36，冷态间隙 NECTAR 5.55 / POLLEN 3.51 mm；
    dr=0.8 后余 4.75 / 2.71 mm；上界 3.7 仍余 1.86 / 0.57 mm 且零接触。
    送球几何不改，只把垫片长度改为按热态外径配：
    half_spacing = nip/2 + 48 + dr_hot -> 89.8 / 80.8 mm，运行夹口回到 82 / 64。
    仿真：R33 冷态配间距 26/36（接触 3 起全在 POLLEN d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
2026-10-12 T06 R36: 多球进料实测结论与经验教训入库（DEC-0033/0034、V-0035）
    - DEC-0033 口径标定：净距只用 MuJoCo 探针（本模型米制，必须 x1000；distmax 会把
    >60mm 的净距截断成 +60）；仿真相位必须几何标定（ph0=60 才是 CAD 零位 330/150，
    ph0=0 时叶片其实在 30/210）；「出膛」必须带速度门槛，否则地板滚球会被记成出膛。
    - DEC-0034 结论：托板上「等待球」原理上不成立 —— 叶片扫掠带 r=46~60mm，托板球心
    距轴心只有 62~93mm、球径 >=71mm，实测每个 180 度周期都被打出 -4.0~-39.1mm 穿透；
    容量 NECTAR 1 颗 / POLLEN 2 颗，「4 颗紧密排队」几何上不可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
2026-10-12 T06 R36: 同步记录 Linear KEI-19 与 Notion 页（经验教训入库收尾）
2026-10-12 T06 R37: 多球进料方向 B（托板 150->215，等待区搬出扫掠圆）+ 自制件重叠清理（DEC-0035 / DEC-0036 / V-0036）
    方向 B：TRAY_X1 150->215 mm，容量 NECTAR 2 / POLLEN 3，等待球全部在扫掠圆外（除第 1 颗待推球）。
    (b) 清理：拨杆并为 1 个 paddle_rotor、TPU 尖缩到 r 58..60、guide_wall_3_+/-1 按 0.5 mm 让位、托板与球道弧并为一个实体、轮毂孔改 O12.1。自制件重叠全 0。
    几何检验 R005 4/4 pass（tools/inspect_geometry.py，退出码 0）；项目测试 40 pass。
    父模块 paddle_launcher_constrained.py / feeder_redesign.py / feeder_a_prime*.py 未被修改；R27/R35 源文件与产物保留。
2026-10-12 T06 R37: 多球仿真入库（NECTARx2 12/12、POLLENx3 15/18，V-0037）
2026-10-12 T06 R38: NECTAR 夹口 82->86 重算（DEC-0037 / V-0038）+ 送球节拍瓶颈定位（拨杆扭矩饱和）
2026-10-12 T06 R39: 送球道低摩擦内衬（外罩+托板双面 0.5mm PTFE）——清空 47.1s→10.0s、卡滞 72%→1%（DEC-0039 / V-0039）
2026-10-12 T06 R40: 低摩擦内衬标准相位复核 —— 「全清 6/6」不成立（DEC-0040 / V-0040）
    标准六相位 0/30/60/90/120/150（tray=285，mix P>N>P>N，hold 3.0s）复核 R39 遗留未知：
    - 内衬 mu=0.05 双面：出膛 21/24、真出膛 19/24（压 --sw-delay 到 0.05s -> 21/24）、全清 4/6、清空 8.4-8.5s、卡滞 1.1-1.5%
    - 对照 mu=0.60 无内衬：出膛 24/24、真出膛 24/24、全清 6/6，但清空 57.2s、卡滞 75.6%
    - 外罩 0.05 + 托板 0.15 / 0.30：全清 5/6
    - 旁证：11 相位扫参（含 R39 的 6 个旧相位，39 颗）出膛 30/39、真出膛 20/39、全清 6/11，同向
    => 低摩擦买到的是「速度」不是「可靠性」；R39/V-0039 的「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
2026-10-12 T06 R41/R42: 降摩擦/降压力路线关闭 —— 三杠杆判决性对照后真出膛锁定 19/24（DEC-0041 / V-0041）
2026-10-12 T06 R43/R44: 被动分球挡球件 B1/B2 判决性否决 —— 两案同为死墙 6/24，保留无挡件 19/24、5/6，托板加长 350 mm 零影响（DEC-0042 / V-0042）
    - B1（贴托板铰 + 弹性片）/ B2（上铰 + 自重挡爪）同口径 6 相位 x 4 颗：真出膛均 6/24、全清 0/6；无挡件对照 19/24、5/6；18 组参数扫描全部过不去
    - 机理：B1 打开后片体自身成为 72 度斜坡（球只能爬 5 度）；B2 上铰离托板仅 53 mm，爪尖上限即 53 mm，NECTAR 通过需 >= 94 mm
    - 原理性结论：单颗球驱动力 0.05/0.11 N，整条 4 球队列全部推力约 0.15 N，与「挡得住」门槛同量级 => 被动分球没有可分区间
    - 加长托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
2026-10-12 T06 R45: 主动索引闸 = 竖向全宽挡舌 x=180 + 真实舵机待机停位保持 —— 侧向摆入判决性否决，6 相位 x 4 颗真出膛 24/24、全清 6/6（旧 21/24、5/6）（DEC-0043 / V-0043）
2026-10-12 T06 R45 补充：停位角窗示意图 + 待机角扫描日志（DEC-0043 证据）
2026-10-12 T06 R47 提速：闸板后移 / 减小行程 / 纯几何改喉口三条路判决性否决 —— 改为「外罩内弧 135->258 度 + 托板顶面」单侧贴低摩擦胶带（mu=0.30），零几何改动下 6 相位 x 4 颗真出膛 24/24、全清 6/6、清空 5.22-5.28 s（旧 66.2 s），约 13 倍提速（DEC-0044 / V-0044）
    - 慢的根因是摩擦楔自锁（喉口「叶片顶端 <-> 出口唇」），拨杆全程贴 0.530 N.m 堵转；290 rpm 整圈仅 0.207 s，而每颗球 15-23 s、卡滞 77-89%。
    - 闸板后移 x=220/240：清空掉到 35.4/16.5 s 但真出膛 2/4（后移连带把整列球往后推、闸口让给球 => 闸板失守）；--sweep 120/200 与基准逐位相同（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
2026-10-12 R47 修正：示意图拨杆由误画的 3 叉改回与模型一致的 2 叉（330/150）
    - 仿真模型一直是两叉（r37_multiball.py:54 parts(phases=(330.0,150.0))，:202 调用未传参），
    全部仿真数据（含接触测绘 paddle_blade_1/2、paddle_flex_1/2）均基于两叉、有效；错的只是绘图脚本 _r47_fig.py:46 手写的 (30,150,270)。
    - 已把绘图相位改为 330/150、弹性指半径 58->59 与模型对齐，重出 _r47_tape_section.png。
    - 教训写入 V-0044 陷阱第 4 条：示意图的机构相位必须与模型同源，不得在绘图脚本里手写自由度。
2026-10-13 T06 R47 交付：台架 MJCF 落盘（4 份 XML + 驱动/生成脚本）+ 混装换档缺陷修复
    - 新增 simulation/mujoco/out/R47_launcher_{mixed4_gap064,mixed4_gap082,4xPOLLEN_gap064,4xNECTAR_gap082}.xml
    每份含 6 个 keyframe ph000..ph150（初始球列 + 拨杆起始角）；编译期数组改动（摩擦 / priority /
    径向让位）按 geom 名回注 XML 文本，并与捕获模型逐项比对通过（geom 名/摩擦/priority/pos/size、
    keyframe0 qpos、nq/nv/ngeom/nbody/nu）
    - 新增 simulation/mujoco/run_R47_xml.py（MJCF 驱动：挡舌 mocap z 47.5<->139.5 mm 抬落 + 待机停位
    保持 188 deg Kp=40 + 混装自动换档）；修复 --pair 把路径字符串当 Rig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
2026-10-13 T06 R47: auto gear-shift for mixed4 (random layout) + view docs + mix ph0 log
2026-10-13 T06 R48 运动部分几何核对 + 桌面 Fusion 交付（DEC-0046 / V-0046）
    - 新建 docs/engineering/t06-motion-part-geometry-baseline.md：运动部分坐标/半径/相位/间距唯一主索引，
    含来源版本表 S1-S14（KNOWN/CALCULATED/SIMULATED/MEASURED 逐条标注）
    - 版本核对：桌面 T06_R37_{pollen,nectar}.step 与仓库 _r37_stage STEP 逐字节相同
    （SHA256 80CB3ED0...1966），与几何检验 R005 输入同一哈希，无需重做
    - 几何独立复算：16 部件 930299.1 mm3（发布 930299.9）；拨杆轴心 (29.49,0,111.46) 零偏差；
    轮轴距 161.60/179.60；冷态 65.60/83.60 - 2*0.8 = 热态 64.0/82.0；TPU 尖 30/210 两叉
    - 交付桌面 T06_moti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
2026-10-13 T06 R49 闸门驱动：舵机换 25-3 + 行程 92->72 mm + 支架横梁收边（DEC-0047 / V-0047）
    - 生成器 cad/paddle_launcher_gate_drive_r49.py / _view.py（只读复用 R37 staging / R39 内衬 / 采购件 STEP，未改原文件）
    - 舵机 2000-0025-0002 -> 2000-0025-0003（25-3 Speed，出厂默认位置模式，能保持闸门位）；同壳同花键，支架/曲柄/连杆接口不变
    - 挡舌行程 92 -> 72.074 mm（中心 47.5 -> 67.482，下端 20.0 -> 40.0，仍低于 pollen 球心 15 mm）
    - 支架横梁收边 x 165..205 -> 176..204、y 34..72 -> 34..62，与绿腿外面齐平；支架 56352 -> 44704 mm3
    - 干涉复检 frame x bracket / blade / rod：2 姿态 56 组全部 0 m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
2026-10-13 T06 R49 收尾：PROJECT_STATUS 记录导出回读与同步（646df70 / KEI-21 / Notion）
    - R49 交付项补导出证据：420.2 s、187,367,519 B，回读复核 27 件 / gate_frame 44704.0 mm3 / bbox x 175..204 / 下端 40.0 / 舵机 2000-0025-0003（pass）
    - 记录桌面旧件 T06_gate_drive_R48_pollen.step 改名 SUPERSEDED 保留历史
    - NEXT ACTION 0.4「已完成」补导出 / 文档 / 推送 / Linear / Notion 状态
2026-10-13 T06 R50 发射部分驱动化 + 支撑结构（飞轮马达 x2 + 拨杆舵机 + 双侧框架 / DEC-0048 / V-0048）
    在 R37 运动件与 R49 闸门之上补齐发射部分的驱动链与承载框架，R37/R47/R49
    生成器与产物一律只读复用、不覆盖，新产物写入 cad/output/_r50_drive/。
    - 飞轮驱动 x2（-Y 侧）: goBILDA 5203-2402-0003 + 1401-0043-0036 夹具
    + 4007-4008-4008 联轴器；两根 8 mm REX 飞轮轴各自直驱，外置齿轮数 0。
    - 拨杆驱动 x1（+Y 侧）: goBILDA 2000-0025-0004（25-4 Super Speed）
    + 1802-0043-0001 支架 + 4001-0025-4008（25T -> 8 mm REX）联轴器。
    - 支撑框架: 双侧 6 mm 打印面板（三个轴心 R34 凸台 + 44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
2026-10-13 T06 R51/R52 发射部分换基线：滑窗独立轴底座 + 送球件换装（DEC-0049 / V-0049 / DEC-0050 / V-0050）
    R51（换基线 / 滑窗）:
    - 基线改用 cad/output/paddle_launcher_feasible_pollen.step（2026-10-01 22:36 / 414.3 MB / 98 件）
    即「只保留运动部分」之前最新一版；该版已是「两飞轮轴各自独立 + DEC-0037 调隙链」拓扑
    - 侧板开口 8.4 x 9 轴槽 -> 59 x 56 滑窗（窗 n 跨 56.5..112.5，导轨侧隙 0.5 mm）
    夹口行程 64.0..86.4 mm，覆盖 pollen 64.0 与 nectar 86.0（bffe0 需求）
    - 拨杆舵机 2000-0025-0003 -> 2000-0025-0004
    - 轴隔离：rigid_link_between_axles = []；侧板 15 组布尔 x 2 档全 0 mm3
    R52（换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
2026-10-13 T06 R51 滑窗对比示意图：8.4x9 轴槽 vs 59x56 滑窗（含导轨 0.5 mm 侧隙与两档滑座跨距）
2026-10-14 T06 R53b 滑座自动夹紧：取消人工蝶形螺母，改常闭弹簧夹 + 两侧锁紧长槽（DEC-0051 / V-0051）
    判据（用户）：「停，在比赛中人不能介入去动结构，我希望该结构可以利用已有舵机自动调节」
    => R53 的蝶形螺母手动锁位作废。
    - 紧固件栈改 M4 螺柱 + 压缩弹簧（O5.5 / 自由 8.4 / 装好 6.0, k=1.24 N/mm => 3 N/颗）
    + 平垫 + M4 尼龙锁紧螺母；弹簧常压耳板 => 断电也锁住（fail-safe），
    预载小到现有 25-2 调隙舵机 (2000-0025-0002) 照旧推得动 => 换档仍自动完成，
    不需要人工 / 新舵机 / 新通道。
    - 修掉 R53/R53b 第一版真干涉：锁紧长槽原来只开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
2026-10-14 T06 R53c 调隙链全行程复核：弹簧夹不妨碍已有 25-2 自动换档（V-0052）
    判据：用户指令「停，在比赛中人不能介入去动结构，我希望该结构可以利用已有舵机自动调节」。
    V-0051 只算了两个端点，本轮把 DEC-0037 调隙链在整个行程 80.0..91.2 半间距上按虚功扫一遍
    （T_req = 2 f |dh/dtheta|，225 点，theta(h) 二分反解）：
    - 最不利点 POLLEN 端 h = 80.05：0.317 N.m (mu=0.30) / 0.634 N.m (mu=0.60) = 堵转 2.471 N.m 的
    12.8 % / 25.6 %，余量 7.8x / 3.9x；NECTAR 端只要 0.091 / 0.182 N.m（余量 27x / 14x）
    - 杆件力最大：主连杆 39.6 N（屈曲上限 134 N 的 29.6 %）、拉杆 55.3 N（2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
2026-10-14 T06 R53d 调隙动力学复核：常闭弹簧夹锁着时，现有 25-2 舵机 50 次来回自动换档全部到位（V-0053）
    判据（用户 2026-10-13）：「停，在比赛中人不能介入去动结构，我希望该结构可以利用已有舵机自动调节」。
    V-0052 已证静力全行程推得动（最不利 0.317 / 0.634 N.m = 25-2 堵转的 12.8% / 25.6%），本轮补动力学：
    把 25-2 的力矩-转速线 T(w) = T_stall (1 - |w|/w_noload)、弹簧夹摩擦 T_load = 2 f |dh/dtheta|、
    杆件弹性一起积分（J = 1.0e-4 kg.m2、Kp = 200 N.m/rad 均为 ASSUMED），来回换档 50 次。
    结果（CALCULATED）：PASS
    - 50/50 全部到位，0 次堵转 / 0 次超时；单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
2026-10-14 T06 R53e 在线换档工况复核：全自动、无人介入、夹口守得住（V-0054）
    用户裁定换档需要比赛中在线进行，并重申比赛中人不能介入。
    R53e 用 R53c/R53d 同源链几何 + 球动量估的发射反力复核三件事：
    - 时序：单次换档 0.354 s（曲柄 77.35 deg），排一次 0.45 s，12 次/场占空比 3.6 %
    - 保持：发射反力 37.5 / 81.3 N 每滑座 < 舵机保持 112 / 390 N；夹紧件仅 14.4 N，
    即发射时守夹口的是舵机、夹紧件负责断电保持与抗蠕变；夹口偏移峰 0.41 mm、回弹 0.00 mm
    - 端点：nectar 档距死点 0.537 mm，固件窗口 19.33 .. 96.68 deg
    结论：比赛全程没有任何需要人碰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
2026-10-14 T06 R53f/R53g 锁紧件定长限位环：预载从「靠手感」变成「靠几何」（DEC-0052 / V-0055 / V-0056）
    判据（KNOWN，用户 2026-10-13）：保留调隙舵机 2000-0025-0002 + 加锁紧件，锁紧件不得
    影响正常位置改变；换档必须比赛中在线进行、全程无人介入（V-0054 已证）。
    R53g 先扫边界（cad/paddle_launcher_gap_chain_preload_limit_r53g.py，与 R53d/R53e 同源积分）：
    - 名义 2.98 N 只占 25-2 堵转 25.6 %（mu=0.60）/ 12.8 %（mu=0.30）
    - 吃掉 60 % 余量的门槛 7.0 N / 14.0 N；真正顶停 12.0 N（mu=0.60，0.35 -> 2.7 s 后失效）
    - => 靠手感拧螺母有 4 倍以上过拧空间
    - 口径修正（务必保留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
2026-10-14 T06 收尾：关闭 R53d/R53e 遗留的两处过时提示（在线换档已裁定、定长套筒已由 R53f 完成）
2026-10-14 T06 R53f 剖面图入库：采用方案（弹簧外刚性定长限位环）vs 已否决方案（螺柱外细套筒）并排
    - 新增 cad/_r53f_section.py + cad/output/_r53f_lock/T06_R53f_限位环剖面.png（桌面同名）
    - 修掉脚本里 3 处 U+21D2（微软雅黑缺字形）=> 改为 "=>"，重跑后无字体警告
    - PROJECT_STATUS.md 0.6 节：已量（V-0055/V-0056）补图引用；新增「交付」行
    - docs/decision_log.md V-0055：Date/version 行补图与脚本
    - config/parameters.yaml t06_lock_seat_r53f：补 figure 字段（27 个顶层键，YAML 可解析）
2026-10-14 T06 收口：用户确认「换档需要比赛中在线进行」=> 关闭 R53b 遗留的两处「未答」
    - PROJECT_STATUS.md R53b/R53c/R53d 节：④换档是否需在线进行 => 已答：需要（V-0054）；⑤是否加凸轮主动解锁 => 不需要（已有 2000-0025-0002 完成）
    - config/parameters.yaml t06_shooter_lock_r53b.open_question：同步关闭①②（YAML 27 个顶层键，可解析）
2026-10-14 T06.12 R53f/R53h: 锁紧件报告自洽修正 + 溯源纠错 + 逐件对比
    - 生成器：写报告前用几何值覆写 clamp_calc.preload_n_per_stud（3.0 -> 2.976 N）
    并写入 preload_source，补 mu 0.30/0.60 摩擦与「舵机仍能推动」判定
    - 溯源陷阱：_r53f_lock/report_r53b_*.json 是 R53b 模块在 R53f 运行时写的同名
    副产物（已含 16 件环），已改名为 report_r53f_deps_r53b_module_*.json，生成器
    加自动改名；真基线只取 cad/output/_r53b_auto/
    - 新增 cad/_r53f_compare_base.py：真 R53b vs R53f 逐件比 volume + bbox
    => 两档均 +16 件（全为 carriage_clamp_seat_*）、-0 件、位移 0 件、bbox 偏差 0.00 mm
    - 两档已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
2026-10-14 T06.12 R53f: 回读复算（STEP 重新导出后一致）
    重跑 cad/_r53f_readback.py（本轮 22:27 重新导出的 STEP）：两档各 370 solids、
    体积偏差 -0.0001 %、包围盒 6 面偏差 0.00 mm、限位环 16 件件件 148.49 mm3、
    夹口 64.0 / 86.0、预载 2.976 N；仅 import_s 变化 => 本轮重导出的 STEP 与上一版
    几何完全相同。
2026-10-14 T06.12 R53f: 补 V-0052/0053/0054 的预载输入口径说明（3.0 N vs 锁定 2.976 N）
    - V-0052/0053/0054 的积分用的是 R53f 之前的靠手感名义预载 3.0 N/颗，比 R53f
    几何锁定值 2.976 N 高 0.8 % => 保守（摩擦被高估），三份结论无需改动。
    - V-0056 的 1.0..20.0 N 扫参已把 2.976 N 夹在 2.5 N（10.7 / 21.4 % 堵转）与
    3.0 N（12.8 / 25.6 %）两行之间，两行均 ok => 「锁紧件不影响正常位置改变」
    不依赖 3.0 这个具体数字。
    - 文档：docs/decision_log.md V-0055、config/parameters.yaml
    t06_lock_seat_r53f.r53cde_preload_caliber、PROJECT_STATUS.md 0.6。
2026-10-14 T06.12 R53f: 夹紧态口径复算（0.30 mm 建模间隙 vs 装配后归零）
    - docs/decision_log.md V-0055 追加「夹紧态口径说明」：EAR_GAP = 0.30（报告
    ear_to_plate_min_gap_mm = 0.3）是零件化建模的 running clearance，不是装配后的
    间隙；装配后弹簧预载把两侧耳片压到板面上，0.60 mm 归零 => clamp_calc 的
    faces = 2.0 只在归零后成立（未夹紧态夹紧摩擦为 0）。
    - 新增复算 cad/_r53_clamp_caliber.py -> cad/output/_r53f_lock/caliber_clamp_interface.json
    (CALCULATED)：建模态链长 head->平垫 = 3.0+0.30+4.0+0.30+3.0+6.0 = 16.6 mm；
    螺母拧到限位环端面贴合 => 弹簧 6.0 => 2.976 N/颗（名义）；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
2026-10-14 T06.12 R53h: 锁紧件对换档的几何免疫（不依赖预载数字）+ 保持力口径澄清
    - 新增 cad/_r53_lock_immunity.py -> cad/output/_r53f_lock/immunity_r53_lock.json
    (CALCULATED)，三段：
    (1) 几何免疫：预载反解成环长 preload(L) = k x (free - L)，k = 1.24 N/mm、
    free = 8.4 mm。吃 60 % 堵转余量的门槛对应环长 2.74 mm（mu = 0.60 支配
    工况；mu = 0.30 为 -2.92 mm），硬顶停要 -1.28 mm（几何不可能）=> 安全窗口
    [2.74, 8.4] mm，名义 6.0 mm 余量 3.26 mm => 只要环长不超弹簧自由长，
    锁紧件在几何上不可能顶停 25-2，失效方向只有「锁不住」。
    (2) 保持力口径：夹紧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
2026-10-14 T06 溯源补录：decision_log 引用的 8 个复算/回读脚本入库
    这 8 个文件此前只存在于工作区且被 docs/decision_log.md 引用，克隆后引用会断链：
    - _r45_show.py、_r48_hit.py、_r48_view.py、_r49_reg.log、_r49_reg2.log
    - cad/_r50_readback.py、cad/_r52_readback.py、cad/_r52_axle_isolation_step.py
    同时清理工作区里 269 个纯临时件（_patch_*/_probe_*/_fix_*/日志/中间图），
    它们未被任何已跟踪文档引用、全部 < 1 MB。simulation/ 与 cad/output/ 产物一律保留。
    status: 仅入库与清理，几何与结论不变。
2026-10-14 T06.12 R53h-2: 弹簧采购包络 —— 锁紧件不顶停换档不再依赖未实测的 k
    R53h 的几何免疫用 k = 1.24 N/mm（未实测）。CAD 环长固定 6.0 mm 时
    预载 = k x (L0 - 6.0) 完全由买到的弹簧决定 => 偏硬的弹簧可能反过来吃掉
    60 % 堵转余量。本轮把它钉成可采购、可实测的规格。
    - 新增 cad/_r53_spring_envelope.py -> cad/output/_r53f_lock/spring_envelope_r53h.json
    (CALCULATED)：
    * 规则：预载 = k x (L0 - 6.0)，只要 <= 7.02 N（V-0056 的 60 % 余量门槛，
    mu = 0.60）就不可能出现「顶停换档」；>= 1.5 N 才算夹得住。
    * 采购规格：OD <= 5.6 mm（塞进环内径 5.7）、ID >= 4.1 mm（套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
2026-10-14 T06.13 工作根路径迁移：仓库与桌面交付件复制到 C:\FTC design\FTC 2026 biobuzz
    - AGENTS.md 写入工作根路径约定（Canonical = C:\FTC design\FTC 2026 biobuzz），旧 OneDrive 路径降为历史副本
    - .gitignore 忽略 deliverables/（桌面交付件归档，66 文件 / 5.98 GB）
    - PROJECT_STATUS.md 记录迁移方式与校验结果：14311 文件 / 18.414 GB 与源逐字节一致，HEAD aecce3d
    验证：.venv-cad 在新路径下 sys.prefix 正确、import cadquery 通过；桌面 66 文件逐文件名与字节一致。
2026-10-14 T06.14 工作根路径收尾：交付件收敛到 48 个、旧 OneDrive 路径清空并待建联接
    - deliverables/ 只保留项目相关文件：48 个 / 5.651 GB；删除 18 个非项目文件（快捷方式、个人 PDF/图片/压缩包、THIRD_PARTY_NOTICES 等）
    - 旧 OneDrive 路径内容已校验后清空；目录联接尚未建立（该路径仍被本次 Codex 会话作为工作目录占用）
    - 新增一键脚本 C:\FTC design\link_old_path.ps1 / .cmd，已过 parse 检查与锁检测演练
    - AGENTS.md / PROJECT_STATUS.md 同步为当前真实状态（含联接未生效时的使用约定）
2026-10-14 T06.15 旧 OneDrive 路径目录联接已生效
    - C:\Users\admin\OneDrive\文档\ChatGPT\FTC 2026 biobuzz 现为 Junction -> C:\FTC design\FTC 2026 biobuzz
    - 实测：经旧路径读 AGENTS.md 6970 B、git log = 9881e8b、与 origin 同步；写入测试落在 Canonical 路径后已清理
    - AGENTS.md / PROJECT_STATUS.md 改为记录联接已生效、OneDrive 风险与本地无备份的待办
2026-10-14 T06.16 R54: 打印主体合并为一个件 + M3 贯穿螺栓装配（无自攻，DEC-0053）
    按用户 2026-10-14 指令：考虑实际装配合理性 / 极少零件数（托板与外罩合一、
    侧板与外罩连起来）/ 3D 打印便利 / M3 螺丝；不用自攻，两个构件都贯穿，
    一头螺栓一头螺母。
    - 12 件 + 16 筋 + 2 补缝块 + 4 导轨腿 => solids = 1（V = 1052724 mm3，回读 STEP 同为 1）
    - 6 个 M3 贯穿接头 0 跳过：4 x 导轨腿<->底座导轨、2 x 闸门预留（各穿两侧侧板）
    - 剔除全部 33 个厂商件与 9 个闸门实体，闸门只留孔
    - 修两处无效连接：侧板底 z=33.6 与导轨顶 z=16 之间 17.6 mm 悬空（新增导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
2026-10-14 T06.16 R54 文档同步：DEC-0054 只交付 pollen 版 + Linear KEI-24 / Notion 记录
2026-10-14 T06.17 R54 关节实测：4/6 M3 接头不可装配（DEC-0055）
    - 4 条导轨腿孔轴 (x 60/76, y ±70) 落在侧板 y 68..72 的 V 形下缘上：沿轴只在 z 38..80 有料，z 17..38 是空腔 => 盲孔
    - 打印件与底座导轨零重叠（frame ∩ rail 包络 0.00 mm3）；导轨侧 O4.6 孔存在，与腿轴同轴
    - 空间侧实测足够（外侧 y 83..120 全空；导轨下方 z -20..1 全空）=> 只是孔不通
    - 闸门预留孔 2 条（4 孔）可达性 pass
    - 候选修法 A（轴外移到 y ±74.5 + 腿/导轨各钻 O3.4）/ B（外侧夹箍）/ C（抬高侧板 V 形下缘）待裁决
    - 新增只读探针 cad/_r54_joint_reachability.py, cad/_r54_fit_probe.py, cad/_r54_axis_s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
2026-10-14 T06.17 R55：DEC-0055 修法 A 实施 + 6/6 M3 接头复核 PASS
    用户 2026-10-14「就A了」=> 采纳修法 A：4 条导轨腿螺栓轴 y = ±70 -> ±76.0，
    腿 y 向加宽 12 -> 16 mm（腿 y 68..84），避开侧板 y 68..72 的 V 形下缘盲孔。
    钻头加长到 60 mm（z -4..56）一次穿透「腿 + 导轨」；修 DRILLABLE 白名单。
    构建（cad/output/_r55_run.log，2417.9 s）：
    solids = 1，V = 1 058 193 mm3（R54 = 1 052 724），
    bbox x[-147.22, 215.26] y[-84.00, 99.00] z[-3.51, 401.02]，4 接头 0 skipped。
    回读复核（cad/_r55_joint_reachability.py -> report_r55_joint_reachability.json）：
    VERDICT PASS (4/4 rail joints through + 4/4 gate reserved holes)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
2026-10-14 T06.17 R55 验证：加宽后腿的全实体干涉复核 PASS（0.000 mm3）
    新增只读探针 cad/_r55_fit_probe.py -> report_r55_fit_probe.json。
    核心判据：frame ∩ (assembly - frame) 的实体体积。
    实测（MEASURED）：
    frame（1 solid，V = 1 058 193 mm3）与 assembly - frame（138 solids，
    V = 478 355 mm3）重叠体积 0.000 mm3，无 > 0.01 mm3 的重叠体 => PASS。
    新增材料条带 x 54..82 / y 80..84 / z 16..48：frame 2880.00，其他件 0.00 mm3。
    腿脚投影盒内其他件 0.00 mm3；导轨外侧下方 y 84..100 两侧全空。
    腿顶上方整机 6x6x22 mm 进刀柱 4 处全空 => 螺栓头 + 螺丝刀路径在装配状态通畅。
    腿柱体积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
2026-10-14 T06.17 R55 收尾：打印可制造性量测 + 对称差回归 PASS + 闸门/朝向移交
    - V-0060: R55 主体单件 362.5 x 183.0 x 404.5 mm，任意摆向下最小建板 405 x 362 mm，
    常规机型装不下 => 单件不可打印；as-drawn 向下面 31 425 mm2（19 063 mm2 压在 z 5..10）；
    更正 DEC-0055「前底裙是孤岛」说法（z -4..0 为一整块 13 421 mm3 基座）。
    证据 cad/_r55_print_probe.py -> cad/output/_r55_frame/report_r55_print_probe.json
    - V-0061: R55 vs R54 对称差回归 PASS，新增料 11 774.20 mm3 / 移除料 6 304.76 mm3
    全部落在腿区包络（x 54..82 / y +-(64..84) / z 16..48），腿区外对称差 = 0。
    证据 cad/_r55_vs_r54_diff.p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
2026-10-15 T06.17 R56：托板加长 285 mm + 两平面拆分让打印件进 H2D 建板
    用户 2026-10-14 指令「把托板加长，确认所有单体的尺寸都在拓竹 H2D 打印能力内」。
    - 托板加长（CALCULATED）：STAGE_X1/TRAY_X1 215 -> 285 mm（单参数）。容量 pollen 3/nectar 2
    -> pollen 4/nectar 3；新主体 V = 1 103 726 mm3，包络 432.5 x 183.0 x 404.5 mm。
    - H2D 审计（MEASURED，判据 325 x 320 x 325）：77 个单体 74 PASS / 3 FAIL，FAIL =
    融合主体（已由拆分消解）+ base_rail_±72 各 380 x 18 x 14（唯一未消解项，待用户裁定）。
    - 两平面拆分（DEC-0063，x = 100 / z = 300）：1 整件 -> 8 块 / 3 个打印件，最坏块 303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
2026-10-15 T06.17 R57：删底座导轨改单件落地底板（DEC-0064 / V-0063）
    - 删 base_rail_+72 / base_rail_-72（各 380×18×14，超 Bambu H2D 单喷嘴 325 mm 共 55 mm）
    - 新增 floor_plate_R57：315×210×6 单件底板 + 4× 12×16 凸台（顶面 z=16，与原导轨腿底面齐平）
    - 底板底 z=-11.5 = 全机构最低点（比主体最低实体 z=-3.51 再低 7.99 mm）
    - 板顶 z=-5.5，与托板底留 2.0 mm 间隙，全平面不开窗
    - shooter_frame 主体一字未改；仅 DRILL_LEN 60→72 / DRILL_ZC 26→20，使 4×Ø3.4 一次贯穿 凸耳+凸台+底板
    - 连接：底面 4× 7×7×2.5 六角螺母沉窝（M3 螺母 5.5 A/F × 2.4 全藏内）；M3×55 / M3×60+1.5 垫片
    -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
2026-10-15 T06.17 R59：删落地底板，改回两条滑轨加厚接地（DEC-0065 / V-0064）
    判据 = 用户 2026-10-15 指令「不要地板了，就把那两条滑轨加厚使其能避免外罩最低点接触地面」。
    撤销 R57 的 floor_plate_R57，保留 base_rail_+72 / base_rail_-72 并向下加厚。
    几何（MEASURED）
    - 鞋底 box（x -170..210, y ±63..81, z -8..2）fuse 进原导轨；成品 z [-7, 16]，厚 23 mm。
    - 加厚区与主体相交 0.0000 mm³ => 无需任何让位（cad/_r59_probe.py）。
    - 主体零改动：V = 1 103 726.2 mm³、bbox x[-147.22, 285.26] y[-84, 99] z[-3.51, 401.02]，
    与 R56 / R57 逐位相同 => DEC-0063 的 3 件拆分与搭接 M3 对 R59 仍然有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
2026-10-16 T06.18 R60：滑轨再下压 3 mm + 单件滑轨 + 打印件全集 STEP（DEC-0066 / V-0065）
    判据：用户 2026-10-16「下压，让 .STEP 文件包含所有需要打印的部分（不要再把滑轨分成两部分）」。
    ① SOLE_ZB -7.0 -> -10.0；滑轨 z [-10, 16]、厚 26 mm；离地间隙 3.49 -> 6.49 mm。
    cad/_r60_probe.py 实测 R59 主体在鞋底区 x -170..210 / y ±63..81 / z -14..+2 相交 0.0000 mm³ => 无需让位。
    ② 撤销 x = 114 拆分，base_rail_±72 各自 380 mm 单件（V 各 173 711.5 mm³）。
    ③ 新增打印件全集 T06_print_set_R60_pollen.step（3 个具名实体 = frame + 2 条单件滑轨，1.14 MB）。
    ④ 主体零改动：R60 vs R59 主体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
2026-10-16 T06.19 R60B：打印件全集由 3 件修正为 45 件（DEC-0067 / V-0066）
    判据（KNOWN）: 用户 2026-10-16「让 .STEP 文件包含所有需要打印的部分
    （不要再把滑轨分成两部分），完成这一步后等待我的指示，待完全合格后，
    将 .STEP 文件中的各个 3D 打印部件拆成独立的 .STEP 文件，放在一个文件夹里」。
    R60 缺陷（KNOWN）: T06_print_set_R60_pollen.step 只含 3 个具名实体
    （merged frame + 2 条滑轨），漏掉 42 个同样必须打印的自制件
    （轴承座 / 夹座 / 十字头 / 导引块 / 马达桥 / 拨杆 / 支撑柱 …）。
    改动（KNOWN）
    - 确权规则由「白名单挑件」改黑名单排除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
2026-10-16 T06.19 R60B 收尾：打印集拆件 = 45 个独立 STEP（V-0067）
    判据（KNOWN）: 用户 2026-10-16 回复「可以」放行分件；同轮追加
    「记得到时候把两段滑轨拼在一起」（含义待澄清，已记 TBD）。
    方法（MEASURED，只回读，不重跑生成器）
    - cad/_r60b_split.py 从交付件 T06_print_set_R60_pollen.step 回读 45 个
    solid，按 (体积, bbox) 唯一匹配反查 report_r60_pollen.json 的 45 个具名
    打印件（键不唯一即 assert 失败），每件用 cq.Assembly 单独导出。
    实测
    - cad/output/_r60b_parts/ : 45 个 <part>.step + parts_index.json，2.83 MB。
    - 逐个回读 = 每件 1 solid、体积与打印集一致，0 失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
2026-10-16 T06.20 R62：合体滑轨按 x = -40 纯切分为 3 件 H2D 合规件（DEC-0068 / V-0068 / DEC-0069 / V-0069）
    判据 = 用户「② 要把左右两条滑轨合成一件」+「尝试把超限该零件，拆成符合尺寸的」。
    两轮合起来 = 要一件能进 H2D 的滑轨：先并成一件（R61），再切成合规分段（R62）。
    R61（DEC-0068 / V-0068）—— 两轨合一件
    - 在 x <= -40 的净空带内新增 4 根跨轨筋（中心 x = -160/-125/-90/-55，厚 10 mm，
    半宽 66 mm，贯穿 z [-10, 16]），把左右两条滑轨连成 1 solid，V 478 463 mm3。
    - 合体后单件 380 x 162 x 26 mm，最小外接方 383.3 mm，超 H2D 单喷嘴 325 mm 共 58.3 mm，
    按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
2026-10-16 T06.21 R62 交付：打印集拆件 = 46 个独立 STEP + R62 H2D 单体审计（V-0070）
    承接用户「待完全合格后，将 .STEP 文件中的各个 3D 打印部件拆成独立的 .STEP 文件，
    放在一个文件夹里」。R62 已满足合格条件（audit_r62.json 30/30 PASS，三条滑轨全部进 H2D）。
    拆件（MEASURED，只回读）
    - cad/_r62b_split.py 从交付件 T06_print_set_R62_pollen.step 回读 46 个 solid，按
    (体积, bbox) 唯一匹配反查 report_r62_pollen.json 的 46 个具名打印件，每件单独导出。
    不重跑生成器（避免二次写者污染交付件）。
    - 产出 cad/output/_r62b_parts/：46 个 .step + parts_index.json，合计 2.90 MB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
2026-10-16 T06.22 R63 小件合并排版：R62 的 45 个非主体打印件排进一块 H2D 板（DEC-0070 / V-0071）
    - 新增 cad/_r63_plate.py：只回读 cad/output/_r62b_parts/*.step（R62 交付件的回读结果），
    朝向不变（纯 XY 平移），每件 min-Z 落板，件间距 4 mm、板边距 5 mm，MaxRects 短边优先装箱，
    cq.Assembly 导出为单文件排版盘。
    - 可行性：45 件 XY 占地合计 57 568 mm2 < H2D 单板可用 315 x 310 = 97 650 mm2 ⇒ 一块板即可。
    - 产物 cad/output/_r63_plate/：T06_print_plate_R63_pollen.step（2.12 MB / 45 bodies）、
    packing_index.json（逐件板内坐标 + 平移量 + 占地）、plate_preview.png（排版图）。
    - 验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
2026-10-16 T06.23 R64 拆分件装配性探查：前段件可固定、后段件无任何紧固点（DEC-0071 / V-0072）
    用户问「拆了之后还能装回去吗？装回去会不会掉？」。对 R62 交付件
    cad/output/_r62_frame/T06_print_set_R62_pollen.step 做只回读探查
    （布尔交集 / 分层料量 / 孔径轴线探测），不重跑生成器。
    MEASURED：
    - 接缝：三件分界面同在 x = -40.0，纯平对接（无舌槽 / 无搭接 / 无跨缝螺栓），
    每轨满截面 468 mm2（18 x 26）。
    - 前段件 base_rail_front_±72（OK）：4 处 M3 导轨脚接头（x = 60 / 76、y = ±76）
    O3.4 轴内材料 0.00 mm3（孔通透）、孔周 frame 料 1153.22 / 1317.96 mm3；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
2026-10-16 T06.24 R65 跨缝搭板（方案 A）：x = -40 缝由两块 80 x 5 x 26 侧搭板 + 每轨 2 组 M3 跨住（DEC-0072 / V-0073）
    判据：用户 2026-10-16 回复「A」= 选 DEC-0071 候选 A（跨缝搭板 + M3 螺栓，只增件、不动主体）。
    搭板：每轨一片 80 x 5 x 26 mm，x [-80, 0]（跨缝各 40 mm），贴轨外侧面
    y 81..86 / -86..-81、z [-10, 16]；各 1 solid / V 10 309.2 mm3。
    孔位：三条轨各钻 2 个 O3.4 跨缝销孔（沿 Y 贯穿 18 mm）——后段件 x = -66、
    前段件 x = -16，两侧 y = ±72；孔轴 z = -3.0（z = +3 会被主体楔形腹板在
    x >= -20 的 +Y 侧侵入 9.565 mm3，逐 x 段扫描后下移）。切除 653.70 mm3。
    审计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
2026-10-16 T06.25 R66 全机打印件整理：55 件统一目录 + 放平排版 4 块 H2D 板（DEC-0074 / V-0074）
    判据（KNOWN）：用户 2026-10-16 令「把所有打印件整理一下，放在一个文件夹里。在尝试把打印件
    集中在同一次打印时，尽量让打印件平放或采取其他方式降低打印难度，多打印几次并不是太大的
    问题」。
    件集（MEASURED）：新增 cad/output/_r66_parts/ —— 55 件，每件一份独立 STEP +
    parts_index.json，ΣV 1 910 425.8 mm3。来源 = R62 打印件 42 + R65 件 5（3 条钻孔轨 +
    2 片搭板）+ 主体 lump 8（DEC-0063 双平面拆分，复用 R56 拆分结果）。逐件回读 55/55 ok。
    主体覆盖（ME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
2026-10-16 T06.26 R67 放平判据修正：拨杆由斜立 H 84 摊平到 H 30，板件升版 R67（DEC-0075 / V-0075）
    判据（KNOWN）: 用户 2026-10-16 令「进行修改，把拨杆放平」；切片器报含 paddle_rotor 的板超界
    （p3 外形 310.587 x 306.836 x 83.98 mm，三块板都报「超出右 / 左喷嘴可打印范围」）。
    根因（MEASURED）: R66 把 paddle_rotor 以 H 84.0 立着放，但该姿态在这块床面上的实际接触面积
    = 0 mm2（靠一条斜棱虚撑）。该件是绕 Y 轴旋转的转子，两块桨叶板在自身图框里斜 30 度
    （as-drawn 115.46 x 96.0 x 83.98，V 92 960 mm3，最大平面法向 (-0.866, 0, -0.5)），而 DEC-0074
    的放平规则只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
2026-10-16 T06.26b R67 图题版本号统一：概览图 / 单板预览标题 R66 -> R67，重跑确认排版逐位一致
    - cad/_r66_plate.py 的图题字符串（suptitle 与单板标题）改为 R67，与板件 / 交付包版本一致。
    - 重跑 cad/_r66_plate.py（seed 17）：4 板内容与体积逐位复现一致（p1 8 / p2 28 / p3 14 / p4 5，
    Sigma 55 solids / 1 910 425.8 mm3），仅图题与文件名变化；交付 deliverables/R67_print_package/ 已同步刷新。
    - 结论不变：拨杆 paddle_rotor H 84.0 -> 30.0（贴床面 0 -> 1152 mm2），每板 extent <= 315 x 310。
2026-10-16 T06.27 R69 打印件重排：滑轨并成每侧 380 mm 整轨 + 外罩/侧板 3 拆（8 × M3 耳片 + 环氧，不用扎带），件集 55 → 54、8 板（DEC-0076 / V-0076）
2026-10-17 R69: fix Bambu "out of bed / too tall" by dropping pre-trim STEPs
    The two objects Bambu rejected (403.7x136x232.8 V537144 and
    361.1x31x385.0 V312150) were the pre-trim intermediates in
    cad/output/_r69_split, not R69 deliverables.
    - move _r69_split / _r69_p1 to cad/output/_superseded with README
    - add cad/_r69_parts_flat.py: re-export all 54 parts as single solids,
    flat, min-Z=0, XY centred, from the accepted plate STEPs
    - verify: 54/54 single solid, zmin 0, bbox <= 315x310x325,
    sum volume 1766184.4 mm3 == R69 acceptance value
    - docs: DEC-0077 / V-0077, PROJECT_STATUS
    Deliverables (gitignored): deliverables/R69_print_package/parts_flat/
    54 STEP + index + README, previews/bambu_fix_dimen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
